EmersonBJ/nasa-acme-burner-cad-cfd/assets/comp_clean_front.png

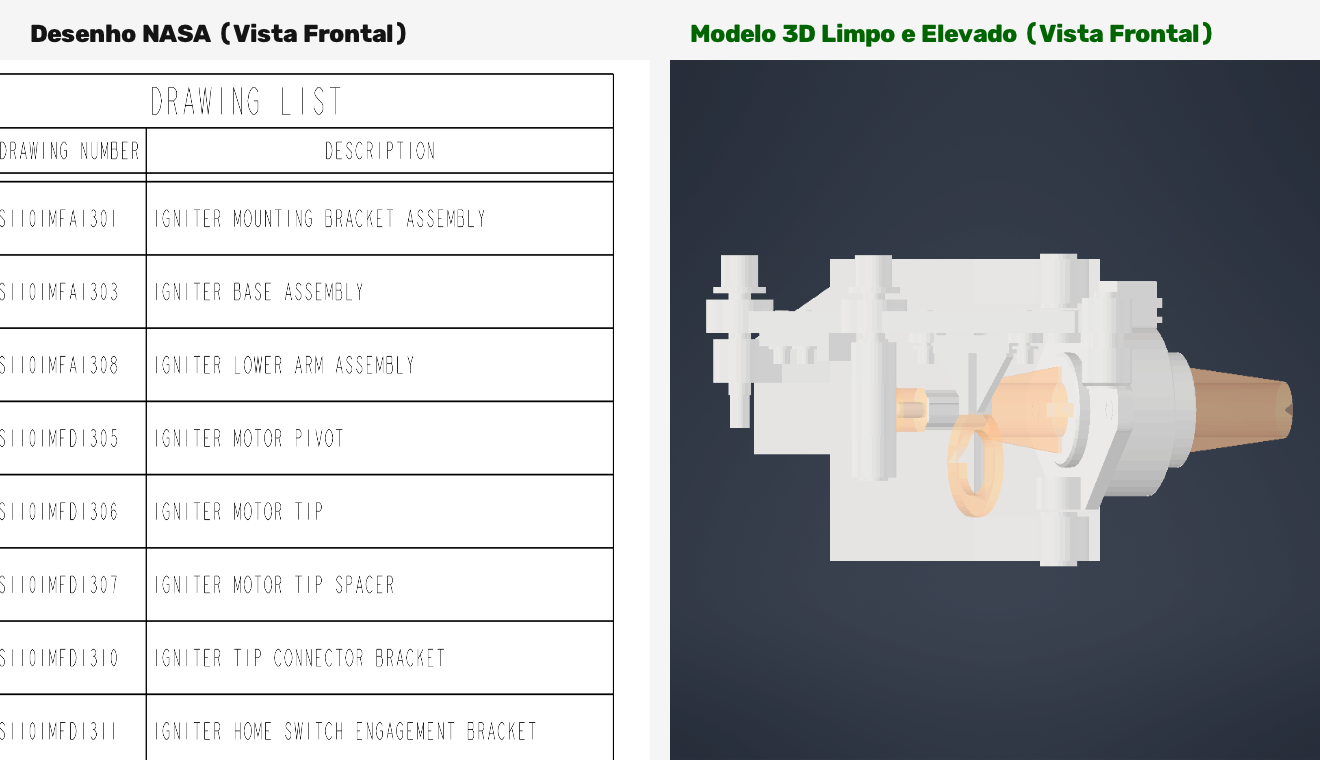
assets/comp_clean_front.png
