EmersonBJ/nasa-acme-burner-cad-cfd/assets/comp_clean_side.png

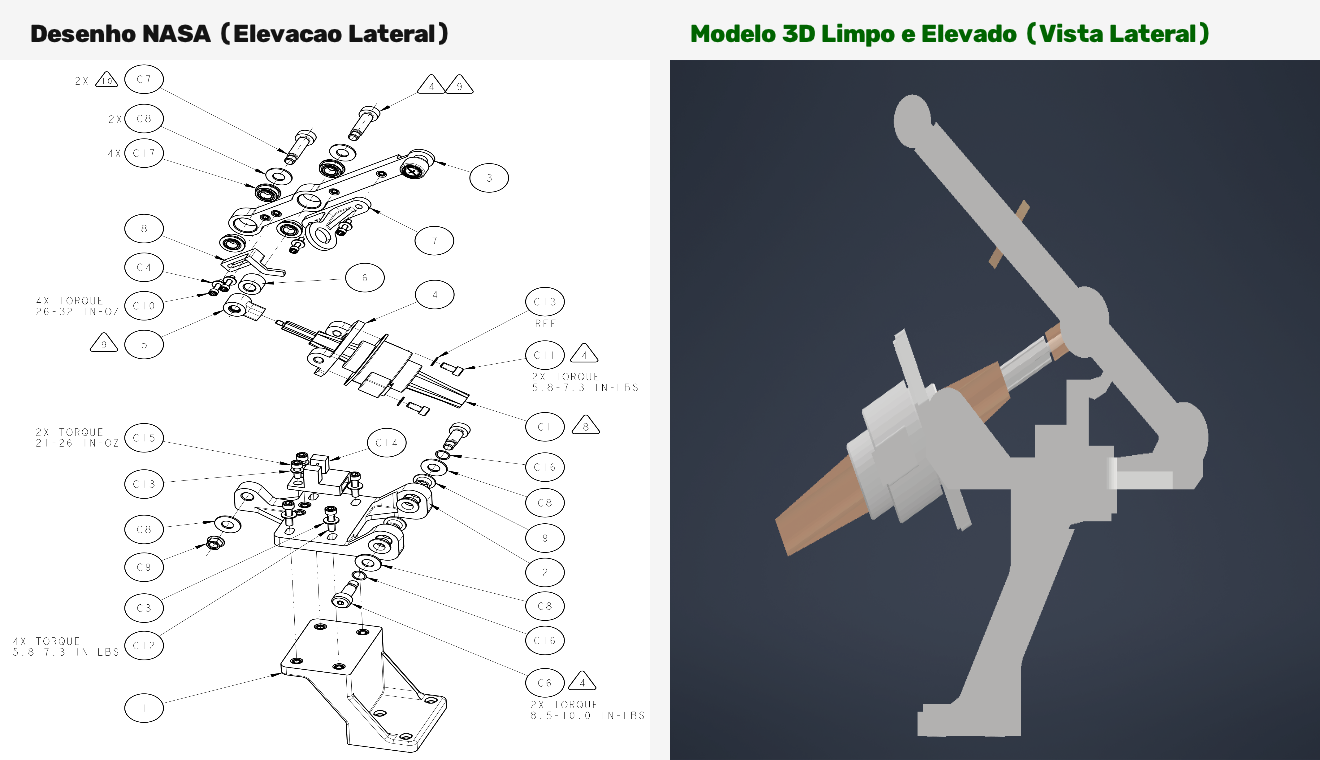
assets/comp_clean_side.png
