EmersonBJ/nasa-acme-burner-cad-cfd/assets/comp_clean_top.png

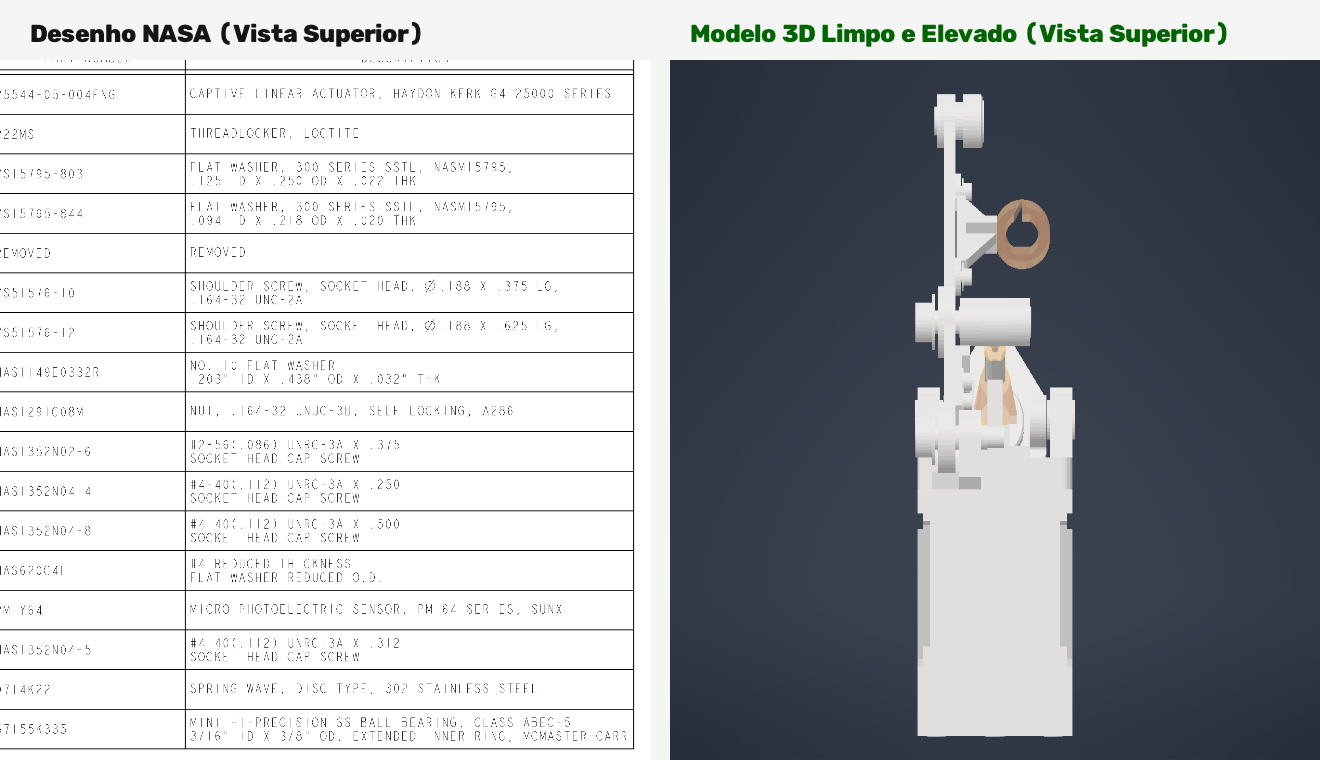
assets/comp_clean_top.png
