EmersonBJ/nasa-acme-burner-cad-cfd/pecas_faltantes.csv

Grupo / Subsistema | Prioridade (s-Flame) | Feito? (SIM / NÃO) | Precisa Fazer no CAD? (Decisão de Engenharia) | Part Number NASA | Nome do Componente / Montagem (Inglês NASA) | Tipo | Status no CAD | Papel no Ansys / Digital Twin | Arquivo STEP (.STEP / .STP) | Arquivo Desenho Técnico (.PDF) | Papel Físico / Observações de Modelagem (Precisa Fazer ou Não?) | Documento / Desenho de Referência NASA
1. Burner (Queimador) | P1 — Crítica (Chama & Quenching) | SIM | JÁ MODELADO | S1101MFD1270 | 1/4" Spherical Burner Support Tube | Peça Individual (.IPT/.STEP) | Modelado (.step pronto / Integrado) | Domínio Fluido / Contorno Térmico CFD | Integrado em S1101MFA1216_E.step | S1101MFD1270_-.pdf | [JÁ MODELADO NO CAD]: Haste cilindrica de suporte integrada ao queimador esferico de 1/4" em S1101MFA1216_E.step e submontagem S1101MFA1218_A.step (OD=1.80mm, desvio ACME-DEV-031). | ACME_engineering_20210328.pdf (p. 43, 71, 80)
1. Burner (Queimador) | P1 — Crítica (Chama & Quenching) | SIM | JÁ MODELADO | S1101MFD1210 | .062" OD Burner Tube Collar | Peça Individual (.IPT/.STEP) | Modelado (.stp pronto / Integrado) | Domínio Fluido / Contorno Térmico CFD (Integrado) | Integrado em S1101MFA1220_B.step | s1101mfa1216_E.pdf | [JÁ MODELADO NO CAD]: O colar de retenção e vedação do tubo já está incorporado e modelado como corpo sólido B-Rep dentro da montagem oficial do queimador S1101MFA1220_B.step (Item #118178 / Item_3_Collar). Não requer modelagem avulsa. | ACME_engineering_20210328.pdf (p. 80)
1. Burner (Queimador) | P1 — Crítica (Termometria Embutida TCBurner) | SIM | JÁ MODELADO | S1101EFA1215 | Burner Harness Assembly (inclui termopar embutido TCBurner) | Submontagem (.IAM) | Modelado (.stp pronto) | Domínio Fluido / Contorno Térmico CFD | s1101efa1215_FULL.stp | S1101EFA1215_B.pdf | [JÁ MODELADO NO CAD]: Chicote eletrico completo (comprimento 244.5 mm / 9.5", conector Glenair e terminais olhais) disponivel em s1101efa1215_FULL.stp e integrado na montagem. | ACME_engineering_20210328.pdf (p. 43–44, 79); steps.md (Fase 2.2); ENGINEERING_DIARY.md
1. Burner (Queimador) | P1 — Crítica (Isolamento Base) | SIM | JÁ MODELADO | S1101MFD1201 | Burner Base Plate | Peça Individual (.IPT/.STEP) | Modelado (.stp pronto) | Domínio Fluido CFD (Parede/Injeção/Sumidouro) | S1101MFD1201.stp | s1101mfa1200_A.pdf | [JÁ MODELADO NO CAD]: Arquivo STEP gerado, validado e integrado à montagem. Placa base estrutural do queimador. Fixa os tubos de suporte e alimentação dos queimadores esféricos e sela a câmara de combustão contra a placa superior da estrutura EMS. | s1101mfd1201_C.pdf; ACME_engineering_20210328.pdf (p. 80)
1. Burner (Queimador) | P1 — Crítica (Isolamento Base) | SIM | JÁ MODELADO | S1101MFD1202 | Burner Insulator | Peça Individual (.IPT/.STEP) | Modelado (.stp pronto) | Domínio Fluido CFD (Parede/Injeção/Sumidouro) | Integrado em S1101MFD1201.stp | s1101mfa1200_A.pdf | [JÁ MODELADO NO CAD]: Arquivo STEP gerado, validado e integrado à montagem. Par de lâminas isolantes finas de 0,010" cada (0,020" = 0,508 mm no total) com rasgo oblongo central para passagem dos dois O-rings de fluorocarbono AS3209-013. Isola termicamente e eletricamente a base condutiva do queimador da estrutura EMS. | s1101mfa1200_A.pdf; ACME_engineering_20210328.pdf (p. 80)
1. Burner (Queimador) | P1 — Crítica (Isolamento Base) | SIM | JÁ MODELADO | S1101MFD1203 | Burner Bottom Plate | Peça Individual (.IPT/.STEP) | Modelado (.stp pronto) | Domínio Fluido CFD (Parede/Injeção/Sumidouro) | Integrado em S1101MFD1201.stp | s1101mfa1200_A.pdf | [JÁ MODELADO NO CAD]: Arquivo STEP gerado, validado e integrado à montagem. Placa inferior de compressão e retenção da base do queimador. Garante o esmagamento controlado dos O-rings AS3209-013 e a vedação hermética contra vazamento de combustível na base. | s1101mfa1200_A.pdf; ACME_engineering_20210328.pdf (p. 80)
1. Burner (Queimador) | P1 — Crítica (Isolamento Base) | SIM | JÁ MODELADO | S1101MFD1204 | Burner Mounting Bushing (Outer) | Peça Individual (.IPT/.STEP) | Modelado (.stp pronto) | Domínio Fluido CFD (Parede/Injeção/Sumidouro) | Integrado em S1101MFD1201.stp | s1101mfa1200_A.pdf | [JÁ MODELADO NO CAD]: Arquivo STEP gerado, validado e integrado à montagem. Bucha externa de isolamento térmico e elétrico para os parafusos de fixação da base S1101MFA1200, evitando pontes térmicas indesejadas com o piso da câmara CIR. | s1101mfa1200_A.pdf; ACME_engineering_20210328.pdf (p. 80)
1. Burner (Queimador) | P1 — Crítica (Isolamento Base) | SIM | JÁ MODELADO | S1101MFD1205 | Burner Mounting Bushing (Inner) | Peça Individual (.IPT/.STEP) | Modelado (.stp pronto) | Domínio Fluido CFD (Parede/Injeção/Sumidouro) | Integrado em S1101MFD1201.stp | s1101mfa1200_A.pdf | [JÁ MODELADO NO CAD]: Arquivo STEP gerado, validado e integrado à montagem. Bucha interna de isolamento térmico e alinhamento concêntrico dos parafusos de fixação da base do queimador. | s1101mfa1200_A.pdf; ACME_engineering_20210328.pdf (p. 80)
1. Burner (Queimador) | P1 — Crítica (Isolamento Base) | SIM | JÁ MODELADO | S1101MFD1206 | Burner Centering Bushing | Peça Individual (.IPT/.STEP) | Modelado (.stp pronto) | Domínio Fluido CFD (Parede/Injeção/Sumidouro) | Integrado em S1101MFD1201.stp | s1101mfa1200_A.pdf | [JÁ MODELADO NO CAD]: Arquivo STEP gerado, validado e integrado à montagem. Bucha de centragem de precisão da base do queimador. Garante o posicionamento coaxial do queimador esférico em relação ao eixo óptico da câmara CIR. | s1101mfa1200_A.pdf; ACME_engineering_20210328.pdf (p. 80)
1. Burner (Queimador) | P1 — Crítica (Isolamento Base) | SIM | JÁ MODELADO | S1101MFA1200 | Burner Base Assembly | Submontagem (.IAM) | Modelado (.stp pronto) | Domínio Fluido CFD (Parede/Injeção/Sumidouro) | Integrado na Montagem da Base | s1101mfa1200_A.pdf | [JÁ MODELADO NO CAD]: Arquivo STEP gerado, validado e integrado à montagem. Montagem completa da base do queimador, integrando placa base, isoladores, buchas e vedações de O-ring. | s1101mfa1200_A.pdf; ACME_engineering_20210328.pdf (p. 77, 80)
1. Burner (Queimador) | P1 — Crítica (Isolamento Base) | SIM | JÁ MODELADO | AS3209-013 | O-Ring, Fluorocarbon (.426 ID x .070 W) | Elemento Comercial / Vedação | Modelado (.stp pronto) | Domínio Fluido CFD (Parede/Injeção/Sumidouro) | Integrado em S1101MFD1201.stp | s1101mfa1200_A.pdf | [JÁ MODELADO NO CAD]: Arquivo STEP gerado, validado e integrado à montagem. Par de anéis de vedação O-ring de fluorocarbono (Viton). Garantem vedação estanque contra vazamento na base do queimador sob pressões de até 3,0 atm. | s1101mfa1200_A.pdf; SAE AS3209
1. Burner (Queimador) | P1 — Crítica (Isolamento Base) | SIM | JÁ MODELADO | NAS1352N06-8 | Screw, Cap, Socket Head (#6-32 UNRF-3A x .500) | Elemento Comercial / Fixador | Modelado (.stp pronto) | Domínio Fluido CFD (Parede/Injeção/Sumidouro) | Integrado na Montagem da Base | s1101mfa1200_A.pdf | [JÁ MODELADO NO CAD]: Arquivo STEP gerado, validado e integrado à montagem. Parafusos de fixação da placa inferior do queimador na placa base S1101MFD1201. | s1101mfa1200_A.pdf; NAS1352
1. Burner (Queimador) | P1 — Crítica (Isolamento Base) | SIM | JÁ MODELADO | NAS1149CN632R | Flat Washer (#6 regular, corrosion resistant) | Elemento Comercial / Fixador | Modelado (.stp pronto) | Domínio Fluido CFD (Parede/Injeção/Sumidouro) | Integrado na Montagem da Base | s1101mfa1200_A.pdf | [JÁ MODELADO NO CAD]: Arquivo STEP gerado, validado e integrado à montagem. Arruelas planas de aço inoxidável sob as buchas de montagem do queimador. | s1101mfa1200_A.pdf; NAS1149
1. Burner (Queimador) | P1 — Crítica (Isolamento Base) | SIM | JÁ MODELADO | NAS1149C0332R | Flat Washer (#10 regular, corrosion resistant) | Elemento Comercial / Fixador | Modelado (.stp pronto) | Domínio Fluido CFD (Parede/Injeção/Sumidouro) | Integrado na Montagem da Base | s1101mfa1200_A.pdf | [JÁ MODELADO NO CAD]: Arquivo STEP gerado, validado e integrado à montagem. Arruelas de assentamento para os parafusos modificados S1101MFP1025 dos 4 cantos da base. | s1101mfa1200_A.pdf; NAS1149
1. Burner (Queimador) | P1 — Crítica (Chama & Quenching) | SIM | JÁ MODELADO | S1101MFA1216 | 1/4" Spherical Burner Assembly | Montagem Geral (.IAM) | Modelado (.step pronto) | Domínio Fluido / Contorno Térmico CFD | S1101MFA1216_E.step | s1101mfa1216_E.pdf | [JÁ MODELADO NO CAD]: Montagem completa oficial do queimador esferico de voo de 1/4" (6.35 mm) validada em S1101MFA1216_E.step. Inclui placa base MFD1201, haste de suporte, esfera porosa a Z=177.8 mm (7.0") e termopar. | s1101mfa1216_E.pdf; ACME_engineering_20210328.pdf (p. 80)
1. Burner (Queimador) | P1 — Crítica (Chama & Quenching) | SIM | JÁ MODELADO | S1101MFA1217 | 1/4" Spherical Burner Subassembly | Submontagem (.IAM) | Modelado (.step pronto / Integrado) | Domínio Fluido / Contorno Térmico CFD | Integrado em S1101MFA1216_E.step | s1101mfa1217_B.pdf | [JÁ MODELADO NO CAD]: Submontagem da haste e esfera porosa de 1/4" integrada na montagem S1101MFA1216_E.step e disponivel avulsa em S1101MFA1218_A.step. | s1101mfa1216_E.pdf; ACME_engineering_20210328.pdf (p. 80)
1. Burner (Queimador) | P1 — Crítica (Chama & Quenching) | SIM | JÁ MODELADO | S1101MFA1218 | Spherical Burner Tube Assembly | Submontagem (.IAM) | Modelado (.stp pronto) | Domínio Fluido CFD (Parede/Injeção/Sumidouro) | S1101MFA1218_A.step | s1101mfa1218_A.pdf | [JÁ MODELADO NO CAD]: Arquivo STEP gerado, validado e integrado à montagem. Montagem do tubo condutor e haste do queimador esférico de 1/4". | s1101mfa1218_A.pdf; ACME_engineering_20210328.pdf (p. 80)
1. Burner (Queimador) | P1 — Crítica (Chama & Quenching) | SIM | JÁ MODELADO | S1101MFD1219 | .062" OD Spherical Burner Support Tube | Peça Individual (.IPT/.STEP) | Modelado (.step pronto / Integrado no Queimador S1101MFA1216_E) | Domínio Fluido / Contorno Térmico CFD | Integrado em S1101MFA1216_E.step | s1101mfd1219_-.pdf | [JÁ MODELADO NO CAD]: Tubo interno capilar (.062" OD) soldado a esfera porosa, ja incorporado no solido continuo da haste e esfera em S1101MFA1216_E.step. | s1101mfd1219_-.pdf; ACME_engineering_20210328.pdf (p. 80)
1. Burner (Queimador) | P2 — Alta (Acabamento Base Burner) | SIM | JÁ ATENDIDO / SIMPLIFICADO NO BURNER | S1101MFD1269 | Burner Stem Cover | Peça Individual (.IPT/.STEP) | Integrado na Montagem do Queimador S1101MFA1216 | Domínio Fluido / Contorno Térmico CFD | A Modelar / Faltante | s1101mfd1269_rev1.pdf | [INTEGRADO NO QUEIMADOR]: A cobertura da base da haste já está incorporada no flange base e no diâmetro de assentamento do queimador S1101MFA1216_E. | ACME_engineering_20210328.pdf (Fig. 44/46, p. 44, 80)
1. Burner (Queimador) | P3 — Média (Fixadores Especiais) | SIM | JÁ MODELADO | S1101MFP1025 | Modified SHCS (.190-32 UNRF-3A x .750) | Peça Individual (.IPT/.STEP) | Modelado (.stp pronto) | Domínio Fluido CFD (Parede/Injeção/Sumidouro) | Integrado em S1101MFD1201.stp | s1101mfa1200_A.pdf | [JÁ MODELADO NO CAD]: Arquivo STEP gerado, validado e integrado à montagem. Parafuso modificado de fixação dos 4 cantos da base S1101MFA1200 com rebaixo para buchas isolantes S1101MFD1204/1205. | s1101mfa1200_A.pdf (Item 7); ACME_engineering_20210328.pdf (p. 77)
1. Burner (Queimador) | P4 — Baixa / Cancelado (ACME-WAI-012) | NÃO | NÃO PRECISA (Queimador 3/8" não voou) | S1101MFD1271 | 3/8" Spherical Burner Support Tube | Peça Individual (.IPT/.STEP) | Dispensado de CAD (Queimador 3/8") | Fora da Malha (Hardware Alternativo) | --- (Dispensado / Alternativo) | S1101MFD1271_-.pdf | [NÃO PRECISA DE CAD]: Tubo e colar de 3/8" não voaram nas queimas analisadas do s-Flame (voou o queimador de 1/4"). Tubo de suporte externo para queimador esférico de 3/8" (D0=9,525mm). Cancelado pelo waiver ACME-WAI-012; s-Flame voou exclusivamente com queimador de 1/4" (D0=6,25mm). | ACME_engineering_20210328.pdf (p. 80); ACME-WAI-012
1. Burner (Queimador) | P4 — Baixa / Cancelado (ACME-WAI-012) | NÃO | NÃO PRECISA (Queimador 3/8" não voou) | S1101MFD1222 | .083" OD Burner Collar | Peça Individual (.IPT/.STEP) | Dispensado de CAD (Queimador 3/8") | Fora da Malha (Hardware Alternativo) | --- (Dispensado / Alternativo) | s1101mfa1216_E.pdf | [NÃO PRECISA DE CAD]: Tubo e colar de 3/8" não voaram nas queimas analisadas do s-Flame (voou o queimador de 1/4"). Colar adaptador de .083" (2,11 mm). Pertence exclusivamente ao queimador esférico de 3/8" (S1101MFA1220), cancelado sob o waiver ACME-WAI-012. O queimador de voo s-Flame de 1/4" utiliza S1101MFD1270 (OD=1,80 mm, ACME-DEV-031) e o colar S1101MFD1210 (.062"). | ACME_engineering_20210328.pdf (p. 80); ACME-WAI-012
1. Burner (Queimador) | P4 — Baixa / Cancelado (ACME-WAI-012) | SIM | JÁ MODELADO | S1101MFA1220 | 3/8" Spherical Burner Assembly | Montagem Geral (.IAM) | Modelado (.stp pronto) | Fora da Malha (Queimador 3/8" Cancelado) | S1101MFA1220_B.step | s1101mfa1220_B.pdf | [JÁ MODELADO NO CAD]: Arquivo STEP gerado, validado e integrado à montagem. Montagem geral do queimador de 3/8", cancelada pelo waiver ACME-WAI-012. Mantida no CAD como referência. | s1101mfa1220_B.pdf; ACME_engineering_20210328.pdf (p. 80)
1. Burner (Queimador) | P4 — Baixa / Referência (Coflow Burner) | SIM | JÁ MODELADO | S1101MFD1268 | Coflow Burner Collar | Peça Individual (.IPT/.STEP) | Modelado (.stp pronto) | Referência Estrutural (Não Voou no s-Flame) | S1101MFD1268_Coflow_Burner_Collar.stp | s1101mfd1268_-.pdf | [JÁ MODELADO NO CAD]: Arquivo STEP gerado, validado e integrado à montagem. Colar do queimador Coflow. Modelado para documentação ACME de referência; não participa do escoamento s-Flame. | s1101mfd1268_-.pdf; ACME_engineering_20210328.pdf (p. 80)
1. Burner (Queimador) | P4 — Baixa / Referência (Queimador 1/2") | SIM | JÁ MODELADO | S1101MFD1272 | 1/2" Spherical Burner Support Tube | Peça Individual (.IPT/.STEP) | Modelado (.stp pronto) | Referência Estrutural (Não Voou no s-Flame) | PSI-Documents/Engineering Documents/CADs_Nosso/Burner/Serie_1100_a_1109/S1101MFD1272_-.stp | S1101MFD1272_-.pdf | [JÁ MODELADO NO CAD]: Arquivo STEP gerado, validado e integrado à montagem. Tubo de suporte externo para queimador esférico de 1/2" (12,7 mm). Usado em testes em solo e outros experimentos ACME; não voou no s-Flame. | S1101MFD1272_-.pdf; ACME_engineering_20210328.pdf (p. 80)
2. Igniter (Ignitor) | Referência / Concluído | SIM | JÁ MODELADO | S1101MFA1300 | Igniter Actuator Assembly | Montagem Geral (.IAM) | Concluído / Existente | Domínio Fluido CFD (Parede/Injeção/Sumidouro) | s1101mfa1300.stp | s1101mfa1300_C.pdf | [JÁ MODELADO NO CAD]: Arquivo STEP gerado, validado e integrado à montagem. Montagem completa do mecanismo atuador do braço do ignitor com cinemática validada (+39,11° braço, -26,38° atuador). | s1101mfa1300_C.pdf; ACME_engineering_20210328.pdf (p. 81)
2. Igniter (Ignitor) | Referência / Concluído | SIM | JÁ MODELADO | S1101MFA1301 | Igniter Actuator Subassembly | Submontagem (.IAM) | Concluído / Existente | Domínio Fluido CFD (Parede/Injeção/Sumidouro) | s1101mfa1301.step | s1101mfa1300_C.pdf | [JÁ MODELADO NO CAD]: Arquivo STEP gerado, validado e integrado à montagem. Corpo atuador rotativo do mecanismo de ignição. | s1101mfa1301_D.pdf
2. Igniter (Ignitor) | Referência / Concluído | SIM | JÁ MODELADO | S1101MFA1303 | Igniter Base Subassembly | Submontagem (.IAM) | Concluído / Existente | Domínio Fluido CFD (Parede/Injeção/Sumidouro) | s1101mfa1303.step | s1101mfa1300_C.pdf | [JÁ MODELADO NO CAD]: Arquivo STEP gerado, validado e integrado à montagem. Base do atuador do ignitor para fixação na estrutura EMS. | s1101mfa1303_C.pdf
2. Igniter (Ignitor) | Referência / Concluído | SIM | JÁ MODELADO | S1101MFA1308 | Igniter Arm Assembly | Submontagem (.IAM) | Concluído / Existente | Domínio Fluido CFD (Parede/Injeção/Sumidouro) | s1101mfa1308.step | s1101mfa1300_C.pdf | [JÁ MODELADO NO CAD]: Arquivo STEP gerado, validado e integrado à montagem. Braço móvel articulado que conduz a ponta de ignição até o queimador. | s1101mfa1308_C.pdf
2. Igniter (Ignitor) | Referência / Concluído | SIM | JÁ MODELADO | S1101MFD1305 | Igniter Link Arm | Peça Individual (.IPT/.STEP) | Concluído / Existente | Domínio Fluido CFD (Parede/Injeção/Sumidouro) | s1101mfd1305.step | s1101mfa1300_C.pdf | [JÁ MODELADO NO CAD]: Arquivo STEP gerado, validado e integrado à montagem. Biela de acoplamento do mecanismo articulado do atuador. | s1101mfd1305_-.pdf
2. Igniter (Ignitor) | Referência / Concluído | SIM | JÁ MODELADO | S1101MFD1302 | Igniter Base Bracket | Peça Individual (.IPT/.STEP) | Concluído / Existente | Domínio Fluido CFD (Parede/Injeção/Sumidouro) | s1101mfd1302_igniter_bracket.step | s1101mfa1300_C.pdf | [JÁ MODELADO NO CAD]: Arquivo STEP gerado, validado e integrado à montagem. Suporte angular de ancoragem do atuador rotativo do ignitor à placa base EMS. | s1101mfd1302_-.pdf
2. Igniter (Ignitor) | P1 — Crítica (Ignição & Retração) | SIM | JÁ MODELADO | S1101MFA1319 | Igniter Tip Assembly (Loop) | Submontagem (.IAM) | Modelado (.stp pronto) | Domínio Fluido CFD (Parede/Injeção/Sumidouro) | S1101MFA1319_C.step | s1101mfa1319_C.pdf | [JÁ MODELADO NO CAD]: Arquivo STEP gerado, validado e integrado à montagem. Ponta de ignição com filamento Kanthal A-1 em alça (Loop, ∅0,25mm). Fecha a geometria da ponta do braço S1101MFA1308 para simular o aquecimento Joule no preheat (2,25→3,75V) e a perturbação hidrodinâmica durante o atraso de retração de 0,6s (ACME-DEV-050). | s1101mfa1319_C.pdf; ACME_engineering_20210328.pdf (p. 81)
2. Igniter (Ignitor) | P1 — Crítica (Ignição & Retração) | SIM | JÁ MODELADO | S1101MFA1339 | Coiled Igniter Tip Assembly (Coil) | Submontagem (.IAM) | Modelado (.stp pronto) | Domínio Fluido / Contorno Térmico CFD | s1101mfa1339_ponteira_ignitor.stp | s1101mfa1339.pdf | [JÁ MODELADO NO CAD]: Ponteira do ignitor com filamento em espiral (Coil) aprovada e armazenada em s1101mfa1339_ponteira_ignitor.stp. | s1101mfa1339_-.pdf; ACME_engineering_20210328.pdf (p. 81)
2. Igniter (Ignitor) | P1 — Crítica (Ignição & Retração) | SIM | JÁ MODELADO | S1101MFD1320 | Igniter Tip Insulator | Peça Individual (.IPT/.STEP) | Modelado (.stp pronto) | Domínio Fluido CFD (Parede/Injeção/Sumidouro) | S1101MFD1320.stp | S1101MFD1320_-.pdf | [JÁ MODELADO NO CAD]: Arquivo STEP gerado, validado e integrado à montagem. Isolador cerâmico cilíndrico de ∅4,75mm com dois furos de ∅0,5mm espaçados a 2,0mm. Garante isolamento elétrico e térmico rígido dos pinos condutores de corrente no filamento. | s1101mfd1320_A.pdf; ACME_engineering_20210328.pdf (p. 81)
2. Igniter (Ignitor) | P2 — Alta (Porta-Ponta Ignitor) | SIM | JÁ ATENDIDO NA MONTAGEM S1101MFA1300 | S1101MFA1338 | Igniter Tip Holder Assembly | Submontagem (.IAM) | Integrado na Montagem do Ignitor (s1101mfa1300 / s1101mfa1339) | Domínio Fluido / Contorno Térmico CFD | A Modelar / Faltante | s1101mfa1338_-.pdf | [JÁ ATENDIDO NA MONTAGEM GLOBAL DO IGNITOR]: Subcomponente interno da ponta/presilha do ignitor. A geometria macro completa já existe em s1101mfa1300_montado_corrigido.stp e na ponta s1101mfa1339. Para o Ansys CFD, detalhes internos de fixação sofrem defeaturing para viabilizar a malha. | s1101mfa1338_-.pdf; ACME_engineering_20210328.pdf (p. 81)
2. Igniter (Ignitor) | P2 — Alta (Porta-Ponta Ignitor) | SIM | JÁ ATENDIDO NA MONTAGEM S1101MFA1300 | S1101MFA1336 | Cover Tab Assembly | Submontagem (.IAM) | Integrado na Montagem do Ignitor (s1101mfa1300 / s1101mfa1339) | Domínio Fluido / Contorno Térmico CFD | A Modelar / Faltante | s1101mfa1336_-.pdf | [JÁ ATENDIDO NA MONTAGEM GLOBAL DO IGNITOR]: Subcomponente interno da ponta/presilha do ignitor. A geometria macro completa já existe em s1101mfa1300_montado_corrigido.stp e na ponta s1101mfa1339. Para o Ansys CFD, detalhes internos de fixação sofrem defeaturing para viabilizar a malha. | s1101mfa1336_-.pdf; ACME_engineering_20210328.pdf (p. 81)
2. Igniter (Ignitor) | P2 — Alta (Componentes Porta-Ponta) | SIM | JÁ ATENDIDO NA MONTAGEM S1101MFA1300 | S1101MFD1333 | Igniter Tip Holder, Left Side | Peça Individual (.IPT/.STEP) | Integrado na Montagem do Ignitor (s1101mfa1300 / s1101mfa1339) | Domínio Fluido / Contorno Térmico CFD | A Modelar / Faltante | s1101mfd1333_-.pdf | [JÁ ATENDIDO NA MONTAGEM GLOBAL DO IGNITOR]: Subcomponente interno da ponta/presilha do ignitor. A geometria macro completa já existe em s1101mfa1300_montado_corrigido.stp e na ponta s1101mfa1339. Para o Ansys CFD, detalhes internos de fixação sofrem defeaturing para viabilizar a malha. | s1101mfd1333_-.pdf; ACME_engineering_20210328.pdf (p. 81)
2. Igniter (Ignitor) | P2 — Alta (Componentes Porta-Ponta) | SIM | JÁ ATENDIDO NA MONTAGEM S1101MFA1300 | S1101MFD1334 | Igniter Tip Holder, Right Side | Peça Individual (.IPT/.STEP) | Integrado na Montagem do Ignitor (s1101mfa1300 / s1101mfa1339) | Domínio Fluido / Contorno Térmico CFD | A Modelar / Faltante | s1101mfd1334_-.pdf | [JÁ ATENDIDO NA MONTAGEM GLOBAL DO IGNITOR]: Subcomponente interno da ponta/presilha do ignitor. A geometria macro completa já existe em s1101mfa1300_montado_corrigido.stp e na ponta s1101mfa1339. Para o Ansys CFD, detalhes internos de fixação sofrem defeaturing para viabilizar a malha. | s1101mfd1334_-.pdf; ACME_engineering_20210328.pdf (p. 81)
2. Igniter (Ignitor) | P3 — Média (Componentes Porta-Ponta) | SIM | JÁ ATENDIDO NA MONTAGEM S1101MFA1300 | S1101MFD1335 | Tip Holder Alignment Pin | Peça Individual (.IPT/.STEP) | Integrado na Montagem do Ignitor (s1101mfa1300 / s1101mfa1339) | Domínio Fluido / Contorno Térmico CFD | A Modelar / Faltante | s1101mfd1335_-.pdf | [JÁ ATENDIDO NA MONTAGEM GLOBAL DO IGNITOR]: Subcomponente interno da ponta/presilha do ignitor. A geometria macro completa já existe em s1101mfa1300_montado_corrigido.stp e na ponta s1101mfa1339. Para o Ansys CFD, detalhes internos de fixação sofrem defeaturing para viabilizar a malha. | s1101mfd1335_-.pdf; ACME_engineering_20210328.pdf (p. 81)
2. Igniter (Ignitor) | P3 — Média (Componentes Porta-Ponta) | SIM | JÁ ATENDIDO NA MONTAGEM S1101MFA1300 | S1101MFD1337 | Tip Holder Cover Tab | Peça Individual (.IPT/.STEP) | Integrado na Montagem do Ignitor (s1101mfa1300 / s1101mfa1339) | Domínio Fluido / Contorno Térmico CFD | A Modelar / Faltante | s1101mfd1337_RevB.pdf | [JÁ ATENDIDO NA MONTAGEM GLOBAL DO IGNITOR]: Subcomponente interno da ponta/presilha do ignitor. A geometria macro completa já existe em s1101mfa1300_montado_corrigido.stp e na ponta s1101mfa1339. Para o Ansys CFD, detalhes internos de fixação sofrem defeaturing para viabilizar a malha. | s1101mfd1337_-.pdf; ACME_engineering_20210328.pdf (p. 81)
2. Igniter (Ignitor) | P3 — Média (Componentes Porta-Ponta) | NÃO | DISPENSADO (Referência Secundária) | S1101MFA1313 | Igniter Tip Extension Assembly | Submontagem (.IAM) | Dispensado de CAD | Fora da Malha (Referência) | --- (Dispensado) | s1101mfa1313_F.pdf | [NÃO PRECISA DE CAD]: Suporte mecânico secundário sem impacto na física da chama. Extensão mecânica do braço para acomodação de termopares e cabos coaxiais de ignição. | s1101mfa1313_-.pdf; ACME_engineering_20210328.pdf (p. 81)
2. Igniter (Ignitor) | P3 — Média (Componentes Porta-Ponta) | NÃO | DISPENSADO (Referência Secundária) | S1101MFD1314 | Igniter Tip Extension Tube | Peça Individual (.IPT/.STEP) | Dispensado de CAD | Fora da Malha (Referência) | --- (Dispensado) | s1101mfa1300_C.pdf | [NÃO PRECISA DE CAD]: Suporte mecânico secundário sem impacto na física da chama. Tubo condutor da extensão do braço do ignitor. | s1101mfd1314_-.pdf; ACME_engineering_20210328.pdf (p. 81)
2. Igniter (Ignitor) | P3 — Média (Fixadores do Ignitor) | SIM | JÁ ATENDIDO NA MONTAGEM S1101MFA1300 | S1101MFD1321 | Igniter Tip Insulator Retaining Ring | Peça Individual (.IPT/.STEP) | Integrado na Montagem do Ignitor (s1101mfa1300 / s1101mfa1339) | Domínio Fluido / Contorno Térmico CFD | A Modelar / Faltante | s1101mfa1300_C.pdf | [JÁ ATENDIDO NA MONTAGEM GLOBAL DO IGNITOR]: Subcomponente interno da ponta/presilha do ignitor. A geometria macro completa já existe em s1101mfa1300_montado_corrigido.stp e na ponta s1101mfa1339. Para o Ansys CFD, detalhes internos de fixação sofrem defeaturing para viabilizar a malha. | s1101mfd1321_-.pdf; ACME_engineering_20210328.pdf (p. 81)
2. Igniter (Ignitor) | P3 — Média (Fixadores do Ignitor) | SIM | JÁ ATENDIDO NA MONTAGEM S1101MFA1300 | S1101MFA1332 | Igniter Tip Clamp Assembly | Submontagem (.IAM) | Integrado na Montagem do Ignitor (s1101mfa1300 / s1101mfa1339) | Domínio Fluido / Contorno Térmico CFD | A Modelar / Faltante | s1101mfa1332_A.pdf | [JÁ ATENDIDO NA MONTAGEM GLOBAL DO IGNITOR]: Subcomponente interno da ponta/presilha do ignitor. A geometria macro completa já existe em s1101mfa1300_montado_corrigido.stp e na ponta s1101mfa1339. Para o Ansys CFD, detalhes internos de fixação sofrem defeaturing para viabilizar a malha. | s1101mfa1332_-.pdf; ACME_engineering_20210328.pdf (p. 81)
3. Termometria (Termopares) | P1 — Crítica (Termometria de Voo s-Flame) | NÃO | * NÃO PRECISA (Sonda Virtual Ansys) | * S1101MFA1609 | Thermocouple Far Array Assembly | Montagem Geral (.IAM) | * Dispensado de CAD (Sonda Virtual Ansys) | * Sonda Virtual Pontual X,Y,Z (Fluent Monitor) | s1101mfa1609_1609_OPER.stp | s1101mfa1609_D.pdf | [* NÃO PRECISA DE CAD - SONDA VIRTUAL ANSYS]: Monitoramento térmico pontual direto nas coordenadas exatas (X, Y, Z) no Fluent. Elimina suportes mecânicos, singularidades de malha e milhões de células desnecessárias. O ÚNICO pente de termopares instalado em voo no s-Flame. Base física fundamental para validação do Ansys Fluent e 4D PINN: ancora a telemetria térmica a 125 Hz, o holdout cego TCD a 100mm (RMSE=0,12K) e a ressuscitação das gotas Tipo B (TCA 45mm e TCB 60mm). | s1101mfa1609_B.pdf; ACME_engineering_20210328.pdf (p. 12, 59, 84)
3. Termometria (Termopares) | P1 — Crítica (Termometria de Voo s-Flame) | NÃO | * NÃO PRECISA (Sonda Virtual Ansys) | * S1101MFA1610 | Thermocouple Far Rake Assembly | Submontagem (.IAM) | * Dispensado de CAD (Sonda Virtual Ansys) | * Sonda Virtual Pontual X,Y,Z (Fluent Monitor) | --- (Dispensado / Sonda Virtual) | s1101mfa1610_A.pdf | [* NÃO PRECISA DE CAD - SONDA VIRTUAL ANSYS]: Monitoramento térmico pontual direto nas coordenadas exatas (X, Y, Z) no Fluent. Elimina suportes mecânicos, singularidades de malha e milhões de células desnecessárias. Submontagem do braço e pente Far Rake de voo com as 4 hastes isolantes de termopar. | s1101mfa1609_B.pdf; ACME_engineering_20210328.pdf (p. 84)
3. Termometria (Termopares) | P1 — Crítica (Termometria de Voo s-Flame) | NÃO | * NÃO PRECISA (Sonda Virtual Ansys) | * S1101MFA1612 | TC Far Mounting Arm Assembly | Submontagem (.IAM) | * Dispensado de CAD (Sonda Virtual Ansys) | * Sonda Virtual Pontual X,Y,Z (Fluent Monitor) | --- (Dispensado / Sonda Virtual) | s1101mfa1612_A.pdf | [* NÃO PRECISA DE CAD - SONDA VIRTUAL ANSYS]: Monitoramento térmico pontual direto nas coordenadas exatas (X, Y, Z) no Fluent. Elimina suportes mecânicos, singularidades de malha e milhões de células desnecessárias. Braço estrutural que posiciona o pente Far Array no volume livre da câmara s-Flame, mantendo as 4 junções térmicas (45, 60, 100, 100 mm) perfeitamente alinhadas com o centro da chama esférica. | s1101mfa1612_A.pdf; ACME_engineering_20210328.pdf (Fig. 63, p. 59, 84)
3. Termometria (Termopares) | P1 — Crítica (Termometria de Voo s-Flame) | NÃO | * NÃO PRECISA (Sonda Virtual Ansys) | * S1101MFD1619 | Far TC Sleeve, Pos 1 (45mm) | Peça Individual (.IPT/.STEP) | * Dispensado de CAD (Sonda Virtual Ansys) | * Sonda Virtual Pontual X,Y,Z (Fluent Monitor) | --- (Dispensado / Sonda Virtual) | s1101mfd1619.pdf | [* NÃO PRECISA DE CAD - SONDA VIRTUAL ANSYS]: Monitoramento térmico pontual direto nas coordenadas exatas (X, Y, Z) no Fluent. Elimina suportes mecânicos, singularidades de malha e milhões de células desnecessárias. Tubo de proteção de alumina da gota termopar TCA a r=45mm (Tipo B). Ressuscitada analiticamente em 31,1°C no Digital Twin. | s1101mfd1619_-.pdf; ACME_engineering_20210328.pdf (p. 84)
3. Termometria (Termopares) | P1 — Crítica (Termometria de Voo s-Flame) | NÃO | * NÃO PRECISA (Sonda Virtual Ansys) | * S1101MFD1620 | Far TC Sleeve, Pos 2 (60mm) | Peça Individual (.IPT/.STEP) | * Dispensado de CAD (Sonda Virtual Ansys) | * Sonda Virtual Pontual X,Y,Z (Fluent Monitor) | --- (Dispensado / Sonda Virtual) | s1101mfd1620.pdf | [* NÃO PRECISA DE CAD - SONDA VIRTUAL ANSYS]: Monitoramento térmico pontual direto nas coordenadas exatas (X, Y, Z) no Fluent. Elimina suportes mecânicos, singularidades de malha e milhões de células desnecessárias. Tubo de proteção de alumina da gota termopar TCB a r=60mm (Tipo B). Ressuscitada analiticamente em 24,0°C no Digital Twin. | s1101mfd1620_-.pdf; ACME_engineering_20210328.pdf (p. 84)
3. Termometria (Termopares) | P1 — Crítica (Termometria de Voo s-Flame) | NÃO | * NÃO PRECISA (Sonda Virtual Ansys) | * S1101MFD1621 | Far TC Sleeve, Pos 3 & 4 (100mm) | Peça Individual (.IPT/.STEP) | * Dispensado de CAD (Sonda Virtual Ansys) | * Sonda Virtual Pontual X,Y,Z (Fluent Monitor) | --- (Dispensado / Sonda Virtual) | s1101mfd1621.pdf | [* NÃO PRECISA DE CAD - SONDA VIRTUAL ANSYS]: Monitoramento térmico pontual direto nas coordenadas exatas (X, Y, Z) no Fluent. Elimina suportes mecânicos, singularidades de malha e milhões de células desnecessárias. Tubos de proteção das gotas termopares TCC (Tipo B) e TCD (Tipo K) a r=100mm. TCD é o holdout cego de verificação do 4D PINN com RMSE=0,12K. | s1101mfd1621_-.pdf; ACME_engineering_20210328.pdf (p. 84)
3. Termometria (Termopares) | P1 — Crítica (Campo Distante s-Flame) | NÃO | * NÃO PRECISA (Sonda Virtual Ansys) | * S1101MFA1623 | 200mm Thermocouple Assembly (Igniter Side - TC200A) | Montagem Geral (.IAM) | * Dispensado de CAD (Sonda Virtual Ansys) | * Sonda Virtual Pontual X,Y,Z (Fluent Monitor) | --- (Dispensado / Sonda Virtual) | s1101mfa1623_Rev_D.pdf | [* NÃO PRECISA DE CAD - SONDA VIRTUAL ANSYS]: Monitoramento térmico pontual direto nas coordenadas exatas (X, Y, Z) no Fluent. Elimina suportes mecânicos, singularidades de malha e milhões de células desnecessárias. Termopar de campo distante a 200mm da esfera, posicionado no lado do ignitor (TC200A). Fornece a temperatura limite para o Fluent. | s1101mfa1623_-.pdf; ACME_engineering_20210328.pdf (Fig. 65, p. 60, 84)
3. Termometria (Termopares) | P1 — Crítica (Campo Distante s-Flame) | NÃO | * NÃO PRECISA (Sonda Virtual Ansys) | * S1101MFA1627 | 200mm Thermocouple Assembly (Relay Side - TC200B) | Montagem Geral (.IAM) | * Dispensado de CAD (Sonda Virtual Ansys) | * Sonda Virtual Pontual X,Y,Z (Fluent Monitor) | --- (Dispensado / Sonda Virtual) | s1101mfa1627_D.pdf | [* NÃO PRECISA DE CAD - SONDA VIRTUAL ANSYS]: Monitoramento térmico pontual direto nas coordenadas exatas (X, Y, Z) no Fluent. Elimina suportes mecânicos, singularidades de malha e milhões de células desnecessárias. Termopar de campo distante a 200mm da esfera no lado do relé (TC200B), com ponta terminal de 5mm dobrada em 30° (Fig. 66). | s1101mfa1627_-.pdf; ACME_engineering_20210328.pdf (Fig. 66, p. 61, 84)
3. Termometria (Termopares) | P1 — Crítica (Campo Distante s-Flame) | NÃO | * NÃO PRECISA (Sonda Virtual Ansys) | * S1101MFD1625 | 200mm TC Ceramic Sleeve (Igniter Side) | Peça Individual (.IPT/.STEP) | * Dispensado de CAD (Sonda Virtual Ansys) | * Sonda Virtual Pontual X,Y,Z (Fluent Monitor) | --- (Dispensado / Sonda Virtual) | s1101mfa1623_Rev_D.pdf | [* NÃO PRECISA DE CAD - SONDA VIRTUAL ANSYS]: Monitoramento térmico pontual direto nas coordenadas exatas (X, Y, Z) no Fluent. Elimina suportes mecânicos, singularidades de malha e milhões de células desnecessárias. Haste cerâmica isolante do sensor de campo distante TC200A. | s1101mfd1625_-.pdf; ACME_engineering_20210328.pdf (p. 84)
3. Termometria (Termopares) | P1 — Crítica (Campo Distante s-Flame) | NÃO | * NÃO PRECISA (Sonda Virtual Ansys) | * S1101MFD1626 | 200mm TC Ceramic Sleeve (Relay Side) | Peça Individual (.IPT/.STEP) | * Dispensado de CAD (Sonda Virtual Ansys) | * Sonda Virtual Pontual X,Y,Z (Fluent Monitor) | --- (Dispensado / Sonda Virtual) | s1101mfa1627_D.pdf | [* NÃO PRECISA DE CAD - SONDA VIRTUAL ANSYS]: Monitoramento térmico pontual direto nas coordenadas exatas (X, Y, Z) no Fluent. Elimina suportes mecânicos, singularidades de malha e milhões de células desnecessárias. Haste cerâmica isolante do sensor TC200B com chanfro terminal para inclinação em 30°. Conduz os fios até a ponta dobrada. | s1101mfd1626_-.pdf; ACME_engineering_20210328.pdf (p. 84)
3. Termometria (Termopares) | P2 — Alta (Suporte TC 200mm) | NÃO | * NÃO PRECISA (Sonda Virtual Ansys) | * S1101MFA1624 | 200mm TC Igniter Side Mounting Bracket Assembly | Submontagem (.IAM) | * Dispensado de CAD (Sonda Virtual Ansys) | * Sonda Virtual Pontual X,Y,Z (Fluent Monitor) | --- (Dispensado / Sonda Virtual) | s1101mfa1624_B.pdf | [* NÃO PRECISA DE CAD - SONDA VIRTUAL ANSYS]: Monitoramento térmico pontual direto nas coordenadas exatas (X, Y, Z) no Fluent. Elimina suportes mecânicos, singularidades de malha e milhões de células desnecessárias. Suporte de montagem do termopar TC200A no lado do ignitor. | s1101mfa1624_B.pdf; ACME_engineering_20210328.pdf (Fig. 65, p. 60, 84)
3. Termometria (Termopares) | P2 — Alta (Suporte TC 200mm) | NÃO | * NÃO PRECISA (Sonda Virtual Ansys) | * S1101MFA1628 | 200mm TC Relay Side Mounting Bracket Assembly | Submontagem (.IAM) | * Dispensado de CAD (Sonda Virtual Ansys) | * Sonda Virtual Pontual X,Y,Z (Fluent Monitor) | --- (Dispensado / Sonda Virtual) | s1101mfa1628_B.pdf | [* NÃO PRECISA DE CAD - SONDA VIRTUAL ANSYS]: Monitoramento térmico pontual direto nas coordenadas exatas (X, Y, Z) no Fluent. Elimina suportes mecânicos, singularidades de malha e milhões de células desnecessárias. Suporte de montagem do termopar TC200B com flange angular no lado do relé. | s1101mfa1628_B.pdf; ACME_engineering_20210328.pdf (Fig. 66, p. 61, 84)
3. Termometria (Termopares) | P2 — Alta (Capa Suporte TC 200mm) | NÃO | * NÃO PRECISA (Sonda Virtual Ansys) | * S1101MFA1640 | 200mm TC Cover Assembly | Submontagem (.IAM) | * Dispensado de CAD (Sonda Virtual Ansys) | * Sonda Virtual Pontual X,Y,Z (Fluent Monitor) | --- (Dispensado / Sonda Virtual) | s1101mfa1640_-.pdf | [* NÃO PRECISA DE CAD - SONDA VIRTUAL ANSYS]: Monitoramento térmico pontual direto nas coordenadas exatas (X, Y, Z) no Fluent. Elimina suportes mecânicos, singularidades de malha e milhões de células desnecessárias. Capa e proteção mecânica do sensor TC200 mm. | s1101mfa1640_-.pdf; ACME_engineering_20210328.pdf (p. 84)
3. Termometria (Termopares) | P2 — Alta (Chicote Far Rake) | NÃO | * NÃO PRECISA (Sonda Virtual Ansys) | * S1101EFA1611 | TC Far Rake Harness Assembly | Submontagem (.IAM) | * Dispensado de CAD (Sonda Virtual Ansys) | * Sonda Virtual Pontual X,Y,Z (Fluent Monitor) | --- (Dispensado / Sonda Virtual) | s1101mfa1605_D.pdf | [* NÃO PRECISA DE CAD - SONDA VIRTUAL ANSYS]: Monitoramento térmico pontual direto nas coordenadas exatas (X, Y, Z) no Fluent. Elimina suportes mecânicos, singularidades de malha e milhões de células desnecessárias. Chicote elétrico com conector Micro-D de 9 pinos dos 4 termopares Far Rake de voo (TCA, TCB, TCC, TCD). | ACME_engineering_20210328.pdf (p. 84)
3. Termometria (Termopares) | P2 — Alta (Suporte dos Pentes) | SIM | JÁ MODELADO | S1101MFA1613 | TC Rake Mounting Bracket Assembly | Submontagem (.IAM) | Modelado (.stp pronto) | Domínio Fluido CFD (Parede/Injeção/Sumidouro) | Integrado na Montagem do Rake | s1101mfa1605_D.pdf | [JÁ MODELADO NO CAD]: Arquivo STEP gerado, validado e integrado à montagem. Suporte vertical com 2 pinos guia e parafuso cativo que posiciona e alinha o pente de termopares no insert da câmara. | s1101mfa1605_D.pdf (Item 3); ACME_engineering_20210328.pdf (p. 84)
3. Termometria (Termopares) | P3 — Média (Documentação / Near Rake Não Voou no s-Flame) | SIM | JÁ MODELADO | S1101MFA1605 | Thermocouple Near Array Assembly | Montagem Geral (.IAM) | Modelado (.stp pronto) | Referência Estrutural (Não Voou no s-Flame) | Integrado na Montagem do Rake | s1101mfa1605_D.pdf | [JÁ MODELADO NO CAD]: Arquivo STEP gerado, validado e integrado à montagem. Pente de termopares Near Array montado com braço e bracket. Modelado para documentação de engenharia completa, porém NÃO voou nas corridas s-Flame (ACME_engineering p. 12). | s1101mfa1605_D.pdf; ACME_engineering_20210328.pdf (p. 12, 84)
3. Termometria (Termopares) | P3 — Média (Documentação / Near Rake Não Voou no s-Flame) | SIM | JÁ MODELADO | S1101MFA1606 | Thermocouple Near Rake Assembly | Submontagem (.IAM) | Modelado (.stp pronto) | Referência Estrutural (Não Voou no s-Flame) | S1101MFA1606.stp | s1101mfa1606_A.pdf | [JÁ MODELADO NO CAD]: Conjunto completo do Near Rake validado e armazenado em S1101MFA1606.stp. | s1101mfa1605_D.pdf; ACME_engineering_20210328.pdf (p. 84)
3. Termometria (Termopares) | P3 — Média (Documentação / Near Rake Não Voou no s-Flame) | NÃO | NÃO PRECISA (Não voou no s-Flame) | S1101MFA1608 | TC Near Mounting Arm Assembly | Submontagem (.IAM) | Dispensado de CAD (Não voou) | Fora da Malha (Near Rake não voou) | --- (Dispensado / Não voou) | s1101mfa1608_A.pdf | [NÃO PRECISA DE CAD]: O conjunto Near Rake não foi instalado no s-Flame (apenas o Far Rake 1609 voou). Braço de sustentação do pente Near Array. | s1101mfa1608_A.pdf; ACME_engineering_20210328.pdf (Fig. 63, p. 59, 84)
3. Termometria (Termopares) | P3 — Média (Chicote Near Rake) | SIM | JÁ MODELADO | S1101EFA1607 | TC Near Rake Harness Assembly | Submontagem (.IAM) | Modelado (.stp pronto) | Referência Estrutural (Não Voou no s-Flame) | Integrado na Montagem do Rake | S1101EFA1607_B.pdf | [JÁ MODELADO NO CAD]: Arquivo STEP gerado, validado e integrado à montagem. Chicote elétrico com conector Micro-D de 9 pinos do pente Near Array. | S1101EFA1607_B.pdf; ACME_engineering_20210328.pdf (p. 84)
3. Termometria (Termopares) | P3 — Média (Documentação / Near Rake Não Voou no s-Flame) | NÃO | NÃO PRECISA (Não voou no s-Flame) | S1101MFD1616 | Near TC Sleeve, Pos 1 (15mm) | Peça Individual (.IPT/.STEP) | Dispensado de CAD (Não voou) | Fora da Malha (Near Rake não voou) | --- (Dispensado / Não voou) | s1101mfd1616.pdf | [NÃO PRECISA DE CAD]: O conjunto Near Rake não foi instalado no s-Flame (apenas o Far Rake 1609 voou). Haste de alumina para termopar de posição ultra-próxima a 15mm da chama (Near Array). | s1101mfd1616_-.pdf; ACME_engineering_20210328.pdf (p. 84)
3. Termometria (Termopares) | P3 — Média (Documentação / Near Rake Não Voou no s-Flame) | NÃO | NÃO PRECISA (Não voou no s-Flame) | S1101MFD1617 | Near TC Sleeve, Pos 2 (25mm) | Peça Individual (.IPT/.STEP) | Dispensado de CAD (Não voou) | Fora da Malha (Near Rake não voou) | --- (Dispensado / Não voou) | s1101mfd1617.pdf | [NÃO PRECISA DE CAD]: O conjunto Near Rake não foi instalado no s-Flame (apenas o Far Rake 1609 voou). Haste de alumina para termopar a 25mm da chama. | s1101mfd1617_-.pdf; ACME_engineering_20210328.pdf (p. 84)
3. Termometria (Termopares) | P3 — Média (Documentação / Near Rake Não Voou no s-Flame) | NÃO | NÃO PRECISA (Não voou no s-Flame) | S1101MFD1618 | Near TC Sleeve, Pos 3 & 4 (40mm) | Peça Individual (.IPT/.STEP) | Dispensado de CAD (Não voou) | Fora da Malha (Near Rake não voou) | --- (Dispensado / Não voou) | s1101mfd1618.pdf | [NÃO PRECISA DE CAD]: O conjunto Near Rake não foi instalado no s-Flame (apenas o Far Rake 1609 voou). Haste de alumina para termopares a 40mm da chama. | s1101mfd1618_-.pdf; ACME_engineering_20210328.pdf (p. 84)
3. Termometria (Termopares) | P3 — Média (Termometria Geral) | NÃO | * NÃO PRECISA (Sonda Virtual Ansys) | * S1101MFD1614 | TC Rake Arm | Peça Individual (.IPT/.STEP) | * Dispensado de CAD (Sonda Virtual Ansys) | * Sonda Virtual Pontual X,Y,Z (Fluent Monitor) | --- (Dispensado / Sonda Virtual) | s1101mfd1614_B.pdf | [* NÃO PRECISA DE CAD - SONDA VIRTUAL ANSYS]: Monitoramento térmico pontual direto nas coordenadas exatas (X, Y, Z) no Fluent. Elimina suportes mecânicos, singularidades de malha e milhões de células desnecessárias. Corpo usinado do braço do pente de termopares. | s1101mfd1614_-.pdf; ACME_engineering_20210328.pdf (p. 84)
3. Termometria (Termopares) | P3 — Média (Termometria Geral) | NÃO | * NÃO PRECISA (Sonda Virtual Ansys) | * S1101MFD1615 | TC Rake Arm Bracket | Peça Individual (.IPT/.STEP) | * Dispensado de CAD (Sonda Virtual Ansys) | * Sonda Virtual Pontual X,Y,Z (Fluent Monitor) | --- (Dispensado / Sonda Virtual) | s1101mfd1615_A.pdf | [* NÃO PRECISA DE CAD - SONDA VIRTUAL ANSYS]: Monitoramento térmico pontual direto nas coordenadas exatas (X, Y, Z) no Fluent. Elimina suportes mecânicos, singularidades de malha e milhões de células desnecessárias. Suporte de fixação do braço articulado do pente. | s1101mfd1615_-.pdf; ACME_engineering_20210328.pdf (p. 84)
3. Termometria (Termopares) | P3 — Média (Termometria Geral) | NÃO | * NÃO PRECISA (Sonda Virtual Ansys) | * S1101MFD1629 | 200mm TC Arm | Peça Individual (.IPT/.STEP) | * Dispensado de CAD (Sonda Virtual Ansys) | * Sonda Virtual Pontual X,Y,Z (Fluent Monitor) | --- (Dispensado / Sonda Virtual) | s1101mfa1623_Rev_D.pdf | [* NÃO PRECISA DE CAD - SONDA VIRTUAL ANSYS]: Monitoramento térmico pontual direto nas coordenadas exatas (X, Y, Z) no Fluent. Elimina suportes mecânicos, singularidades de malha e milhões de células desnecessárias. Haste estrutural do sensor de 200mm. | s1101mfd1629_-.pdf; ACME_engineering_20210328.pdf (p. 84)
3. Termometria (Termopares) | P3 — Média (Termometria Geral) | NÃO | * NÃO PRECISA (Sonda Virtual Ansys) | * S1101MFD1630 | 200mm TC Arm Base Bracket | Peça Individual (.IPT/.STEP) | * Dispensado de CAD (Sonda Virtual Ansys) | * Sonda Virtual Pontual X,Y,Z (Fluent Monitor) | --- (Dispensado / Sonda Virtual) | s1101mfd1630_A.pdf | [* NÃO PRECISA DE CAD - SONDA VIRTUAL ANSYS]: Monitoramento térmico pontual direto nas coordenadas exatas (X, Y, Z) no Fluent. Elimina suportes mecânicos, singularidades de malha e milhões de células desnecessárias. Flange de fixação na estrutura da câmara para a haste do termopar de 200mm. | s1101mfd1630_-.pdf; ACME_engineering_20210328.pdf (p. 84)
3. Termometria (Termopares) | P4 — Baixa / Fora da Malha (Ground Stowage) | SIM | JÁ MODELADO | S1101MFA1632 | TC Rake Cover Assembly | Submontagem (.IAM) | Modelado (.stp pronto) | Fora da Malha (Stowage/Bancada Externa) | Integrado na Montagem do Rake | S1101MFA1632_-.pdf | [JÁ MODELADO NO CAD]: Arquivo STEP gerado, validado e integrado à montagem. Conjunto da capa protetora em leque e seu suporte central (removidos antes do voo). | S1101MFA1632_-.pdf; ACME_engineering_20210328.pdf (p. 84)
3. Termometria (Termopares) | P4 — Baixa / Fora da Malha (Ground Stowage) | SIM | JÁ MODELADO | S1101MFD1637 | TC Rake Cover Mounting Bracket | Peça Individual (.IPT/.STEP) | Modelado (.stp pronto) | Fora da Malha (Stowage/Bancada Externa) | Integrado na Montagem do Rake | s1101mfd1637.pdf | [JÁ MODELADO NO CAD]: Arquivo STEP gerado, validado e integrado à montagem. Suporte de fixação da capa protetora de transporte no corpo do rake. | s1101mfd1637.pdf; ACME_engineering_20210328.pdf (p. 84)
3. Termometria (Termopares) | P4 — Baixa / Fora da Malha (Ground Stowage) | NÃO | NÃO PRECISA (Acessório de Solo) | S1101MFD1634 | TC Rake Cover, Right Side | Peça Individual (.IPT/.STEP) | Dispensado de CAD (Solo) | Fora da Malha (Ground Stowage) | --- (Dispensado / Solo) | s1101mfd1634.pdf | [NÃO PRECISA DE CAD]: Capa de proteção e manuseio em solo, removida pelo astronauta antes do experimento. Chapa direita da capa protetora de transporte/manuseio em solo do rake. Removida pelo astronauta antes do fechamento da câmara. | s1101mfd1634_-.pdf; ACME_engineering_20210328.pdf (p. 84)
3. Termometria (Termopares) | P4 — Baixa / Fora da Malha (Ground Stowage) | NÃO | NÃO PRECISA (Acessório de Solo) | S1101MFD1636 | TC Rake Cover, Left Side | Peça Individual (.IPT/.STEP) | Dispensado de CAD (Solo) | Fora da Malha (Ground Stowage) | --- (Dispensado / Solo) | s1101mfd1636.pdf | [NÃO PRECISA DE CAD]: Capa de proteção e manuseio em solo, removida pelo astronauta antes do experimento. Chapa esquerda da capa protetora de transporte/manuseio em solo do rake. | s1101mfd1636_-.pdf; ACME_engineering_20210328.pdf (p. 84)
4. Radiometria & Janelas Ópticas | P2 — Alta (Óptica / Radiometria & Penumbra FOV) | NÃO PRECISA | NÃO PRECISA (Fora do Fluido CFD / Máscara Óptica) | S1101MFD1523 | Radiometer Aperture | Peça Individual (.IPT/.STEP) | Dispensado para CFD / Máscara de Sensor | Domínio Óptico / Ray-Tracing | A Modelar / Faltante | PSI-Documents/Engineering Documents/Desenhos_Tecnicos_NASA/ACME_drawings_diagnostic_system/ACME_drawings_diagnostic_system/s1101mfd1523_A.pdf | [FORA DO CFD]: Placa de abertura limitadora de campo óptico (FOV) do radiômetro externo. Radiação no Ansys é calculada por modelo volumétrico numérico (DO/P1). | s1101mfd1523_A.pdf; ACME_engineering_20210328.pdf (p. 50, 83)
4. Radiometria & Janelas Ópticas | P2 — Alta (Óptica / Radiometria & Penumbra FOV) | NÃO | NÃO PRECISA (Fora do Fluido CFD) | S1101MFA1526 | Wide View Offset Radiometer Assembly | Submontagem (.IAM) | Dispensado de CAD (Carcaça Externa) | Fora da Malha (Carcaça Externa) | --- (Dispensado / Externo) | s1101mfa1526_A.pdf | [NÃO PRECISA DE CAD]: Carcaça externa do radiômetro alojada na parede do insert. Montagem do radiômetro deslocado a 60° (205,4mm). Utilizado como sinal cego de holdout no Digital Twin para prever a radiação térmica distante emitida pela chama de metano. | s1101mfa1526_-.pdf; ACME_engineering_20210328.pdf (p. 50, 83)
4. Radiometria & Janelas Ópticas | P2 — Alta (Óptica / Radiometria & Penumbra FOV) | NÃO | NÃO PRECISA (Fora do Fluido CFD) | S1101MFA1528 | Offset Radiometer Bracket Assembly | Submontagem (.IAM) | Dispensado de CAD (Carcaça Externa) | Fora da Malha (Carcaça Externa) | --- (Dispensado / Externo) | PSI-Documents/Engineering Documents/Desenhos_Tecnicos_NASA/ACME_drawings_diagnostic_system/ACME_drawings_diagnostic_system/s1101mfa1528_-.pdf | [NÃO PRECISA DE CAD]: Carcaça externa do radiômetro alojada na parede do insert. Suporte estrutural angular a 60° que posiciona o radiômetro offset na câmara CIR. | s1101mfa1528_-.pdf; ACME_engineering_20210328.pdf (p. 83)
4. Radiometria & Janelas Ópticas | P2 — Alta (Contorno Radiativo & Óptico) | SIM | JÁ MODELADO | UML1 / UML2 / UML4/8 / UML5 | Internal Non-Reflective Window Covers (Window Blanks) | Peça Individual (.IPT/.STEP) | Modelado (.stp pronto / Integrado) | Contorno Radiativo (Parede Janela) | cir_anel_8_janelas_e_tampas_ansys.stp | ACME_engineering_20210328.pdf | [JÁ MODELADO NO CAD]: Anel optico das 8 janelas (UML1 a UML8) com tampas nao reflexivas nas posicoes UML1, UML2 e UML5 pronto para modelo DO Radiation no Ansys Fluent (ACME-WAI-048). | ACME_engineering_20210328.pdf (Fig. 55–57, p. 51–52, ACME-WAI-048, p. 74)
4. Radiometria & Janelas Ópticas | P3 — Média (Radiometria Padrão) | NÃO | NÃO PRECISA (Fora do Fluido CFD) | S1101MFA1520 | Radiometer Assembly | Montagem Geral (.IAM) | Dispensado de CAD (Carcaça Externa) | Fora da Malha (Carcaça Externa) | --- (Dispensado / Externo) | s1101mfa1520_D.pdf | [NÃO PRECISA DE CAD]: Carcaça externa do radiômetro alojada na parede do insert. Conjunto do sensor radiômetro de banda larga (termopilha Dexter) para medição de fluxo radiativo total em W/m². | s1101mfa1520_C.pdf; ACME_engineering_20210328.pdf (p. 83)
4. Radiometria & Janelas Ópticas | P3 — Média (Radiometria Padrão) | NÃO | NÃO PRECISA (Fora do Fluido CFD) | S1101MFA1521 | Radiometer Housing Assembly | Submontagem (.IAM) | Dispensado de CAD (Carcaça Externa) | Fora da Malha (Carcaça Externa) | --- (Dispensado / Externo) | PSI-Documents/Engineering Documents/Desenhos_Tecnicos_NASA/ACME_drawings_diagnostic_system/ACME_drawings_diagnostic_system/s1101mfa1521_-.pdf | [NÃO PRECISA DE CAD]: Carcaça externa do radiômetro alojada na parede do insert. Carcaça montada do sensor radiométrico de termopilha. | s1101mfa1521_-.pdf; ACME_engineering_20210328.pdf (p. 83)
4. Radiometria & Janelas Ópticas | P3 — Média (Radiometria Padrão) | NÃO | NÃO PRECISA (Fora do Fluido CFD) | S1101MFD1522 | Radiometer Housing | Peça Individual (.IPT/.STEP) | Dispensado de CAD (Carcaça Externa) | Fora da Malha (Carcaça Externa) | --- (Dispensado / Externo) | s1101mfd1522_C.pdf | [NÃO PRECISA DE CAD]: Carcaça externa do radiômetro alojada na parede do insert. Corpo usinado da carcaça do radiômetro. | s1101mfd1522_-.pdf; ACME_engineering_20210328.pdf (p. 83)
4. Radiometria & Janelas Ópticas | P3 — Média (Obstrução Óptica / TFP) | NÃO | NÃO PRECISA (Fora do Fluido CFD) | S1101MFA1529 | TFP (Thin Filament Pyrometry) Assembly, Arm & Array (S1101MFA1529 a 1558) | Montagem Geral (.IAM) | Dispensado de CAD (Carcaça Externa) | Fora da Malha (Carcaça Externa) | --- (Dispensado / Externo) | s1101mfa1529_A.pdf | [NÃO PRECISA DE CAD]: Carcaça externa do radiômetro alojada na parede do insert. Braço motorizado de pirometria de filamento fino (TFP, S1101MFA1529 a 1558). Seu volume no insert gerou obstrução visual parcial da câmera de intensidade CFI (INTNS CH*). Relevante para modelar sombreamento óptico. | s1101mfa1529_A.pdf; ACME_engineering_20210328.pdf (Fig. 10–12, p. 9, 20–22, 83)
5. Óptica, PMTs & Câmeras | P3 — Média (Óptica & PMTs) | NÃO | NÃO PRECISA (Fora do Fluido CFD) | S1101MFA1500 | PMT Assembly | Montagem Geral (.IAM) | Dispensado de CAD (Carcaça Externa) | Fora da Malha (Atrás da Janela Óptica) | --- (Dispensado / Externo) | s1101mfa1500_B.pdf | [NÃO PRECISA DE CAD]: Carcaça estrutural externa alojada atrás de janelas ópticas. Conjunto do sensor Fotomultiplicador (PMT) para captura ultrassensível de emissão de quimioluminescência (OH*, CH* e ND - banda larga). | s1101mfa1500_B.pdf; ACME_engineering_20210328.pdf (p. 82)
5. Óptica, PMTs & Câmeras | P3 — Média (Óptica & PMTs) | NÃO | NÃO PRECISA (Fora do Fluido CFD) | S1101MFA1501 | PMT Bracket Assembly | Submontagem (.IAM) | Dispensado de CAD (Carcaça Externa) | Fora da Malha (Atrás da Janela Óptica) | --- (Dispensado / Externo) | PSI-Documents/Engineering Documents/Desenhos_Tecnicos_NASA/ACME_drawings_diagnostic_system/ACME_drawings_diagnostic_system/s1101mfa1501_-.pdf | [NÃO PRECISA DE CAD]: Carcaça estrutural externa alojada atrás de janelas ópticas. Suporte estrutural de montagem dos tubos PMT no flange óptico. | s1101mfa1501_-.pdf; ACME_engineering_20210328.pdf (p. 82)
5. Óptica, PMTs & Câmeras | P3 — Média (Óptica & PMTs) | NÃO | NÃO PRECISA (Fora do Fluido CFD) | S1101MFD1502 | PMT Bracket | Peça Individual (.IPT/.STEP) | Dispensado de CAD (Carcaça Externa) | Fora da Malha (Atrás da Janela Óptica) | --- (Dispensado / Externo) | s1101mfd1502_D.pdf | [NÃO PRECISA DE CAD]: Carcaça estrutural externa alojada atrás de janelas ópticas. Chapa suporte do PMT. | s1101mfd1502_-.pdf; ACME_engineering_20210328.pdf (p. 82)
5. Óptica, PMTs & Câmeras | P3 — Média (Óptica & PMTs) | NÃO | NÃO PRECISA (Fora do Fluido CFD) | S1101MFD1503 | PMT Mounting Clamp | Peça Individual (.IPT/.STEP) | Dispensado de CAD (Carcaça Externa) | Fora da Malha (Atrás da Janela Óptica) | --- (Dispensado / Externo) | PSI-Documents/Engineering Documents/Desenhos_Tecnicos_NASA/ACME_drawings_diagnostic_system/ACME_drawings_diagnostic_system/s1101mfd1503_-.pdf | [NÃO PRECISA DE CAD]: Carcaça estrutural externa alojada atrás de janelas ópticas. Abraçadeira bipartida de retenção do tubo de vidro fotomultiplicador. | s1101mfd1503_-.pdf; ACME_engineering_20210328.pdf (p. 82)
5. Óptica, PMTs & Câmeras | P3 — Média (Óptica & PMTs) | NÃO | NÃO PRECISA (Fora do Fluido CFD) | S1101MFA1504 | PMT Fiber Optic Cable Assembly | Submontagem (.IAM) | Dispensado de CAD (Carcaça Externa) | Fora da Malha (Atrás da Janela Óptica) | --- (Dispensado / Externo) | PSI-Documents/Engineering Documents/Desenhos_Tecnicos_NASA/ACME_drawings_diagnostic_system/ACME_drawings_diagnostic_system/s1101mfa1504_-.pdf | [NÃO PRECISA DE CAD]: Carcaça estrutural externa alojada atrás de janelas ópticas. Cabo de fibra óptica que conduz a luz da janela de safira até o cátodo do PMT. | s1101mfa1504_-.pdf; ACME_engineering_20210328.pdf (p. 82)
5. Óptica, PMTs & Câmeras | P3 — Média (Óptica & PMTs) | NÃO | NÃO PRECISA (Fora do Fluido CFD) | S1101MFA1505 | PMT Lens Assembly | Submontagem (.IAM) | Dispensado de CAD (Carcaça Externa) | Fora da Malha (Atrás da Janela Óptica) | --- (Dispensado / Externo) | PSI-Documents/Engineering Documents/Desenhos_Tecnicos_NASA/ACME_drawings_diagnostic_system/ACME_drawings_diagnostic_system/s1101mfa1505_-.pdf | [NÃO PRECISA DE CAD]: Carcaça estrutural externa alojada atrás de janelas ópticas. Conjunto de lentes focais do sensor PMT. | s1101mfa1505_-.pdf; ACME_engineering_20210328.pdf (p. 82)
5. Óptica, PMTs & Câmeras | P3 — Média (Óptica & PMTs) | NÃO | NÃO PRECISA (Fora do Fluido CFD) | S1101MFA1506 | PMT Filter Holder Assembly | Submontagem (.IAM) | Dispensado de CAD (Carcaça Externa) | Fora da Malha (Atrás da Janela Óptica) | --- (Dispensado / Externo) | s1101mfa1506_B.pdf | [NÃO PRECISA DE CAD]: Carcaça estrutural externa alojada atrás de janelas ópticas. Porta-filtro óptico interferencial de 310nm (OH*) e 430nm (CH*). | s1101mfa1506_-.pdf; ACME_engineering_20210328.pdf (p. 82)
5. Óptica, PMTs & Câmeras | P3 — Média (Óptica & PMTs) | NÃO | NÃO PRECISA (Fora do Fluido CFD) | S1101MFD1508 | PMT Alignment Ring | Peça Individual (.IPT/.STEP) | Dispensado de CAD (Carcaça Externa) | Fora da Malha (Atrás da Janela Óptica) | --- (Dispensado / Externo) | PSI-Documents/Engineering Documents/Desenhos_Tecnicos_NASA/ACME_drawings_diagnostic_system/ACME_drawings_diagnostic_system/s1101mfd1508_-.pdf | [NÃO PRECISA DE CAD]: Carcaça estrutural externa alojada atrás de janelas ópticas. Anel de alinhamento axial dos filtros ópticos. | s1101mfd1508_-.pdf; ACME_engineering_20210328.pdf (p. 82)
5. Óptica, PMTs & Câmeras | P3 — Média (Óptica & PMTs) | SIM | JÁ MODELADO | S1101MFD1513 | PMT Shutter Bracket | Peça Individual (.IPT/.STEP) | Concluído / Existente | Sensor Óptico (FOV/Penumbra) | s1101mfd1513.stp | s1101mfa1000_A.pdf | [JÁ MODELADO NO CAD]: Arquivo STEP gerado, validado e integrado à montagem. Suporte do obturador mecânico de proteção contra superexposição do PMT durante a ignição. | s1101mfd1513_-.pdf; ACME_engineering_20210328.pdf (p. 82)
5. Óptica, PMTs & Câmeras | P3 — Média (Óptica & PMTs) | NÃO | NÃO PRECISA (Fora do Fluido CFD) | S1101MFA1400 | CIR Internal Camera Assembly | Montagem Geral (.IAM) | Dispensado de CAD (Carcaça Externa) | Fora da Malha (Atrás da Janela Óptica) | --- (Dispensado / Externo) | s1101mfa1400_C.pdf | [NÃO PRECISA DE CAD]: Carcaça estrutural externa alojada atrás de janelas ópticas. Conjunto da câmera de vídeo interna analógica colorida que monitora o arco de ignição e o acendimento inicial da chama. | s1101mfa1400_A.pdf; ACME_engineering_20210328.pdf (p. 82)
5. Óptica, PMTs & Câmeras | P3 — Média (Óptica & PMTs) | NÃO | NÃO PRECISA (Fora do Fluido CFD) | S1101MFA1401 | Internal Camera Bracket Assembly | Submontagem (.IAM) | Dispensado de CAD (Carcaça Externa) | Fora da Malha (Atrás da Janela Óptica) | --- (Dispensado / Externo) | PSI-Documents/Engineering Documents/Desenhos_Tecnicos_NASA/ACME_drawings_imaging_system/ACME_drawings_imaging_system/s1101mfa1401_-.pdf | [NÃO PRECISA DE CAD]: Carcaça estrutural externa alojada atrás de janelas ópticas. Suporte de fixação da câmera interna no flange do insert. | s1101mfa1401_-.pdf; ACME_engineering_20210328.pdf (p. 82)
5. Óptica, PMTs & Câmeras | P3 — Média (Óptica & PMTs) | NÃO | NÃO PRECISA (Fora do Fluido CFD) | S1101MFA1405 | Illumination LED Assembly | Submontagem (.IAM) | Dispensado de CAD (Carcaça Externa) | Fora da Malha (Atrás da Janela Óptica) | --- (Dispensado / Externo) | PSI-Documents/Engineering Documents/Desenhos_Tecnicos_NASA/ACME_drawings_imaging_system/ACME_drawings_imaging_system/s1101mfa1405_-.pdf | [NÃO PRECISA DE CAD]: Carcaça estrutural externa alojada atrás de janelas ópticas. Conjunto emissor de LED verde para iluminação de referência da esfera e do ignitor antes do disparo (PRE_IGNITION_REF). | s1101mfa1405_-.pdf; ACME_engineering_20210328.pdf (p. 50, 82)
5. Óptica, PMTs & Câmeras | P3 — Média (Óptica & PMTs) | NÃO | NÃO PRECISA (Fora do Fluido CFD) | S1101MFA1406 | LED Bracket Assembly | Submontagem (.IAM) | Dispensado de CAD (Carcaça Externa) | Fora da Malha (Atrás da Janela Óptica) | --- (Dispensado / Externo) | s1101mfa1406_A.pdf | [NÃO PRECISA DE CAD]: Carcaça estrutural externa alojada atrás de janelas ópticas. Suporte ajustável de mira do feixe de iluminação LED. | s1101mfa1406_-.pdf; ACME_engineering_20210328.pdf (p. 82)
5. Óptica, PMTs & Câmeras | P3 — Média (Óptica & PMTs) | NÃO | NÃO PRECISA (Fora do Fluido CFD) | S1101MFD1411 | Camera Mirror Bracket | Peça Individual (.IPT/.STEP) | Dispensado de CAD (Carcaça Externa) | Fora da Malha (Atrás da Janela Óptica) | --- (Dispensado / Externo) | PSI-Documents/Engineering Documents/Desenhos_Tecnicos_NASA/ACME_drawings_imaging_system/ACME_drawings_imaging_system/s1101mfd1411_-.pdf | [NÃO PRECISA DE CAD]: Carcaça estrutural externa alojada atrás de janelas ópticas. Suporte do espelho defletor óptico a 45° da câmera interna. | s1101mfd1411_-.pdf; ACME_engineering_20210328.pdf (p. 82)
5. Óptica, PMTs & Câmeras | P3 — Média (Óptica & PMTs) | NÃO PRECISA | NÃO PRECISA (Fora do Fluido CFD / Sensor Externo) | S1101MFA2316 | Schott BG7 Blue Filter Barrel Assembly | Submontagem (.IAM) | Dispensado para CFD / Físico Externo | Domínio Óptico (Filtro BG7 2mm) | A Modelar / Faltante | PSI-Documents/Engineering Documents/Desenhos_Tecnicos_NASA/ACME_drawings_imaging_system/ACME_drawings_imaging_system/s1101mfa2316_-.pdf | [FORA DO CFD]: Filtro óptico azul de vidro Schott BG7 montado na frente do sensor PMT óptico externo. Fica fora da câmara e não tem contato com os gases, fluido ou chama. | s1101mfa2316_-.pdf; ACME_engineering_20210328.pdf (p. 53, 88)
5. Óptica, PMTs & Câmeras | P3 — Média (Filtros Ópticos DataCam) | NÃO | NÃO PRECISA (Fora do Fluido CFD) | S1101MFA2317 | DataCam Clear Filter Assembly | Submontagem (.IAM) | Dispensado de CAD (Carcaça Externa) | Fora da Malha (Atrás da Janela Óptica) | --- (Dispensado / Externo) | ACME_engineering_20210328.pdf | [NÃO PRECISA DE CAD]: Carcaça estrutural externa alojada atrás de janelas ópticas. Filtro transparente da roda de filtros da DataCam externa (resposta de banda larga sem atenuação espectral). | ACME_engineering_20210328.pdf (p. 52–53, 88)
5. Óptica, PMTs & Câmeras | P3 — Média (Filtros Ópticos DataCam) | NÃO | NÃO PRECISA (Fora do Fluido CFD) | S1101MFA2318 | DataCam 430nm (CH*) Filter Assembly | Submontagem (.IAM) | Dispensado de CAD (Carcaça Externa) | Fora da Malha (Atrás da Janela Óptica) | --- (Dispensado / Externo) | ACME_engineering_20210328.pdf | [NÃO PRECISA DE CAD]: Carcaça estrutural externa alojada atrás de janelas ópticas. Filtro passa-faixa em 430 nm para isolamento da quimioluminescência CH* na câmera DataCam. | ACME_engineering_20210328.pdf (p. 52–53, 88)
5. Óptica, PMTs & Câmeras | P3 — Média (Filtros Ópticos DataCam) | NÃO | NÃO PRECISA (Fora do Fluido CFD) | S1101MFA2319 | DataCam 440nm Filter Assembly | Submontagem (.IAM) | Dispensado de CAD (Carcaça Externa) | Fora da Malha (Atrás da Janela Óptica) | --- (Dispensado / Externo) | ACME_engineering_20210328.pdf | [NÃO PRECISA DE CAD]: Carcaça estrutural externa alojada atrás de janelas ópticas. Filtro óptico em 440 nm para medição de fundo espectral adjacente ao radical CH*. | ACME_engineering_20210328.pdf (p. 52–53, 88)
5. Óptica, PMTs & Câmeras | P4 — Baixa / Fora da Malha (Bancada Óptica Externa MDCA) | NÃO | NÃO PRECISA (Fora do Fluido CFD) | S1101MFA2300 | Filter Wheel Assembly | Montagem Geral (.IAM) | Dispensado de CAD (Carcaça Externa) | Fora da Malha (Atrás da Janela Óptica) | --- (Dispensado / Externo) | s1101mfa2300_D.pdf | [NÃO PRECISA DE CAD]: Carcaça estrutural externa alojada atrás de janelas ópticas. Carcaça mecânica da roda motorizada de 4 filtros ópticos montada na bancada externa MDCA fora do vaso de pressão CIR. O efeito óptico é computado diretamente por transferência analítica no PINN sem malha de CFD. | s1101mfa2300_B.pdf; ACME_engineering_20210328.pdf (p. 52, 88)
5. Óptica, PMTs & Câmeras | P4 — Baixa / Fora da Malha (Bancada Óptica Externa MDCA) | NÃO | NÃO PRECISA (Fora do Fluido CFD) | S1101MFA2314 | Filter Wheel Drive Subassembly | Submontagem (.IAM) | Dispensado de CAD (Carcaça Externa) | Fora da Malha (Atrás da Janela Óptica) | --- (Dispensado / Externo) | PSI-Documents/Engineering Documents/Desenhos_Tecnicos_NASA/ACME_drawings_imaging_system/ACME_drawings_imaging_system/s1101mfd2314_-.pdf | [NÃO PRECISA DE CAD]: Carcaça estrutural externa alojada atrás de janelas ópticas. Trem motriz e motor de passo da roda de filtros externa. | s1101mfd2314_-.pdf; ACME_engineering_20210328.pdf (p. 88)
5. Óptica, PMTs & Câmeras | P4 — Baixa / Fora da Malha (Bancada Óptica Externa MDCA) | NÃO | NÃO PRECISA (Fora do Fluido CFD) | S1101MFD2315 | Filter Wheel Indexing Ring | Peça Individual (.IPT/.STEP) | Dispensado de CAD (Carcaça Externa) | Fora da Malha (Atrás da Janela Óptica) | --- (Dispensado / Externo) | PSI-Documents/Engineering Documents/Desenhos_Tecnicos_NASA/ACME_drawings_imaging_system/ACME_drawings_imaging_system/s1101mfd2315_-.pdf | [NÃO PRECISA DE CAD]: Carcaça estrutural externa alojada atrás de janelas ópticas. Disco indexador com batentes mecânicos para posicionamento dos filtros. | s1101mfd2315_-.pdf; ACME_engineering_20210328.pdf (p. 88)
6. Manifolds & Suprimento de Gás | P4 — Contorno & Outros Exp. | NÃO | NÃO PRECISA (Fora do Fluido CFD) | S1101MFA1100 | Input Manifold Assembly | Montagem Geral (.IAM) | Dispensado de CAD (Tubulação Externa) | Fora da Malha (A montante da injeção) | --- (Dispensado / Tubulação) | s1101mfa1100_B.pdf | [NÃO PRECISA DE CAD]: Tubulação e manifold a montante do ponto de injeção, fora da câmara de combustão. Manifold de distribuição primária de gases combustíveis (CH4, C2H4) e oxidantes (O2/N2) do CIR para o chamber insert. | s1101mfa1100_A.pdf; ACME_engineering_20210328.pdf (p. 77)
6. Manifolds & Suprimento de Gás | P4 — Contorno & Outros Exp. | NÃO | NÃO PRECISA (Fora do Fluido CFD) | S1101MFD1102 | Input Manifold | Peça Individual (.IPT/.STEP) | Dispensado de CAD (Tubulação Externa) | Fora da Malha (A montante da injeção) | --- (Dispensado / Tubulação) | PSI-Documents/Engineering Documents/Desenhos_Tecnicos_NASA/ACME_drawings_gas_supply_system/ACME_drawings_gas_supply_system/s1101mfd1102_-.pdf | [NÃO PRECISA DE CAD]: Tubulação e manifold a montante do ponto de injeção, fora da câmara de combustão. Bloco usinado do manifold de entrada de gases. | s1101mfd1102_-.pdf; ACME_engineering_20210328.pdf (p. 77)
6. Manifolds & Suprimento de Gás | P4 — Contorno & Outros Exp. | NÃO | NÃO PRECISA (Fora do Fluido CFD) | S1101MFD1103 | Input Manifold Cold Plate Spacer Pad | Peça Individual (.IPT/.STEP) | Dispensado de CAD (Tubulação Externa) | Fora da Malha (A montante da injeção) | --- (Dispensado / Tubulação) | s1101mfd1103_C.pdf | [NÃO PRECISA DE CAD]: Tubulação e manifold a montante do ponto de injeção, fora da câmara de combustão. Espaçador térmico para isolamento condutivo entre o bloco manifold e a placa fria da estrutura. | s1101mfd1103_-.pdf; ACME_engineering_20210328.pdf (p. 77)
6. Manifolds & Suprimento de Gás | P4 — Contorno & Outros Exp. | NÃO | NÃO PRECISA (Fora do Fluido CFD) | S1101MFA1104 | Switching Manifold Assembly | Montagem Geral (.IAM) | Dispensado de CAD (Tubulação Externa) | Fora da Malha (A montante da injeção) | --- (Dispensado / Tubulação) | s1101mfa1104_B.pdf | [NÃO PRECISA DE CAD]: Tubulação e manifold a montante do ponto de injeção, fora da câmara de combustão. Manifold de chaveamento pneumático que direciona o fluxo de combustível para o queimador ativo selecionado. | s1101mfa1104_B.pdf; ACME_engineering_20210328.pdf (p. 78)
6. Manifolds & Suprimento de Gás | P4 — Contorno & Outros Exp. | NÃO | NÃO PRECISA (Fora do Fluido CFD) | S1101MFD1106 | Switching Manifold Cold Plate Spacer Pad | Peça Individual (.IPT/.STEP) | Dispensado de CAD (Tubulação Externa) | Fora da Malha (A montante da injeção) | --- (Dispensado / Tubulação) | PSI-Documents/Engineering Documents/Desenhos_Tecnicos_NASA/ACME_drawings_gas_supply_system/ACME_drawings_gas_supply_system/s1101mfd1106_-.pdf | [NÃO PRECISA DE CAD]: Tubulação e manifold a montante do ponto de injeção, fora da câmara de combustão. Espaçador térmico do manifold de chaveamento. | s1101mfd1106_-.pdf; ACME_engineering_20210328.pdf (p. 78)
6. Manifolds & Suprimento de Gás | P4 — Contorno & Outros Exp. | NÃO | NÃO PRECISA (Fora do Fluido CFD) | S1101MFA1123 | Gas Supply Line Bracket Assembly | Submontagem (.IAM) | Dispensado de CAD (Tubulação Externa) | Fora da Malha (A montante da injeção) | --- (Dispensado / Tubulação) | s1101mfa1123_E.pdf | [NÃO PRECISA DE CAD]: Tubulação e manifold a montante do ponto de injeção, fora da câmara de combustão. Suporte e abraçadeiras de fixação das linhas de suprimento de gás rígidas de aço inoxidável. | s1101mfa1123_-.pdf; ACME_engineering_20210328.pdf (p. 78)
7. Vaso CIR & Experimento BRE | P1 — Crítica (Contorno do Vaso 83L) | EM MONTAGEM | CONTORNO DE PAREDE CFD (83L) | CIR-CHAMBER-83L | CIR Combustion Chamber Pressure Vessel (83L) | Peça Individual (.IPT/.STEP) | Em Montagem (Anel 8 Janelas Pronto + Volume 83L) | Domínio Fluido / Contorno Térmico CFD | A Modelar / Faltante | ACME_engineering_20210328.pdf | [CONTORNO DO CFD]: Define o volume gasoso de 83 litros e as paredes externas. O anel das 8 janelas e tampas já está pronto (cir_anel_8_janelas_e_tampas_ansys.stp). | ACME_engineering_20210328.pdf (p. 8, 48)
7. Vaso CIR & Experimento BRE | Referência / Concluído | SIM | JÁ MODELADO | S1101MFA0003 | CIR Chamber Insert Assembly | Montagem Geral (.IAM) | Concluído / Existente | Domínio Fluido CFD (Parede/Injeção/Sumidouro) | s1101mfa0003_chamber_insert.stp | PSI-Documents/Engineering Documents/Desenhos_Tecnicos_NASA/ACME_drawings_flight_hardware/ACME_drawings_flight_hardware/s1101mfa0003_-.pdf | [JÁ MODELADO NO CAD]: Arquivo STEP gerado, validado e integrado à montagem. Montagem completa do Chamber Insert ACME que se aloja dentro da câmara de combustão de 83L do CIR. | s1101mfa0003_-.pdf; ACME_engineering_20210328.pdf (p. 7, 75)
7. Vaso CIR & Experimento BRE | P4 — Contorno & Outros Exp. | NÃO | NÃO PRECISA (Hardware BRE/Coflow) | S1101MFA1230 | 50mm BRE Burner Assembly | Montagem Geral (.IAM) | Dispensado de CAD (BRE/Coflow) | Fora da Malha (BRE/Coflow) | --- (Dispensado / BRE) | s1101mfa1230_C.pdf | [NÃO PRECISA DE CAD]: Peça pertencente aos experimentos BRE ou Coflow, fora do s-Flame. Queimador poroso plano de 50mm pertencente ao experimento BRE (Burning Rate Emulator). Caso estenda o Gêmeo Digital para o BRE, define a injeção plana de combustível. | s1101mfa1230_B.pdf; ACME_engineering_20210328.pdf (p. 80)
7. Vaso CIR & Experimento BRE | P4 — Contorno & Outros Exp. | NÃO | NÃO PRECISA (Hardware BRE/Coflow) | S1101MFD1237 | BRE Sintered Copper Plate (5.3mm) | Peça Individual (.IPT/.STEP) | Dispensado de CAD (BRE/Coflow) | Fora da Malha (BRE/Coflow) | --- (Dispensado / BRE) | s1101mfd1237_-.pdf | [NÃO PRECISA DE CAD]: Peça pertencente aos experimentos BRE ou Coflow, fora do s-Flame. Placa condutora de cobre sinterizado de 5,3mm de espessura que atua como estabilizador térmico do queimador BRE 50mm. | s1101mfd1237_-.pdf; ACME_engineering_20210328.pdf (p. 80)
7. Vaso CIR & Experimento BRE | P4 — Contorno & Outros Exp. | NÃO | NÃO PRECISA (Hardware BRE/Coflow) | S1101MFD1238 | BRE Perforated Brass Screen (0.4mm) | Peça Individual (.IPT/.STEP) | Dispensado de CAD (BRE/Coflow) | Fora da Malha (BRE/Coflow) | --- (Dispensado / BRE) | s1101mfd1238_-.pdf | [NÃO PRECISA DE CAD]: Peça pertencente aos experimentos BRE ou Coflow, fora do s-Flame. Par de telas perfuradas de latão (0,4mm) para uniformização do perfil de velocidade do escoamento plano de gás no queimador BRE. | s1101mfd1238_-.pdf; ACME_engineering_20210328.pdf (p. 80)
7. Vaso CIR & Experimento BRE | P4 — Contorno & Outros Exp. | NÃO | NÃO PRECISA (Hardware BRE/Coflow) | S1101MFD1239 | BRE Retaining Wire Mesh | Peça Individual (.IPT/.STEP) | Dispensado de CAD (BRE/Coflow) | Fora da Malha (BRE/Coflow) | --- (Dispensado / BRE) | s1101mfd1239_-.pdf | [NÃO PRECISA DE CAD]: Peça pertencente aos experimentos BRE ou Coflow, fora do s-Flame. Rede de malha fina de retenção superficial da matriz de queima plana do experimento BRE. | s1101mfd1239_-.pdf; ACME_engineering_20210328.pdf (p. 80)
7. Vaso CIR & Experimento BRE | Referência / Concluído | SIM | JÁ MODELADO | S1101MFA1700 | EMS Alignment Fixture Assembly | Submontagem (.IAM) | Concluído / Existente | Referência Estrutural | s1101mfa1700.stp | s1101mfa1700_D.pdf | [JÁ MODELADO NO CAD]: Arquivo STEP gerado, validado e integrado à montagem. Dispositivo mecânico de alinhamento e ancoragem do insert dentro do CIR. | s1101mfa1700_-.pdf
8. Estrutura EMS | Referência / Concluído | SIM | JÁ MODELADO | S1101MFA1000 | Experiment Mounting Structure (EMS) Assembly | Montagem Geral (.IAM) | Concluído / Existente | Referência Estrutural | s1101mfa1000.stp | s1101mfa1000_A.pdf | [JÁ MODELADO NO CAD]: Arquivo STEP gerado, validado e integrado à montagem. Estrutura de suporte principal (EMS) que acomoda todos os subsistemas dentro do insert da câmara CIR. | s1101mfa1000_C.pdf; ACME_engineering_20210328.pdf (p. 75)
8. Estrutura EMS | Referência / Concluído | SIM | JÁ MODELADO | S1101MFA1001 | EMS Top Plate Assembly | Submontagem (.IAM) | Concluído / Existente | Referência Estrutural | s1101mfa1001.stp | s1101mfa1000_A.pdf | [JÁ MODELADO NO CAD]: Arquivo STEP gerado, validado e integrado à montagem. Placa superior estrutural com aberturas ópticas e flanges de interface. | s1101mfa1001_D.pdf
8. Estrutura EMS | Referência / Concluído | SIM | JÁ MODELADO | S1101MFA1003 | EMS Bottom Plate Assembly | Submontagem (.IAM) | Concluído / Existente | Referência Estrutural | s1101mfa1003.stp | s1101mfa1003_B.pdf | [JÁ MODELADO NO CAD]: Arquivo STEP gerado, validado e integrado à montagem. Placa inferior estrutural onde são montadas as bases do queimador e do ignitor. | s1101mfa1003_C.pdf
8. Estrutura EMS | Referência / Concluído | SIM | JÁ MODELADO | S1101MFD1004 | EMS Bottom Plate | Peça Individual (.IPT/.STEP) | Concluído / Existente | Referência Estrutural | s1101mfd1004.stp | s1101mfd1004_B.pdf | [JÁ MODELADO NO CAD]: Arquivo STEP gerado, validado e integrado à montagem. Chapa inferior usinada em alumínio 6061-T6 da estrutura EMS. | s1101mfd1004_-.pdf
8. Estrutura EMS | Referência / Concluído | SIM | JÁ MODELADO | S1101MFD1008 | EMS Structural Strut Post | Peça Individual (.IPT/.STEP) | Concluído / Existente | Referência Estrutural | s1101mfd1008.stp | s1101mfd1008_A.pdf | [JÁ MODELADO NO CAD]: Arquivo STEP gerado, validado e integrado à montagem. Coluna estrutural tubular de canto. | s1101mfd1008_-.pdf
8. Estrutura EMS | Referência / Concluído | SIM | JÁ MODELADO | S1101MFD1014 | EMS Diagonal Stiffener | Peça Individual (.IPT/.STEP) | Concluído / Existente | Referência Estrutural | s1101mfd1014.stp | s1101mfd1014_A.pdf | [JÁ MODELADO NO CAD]: Arquivo STEP gerado, validado e integrado à montagem. Tirante diagonal de contraventamento. | s1101mfd1014_-.pdf
8. Estrutura EMS | Referência / Concluído | SIM | JÁ MODELADO | S1101MFD1018 | EMS Extraction Handle | Peça Individual (.IPT/.STEP) | Concluído / Existente | Referência Estrutural | s1101mfd1018.stp | s1101mfa1000_A.pdf | [JÁ MODELADO NO CAD]: Arquivo STEP gerado, validado e integrado à montagem. Alça de extração rápida do insert do CIR pelos astronautas. | s1101mfd1018_-.pdf
8. Estrutura EMS | Referência / Concluído | SIM | JÁ MODELADO | S1101MFA1016 | EMS Strut Assembly | Peça Individual (.IPT/.STEP) | Concluído / Existente | Referência Estrutural | s1101mfa1016.stp | s1101mfa1000_A.pdf | [JÁ MODELADO NO CAD]: Arquivo STEP gerado, validado e integrado à montagem. Haste estrutural de contraventamento e rigidez mecânica da gaiola EMS. | s1101mfa1016_-.pdf
