EmersonBJ/nasa-acme-burner-cad-cfd/CAD/01_Chamber_Insert/s1101mfa0003_chamber_insert.step

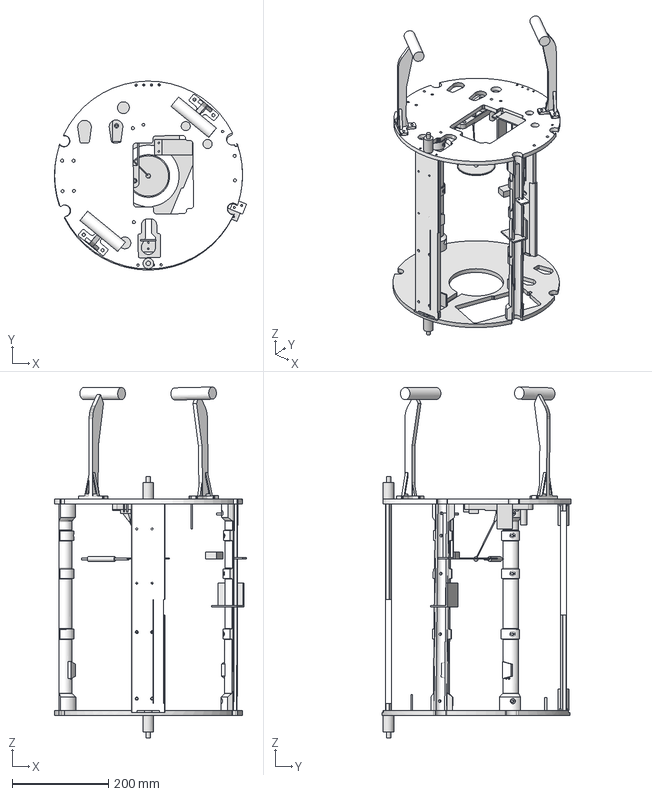
[picture p178: CAD file, 2026-11-09]
CAD/01_Chamber_Insert/s1101mfa0003_chamber_insert.step
399.9 x 393.0 x 730.5 mm
macro_mfd1004
s1101mfd1014 x 2
s1101mfd1008 x 2
macro_mfd1004_1
clean_handle_test x 2
s1101mfd1722
s1101mfa1700
s1101mfa1016
s1101mfd1513
s1101mfa1805
s1101mfa1026
s1101mfa1028 x 2
s1101mfa1028_1
s1101mfa1028_2
s1101mfa1220_v2026
