EmersonBJ/nasa-acme-burner-cad-cfd/CAD/02_Experiment_Mounting_Structure_EMS/s1101mfa1001.stp

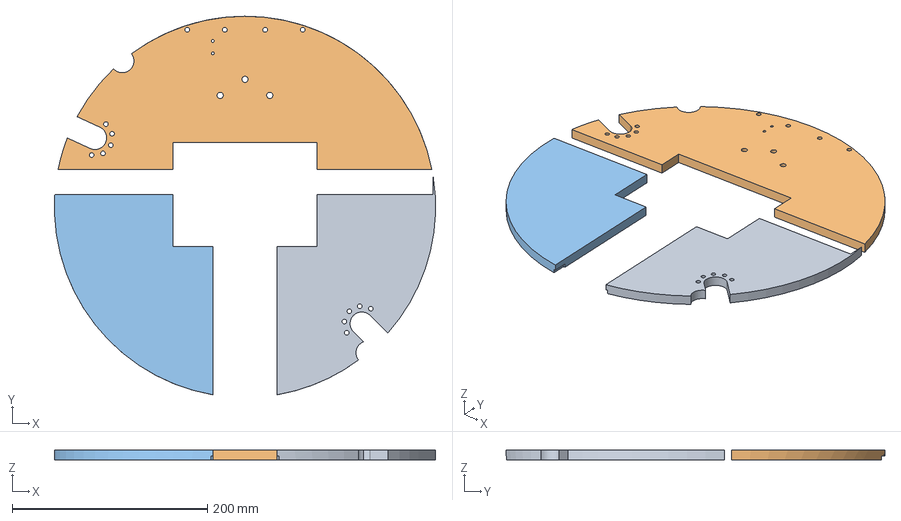
[picture p179: CAD file, 2026-11-09]
CAD/02_Experiment_Mounting_Structure_EMS/s1101mfa1001.stp
390.7 x 388.2 x 10.0 mm
