EmersonBJ/nasa-acme-burner-cad-cfd/CAD/04_Igniter_Assembly/s1101mfa1303.step

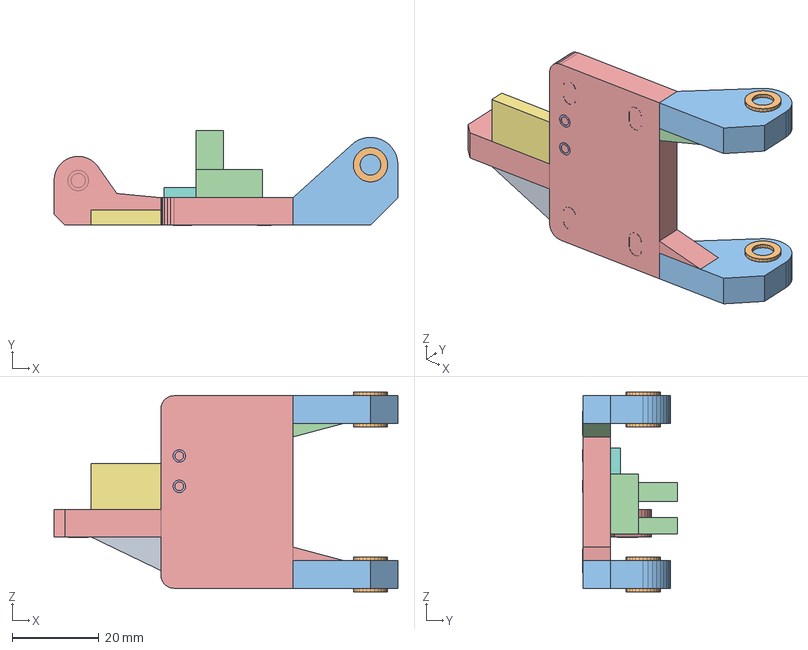
[picture p180: CAD file, 2026-11-09]
CAD/04_Igniter_Assembly/s1101mfa1303.step
79.3 x 21.9 x 46.0 mm
