EmersonBJ/nasa-acme-burner-cad-cfd/PSI-Documents/Engineering Documents/CADs_Nosso/Burner/Serie_1100_a_1109/S1101MFD1268_Coflow_Burner_Collar.stp

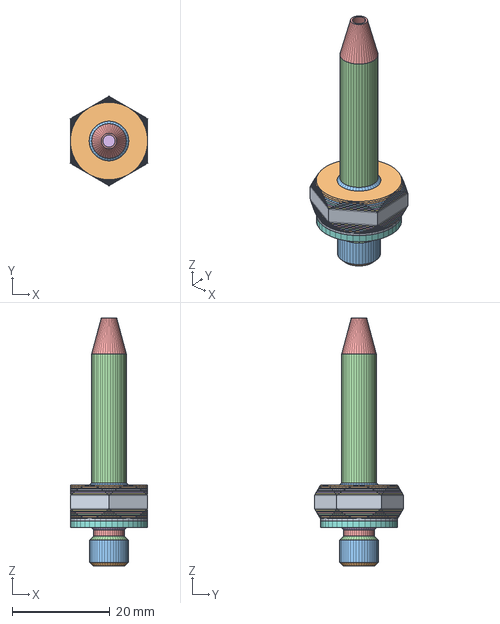
[picture p181: CAD file, 2026-11-09]
PSI-Documents/Engineering Documents/CADs_Nosso/Burner/Serie_1100_a_1109/S1101MFD1268_Coflow_Burner_Collar.stp
15.9 x 18.3 x 50.9 mm
