EmersonBJ/nasa-acme-burner-cad-cfd/PSI-Documents/Engineering Documents/CADs_Nosso/Expt_Mounting_Structure/Montagens/s1101mfa1000.step

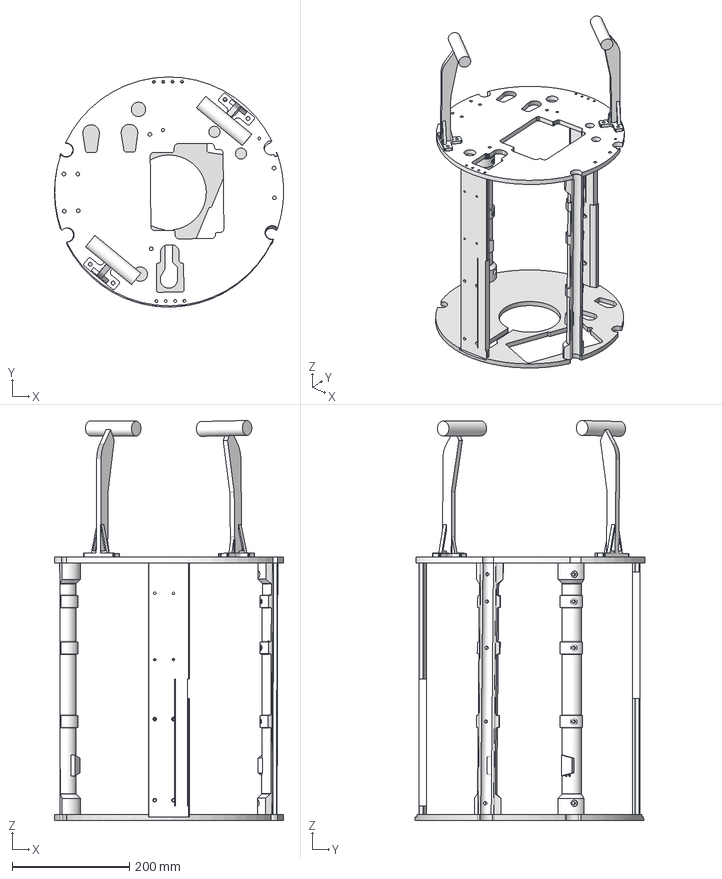
[picture p182: CAD file, 2026-11-09]
PSI-Documents/Engineering Documents/CADs_Nosso/Expt_Mounting_Structure/Montagens/s1101mfa1000.step
391.5 x 393.0 x 683.4 mm
macro_mfd1004
s1101mfd1014 x 2
s1101mfd1008 x 2
macro_mfd1004_1
clean_handle_test x 2
