EmersonBJ/nasa-acme-burner-cad-cfd/PSI-Documents/Engineering Documents/CADs_Nosso/Expt_Mounting_Structure/Montagens/s1101mfa1000/s1101mfa1700.stp

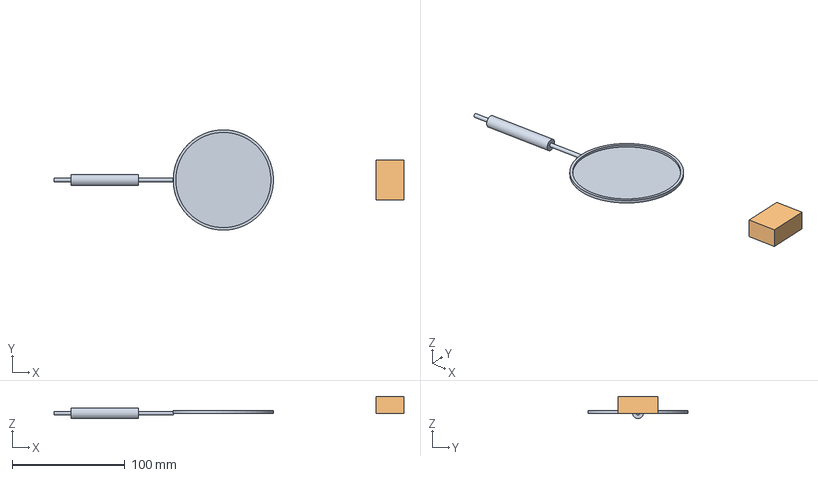
[picture p183: CAD file, 2026-11-09]
PSI-Documents/Engineering Documents/CADs_Nosso/Expt_Mounting_Structure/Montagens/s1101mfa1000/s1101mfa1700.stp
310.0 x 88.9 x 19.8 mm
