EmersonBJ/nasa-acme-burner-cad-cfd/PSI-Documents/Engineering Documents/CADs_Nosso/Expt_Mounting_Structure/Pecas/s1101mfd1021.stp

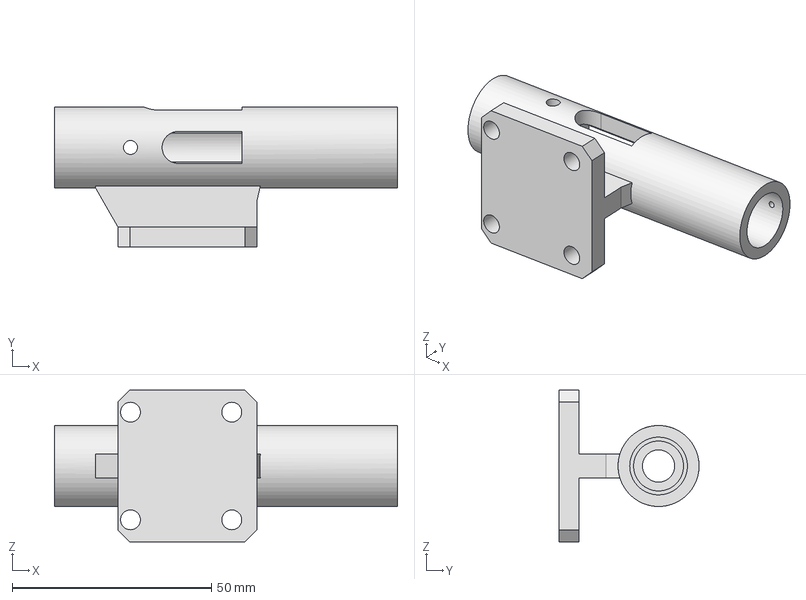
[picture p184: CAD file, 2026-11-09]
PSI-Documents/Engineering Documents/CADs_Nosso/Expt_Mounting_Structure/Pecas/s1101mfd1021.stp
86.0 x 35.2 x 38.1 mm
