EmersonBJ/nasa-acme-burner-cad-cfd/PSI-Documents/Engineering Documents/CADs_Nosso/Igniter/ref,/montagem/s1101mfa1300_montado_corrigido.stp

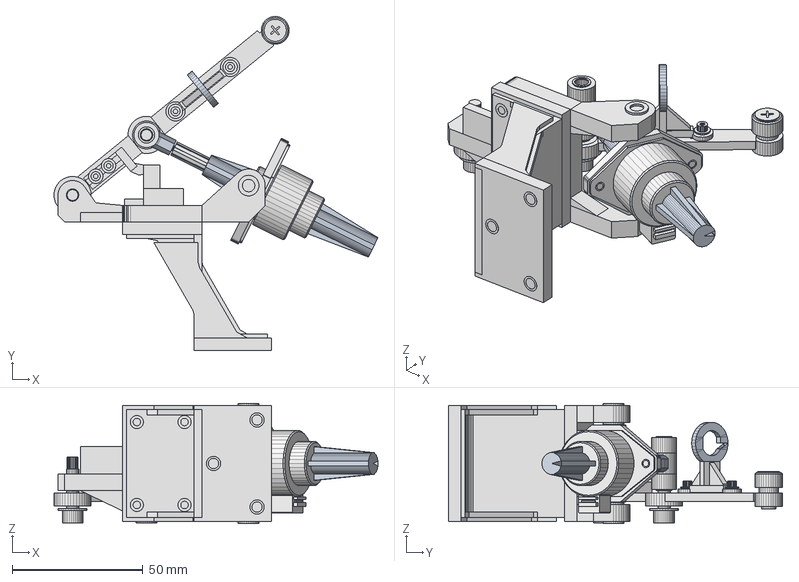
[picture p185: CAD file, 2026-11-09]
PSI-Documents/Engineering Documents/CADs_Nosso/Igniter/ref,/montagem/s1101mfa1300_montado_corrigido.stp
124.1 x 128.0 x 46.0 mm
S1101MFA1303
S1101MFD1302
IGNITER_ATUADOR_ALL
IGNITER_BRACO_ALL
