EmersonBJ/nasa-acme-burner-cad-cfd/PSI-Documents/Engineering Documents/CADs_Nosso/Igniter/ref,/peca/igniter_atuador_all.step

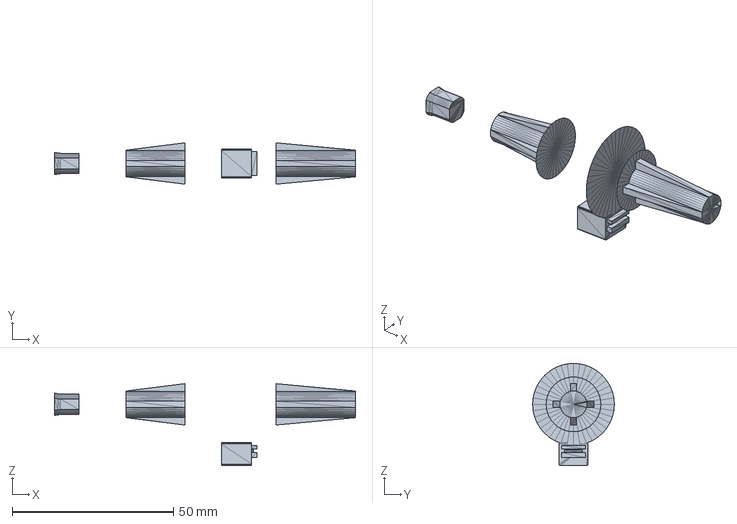
[picture p186: CAD file, 2026-11-09]
PSI-Documents/Engineering Documents/CADs_Nosso/Igniter/ref,/peca/igniter_atuador_all.step
93.4 x 25.4 x 31.7 mm
