EmersonBJ/nasa-acme-burner-cad-cfd/PSI-Documents/Engineering Documents/CADs_Nosso/Serie_1100_a_1109/S1101MFD1201.stp

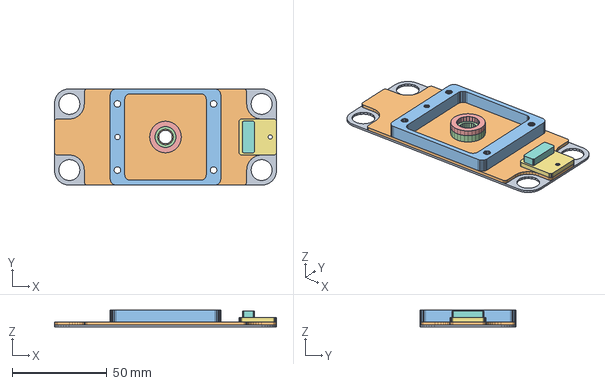
[picture p187: CAD file, 2026-11-09]
PSI-Documents/Engineering Documents/CADs_Nosso/Serie_1100_a_1109/S1101MFD1201.stp
117.3 x 50.8 x 8.74 mm
