EmersonBJ/nasa-acme-burner-cad-cfd/CAD/02_Experiment_Mounting_Structure_EMS/s1101mfd1002.stp

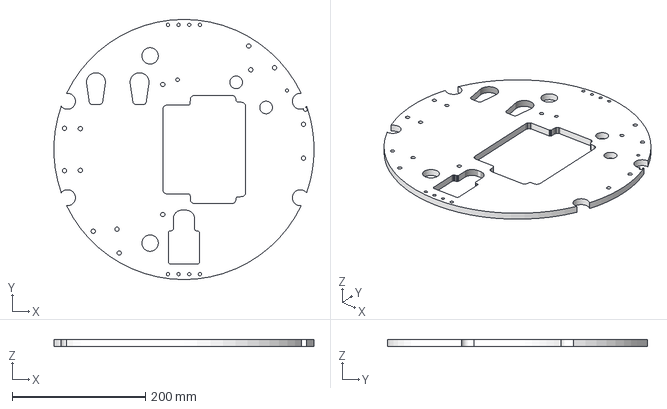
[picture p188: CAD file, 2026-11-09]
CAD/02_Experiment_Mounting_Structure_EMS/s1101mfd1002.stp
390.8 x 391.0 x 10.0 mm
