EmersonBJ/nasa-acme-burner-cad-cfd/CAD/05_Thermal_Rake_Array/S1101MFA1606.stp

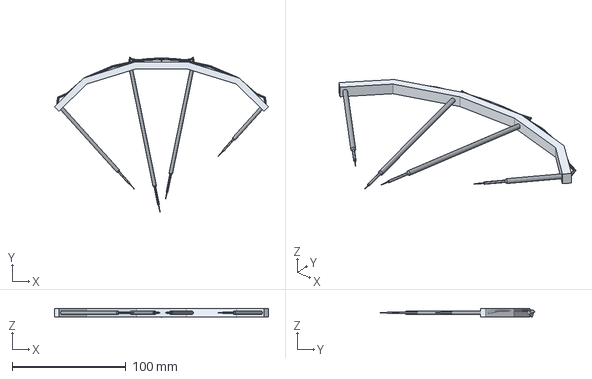
[picture p189: CAD file, 2026-11-09]
CAD/05_Thermal_Rake_Array/S1101MFA1606.stp
188.1 x 136.1 x 7.53 mm
