EmersonBJ/nasa-acme-burner-cad-cfd/PSI-Documents/Engineering Documents/CADs_Nosso/Expt_Mounting_Structure/Montagens/s1101mfa1003.stp

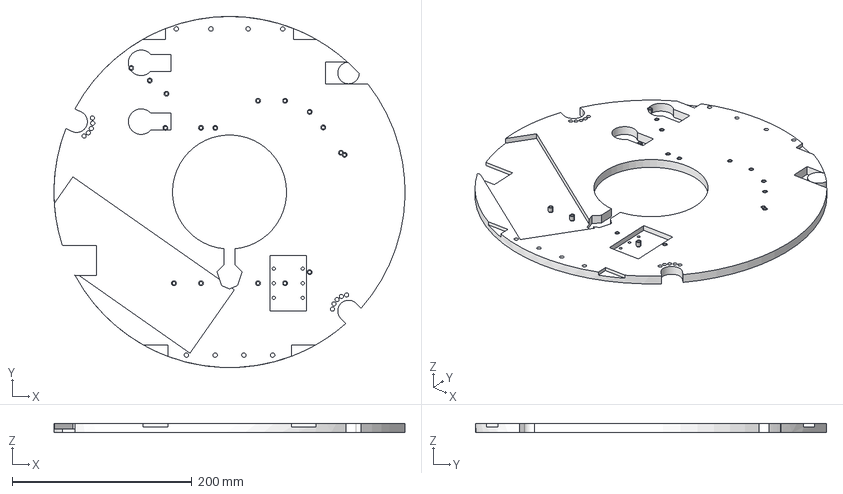
[picture p190: CAD file, 2026-11-09]
PSI-Documents/Engineering Documents/CADs_Nosso/Expt_Mounting_Structure/Montagens/s1101mfa1003.stp
390.9 x 391.0 x 10.0 mm
s1101mfd1004
ms51830ca103l x 17
