EmersonBJ/nasa-acme-burner-cad-cfd/PSI-Documents/Engineering Documents/CADs_Nosso/Expt_Mounting_Structure/Pecas/nas1102e08_12.stp

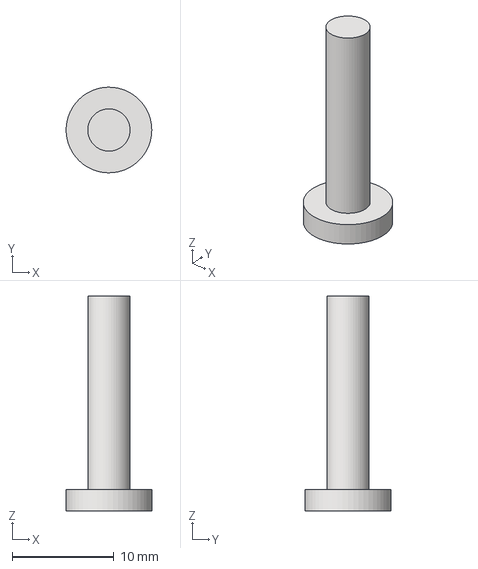
[picture p191: CAD file, 2026-11-09]
PSI-Documents/Engineering Documents/CADs_Nosso/Expt_Mounting_Structure/Pecas/nas1102e08_12.stp
8.42 x 8.43 x 21.2 mm
