EmersonBJ/nasa-acme-burner-cad-cfd/PSI-Documents/Engineering Documents/CADs_Nosso/Igniter/Pecas/S1101MFD1320.stp

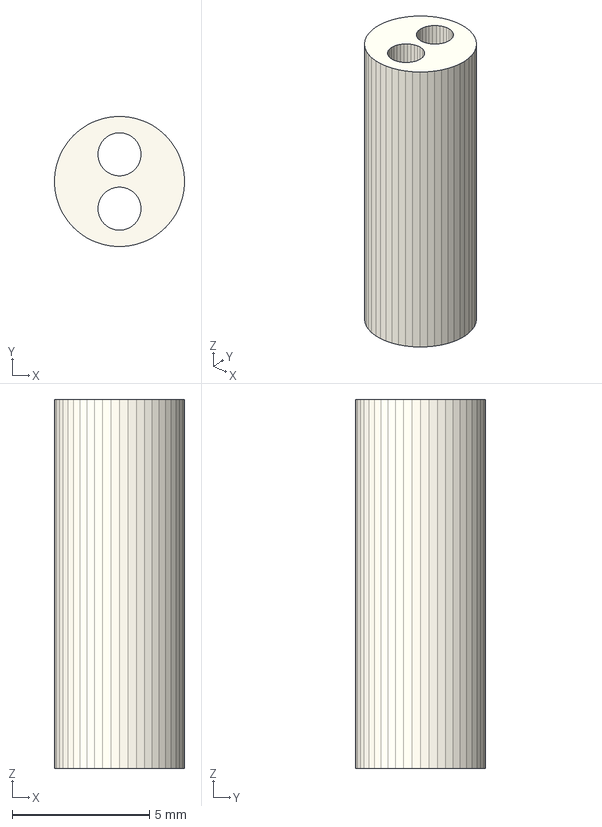
[picture p192: CAD file, 2026-11-09]
PSI-Documents/Engineering Documents/CADs_Nosso/Igniter/Pecas/S1101MFD1320.stp
4.75 x 4.75 x 13.5 mm
