EmersonBJ/nasa-acme-burner-cad-cfd/CAD/02_Experiment_Mounting_Structure_EMS/s1101mfa1026.stp

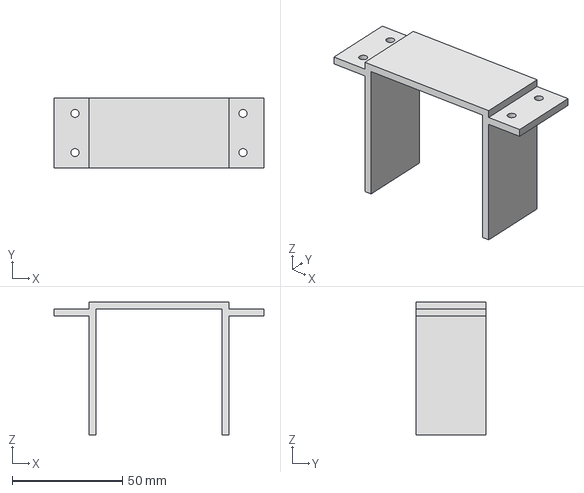
[picture p193: CAD file, 2026-11-09]
CAD/02_Experiment_Mounting_Structure_EMS/s1101mfa1026.stp
95.2 x 31.8 x 60.3 mm
