EmersonBJ/nasa-acme-burner-cad-cfd/CAD/03_Burner_Assembly/S1101MFA1218_A.step

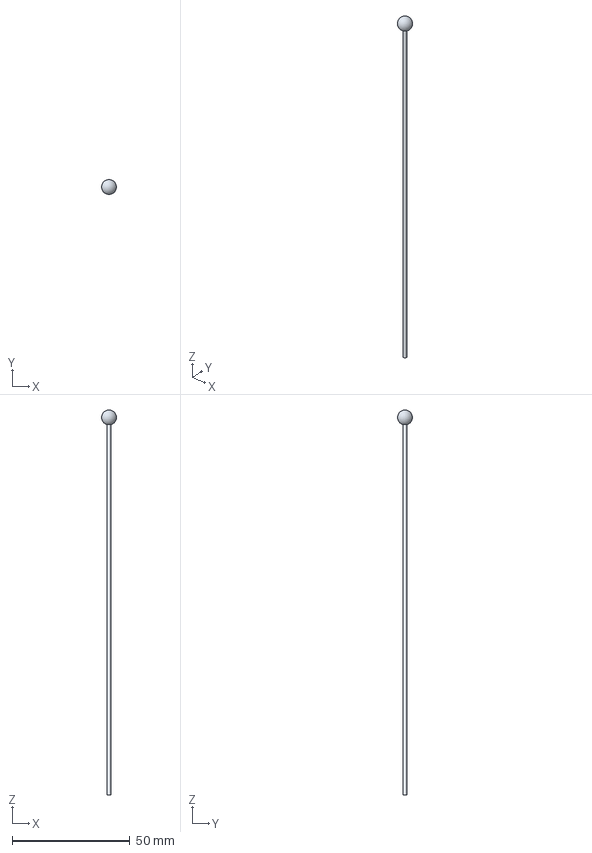
[picture p194: CAD file, 2026-11-09]
CAD/03_Burner_Assembly/S1101MFA1218_A.step
6.35 x 6.35 x 163.4 mm
