EmersonBJ/nasa-acme-burner-cad-cfd/CAD/04_Igniter_Assembly/igniter_braco_all.step

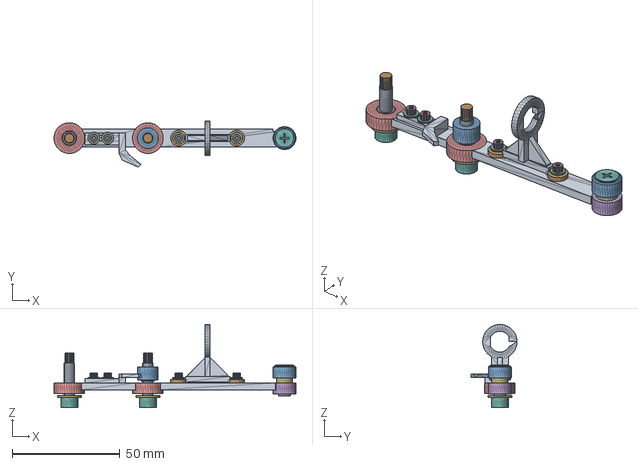
[picture p195: CAD file, 2026-11-09]
CAD/04_Igniter_Assembly/igniter_braco_all.step
112.5 x 21.5 x 38.6 mm
