EmersonBJ/nasa-acme-burner-cad-cfd/CAD/06_Standard_Hardware_Fasteners/nas1352n04_6.stp

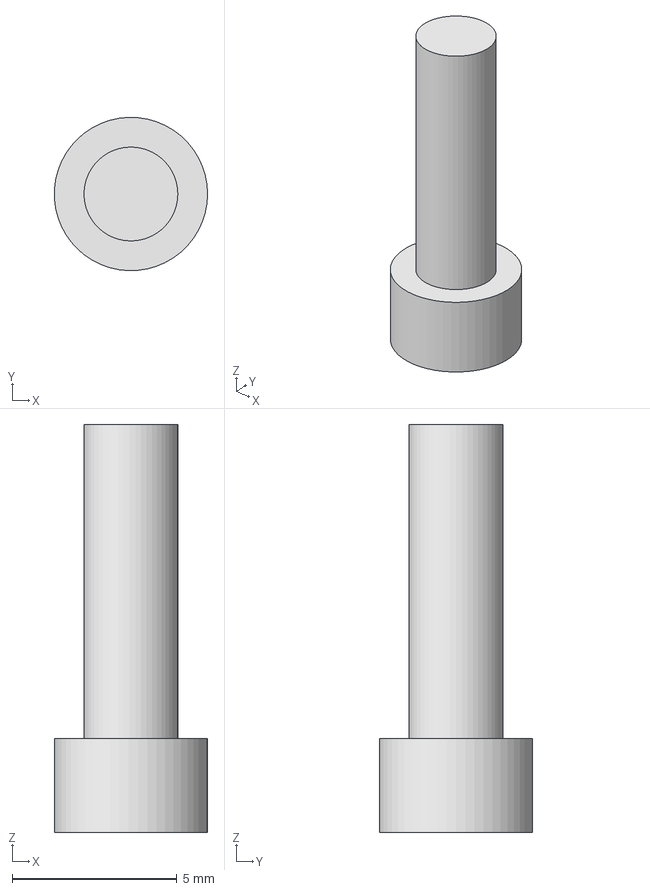
[picture p196: CAD file, 2026-11-09]
CAD/06_Standard_Hardware_Fasteners/nas1352n04_6.stp
4.64 x 4.65 x 12.4 mm
