EmersonBJ/nasa-acme-burner-cad-cfd/PSI-Documents/Engineering Documents/CADs_Nosso/Expt_Mounting_Structure/Pecas/nas1352n08_8.stp

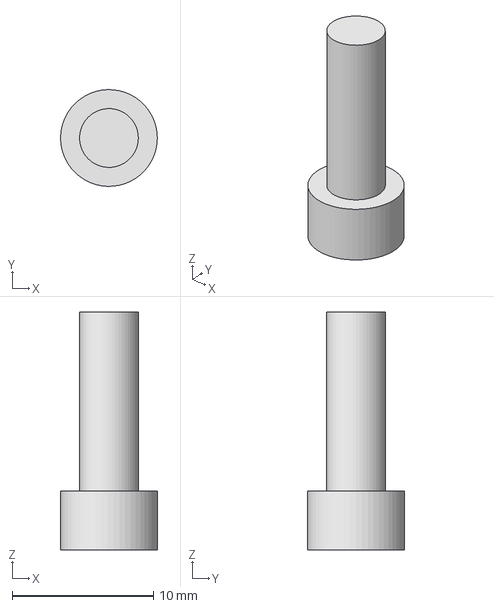
[picture p197: CAD file, 2026-11-09]
PSI-Documents/Engineering Documents/CADs_Nosso/Expt_Mounting_Structure/Pecas/nas1352n08_8.stp
6.85 x 6.85 x 16.9 mm
