EmersonBJ/nasa-acme-burner-cad-cfd/PSI-Documents/Engineering Documents/CADs_Nosso/Igniter/Pecas/s1101mfa1301.step

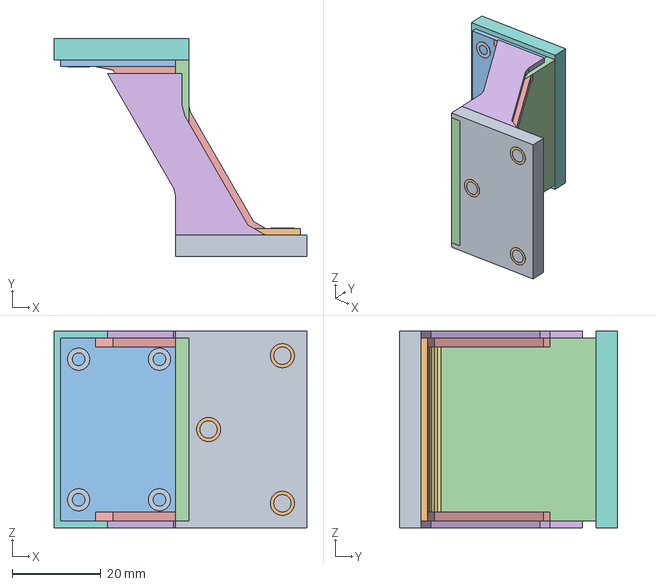
[picture p198: CAD file, 2026-11-09]
PSI-Documents/Engineering Documents/CADs_Nosso/Igniter/Pecas/s1101mfa1301.step
57.1 x 49.3 x 44.5 mm
