EmersonBJ/nasa-acme-burner-cad-cfd/CAD/02_Experiment_Mounting_Structure_EMS/s1101mfa1805.stp

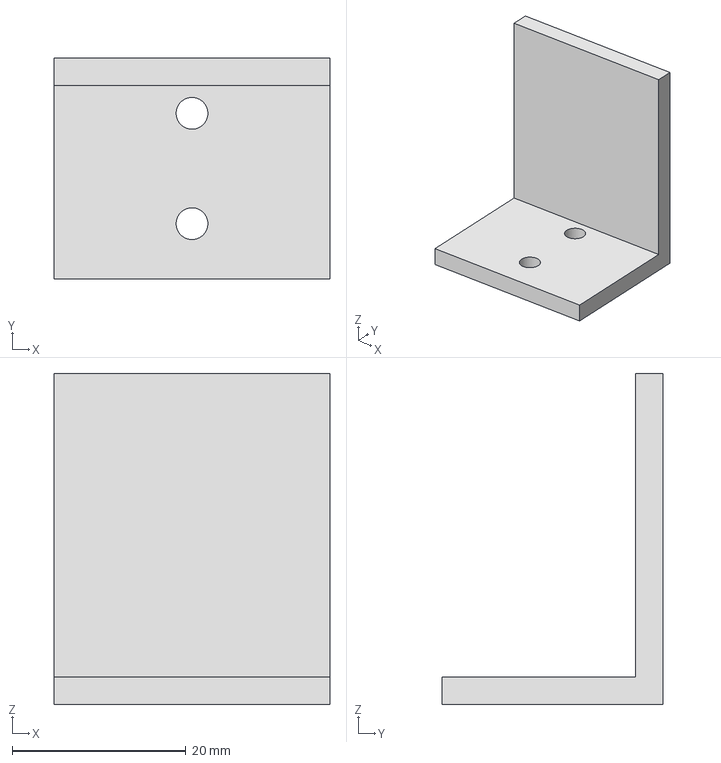
[picture p199: CAD file, 2026-11-09]
CAD/02_Experiment_Mounting_Structure_EMS/s1101mfa1805.stp
31.8 x 25.4 x 38.1 mm
