EmersonBJ/nasa-acme-burner-cad-cfd/CAD/06_Standard_Hardware_Fasteners/nas620c4l.stp

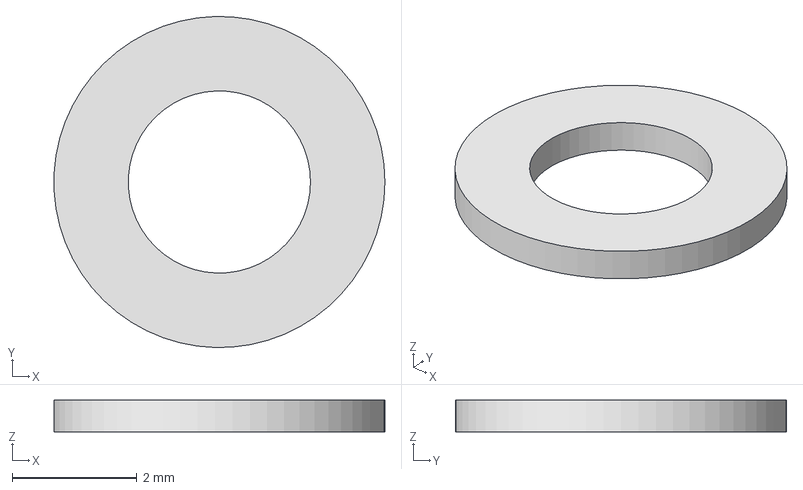
[picture p200: CAD file, 2026-11-09]
CAD/06_Standard_Hardware_Fasteners/nas620c4l.stp
5.30 x 5.31 x 0.508 mm
