EmersonBJ/nasa-acme-burner-cad-cfd/PSI-Documents/Engineering Documents/CADs_Nosso/Expt_Mounting_Structure/Pecas/s1101mfd1513.stp

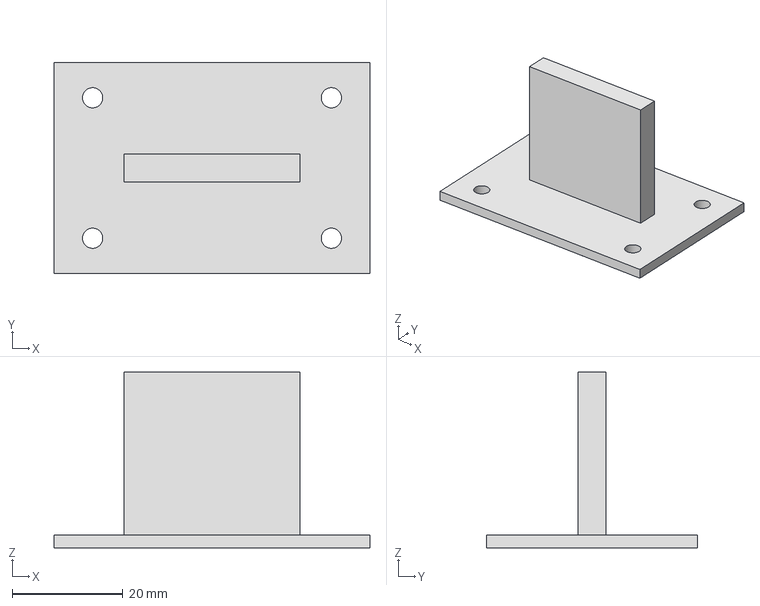
[picture p201: CAD file, 2026-11-09]
PSI-Documents/Engineering Documents/CADs_Nosso/Expt_Mounting_Structure/Pecas/s1101mfd1513.stp
57.1 x 38.1 x 31.8 mm
