EmersonBJ/nasa-acme-burner-cad-cfd/PSI-Documents/Engineering Documents/CADs_Nosso/Igniter/Pecas/s1101mfd1305.step

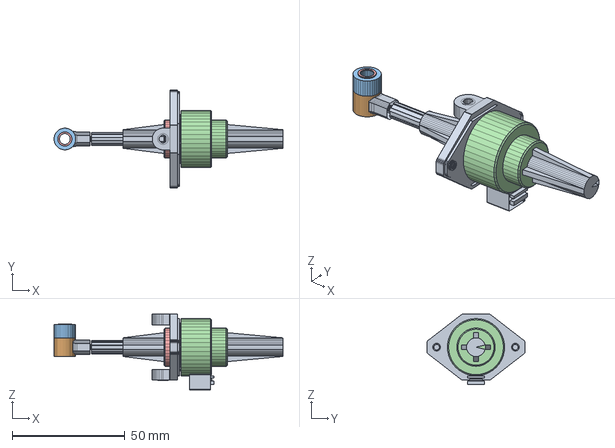
[picture p202: CAD file, 2026-11-09]
PSI-Documents/Engineering Documents/CADs_Nosso/Igniter/Pecas/s1101mfd1305.step
101.7 x 43.6 x 33.7 mm
