EmersonBJ/nasa-acme-burner-cad-cfd/CAD/02_Experiment_Mounting_Structure_EMS/s1101mfd1008.step

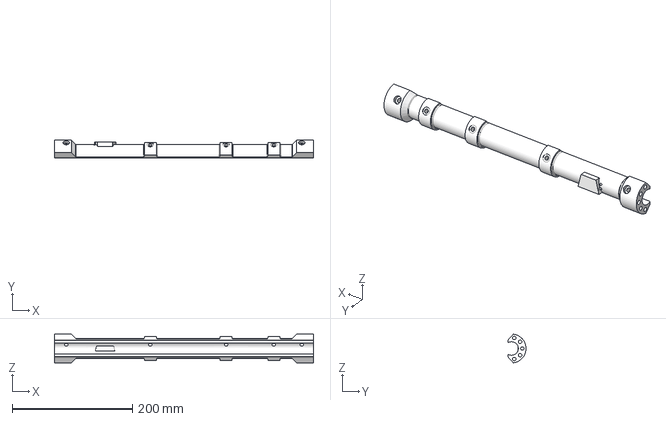
[picture p203: CAD file, 2026-11-09]
CAD/02_Experiment_Mounting_Structure_EMS/s1101mfd1008.step
430.0 x 30.0 x 47.7 mm
