EmersonBJ/nasa-acme-burner-cad-cfd/CAD/04_Igniter_Assembly/s1101mfd1302_igniter_bracket.step

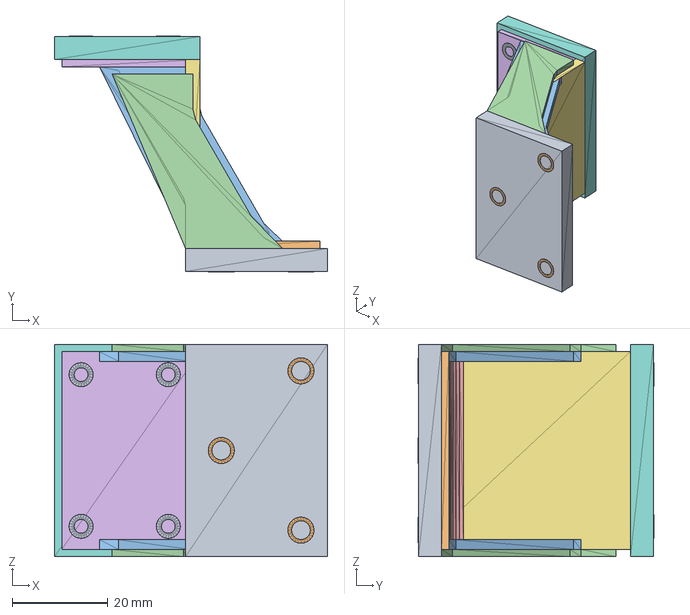
[picture p204: CAD file, 2026-11-09]
CAD/04_Igniter_Assembly/s1101mfd1302_igniter_bracket.step
57.1 x 49.3 x 44.5 mm
