EmersonBJ/nasa-acme-burner-cad-cfd/CAD/06_Standard_Hardware_Fasteners/nas620c8.stp

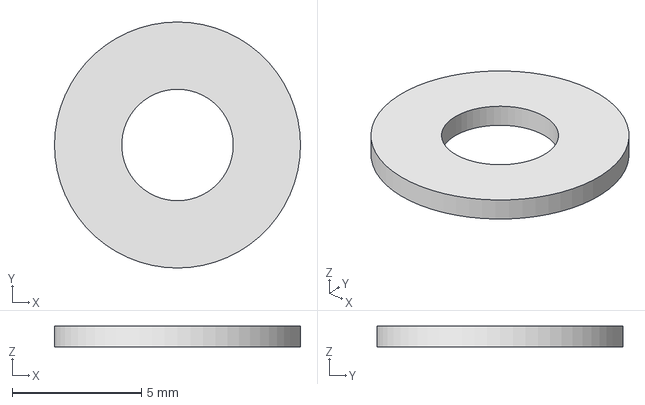
[picture p205: CAD file, 2026-11-09]
CAD/06_Standard_Hardware_Fasteners/nas620c8.stp
9.53 x 9.53 x 0.813 mm
