EmersonBJ/nasa-acme-burner-cad-cfd/CAD/02_Experiment_Mounting_Structure_EMS/s1101mfd1018.stp

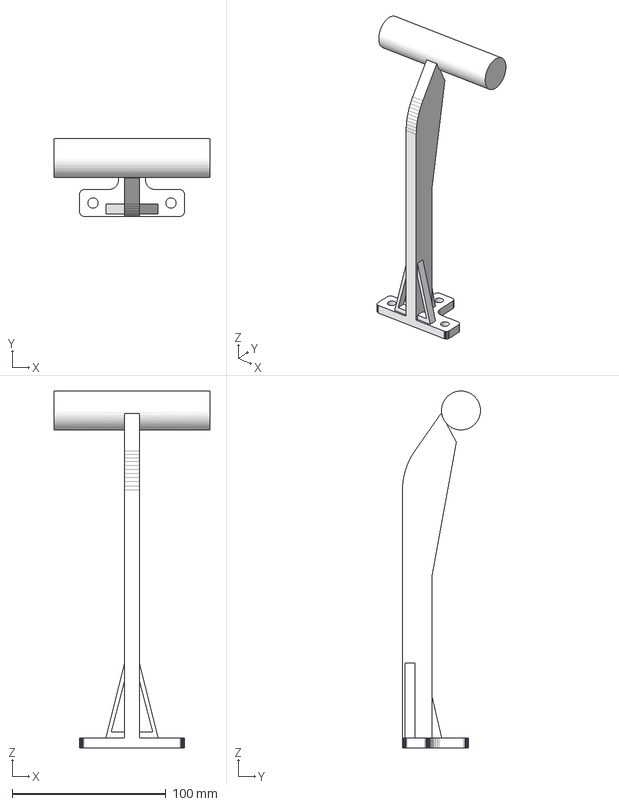
[picture p206: CAD file, 2026-11-09]
CAD/02_Experiment_Mounting_Structure_EMS/s1101mfd1018.stp
101.6 x 50.8 x 232.6 mm
