EmersonBJ/nasa-acme-burner-cad-cfd/CAD/06_Standard_Hardware_Fasteners/nas620c8l.stp

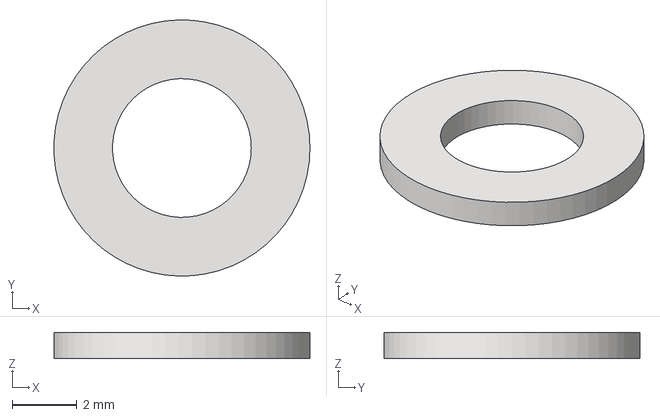
[picture p207: CAD file, 2026-11-09]
CAD/06_Standard_Hardware_Fasteners/nas620c8l.stp
7.92 x 7.92 x 0.813 mm
