EmersonBJ/nasa-acme-burner-cad-cfd/CAD/02_Experiment_Mounting_Structure_EMS/s1101mfa1016.stp

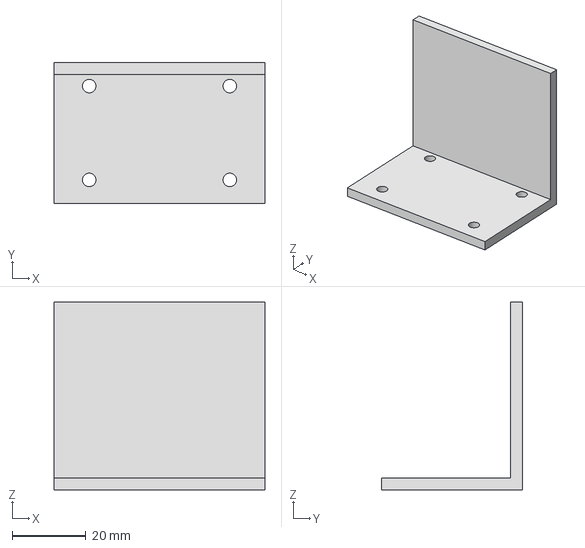
[picture p208: CAD file, 2026-11-09]
CAD/02_Experiment_Mounting_Structure_EMS/s1101mfa1016.stp
57.1 x 38.1 x 50.8 mm
