EmersonBJ/nasa-acme-burner-cad-cfd/PSI-Documents/Engineering Documents/CADs_Nosso/Expt_Mounting_Structure/Pecas/nas1352n06_10.stp

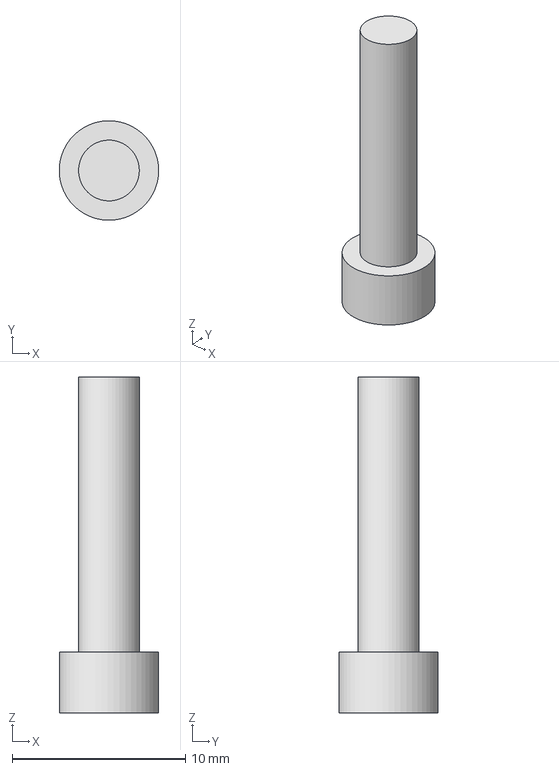
[picture p209: CAD file, 2026-11-09]
PSI-Documents/Engineering Documents/CADs_Nosso/Expt_Mounting_Structure/Pecas/nas1352n06_10.stp
5.73 x 5.74 x 19.4 mm
