EmersonBJ/nasa-acme-burner-cad-cfd/CAD/02_Experiment_Mounting_Structure_EMS/s1101mfd1015.stp

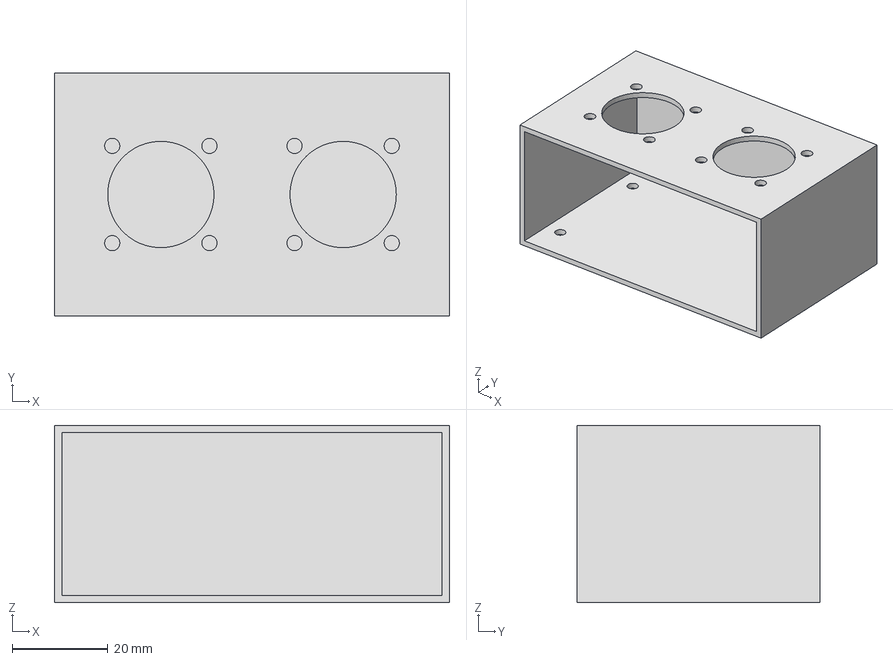
[picture p210: CAD file, 2026-11-09]
CAD/02_Experiment_Mounting_Structure_EMS/s1101mfd1015.stp
82.6 x 50.8 x 37.1 mm
