EmersonBJ/nasa-acme-burner-cad-cfd/CAD/06_Standard_Hardware_Fasteners/nas1351n4_14.stp

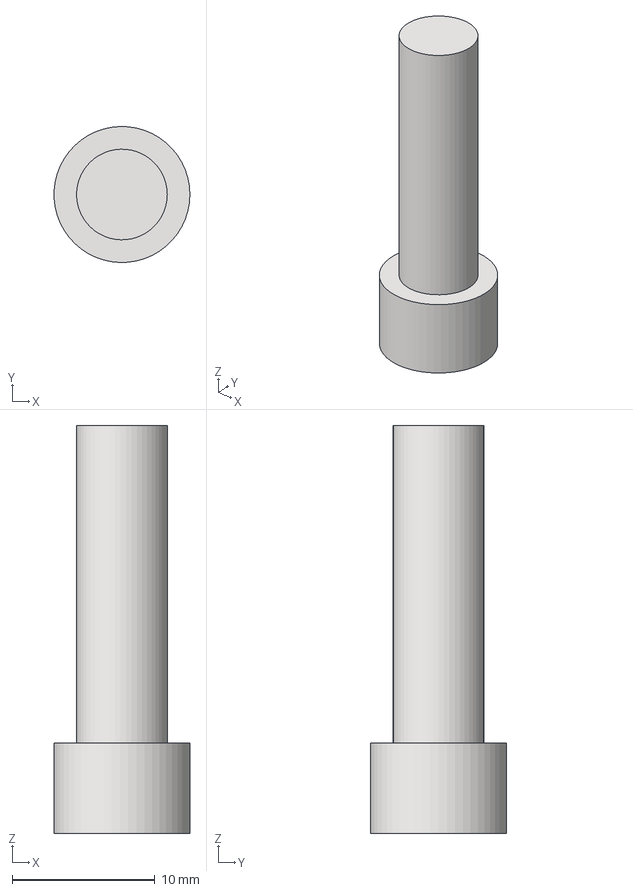
[picture p211: CAD file, 2026-11-09]
CAD/06_Standard_Hardware_Fasteners/nas1351n4_14.stp
9.52 x 9.52 x 28.6 mm
