EmersonBJ/nasa-acme-burner-cad-cfd/(list of files, cad)

Other CAD files:
CAD/03_Burner_Assembly/s1101efa1215_FULL.stp
CAD/05_Thermal_Rake_Array/s1101mfa1609_1609_OPER.stp
PSI-Documents/Engineering Documents/CADs_Nosso/Burner/Montagens/S1101MFA1220_B.step
PSI-Documents/Engineering Documents/CADs_Nosso/CIR_Chamber/cir_window_cover_FIG56.stp
PSI-Documents/Engineering Documents/CADs_Nosso/Igniter/Montagens/S1101MFA1319_C.step
PSI-Documents/Engineering Documents/CADs_Nosso/Igniter/Pecas/s1101mfa1339_ponteira_ignitor.stp
CAD/03_Burner_Assembly/S1101MFA1216_E.step
CAD/04_Igniter_Assembly/s1101mfa1300.stp
PSI-Documents/Engineering Documents/CADs_Nosso/CIR_Chamber/uml_window_cover_individual.stp
PSI-Documents/Engineering Documents/CADs_Nosso/Igniter/Montagens/s1101mfa1300_montado_corrigido.stp
PSI-Documents/Engineering Documents/CADs_Nosso/CIR_Chamber/cir_window_cover_FIG57.stp
CAD/04_Igniter_Assembly/s1101mfa1303_base_unificada.step
PSI-Documents/Engineering Documents/CADs_Nosso/CIR_Chamber/cir_window_cover_SINGLE.stp
PSI-Documents/Engineering Documents/CADs_Nosso/CIR_Chamber/cir_anel_8_janelas_e_tampas_ansys.stp
PSI-Documents/Engineering Documents/CADs_Nosso/Expt_Mounting_Structure/Pecas/nas1149en832r.stp
CAD/04_Igniter_Assembly/s1101mfa1308.step
PSI-Documents/Engineering Documents/CADs_Nosso/CIR_Chamber/cir_window_cover_SFLAME.stp
PSI-Documents/Engineering Documents/CADs_Nosso/Expt_Mounting_Structure/Pecas/s1101mfd1018_extraction_handle.step
CAD/06_Standard_Hardware_Fasteners/nas1149en632r.stp
CAD/02_Experiment_Mounting_Structure_EMS/S1101MFD1002_CAD_in.step
CAD/01_Chamber_Insert/s1101mfa0003_chamber_insert.iam
CAD/01_Chamber_Insert/s1101mfa0003_chamber_insert.stp
CAD/02_Experiment_Mounting_Structure_EMS/s1101mfa1000.iam
CAD/02_Experiment_Mounting_Structure_EMS/s1101mfa1001.iam
CAD/02_Experiment_Mounting_Structure_EMS/s1101mfa1003.iam
CAD/02_Experiment_Mounting_Structure_EMS/s1101mfa1011.iam
CAD/02_Experiment_Mounting_Structure_EMS/s1101mfa1013.iam
CAD/02_Experiment_Mounting_Structure_EMS/s1101mfa1016.ipt
CAD/02_Experiment_Mounting_Structure_EMS/s1101mfd1004.ipt
CAD/02_Experiment_Mounting_Structure_EMS/s1101mfd1008.stp
CAD/02_Experiment_Mounting_Structure_EMS/s1101mfd1009.ipt
CAD/02_Experiment_Mounting_Structure_EMS/s1101mfd1014_original_backup.ipt
CAD/02_Experiment_Mounting_Structure_EMS/s1101mfd1015.ipt
CAD/02_Experiment_Mounting_Structure_EMS/s1101mfd1722.ipt
CAD/02_Experiment_Mounting_Structure_EMS/s1101mfp1022.ipt
CAD/04_Igniter_Assembly/s1101mfa1301.ipt
CAD/04_Igniter_Assembly/s1101mfa1308.ipt
CAD/06_Standard_Hardware_Fasteners/ms51830ca103l.stp
CAD/06_Standard_Hardware_Fasteners/nas1102e08_12.ipt
CAD/06_Standard_Hardware_Fasteners/nas1149en632r.ipt
CAD/06_Standard_Hardware_Fasteners/nas1352n06_10.ipt
CAD/06_Standard_Hardware_Fasteners/nas1352n06_6.ipt
CAD/06_Standard_Hardware_Fasteners/nas620c4l.ipt
CAD/06_Standard_Hardware_Fasteners/washer_no6_ss.stp
PSI-Documents/Engineering Documents/CADs_Nosso/Expt_Mounting_Structure/Montagens/s1101mfa1000.stp
PSI-Documents/Engineering Documents/CADs_Nosso/Expt_Mounting_Structure/Montagens/s1101mfa1000/nas1149e0432r.ipt
PSI-Documents/Engineering Documents/CADs_Nosso/Expt_Mounting_Structure/Montagens/s1101mfa1000/nas1351n4_14.ipt
PSI-Documents/Engineering Documents/CADs_Nosso/Expt_Mounting_Structure/Montagens/s1101mfa1000/s1101mfa1016.ipt
PSI-Documents/Engineering Documents/CADs_Nosso/Expt_Mounting_Structure/Montagens/s1101mfa1000/s1101mfa1026.ipt
PSI-Documents/Engineering Documents/CADs_Nosso/Expt_Mounting_Structure/Montagens/s1101mfa1000/s1101mfa1028.ipt
PSI-Documents/Engineering Documents/CADs_Nosso/Expt_Mounting_Structure/Montagens/s1101mfa1000/s1101mfa1700.ipt
PSI-Documents/Engineering Documents/CADs_Nosso/Expt_Mounting_Structure/Montagens/s1101mfa1000/s1101mfa1805.ipt
PSI-Documents/Engineering Documents/CADs_Nosso/Expt_Mounting_Structure/Montagens/s1101mfa1000/s1101mfd1002.ipt
PSI-Documents/Engineering Documents/CADs_Nosso/Expt_Mounting_Structure/Montagens/s1101mfa1000/s1101mfd1008.ipt
PSI-Documents/Engineering Documents/CADs_Nosso/Expt_Mounting_Structure/Montagens/s1101mfa1000/s1101mfd1014.ipt
PSI-Documents/Engineering Documents/CADs_Nosso/Expt_Mounting_Structure/Montagens/s1101mfa1000/s1101mfd1018.ipt
PSI-Documents/Engineering Documents/CADs_Nosso/Expt_Mounting_Structure/Montagens/s1101mfa1000/s1101mfd1021.ipt
PSI-Documents/Engineering Documents/CADs_Nosso/Expt_Mounting_Structure/Montagens/s1101mfa1000/s1101mfd1513.ipt
PSI-Documents/Engineering Documents/CADs_Nosso/Expt_Mounting_Structure/Montagens/s1101mfa1000/s1101mfd1722.ipt
PSI-Documents/Engineering Documents/CADs_Nosso/Expt_Mounting_Structure/Montagens/s1101mfa1000/s1101mfp1010.ipt
PSI-Documents/Engineering Documents/CADs_Nosso/Expt_Mounting_Structure/Montagens/s1101mfa1001.iam
PSI-Documents/Engineering Documents/CADs_Nosso/Expt_Mounting_Structure/Montagens/s1101mfa1003.iam
PSI-Documents/Engineering Documents/CADs_Nosso/Expt_Mounting_Structure/Montagens/s1101mfa1005.iam
PSI-Documents/Engineering Documents/CADs_Nosso/Expt_Mounting_Structure/Montagens/s1101mfa1007.iam
PSI-Documents/Engineering Documents/CADs_Nosso/Expt_Mounting_Structure/Montagens/s1101mfa1018.iam
PSI-Documents/Engineering Documents/CADs_Nosso/Expt_Mounting_Structure/Montagens/s1101mfa1020.iam
PSI-Documents/Engineering Documents/CADs_Nosso/Expt_Mounting_Structure/Pecas/ms51830ca103l.ipt
PSI-Documents/Engineering Documents/CADs_Nosso/Expt_Mounting_Structure/Pecas/nas1149en832r.ipt
PSI-Documents/Engineering Documents/CADs_Nosso/Expt_Mounting_Structure/Pecas/nas1352n04_6.ipt
PSI-Documents/Engineering Documents/CADs_Nosso/Expt_Mounting_Structure/Pecas/nas1352n08_10.ipt
PSI-Documents/Engineering Documents/CADs_Nosso/Expt_Mounting_Structure/Pecas/nas1352n08_8.ipt
PSI-Documents/Engineering Documents/CADs_Nosso/Expt_Mounting_Structure/Pecas/nas620c6.ipt
PSI-Documents/Engineering Documents/CADs_Nosso/Expt_Mounting_Structure/Pecas/nas620c8.ipt
PSI-Documents/Engineering Documents/CADs_Nosso/Expt_Mounting_Structure/Pecas/nas620c8l.ipt
PSI-Documents/Engineering Documents/CADs_Nosso/Expt_Mounting_Structure/Pecas/s1101mfa1026.ipt
PSI-Documents/Engineering Documents/CADs_Nosso/Expt_Mounting_Structure/Pecas/s1101mfa1028.ipt
PSI-Documents/Engineering Documents/CADs_Nosso/Expt_Mounting_Structure/Pecas/s1101mfa1805.ipt
PSI-Documents/Engineering Documents/CADs_Nosso/Expt_Mounting_Structure/Pecas/s1101mfd1006.ipt
PSI-Documents/Engineering Documents/CADs_Nosso/Expt_Mounting_Structure/Pecas/s1101mfd1008_original_backup.ipt
PSI-Documents/Engineering Documents/CADs_Nosso/Expt_Mounting_Structure/Pecas/s1101mfd1012.ipt
PSI-Documents/Engineering Documents/CADs_Nosso/Expt_Mounting_Structure/Pecas/s1101mfd1513.ipt
PSI-Documents/Engineering Documents/CADs_Nosso/Expt_Mounting_Structure/Pecas/washer_no6_ss.ipt
PSI-Documents/Engineering Documents/CADs_Nosso/Expt_Mounting_Structure/_Backup_Antigo/s1101mfd1018_old.ipt
PSI-Documents/Engineering Documents/CADs_Nosso/Expt_Mounting_Structure/_Backup_Com_Fixadores/s1101mfa1000_com_fixadores.iam
PSI-Documents/Engineering Documents/CADs_Nosso/Expt_Mounting_Structure/_Backup_Com_Fixadores/s1101mfa1003_com_fixadores.iam
PSI-Documents/Engineering Documents/CADs_Nosso/Igniter/Montagens/s1101mfa1300.iam
PSI-Documents/Engineering Documents/CADs_Nosso/Igniter/Pecas/s1101mfa1303.ipt
PSI-Documents/Engineering Documents/CADs_Nosso/Igniter/Pecas/s1101mfd1305.ipt
