EmersonBJ/nasa-acme-burner-cad-cfd/PSI-Documents/Engineering Documents/Desenhos_Tecnicos_NASA/ACME_drawings_burners/MFA_Montagens/s1101mfa1207_-.pdf

D | D
8 | 7 | 6 | 5 | 4 | 3 | 1

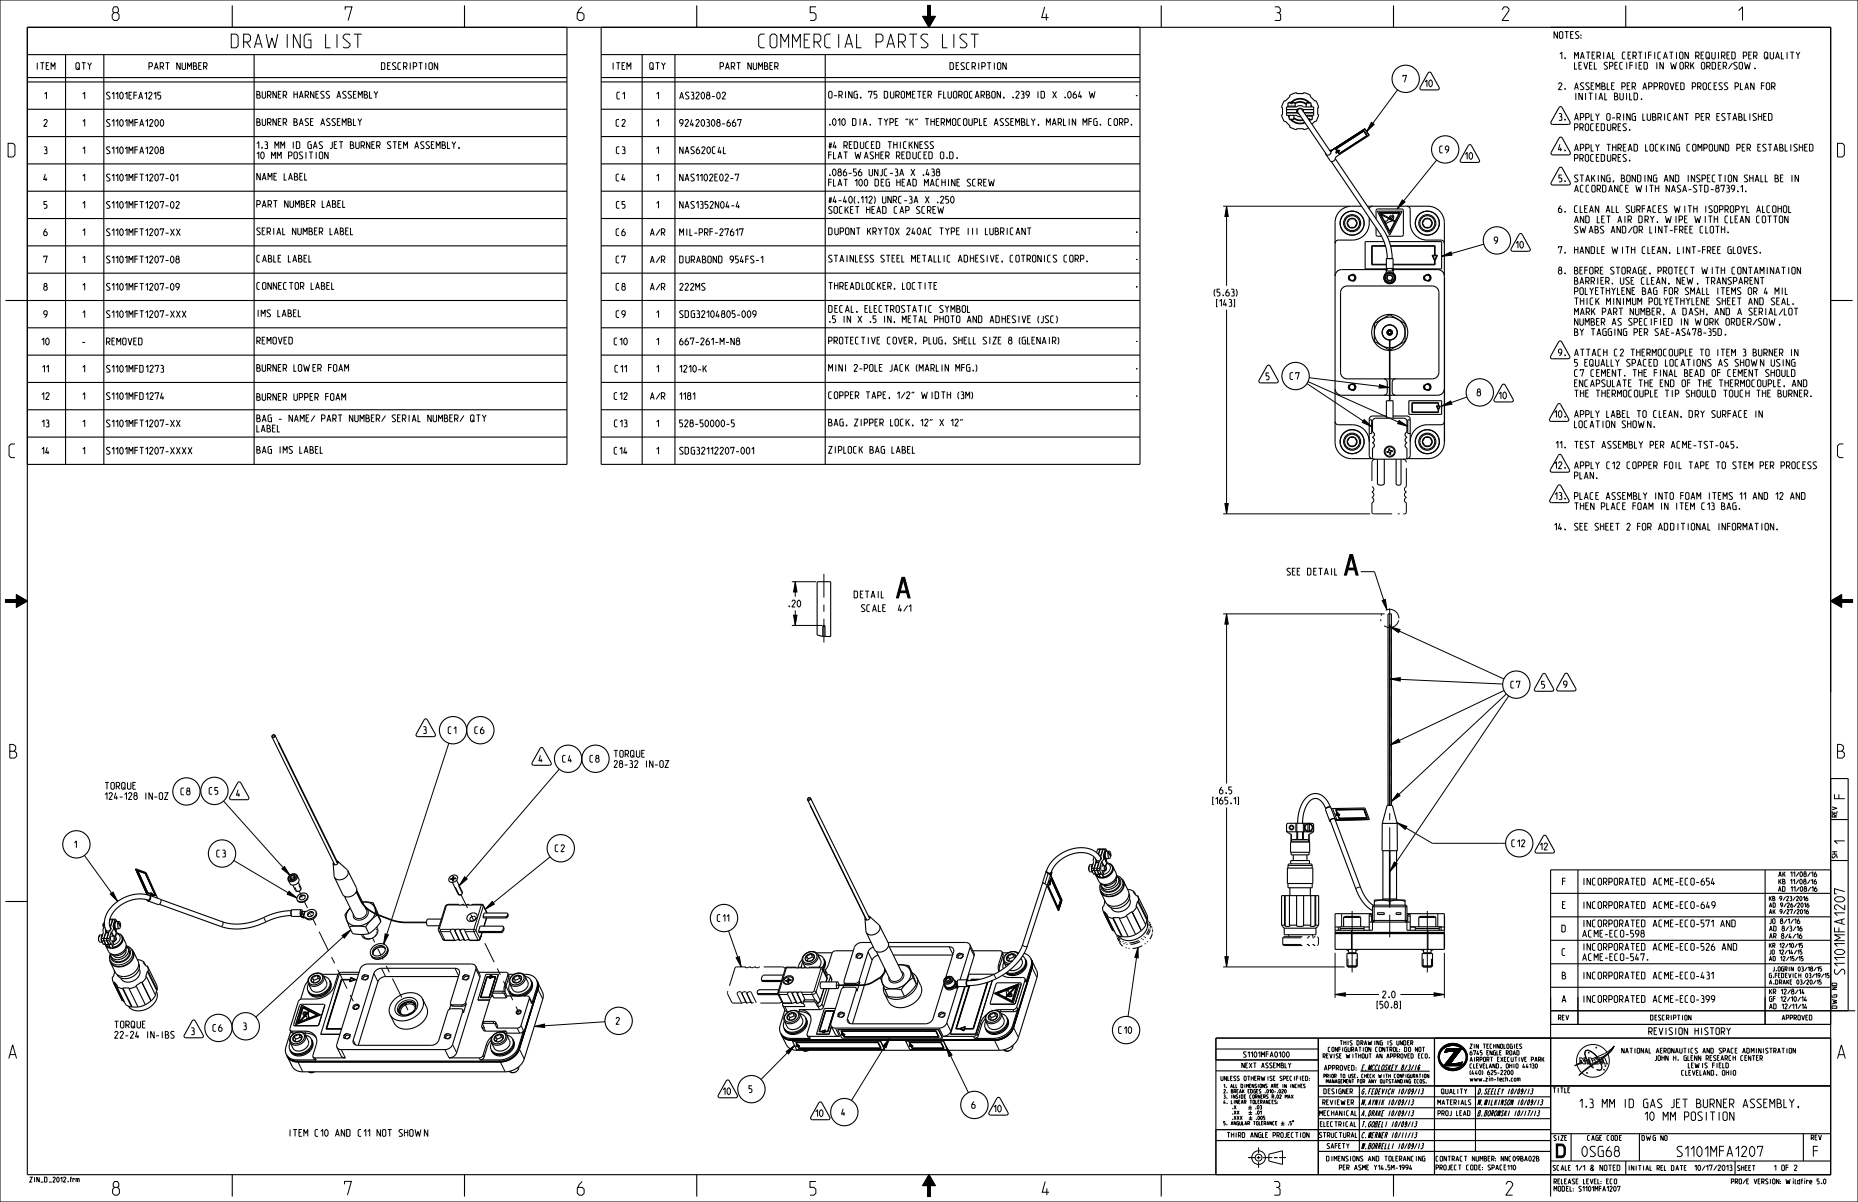
[picture p228: page 1]

NOTES:
MATERIAL CERTIFICATION REQUIRED PER QUALITY
ASSEMBLE PER APPROVED PROCESS PLAN FOR
INITIAL BUILD.
APPLY O-RING LUBRICANT PER ESTABLISHED
PROCEDURES.
APPLY THREAD LOCKING COMPOUND PER ESTABLISHED
SWABS AND/OR LINT-FREE CLOTH.
THICK MINIMUM POLYETHYLENE SHEET AND SEAL.
MARK PART NUMBER, A DASH, AND A SERIAL/LOT
BY TAGGING PER SAE-AS478-35D.
5 EQUALLY SPACED LOCATIONS AS SHOWN USING
C7 CEMENT. THE FINAL BEAD OF CEMENT SHOULD
ENCAPSULATE THE END OF THE THERMOCOUPLE, AND
THE THERMOCOUPLE TIP SHOULD TOUCH THE BURNER.
LOCATION SHOWN.
TEST ASSEMBLY PER ACME-TST-045.
PLAN.
PLACE ASSEMBLY INTO FOAM ITEMS 11 AND 12 AND

C3 | 1 | NAS620C4L | | #4 REDUCED THICKNESS FLAT WASHER REDUCED O.D.
C4 | | 1 | NAS1102E02-7 | .086-56 UNJC-3A X .438
C5 | 1 | NAS1352N04-4 | | | #4-40(.112) UNRC-3A X .250 SOCKET HEAD CAP SCREW

C6 | A/R | MIL-PRF-27617 | | DUPONT KRYTOX 240AC TYPE III LUBRICANT
C7 | A/R | DURABOND 954FS-1 | | STAINLESS STEEL METALLIC ADHESIVE, COTRONICS CORP.
C8 | A/R | 222MS | THREADLOCKER, LOCTITE
C9 | 1 | SDG32104805-009 | | DECAL, ELECTROSTATIC SYMBOL

C10 | 1 | 667-261-M-N8 | PROTECTIVE COVER, PLUG, SHELL SIZE 8 (GLENAIR)
C11 | 1 | 1210-K | | MINI 2-POLE JACK (MARLIN MFG.)
C12 | A/R | 1181 | COPPER TAPE, 1/2" WIDTH (3M)
C13 | 1 | 528-50000-5 | BAG, ZIPPER LOCK, 12" X 12"
C14 | | 1 | SDG32112207-001 | ZIPLOCK BAG LABEL

THEN PLACE FOAM IN ITEM C13 BAG.

1 DWG NO REV SH

E | INCORPORATED ACME-ECO-649 | AD 9/26/2016 AK 9/27/2016
INCORPORATED ACME-ECO-571 AND ACME-ECO-598 D | JO 8/1/16 AD 8/3/16 AR 8/4/16

INCORPORATED ACME-ECO-526 AND ACME-ECO-547. C | JO 12/14/15 AD 12/15/15

B | INCORPORATED ACME-ECO-431 | J.OGRIN 03/18/15

A | INCORPORATED ACME-ECO-399 | GF 12/10/14 AD 12/11/14
REV | DESCRIPTION | | APPROVED

THIS DRAWING IS UNDER

CONFIGURATION CONTROL: DO NOT REVISE WITHOUT AN APPROVED ECO. APPROVED: E.MCCLOSKEY 8/3/16 | ZIN TECHNOLOGIES CLEVELAND, OHIO 44130 (440) 625-2200 www.zin-tech.com | | | NATIONAL AERONAUTICS AND SPACE ADMINISTRATION CLEVELAND, OHIO

PRIOR TO USE, CHECK WITH CONFIGURATION
MANAGEMENT FOR ANY OUTSTANDING ECOS.

DESIGNER | | G.FEDEVICH 10/09/13 | QUALITY | | D.SEELEY 10/09/13 | | | | 1.3 MM ID GAS JET BURNER ASSEMBLY, 10 MM POSITION
REVIEWER | | M.AYNIK 10/09/13 | | | | | M.WILKINSON 10/09/13
A.DRAKE 10/09/13 | | | B.BOROWSKI 10/17/13
T.GOBELI 10/09/13
W.BORRELLI 10/09/13

ITEM C10 AND C11 NOT SHOWN

THIRD ANGLE PROJECTION | | | | | | | | C.WERNER 10/11/13

D | D
8 | 7 | 6 | 5 | 4 | 3 | 1

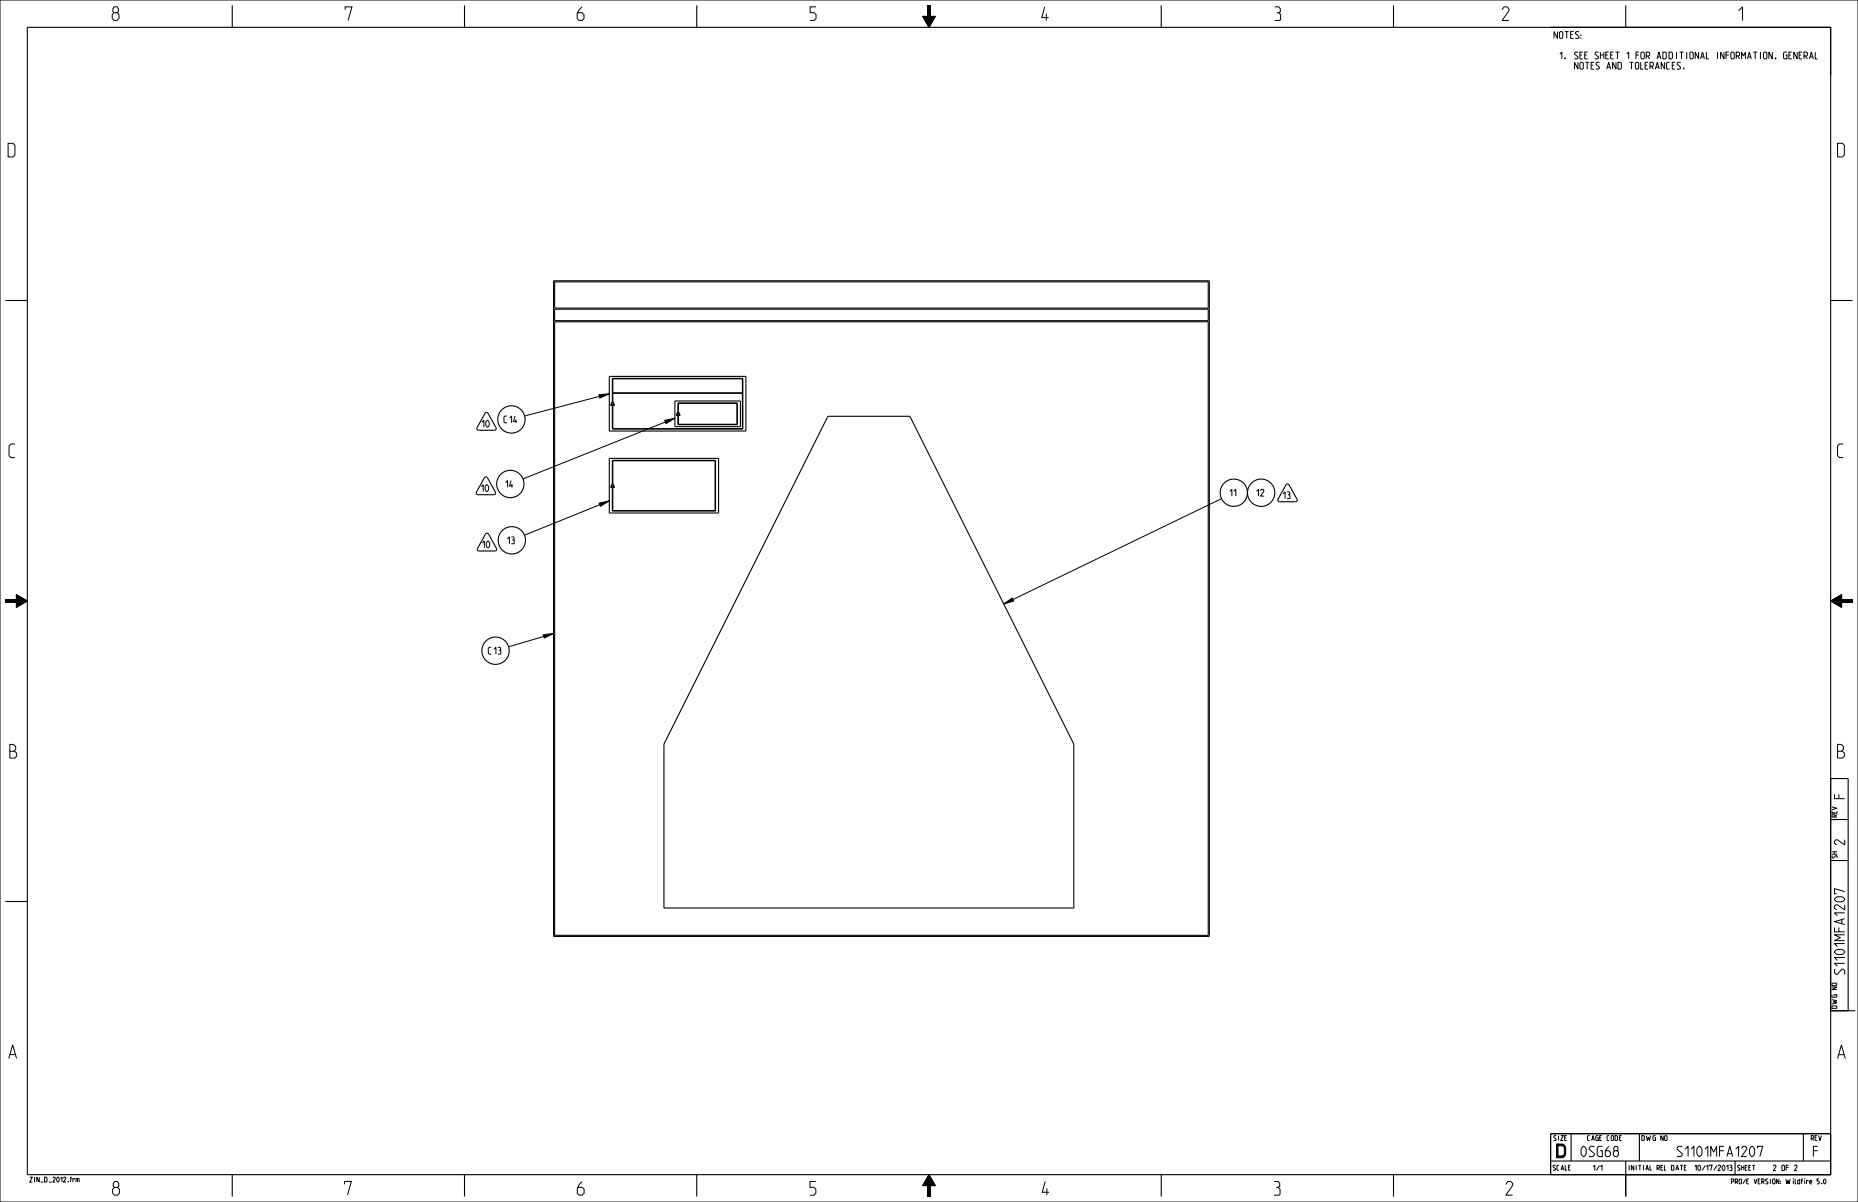
[picture p229: page 2]
SIZE; CAGE CODE; DWG NO; REV; SCALE; INITIAL REL DATE; SHEET; ZIN_D_2012.frm; SEE SHEET 1 FOR ADDITIONAL; INFORMATION, GENERAL; S1101MFA1207

NOTES:
NOTES AND TOLERANCES.

2 DWG NO REV SH

PRO/E VERSION: Wildfire 5.0
