EmersonBJ/nasa-acme-burner-cad-cfd/PSI-Documents/Engineering Documents/Desenhos_Tecnicos_NASA/ACME_drawings_gas_supply/MFA_Montagens/S1101MFA1122_E.pdf

D | D
8 | 7 | 6 | 5 | 4 | 3 | 2 | 1

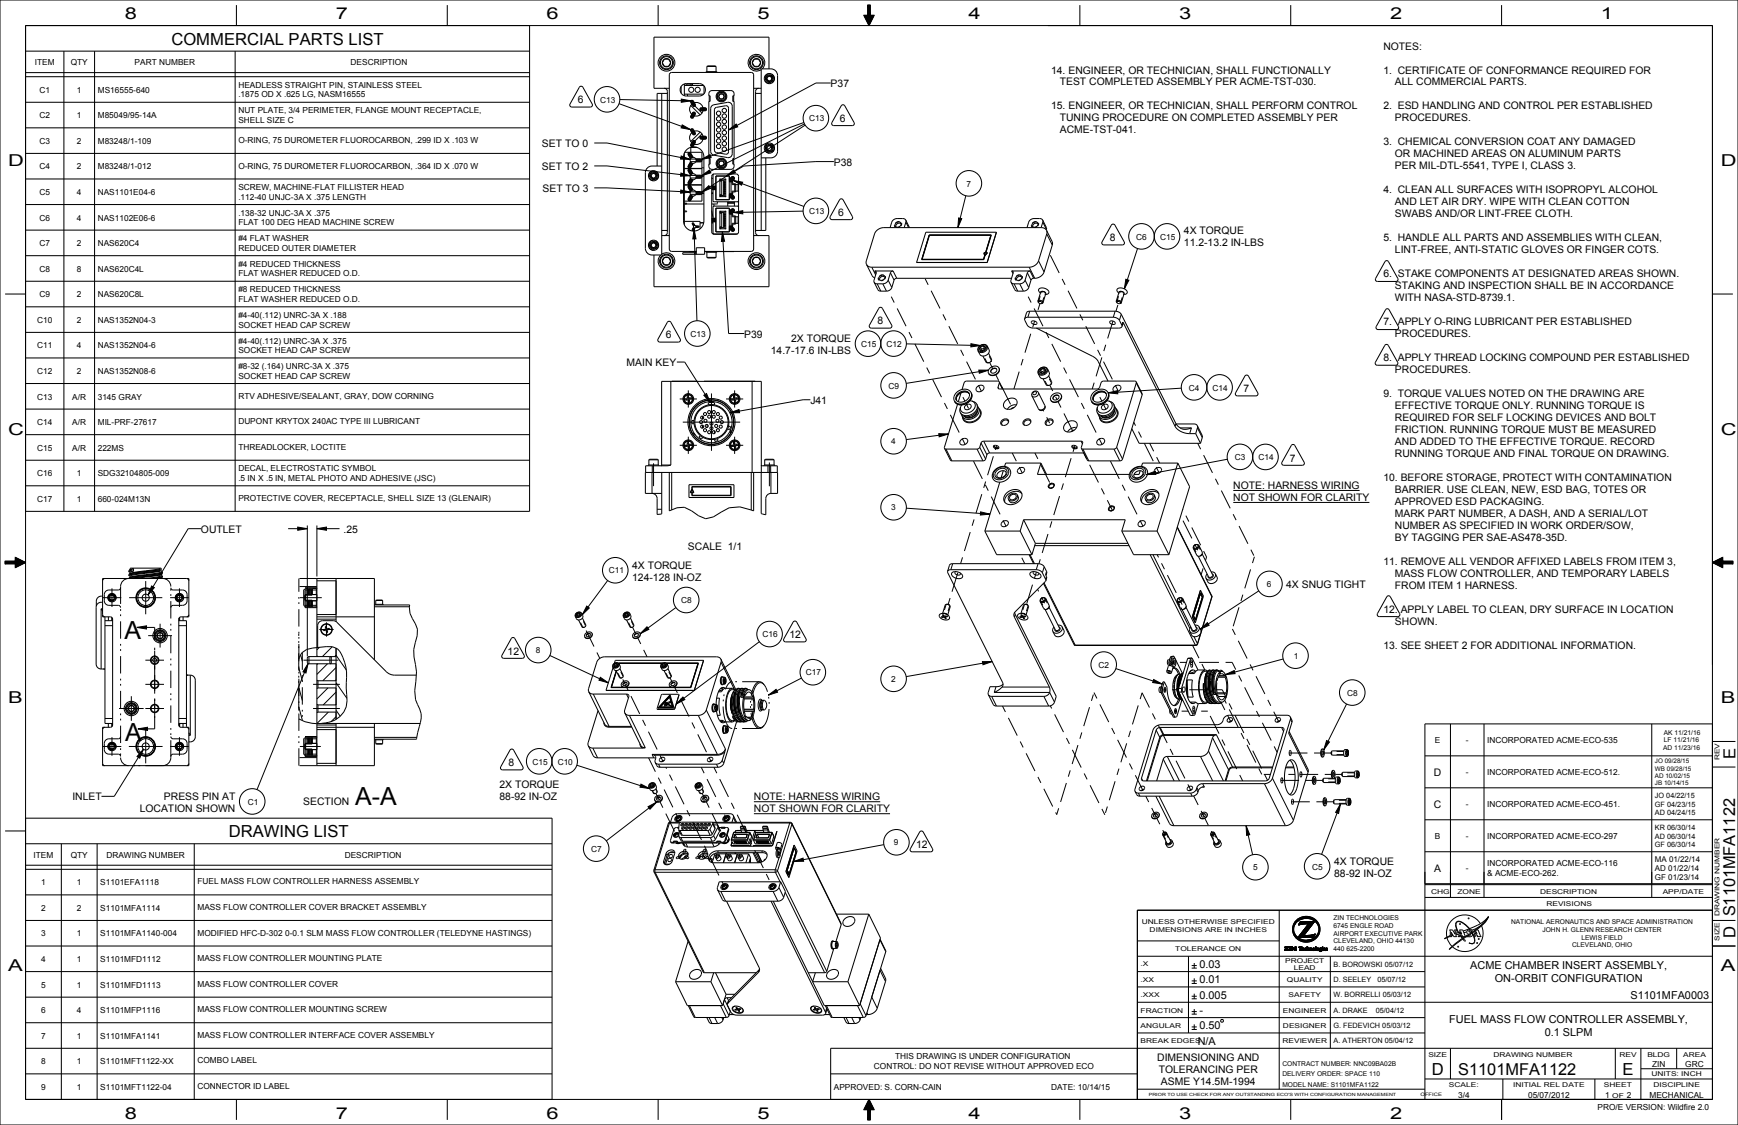
[picture p230: page 1]

NOTES:
1. CERTIFICATE OF CONFORMANCE REQUIRED FOR
ALL COMMERCIAL PARTS.
2. ESD HANDLING AND CONTROL PER ESTABLISHED
PROCEDURES.
3. CHEMICAL CONVERSION COAT ANY DAMAGED
OR MACHINED AREAS ON ALUMINUM PARTS
PER MIL-DTL-5541, TYPE I, CLASS 3.
4. CLEAN ALL SURFACES WITH ISOPROPYL ALCOHOL
AND LET AIR DRY. WIPE WITH CLEAN COTTON
SWABS AND/OR LINT-FREE CLOTH.
5. HANDLE ALL PARTS AND ASSEMBLIES WITH CLEAN,
LINT-FREE, ANTI-STATIC GLOVES OR FINGER COTS.
6. STAKE COMPONENTS AT DESIGNATED AREAS SHOWN.
STAKING AND INSPECTION SHALL BE IN ACCORDANCE
WITH NASA-STD-8739.1.
7. APPLY O-RING LUBRICANT PER ESTABLISHED

14. ENGINEER, OR TECHNICIAN, SHALL FUNCTIONALLY
TEST COMPLETED ASSEMBLY PER ACME-TST-030.
15. ENGINEER, OR TECHNICIAN, SHALL PERFORM CONTROL
TUNING PROCEDURE ON COMPLETED ASSEMBLY PER
ACME-TST-041.

FLAT 100 DEG HEAD MACHINE SCREW

SOCKET HEAD CAP SCREW

8. APPLY THREAD LOCKING COMPOUND PER ESTABLISHED
9. TORQUE VALUES NOTED ON THE DRAWING ARE
EFFECTIVE TORQUE ONLY. RUNNING TORQUE IS
REQUIRED FOR SELF LOCKING DEVICES AND BOLT
FRICTION. RUNNING TORQUE MUST BE MEASURED
AND ADDED TO THE EFFECTIVE TORQUE. RECORD
RUNNING TORQUE AND FINAL TORQUE ON DRAWING.
10. BEFORE STORAGE, PROTECT WITH CONTAMINATION
BARRIER. USE CLEAN, NEW, ESD BAG, TOTES OR
APPROVED ESD PACKAGING.
MARK PART NUMBER, A DASH, AND A SERIAL/LOT
NUMBER AS SPECIFIED IN WORK ORDER/SOW,
BY TAGGING PER SAE-AS478-35D.
11. REMOVE ALL VENDOR AFFIXED LABELS FROM ITEM 3,
MASS FLOW CONTROLLER, AND TEMPORARY LABELS

.5 IN X .5 IN, METAL PHOTO AND ADHESIVE (JSC)

NOTE: HARNESS WIRING
NOT SHOWN FOR CLARITY

FROM ITEM 1 HARNESS.
12. APPLY LABEL TO CLEAN, DRY SURFACE IN LOCATION
SHOWN.
13. SEE SHEET 2 FOR ADDITIONAL INFORMATION.

E | - | INCORPORATED ACME-ECO-535 | AK 11/21/16 LF 11/21/16 AD 11/23/16

D | - | INCORPORATED ACME-ECO-512. | JO 09/28/15 WB 09/28/15 AD 10/02/15 JB 10/14/15

C | - | INCORPORATED ACME-ECO-451. | JO 04/22/15 GF 04/23/15 AD 04/24/15

B | - | INCORPORATED ACME-ECO-297 | KR 06/30/14 AD 06/30/14 GF 06/30/14

A | - | INCORPORATED ACME-ECO-116 | MA 01/22/14 AD 01/22/14 GF 01/23/14

CHG | ZONE | DESCRIPTION | APP/DATE

UNLESS OTHERWISE SPECIFIED
DIMENSIONS ARE IN INCHES

NATIONAL AERONAUTICS AND SPACE ADMINISTRATION

JOHN H. GLENN RESEARCH CENTER

LEAD .X | B. BOROWSKI 05/07/12 PROJECT 0.03 | ACME CHAMBER INSERT ASSEMBLY, ON-ORBIT CONFIGURATION S1101MFA0003
.XX | 0.01 | QUALITY | D. SEELEY 05/07/12
.XXX | 0.005 | SAFETY | W. BORRELLI 05/03/12
FRACTION | - | ENGINEER | A. DRAKE 05/04/12 | FUEL MASS FLOW CONTROLLER ASSEMBLY, 0.1 SLPM
ANGULAR | 0.50 | DESIGNER | G. FEDEVICH 05/03/12
BREAK EDGES N/A | | REVIEWER | A. ATHERTON 05/04/12

THIS DRAWING IS UNDER CONFIGURATION
CONTROL: DO NOT REVISE WITHOUT APPROVED ECO

# ACD

# CDA

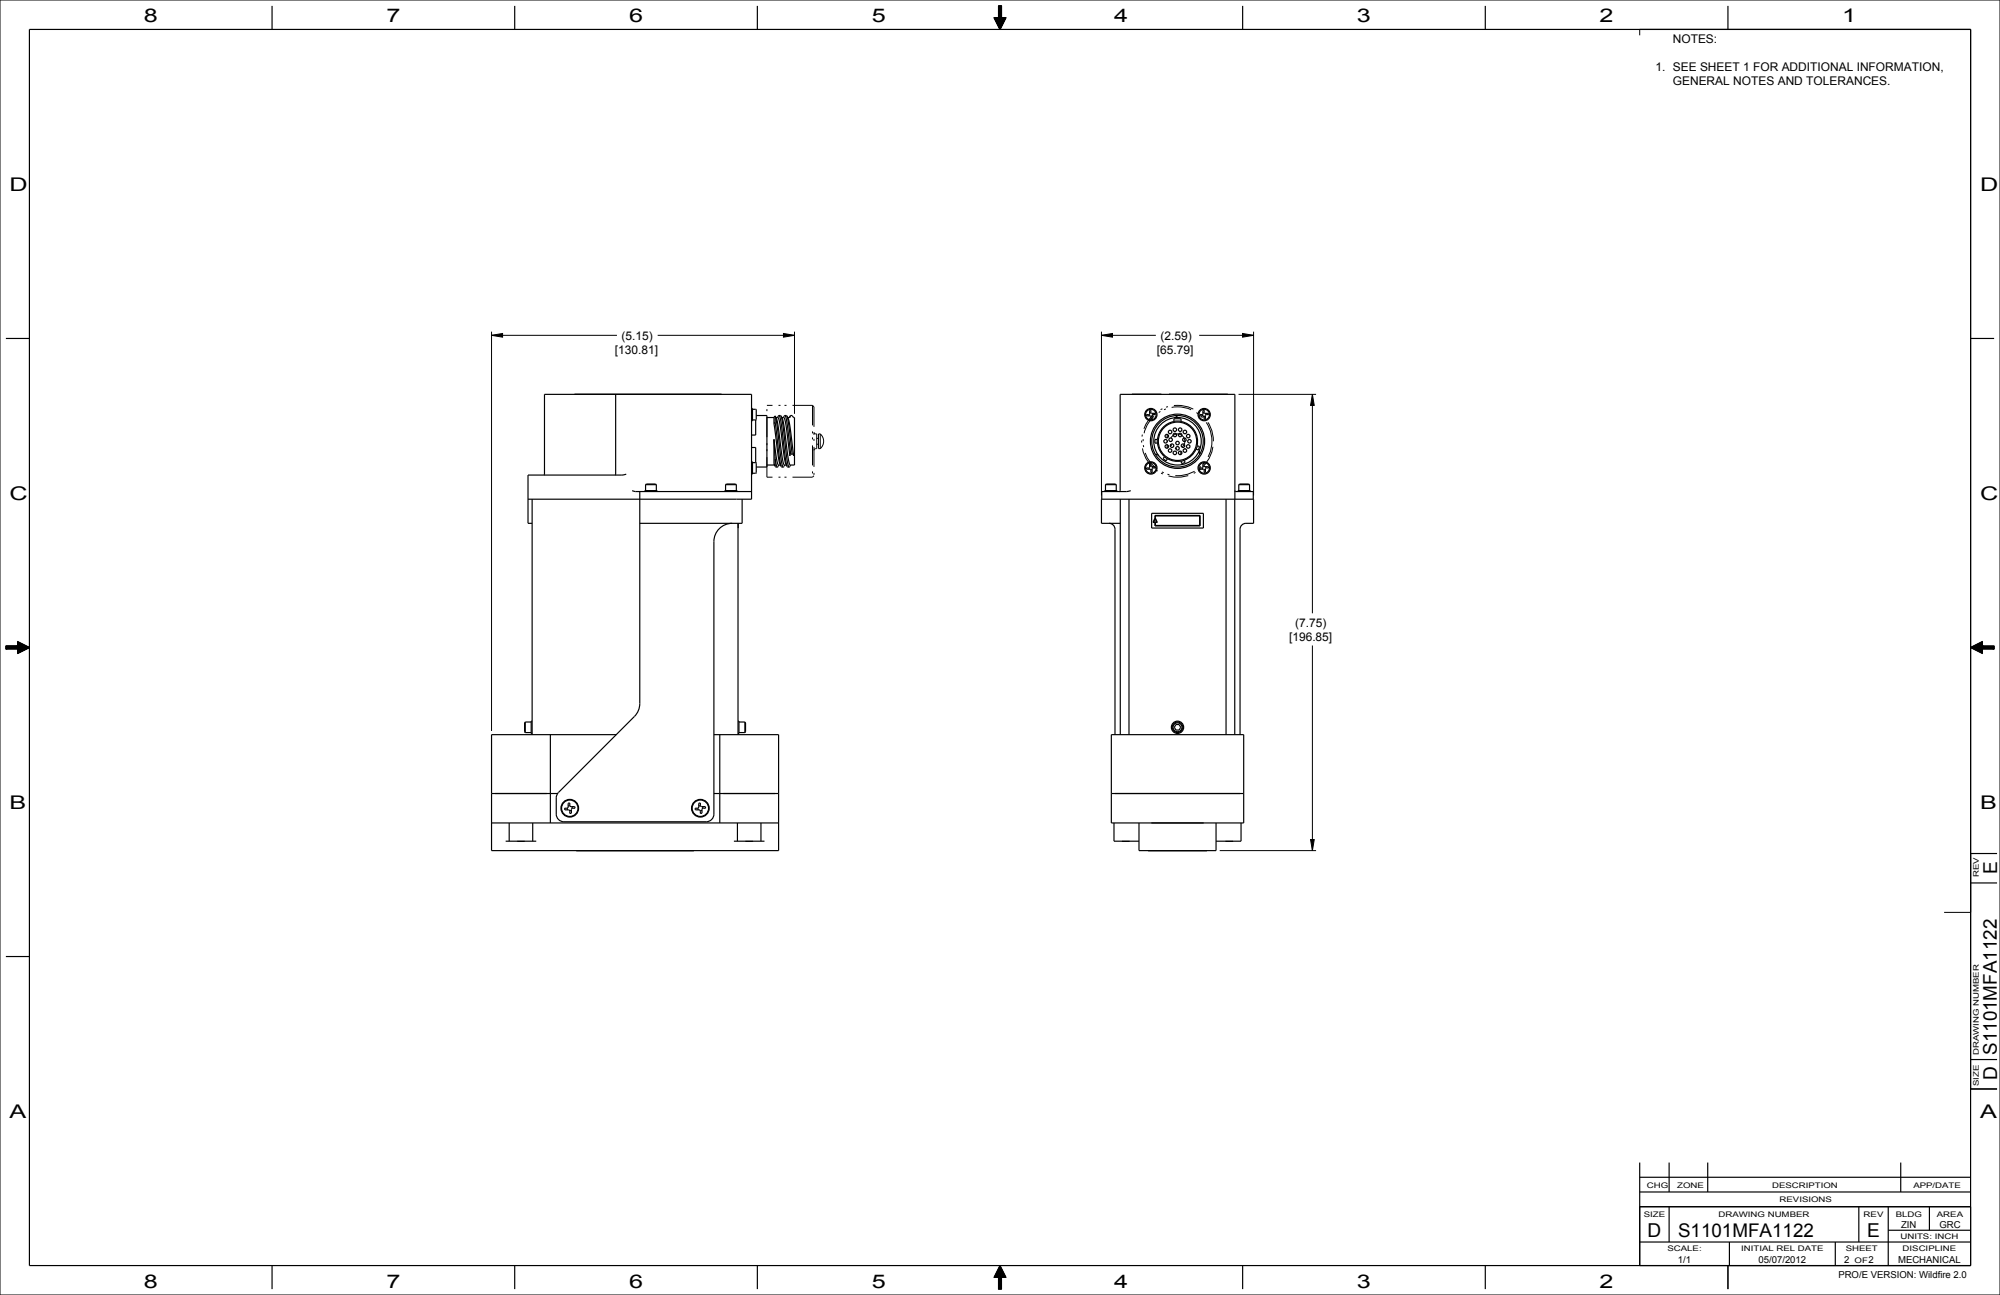
[picture p231: page 2]
CHG; ZONE; DESCRIPTION; APP/DATE; REVISIONS; SIZE D; DRAWING NUMBER; S1101MFA1122; REV E; MECHANICAL; SCALE:; INITIAL REL DATE; SHEET; DISCIPLINE; UNITS: INCH; ZIN; GRC; SIZE; REV; BLDG; AREA

NOTES:
SEE SHEET 1 FOR ADDITIONAL INFORMATION,
GENERAL NOTES AND TOLERANCES.

PRO/E VERSION: Wildfire 2.0
