EmersonBJ/nasa-acme-burner-cad-cfd/PSI-Documents/Engineering Documents/Desenhos_Tecnicos_NASA/ACME_drawings_gas_supply/MFA_Montagens/s1101mfa1138_D.pdf

D | D
8 | 7 | 6 | 5 | 4 | 3 | 1

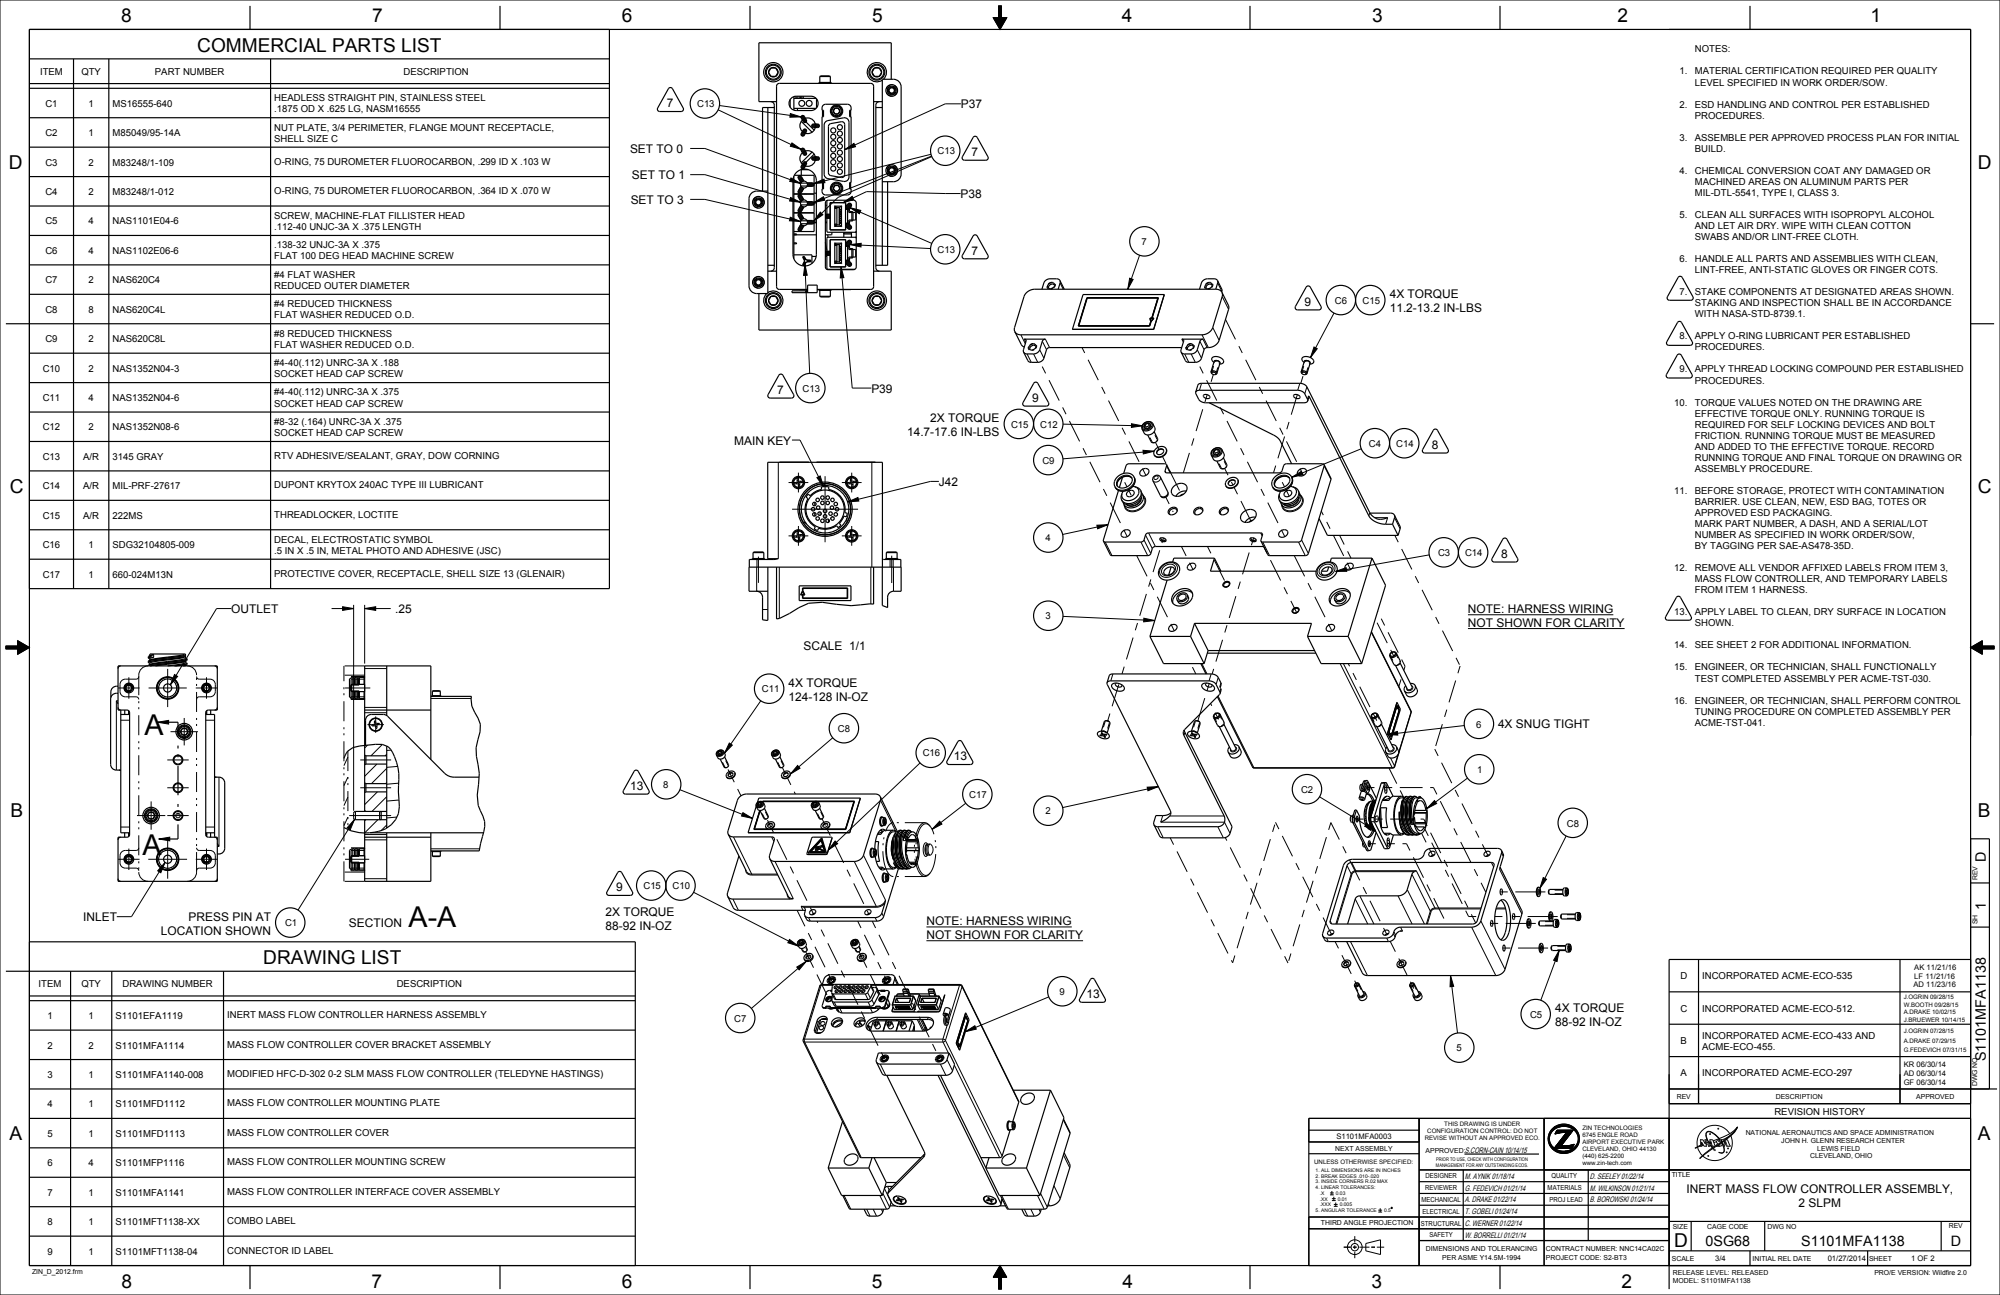
[picture p232: page 1]

COMMERCIAL PARTS LIST

NOTES:
MATERIAL CERTIFICATION REQUIRED PER QUALITY
LEVEL SPECIFIED IN WORK ORDER/SOW.
ESD HANDLING AND CONTROL PER ESTABLISHED
PROCEDURES.
ASSEMBLE PER APPROVED PROCESS PLAN FOR INITIAL
BUILD.
CHEMICAL CONVERSION COAT ANY DAMAGED OR
MACHINED AREAS ON ALUMINUM PARTS PER
MIL-DTL-5541, TYPE I, CLASS 3.
CLEAN ALL SURFACES WITH ISOPROPYL ALCOHOL
AND LET AIR DRY. WIPE WITH CLEAN COTTON
SWABS AND/OR LINT-FREE CLOTH.
HANDLE ALL PARTS AND ASSEMBLIES WITH CLEAN,
LINT-FREE, ANTI-STATIC GLOVES OR FINGER COTS.
STAKE COMPONENTS AT DESIGNATED AREAS SHOWN.
STAKING AND INSPECTION SHALL BE IN ACCORDANCE
WITH NASA-STD-8739.1.
APPLY O-RING LUBRICANT PER ESTABLISHED
APPLY THREAD LOCKING COMPOUND PER ESTABLISHED

ITEM | QTY | PART NUMBER | DESCRIPTION

C1 | 1 | MS16555-640 | HEADLESS STRAIGHT PIN, STAINLESS STEEL .1875 OD X .625 LG, NASM16555

C2 | 1 | M85049/95-14A | NUT PLATE, 3/4 PERIMETER, FLANGE MOUNT RECEPTACLE, SHELL SIZE C

C3 | 2 | M83248/1-109 | O-RING, 75 DUROMETER FLUOROCARBON, .299 ID X .103 W

C4 | 2 | M83248/1-012 | O-RING, 75 DUROMETER FLUOROCARBON, .364 ID X .070 W

C5 | 4 | NAS1101E04-6 | SCREW, MACHINE-FLAT FILLISTER HEAD .112-40 UNJC-3A X .375 LENGTH

C6 | 4 | NAS1102E06-6 | .138-32 UNJC-3A X .375 FLAT 100 DEG HEAD MACHINE SCREW

C7 | 2 | NAS620C4 | #4 FLAT WASHER REDUCED OUTER DIAMETER

C8 C9 | 8 2 | NAS620C4L NAS620C8L | #4 REDUCED THICKNESS FLAT WASHER REDUCED O.D. #8 REDUCED THICKNESS FLAT WASHER REDUCED O.D.

C10 | 2 | NAS1352N04-3 | #4-40(.112) UNRC-3A X .188 SOCKET HEAD CAP SCREW

C11 | 4 | NAS1352N04-6 | #4-40(.112) UNRC-3A X .375 SOCKET HEAD CAP SCREW

TORQUE VALUES NOTED ON THE DRAWING ARE
EFFECTIVE TORQUE ONLY. RUNNING TORQUE IS
REQUIRED FOR SELF LOCKING DEVICES AND BOLT
FRICTION. RUNNING TORQUE MUST BE MEASURED
AND ADDED TO THE EFFECTIVE TORQUE. RECORD
RUNNING TORQUE AND FINAL TORQUE ON DRAWING OR
ASSEMBLY PROCEDURE.
BEFORE STORAGE, PROTECT WITH CONTAMINATION
BARRIER. USE CLEAN, NEW, ESD BAG, TOTES OR
APPROVED ESD PACKAGING.
MARK PART NUMBER, A DASH, AND A SERIAL/LOT
NUMBER AS SPECIFIED IN WORK ORDER/SOW,
BY TAGGING PER SAE-AS478-35D.
REMOVE ALL VENDOR AFFIXED LABELS FROM ITEM 3,
MASS FLOW CONTROLLER, AND TEMPORARY LABELS
FROM ITEM 1 HARNESS.
APPLY LABEL TO CLEAN, DRY SURFACE IN LOCATION
SHOWN.
SEE SHEET 2 FOR ADDITIONAL INFORMATION.
ENGINEER, OR TECHNICIAN, SHALL FUNCTIONALLY
TEST COMPLETED ASSEMBLY PER ACME-TST-030.
ENGINEER, OR TECHNICIAN, SHALL PERFORM CONTROL

C12 | 2 | NAS1352N08-6 | #8-32 (.164) UNRC-3A X .375 SOCKET HEAD CAP SCREW

C13 | A/R | 3145 GRAY | RTV ADHESIVE/SEALANT, GRAY, DOW CORNING

C14 | A/R | MIL-PRF-27617 | DUPONT KRYTOX 240AC TYPE III LUBRICANT

C15 | A/R | 222MS | THREADLOCKER, LOCTITE

C16 | 1 | SDG32104805-009 | DECAL, ELECTROSTATIC SYMBOL .5 IN X .5 IN, METAL PHOTO AND ADHESIVE (JSC)

C17 | 1 | 660-024M13N | PROTECTIVE COVER, RECEPTACLE, SHELL SIZE 13 (GLENAIR)

NOTE: HARNESS WIRING
NOT SHOWN FOR CLARITY

TUNING PROCEDURE ON COMPLETED ASSEMBLY PER
ACME-TST-041.

1 DWG NO REV SH

D | INCORPORATED ACME-ECO-535 | AK 11/21/16 LF 11/21/16 AD 11/23/16

C | INCORPORATED ACME-ECO-512. | J.OGRIN 09/28/15 W.BOOTH 09/28/15 A.DRAKE 10/02/15 J.BRUEWER 10/14/15

1 | 1 | S1101EFA1119 | INERT MASS FLOW CONTROLLER HARNESS ASSEMBLY

INCORPORATED ACME-ECO-433 AND ACME-ECO-455. B | J.OGRIN 07/28/15 A.DRAKE 07/29/15 G.FEDEVICH 07/31/15

2 | 2 | S1101MFA1114 | MASS FLOW CONTROLLER COVER BRACKET ASSEMBLY

A REV | INCORPORATED ACME-ECO-297 DESCRIPTION | KR 06/30/14 AD 06/30/14 GF 06/30/14 APPROVED

3 | 1 | S1101MFA1140-008 | MODIFIED HFC-D-302 0-2 SLM MASS FLOW CONTROLLER (TELEDYNE HASTINGS)

4 | 1 | S1101MFD1112 | MASS FLOW CONTROLLER MOUNTING PLATE

THIS DRAWING IS UNDER
CONFIGURATION CONTROL: DO NOT
REVISE WITHOUT AN APPROVED ECO.
APPROVED:
PRIOR TO USE, CHECK WITH CONFIGURATION
MANAGEMENT FOR ANY OUTSTANDING ECOS.

ZIN TECHNOLOGIES
6745 ENGLE ROAD
AIRPORT EXECUTIVE PARK
CLEVELAND, OHIO 44130
www.zin-tech.com

NATIONAL AERONAUTICS AND SPACE ADMINISTRATION

S1101MFA0003
NEXT ASSEMBLY
UNLESS OTHERWISE SPECIFIED:
1. ALL DIMENSIONS ARE IN INCHES
2. BREAK EDGES .010-.020
3. INSIDE CORNERS R.02 MAX
4. LINEAR TOLERANCES:

JOHN H. GLENN RESEARCH CENTER

6 | 4 | S1101MFP1116 | MASS FLOW CONTROLLER MOUNTING SCREW

DESIGNER | M. AYNIK 01/18/14 | QUALITY | D. SEELEY 01/22/14 | TITLE INERT MASS FLOW CONTROLLER ASSEMBLY, 2 SLPM
REVIEWER | G. FEDEVICH 01/21/14 | MATERIALS | M. WILKINSON 01/21/14
MECHANICAL | A. DRAKE 01/22/14 | PROJ LEAD | B. BOROWSKI 01/24/14

7 | 1 | S1101MFA1141 | MASS FLOW CONTROLLER INTERFACE COVER ASSEMBLY

THIRD ANGLE PROJECTION | STRUCTURAL | C. WERNER 01/22/14

SIZE | CAGE CODE 0SG68 | DWG NO S1101MFA1138 | REV D

W. BORRELLI 01/21/14

9 | 1 | S1101MFT1138-04 | CONNECTOR ID LABEL

DIMENSIONS AND TOLERANCING PER ASME Y14.5M-1994 | | CONTRACT NUMBER: NNC14CA02C PROJECT CODE: S2-BT3

SCALE 3/4 | INITIAL REL DATE 01/27/2014 | SHEET

D | D
8 | 7 | 6 | 5 | 4 | 3 | 1

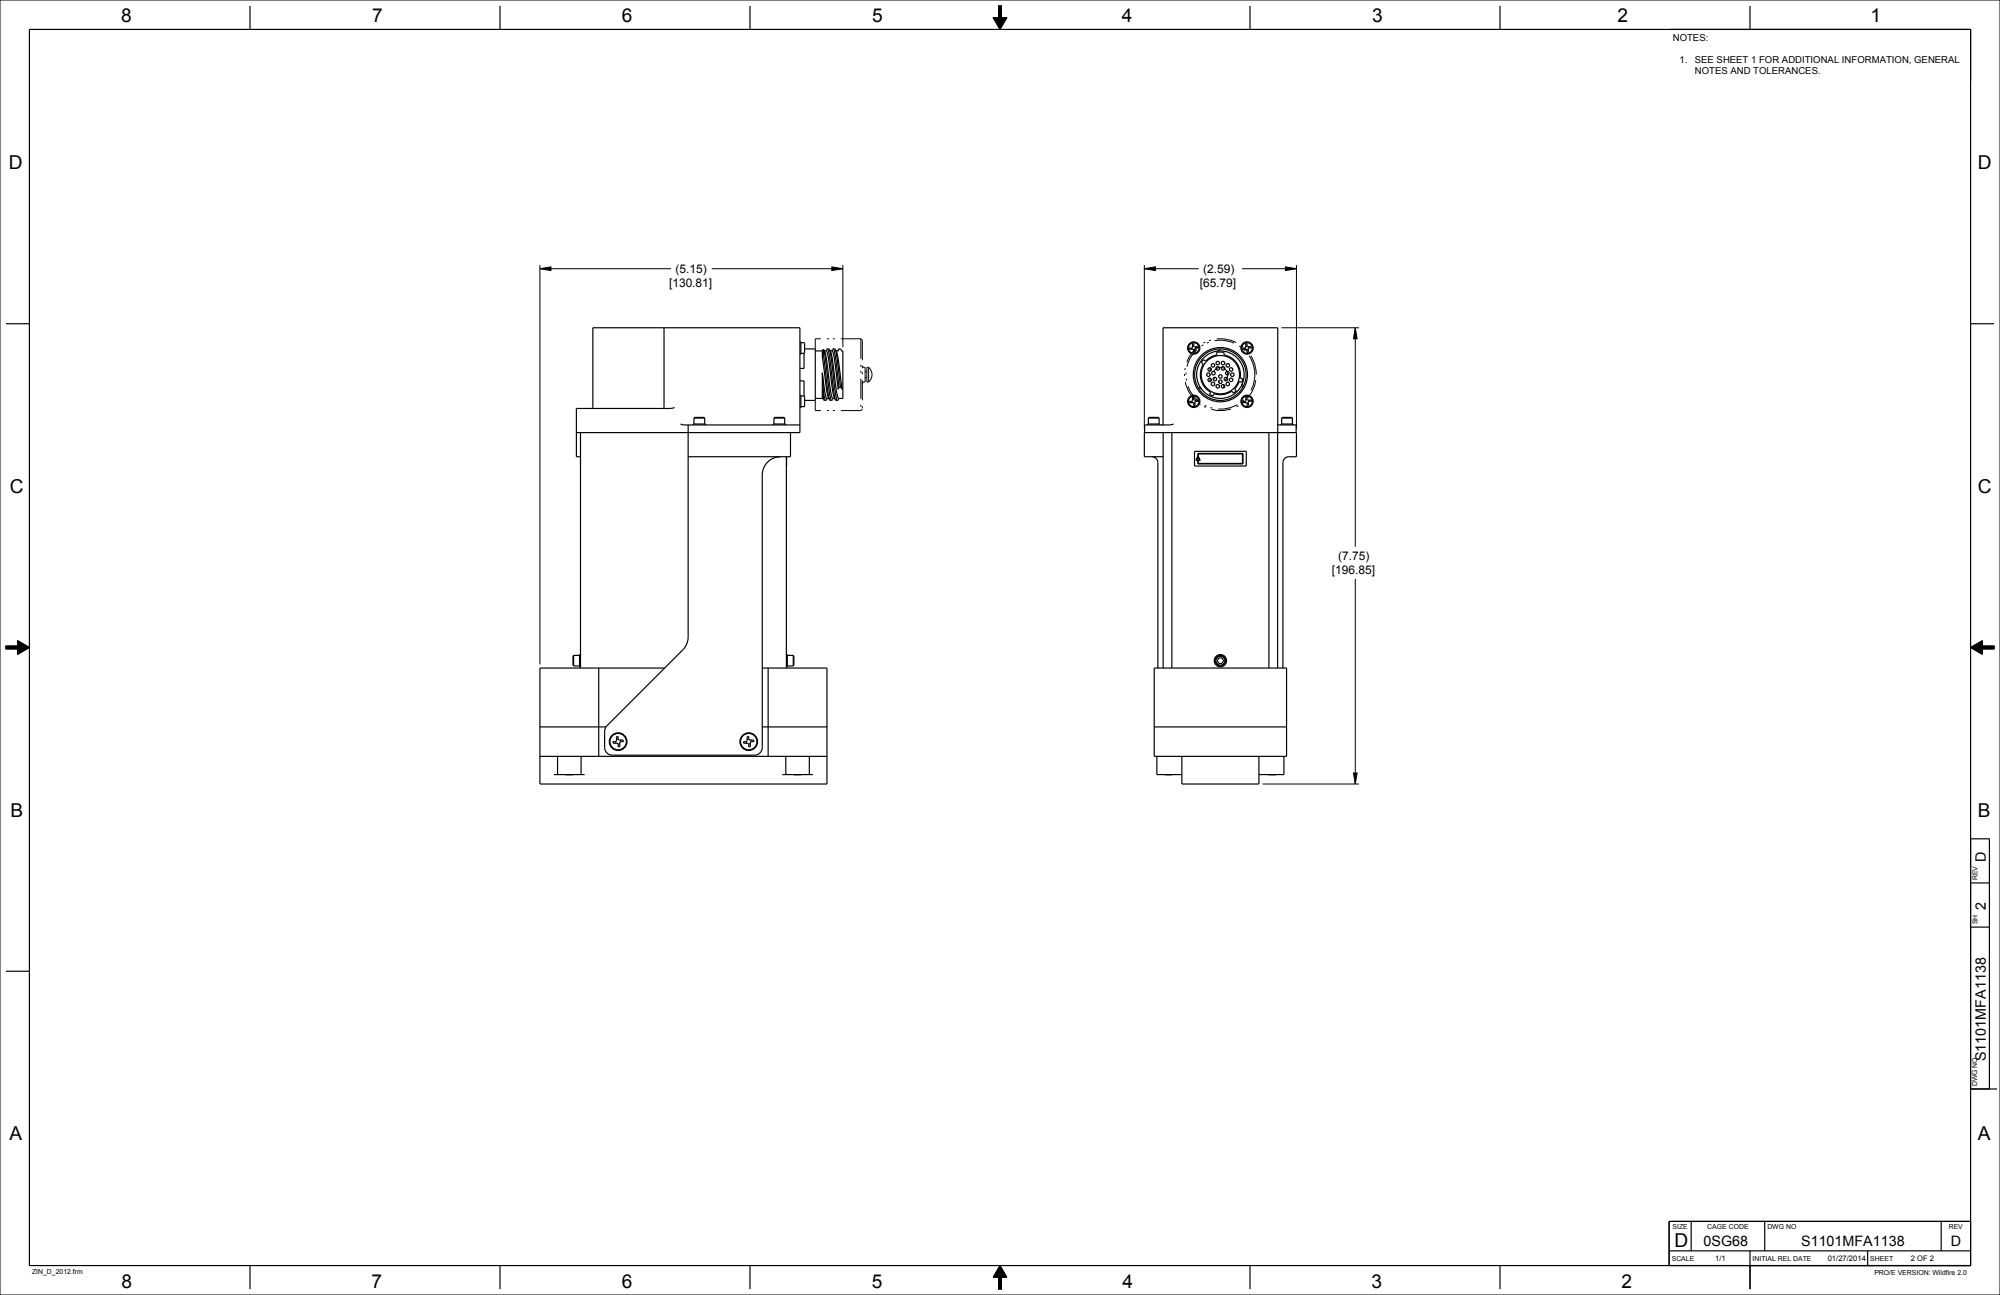
[picture p233: page 2]
ZIN_D_2012.frm; S1101MFA1138 D

NOTES:
SEE SHEET 1 FOR ADDITIONAL INFORMATION, GENERAL
NOTES AND TOLERANCES.

2 DWG NO REV SH

SIZE D | CAGE CODE 0SG68 | DWG NO S1101MFA1138 | REV D

SCALE 1/1 | INITIAL REL DATE 01/27/2014 | SHEET

PRO/E VERSION: Wildfire 2.0
