EmersonBJ/nasa-acme-burner-cad-cfd/PSI-Documents/Engineering Documents/Desenhos_Tecnicos_NASA/ACME_drawings_igniter/MFA_Montagens/s1101mfa1313_F.pdf

D | D
8 | 7 | 6 | 5 | 4 | 3 | 2 | 1

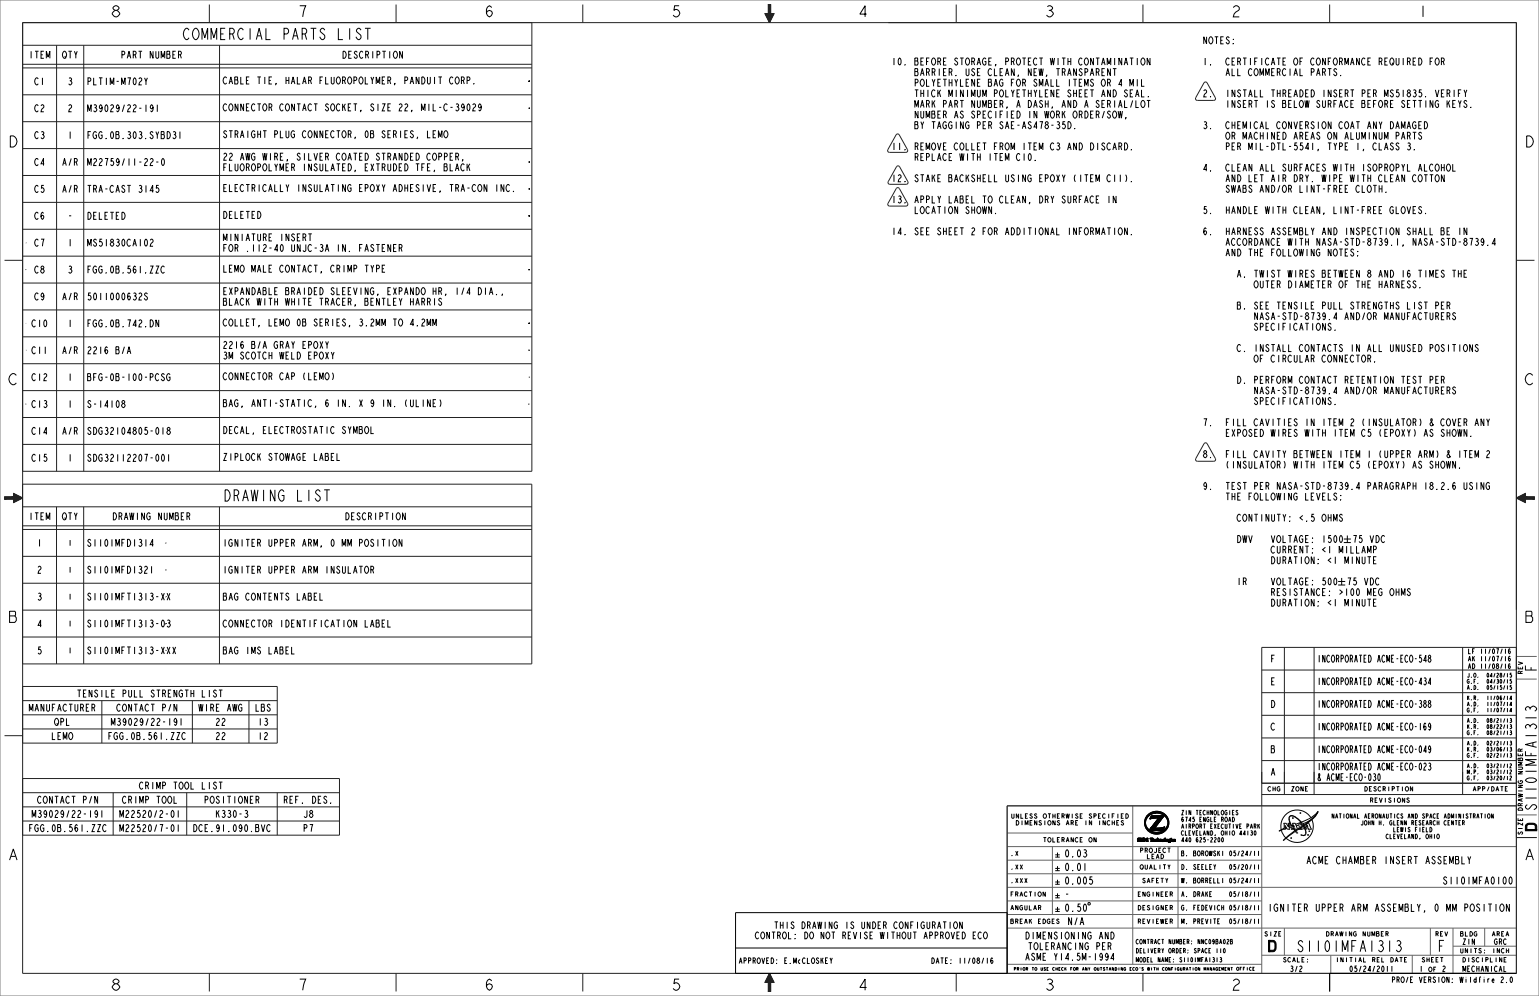
[picture p236: page 1]

NOTES:
1. CERTIFICATE OF CONFORMANCE REQUIRED FOR
ALL COMMERCIAL PARTS.
2. INSTALL THREADED INSERT PER MS51835. VERIFY
INSERT IS BELOW SURFACE BEFORE SETTING KEYS.
3. CHEMICAL CONVERSION COAT ANY DAMAGED
OR MACHINED AREAS ON ALUMINUM PARTS
PER MIL-DTL-5541, TYPE I, CLASS 3.
4. CLEAN ALL SURFACES WITH ISOPROPYL ALCOHOL
AND LET AIR DRY. WIPE WITH CLEAN COTTON
SWABS AND/OR LINT-FREE CLOTH.
5. HANDLE WITH CLEAN, LINT-FREE GLOVES.
6. HARNESS ASSEMBLY AND INSPECTION SHALL BE IN
ACCORDANCE WITH NASA-STD-8739.1, NASA-STD-8739.4
AND THE FOLLOWING NOTES:
A. TWIST WIRES BETWEEN 8 AND 16 TIMES THE
OUTER DIAMETER OF THE HARNESS.
B. SEE TENSILE PULL STRENGTHS LIST PER
NASA-STD-8739.4 AND/OR MANUFACTURERS
SPECIFICATIONS.
C. INSTALL CONTACTS IN ALL UNUSED POSITIONS
OF CIRCULAR CONNECTOR.
D. PERFORM CONTACT RETENTION TEST PER

10. BEFORE STORAGE, PROTECT WITH CONTAMINATION
BARRIER. USE CLEAN, NEW, TRANSPARENT
POLYETHYLENE BAG FOR SMALL ITEMS OR 4 MIL
THICK MINIMUM POLYETHYLENE SHEET AND SEAL.
MARK PART NUMBER, A DASH, AND A SERIAL/LOT
NUMBER AS SPECIFIED IN WORK ORDER/SOW,
BY TAGGING PER SAE-AS478-35D.
11. REMOVE COLLET FROM ITEM C3 AND DISCARD.
REPLACE WITH ITEM C10.
12. STAKE BACKSHELL USING EPOXY (ITEM C11).
13. APPLY LABEL TO CLEAN, DRY SURFACE IN
LOCATION SHOWN.
14. SEE SHEET 2 FOR ADDITIONAL INFORMATION.

C4 | A/R | M22759/11-22-0 | | | 22 AWG WIRE, SILVER COATED STRANDED COPPER,

FLUOROPOLYMER INSULATED, EXTRUDED TFE, BLACK

C5 | A/R | TRA-CAST 3145 | | | | ELECTRICALLY INSULATING EPOXY ADHESIVE, TRA-CON INC.
C6 | - | DELETED | | DELETED
C7 | 1 | | MS51830CA102 | | | MINIATURE INSERT

FOR .112-40 UNJC-3A IN. FASTENER

C8 | 3 | FGG.0B.561.ZZC | | LEMO MALE CONTACT, CRIMP TYPE
C9 | A/R | 5011000632S | | | EXPANDABLE BRAIDED SLEEVING, EXPANDO HR, 1/4 DIA.,

C10 | | 1 | | FGG.0B.742.DN | COLLET, LEMO 0B SERIES, 3.2MM TO 4.2MM
C11 | | | A/R | 2216 B/A | | 2216 B/A GRAY EPOXY

C12 | | 1 | | BFG-0B-100-PCSG | | CONNECTOR CAP (LEMO)
C13 | | 1 | | S-14108 | | | BAG, ANTI-STATIC, 6 IN. X 9 IN. (ULINE)
C14 | | A/R | SDG32104805-018 | | | DECAL, ELECTROSTATIC SYMBOL

7. FILL CAVITIES IN ITEM 2 (INSULATOR) & COVER ANY
EXPOSED WIRES WITH ITEM C5 (EPOXY) AS SHOWN.
8. FILL CAVITY BETWEEN ITEM 1 (UPPER ARM) & ITEM 2
(INSULATOR) WITH ITEM C5 (EPOXY) AS SHOWN.
9. TEST PER NASA-STD-8739.4 PARAGRAPH 18.2.6 USING
THE FOLLOWING LEVELS:
CONTINUTY: <.5 OHMS
DWV VOLTAGE: 1500#-
CURRENT: <1 MILLAMP
DURATION: <1 MINUTE
RESISTANCE: >100 MEG OHMS

1 | | 1 | | S1101MFD1314 | | IGNITER UPPER ARM, 0 MM POSITION
2 | 1 | | S1101MFD1321 | | IGNITER UPPER ARM INSULATOR

TENSILE PULL STRENGTH LIST

CRIMP TOOL LIST

CHG | | ZONE | DESCRIPTION | APP/DATE

CONTACT P/N | CRIMP TOOL | POSITIONER | REF. DES.
FGG.0B.561.ZZC | M22520/7-01 | DCE.91.090.BVC | P7

REVISIONS

UNLESS OTHERWISE SPECIFIED DIMENSIONS ARE IN INCHES | ZIN TECHNOLOGIES 6745 ENGLE ROAD AIRPORT EXECUTIVE PARK CLEVELAND, OHIO 44130 | NATIONAL AERONAUTICS AND SPACE ADMINISTRATION LEWIS FIELD CLEVELAND, OHIO

JOHN H. GLENN RESEARCH CENTER

LEAD .X | B. BOROWSKI 05/24/11 PROJECT 0.03 | ACME CHAMBER INSERT ASSEMBLY S1101MFA0100
.XX | 0.01 | QUALITY | D. SEELEY 05/20/11
.XXX | 0.005 | SAFETY | W. BORRELLI 05/24/11
FRACTION | - | ENGINEER | A. DRAKE 05/18/11 | IGNITER UPPER ARM ASSEMBLY, 0 MM POSITION
ANGULAR | 0.50 | DESIGNER | G. FEDEVICH 05/18/11
BREAK EDGES N/A | | REVIEWER | M. PREVITE 05/18/11

THIS DRAWING IS UNDER CONFIGURATION
CONTROL: DO NOT REVISE WITHOUT APPROVED ECO

D

D

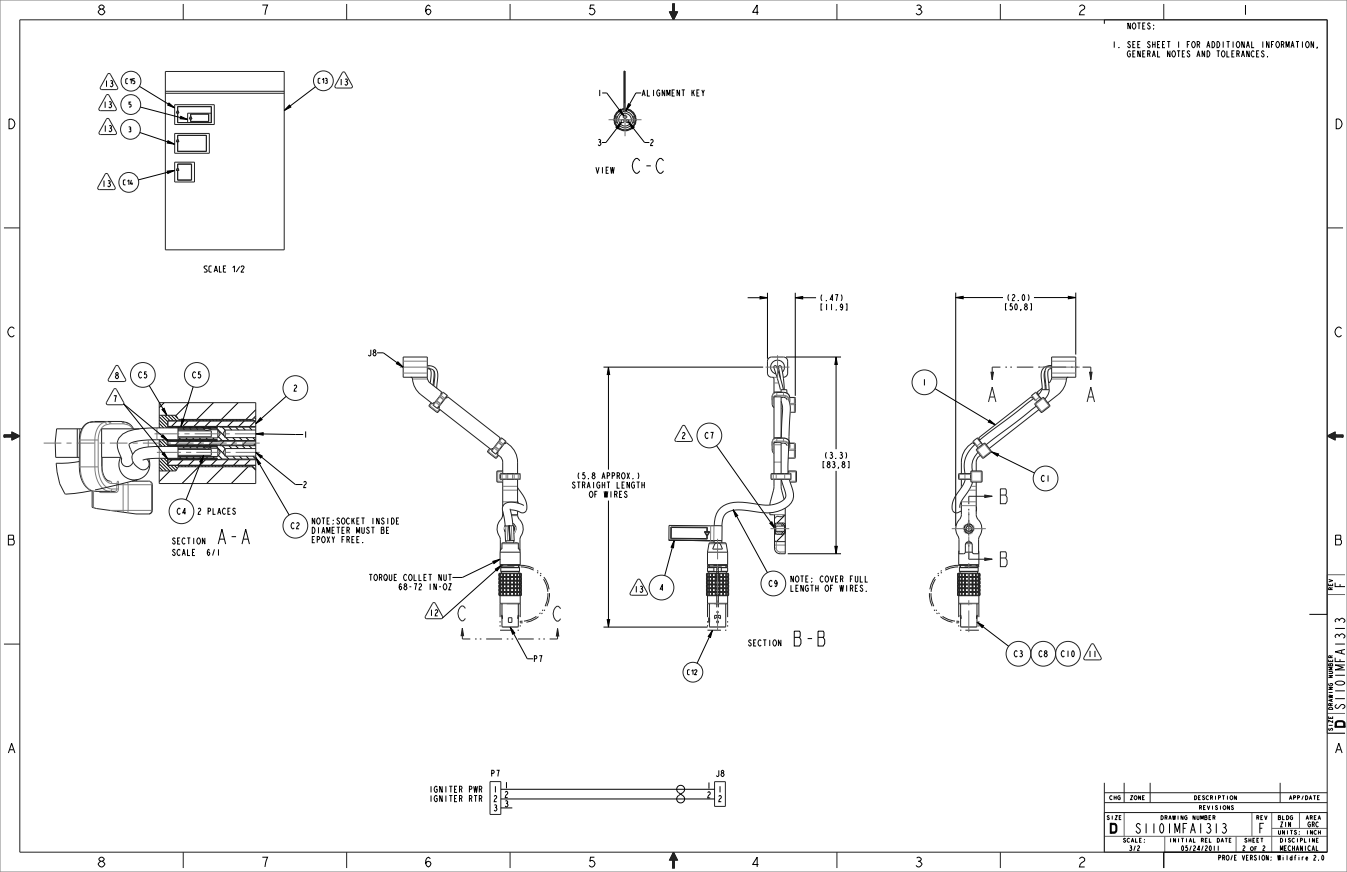
[picture p237: page 2]

NOTES:
SEE SHEET 1 FOR ADDITIONAL INFORMATION,
GENERAL NOTES AND TOLERANCES.

CHG | | ZONE | DESCRIPTION | | APP/DATE
SIZE | DRAWING NUMBER | REV | BLDG ZIN | AREA GRC

REVISIONS
