EmersonBJ/nasa-acme-burner-cad-cfd/assets/clean_assembly_view.png

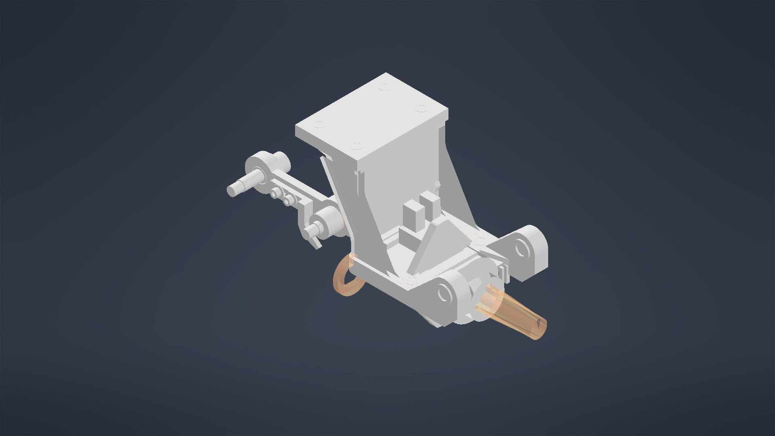
assets/clean_assembly_view.png
