EmersonBJ/nasa-acme-burner-cad-cfd/PSI-Documents/Engineering Documents/Desenhos_Tecnicos_NASA/ACME_drawings_gas_supply/MFA_Montagens/s1101mfa1137_D.pdf

D | D
8 | 7 | 6 | 5 | 4 | 3 | 1

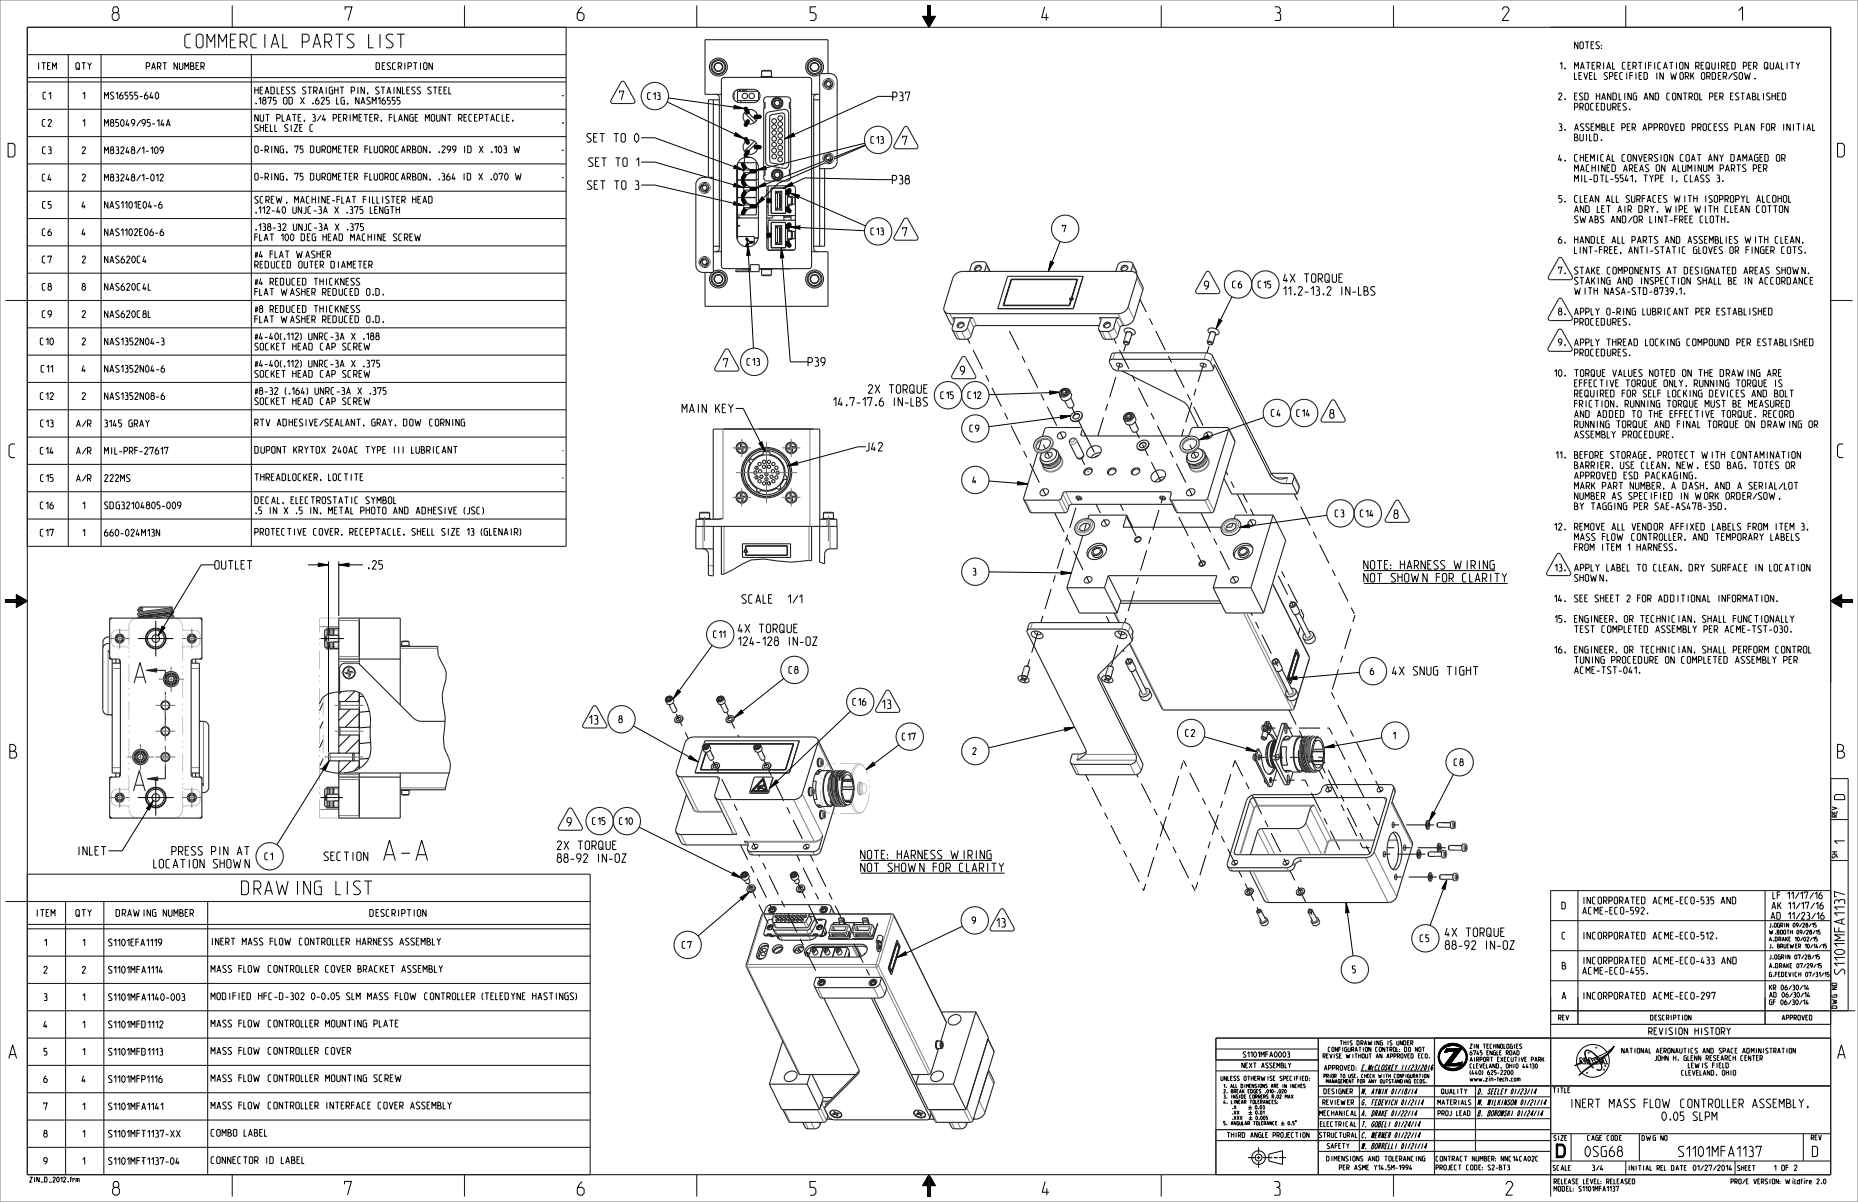
[picture p240: page 1]

NOTES:
MATERIAL CERTIFICATION REQUIRED PER QUALITY
PROCEDURES.
ASSEMBLE PER APPROVED PROCESS PLAN FOR INITIAL
BUILD.
CHEMICAL CONVERSION COAT ANY DAMAGED OR
MACHINED AREAS ON ALUMINUM PARTS PER
SWABS AND/OR LINT-FREE CLOTH.
LINT-FREE, ANTI-STATIC GLOVES OR FINGER COTS.
APPLY O-RING LUBRICANT PER ESTABLISHED
APPLY THREAD LOCKING COMPOUND PER ESTABLISHED
TORQUE VALUES NOTED ON THE DRAWING ARE
REQUIRED FOR SELF LOCKING DEVICES AND BOLT

.112-40 UNJC-3A X .375 LENGTH
FLAT 100 DEG HEAD MACHINE SCREW
REDUCED OUTER DIAMETER
FLAT WASHER REDUCED O.D.
SOCKET HEAD CAP SCREW

AND ADDED TO THE EFFECTIVE TORQUE. RECORD
RUNNING TORQUE AND FINAL TORQUE ON DRAWING OR
ASSEMBLY PROCEDURE.
APPROVED ESD PACKAGING.
MARK PART NUMBER, A DASH, AND A SERIAL/LOT
BY TAGGING PER SAE-AS478-35D.
MASS FLOW CONTROLLER, AND TEMPORARY LABELS
SHOWN.
TEST COMPLETED ASSEMBLY PER ACME-TST-030.
TUNING PROCEDURE ON COMPLETED ASSEMBLY PER
ACME-TST-041.

.5 IN X .5 IN, METAL PHOTO AND ADHESIVE (JSC)

NOTE: HARNESS WIRING
NOT SHOWN FOR CLARITY

1 DWG NO REV SH

INCORPORATED ACME-ECO-535 AND ACME-ECO-592. D | LF 11/17/16 AK 11/17/16 AD 11/23/16

C | INCORPORATED ACME-ECO-512. | | J.OGRIN 09/28/15 J. BRUEWER 10/14/15

INCORPORATED ACME-ECO-433 AND ACME-ECO-455. B | J.OGRIN 07/28/15 G.FEDEVICH 07/31/15

A REV | INCORPORATED ACME-ECO-297 DESCRIPTION | AD 06/30/14 GF 06/30/14 APPROVED

THIS DRAWING IS UNDER

CONFIGURATION CONTROL: DO NOT REVISE WITHOUT AN APPROVED ECO. APPROVED: E.McCLOSKEY 11/23/2016 | ZIN TECHNOLOGIES CLEVELAND, OHIO 44130 (440) 625-2200 www.zin-tech.com | | | NATIONAL AERONAUTICS AND SPACE ADMINISTRATION CLEVELAND, OHIO

NEXT ASSEMBLY

PRIOR TO USE, CHECK WITH CONFIGURATION
MANAGEMENT FOR ANY OUTSTANDING ECOS.

DESIGNER | | M. AYNIK 01/18/14 | QUALITY | | D. SEELEY 01/23/14 | | | | 0.05 SLPM
REVIEWER | | G. FEDEVICH 01/2114 | | | | | M. WILKINSON 01/21/14
A. DRAKE 01/22/14 | | | B. BOROWSKI 01/24/14
T. GOBELI 01/24/14
W. BORRELLI 01/21/14

TITLE
INERT MASS FLOW CONTROLLER ASSEMBLY,

3. INSIDE CORNERS R.02 MAX | .XX #-.XXX #-

THIRD ANGLE PROJECTION | | | | | | | | C. WERNER 01/22/14

D | D
8 | 7 | 6 | 5 | 4 | 3 | 1

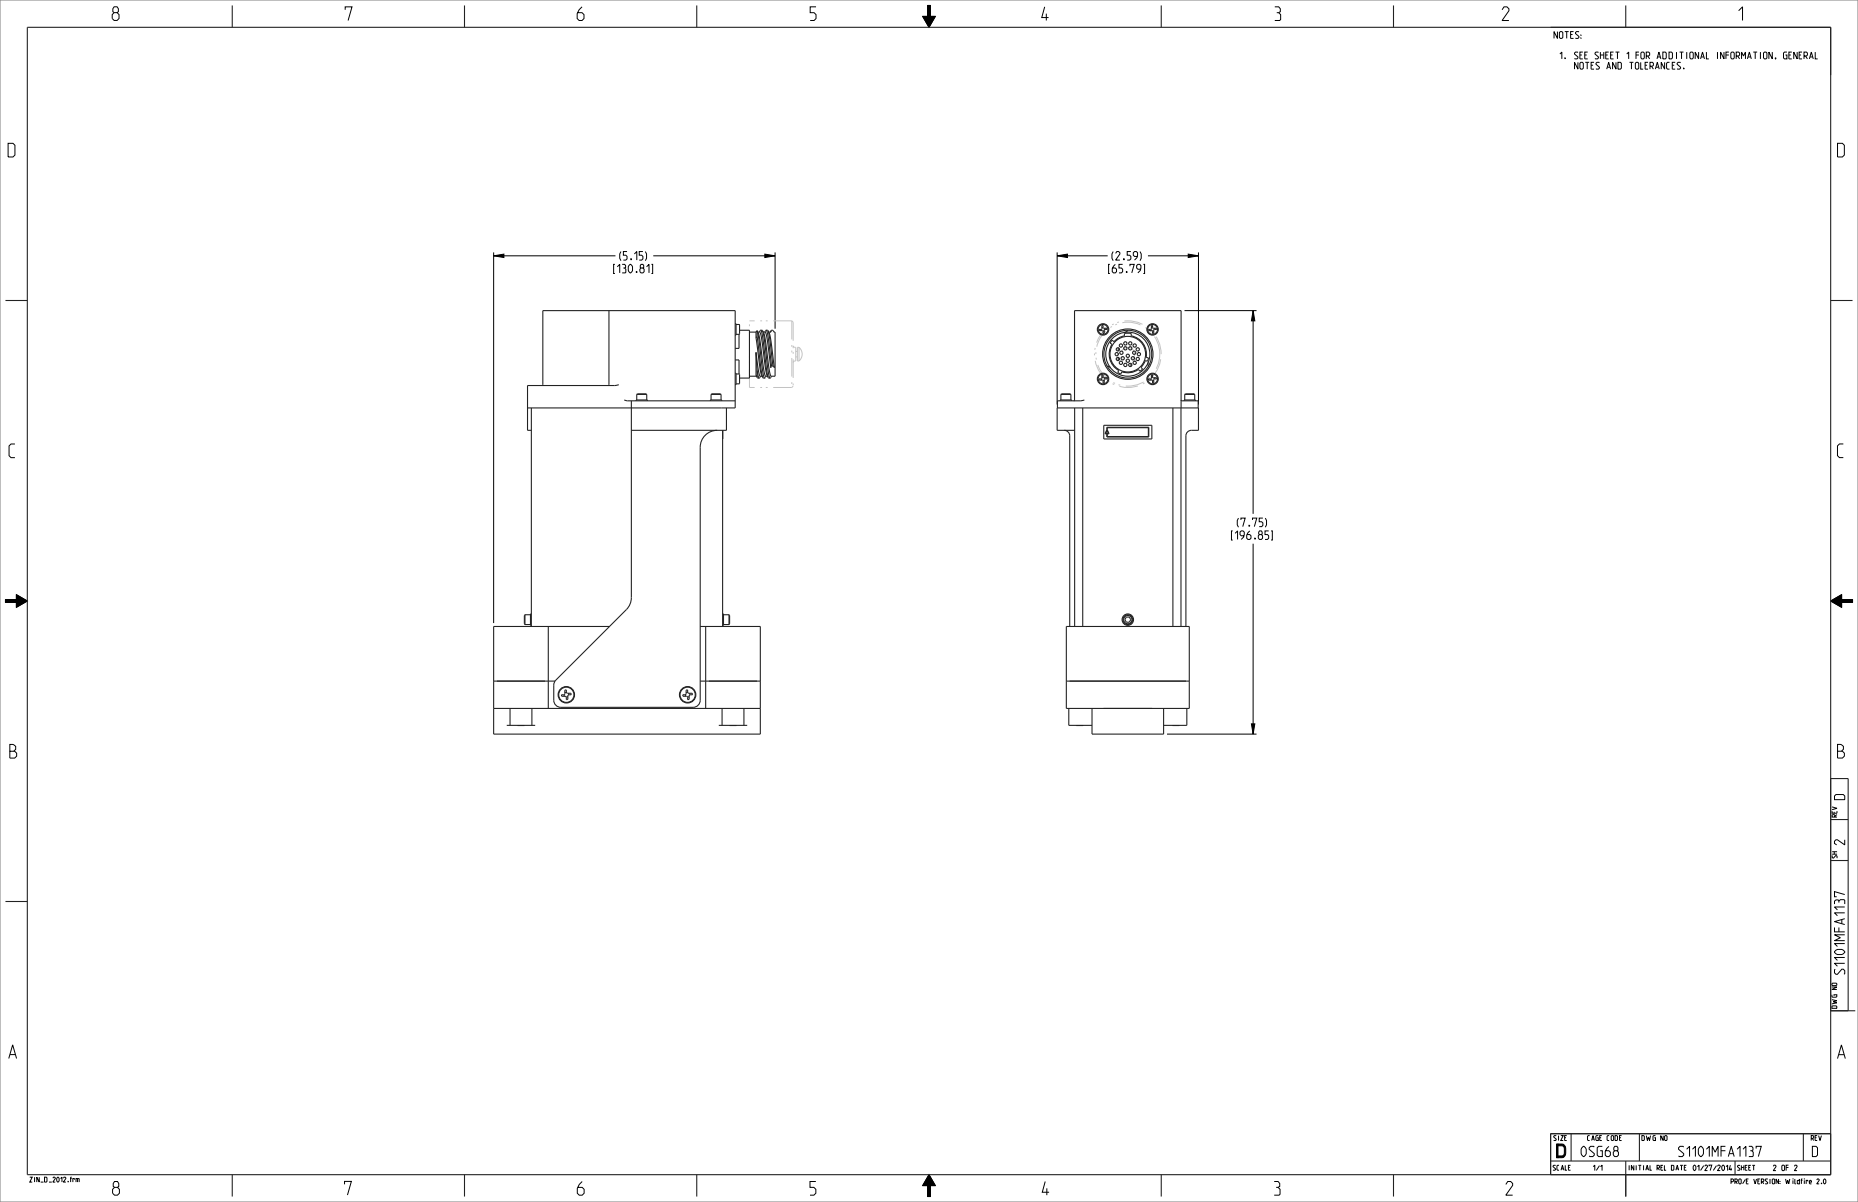
[picture p241: page 2]
SIZE; CAGE CODE; DWG NO; REV; SCALE; INITIAL REL DATE; SHEET; ZIN_D_2012.frm; SEE SHEET 1 FOR ADDITIONAL; INFORMATION, GENERAL; S1101MFA1137

NOTES:
NOTES AND TOLERANCES.

2 DWG NO REV SH

PRO/E VERSION: Wildfire 2.0
