EmersonBJ/nasa-acme-burner-cad-cfd/PSI-Documents/Engineering Documents/Desenhos_Tecnicos_NASA/ACME_drawings_measurement_system/ACME_drawings_measurement_system/s1101mfa1609_D.pdf

D | D
8 | 7 | 6 | 5 | 4 | 3 | 1

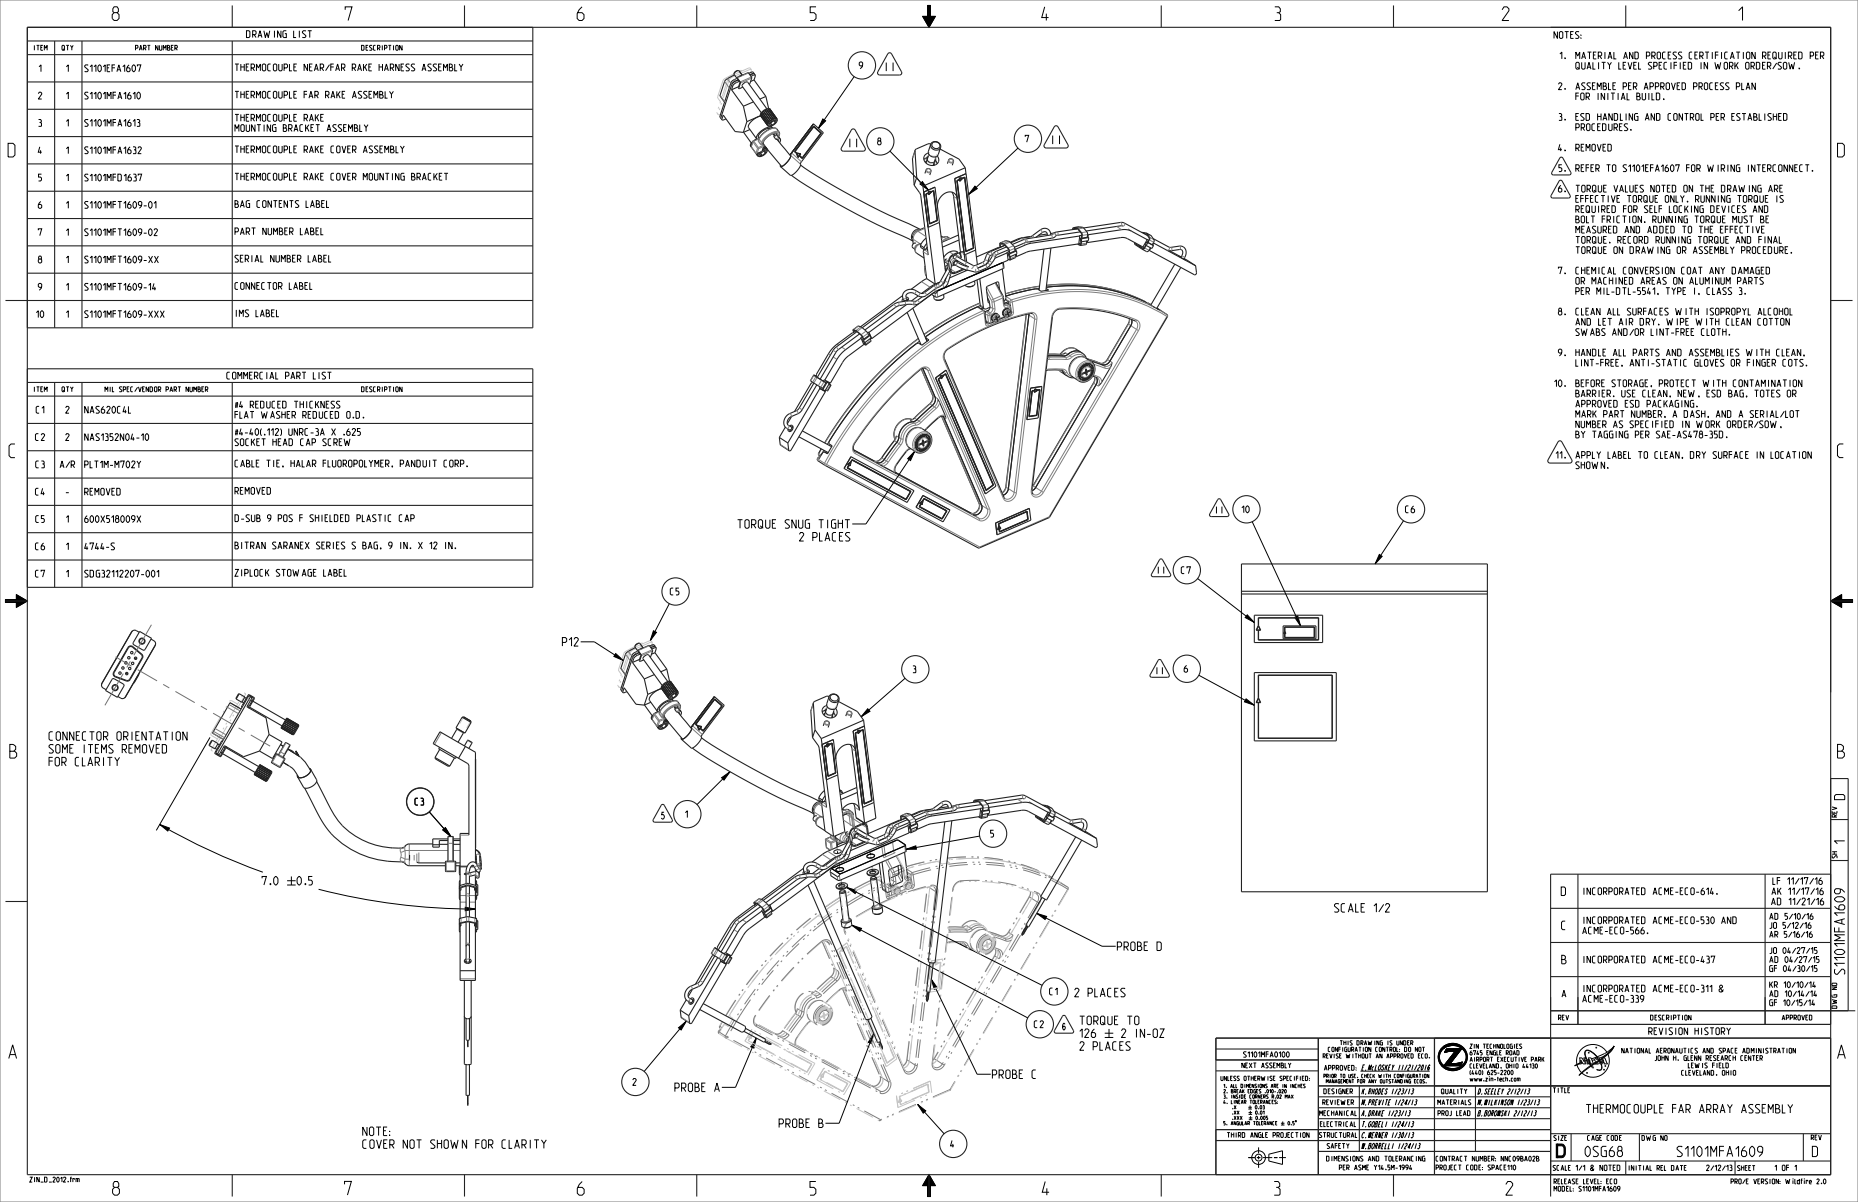
[picture p242: page 1]

NOTES:
MATERIAL AND PROCESS CERTIFICATION REQUIRED PER
ASSEMBLE PER APPROVED PROCESS PLAN
FOR INITIAL BUILD.
ESD HANDLING AND CONTROL PER ESTABLISHED
PROCEDURES.
REMOVED
TORQUE VALUES NOTED ON THE DRAWING ARE
REQUIRED FOR SELF LOCKING DEVICES AND
TORQUE. RECORD RUNNING TORQUE AND FINAL
TORQUE ON DRAWING OR ASSEMBLY PROCEDURE.
CHEMICAL CONVERSION COAT ANY DAMAGED
OR MACHINED AREAS ON ALUMINUM PARTS
SWABS AND/OR LINT-FREE CLOTH.
LINT-FREE, ANTI-STATIC GLOVES OR FINGER COTS.
APPROVED ESD PACKAGING.
NUMBER AS SPECIFIED IN WORK ORDER/SOW,
BY TAGGING PER SAE-AS478-35D.
APPLY LABEL TO CLEAN, DRY SURFACE IN LOCATION
SHOWN.

2 | 1 | S1101MFA1610 | THERMOCOUPLE FAR RAKE ASSEMBLY
3 | 1 | S1101MFA1613 | THERMOCOUPLE RAKE MOUNTING BRACKET ASSEMBLY

4 | | 1 | S1101MFA1632 | THERMOCOUPLE RAKE COVER ASSEMBLY
5 | 1 | S1101MFD1637 | THERMOCOUPLE RAKE COVER MOUNTING BRACKET
6 | 1 | S1101MFT1609-01 | | BAG CONTENTS LABEL
7 | 1 | S1101MFT1609-02 | | PART NUMBER LABEL
8 | 1 | S1101MFT1609-XX | | SERIAL NUMBER LABEL
9 | 1 | S1101MFT1609-14 | | CONNECTOR LABEL

C1 | 2 | NAS620C4L | #4 REDUCED THICKNESS FLAT WASHER REDUCED O.D.
C2 | 2 | NAS1352N04-10 | #4-40(.112) UNRC-3A X .625 SOCKET HEAD CAP SCREW

C4 | | - | REMOVED | REMOVED
C5 | 1 | 600X518009X | D-SUB 9 POS F SHIELDED PLASTIC CAP

1 DWG NO REV SH

D | INCORPORATED ACME-ECO-614. | LF 11/17/16 AK 11/17/16 AD 11/21/16

INCORPORATED ACME-ECO-530 AND ACME-ECO-566. C | AD 5/10/16 JO 5/12/16 AR 5/16/16

B | INCORPORATED ACME-ECO-437 | JO 04/27/15 AD 04/27/15 GF 04/30/15

REV | INCORPORATED ACME-ECO-311 & ACME-ECO-339 A DESCRIPTION | AD 10/14/14 GF 10/15/14 APPROVED

THIS DRAWING IS UNDER

CONFIGURATION CONTROL: DO NOT REVISE WITHOUT AN APPROVED ECO. APPROVED: E.McLOSKEY 11/21/2016 | ZIN TECHNOLOGIES CLEVELAND, OHIO 44130 (440) 625-2200 www.zin-tech.com | | | NATIONAL AERONAUTICS AND SPACE ADMINISTRATION CLEVELAND, OHIO

NEXT ASSEMBLY

PRIOR TO USE, CHECK WITH CONFIGURATION
MANAGEMENT FOR ANY OUTSTANDING ECOS.

DESIGNER | | K.RHODES 1/23/13 | QUALITY | | D.SEELEY 2/12/13
REVIEWER | | M.PREVITE 1/24/13 | | | | | M.WILKINSON 1/23/13
A.DRAKE 1/23/13 | | | B.BOROWSKI 2/12/13
T.GOBELI 1/24/13
W.BORRELLI 1/24/13

TITLE
THERMOCOUPLE FAR ARRAY ASSEMBLY
MODEL: S1101MFA1609

3. INSIDE CORNERS R.02 MAX | .XX #-.XXX #-

NOTE:
COVER NOT SHOWN FOR CLARITY

THIRD ANGLE PROJECTION | | | | | | | | C.WERNER 1/30/13
