EmersonBJ/nasa-acme-burner-cad-cfd/PSI-Documents/Engineering Documents/Desenhos_Tecnicos_NASA/ACME_drawings_analog_camera/ACME_drawings_analog_camera/S1101EFA1410_A.pdf

4

3

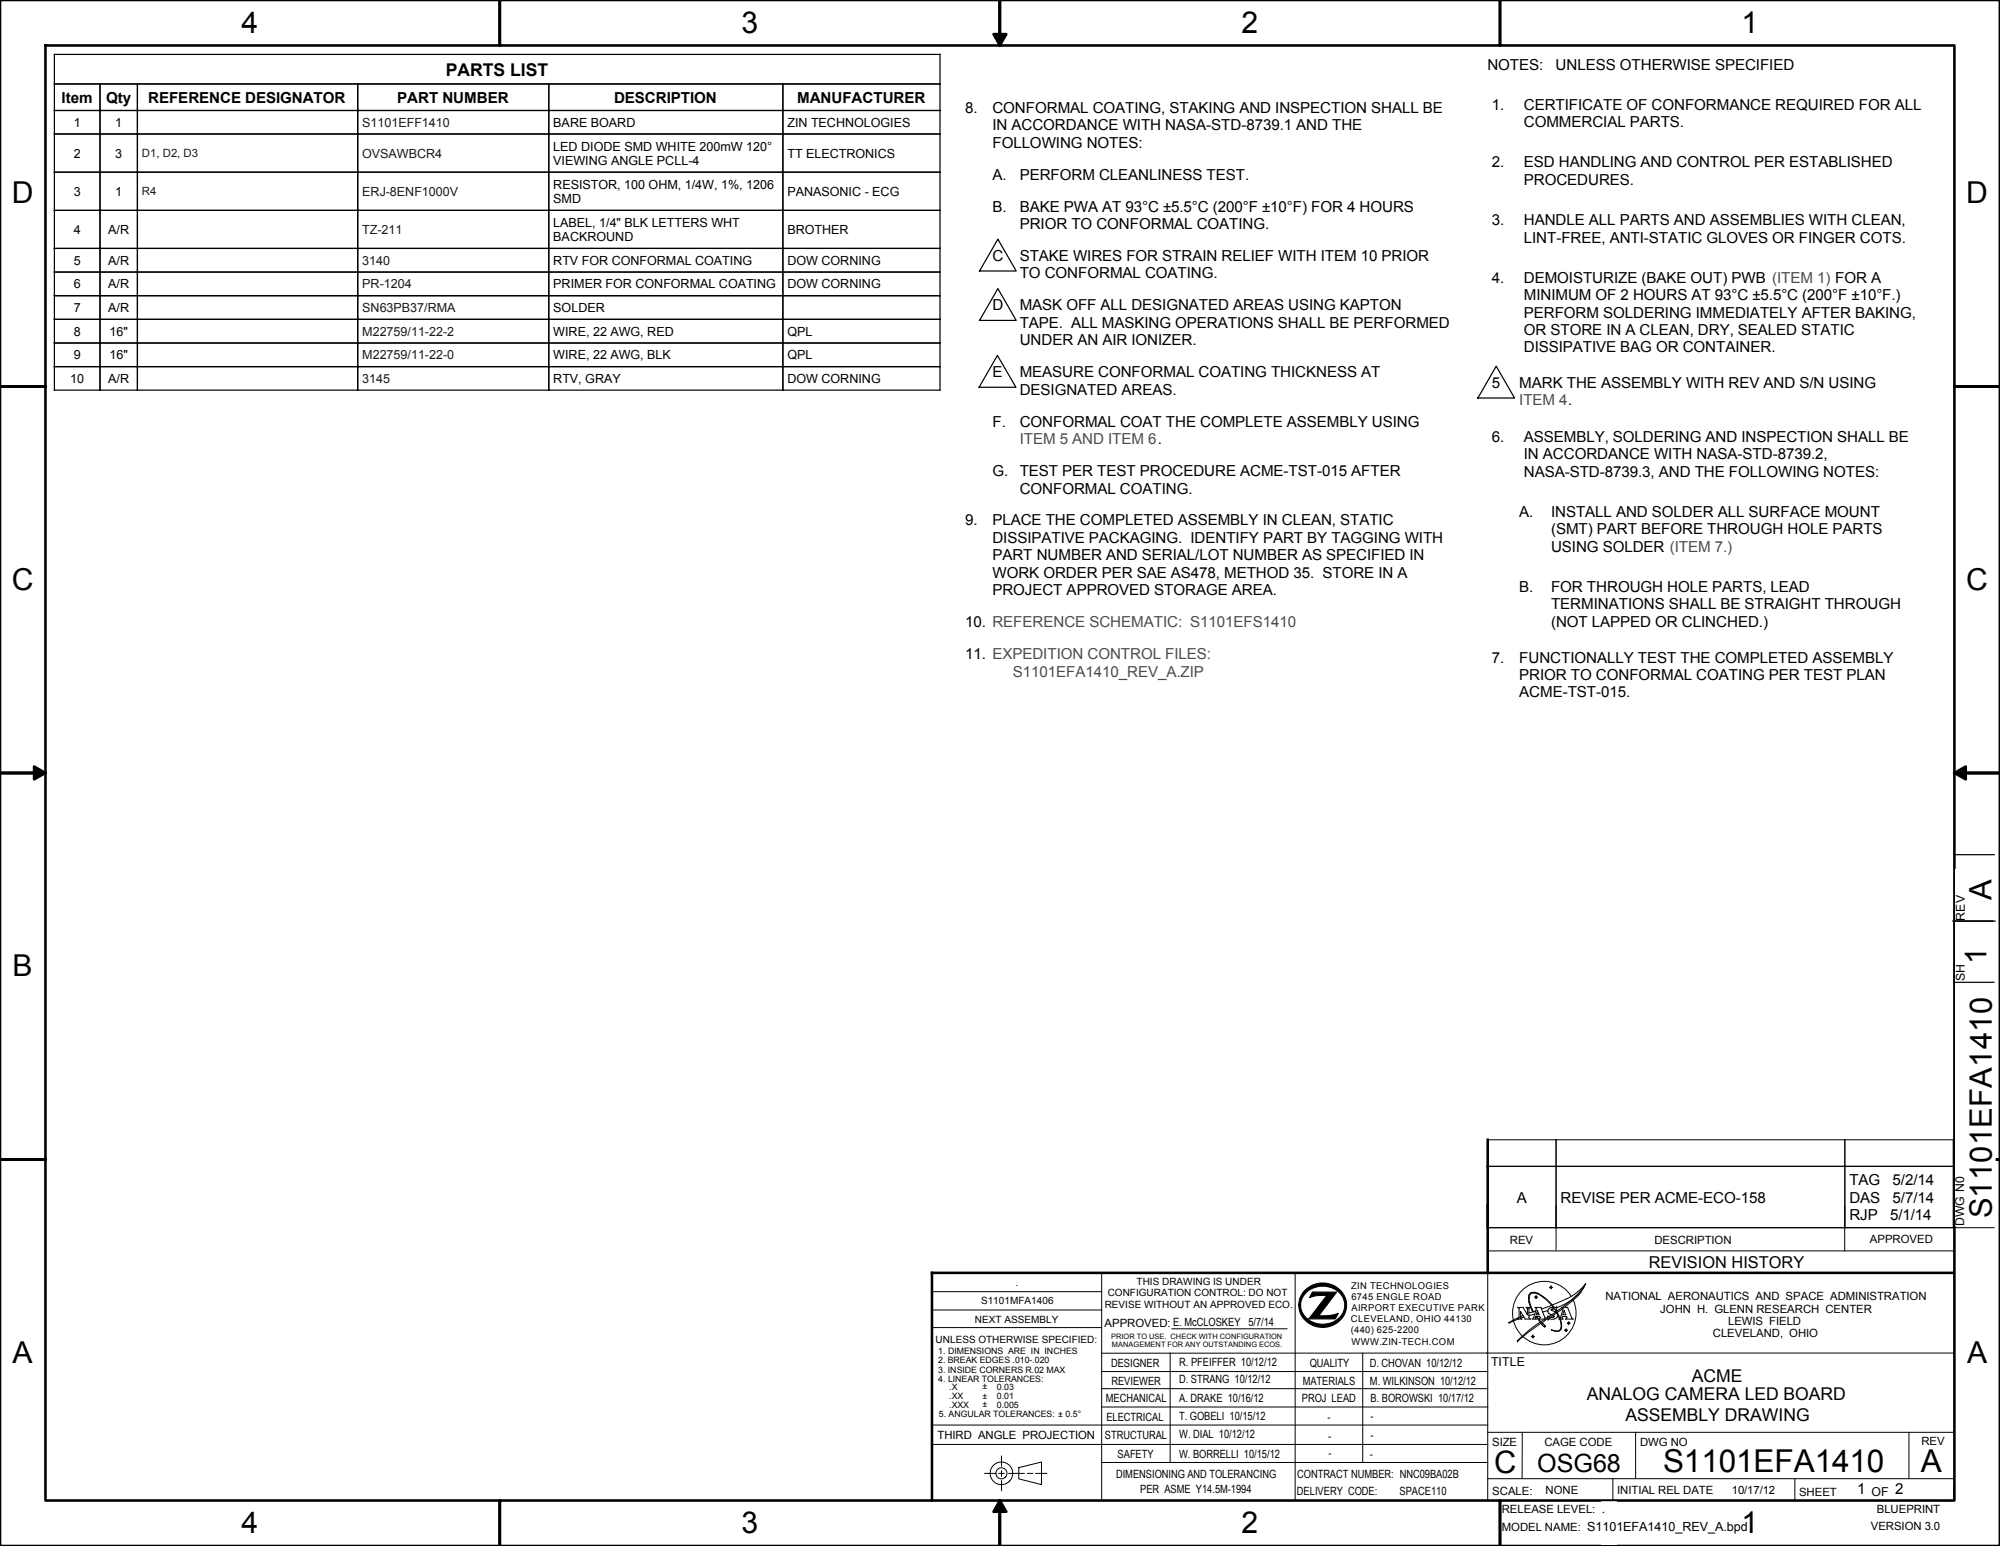
[picture p243: page 1]
10. REFERENCE SCHEMATIC: S1101EFS1410; S1101EFA1410_REV_A.ZIP; PARTS LIST; REV; DESCRIPTION REVISION HISTORY; APPROVED; BLUEPRINT; SH REV; S1101EFA1410; APPROVED: NEXT ASSEMBLY; --- W. DIAL 10/12/12 A. DRAKE 10/16/12; M. WILKINSON 10/12/12 ---; DWG N0; RELEASE LEVEL:; MODEL NAME:; VERSION 3.0 . S1101EFA1410_REV_A.bpd; TAG 5/2/14 DAS 5/7/14 RJP 5/1/14

NOTES: UNLESS OTHERWISE SPECIFIED

Item | Qty | REFERENCE DESIGNATOR | PART NUMBER | DESCRIPTION | MANUFACTURER

8. CONFORMAL COATING, STAKING AND INSPECTION SHALL BE
IN ACCORDANCE WITH NASA-STD-8739.1 AND THE
FOLLOWING NOTES:

1. CERTIFICATE OF CONFORMANCE REQUIRED FOR ALL
COMMERCIAL PARTS.

1 | 1 | | S1101EFF1410 | BARE BOARD | ZIN TECHNOLOGIES

2 | 3 | D1, D2, D3 | OVSAWBCR4 | LED DIODE SMD WHITE 200mW 120° VIEWING ANGLE PCLL-4 | TT ELECTRONICS

2. ESD HANDLING AND CONTROL PER ESTABLISHED
PROCEDURES.

A. PERFORM CLEANLINESS TEST.

3 | 1 | R4 | ERJ-8ENF1000V | RESISTOR, 100 OHM, 1/4W, 1%, 1206 SMD | PANASONIC - ECG

B. BAKE PWA AT 93°C ±5.5°C (200°F ±10°F) FOR 4 HOURS
PRIOR TO CONFORMAL COATING.

3. HANDLE ALL PARTS AND ASSEMBLIES WITH CLEAN,
LINT-FREE, ANTI-STATIC GLOVES OR FINGER COTS.

4 | A/R | | TZ-211 | LABEL, 1/4" BLK LETTERS WHT BACKROUND | BROTHER

5 | A/R | | 3140 | RTV FOR CONFORMAL COATING | DOW CORNING

C STAKE WIRES FOR STRAIN RELIEF WITH ITEM 10 PRIOR
TO CONFORMAL COATING.

4. DEMOISTURIZE (BAKE OUT) PWB (ITEM 1) FOR A
MINIMUM OF 2 HOURS AT 93°C ±5.5°C (200°F ±10°F.)
PERFORM SOLDERING IMMEDIATELY AFTER BAKING,
OR STORE IN A CLEAN, DRY, SEALED STATIC
DISSIPATIVE BAG OR CONTAINER.

6 | A/R | | PR-1204 | PRIMER FOR CONFORMAL COATING | DOW CORNING

7 | A/R | | SN63PB37/RMA | SOLDER

D MASK OFF ALL DESIGNATED AREAS USING KAPTON
TAPE. ALL MASKING OPERATIONS SHALL BE PERFORMED
UNDER AN AIR IONIZER.

8 | 16" | | M22759/11-22-2 | WIRE, 22 AWG, RED | QPL

9 | 16" | | M22759/11-22-0 | WIRE, 22 AWG, BLK | QPL

E MEASURE CONFORMAL COATING THICKNESS AT
DESIGNATED AREAS.

10 | A/R | | 3145 | RTV, GRAY | DOW CORNING

5 MARK THE ASSEMBLY WITH REV AND S/N USING
ITEM 4.

F. CONFORMAL COAT THE COMPLETE ASSEMBLY USING
ITEM 5 AND ITEM 6.

6. ASSEMBLY, SOLDERING AND INSPECTION SHALL BE
IN ACCORDANCE WITH NASA-STD-8739.2,
NASA-STD-8739.3, AND THE FOLLOWING NOTES:

G. TEST PER TEST PROCEDURE ACME-TST-015 AFTER
CONFORMAL COATING.

A. INSTALL AND SOLDER ALL SURFACE MOUNT
(SMT) PART BEFORE THROUGH HOLE PARTS
USING SOLDER (ITEM 7.)

9. PLACE THE COMPLETED ASSEMBLY IN CLEAN, STATIC
DISSIPATIVE PACKAGING. IDENTIFY PART BY TAGGING WITH
PART NUMBER AND SERIAL/LOT NUMBER AS SPECIFIED IN
WORK ORDER PER SAE AS478, METHOD 35. STORE IN A
PROJECT APPROVED STORAGE AREA.

B. FOR THROUGH HOLE PARTS, LEAD
TERMINATIONS SHALL BE STRAIGHT THROUGH
(NOT LAPPED OR CLINCHED.)

11. EXPEDITION CONTROL FILES:

7. FUNCTIONALLY TEST THE COMPLETED ASSEMBLY
PRIOR TO CONFORMAL COATING PER TEST PLAN
ACME-TST-015.

A REVISE PER ACME-ECO-158

THIS DRAWING IS UNDER CONFIGURATION CONTROL: DO NOT REVISE WITHOUT AN APPROVED ECO. E. McCLOSKEY 5/7/14 PRIOR TO USE. CHECK WITH CONFIGURATION MANAGEMENT FOR ANY OUTSTANDING ECOS. | B. BOROWSKI 10/17/12 . S1101MFA1406 ZIN TECHNOLOGIES 6745 ENGLE ROAD AIRPORT EXECUTIVE PARK CLEVELAND, OHIO 44130 (440) 625-2200 WWW.ZIN-TECH.COM | | | CLEVELAND, OHIO TITLE NATIONAL AERONAUTICS AND SPACE ADMINISTRATION LEWIS FIELD

JOHN H. GLENN RESEARCH CENTER

UNLESS OTHERWISE SPECIFIED:
1. DIMENSIONS ARE IN INCHES
2. BREAK EDGES .010-.020
3. INSIDE CORNERS R.02 MAX
4. LINEAR TOLERANCES:
.XXX
5. ANGULAR TOLERANCES: ± 0.5°

DESIGNER | R. PFEIFFER 10/12/12 | QUALITY | D. CHOVAN 10/12/12 | ACME ANALOG CAMERA LED BOARD ASSEMBLY DRAWING

REVIEWER | D. STRANG 10/12/12 | MATERIALS

MECHANICAL | | PROJ LEAD

ELECTRICAL | T. GOBELI 10/15/12

THIRD ANGLE PROJECTION | STRUCTURAL

SIZE | CAGE CODE OSG68 | DWG NO S1101EFA1410 | REV A

W. BORRELLI 10/15/12 | | | C SAFETY

DIMENSIONING AND TOLERANCING PER ASME Y14.5M-1994 | | CONTRACT NUMBER: NNC09BA02B DELIVERY CODE: SPACE110

SCALE: NONE | INITIAL REL DATE 10/17/12 | 1 2 OF SHEET

4

3

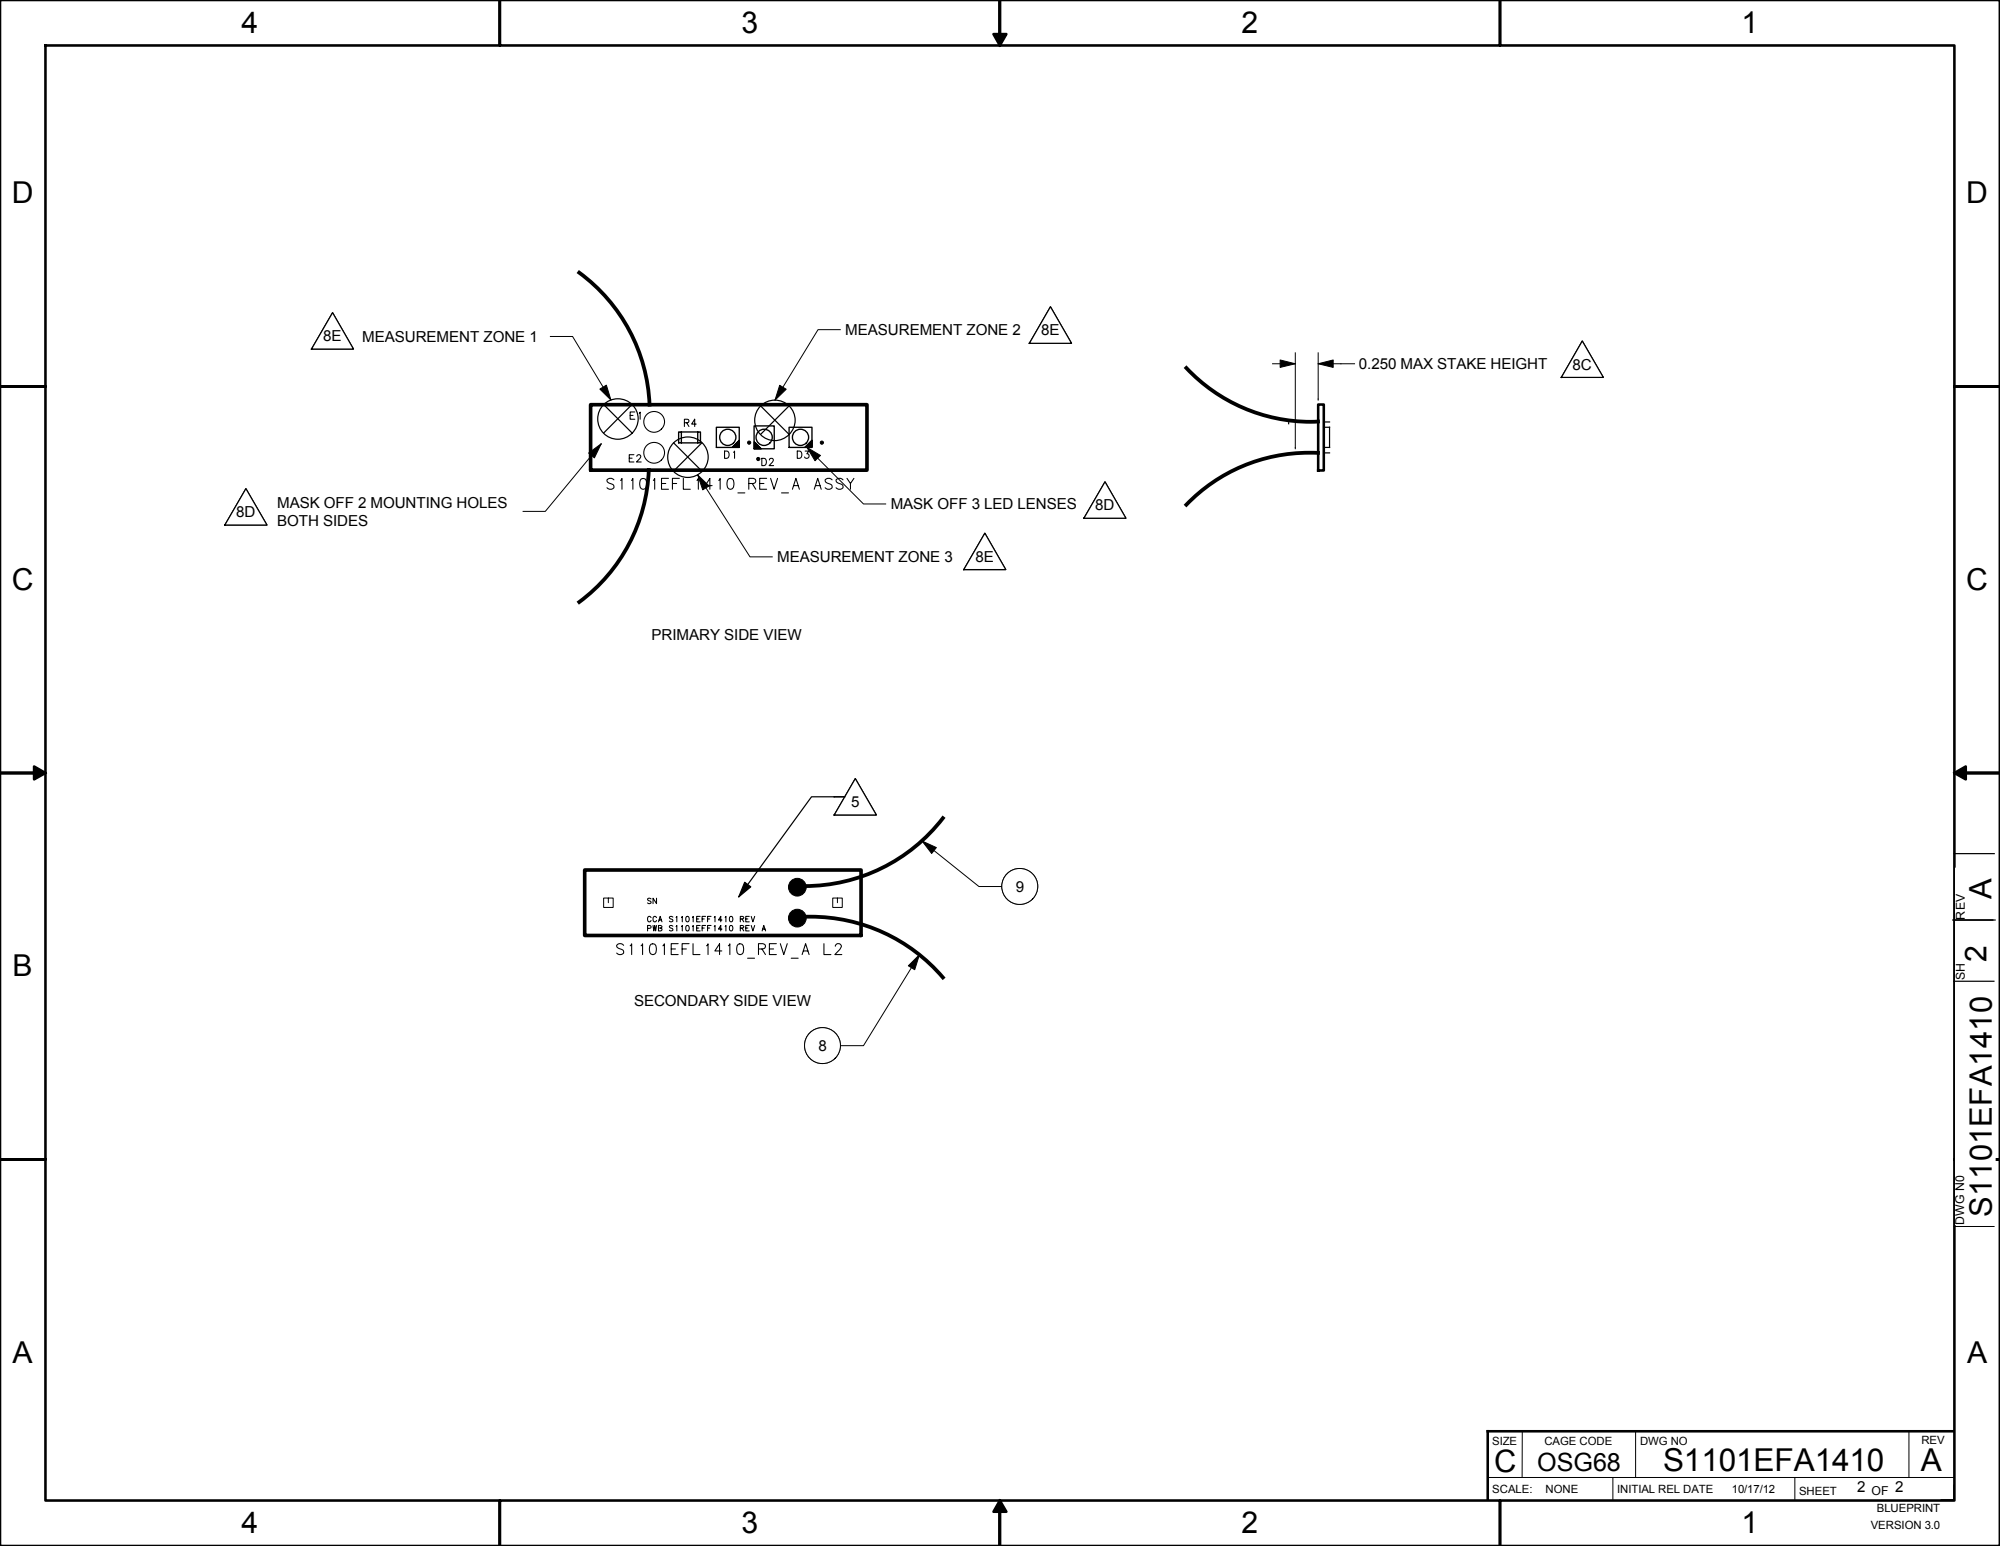
[picture p244: page 2]
MEASUREMENT ZONE 2; MEASUREMENT ZONE 1; MEASUREMENT ZONE 3; BLUEPRINT; SH REV; S1101EFA1410; DWG N0; VERSION 3.0; MASK OFF 3 LED LENSES; 0.250 MAX STAKE HEIGHT

MASK OFF 2 MOUNTING HOLES
BOTH SIDES

PRIMARY SIDE VIEW

SECONDARY SIDE VIEW

SIZE C | CAGE CODE OSG68 | DWG NO S1101EFA1410 | REV A

SCALE: NONE | INITIAL REL DATE 10/17/12 | 2 2 SHEET OF
