EmersonBJ/nasa-acme-burner-cad-cfd/PSI-Documents/Engineering Documents/Desenhos_Tecnicos_NASA/ACME_drawings_analog_camera/ACME_drawings_analog_camera/S1101EFL1410_REV_A.pdf

4

3

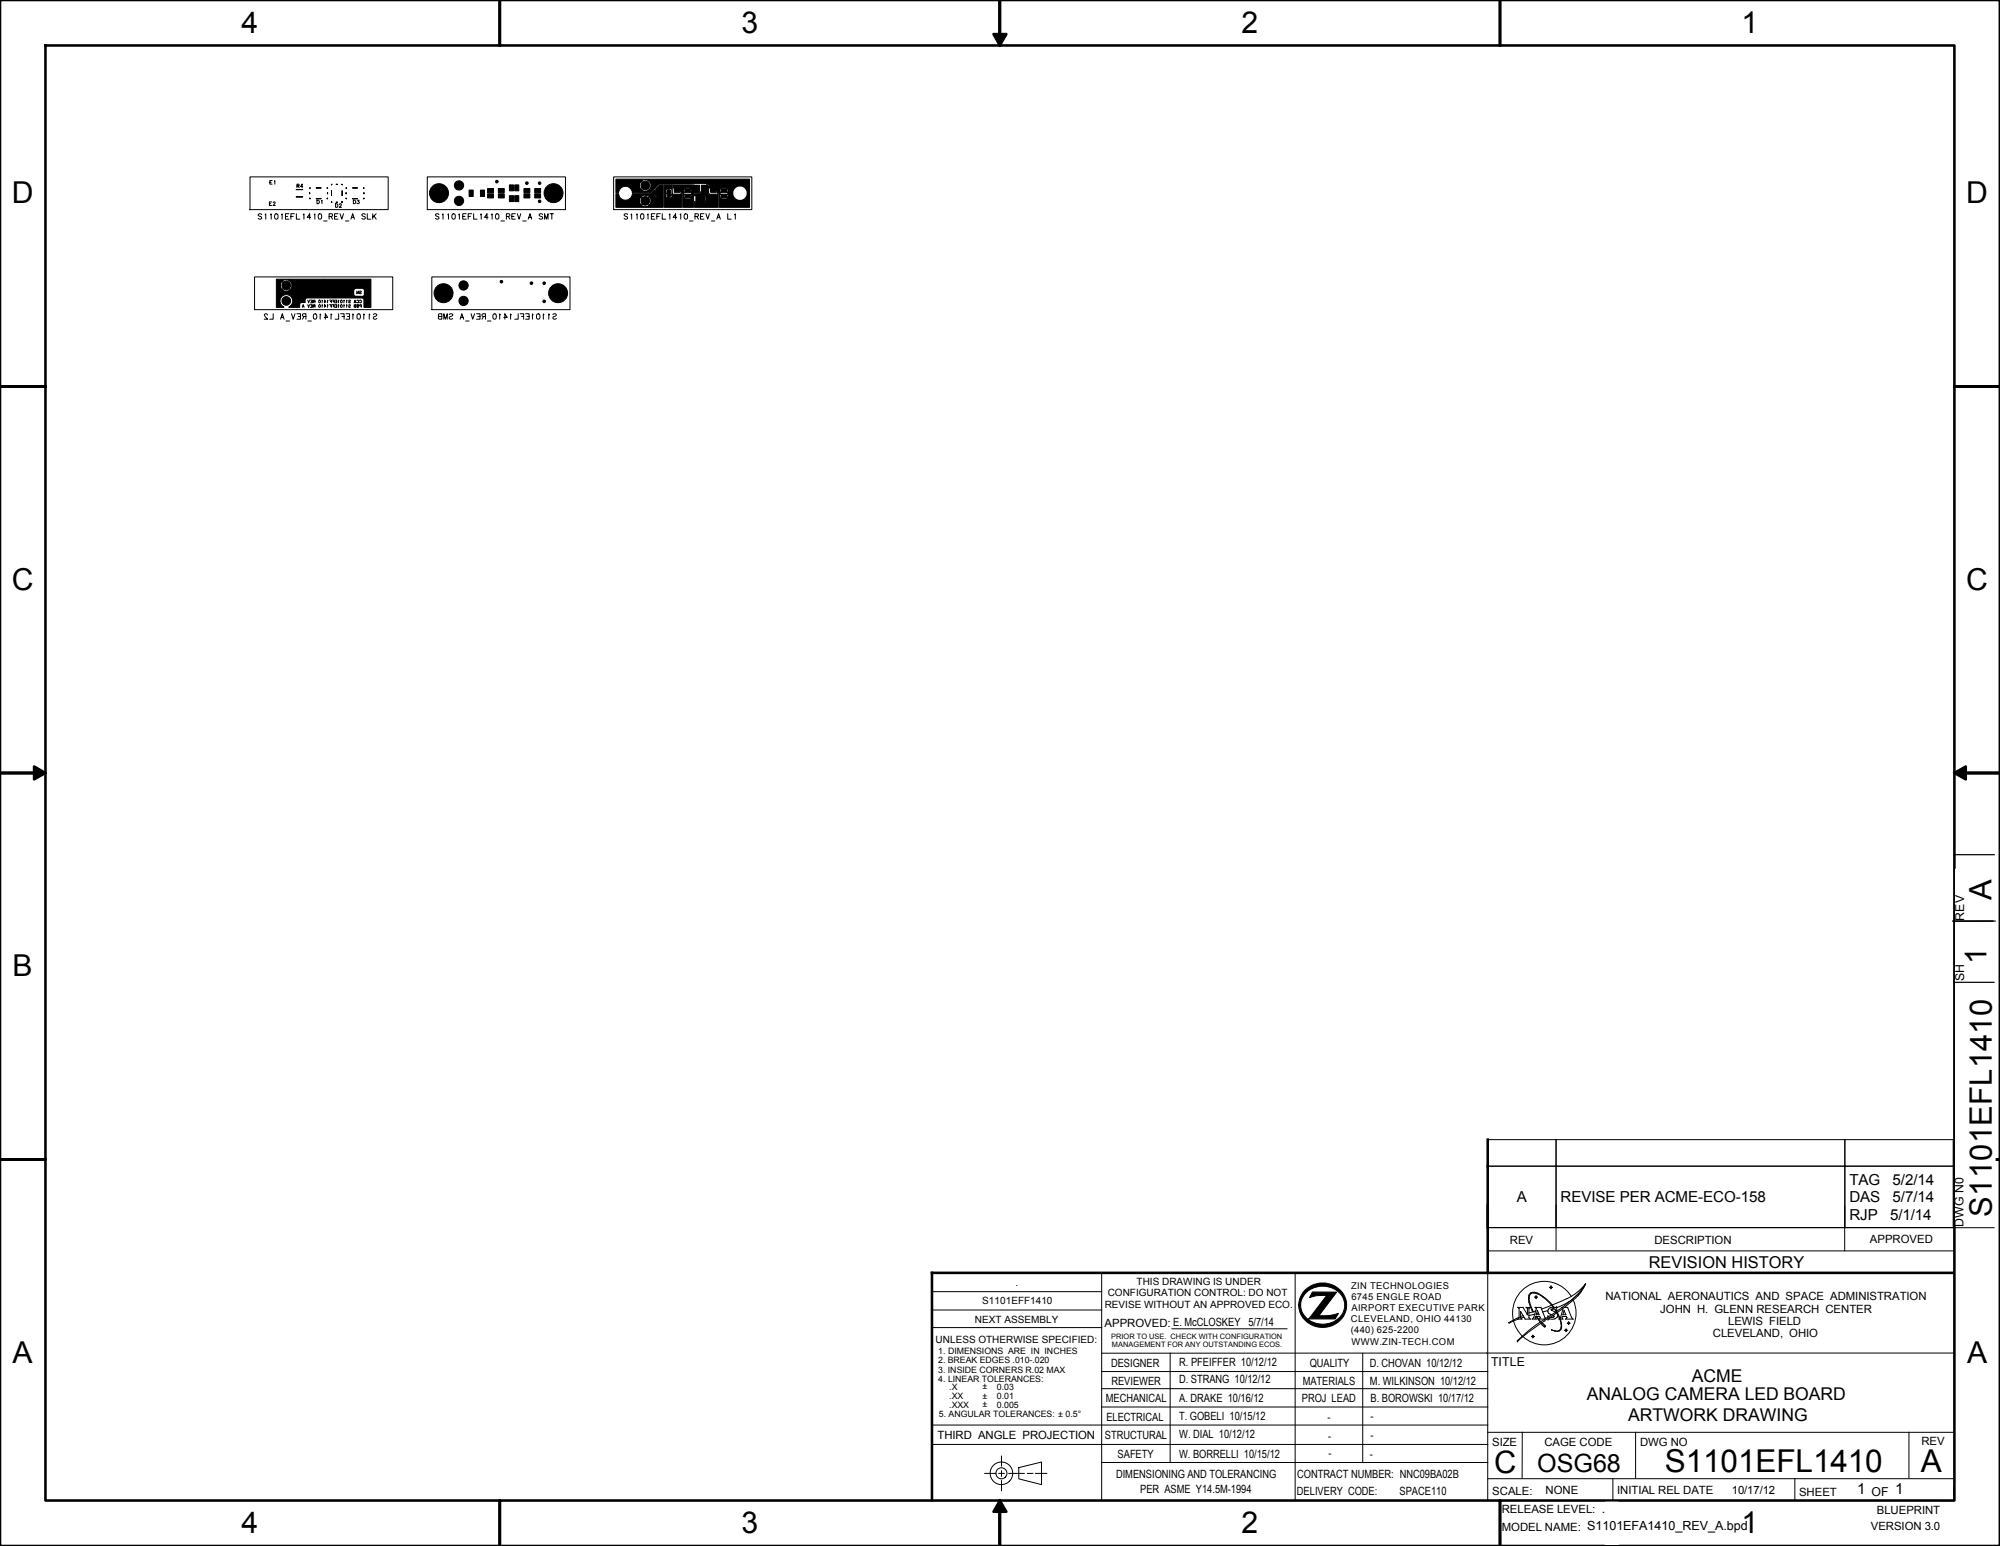
[picture p245: page 1]
REV; DESCRIPTION REVISION HISTORY; APPROVED; BLUEPRINT; SH REV; S1101EFL1410; APPROVED: NEXT ASSEMBLY; --- W. DIAL 10/12/12 A. DRAKE 10/16/12; M. WILKINSON 10/12/12 ---; DWG N0; RELEASE LEVEL:; TAG 5/2/14 DAS 5/7/14 RJP 5/1/14

THIS DRAWING IS UNDER CONFIGURATION CONTROL: DO NOT REVISE WITHOUT AN APPROVED ECO. E. McCLOSKEY 5/7/14 PRIOR TO USE. CHECK WITH CONFIGURATION MANAGEMENT FOR ANY OUTSTANDING ECOS. | B. BOROWSKI 10/17/12 . S1101EFF1410 ZIN TECHNOLOGIES 6745 ENGLE ROAD AIRPORT EXECUTIVE PARK CLEVELAND, OHIO 44130 (440) 625-2200 WWW.ZIN-TECH.COM | MODEL NAME: S1101EFA1410_REV_A.bpd | | REVISE PER ACME-ECO-158 VERSION 3.0 . A CLEVELAND, OHIO TITLE NATIONAL AERONAUTICS AND SPACE ADMINISTRATION LEWIS FIELD

JOHN H. GLENN RESEARCH CENTER

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

DESIGNER | R. PFEIFFER 10/12/12 | QUALITY | D. CHOVAN 10/12/12 | ACME ANALOG CAMERA LED BOARD ARTWORK DRAWING

REVIEWER | D. STRANG 10/12/12 | MATERIALS

MECHANICAL | | PROJ LEAD

ELECTRICAL | T. GOBELI 10/15/12

THIRD ANGLE PROJECTION | STRUCTURAL

SIZE | CAGE CODE OSG68 | DWG NO S1101EFL1410 | REV A

W. BORRELLI 10/15/12 | | | C SAFETY

DIMENSIONING AND TOLERANCING PER ASME Y14.5M-1994 | | CONTRACT NUMBER: NNC09BA02B DELIVERY CODE: SPACE110

SCALE: NONE | INITIAL REL DATE 10/17/12 | 1 1 OF SHEET
