EmersonBJ/nasa-acme-burner-cad-cfd/PSI-Documents/Engineering Documents/Desenhos_Tecnicos_NASA/ACME_drawings_avionics_package/ACME_drawings_avionics_package/S1101EFA3214_C.pdf

4

3

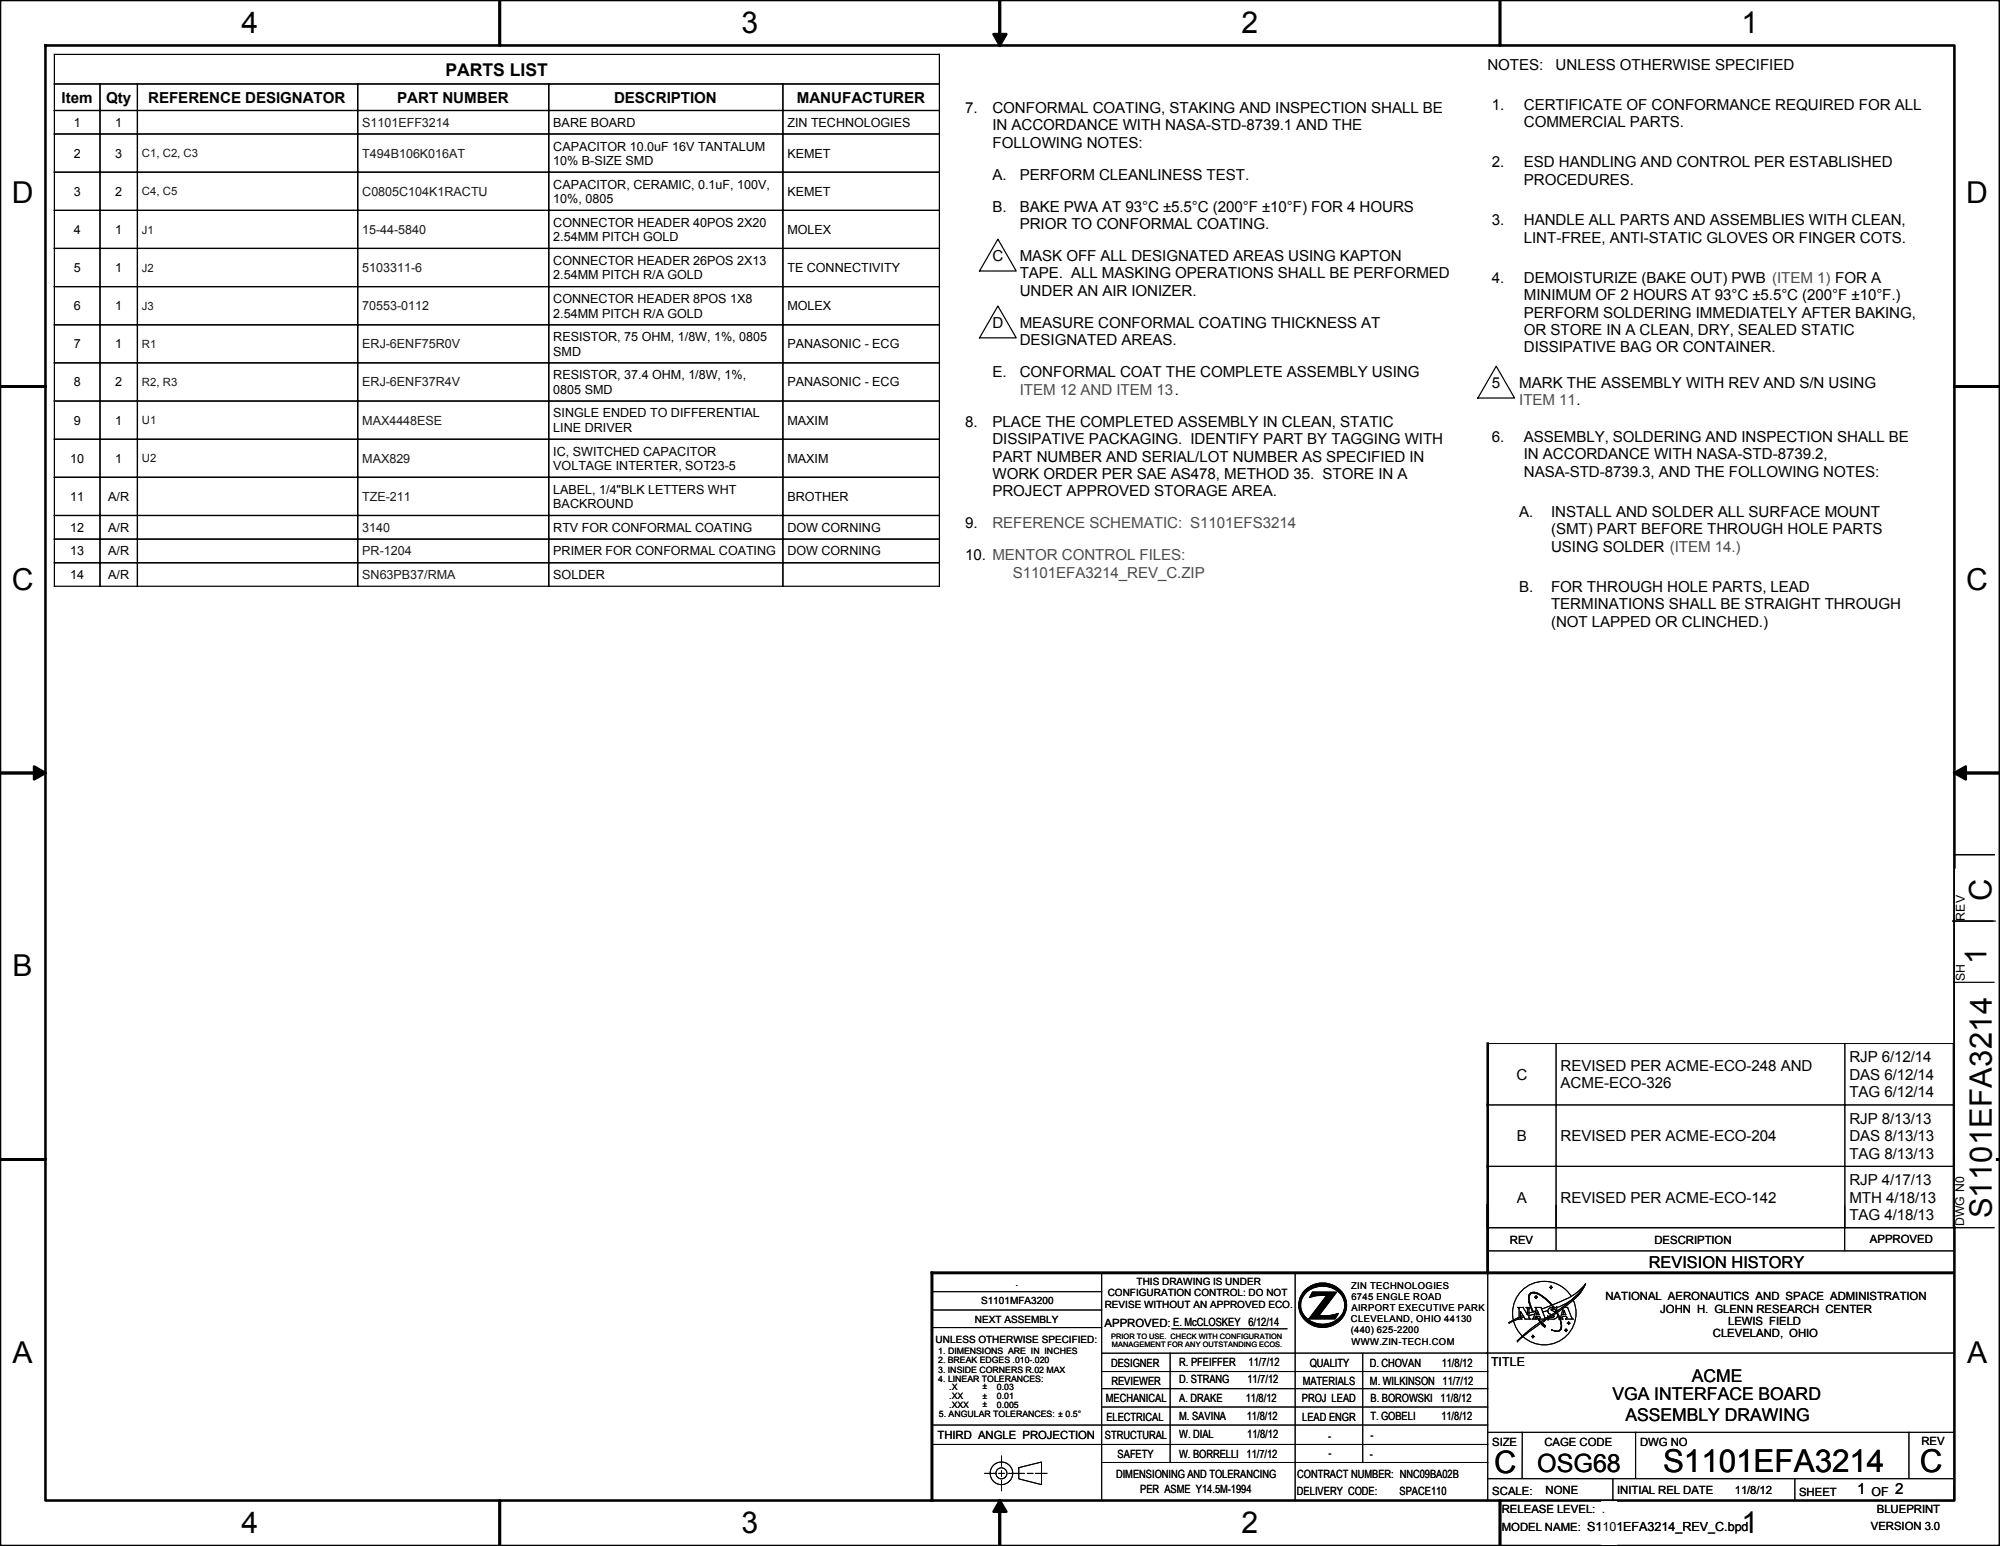
[picture p246: page 1]

NOTES: UNLESS OTHERWISE SPECIFIED

Item | Qty | REFERENCE DESIGNATOR | PART NUMBER | DESCRIPTION | MANUFACTURER

7. CONFORMAL COATING, STAKING AND INSPECTION SHALL BE
IN ACCORDANCE WITH NASA-STD-8739.1 AND THE
FOLLOWING NOTES:

1. CERTIFICATE OF CONFORMANCE REQUIRED FOR ALL
COMMERCIAL PARTS.

1 | 1 | | S1101EFF3214 | BARE BOARD | ZIN TECHNOLOGIES

2 | 3 | C1, C2, C3 | T494B106K016AT | CAPACITOR 10.0uF 16V TANTALUM 10% B-SIZE SMD | KEMET

2. ESD HANDLING AND CONTROL PER ESTABLISHED
PROCEDURES.

3 | 2 | C4, C5 | C0805C104K1RACTU | CAPACITOR, CERAMIC, 0.1uF, 100V, 10%, 0805 | KEMET

B. BAKE PWA AT 93°C ±5.5°C (200°F ±10°F) FOR 4 HOURS
PRIOR TO CONFORMAL COATING.

3. HANDLE ALL PARTS AND ASSEMBLIES WITH CLEAN,
LINT-FREE, ANTI-STATIC GLOVES OR FINGER COTS.

4 | 1 | J1 | 15-44-5840 | CONNECTOR HEADER 40POS 2X20 2.54MM PITCH GOLD | MOLEX

5 | 1 | J2 | 5103311-6 | CONNECTOR HEADER 26POS 2X13 2.54MM PITCH R/A GOLD | TE CONNECTIVITY

C MASK OFF ALL DESIGNATED AREAS USING KAPTON
TAPE. ALL MASKING OPERATIONS SHALL BE PERFORMED
UNDER AN AIR IONIZER.

4. DEMOISTURIZE (BAKE OUT) PWB (ITEM 1) FOR A
MINIMUM OF 2 HOURS AT 93°C ±5.5°C (200°F ±10°F.)
PERFORM SOLDERING IMMEDIATELY AFTER BAKING,
OR STORE IN A CLEAN, DRY, SEALED STATIC
DISSIPATIVE BAG OR CONTAINER.

6 | 1 | J3 | 70553-0112 | CONNECTOR HEADER 8POS 1X8 2.54MM PITCH R/A GOLD | MOLEX

D MEASURE CONFORMAL COATING THICKNESS AT
DESIGNATED AREAS.

7 | 1 | R1 | ERJ-6ENF75R0V | RESISTOR, 75 OHM, 1/8W, 1%, 0805 SMD | PANASONIC - ECG

E. CONFORMAL COAT THE COMPLETE ASSEMBLY USING
ITEM 12 AND ITEM 13.

8 | 2 | R2, R3 | ERJ-6ENF37R4V | RESISTOR, 37.4 OHM, 1/8W, 1%, 0805 SMD | PANASONIC - ECG

5 MARK THE ASSEMBLY WITH REV AND S/N USING
ITEM 11.

9 | 1 | U1 | MAX4448ESE | SINGLE ENDED TO DIFFERENTIAL LINE DRIVER | MAXIM

8. PLACE THE COMPLETED ASSEMBLY IN CLEAN, STATIC
DISSIPATIVE PACKAGING. IDENTIFY PART BY TAGGING WITH
PART NUMBER AND SERIAL/LOT NUMBER AS SPECIFIED IN
WORK ORDER PER SAE AS478, METHOD 35. STORE IN A
PROJECT APPROVED STORAGE AREA.

6. ASSEMBLY, SOLDERING AND INSPECTION SHALL BE
IN ACCORDANCE WITH NASA-STD-8739.2,
NASA-STD-8739.3, AND THE FOLLOWING NOTES:

10 | 1 | U2 | MAX829 | IC, SWITCHED CAPACITOR VOLTAGE INTERTER, SOT23-5 | MAXIM

11 | A/R | | TZE-211 | LABEL, 1/4"BLK LETTERS WHT BACKROUND | BROTHER

A. INSTALL AND SOLDER ALL SURFACE MOUNT
(SMT) PART BEFORE THROUGH HOLE PARTS
USING SOLDER (ITEM 14.)

12 | A/R | | 3140 | RTV FOR CONFORMAL COATING | DOW CORNING

13 | A/R | | PR-1204 | PRIMER FOR CONFORMAL COATING | DOW CORNING

14 | A/R | | SN63PB37/RMA | SOLDER

B. FOR THROUGH HOLE PARTS, LEAD
TERMINATIONS SHALL BE STRAIGHT THROUGH
(NOT LAPPED OR CLINCHED.)

C | REVISED PER ACME-ECO-248 AND ACME-ECO-326 | RJP 6/12/14 DAS 6/12/14 TAG 6/12/14

B REVISED PER ACME-ECO-204 | | RJP 8/13/13 DAS 8/13/13 TAG 8/13/13

A REVISED PER ACME-ECO-142 REV REV | DESCRIPTION | APPROVED

THIS DRAWING IS UNDER THIS DRAWING IS UNDER CONFIGURATION CONTROL: DO NOT CONFIGURATION CONTROL: DO NOT REVISE WITHOUT AN APPROVED ECO. REVISE WITHOUT AN APPROVED ECO. E. McCLOSKEY 6/12/14 E. McCLOSKEY 6/12/14 PRIOR TO USE. CHECK WITH CONFIGURATION PRIOR TO USE. CHECK WITH CONFIGURATION MANAGEMENT FOR ANY OUTSTANDING ECOS. MANAGEMENT FOR ANY OUTSTANDING ECOS. | B. BOROWSKI 11/8/12 . S1101MFA3200 B. BOROWSKI 11/8/12 . S1101MFA3200 ZIN TECHNOLOGIES ZIN TECHNOLOGIES 6745 ENGLE ROAD 6745 ENGLE ROAD AIRPORT EXECUTIVE PARK AIRPORT EXECUTIVE PARK CLEVELAND, OHIO 44130 CLEVELAND, OHIO 44130 (440) 625-2200 (440) 625-2200 WWW.ZIN-TECH.COM WWW.ZIN-TECH.COM | | | CLEVELAND, OHIO TITLE CLEVELAND, OHIO TITLE NATIONAL AERONAUTICS AND SPACE ADMINISTRATION NATIONAL AERONAUTICS AND SPACE ADMINISTRATION LEWIS FIELD LEWIS FIELD

JOHN H. GLENN RESEARCH CENTER

UNLESS OTHERWISE SPECIFIED:
1. DIMENSIONS ARE IN INCHES
2. BREAK EDGES .010-.020
3. INSIDE CORNERS R.02 MAX
4. LINEAR TOLERANCES:
.XXX
5. ANGULAR TOLERANCES: ± 0.5°

DESIGNER | R. PFEIFFER R. PFEIFFER 11/7/12 11/7/12 | QUALITY | D. CHOVAN D. CHOVAN 11/8/12 11/8/12 | ACME ACME VGA INTERFACE BOARD VGA INTERFACE BOARD ASSEMBLY DRAWING ASSEMBLY DRAWING

REVIEWER | D. STRANG D. STRANG 11/7/12 11/7/12 | MATERIALS | M. WILKINSON 11/7/12

MECHANICAL | A. DRAKE A. DRAKE 11/8/12 11/8/12 | PROJ LEAD

THIRD ANGLE PROJECTION | STRUCTURAL | 11/8/12 | | T. GOBELI T. GOBELI 11/8/12 -- W. DIAL 11/8/12 -- W. DIAL

ELECTRICAL | M. SAVINA M. SAVINA 11/8/12 11/8/12

SIZE | CAGE CODE CAGE CODE OSG68 OSG68 | DWG NO DWG NO S1101EFA3214 S1101EFA3214 | REV REV C C

W. BORRELLI 11/7/12 | | | C SAFETY

DIMENSIONING AND TOLERANCING DIMENSIONING AND TOLERANCING PER ASME Y14.5M-1994 PER ASME Y14.5M-1994 | | CONTRACT NUMBER: CONTRACT NUMBER: NNC09BA02B NNC09BA02B DELIVERY CODE: DELIVERY CODE: SPACE110 SPACE110

SCALE: SCALE: NONE NONE | INITIAL REL DATE INITIAL REL DATE 11/8/12 11/8/12 | 1 2 1 2 OF OF SHEET SHEET

4

3

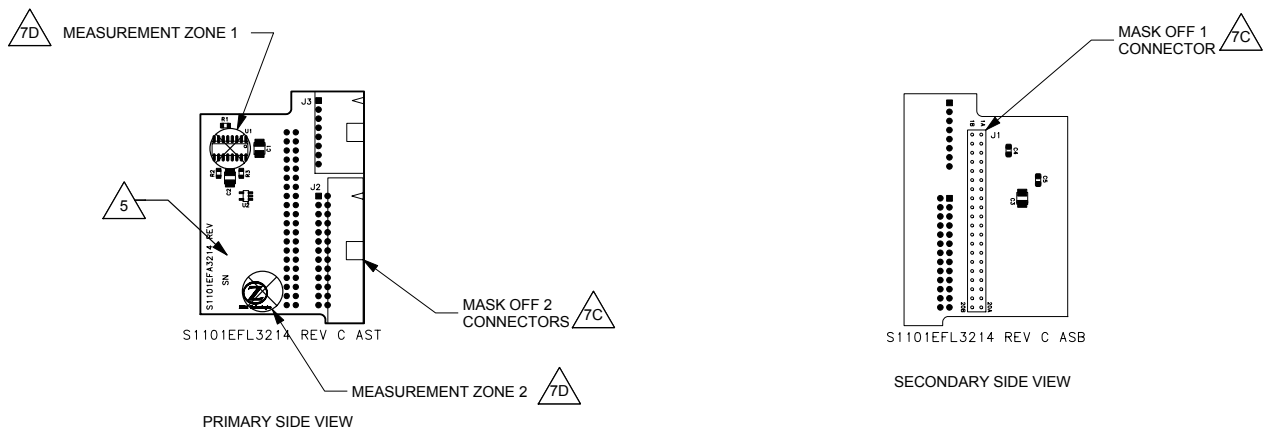
[picture p247: page 2]
MEASUREMENT ZONE 1; MEASUREMENT ZONE 2; BLUEPRINT; SH REV; S1101EFA3214; DWG N0; VERSION 3.0; MASK OFF 2 CONNECTORS 7C; MASK OFF 1; CONNECTOR

SECONDARY SIDE VIEW

PRIMARY SIDE VIEW

SIZE C | CAGE CODE OSG68 | DWG NO S1101EFA3214 | REV C

SCALE: NONE | INITIAL REL DATE 11/8/12 | 2 2 SHEET OF
