EmersonBJ/nasa-acme-burner-cad-cfd/PSI-Documents/Engineering Documents/Desenhos_Tecnicos_NASA/ACME_drawings_avionics_package/ACME_drawings_avionics_package/S1101EFA3216_A.pdf

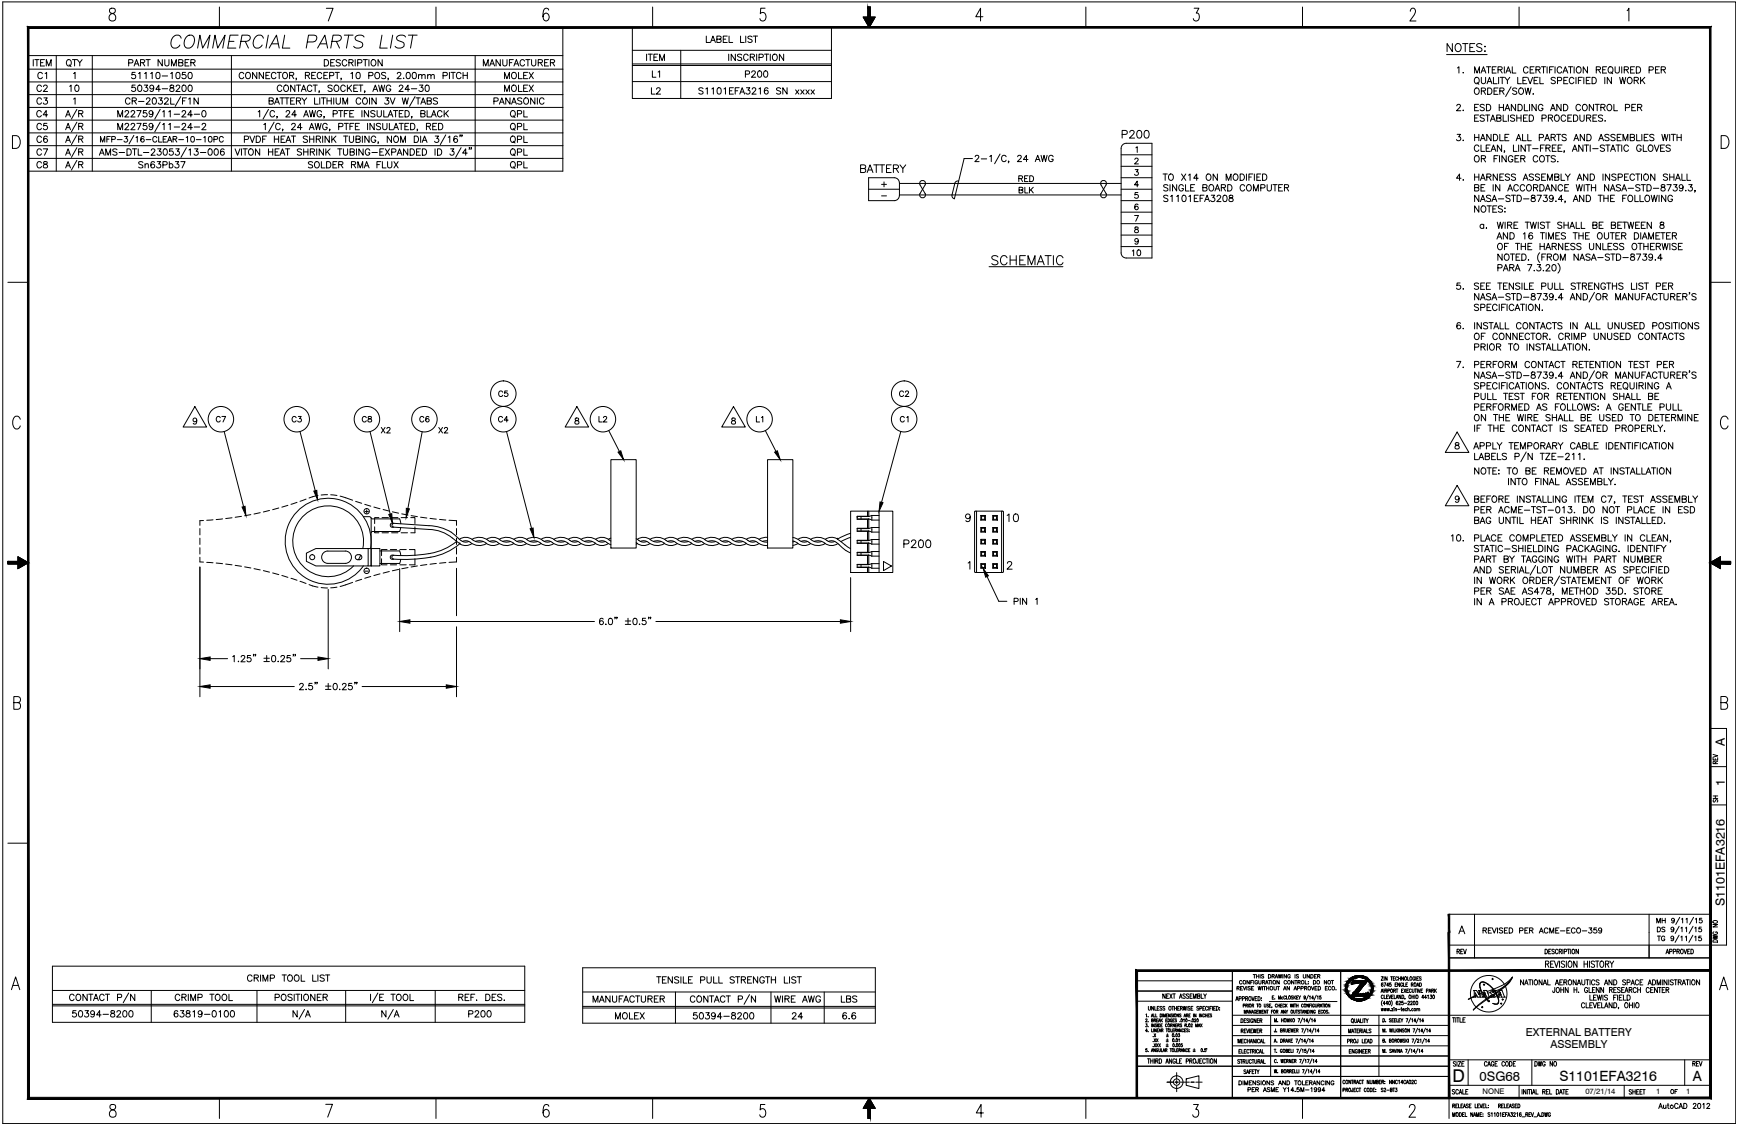
[picture p248: page 1]
0SG68 NONE; 1 S1101EFA3216; A ASSEMBLY EXTERNAL BATTERY; S1101EFA3216 A 1
