EmersonBJ/nasa-acme-burner-cad-cfd/PSI-Documents/Engineering Documents/Desenhos_Tecnicos_NASA/ACME_drawings_avionics_package/ACME_drawings_avionics_package/S1101EFF3215_B.pdf

4

3

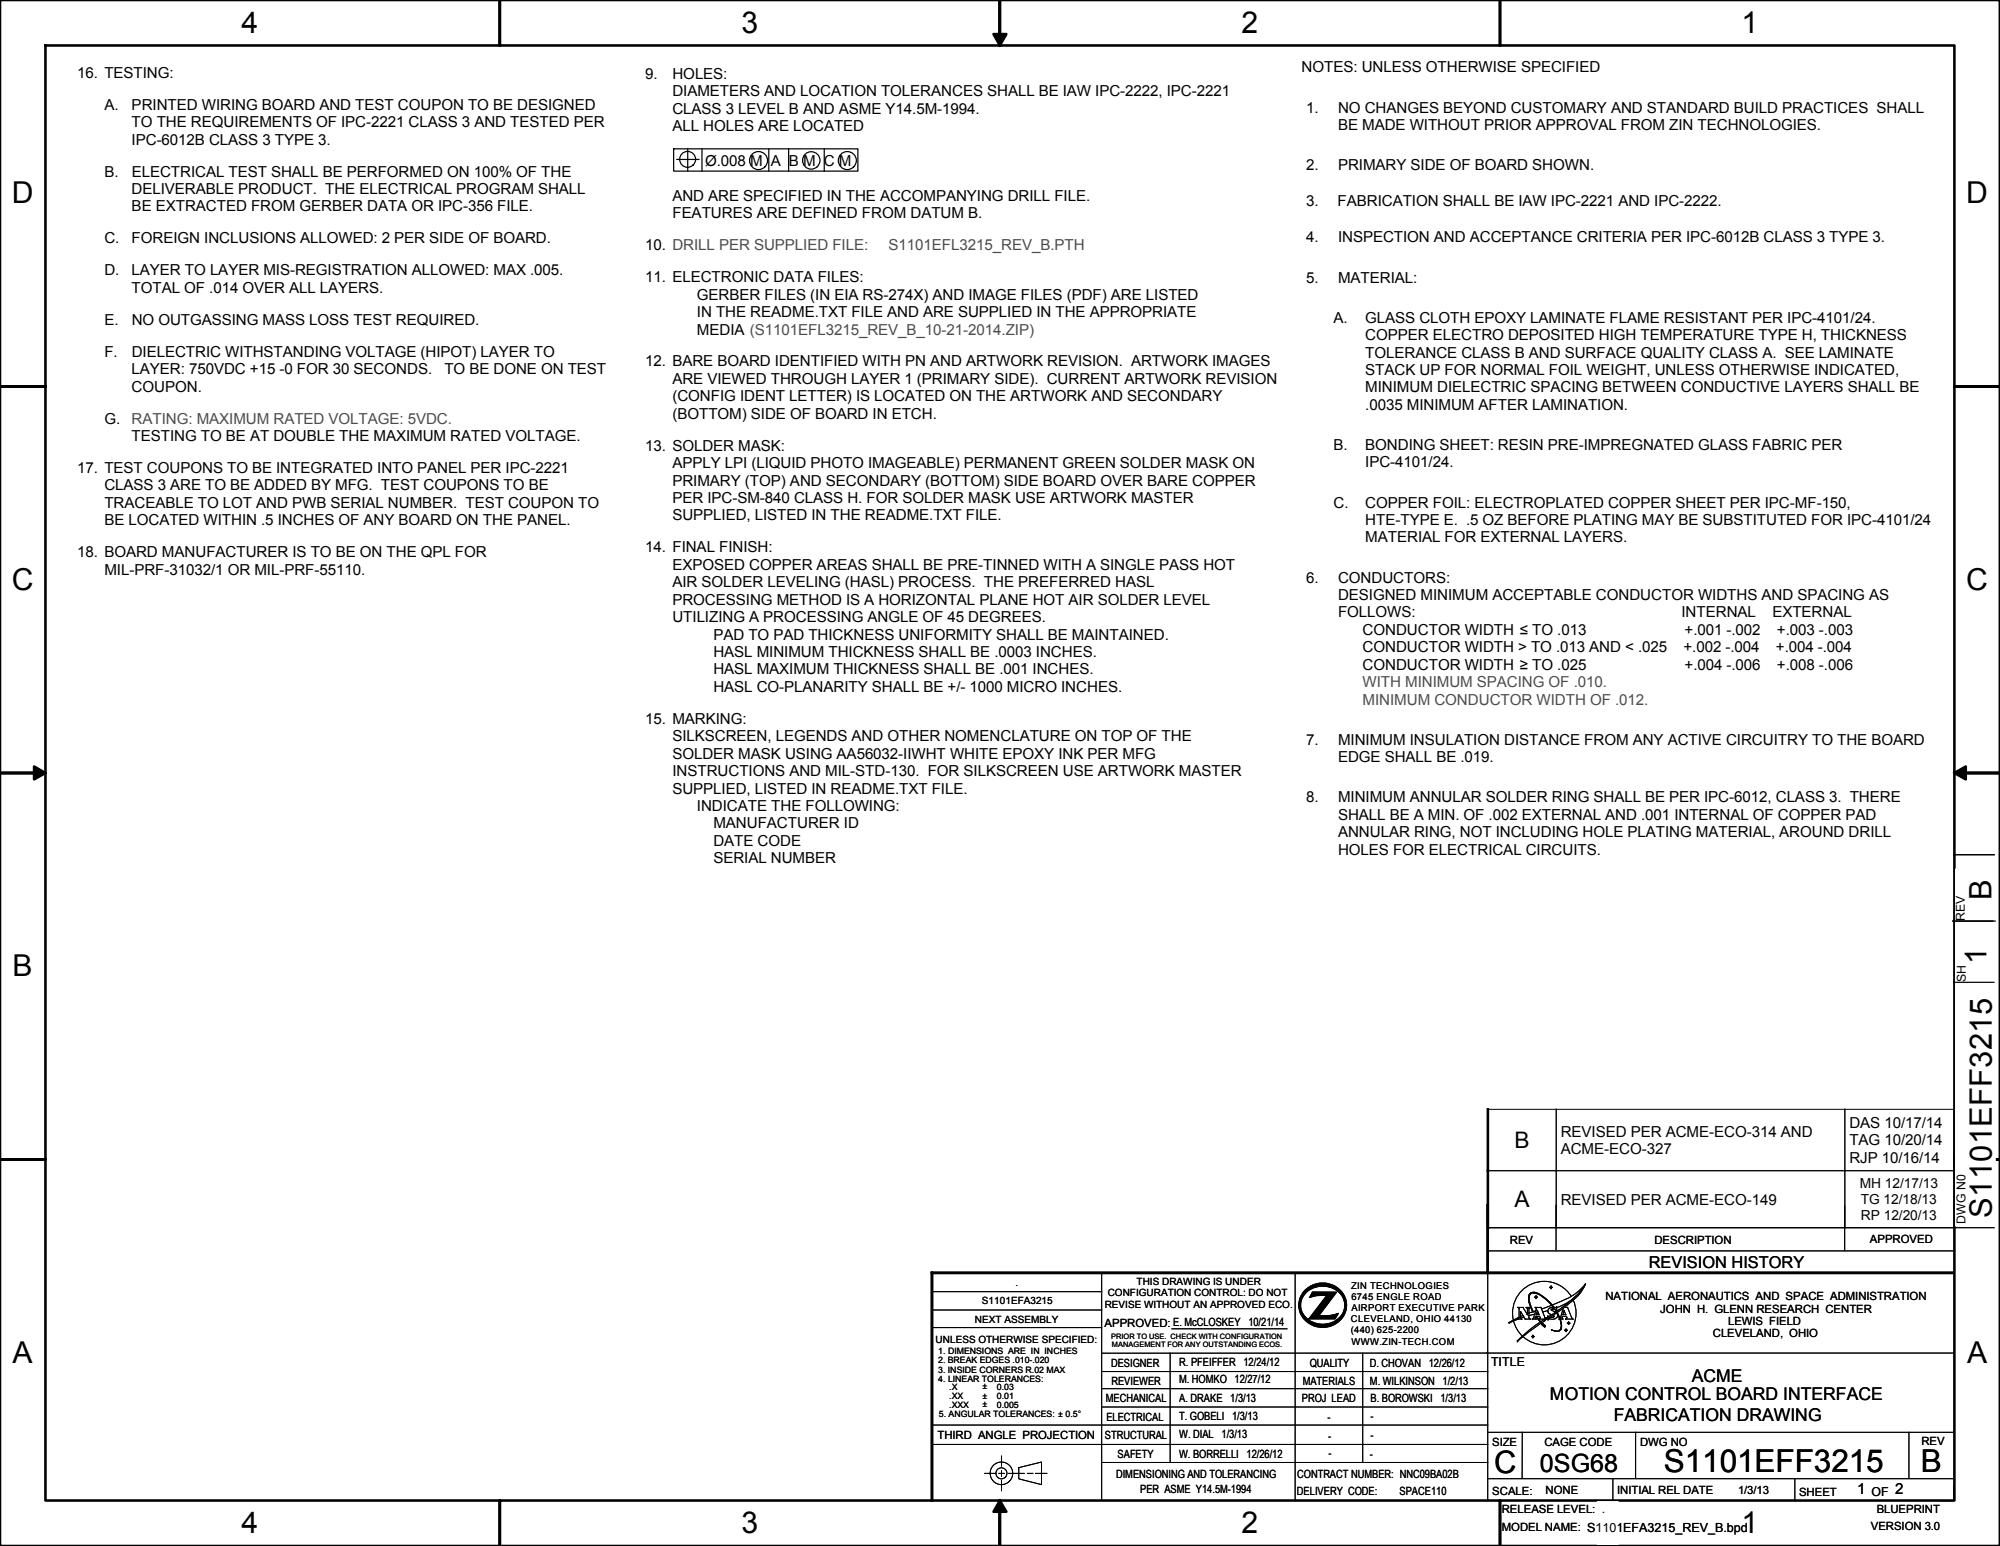
[picture p249: page 1]
5. MATERIAL:; FOLLOWS:; INTERNAL EXTERNAL; CONDUCTOR WIDTH ≤ TO .013; CONDUCTOR WIDTH ≥ TO .025; 10. DRILL PER SUPPLIED FILE:; S1101EFL3215_REV_B.PTH; 16. TESTING:; REV; DESCRIPTION REVISION HISTORY; APPROVED; BLUEPRINT; SH REV; S1101EFF3215; APPROVED: NEXT ASSEMBLY; --- W. DIAL 1/3/13 A. DRAKE 1/3/13; M. WILKINSON 1/2/13 ---; DWG N0; RELEASE LEVEL:; MODEL NAME: S1101EFA3215_REV_B.bpd; VERSION 3.0 . MOTION CONTROL BOARD INTERFACE; VERSION 3.0 . B; REVISED PER ACME-ECO-314 AND ACME-ECO-327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

NOTES: UNLESS OTHERWISE SPECIFIED

9. HOLES:
DIAMETERS AND LOCATION TOLERANCES SHALL BE IAW IPC-2222, IPC-2221
CLASS 3 LEVEL B AND ASME Y14.5M-1994.
ALL HOLES ARE LOCATED

A. PRINTED WIRING BOARD AND TEST COUPON TO BE DESIGNED
TO THE REQUIREMENTS OF IPC-2221 CLASS 3 AND TESTED PER
IPC-6012B CLASS 3 TYPE 3.

1. NO CHANGES BEYOND CUSTOMARY AND STANDARD BUILD PRACTICES SHALL
BE MADE WITHOUT PRIOR APPROVAL FROM ZIN TECHNOLOGIES.

B. ELECTRICAL TEST SHALL BE PERFORMED ON 100% OF THE
DELIVERABLE PRODUCT. THE ELECTRICAL PROGRAM SHALL
BE EXTRACTED FROM GERBER DATA OR IPC-356 FILE.

2. PRIMARY SIDE OF BOARD SHOWN.

AND ARE SPECIFIED IN THE ACCOMPANYING DRILL FILE.
FEATURES ARE DEFINED FROM DATUM B.

3. FABRICATION SHALL BE IAW IPC-2221 AND IPC-2222.

C. FOREIGN INCLUSIONS ALLOWED: 2 PER SIDE OF BOARD.

4. INSPECTION AND ACCEPTANCE CRITERIA PER IPC-6012B CLASS 3 TYPE 3.

D. LAYER TO LAYER MIS-REGISTRATION ALLOWED: MAX .005. TOTAL OF .014 OVER ALL LAYERS.

11. ELECTRONIC DATA FILES:

GERBER FILES (IN EIA RS-274X) AND IMAGE FILES (PDF) ARE LISTED
IN THE README.TXT FILE AND ARE SUPPLIED IN THE APPROPRIATE
MEDIA (S1101EFL3215_REV_B_10-21-2014.ZIP)

E. NO OUTGASSING MASS LOSS TEST REQUIRED.

A. GLASS CLOTH EPOXY LAMINATE FLAME RESISTANT PER IPC-4101/24.
COPPER ELECTRO DEPOSITED HIGH TEMPERATURE TYPE H, THICKNESS
TOLERANCE CLASS B AND SURFACE QUALITY CLASS A. SEE LAMINATE
STACK UP FOR NORMAL FOIL WEIGHT, UNLESS OTHERWISE INDICATED,
MINIMUM DIELECTRIC SPACING BETWEEN CONDUCTIVE LAYERS SHALL BE
.0035 MINIMUM AFTER LAMINATION.

F. DIELECTRIC WITHSTANDING VOLTAGE (HIPOT) LAYER TO
LAYER: 750VDC +15 -0 FOR 30 SECONDS. TO BE DONE ON TEST
COUPON.

12. BARE BOARD IDENTIFIED WITH PN AND ARTWORK REVISION. ARTWORK IMAGES
ARE VIEWED THROUGH LAYER 1 (PRIMARY SIDE). CURRENT ARTWORK REVISION
(CONFIG IDENT LETTER) IS LOCATED ON THE ARTWORK AND SECONDARY
(BOTTOM) SIDE OF BOARD IN ETCH.

G. RATING: MAXIMUM RATED VOLTAGE: 5VDC.
TESTING TO BE AT DOUBLE THE MAXIMUM RATED VOLTAGE.

13. SOLDER MASK:
APPLY LPI (LIQUID PHOTO IMAGEABLE) PERMANENT GREEN SOLDER MASK ON
PRIMARY (TOP) AND SECONDARY (BOTTOM) SIDE BOARD OVER BARE COPPER
PER IPC-SM-840 CLASS H. FOR SOLDER MASK USE ARTWORK MASTER
SUPPLIED, LISTED IN THE README.TXT FILE.

B. BONDING SHEET: RESIN PRE-IMPREGNATED GLASS FABRIC PER
IPC-4101/24.

17. TEST COUPONS TO BE INTEGRATED INTO PANEL PER IPC-2221
CLASS 3 ARE TO BE ADDED BY MFG. TEST COUPONS TO BE
TRACEABLE TO LOT AND PWB SERIAL NUMBER. TEST COUPON TO
BE LOCATED WITHIN .5 INCHES OF ANY BOARD ON THE PANEL.

C. COPPER FOIL: ELECTROPLATED COPPER SHEET PER IPC-MF-150,
HTE-TYPE E. .5 OZ BEFORE PLATING MAY BE SUBSTITUTED FOR IPC-4101/24
MATERIAL FOR EXTERNAL LAYERS.

18. BOARD MANUFACTURER IS TO BE ON THE QPL FOR
MIL-PRF-31032/1 OR MIL-PRF-55110.

14. FINAL FINISH:
EXPOSED COPPER AREAS SHALL BE PRE-TINNED WITH A SINGLE PASS HOT
AIR SOLDER LEVELING (HASL) PROCESS. THE PREFERRED HASL
PROCESSING METHOD IS A HORIZONTAL PLANE HOT AIR SOLDER LEVEL
UTILIZING A PROCESSING ANGLE OF 45 DEGREES.
PAD TO PAD THICKNESS UNIFORMITY SHALL BE MAINTAINED.
HASL MINIMUM THICKNESS SHALL BE .0003 INCHES.
HASL MAXIMUM THICKNESS SHALL BE .001 INCHES.
HASL CO-PLANARITY SHALL BE +/- 1000 MICRO INCHES.

6. CONDUCTORS:
DESIGNED MINIMUM ACCEPTABLE CONDUCTOR WIDTHS AND SPACING AS
CONDUCTOR WIDTH > TO .013 AND < .025 +.002 -.004 +.004 -.004
WITH MINIMUM SPACING OF .010.
MINIMUM CONDUCTOR WIDTH OF .012.

15. MARKING:
SILKSCREEN, LEGENDS AND OTHER NOMENCLATURE ON TOP OF THE
SOLDER MASK USING AA56032-IIWHT WHITE EPOXY INK PER MFG
INSTRUCTIONS AND MIL-STD-130. FOR SILKSCREEN USE ARTWORK MASTER
SUPPLIED, LISTED IN README.TXT FILE.
INDICATE THE FOLLOWING:
MANUFACTURER ID
DATE CODE
SERIAL NUMBER

7. MINIMUM INSULATION DISTANCE FROM ANY ACTIVE CIRCUITRY TO THE BOARD
EDGE SHALL BE .019.

8. MINIMUM ANNULAR SOLDER RING SHALL BE PER IPC-6012, CLASS 3. THERE
SHALL BE A MIN. OF .002 EXTERNAL AND .001 INTERNAL OF COPPER PAD
ANNULAR RING, NOT INCLUDING HOLE PLATING MATERIAL, AROUND DRILL
HOLES FOR ELECTRICAL CIRCUITS.

THIS DRAWING IS UNDER THIS DRAWING IS UNDER CONFIGURATION CONTROL: DO NOT CONFIGURATION CONTROL: DO NOT REVISE WITHOUT AN APPROVED ECO. REVISE WITHOUT AN APPROVED ECO. E. McCLOSKEY 10/21/14 E. McCLOSKEY 10/21/14 PRIOR TO USE. CHECK WITH CONFIGURATION PRIOR TO USE. CHECK WITH CONFIGURATION MANAGEMENT FOR ANY OUTSTANDING ECOS. MANAGEMENT FOR ANY OUTSTANDING ECOS. | B. BOROWSKI 1/3/13 . S1101EFA3215 B. BOROWSKI 1/3/13 . S1101EFA3215 ZIN TECHNOLOGIES ZIN TECHNOLOGIES 6745 ENGLE ROAD 6745 ENGLE ROAD AIRPORT EXECUTIVE PARK AIRPORT EXECUTIVE PARK CLEVELAND, OHIO 44130 CLEVELAND, OHIO 44130 (440) 625-2200 (440) 625-2200 WWW.ZIN-TECH.COM WWW.ZIN-TECH.COM | | | CLEVELAND, OHIO TITLE CLEVELAND, OHIO TITLE NATIONAL AERONAUTICS AND SPACE ADMINISTRATION NATIONAL AERONAUTICS AND SPACE ADMINISTRATION LEWIS FIELD LEWIS FIELD

JOHN H. GLENN RESEARCH CENTER

UNLESS OTHERWISE SPECIFIED:
1. DIMENSIONS ARE IN INCHES
2. BREAK EDGES .010-.020
3. INSIDE CORNERS R.02 MAX
4. LINEAR TOLERANCES:
.XXX
5. ANGULAR TOLERANCES: ± 0.5°

DESIGNER | R. PFEIFFER 12/24/12 | QUALITY | D. CHOVAN 12/26/12 | ACME ACME MOTION CONTROL BOARD INTERFACE FABRICATION DRAWING FABRICATION DRAWING

REVIEWER | M. HOMKO 12/27/12 | MATERIALS

MECHANICAL | | PROJ LEAD

ELECTRICAL | T. GOBELI 1/3/13

THIRD ANGLE PROJECTION | STRUCTURAL

SIZE | CAGE CODE CAGE CODE 0SG68 0SG68 | DWG NO DWG NO S1101EFF3215 S1101EFF3215 | REV REV B B

W. BORRELLI 12/26/12 | | | C SAFETY

DIMENSIONING AND TOLERANCING DIMENSIONING AND TOLERANCING PER ASME Y14.5M-1994 PER ASME Y14.5M-1994 | | CONTRACT NUMBER: CONTRACT NUMBER: NNC09BA02B NNC09BA02B DELIVERY CODE: DELIVERY CODE: SPACE110 SPACE110

SCALE: SCALE: NONE NONE | INITIAL REL DATE INITIAL REL DATE 1/3/13 1/3/13 | 1 2 1 2 OF OF SHEET SHEET

4

3

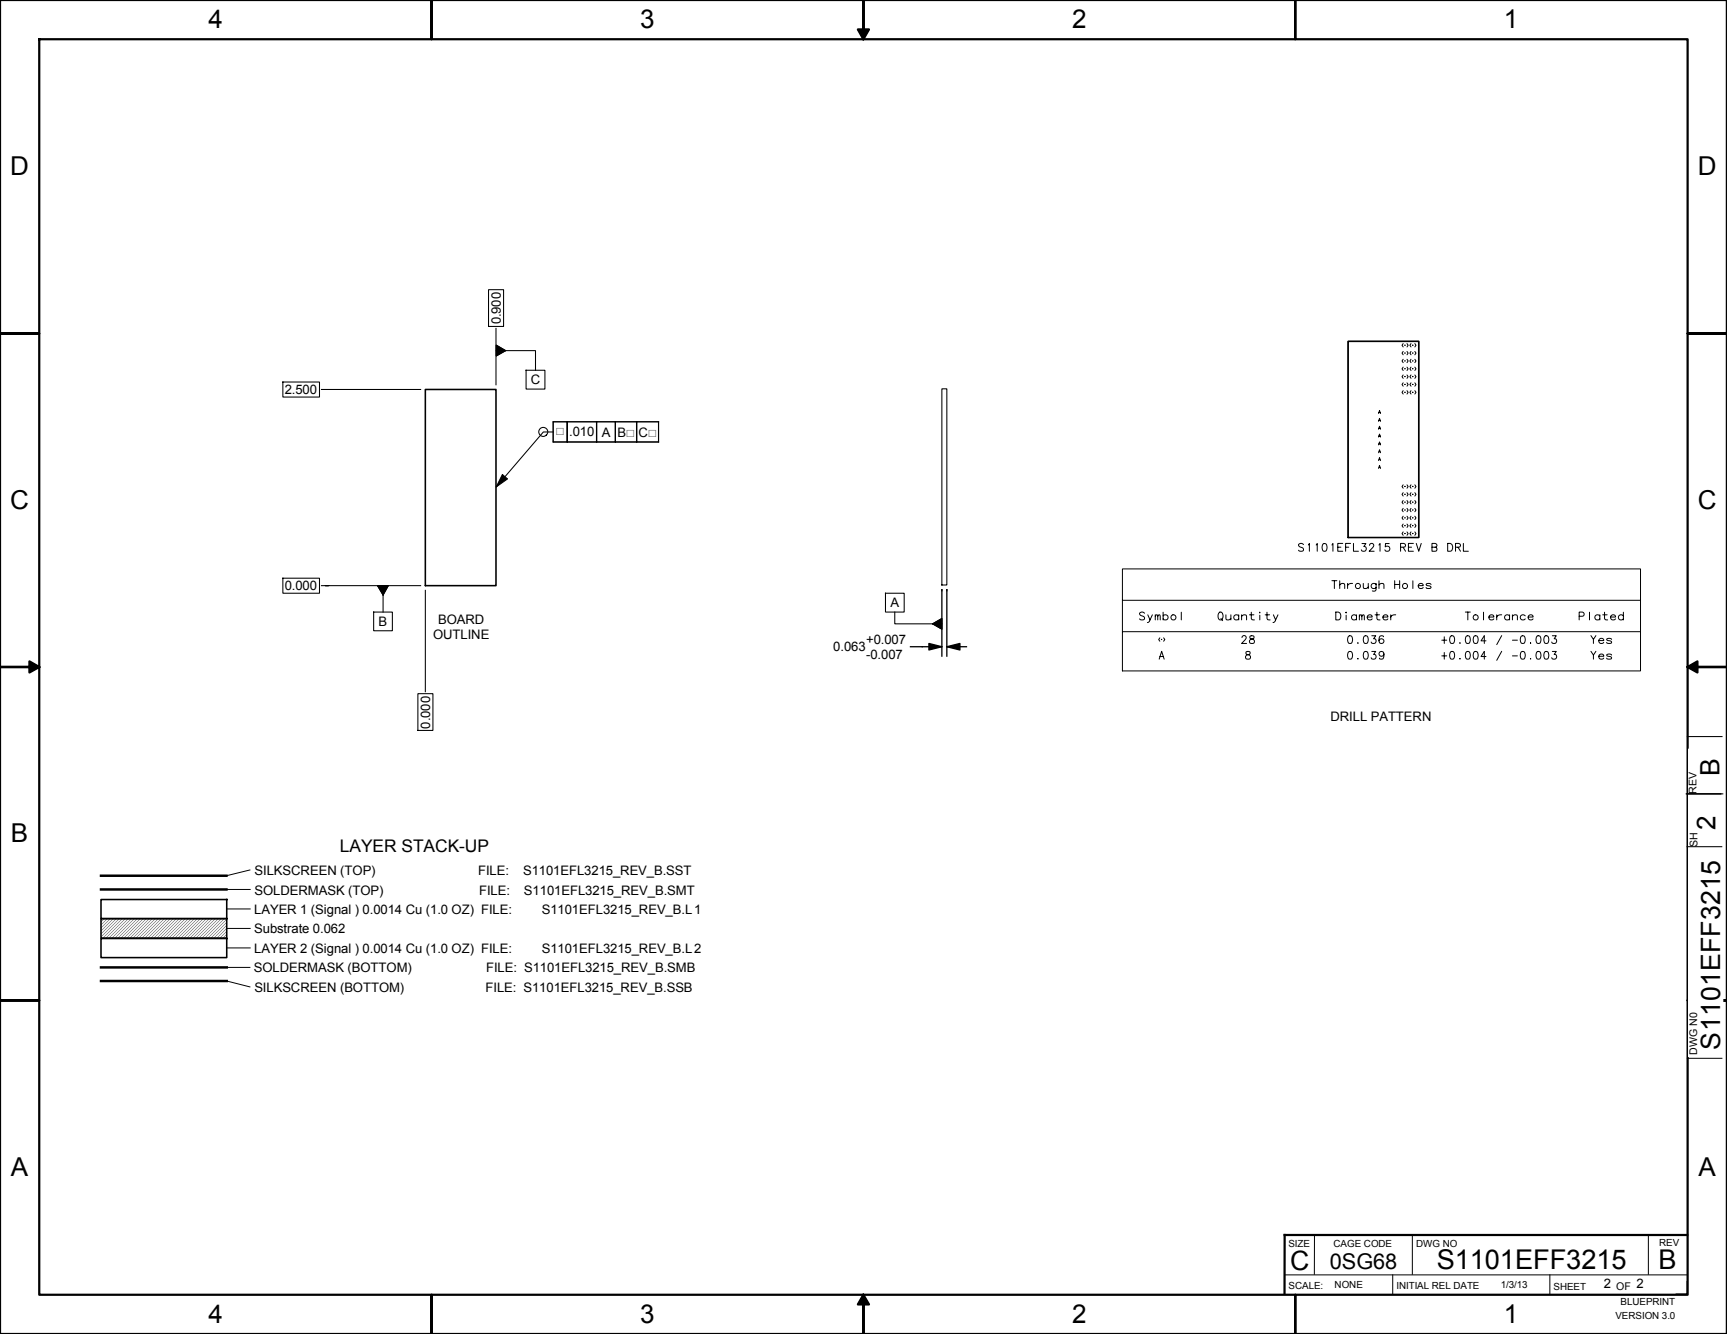
[picture p250: page 2]
BOARD OUTLINE; DRILL PATTERN; SILKSCREEN (TOP); FILE: S1101EFL3215_REV_B.SST; SOLDERMASK (TOP); FILE: S1101EFL3215_REV_B.SMT; LAYER 1 (Signal ) 0.0014 Cu (1.0 OZ) FILE:; S1101EFL3215_REV_B.L 1; Substrate 0.062; LAYER 2 (Signal ) 0.0014 Cu (1.0 OZ) FILE:; S1101EFL3215_REV_B.L 2; SOLDERMASK (BOTTOM); FILE: S1101EFL3215_REV_B.SMB; SILKSCREEN (BOTTOM); FILE: S1101EFL3215_REV_B.SSB; BLUEPRINT; SH REV; S1101EFF3215; DWG N0; VERSION 3.0

LAYER STACK-UP

SIZE C | CAGE CODE 0SG68 | DWG NO S1101EFF3215 | REV B

SCALE: NONE | INITIAL REL DATE 1/3/13 | 2 2 SHEET OF
