EmersonBJ/nasa-acme-burner-cad-cfd/PSI-Documents/Engineering Documents/Desenhos_Tecnicos_NASA/ACME_drawings_burners/EFA_Eletrica/S1101EFA1215_B.pdf

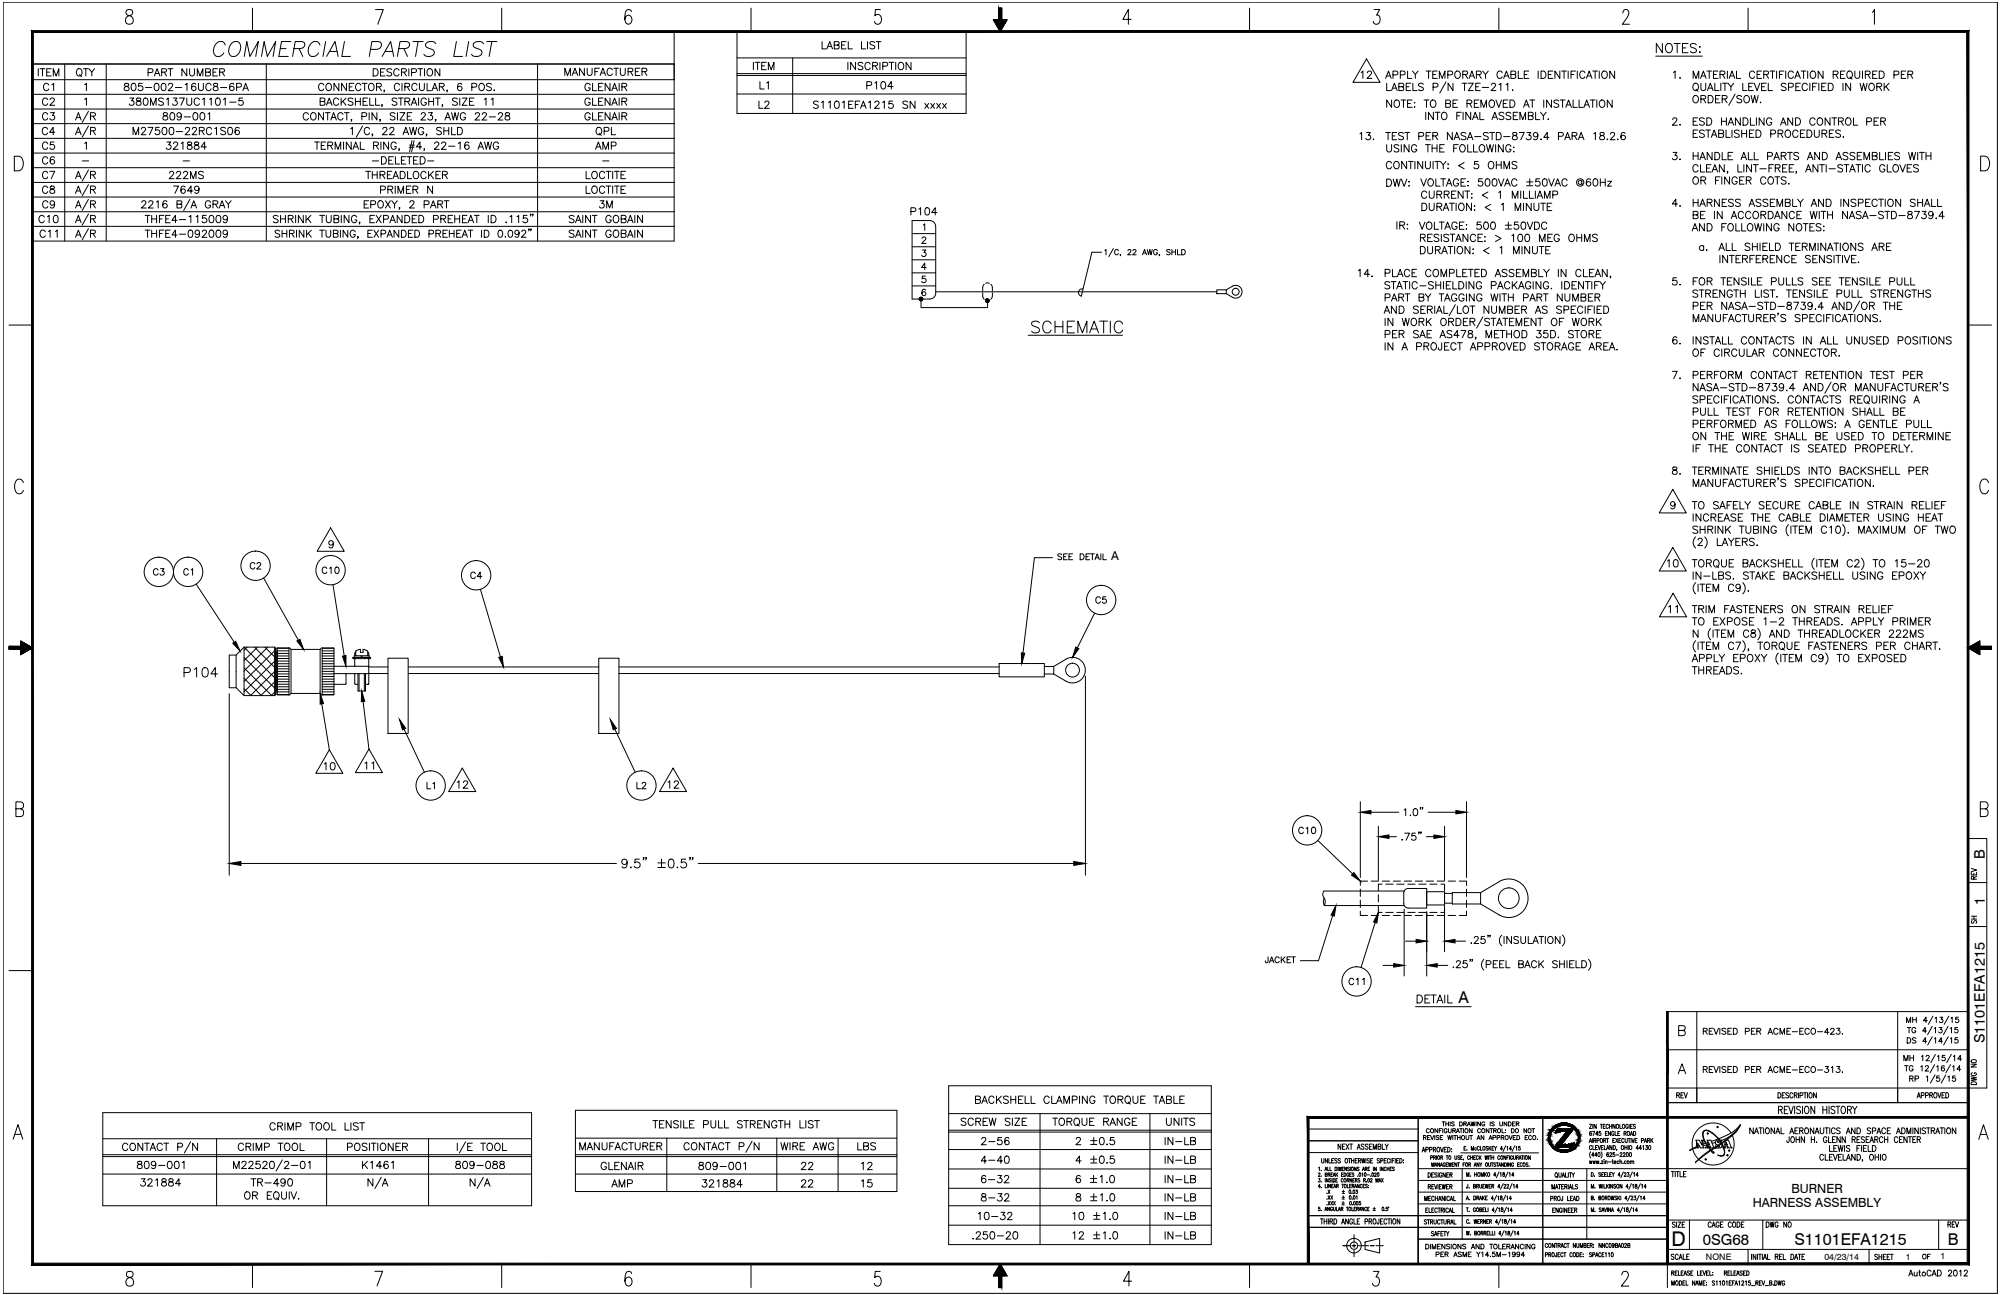
[picture p251: page 1]
0SG68 NONE; 1 S1101EFA1215; B HARNESS ASSEMBLY BURNER; S1101EFA1215 B 1 A A
