EmersonBJ/nasa-acme-burner-cad-cfd/PSI-Documents/Engineering Documents/Desenhos_Tecnicos_NASA/ACME_drawings_burners/EFA_Eletrica/S1101EFA1244_A.pdf

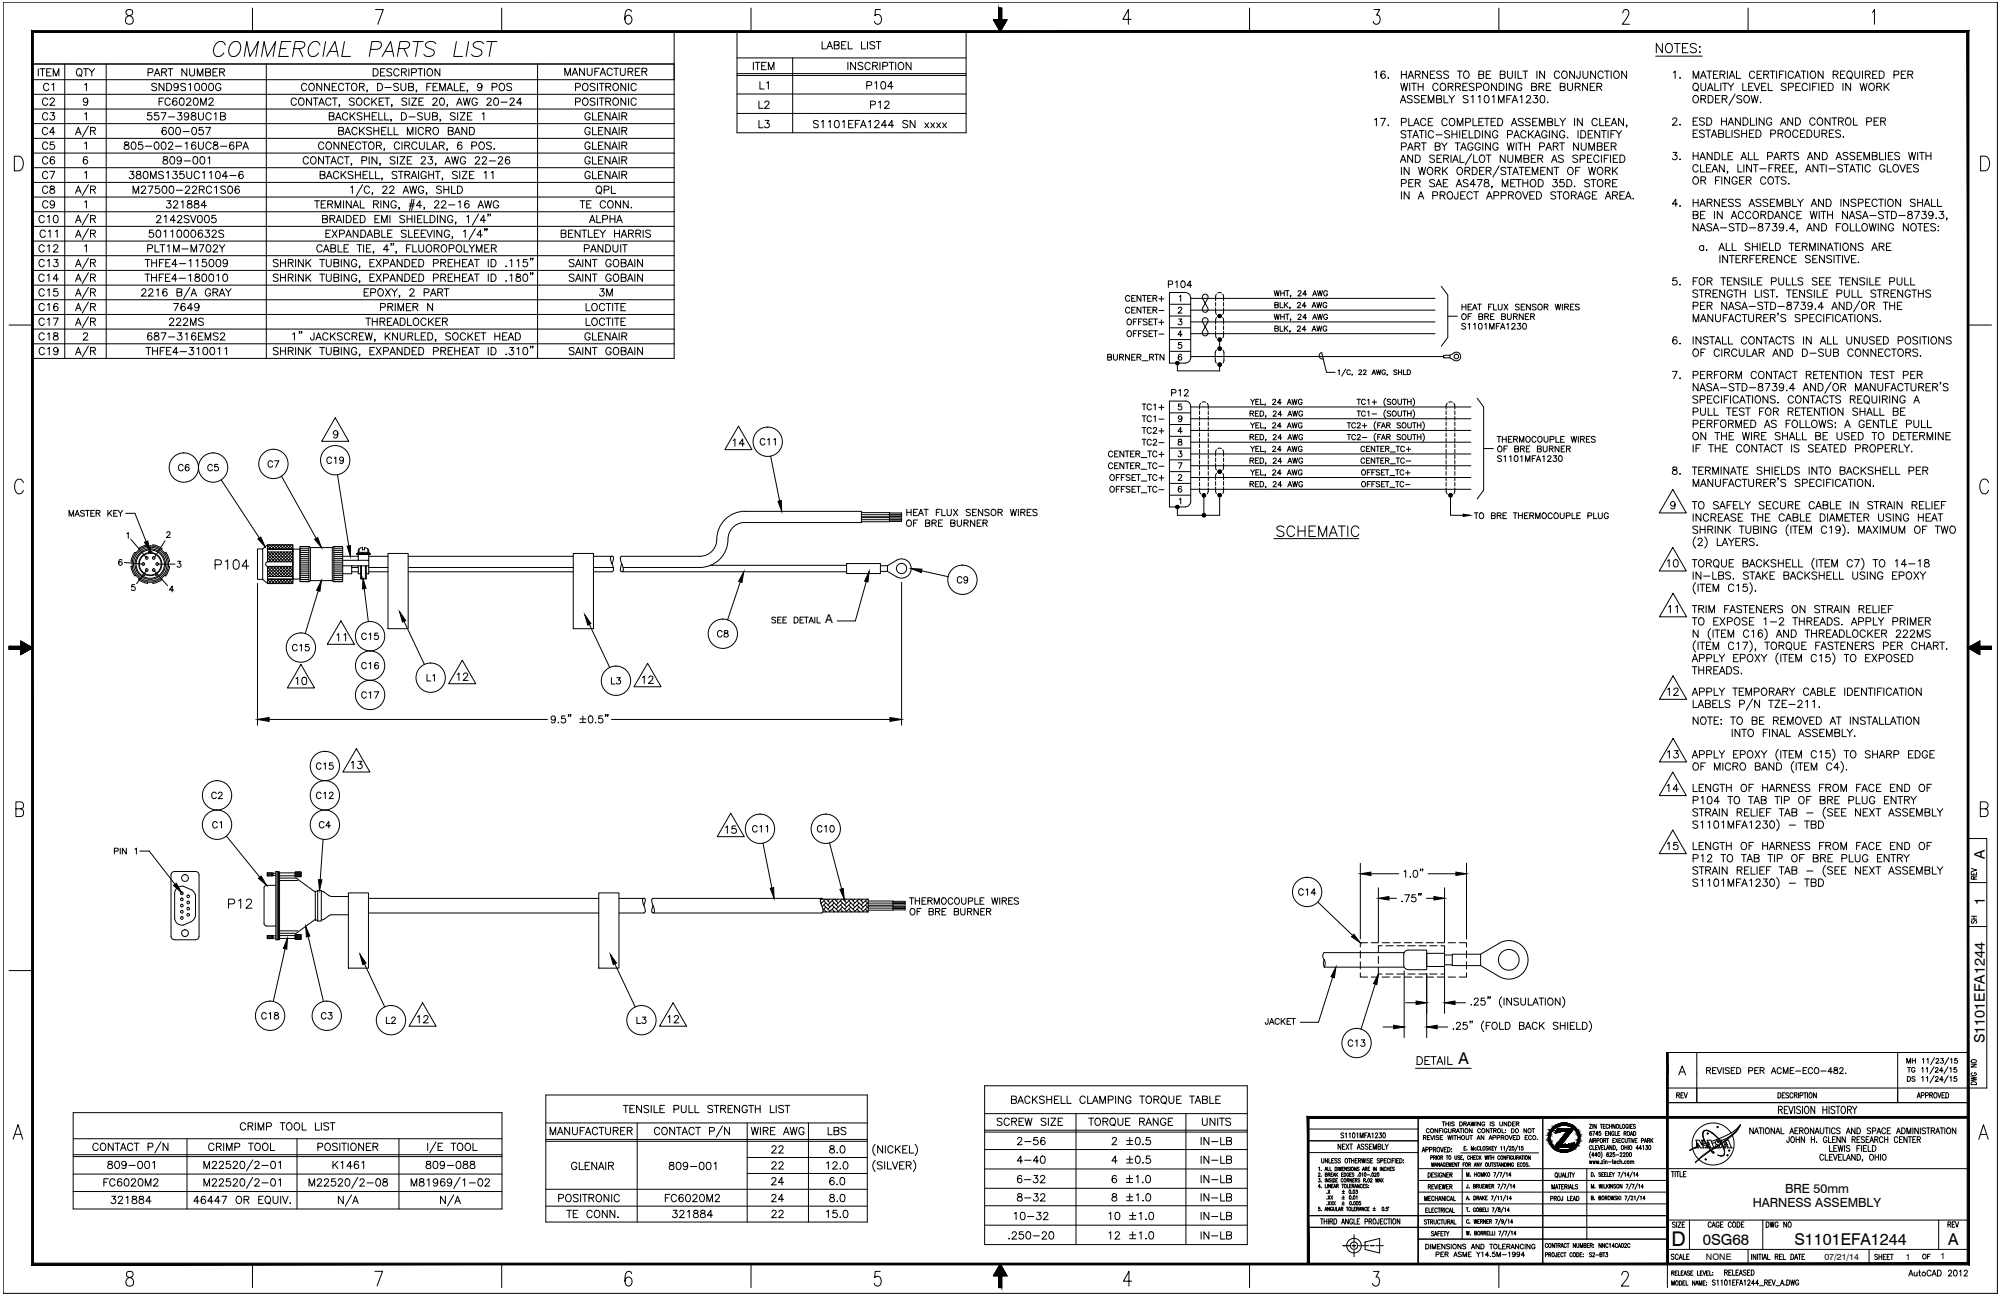
[picture p252: page 1]
0SG68 NONE; 1 S1101EFA1244; S1101EFA1244 A 1

A HARNESS ASSEMBLY BRE 50mm
