EmersonBJ/nasa-acme-burner-cad-cfd/PSI-Documents/Engineering Documents/Desenhos_Tecnicos_NASA/ACME_drawings_burners/EFA_Eletrica/S1101EFA1257_A.pdf

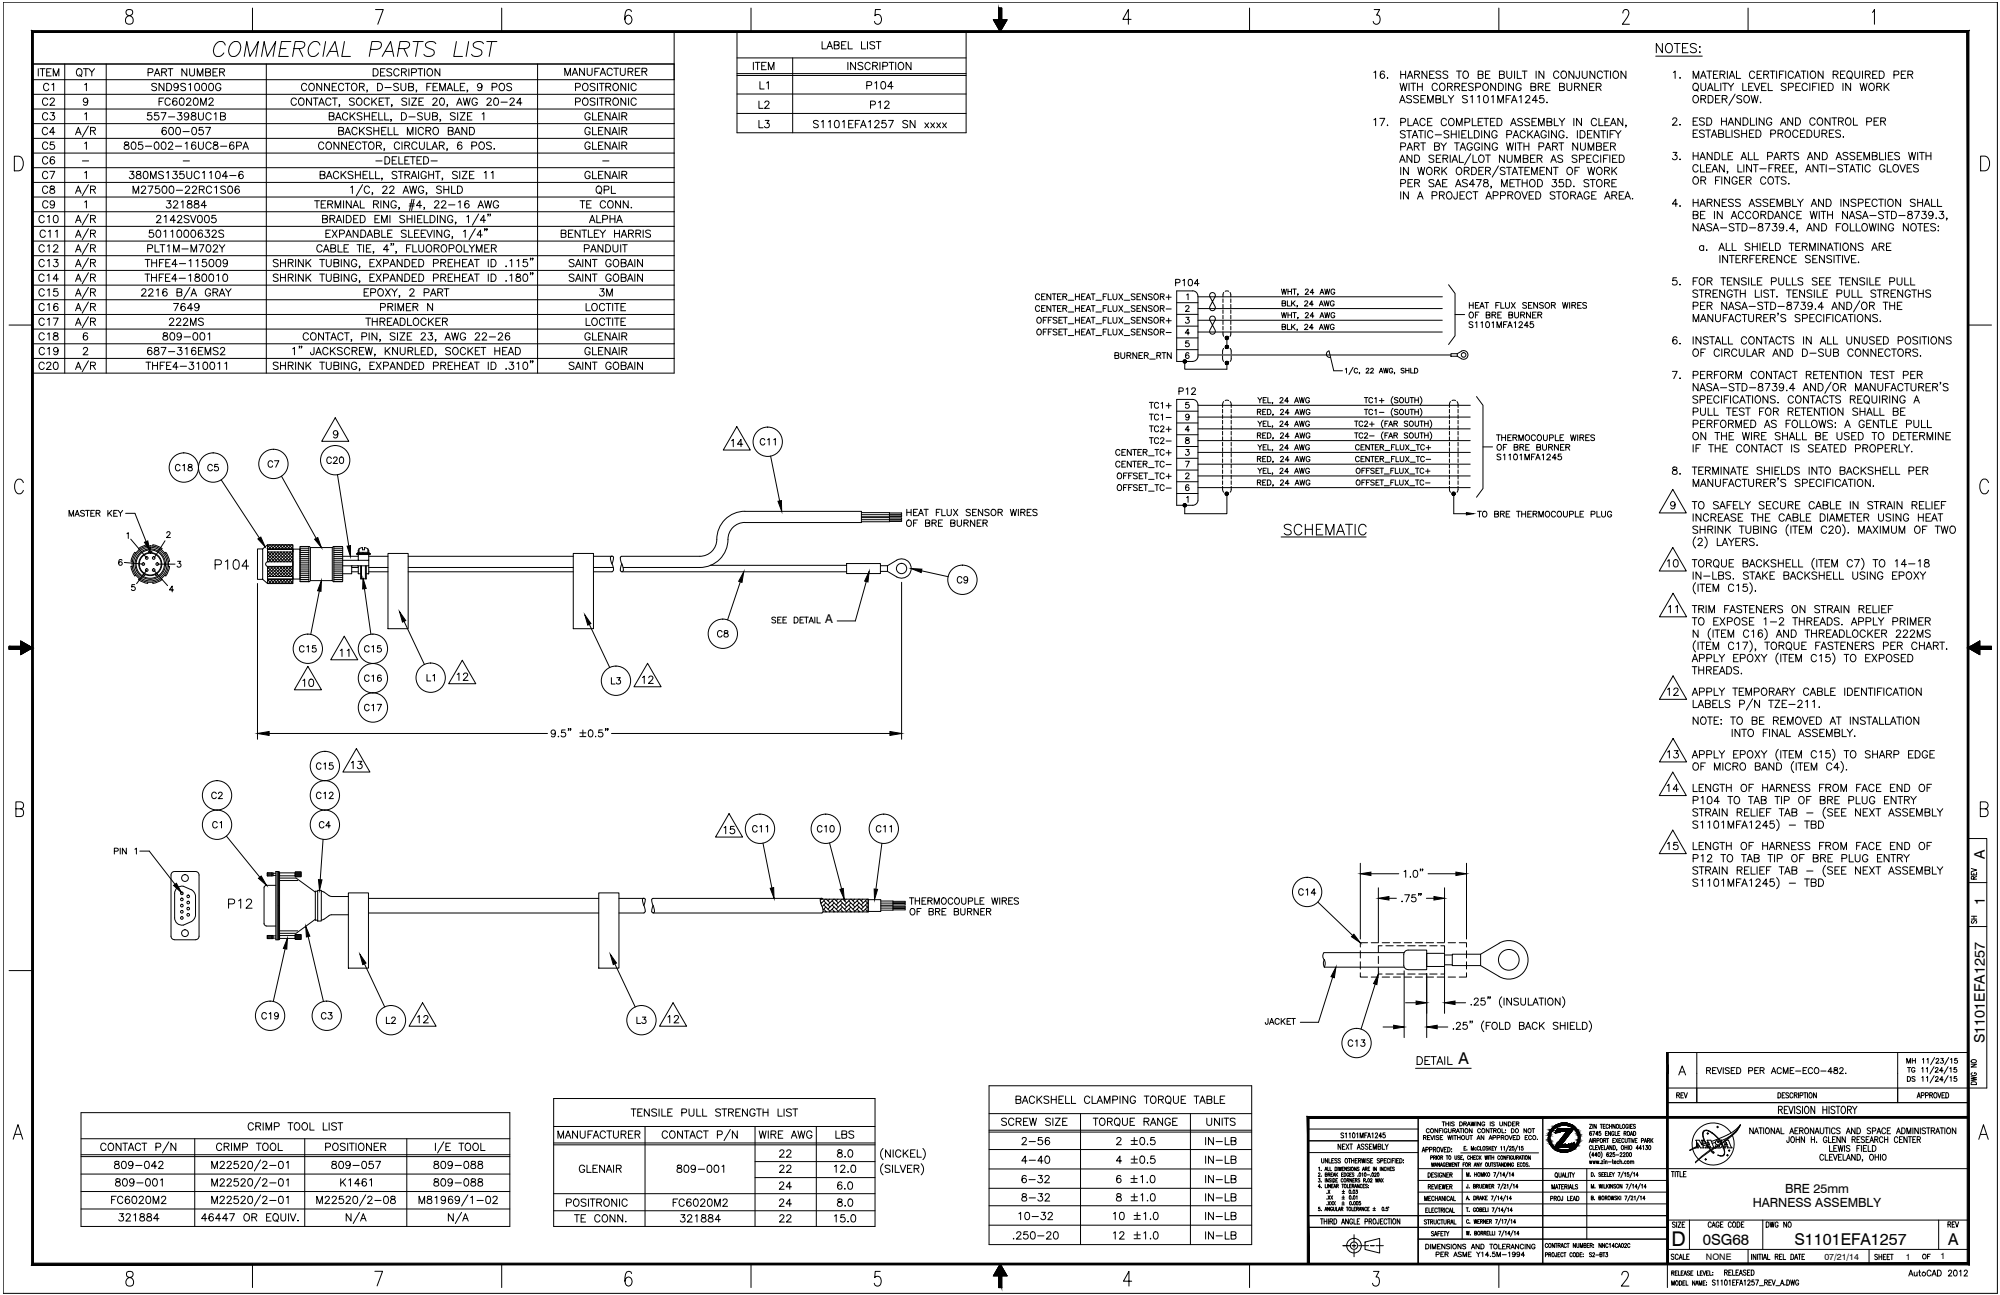
[picture p253: page 1]
0SG68 NONE; 1 S1101EFA1257; S1101EFA1257 A 1

A HARNESS ASSEMBLY BRE 25mm
