EmersonBJ/nasa-acme-burner-cad-cfd/PSI-Documents/Engineering Documents/Desenhos_Tecnicos_NASA/ACME_drawings_common_electrical/ACME_drawings_common_electrical/S1101EFS0313_C.pdf

8 | 7 | 6 | 5

D

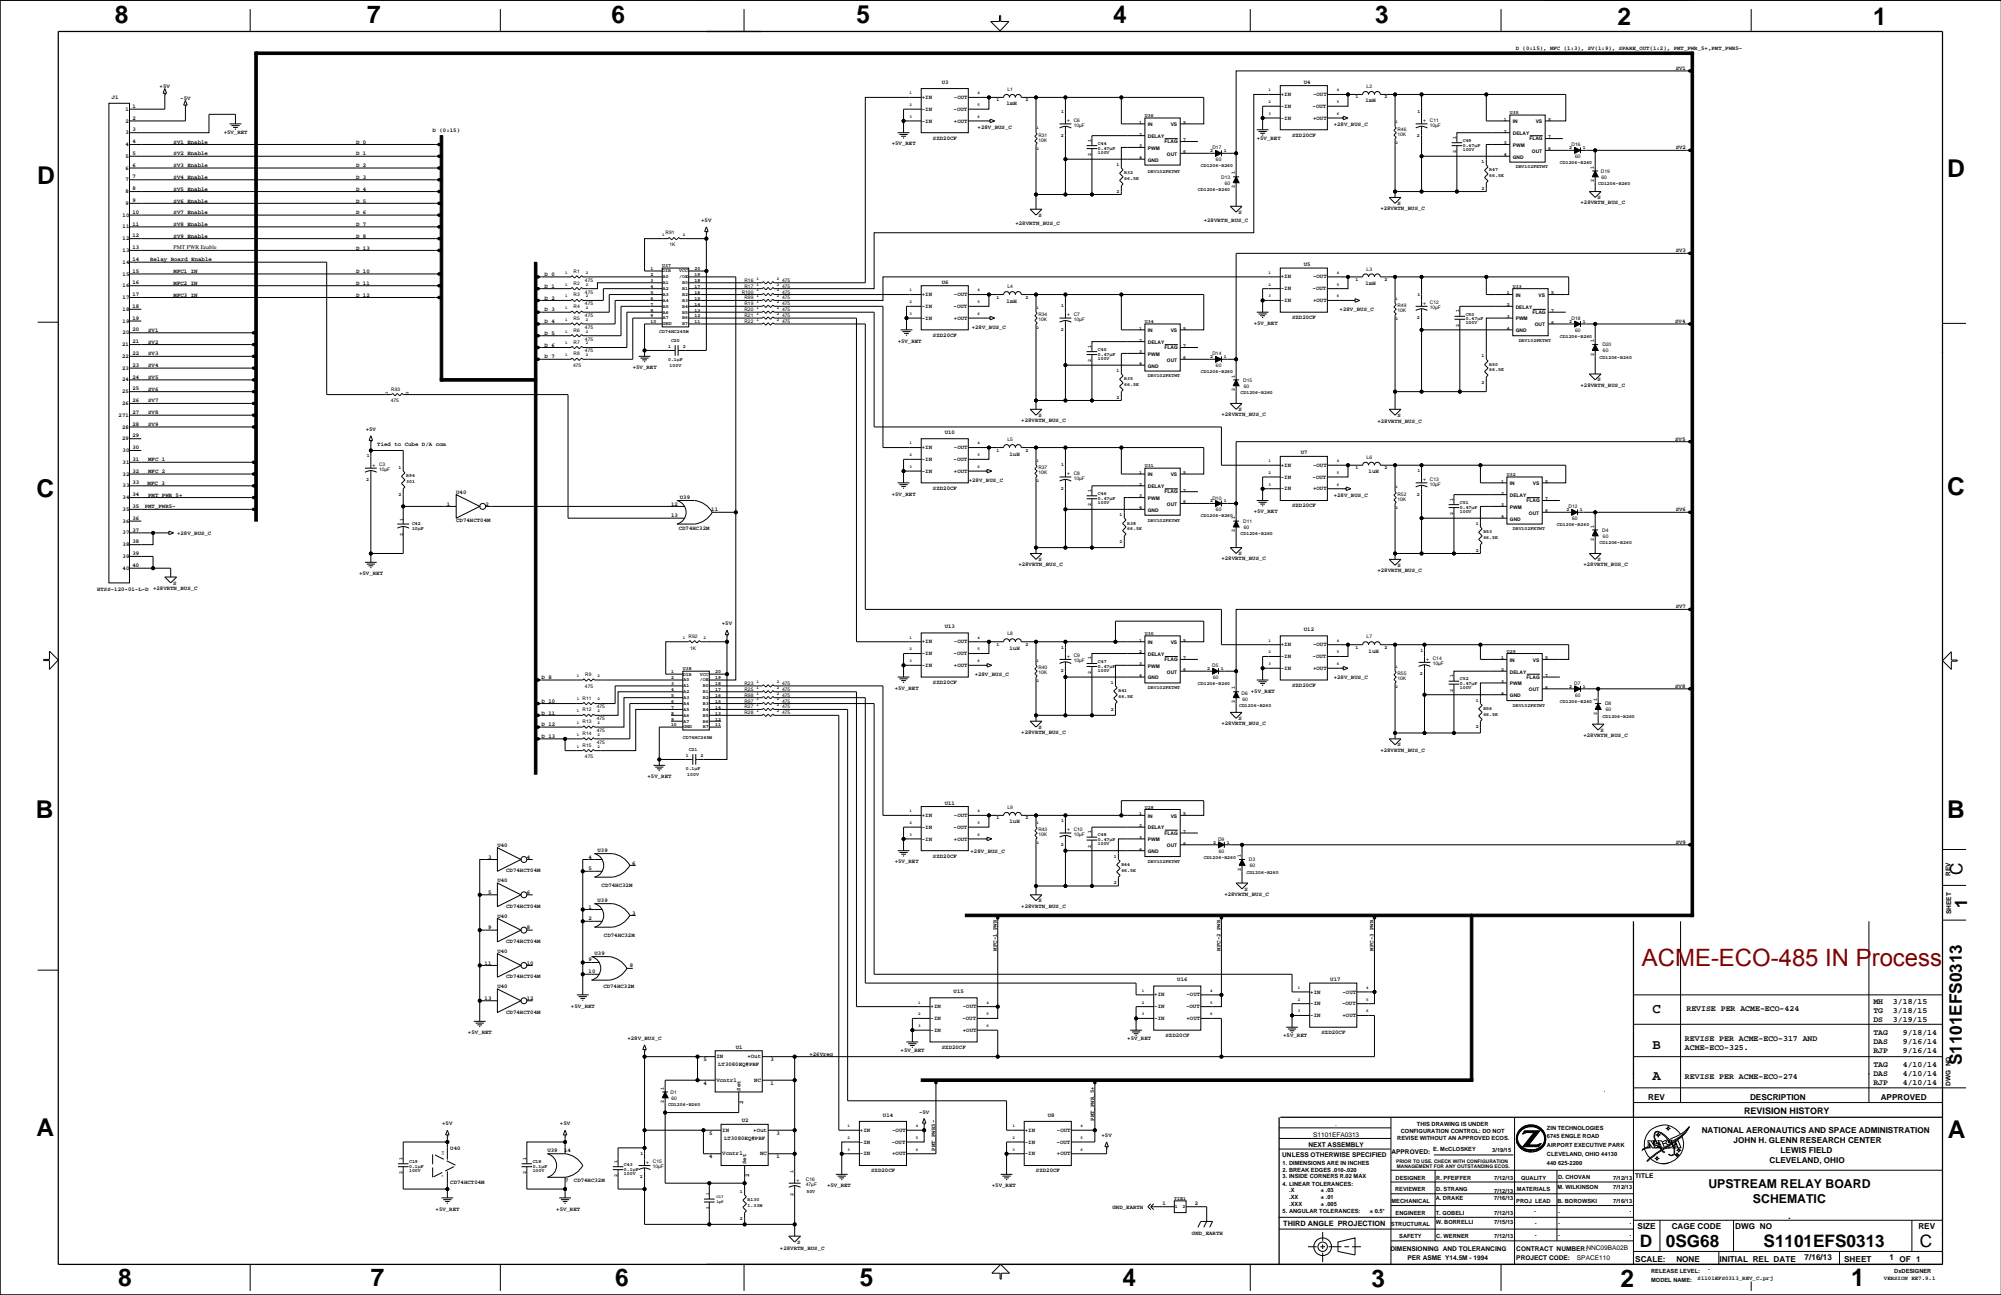
[picture p256: page 1]

Tied to Cube D/A com

DWG NO REV SHEET

ACME-ECO-485 IN Process

C | REVISE PER ACME-ECO-424 | MH 3/18/15 TG 3/18/15 DS 3/19/15

B ACME-ECO-325. | REVISE PER ACME-ECO-317 AND | TAG 9/18/14 DAS 9/16/14 RJP 9/16/14

A REVISE PER ACME-ECO-274 REV | DESCRIPTION | TAG 4/10/14 DAS 4/10/14 RJP 4/10/14 APPROVED

THIS DRAWING IS UNDER
CONFIGURATION CONTROL: DO NOT
REVISE WITHOUT AN APPROVED ECOS.
APPROVED:

NATIONAL AERONAUTICS AND SPACE ADMINISTRATION

JOHN H. GLENN RESEARCH CENTER

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

PRIOR TO USE. CHECK WITH CONFIGURATION
MANAGEMENT FOR ANY OUTSTANDING ECOS.

DESIGNER | R. PFEIFFER 7/12/13 D. STRANG | QUALITY | D. CHOVAN 7/12/13 | TITLE UPSTREAM RELAY BOARD SCHEMATIC .
REVIEWER | 7/12/13 | MATERIALS | M. WILKINSON 7/12/13
MECHANICAL | A. DRAKE 7/16/13 | PROJ LEAD | B. BOROWSKI 7/16/13
ENGINEER | T. GOBELI 7/12/13 | . | . .

THIRD ANGLE PROJECTION | STRUCTURAL | W. BORRELLI 7/15/13 | . | . .

SIZE D | CAGE CODE 0SG68 | DWG NO S1101EFS0313 | REV C

SAFETY | C. WERNER 7/12/13 | . | . .
DIMENSIONING AND TOLERANCING PER ASME Y14.5M - 1994 | | NNC09BA02B CONTRACT NUMBER: PROJECT CODE: SPACE110

SCALE: NONE | 7/16/13 INITIAL REL DATE | 1 1 SHEET OF
