EmersonBJ/nasa-acme-burner-cad-cfd/PSI-Documents/Engineering Documents/Desenhos_Tecnicos_NASA/ACME_drawings_common_electrical/ACME_drawings_common_electrical/s1101mfa0316_B.pdf

D

1

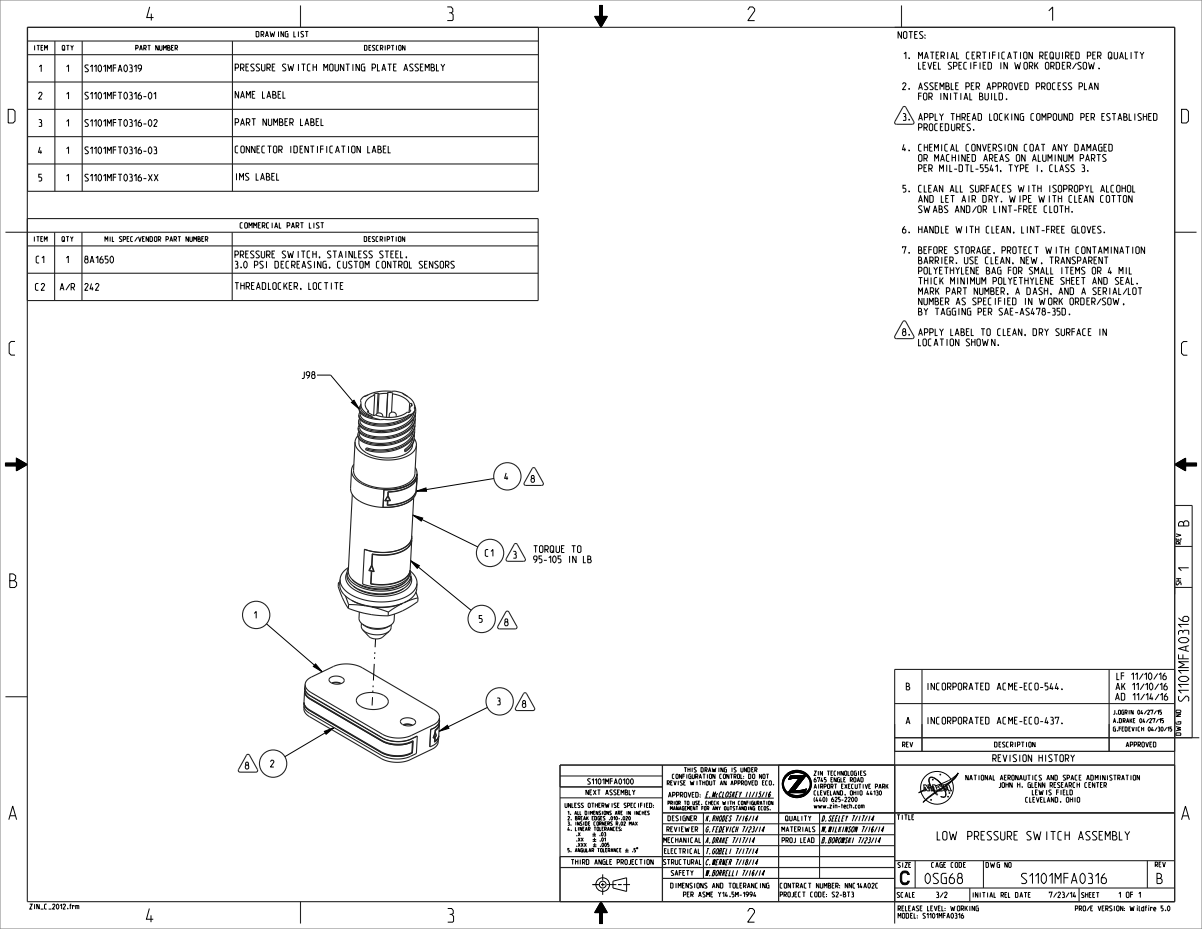
[picture p257: page 1]
SCALE; INITIAL REL DATE; SHEET; TITLE; UNLESS OTHERWISE; SPECIFIED:; 1. ALL DIMENSIONS ARE; INCHES; 2. BREAK; EDGES .010-.020; LINEAR; TOLERANCES:; 5. ANGULAR; TOLERANCE #-; REVISION; HISTORY; STRUCTURAL; ELECTRICAL; MECHANICAL; MATERIALS; PROJ; LEAD; MODEL: S1101MFA0316; ZIN_C_2012.frm; JOHN; H. GLENN RESEARCH CENTER; LEWIS FIELD; ENGLE ROAD; AIRPORT; EXECUTIVE PARK; RELEASE; LEVEL: WORKING; PRO/E VERSION: Wildfire 5.0; S1101MFA0316; S1101MFA0100; LEVEL SPECIFIED; IN WORK ORDER/SOW.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

NOTES:
MATERIAL CERTIFICATION REQUIRED PER QUALITY
ASSEMBLE PER APPROVED PROCESS PLAN
FOR INITIAL BUILD.
APPLY THREAD LOCKING COMPOUND PER ESTABLISHED
PROCEDURES.
CHEMICAL CONVERSION COAT ANY DAMAGED
OR MACHINED AREAS ON ALUMINUM PARTS
SWABS AND/OR LINT-FREE CLOTH.
THICK MINIMUM POLYETHYLENE SHEET AND SEAL.
MARK PART NUMBER, A DASH, AND A SERIAL/LOT
BY TAGGING PER SAE-AS478-35D.
LOCATION SHOWN.

2 | 1 | S1101MFT0316-01 | NAME LABEL
3 | 1 | S1101MFT0316-02 | PART NUMBER LABEL
4 | 1 | S1101MFT0316-03 | CONNECTOR IDENTIFICATION LABEL
5 | 1 | S1101MFT0316-XX | IMS LABEL

COMMERCIAL PART LIST

C1 | 1 | 8A1650 | PRESSURE SWITCH, STAINLESS STEEL, 3.0 PSI DECREASING, CUSTOM CONTROL SENSORS

C2 | A/R | 242 | | THREADLOCKER, LOCTITE

1 DWG NO REV

B | INCORPORATED ACME-ECO-544. | | | LF 11/10/16 AK 11/10/16 AD 11/14/16

A REV | INCORPORATED ACME-ECO-437. DESCRIPTION | J.OGRIN 04/27/15 G.FEDEVICH 04/30/15 | APPROVED

THIS DRAWING IS UNDER

CONFIGURATION CONTROL: DO NOT REVISE WITHOUT AN APPROVED ECO. APPROVED: E.McCLOSKEY 11/15/16 | ZIN TECHNOLOGIES CLEVELAND, OHIO 44130 (440) 625-2200 www.zin-tech.com | | | NATIONAL AERONAUTICS AND SPACE ADMINISTRATION CLEVELAND, OHIO

NEXT ASSEMBLY

PRIOR TO USE, CHECK WITH CONFIGURATION
MANAGEMENT FOR ANY OUTSTANDING ECOS.

DESIGNER | | K.RHODES 7/16/14 | QUALITY | | D.SEELEY 7/17/14
REVIEWER | | G.FEDEVICH 7/23/14 | | | | | M.WILKINSON 7/16/14
A.DRAKE 7/17/14 | | | B.BOROWSKI 7/23/14
T.GOBELI 7/17/14

3. INSIDE CORNERS R.02 MAX | .XX #-.XXX #-

THIRD ANGLE PROJECTION | | | | | | | | C.WERNER 7/18/14

SIZE C | CAGE CODE 0SG68 | DWG NO | REV B

SAFETY | | W.BORRELLI 7/16/14
DIMENSIONS AND TOLERANCING PER ASME Y14.5M-1994 | CONTRACT NUMBER: NNC14A02C PROJECT CODE: S2-BT3 | | | S1101MFA0316
