EmersonBJ/nasa-acme-burner-cad-cfd/PSI-Documents/Engineering Documents/Desenhos_Tecnicos_NASA/ACME_drawings_data_camera/ACME_drawings_data_camera/S1101EFA2129_A.pdf

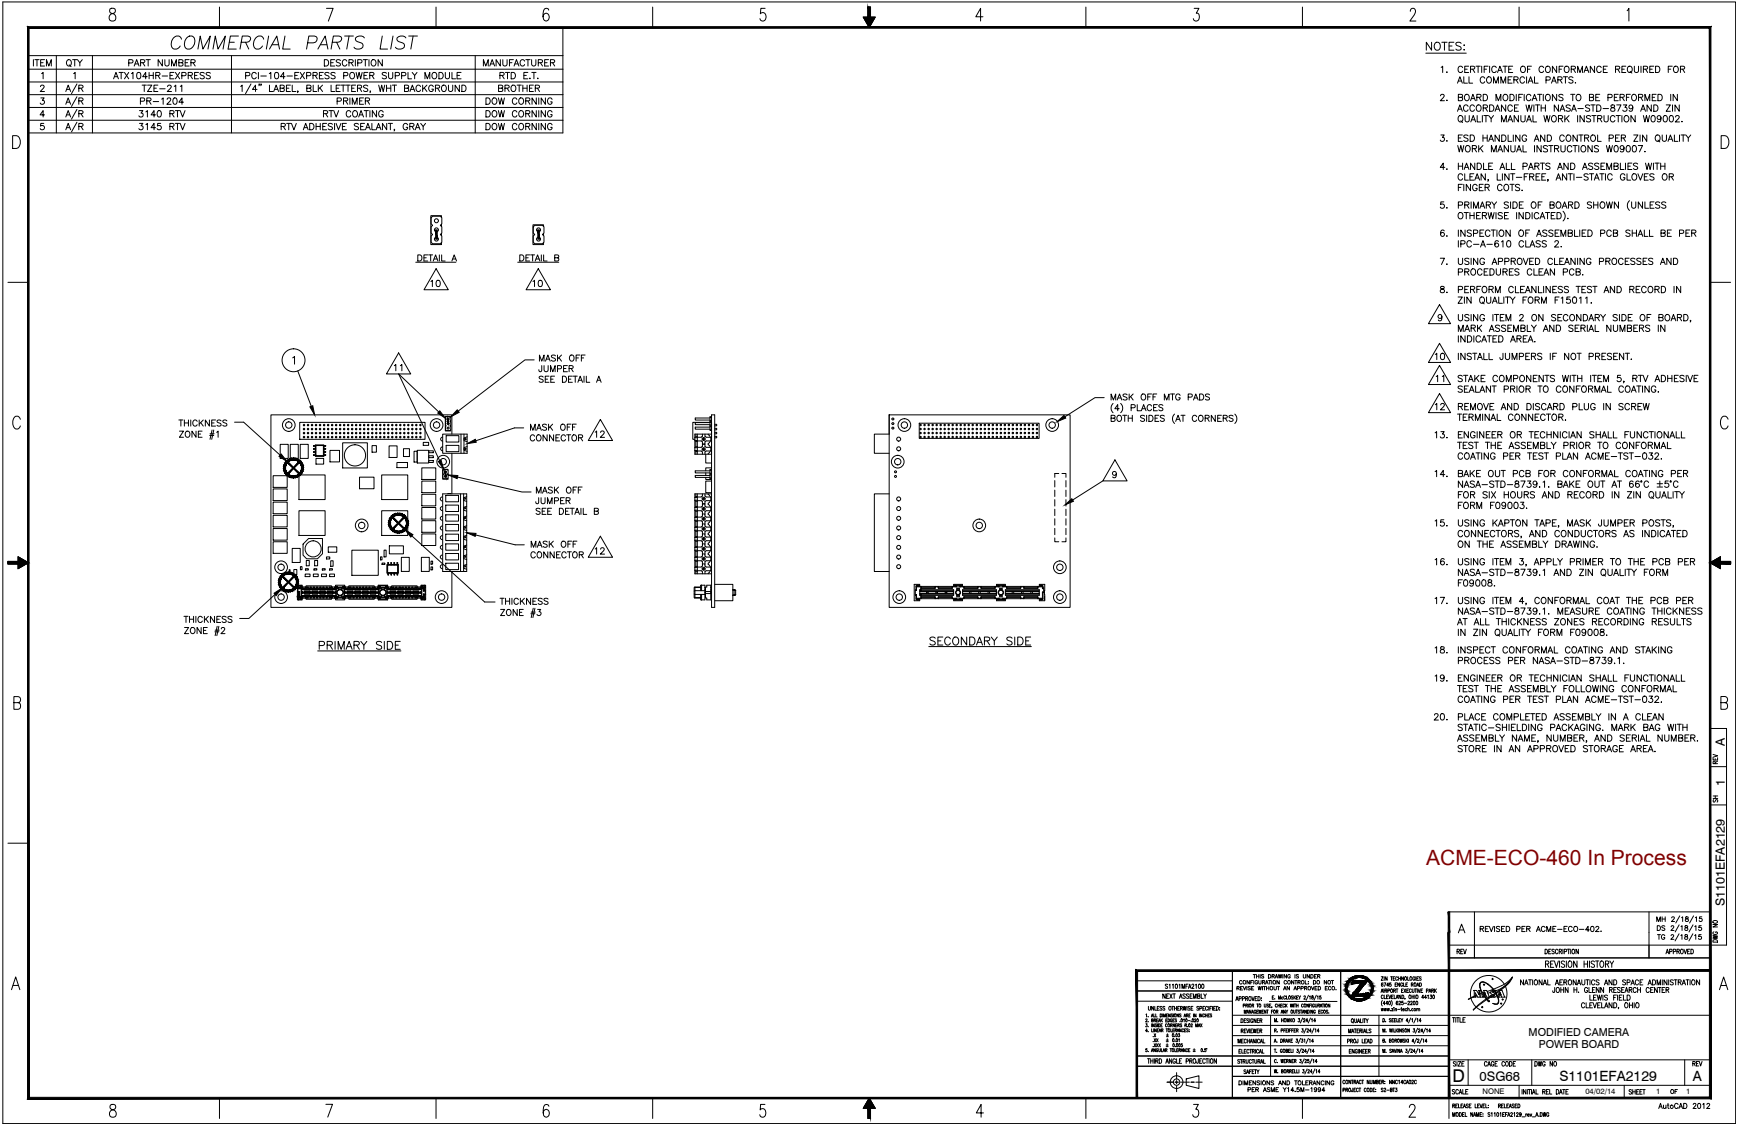
[picture p258: page 1]
0SG68 NONE; 1 S1101EFA2129; A POWER BOARD MODIFIED CAMERA; S1101EFA2129 A1

ACME-ECO-460 In Process
