EmersonBJ/nasa-acme-burner-cad-cfd/PSI-Documents/Engineering Documents/Desenhos_Tecnicos_NASA/ACME_drawings_data_camera/ACME_drawings_data_camera/S1101EFA2130_A.pdf

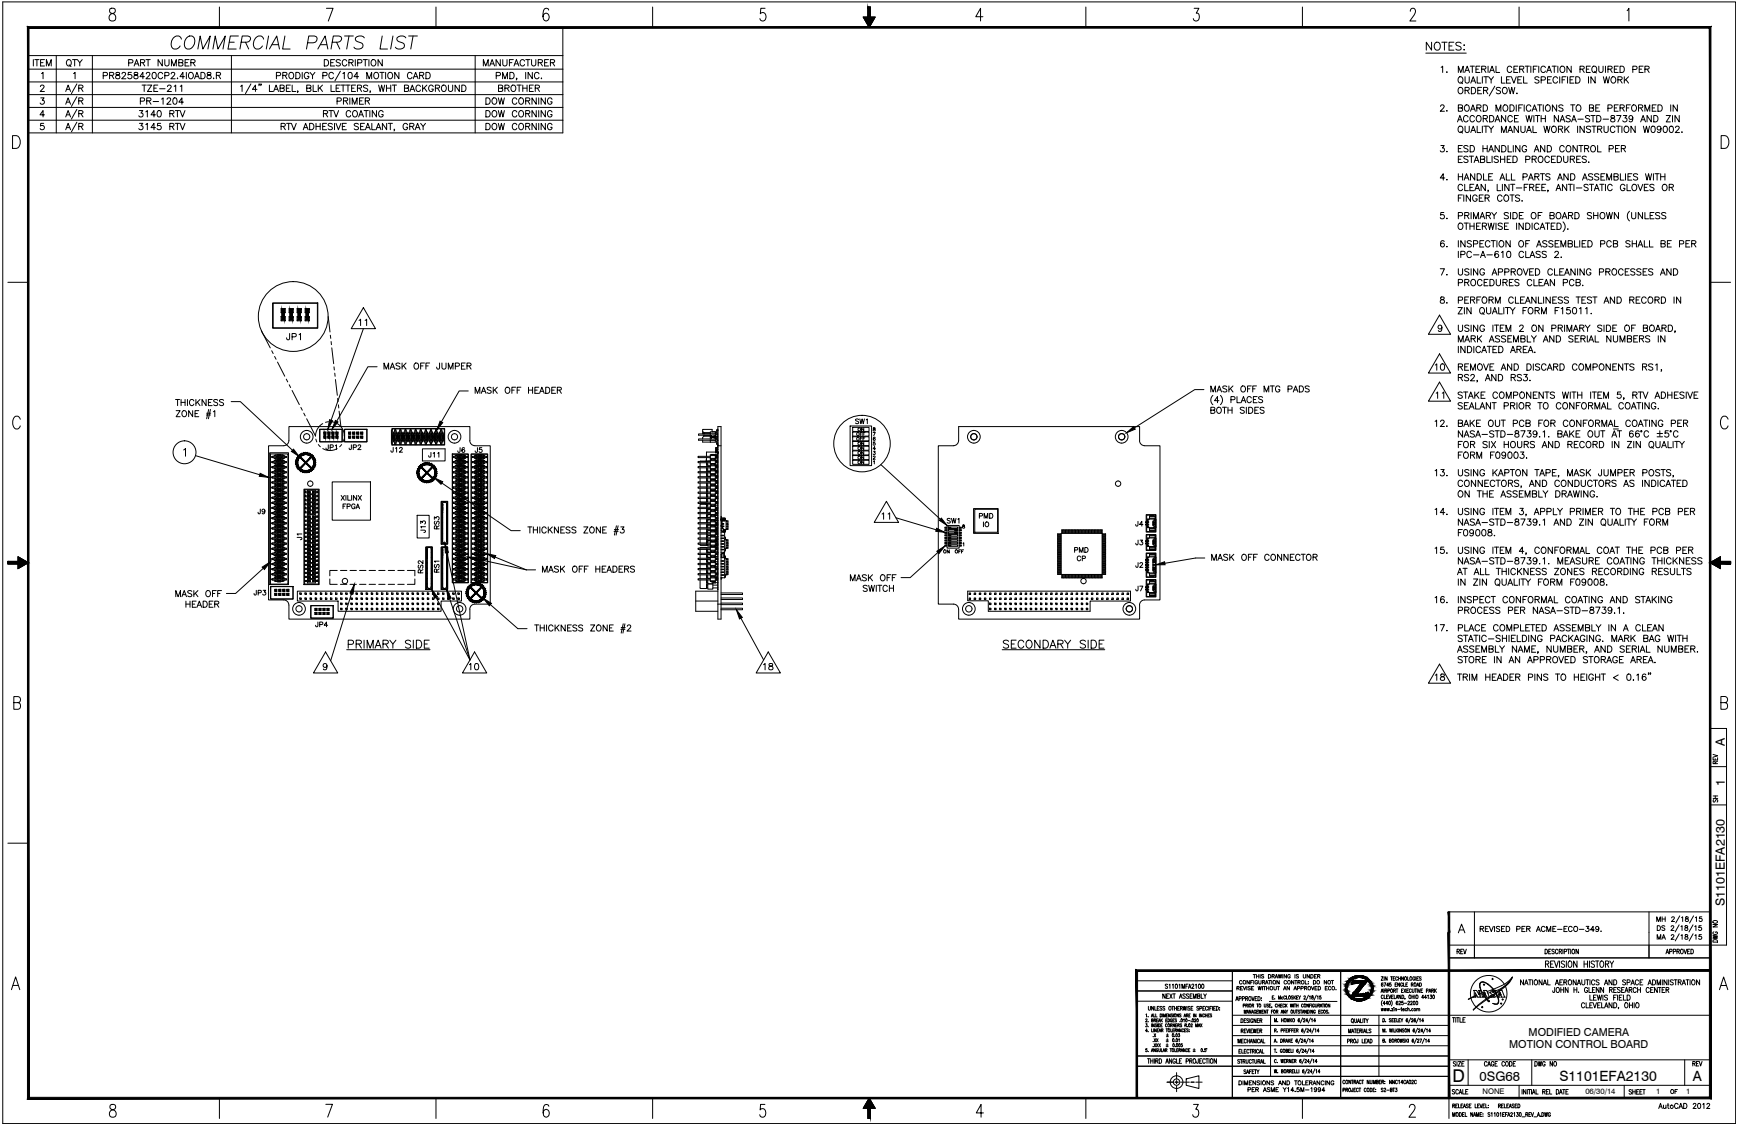
[picture p259: page 1]
D 0SG68 NONE; 1 S1101EFA2130; A MOTION CONTROL BOARD MODIFIED CAMERA; S1101EFA2130 A 1
