EmersonBJ/nasa-acme-burner-cad-cfd/PSI-Documents/Engineering Documents/Desenhos_Tecnicos_NASA/ACME_drawings_data_camera/ACME_drawings_data_camera/S1101EFC2006_-.pdf

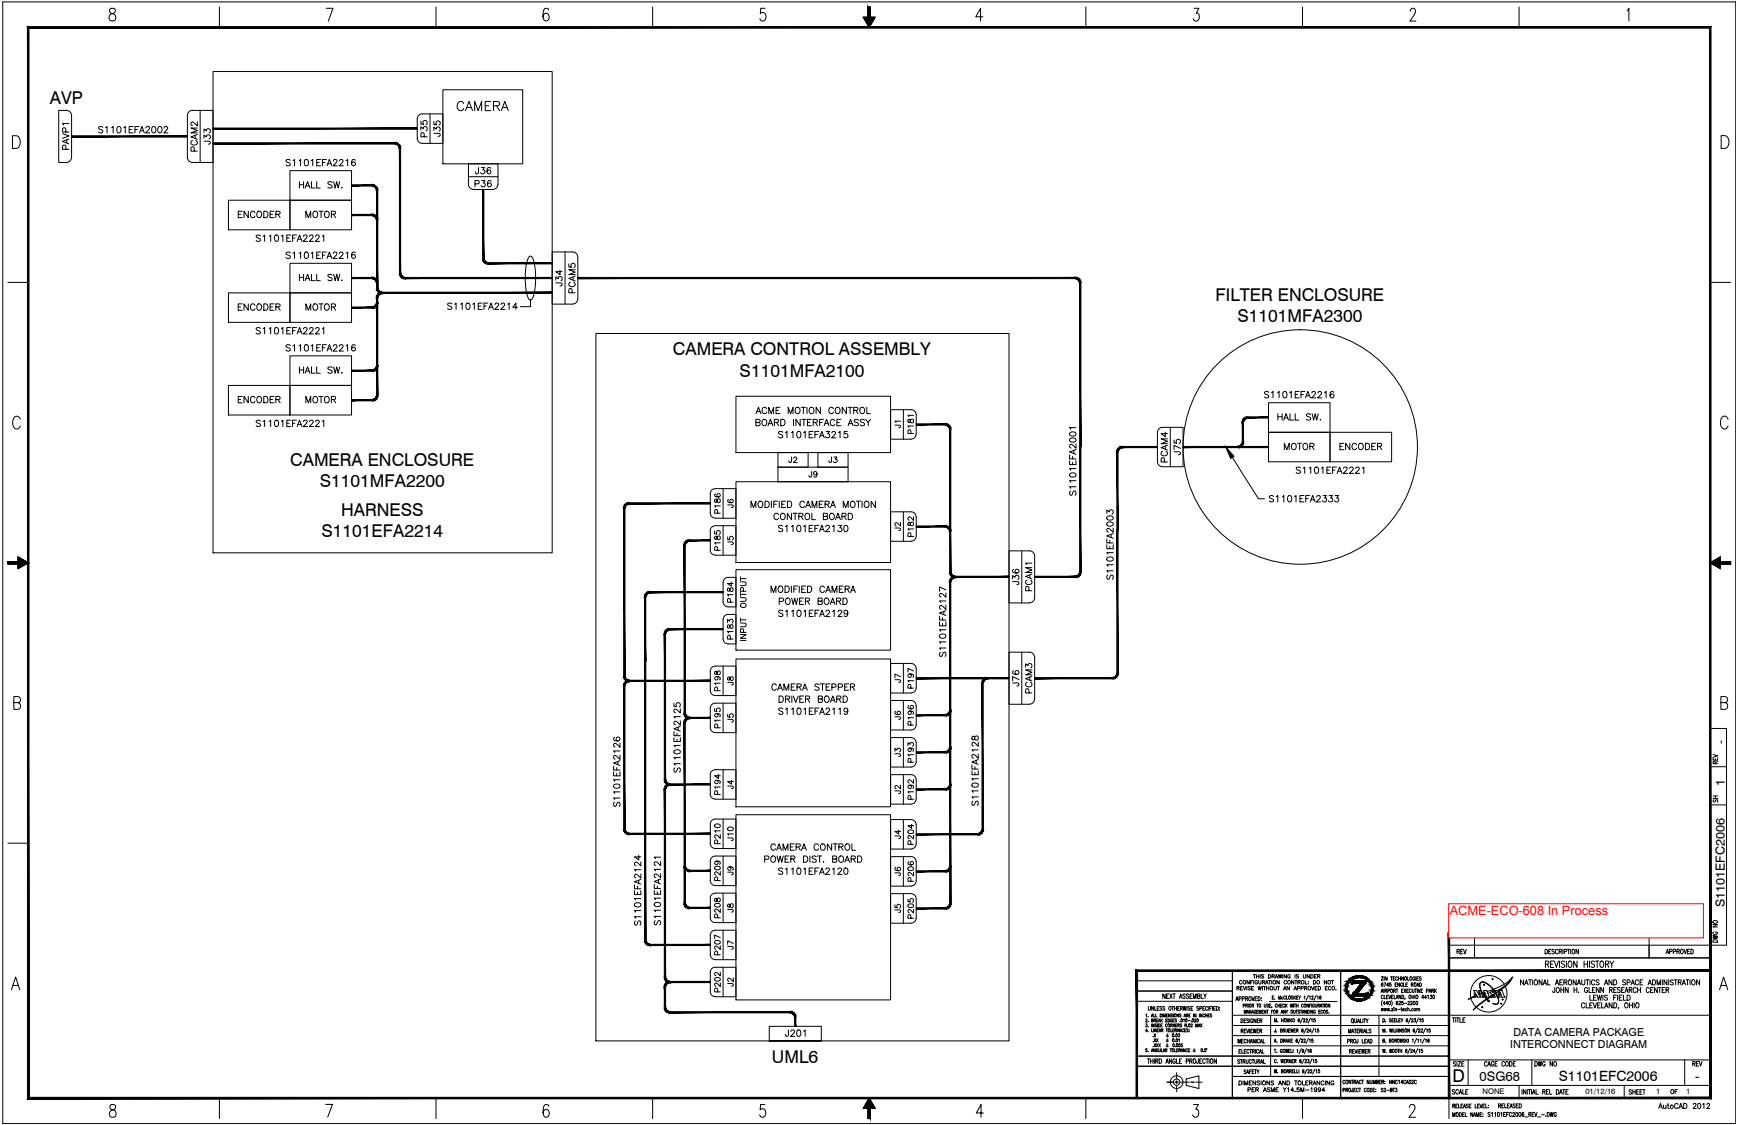
[picture p260: page 1]
0SG68 NONE; 1 S1101EFC2006; - INTERCONNECT DIAGRAM DATA CAMERA PACKAGE

S1101EFC2006 - 1 AVP CAMERA ENCLOSURE S1101MFA2200 FILTER ENCLOSURE S1101MFA2300 CAMERA CONTROL ASSEMBLY S1101MFA2100 UML6 HARNESS S1101EFA2214
