EmersonBJ/nasa-acme-burner-cad-cfd/PSI-Documents/Engineering Documents/Desenhos_Tecnicos_NASA/ACME_drawings_diagnostic_system/ACME_drawings_diagnostic_system/S1101EFA1527_D.pdf

4

3

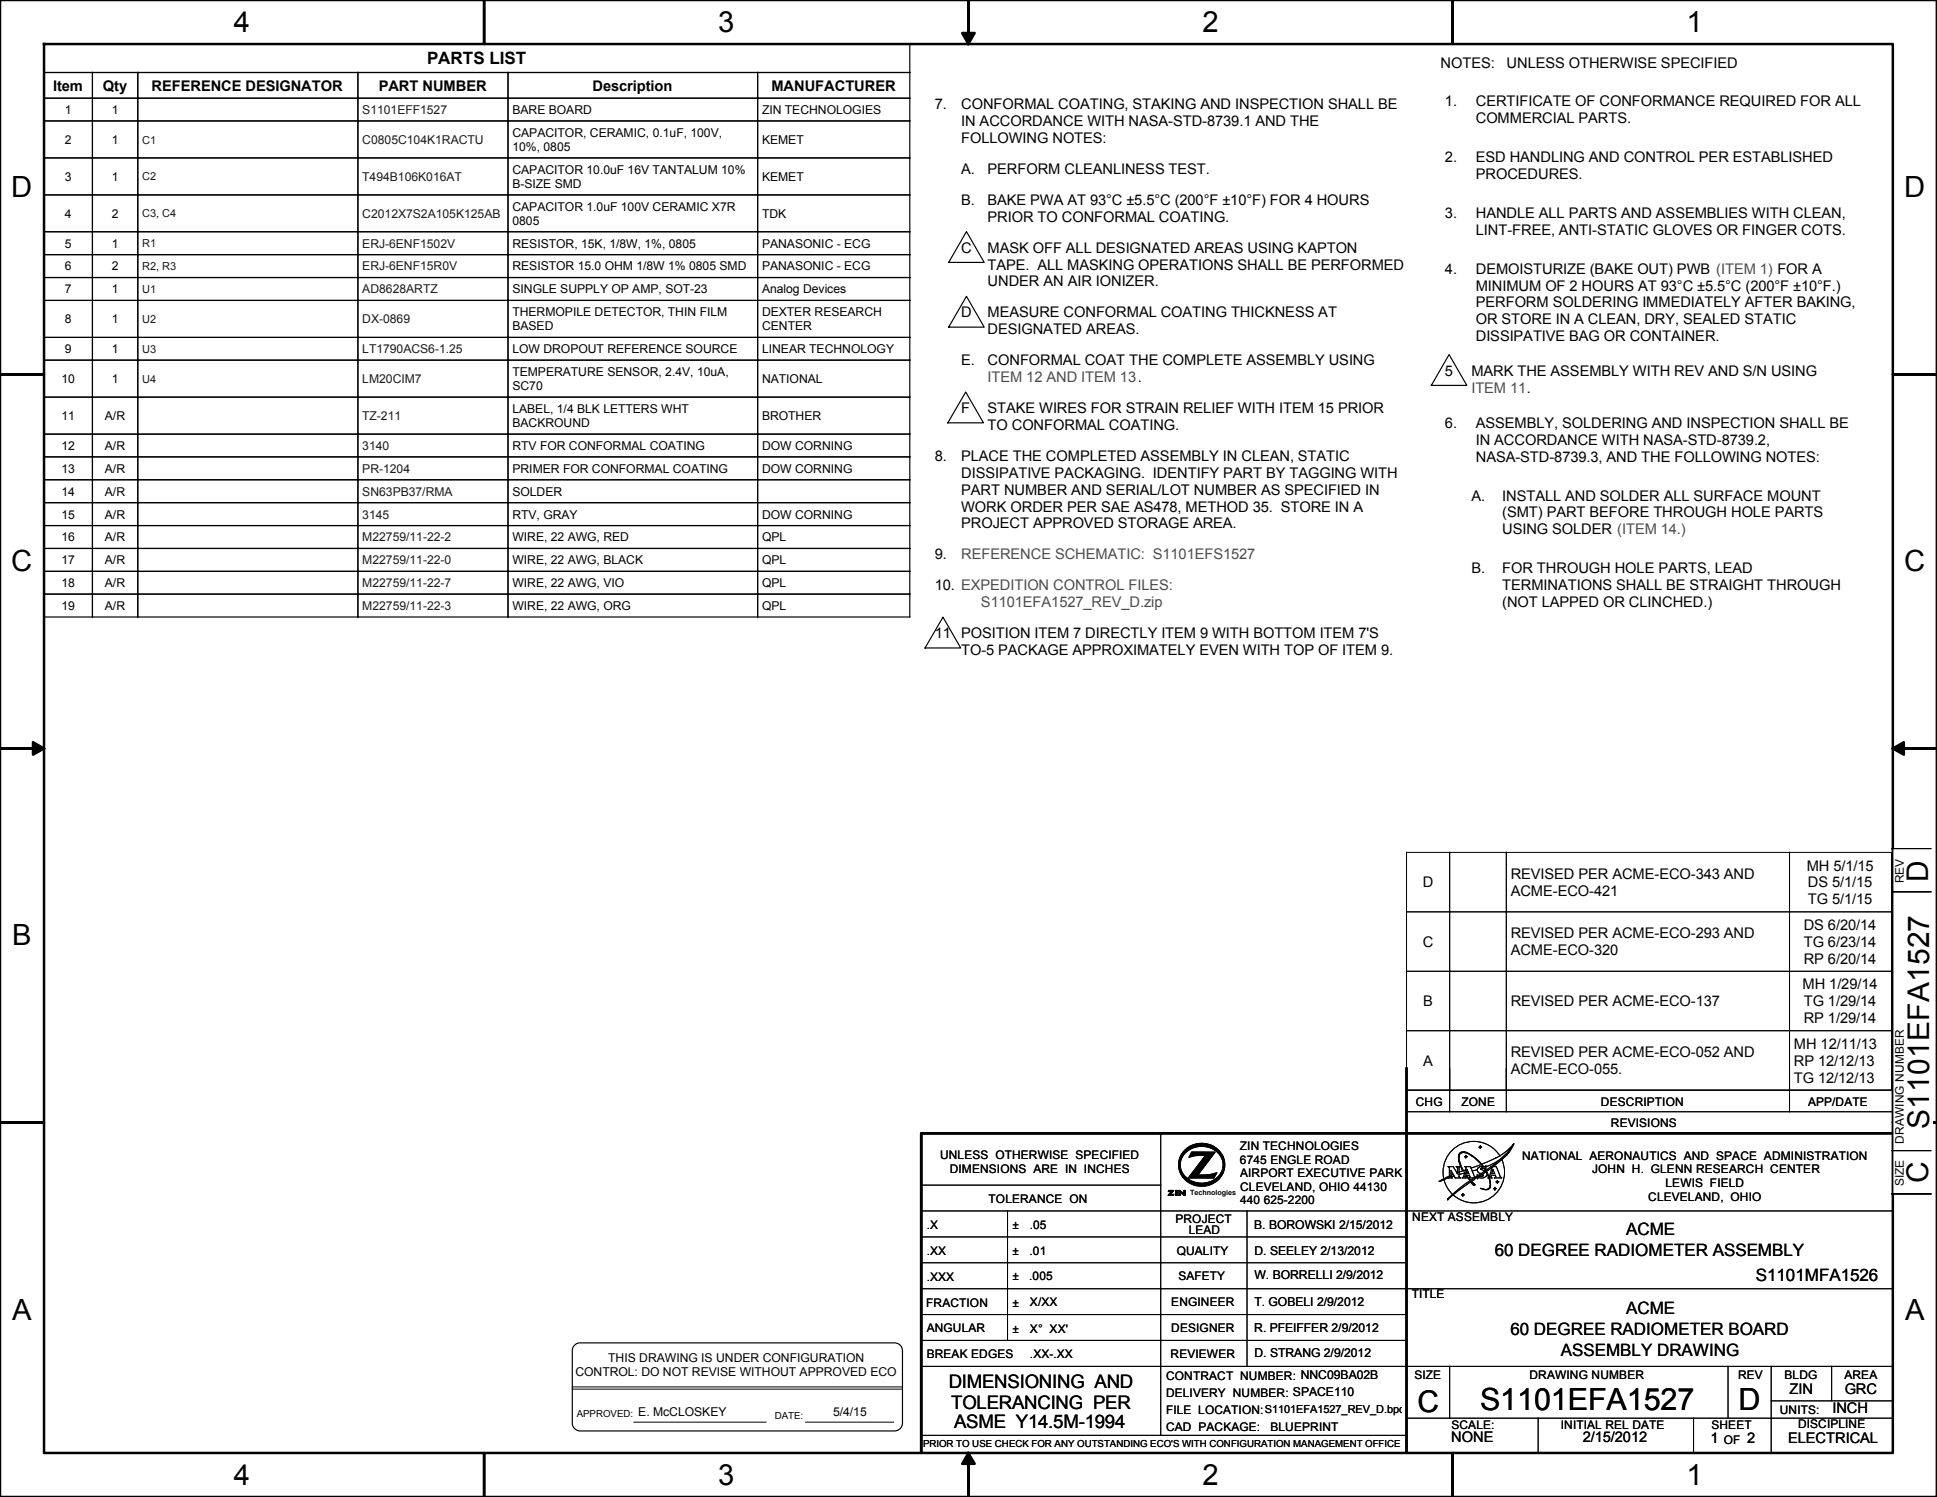
[picture p261: page 1]

PARTS LIST

NOTES: UNLESS OTHERWISE SPECIFIED

Item | Qty | REFERENCE DESIGNATOR | PART NUMBER | Description | MANUFACTURER

7. CONFORMAL COATING, STAKING AND INSPECTION SHALL BE
IN ACCORDANCE WITH NASA-STD-8739.1 AND THE
FOLLOWING NOTES:

1. CERTIFICATE OF CONFORMANCE REQUIRED FOR ALL
COMMERCIAL PARTS.

1 | 1 | | S1101EFF1527 | BARE BOARD | ZIN TECHNOLOGIES

2 | 1 | C1 | C0805C104K1RACTU | CAPACITOR, CERAMIC, 0.1uF, 100V, 10%, 0805 | KEMET

2. ESD HANDLING AND CONTROL PER ESTABLISHED
PROCEDURES.

3 | 1 | C2 | T494B106K016AT | CAPACITOR 10.0uF 16V TANTALUM 10% B-SIZE SMD | KEMET

B. BAKE PWA AT 93°C ±5.5°C (200°F ±10°F) FOR 4 HOURS
PRIOR TO CONFORMAL COATING.

4 | 2 | C3, C4 | C2012X7S2A105K125AB | CAPACITOR 1.0uF 100V CERAMIC X7R 0805 | TDK

3. HANDLE ALL PARTS AND ASSEMBLIES WITH CLEAN,
LINT-FREE, ANTI-STATIC GLOVES OR FINGER COTS.

5 | 1 | R1 | ERJ-6ENF1502V | RESISTOR, 15K, 1/8W, 1%, 0805 | PANASONIC - ECG

C MASK OFF ALL DESIGNATED AREAS USING KAPTON
TAPE. ALL MASKING OPERATIONS SHALL BE PERFORMED
UNDER AN AIR IONIZER.

6 | 2 | R2, R3 | ERJ-6ENF15R0V | RESISTOR 15.0 OHM 1/8W 1% 0805 SMD | PANASONIC - ECG

4. DEMOISTURIZE (BAKE OUT) PWB (ITEM 1) FOR A
MINIMUM OF 2 HOURS AT 93°C ±5.5°C (200°F ±10°F.)
PERFORM SOLDERING IMMEDIATELY AFTER BAKING,
OR STORE IN A CLEAN, DRY, SEALED STATIC
DISSIPATIVE BAG OR CONTAINER.

7 | 1 | U1 | AD8628ARTZ | SINGLE SUPPLY OP AMP, SOT-23 | Analog Devices

8 | 1 | U2 | DX-0869 | THERMOPILE DETECTOR, THIN FILM BASED | DEXTER RESEARCH CENTER

D MEASURE CONFORMAL COATING THICKNESS AT
DESIGNATED AREAS.

9 | 1 | U3 | LT1790ACS6-1.25 | LOW DROPOUT REFERENCE SOURCE | LINEAR TECHNOLOGY

E. CONFORMAL COAT THE COMPLETE ASSEMBLY USING
ITEM 12 AND ITEM 13.

5 MARK THE ASSEMBLY WITH REV AND S/N USING
ITEM 11.

10 | 1 | U4 | LM20CIM7 | TEMPERATURE SENSOR, 2.4V, 10uA, SC70 | NATIONAL

11 | A/R | | TZ-211 | LABEL, 1/4 BLK LETTERS WHT BACKROUND | BROTHER

F STAKE WIRES FOR STRAIN RELIEF WITH ITEM 15 PRIOR
TO CONFORMAL COATING.

6. ASSEMBLY, SOLDERING AND INSPECTION SHALL BE
IN ACCORDANCE WITH NASA-STD-8739.2,
NASA-STD-8739.3, AND THE FOLLOWING NOTES:

12 | A/R | | 3140 | RTV FOR CONFORMAL COATING | DOW CORNING

8. PLACE THE COMPLETED ASSEMBLY IN CLEAN, STATIC
DISSIPATIVE PACKAGING. IDENTIFY PART BY TAGGING WITH
PART NUMBER AND SERIAL/LOT NUMBER AS SPECIFIED IN
WORK ORDER PER SAE AS478, METHOD 35. STORE IN A
PROJECT APPROVED STORAGE AREA.

13 | A/R | | PR-1204 | PRIMER FOR CONFORMAL COATING | DOW CORNING

14 | A/R | | SN63PB37/RMA | SOLDER

A. INSTALL AND SOLDER ALL SURFACE MOUNT
(SMT) PART BEFORE THROUGH HOLE PARTS
USING SOLDER (ITEM 14.)

15 | A/R | | 3145 | RTV, GRAY | DOW CORNING

16 | A/R | | M22759/11-22-2 | WIRE, 22 AWG, RED | QPL

17 | A/R | | M22759/11-22-0 | WIRE, 22 AWG, BLACK | QPL

B. FOR THROUGH HOLE PARTS, LEAD
TERMINATIONS SHALL BE STRAIGHT THROUGH
(NOT LAPPED OR CLINCHED.)

18 | A/R | | M22759/11-22-7 | WIRE, 22 AWG, VIO | QPL

19 | A/R | | M22759/11-22-3 | WIRE, 22 AWG, ORG | QPL

11 POSITION ITEM 7 DIRECTLY ITEM 9 WITH BOTTOM ITEM 7'S
TO-5 PACKAGE APPROXIMATELY EVEN WITH TOP OF ITEM 9.

D | | REVISED PER ACME-ECO-343 AND ACME-ECO-421 | MH 5/1/15 DS 5/1/15 TG 5/1/15

DRAWING NUMBER SIZE REV

C | | REVISED PER ACME-ECO-293 AND ACME-ECO-320 | DS 6/20/14 TG 6/23/14 RP 6/20/14

B REVISED PER ACME-ECO-137 | | | MH 1/29/14 TG 1/29/14 RP 1/29/14

A | | REVISED PER ACME-ECO-052 AND ACME-ECO-055. | MH 12/11/13 RP 12/12/13 TG 12/12/13

CHG | ZONE | DESCRIPTION | APP/DATE

UNLESS OTHERWISE SPECIFIED
DIMENSIONS ARE IN INCHES

NATIONAL AERONAUTICS AND SPACE ADMINISTRATION

JOHN H. GLENN RESEARCH CENTER

THIS DRAWING IS UNDER CONFIGURATION
CONTROL: DO NOT REVISE WITHOUT APPROVED ECO

PRIOR TO USE CHECK FOR ANY OUTSTANDING ECO'S WITH CONFIGURATION MANAGEMENT OFFICE

4

3

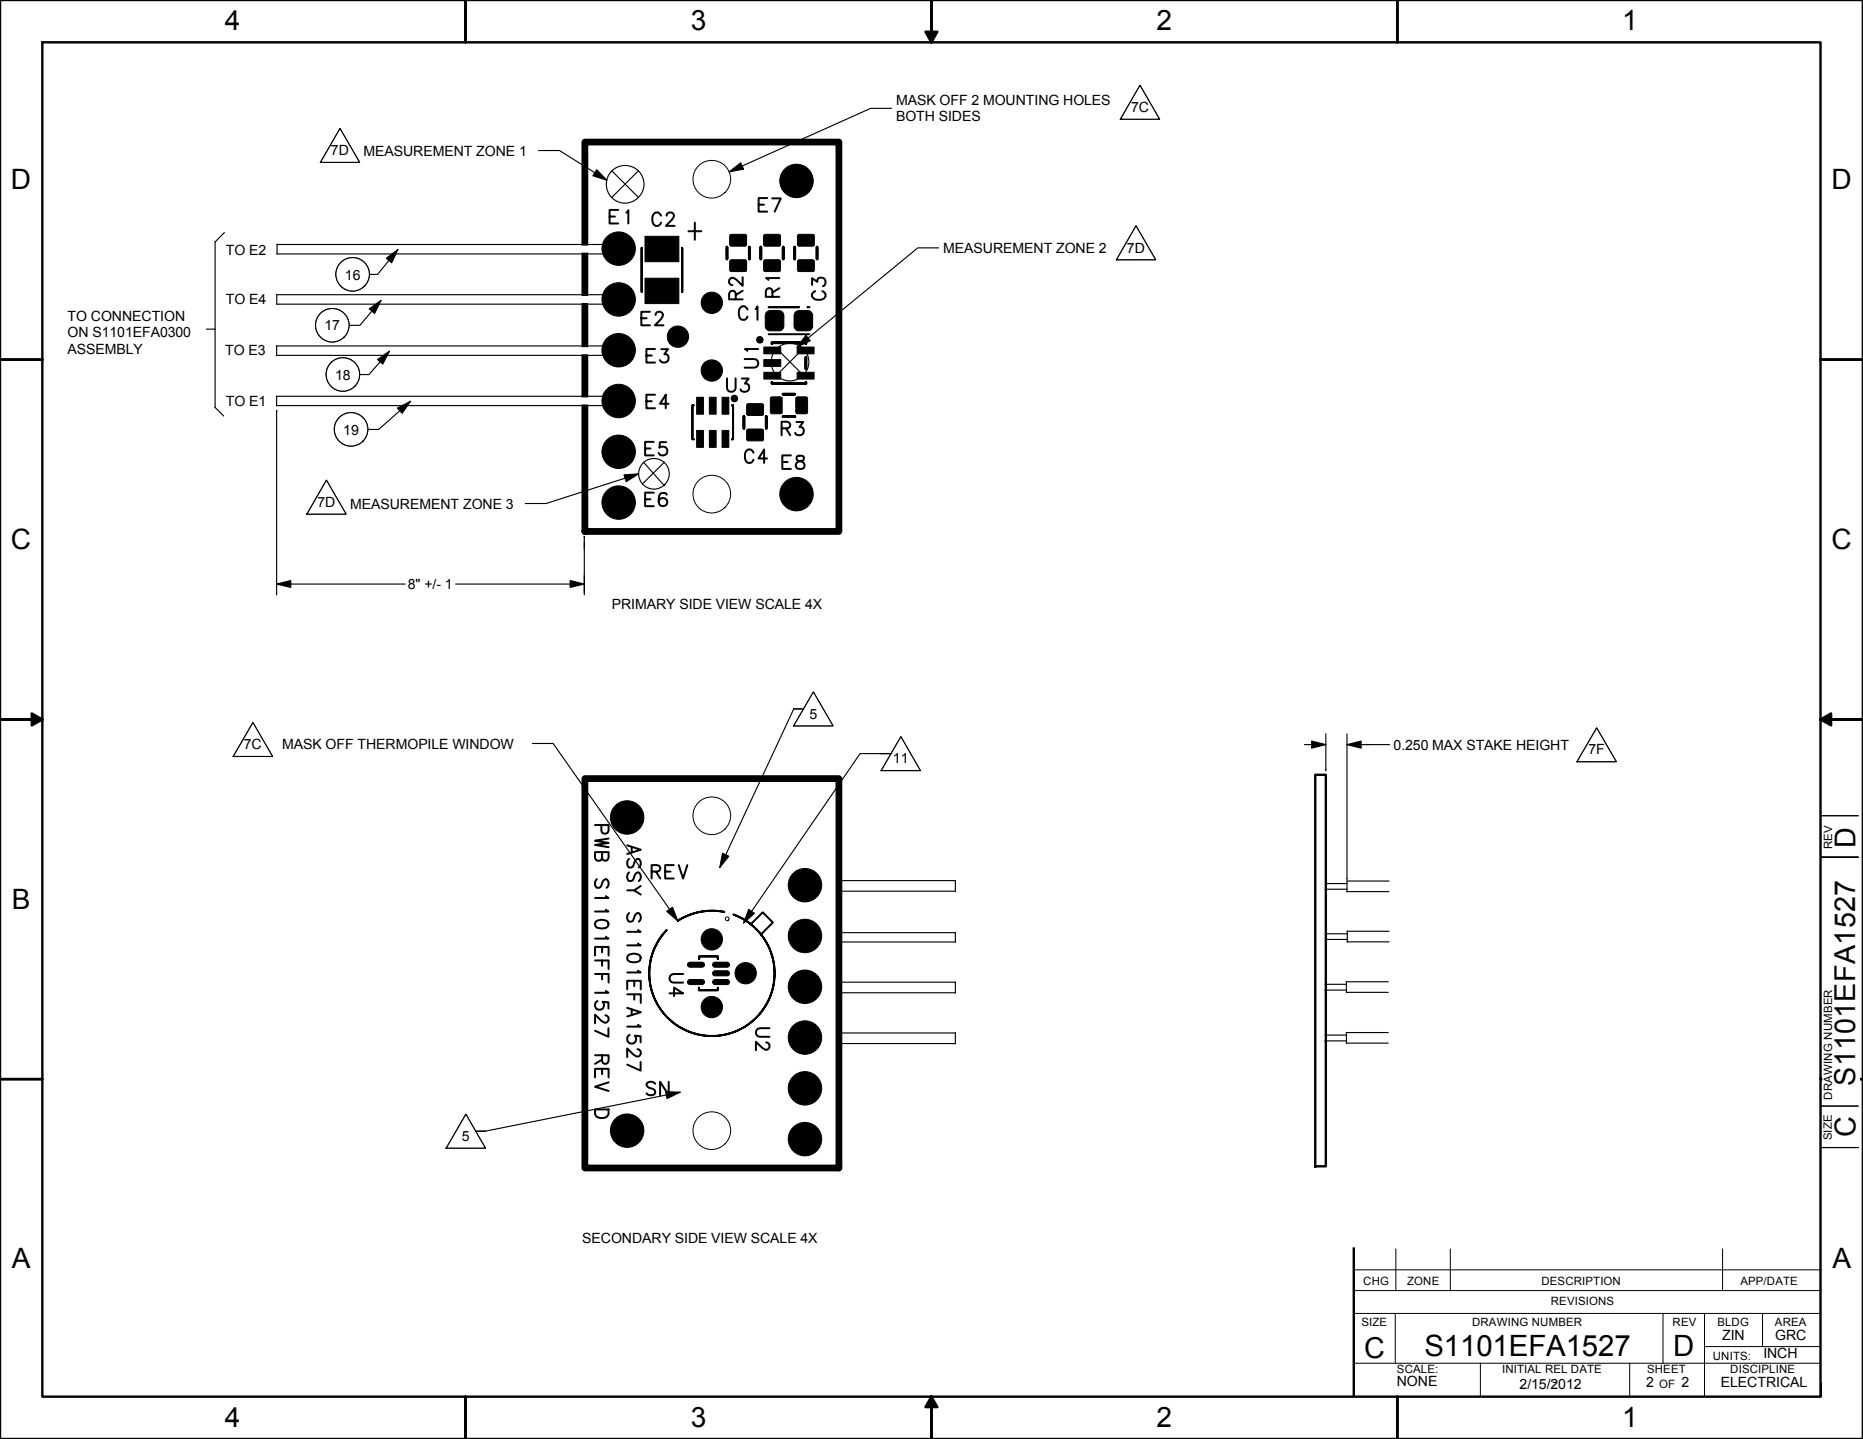
[picture p262: page 2]
MEASUREMENT ZONE 2; 7D MEASUREMENT ZONE 1; MEASUREMENT ZONE 3; SIZE; SCALE:; CHG; ZONE; SHEET; DRAWING NUMBER; INITIAL REL DATE; DISCIPLINE; AREA; UNITS:; REV; BLDG; DESCRIPTION; REVISIONS; APP/DATE; NONE; - S1101EFA1527; ZIN; GRC INCH 2; ELECTRICAL; S1101EFA1527; BOTH SIDES; MASK OFF THERMOPILE WINDOW; 0.250 MAX STAKE HEIGHT; TO CONNECTION ON S1101EFA0300 ASSEMBLY

MASK OFF 2 MOUNTING HOLES

PRIMARY SIDE VIEW SCALE 4X

DRAWING NUMBER SIZE REV

SECONDARY SIDE VIEW SCALE 4X
