EmersonBJ/nasa-acme-burner-cad-cfd/PSI-Documents/Engineering Documents/Desenhos_Tecnicos_NASA/ACME_drawings_diagnostic_system/ACME_drawings_diagnostic_system/S1101EFF1524_C.pdf

4

3

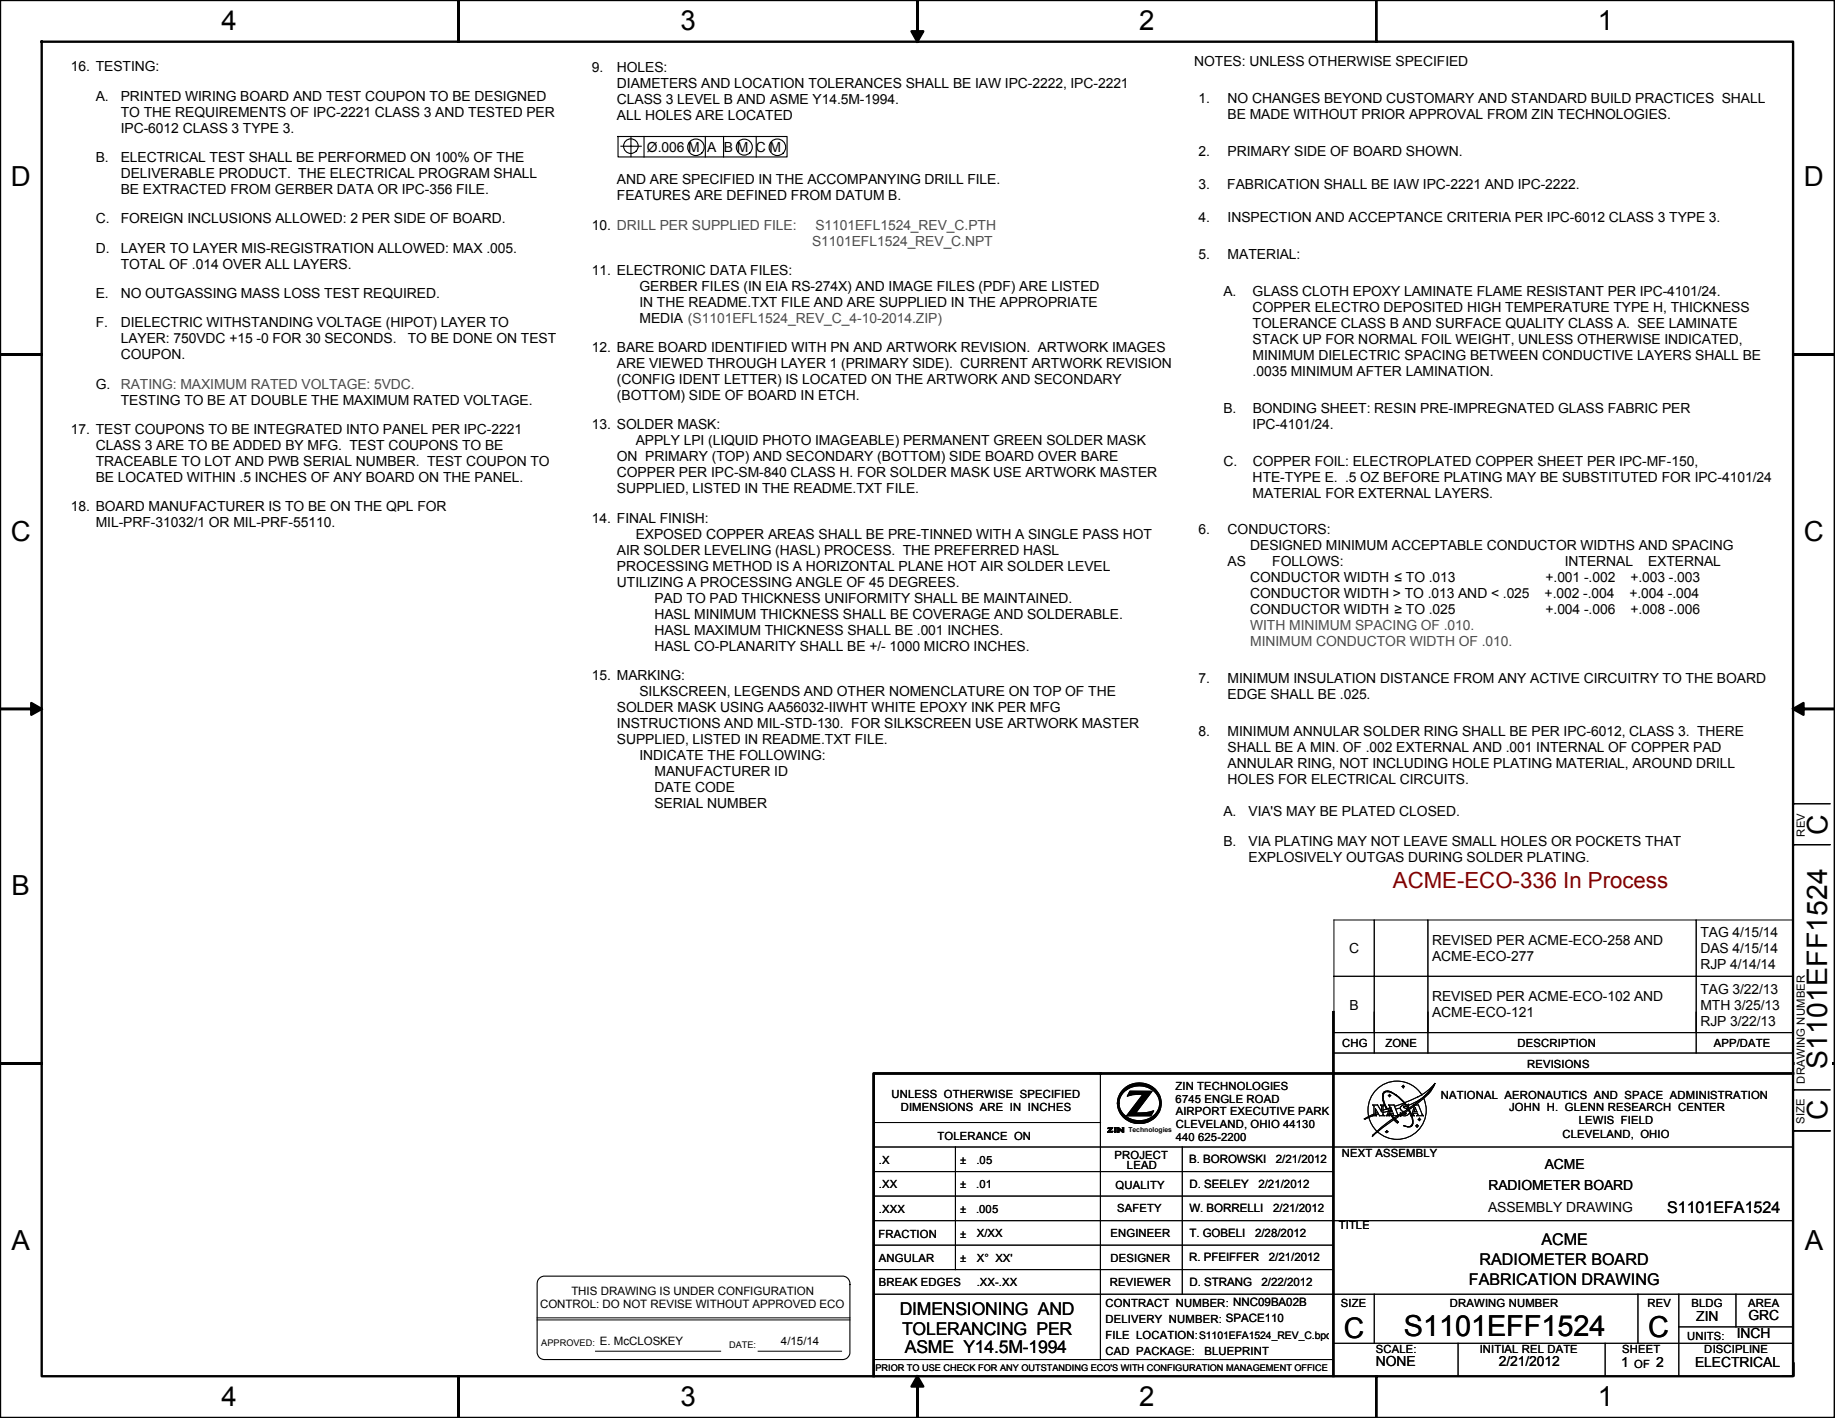
[picture p263: page 1]
ASME Y14.5M-1994; TOLERANCING PER; DIMENSIONING AND; TOLERANCE ON; FRACTION; ANGULAR; BREAK EDGES; .XXX; ENGINEER; REVIEWER; DESIGNER; LEAD; PROJECT; SIZE; SCALE:; CHG; ZONE; SHEET; DRAWING NUMBER; LEWIS FIELD; DISCIPLINE; AREA; UNITS:; REV; BLDG; DESCRIPTION; REVISIONS; APP/DATE; SAFETY; QUALITY; NONE; S1101EFF1524; ZIN; GRC INCH; ELECTRICAL; S1101EFA1524_REV_C.bpd; SPACE110; NNC09BA02B; D. STRANG 2/22/2012; R. PFEIFFER 2/21/2012; T. GOBELI 2/28/2012; W. BORRELLI 2/21/2012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

NOTES: UNLESS OTHERWISE SPECIFIED

9. HOLES:
DIAMETERS AND LOCATION TOLERANCES SHALL BE IAW IPC-2222, IPC-2221
CLASS 3 LEVEL B AND ASME Y14.5M-1994.
ALL HOLES ARE LOCATED

A. PRINTED WIRING BOARD AND TEST COUPON TO BE DESIGNED
TO THE REQUIREMENTS OF IPC-2221 CLASS 3 AND TESTED PER
IPC-6012 CLASS 3 TYPE 3.

1. NO CHANGES BEYOND CUSTOMARY AND STANDARD BUILD PRACTICES SHALL
BE MADE WITHOUT PRIOR APPROVAL FROM ZIN TECHNOLOGIES.

B. ELECTRICAL TEST SHALL BE PERFORMED ON 100% OF THE
DELIVERABLE PRODUCT. THE ELECTRICAL PROGRAM SHALL
BE EXTRACTED FROM GERBER DATA OR IPC-356 FILE.

2. PRIMARY SIDE OF BOARD SHOWN.

AND ARE SPECIFIED IN THE ACCOMPANYING DRILL FILE.
FEATURES ARE DEFINED FROM DATUM B.

3. FABRICATION SHALL BE IAW IPC-2221 AND IPC-2222.

C. FOREIGN INCLUSIONS ALLOWED: 2 PER SIDE OF BOARD.

4. INSPECTION AND ACCEPTANCE CRITERIA PER IPC-6012 CLASS 3 TYPE 3.

D. LAYER TO LAYER MIS-REGISTRATION ALLOWED: MAX .005.
TOTAL OF .014 OVER ALL LAYERS.

11. ELECTRONIC DATA FILES:

GERBER FILES (IN EIA RS-274X) AND IMAGE FILES (PDF) ARE LISTED
IN THE README.TXT FILE AND ARE SUPPLIED IN THE APPROPRIATE
MEDIA (S1101EFL1524_REV_C_4-10-2014.ZIP)

E. NO OUTGASSING MASS LOSS TEST REQUIRED.

A. GLASS CLOTH EPOXY LAMINATE FLAME RESISTANT PER IPC-4101/24.
COPPER ELECTRO DEPOSITED HIGH TEMPERATURE TYPE H, THICKNESS
TOLERANCE CLASS B AND SURFACE QUALITY CLASS A. SEE LAMINATE
STACK UP FOR NORMAL FOIL WEIGHT, UNLESS OTHERWISE INDICATED,
MINIMUM DIELECTRIC SPACING BETWEEN CONDUCTIVE LAYERS SHALL BE
.0035 MINIMUM AFTER LAMINATION.

F. DIELECTRIC WITHSTANDING VOLTAGE (HIPOT) LAYER TO
LAYER: 750VDC +15 -0 FOR 30 SECONDS. TO BE DONE ON TEST
COUPON.

12. BARE BOARD IDENTIFIED WITH PN AND ARTWORK REVISION. ARTWORK IMAGES
ARE VIEWED THROUGH LAYER 1 (PRIMARY SIDE). CURRENT ARTWORK REVISION
(CONFIG IDENT LETTER) IS LOCATED ON THE ARTWORK AND SECONDARY
(BOTTOM) SIDE OF BOARD IN ETCH.

G. RATING: MAXIMUM RATED VOLTAGE: 5VDC.
TESTING TO BE AT DOUBLE THE MAXIMUM RATED VOLTAGE.

B. BONDING SHEET: RESIN PRE-IMPREGNATED GLASS FABRIC PER
IPC-4101/24.

17. TEST COUPONS TO BE INTEGRATED INTO PANEL PER IPC-2221
CLASS 3 ARE TO BE ADDED BY MFG. TEST COUPONS TO BE
TRACEABLE TO LOT AND PWB SERIAL NUMBER. TEST COUPON TO
BE LOCATED WITHIN .5 INCHES OF ANY BOARD ON THE PANEL.

APPLY LPI (LIQUID PHOTO IMAGEABLE) PERMANENT GREEN SOLDER MASK
ON PRIMARY (TOP) AND SECONDARY (BOTTOM) SIDE BOARD OVER BARE
COPPER PER IPC-SM-840 CLASS H. FOR SOLDER MASK USE ARTWORK MASTER
SUPPLIED, LISTED IN THE README.TXT FILE.

C. COPPER FOIL: ELECTROPLATED COPPER SHEET PER IPC-MF-150,
HTE-TYPE E. .5 OZ BEFORE PLATING MAY BE SUBSTITUTED FOR IPC-4101/24
MATERIAL FOR EXTERNAL LAYERS.

18. BOARD MANUFACTURER IS TO BE ON THE QPL FOR
MIL-PRF-31032/1 OR MIL-PRF-55110.

EXPOSED COPPER AREAS SHALL BE PRE-TINNED WITH A SINGLE PASS HOT
AIR SOLDER LEVELING (HASL) PROCESS. THE PREFERRED HASL
PROCESSING METHOD IS A HORIZONTAL PLANE HOT AIR SOLDER LEVEL
UTILIZING A PROCESSING ANGLE OF 45 DEGREES.
PAD TO PAD THICKNESS UNIFORMITY SHALL BE MAINTAINED.
HASL MINIMUM THICKNESS SHALL BE COVERAGE AND SOLDERABLE.
HASL MAXIMUM THICKNESS SHALL BE .001 INCHES.
HASL CO-PLANARITY SHALL BE +/- 1000 MICRO INCHES.

DESIGNED MINIMUM ACCEPTABLE CONDUCTOR WIDTHS AND SPACING
CONDUCTOR WIDTH > TO .013 AND < .025 +.002 -.004 +.004 -.004
WITH MINIMUM SPACING OF .010.
MINIMUM CONDUCTOR WIDTH OF .010.

7. MINIMUM INSULATION DISTANCE FROM ANY ACTIVE CIRCUITRY TO THE BOARD
EDGE SHALL BE .025.

SILKSCREEN, LEGENDS AND OTHER NOMENCLATURE ON TOP OF THE
SOLDER MASK USING AA56032-IIWHT WHITE EPOXY INK PER MFG
INSTRUCTIONS AND MIL-STD-130. FOR SILKSCREEN USE ARTWORK MASTER
SUPPLIED, LISTED IN README.TXT FILE.
INDICATE THE FOLLOWING:
MANUFACTURER ID
DATE CODE
SERIAL NUMBER

8. MINIMUM ANNULAR SOLDER RING SHALL BE PER IPC-6012, CLASS 3. THERE
SHALL BE A MIN. OF .002 EXTERNAL AND .001 INTERNAL OF COPPER PAD
ANNULAR RING, NOT INCLUDING HOLE PLATING MATERIAL, AROUND DRILL
HOLES FOR ELECTRICAL CIRCUITS.

A. VIA'S MAY BE PLATED CLOSED.

DRAWING NUMBER SIZE REV

B. VIA PLATING MAY NOT LEAVE SMALL HOLES OR POCKETS THAT
EXPLOSIVELY OUTGAS DURING SOLDER PLATING.

ACME-ECO-336 In Process

ZIN TECHNOLOGIES
6745 ENGLE ROAD
AIRPORT EXECUTIVE PARK
CLEVELAND, OHIO 44130

UNLESS OTHERWISE SPECIFIED
DIMENSIONS ARE IN INCHES

NATIONAL AERONAUTICS AND SPACE ADMINISTRATION

JOHN H. GLENN RESEARCH CENTER

THIS DRAWING IS UNDER CONFIGURATION
CONTROL: DO NOT REVISE WITHOUT APPROVED ECO

CONTRACT NUMBER:
DELIVERY NUMBER:
FILE LOCATION:
CAD PACKAGE: BLUEPRINT

INITIAL REL DATE

PRIOR TO USE CHECK FOR ANY OUTSTANDING ECO'S WITH CONFIGURATION MANAGEMENT OFFICE

4

3

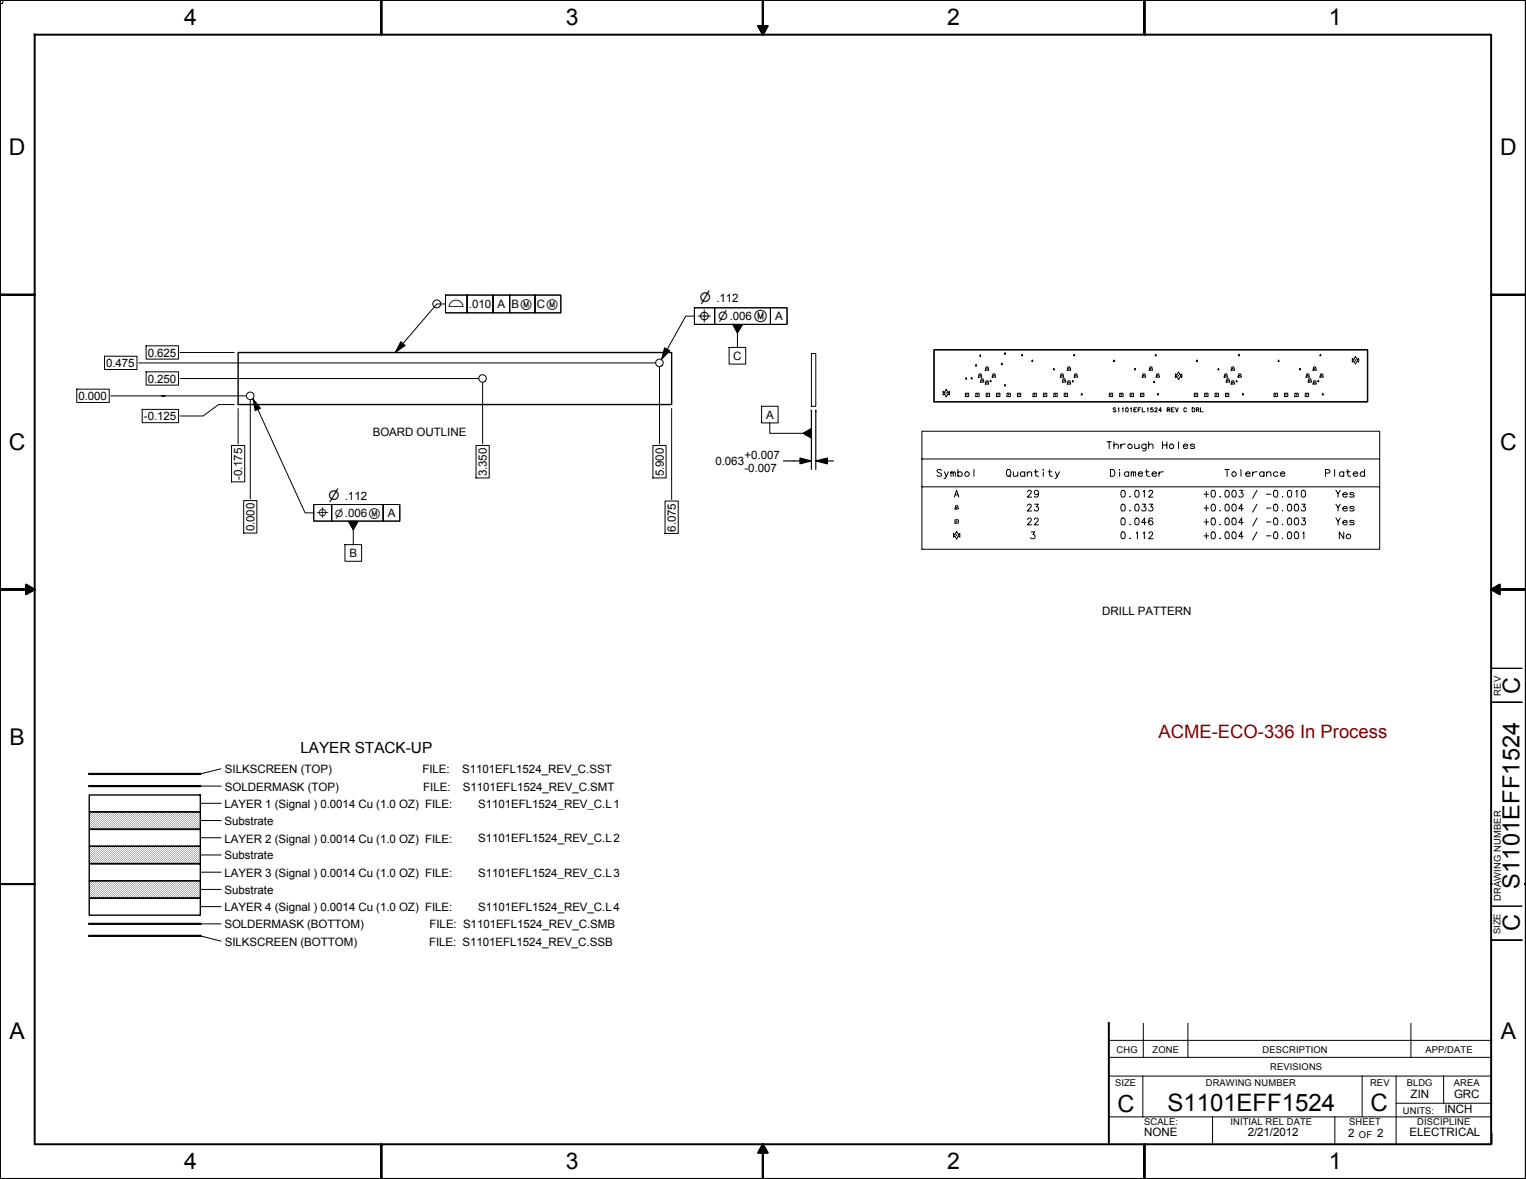
[picture p264: page 2]
SIZE; SCALE:; CHG; ZONE; SHEET; DRAWING NUMBER; INITIAL REL DATE; DISCIPLINE; AREA; UNITS:; REV; BLDG; DESCRIPTION; REVISIONS; APP/DATE; NONE; S1101EFF1524; ZIN; GRC INCH; ELECTRICAL; BOARD OUTLINE; DRILL PATTERN; SILKSCREEN (TOP); FILE: S1101EFL1524_REV_C.SST; SOLDERMASK (TOP); FILE: S1101EFL1524_REV_C.SMT; LAYER 1 (Signal ) 0.0014 Cu (1.0 OZ) FILE:; S1101EFL1524_REV_C.L 1; Substrate; LAYER 2 (Signal ) 0.0014 Cu (1.0 OZ) FILE:; S1101EFL1524_REV_C.L 2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

DRAWING NUMBER SIZE REV

ACME-ECO-336 In Process

LAYER STACK-UP
