EmersonBJ/nasa-acme-burner-cad-cfd/PSI-Documents/Engineering Documents/Desenhos_Tecnicos_NASA/ACME_drawings_diagnostic_system/ACME_drawings_diagnostic_system/s1101mfa1500_B.pdf

D | D
8 | 7 | 6 | 5 | 4 | 3 | 1

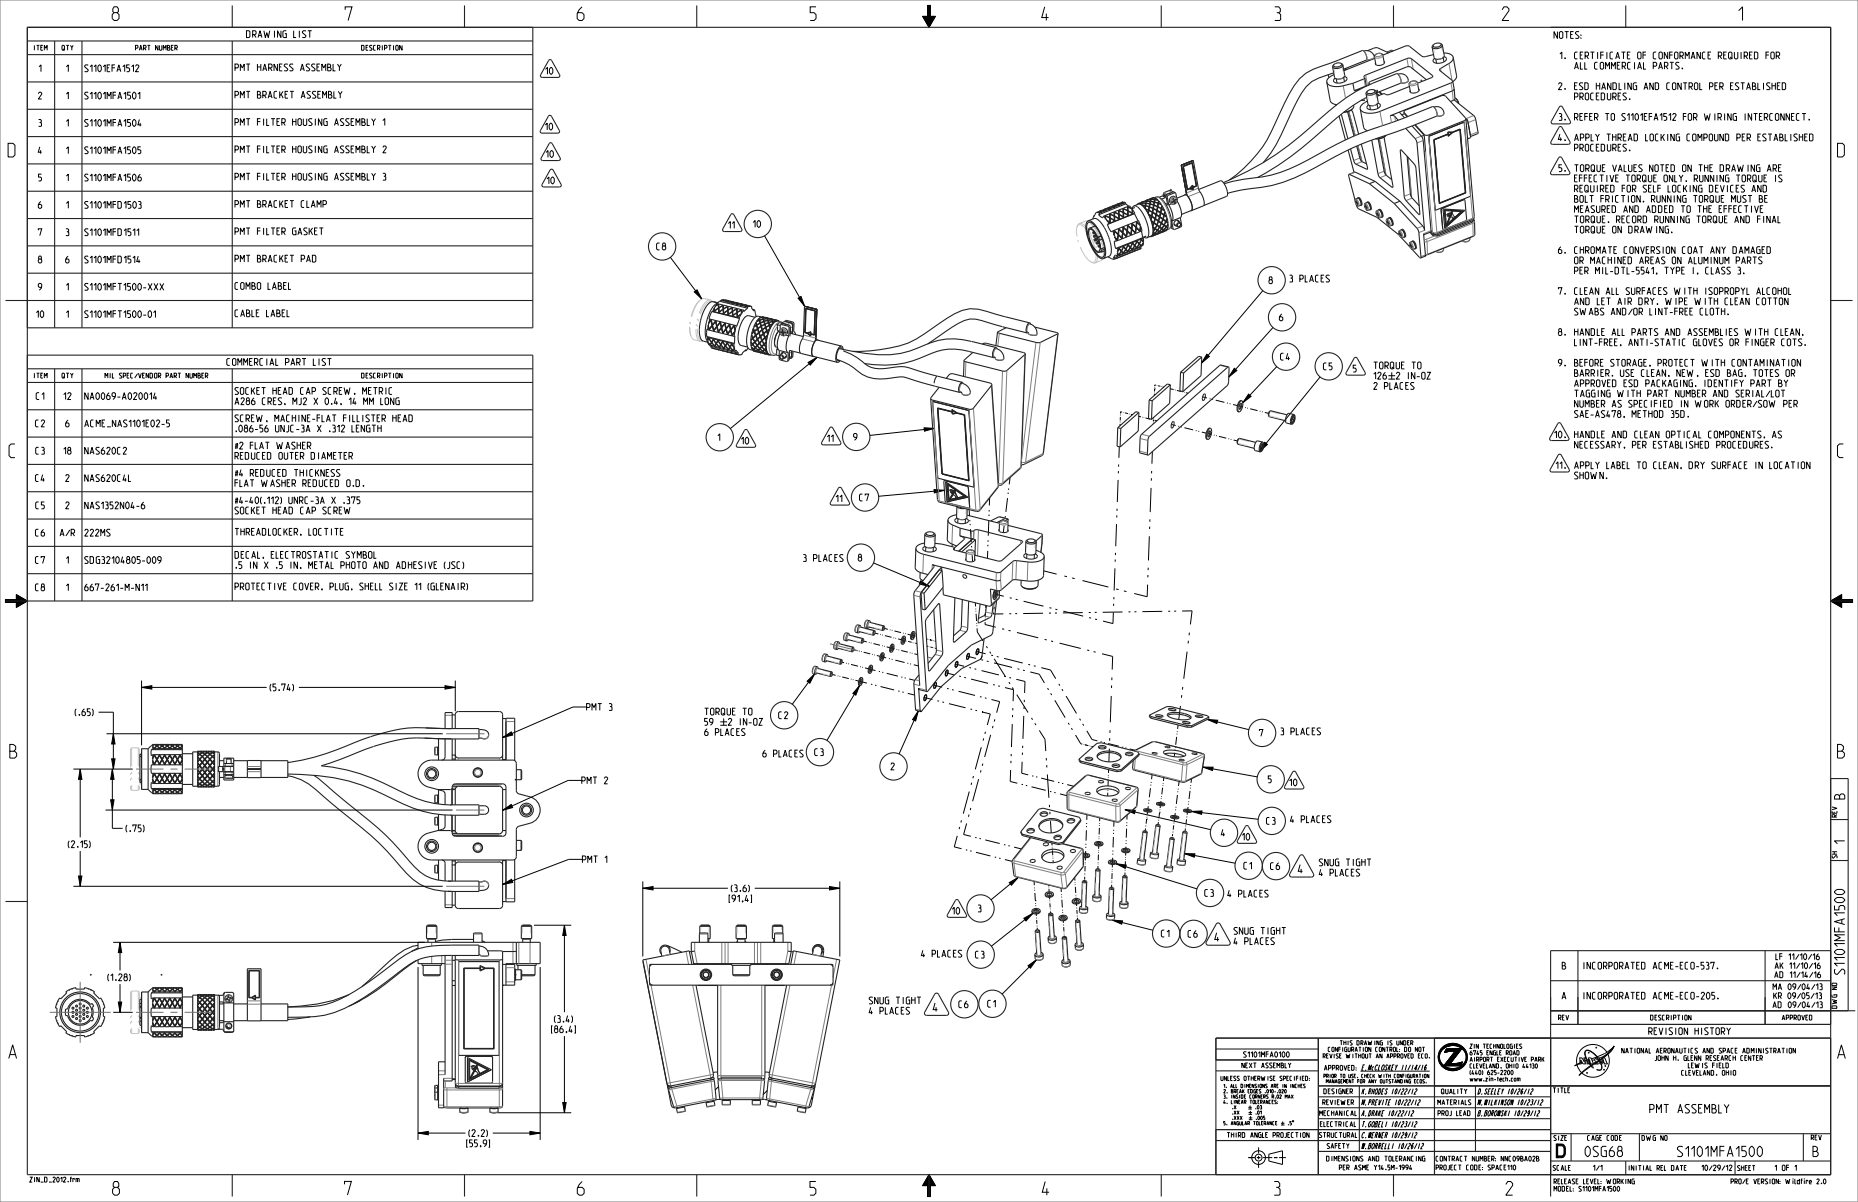
[picture p265: page 1]

NOTES:
CERTIFICATE OF CONFORMANCE REQUIRED FOR
ALL COMMERCIAL PARTS.
PROCEDURES.
APPLY THREAD LOCKING COMPOUND PER ESTABLISHED
TORQUE VALUES NOTED ON THE DRAWING ARE
REQUIRED FOR SELF LOCKING DEVICES AND
TORQUE. RECORD RUNNING TORQUE AND FINAL
TORQUE ON DRAWING.
CHROMATE CONVERSION COAT ANY DAMAGED
OR MACHINED AREAS ON ALUMINUM PARTS
SWABS AND/OR LINT-FREE CLOTH.
LINT-FREE, ANTI-STATIC GLOVES OR FINGER COTS.
APPROVED ESD PACKAGING. IDENTIFY PART BY
SAE-AS478, METHOD 35D.
HANDLE AND CLEAN OPTICAL COMPONENTS, AS
NECESSARY, PER ESTABLISHED PROCEDURES.

1 | 1 | S1101EFA1512 | PMT HARNESS ASSEMBLY
2 | 1 | S1101MFA1501 | PMT BRACKET ASSEMBLY

6 | 1 | S1101MFD1503 | PMT BRACKET CLAMP
7 | 3 | S1101MFD1511 | PMT FILTER GASKET
8 | 6 | S1101MFD1514 | | PMT BRACKET PAD
9 10 | 1 1 | S1101MFT1500-XXX S1101MFT1500-01 | | COMBO LABEL CABLE LABEL

C1 | 12 | NA0069-A020014 | | SOCKET HEAD CAP SCREW, METRIC A286 CRES, MJ2 X 0.4, 14 MM LONG
C2 | 6 | ACME_NAS1101E02-5 | | SCREW, MACHINE-FLAT FILLISTER HEAD .086-56 UNJC-3A X .312 LENGTH
C3 | 18 | NAS620C2 | | #2 FLAT WASHER
C4 | | 2 | NAS620C4L | | #4 REDUCED THICKNESS FLAT WASHER REDUCED O.D.
C5 | 2 | NAS1352N04-6 | | #4-40(.112) UNRC-3A X .375 SOCKET HEAD CAP SCREW

C6 | A/R | 222MS | THREADLOCKER, LOCTITE
C7 | 1 | SDG32104805-009 | | DECAL, ELECTROSTATIC SYMBOL

1 DWG NO REV SH

B | INCORPORATED ACME-ECO-537. | LF 11/10/16 AK 11/10/16 AD 11/14/16

A REV | INCORPORATED ACME-ECO-205. DESCRIPTION | MA 09/04/13 KR 09/05/13 AD 09/04/13 APPROVED

THIS DRAWING IS UNDER

CONFIGURATION CONTROL: DO NOT REVISE WITHOUT AN APPROVED ECO. APPROVED: E.McCLOSKEY 11/14/16 | ZIN TECHNOLOGIES CLEVELAND, OHIO 44130 (440) 625-2200 www.zin-tech.com | | | NATIONAL AERONAUTICS AND SPACE ADMINISTRATION CLEVELAND, OHIO

NEXT ASSEMBLY

PRIOR TO USE, CHECK WITH CONFIGURATION
MANAGEMENT FOR ANY OUTSTANDING ECOS.

DESIGNER | | K.RHODES 10/22/12 | QUALITY | | D.SEELEY 10/26/12 | | | | PMT ASSEMBLY
REVIEWER | | M.PREVITE 10/22/12 | | | | | M.WILKINSON 10/23/12
A.DRAKE 10/22/12 | | | B.BOROWSKI 10/29/12
T.GOBELI 10/23/12
W.BORRELLI 10/26/12

3. INSIDE CORNERS R.02 MAX | .XX #-.XXX #-

THIRD ANGLE PROJECTION | | | | | | | | C.WERNER 10/29/12
