EmersonBJ/nasa-acme-burner-cad-cfd/PSI-Documents/Engineering Documents/Desenhos_Tecnicos_NASA/ACME_drawings_diagnostic_system/ACME_drawings_diagnostic_system/s1101mfa1549_-.pdf

D | D
8 | 7 | 6 | 5 | 4 | 3 | 1

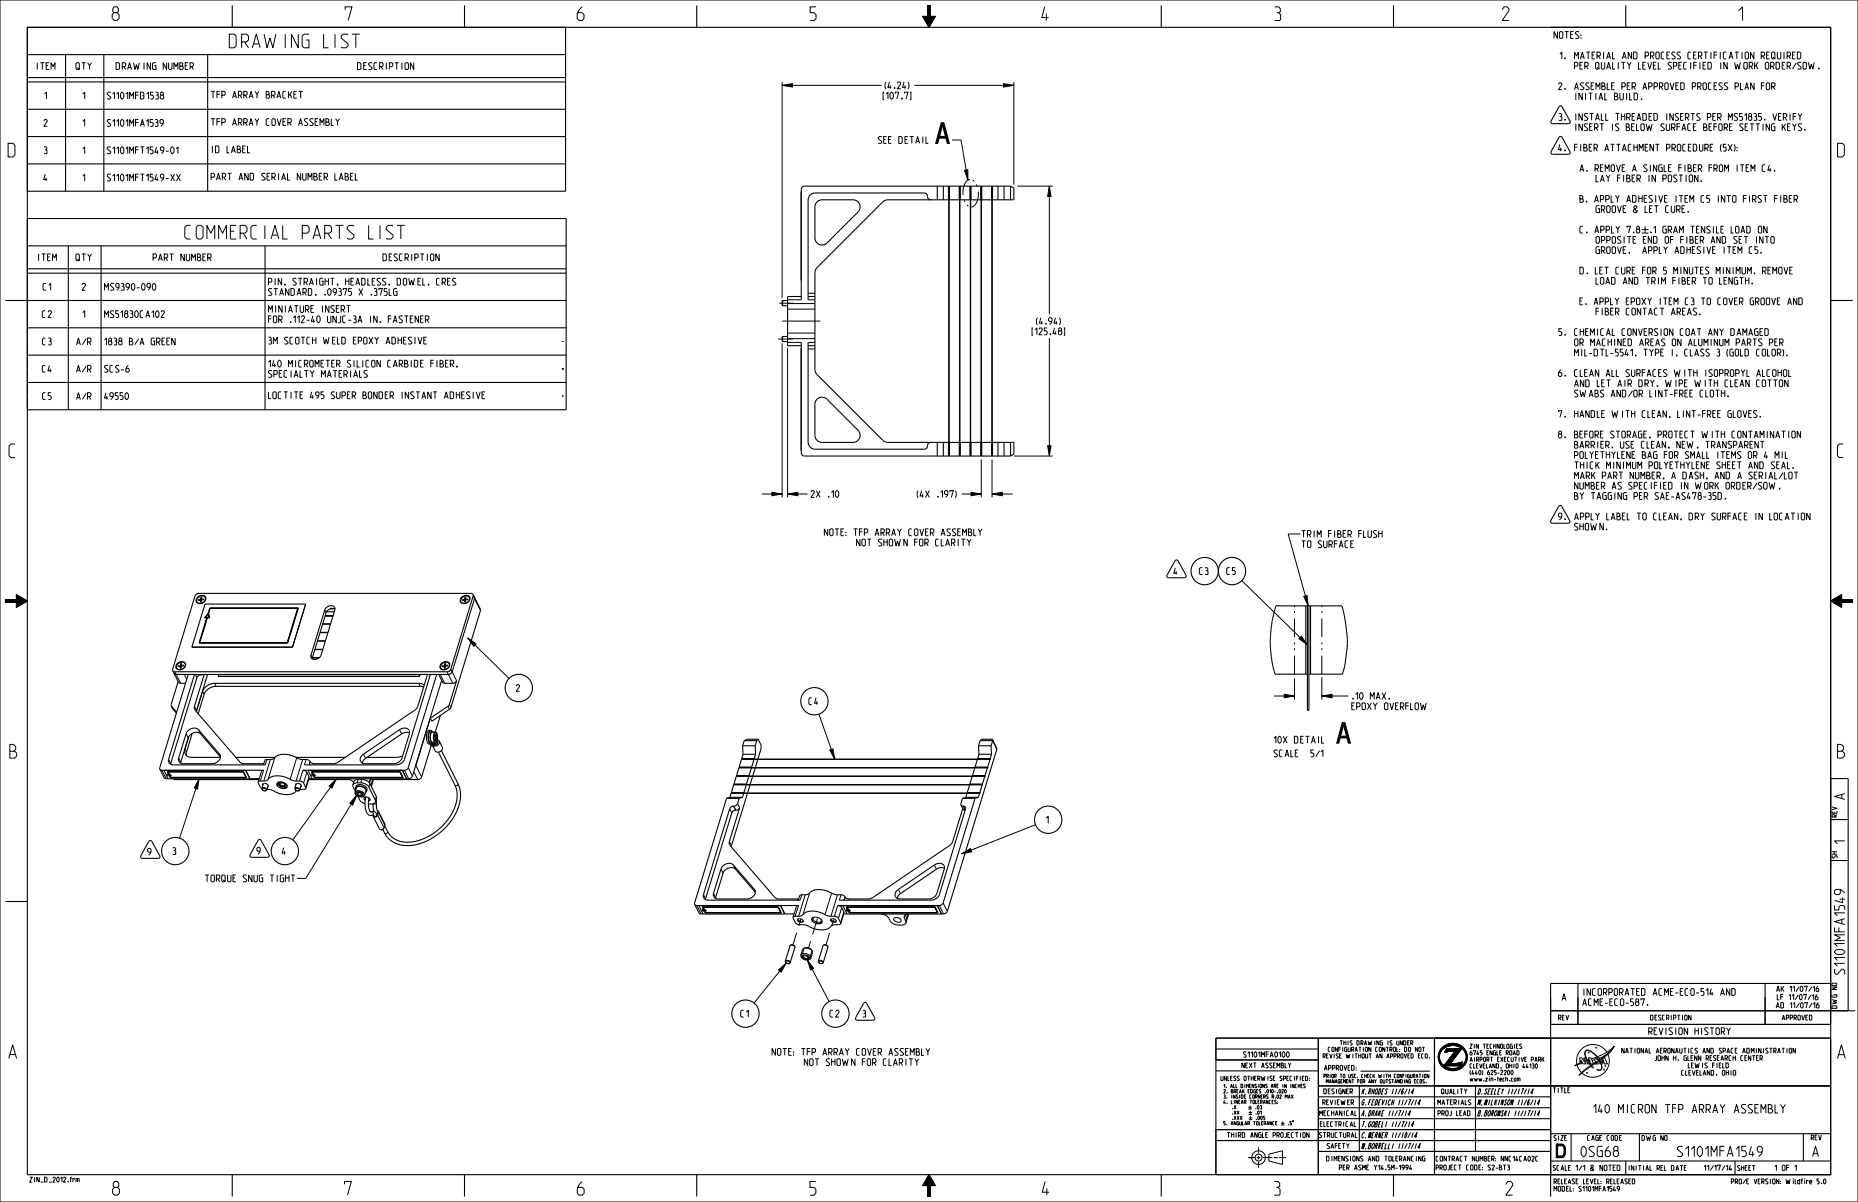
[picture p266: page 1]
SIZE; CAGE CODE; DWG NO; REV; SCALE; INITIAL REL DATE; SHEET; TITLE; UNLESS OTHERWISE; SPECIFIED:; 1. ALL DIMENSIONS ARE; INCHES; 2. BREAK; EDGES .010-.020; LINEAR; TOLERANCES:; 5. ANGULAR; TOLERANCE #-; DESCRIPTION; APPROVED; REVISION; HISTORY; MATERIALS; PROJ; LEAD; MODEL: S1101MFA1549; ZIN_D_2012.frm; JOHN; H. GLENN RESEARCH CENTER; LEWIS FIELD; ENGLE ROAD; AIRPORT; EXECUTIVE PARK; MAX. EPOXY OVERFLOW; DRAWING LIST; ITEM; QTY; DRAWING NUMBER; S1101MFD1538; TFP ARRAY BRACKET; S1101MFA1539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

NOTES:
MATERIAL AND PROCESS CERTIFICATION REQUIRED
ASSEMBLE PER APPROVED PROCESS PLAN FOR
INITIAL BUILD.
FIBER ATTACHMENT PROCEDURE (5X):
GROOVE & LET CURE.
C. APPLY 7.8#-
D. LET CURE FOR 5 MINUTES MINIMUM. REMOVE
LOAD AND TRIM FIBER TO LENGTH.
FIBER CONTACT AREAS.
CHEMICAL CONVERSION COAT ANY DAMAGED
OR MACHINED AREAS ON ALUMINUM PARTS PER
SWABS AND/OR LINT-FREE CLOTH.
THICK MINIMUM POLYETHYLENE SHEET AND SEAL.
MARK PART NUMBER, A DASH, AND A SERIAL/LOT
BY TAGGING PER SAE-AS478-35D.
SHOWN.

COMMERCIAL PARTS LIST

.1 GRAM TENSILE LOAD ON

NOT SHOWN FOR CLARITY

TRIM FIBER FLUSH
TO SURFACE

1 DWG NO REV SH

TORQUE SNUG TIGHT

INCORPORATED ACME-ECO-514 AND
ACME-ECO-587. A

THIS DRAWING IS UNDER

CONFIGURATION CONTROL: DO NOT REVISE WITHOUT AN APPROVED ECO. APPROVED: | ZIN TECHNOLOGIES CLEVELAND, OHIO 44130 (440) 625-2200 www.zin-tech.com | | | NATIONAL AERONAUTICS AND SPACE ADMINISTRATION CLEVELAND, OHIO

NEXT ASSEMBLY

PRIOR TO USE, CHECK WITH CONFIGURATION
MANAGEMENT FOR ANY OUTSTANDING ECOS.

DESIGNER | | K.RHODES 11/6/14 | QUALITY | | D.SEELEY 11/17/14
REVIEWER | | G.FEDEVICH 11/7/14 | | | | | M.WILKINSON 11/6/14
A.DRAKE 11/7/14 | | | B.BOROWSKI 11/17/14
T.GOBELI 11/7/14
W.BORRELLI 11/7/14

3. INSIDE CORNERS R.02 MAX | .XX #-.XXX #-

MECHANICAL
ELECTRICAL
STRUCTURAL
D SAFETY
DIMENSIONS AND TOLERANCING
PER ASME Y14.5M-1994

THIRD ANGLE PROJECTION | | | | | | | | C.WERNER 11/10/14
