EmersonBJ/nasa-acme-burner-cad-cfd/PSI-Documents/Engineering Documents/Desenhos_Tecnicos_NASA/ACME_drawings_diagnostic_system/ACME_drawings_diagnostic_system/s1101mfa1557_-.pdf

D | D
8 | 7 | 6 | 5 | 4 | 3 | 1

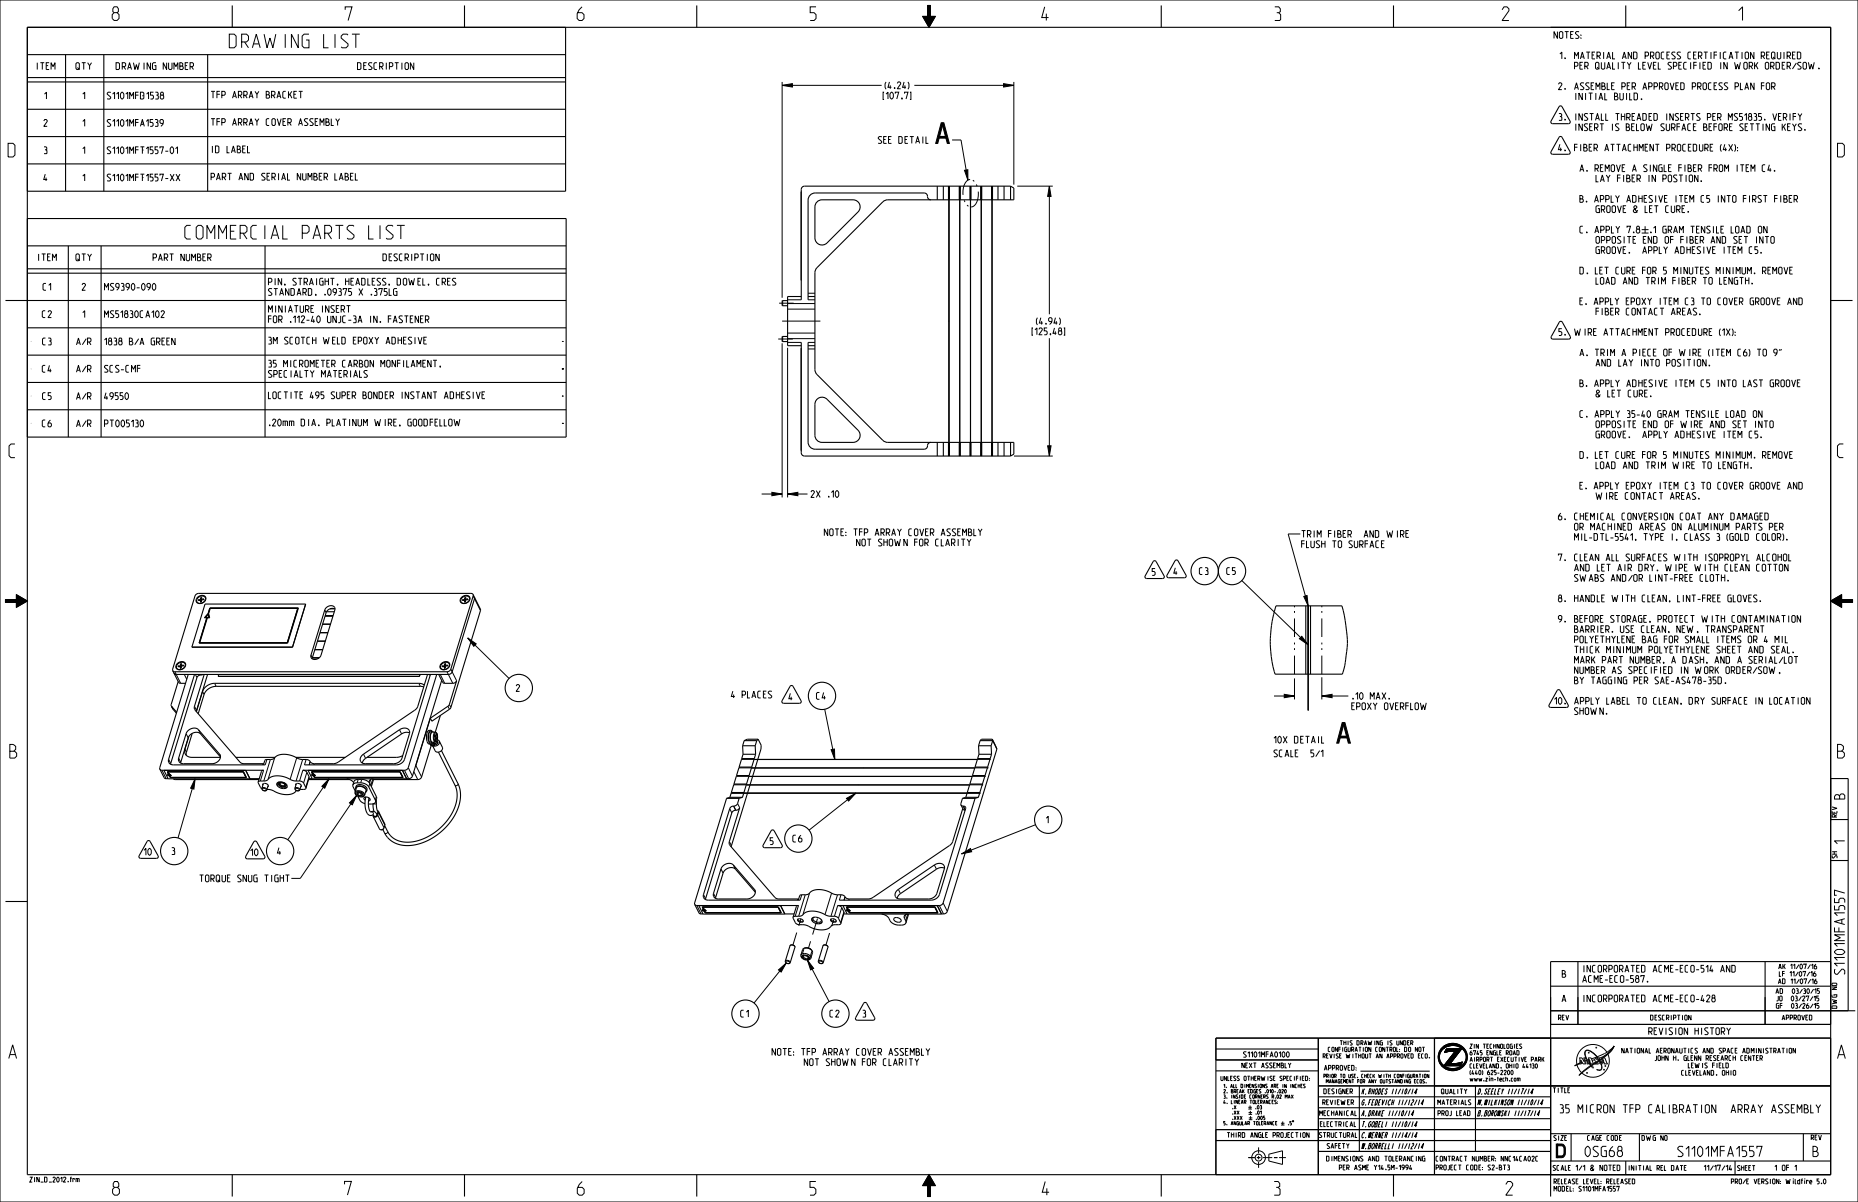
[picture p267: page 1]
SIZE; CAGE CODE; DWG NO; REV; SCALE; INITIAL REL DATE; SHEET; TITLE; UNLESS OTHERWISE; SPECIFIED:; 1. ALL DIMENSIONS ARE; INCHES; 2. BREAK; EDGES .010-.020; 3. INSIDE CORNERS R.02 MAX; LINEAR; TOLERANCES:; .01 .XXX #-; 5. ANGULAR; TOLERANCE #-; REVISION; HISTORY; MATERIALS; PROJ; LEAD; NEXT ASSEMBLY; MODEL: S1101MFA1557; ZIN_D_2012.frm; JOHN; H. GLENN RESEARCH CENTER; LEWIS FIELD; ENGLE ROAD; AIRPORT; EXECUTIVE PARK; MAX. EPOXY OVERFLOW; DRAWING LIST; ITEM; QTY; DRAWING NUMBER; DESCRIPTION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

NOTES:
MATERIAL AND PROCESS CERTIFICATION REQUIRED
ASSEMBLE PER APPROVED PROCESS PLAN FOR
INITIAL BUILD.
FIBER ATTACHMENT PROCEDURE (4X):
GROOVE & LET CURE.
C. APPLY 7.8#-
D. LET CURE FOR 5 MINUTES MINIMUM. REMOVE
LOAD AND TRIM FIBER TO LENGTH.
FIBER CONTACT AREAS.
AND LAY INTO POSITION.
& LET CURE.
C. APPLY 35-40 GRAM TENSILE LOAD ON
LOAD AND TRIM WIRE TO LENGTH.
CHEMICAL CONVERSION COAT ANY DAMAGED
OR MACHINED AREAS ON ALUMINUM PARTS PER
SWABS AND/OR LINT-FREE CLOTH.
THICK MINIMUM POLYETHYLENE SHEET AND SEAL.
MARK PART NUMBER, A DASH, AND A SERIAL/LOT
BY TAGGING PER SAE-AS478-35D.

COMMERCIAL PARTS LIST

.1 GRAM TENSILE LOAD ON

C1 | 2 | MS9390-090 | PIN, STRAIGHT, HEADLESS, DOWEL, CRES
C2 | 1 | MS51830CA102 | MINIATURE INSERT

NOTE: TFP ARRAY COVER ASSEMBLY
NOT SHOWN FOR CLARITY

TRIM FIBER AND WIRE
FLUSH TO SURFACE

1 DWG NO REV SH

TORQUE SNUG TIGHT

INCORPORATED ACME-ECO-514 AND ACME-ECO-587. B | AK 11/07/16 LF 11/07/16 AD 11/07/16

A | INCORPORATED ACME-ECO-428 | | AD 03/30/15 JO 03/27/15 GF 03/26/15

REV | DESCRIPTION | | APPROVED

THIS DRAWING IS UNDER

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

PRIOR TO USE, CHECK WITH CONFIGURATION
MANAGEMENT FOR ANY OUTSTANDING ECOS.

DESIGNER | | K.RHODES 11/10/14 | QUALITY | | D.SEELEY 11/17/14 | | | 35 MICRON TFP CALIBRATION ARRAY ASSEMBLY
REVIEWER | | G.FEDEVICH 11/12/14 | | | | | M.WILKINSON 11/10/14
A.DRAKE 11/10/14 | | | B.BOROWSKI 11/17/14
T.GOBELI 11/10/14
W.BORRELLI 11/12/14

MECHANICAL
ELECTRICAL
STRUCTURAL
D SAFETY
DIMENSIONS AND TOLERANCING
PER ASME Y14.5M-1994

THIRD ANGLE PROJECTION | | | | | | | | C.WERNER 11/14/14
