EmersonBJ/nasa-acme-burner-cad-cfd/PSI-Documents/Engineering Documents/Desenhos_Tecnicos_NASA/ACME_drawings_e-field_system/ACME_drawings_e-field_system/s1101mfp1735_A.pdf

D | D
8 | 7 | 6 | 5 | 4 | 3 | 1

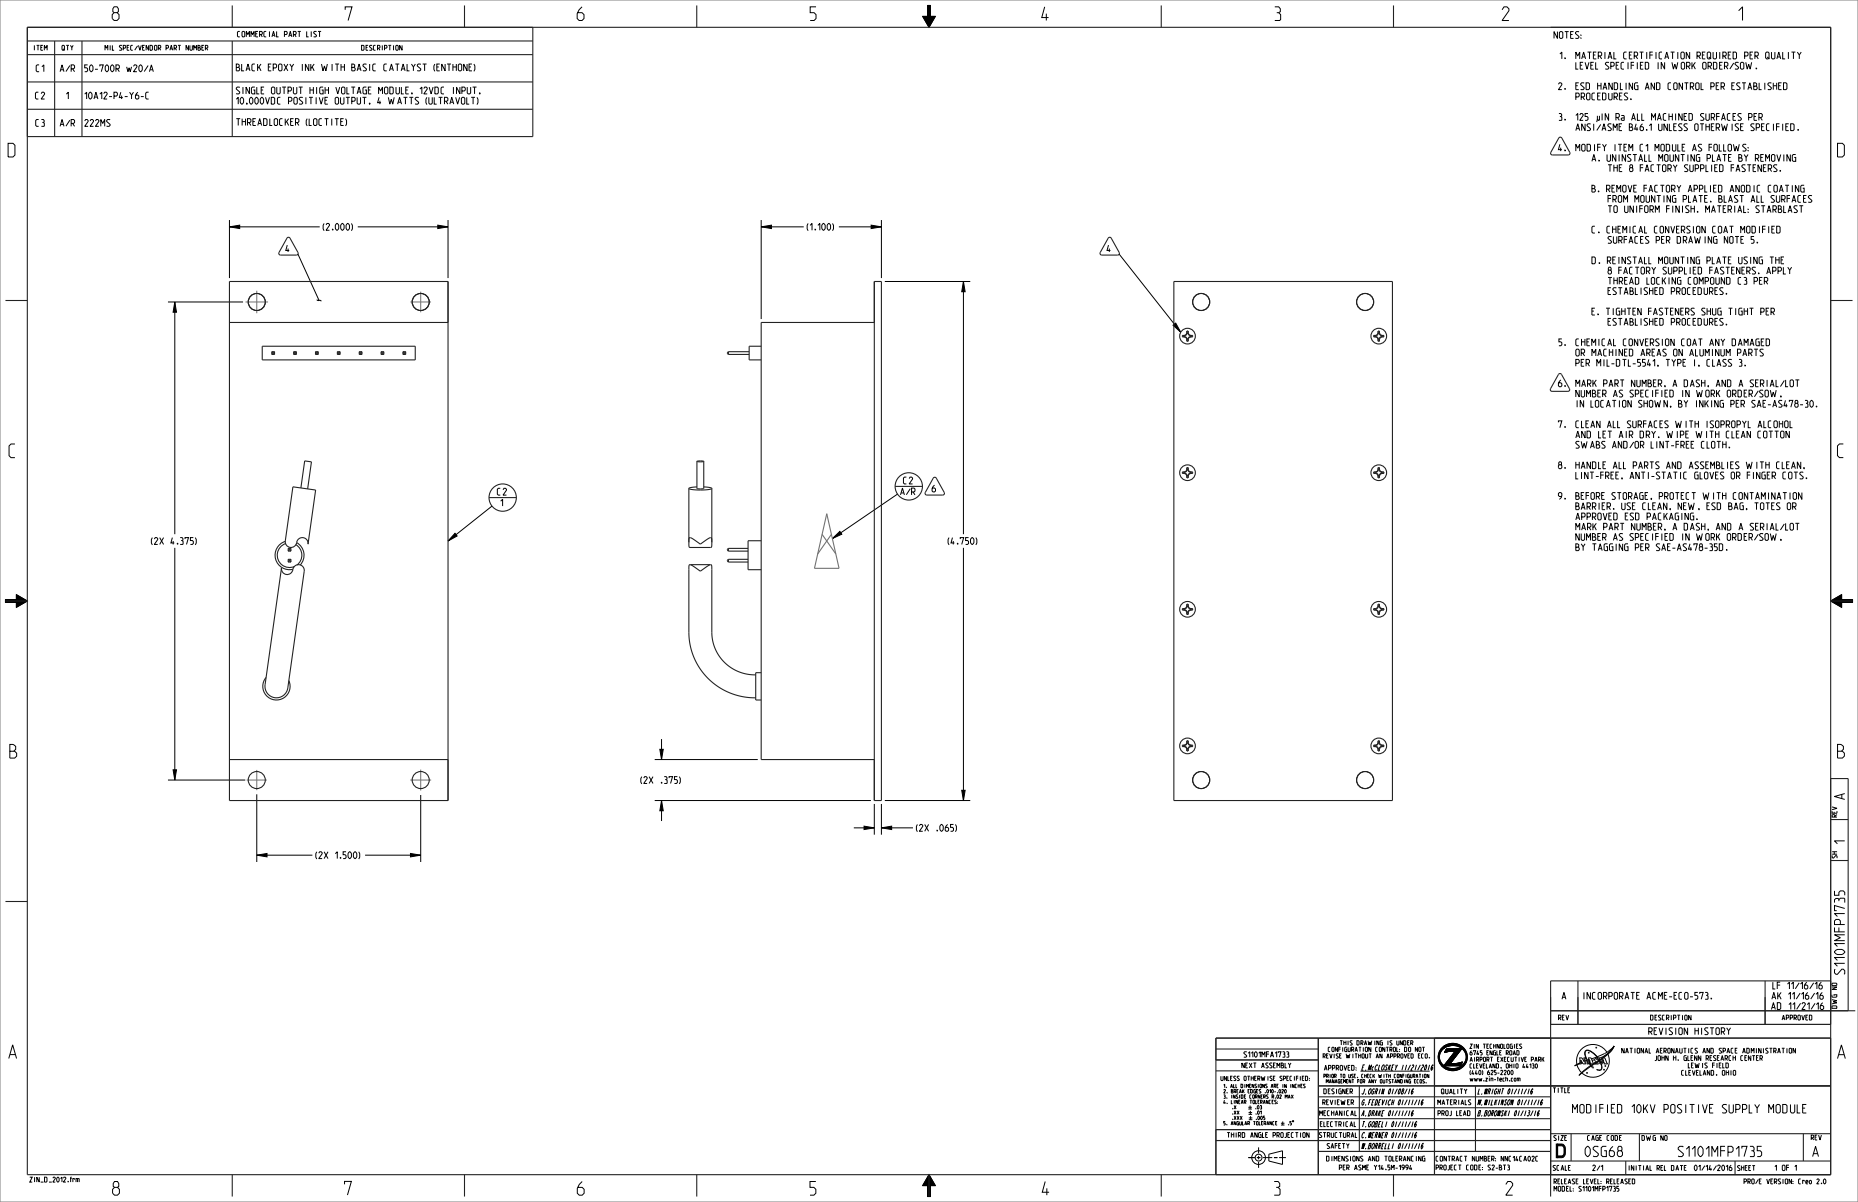
[picture p268: page 1]
SIZE; CAGE CODE; DWG NO; REV; SCALE; INITIAL REL DATE; SHEET; UNLESS OTHERWISE; SPECIFIED:; 1. ALL DIMENSIONS ARE; INCHES; 2. BREAK; EDGES .010-.020; LINEAR; TOLERANCES:; 5. ANGULAR; TOLERANCE #-; DESCRIPTION; APPROVED; REVISION; HISTORY; MATERIALS; PROJ; LEAD; MODEL: S1101MFP1735; ZIN_D_2012.frm; JOHN; H. GLENN RESEARCH CENTER; LEWIS FIELD; ENGLE ROAD; AIRPORT; EXECUTIVE PARK; LEVEL SPECIFIED; IN WORK ORDER/SOW.; D. REINSTALL MOUNTING PLATE USING; THE; PER MIL-DTL-5541,; TYPE; I, CLASS 3.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

COMMERCIAL PART LIST

NOTES:
MATERIAL CERTIFICATION REQUIRED PER QUALITY
ESD HANDLING AND CONTROL PER ESTABLISHED
PROCEDURES.
125 µIN Ra ALL MACHINED SURFACES PER
ANSI/ASME B46.1 UNLESS OTHERWISE SPECIFIED.
MODIFY ITEM C1 MODULE AS FOLLOWS:
A. UNINSTALL MOUNTING PLATE BY REMOVING
THE 8 FACTORY SUPPLIED FASTENERS.
B. REMOVE FACTORY APPLIED ANODIC COATING
FROM MOUNTING PLATE. BLAST ALL SURFACES
TO UNIFORM FINISH. MATERIAL: STARBLAST
C. CHEMICAL CONVERSION COAT MODIFIED
SURFACES PER DRAWING NOTE 5.
8 FACTORY SUPPLIED FASTENERS. APPLY
THREAD LOCKING COMPOUND C3 PER
ESTABLISHED PROCEDURES.
E. TIGHTEN FASTENERS SHUG TIGHT PER
CHEMICAL CONVERSION COAT ANY DAMAGED
OR MACHINED AREAS ON ALUMINUM PARTS
NUMBER AS SPECIFIED IN WORK ORDER/SOW,
IN LOCATION SHOWN, BY INKING PER SAE-AS478-30.
SWABS AND/OR LINT-FREE CLOTH.
LINT-FREE, ANTI-STATIC GLOVES OR FINGER COTS.
APPROVED ESD PACKAGING.
BY TAGGING PER SAE-AS478-35D.

C2 | 1 | 10A12-P4-Y6-C | | SINGLE OUTPUT HIGH VOLTAGE MODULE, 12VDC INPUT, 10,000VDC POSITIVE OUTPUT, 4 WATTS (ULTRAVOLT)

C3 | A/R | 222MS | THREADLOCKER (LOCTITE)

1 DWG NO REV SH

THIS DRAWING IS UNDER

CONFIGURATION CONTROL: DO NOT REVISE WITHOUT AN APPROVED ECO. APPROVED: E.McCLOSKEY 11/21/2016 | ZIN TECHNOLOGIES CLEVELAND, OHIO 44130 (440) 625-2200 www.zin-tech.com | | | NATIONAL AERONAUTICS AND SPACE ADMINISTRATION CLEVELAND, OHIO

NEXT ASSEMBLY

PRIOR TO USE, CHECK WITH CONFIGURATION
MANAGEMENT FOR ANY OUTSTANDING ECOS.

DESIGNER | | J.OGRIN 01/08/16 | QUALITY | | L.WRIGHT 01/11/16
REVIEWER | | G.FEDEVICH 01/11/16 | | | | | M.WILKINSON 01/11/16
A.DRAKE 01/11/16 | | | B.BOROWSKI 01/13/16
T.GOBELI 01/11/16
W.BORRELLI 01/11/16

TITLE
MODIFIED 10KV POSITIVE SUPPLY MODULE

3. INSIDE CORNERS R.02 MAX | .XX #-.XXX #-

MECHANICAL
ELECTRICAL
STRUCTURAL
D SAFETY
DIMENSIONS AND TOLERANCING
PER ASME Y14.5M-1994

THIRD ANGLE PROJECTION | | | | | | | | C.WERNER 01/11/16
