EmersonBJ/nasa-acme-burner-cad-cfd/PSI-Documents/Engineering Documents/Desenhos_Tecnicos_NASA/ACME_drawings_e-field_system/MFD_Pecas_Individuais/s1101mfd1715_A.pdf

D | D
8 | 7 | 6 | 5 | 4 | 3 | 2 | 1

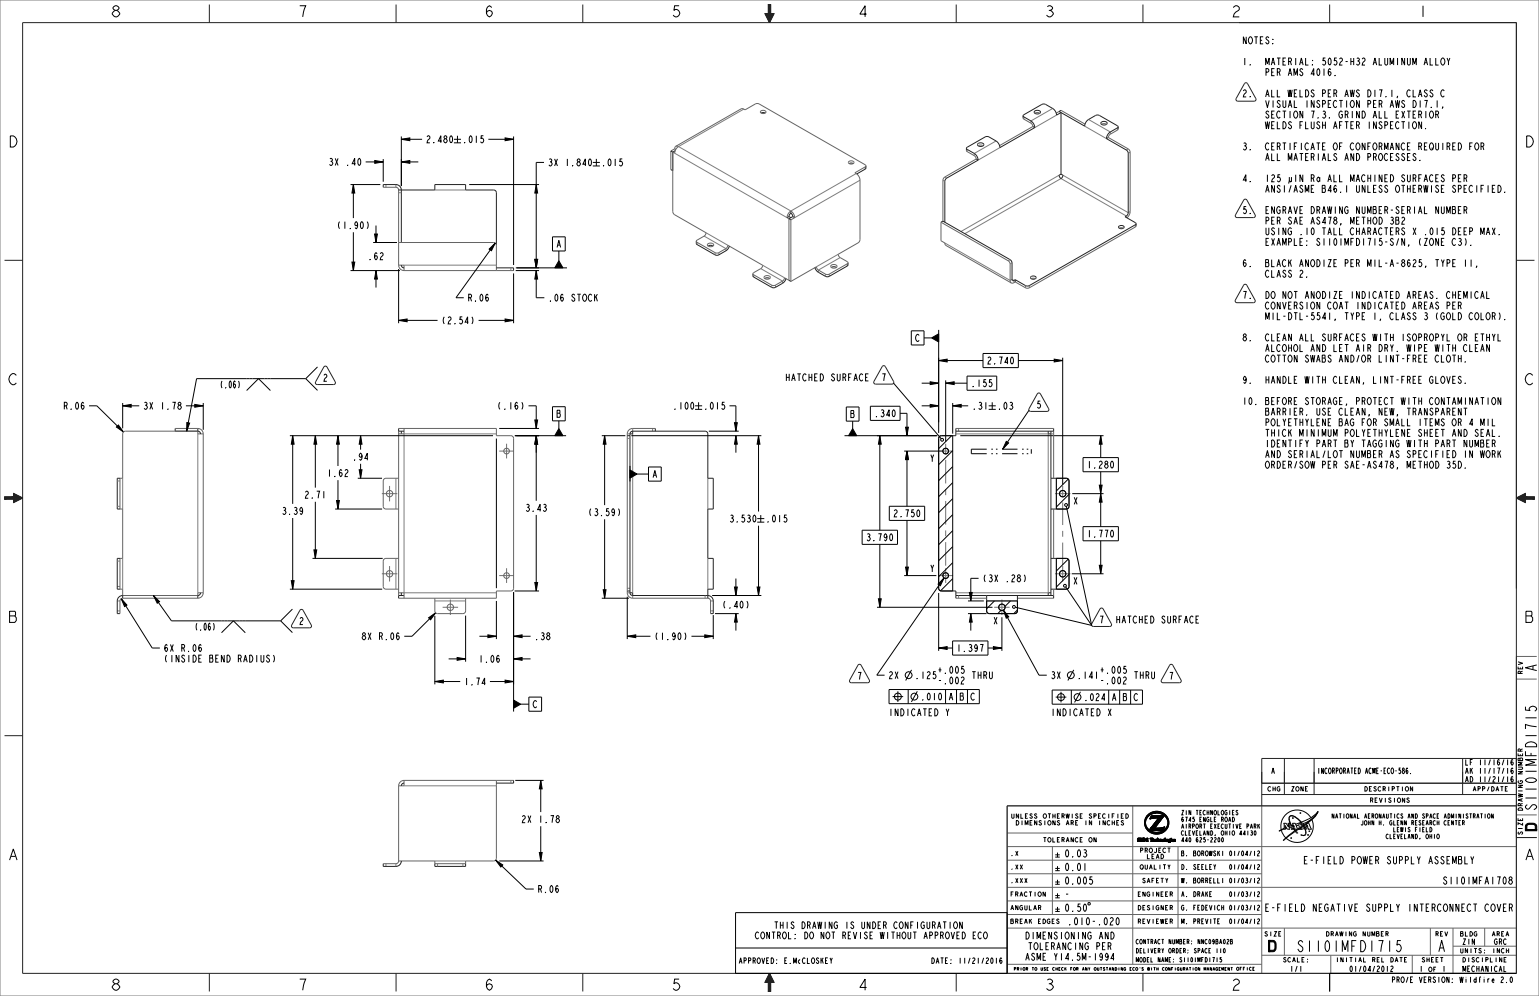
[picture p269: page 1]
6X R (INSIDE BEND RADIUS); THRU; INDICATED Y; INDICATED X; INCORPORATED ACME-ECO-586.; .06 STOCK; APPROVED: E.McCLOSKEY; DATE: 11/21/2016; WELDS FLUSH; AFTER INSPECTION.; 4. 125 µIN Ra; ALL MACHINED SURFACES PER; ANSI/ASME B46.1; UNLESS OTHERWISE SPECIFIED.; CONVERSION COAT; INDICATED AREAS PER; 8. CLEAN ALL SURFACES WITH; ISOPROPYL OR ETHYL; ALCOHOL AND LET; AIR DRY. WIPE WITH; CLEAN; 9. HANDLE WITH; CLEAN, LINT-FREE GLOVES.; 10. BEFORE STORAGE, PROTECT; WITH; CONTAMINATION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

NOTES:
1. MATERIAL: 5052-H32 ALUMINUM ALLOY
PER AMS 4016.
2. ALL WELDS PER AWS D17.1, CLASS C
VISUAL INSPECTION PER AWS D17.1,
SECTION 7.3. GRIND ALL EXTERIOR
3. CERTIFICATE OF CONFORMANCE REQUIRED FOR
ALL MATERIALS AND PROCESSES.
5. ENGRAVE DRAWING NUMBER-SERIAL NUMBER
PER SAE AS478, METHOD 3B2
USING .10 TALL CHARACTERS X .015 DEEP MAX.
EXAMPLE: S1101MFD1715-S/N, (ZONE C3).
6. BLACK ANODIZE PER MIL-A-8625, TYPE II,
CLASS 2.
7. DO NOT ANODIZE INDICATED AREAS. CHEMICAL
MIL-DTL-5541, TYPE I, CLASS 3 (GOLD COLOR).
COTTON SWABS AND/OR LINT-FREE CLOTH.
BARRIER. USE CLEAN, NEW, TRANSPARENT
POLYETHYLENE BAG FOR SMALL ITEMS OR 4 MIL
ORDER/SOW PER SAE-AS478, METHOD 35D.

CHG | | ZONE | DESCRIPTION | | APP/DATE

REVISIONS

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

JOHN H. GLENN RESEARCH CENTER

LEAD .X | B. BOROWSKI 01/04/12 PROJECT 0.03 | E-FIELD POWER SUPPLY ASSEMBLY S1101MFA1708
.XX | 0.01 | QUALITY | D. SEELEY 01/04/12
.XXX | 0.005 | SAFETY | W. BORRELLI 01/03/12
FRACTION | - | ENGINEER | A. DRAKE 01/03/12 | E-FIELD NEGATIVE SUPPLY INTERCONNECT COVER
ANGULAR | 0.50 | DESIGNER | G. FEDEVICH 01/03/12
BREAK EDGES .010-.020 | | REVIEWER | M. PREVITE 01/04/12

THIS DRAWING IS UNDER CONFIGURATION
CONTROL: DO NOT REVISE WITHOUT APPROVED ECO

PRO/E VERSION: Wildfire 2.0
