EmersonBJ/nasa-acme-burner-cad-cfd/PSI-Documents/Engineering Documents/Desenhos_Tecnicos_NASA/ACME_drawings_e-field_system/MFD_Pecas_Individuais/s1101mfd1718_A.pdf

D | D
8 | 7 | 6 | 5 | 4 | 3 | 2 | 1

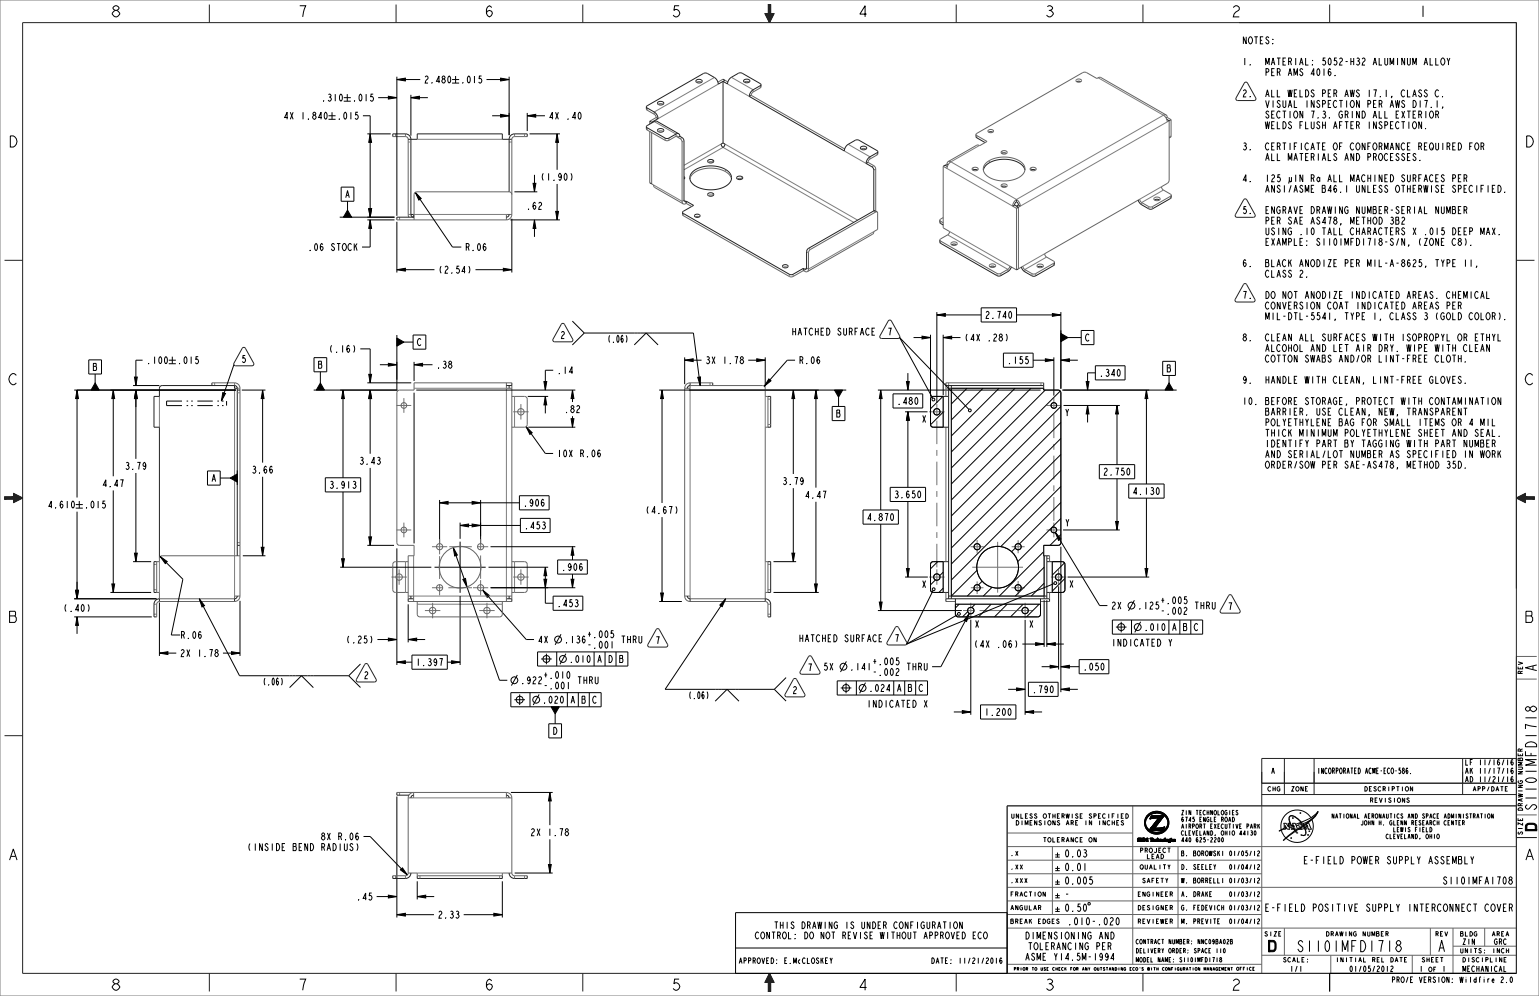
[picture p270: page 1]
THRU +.010; THRU; INDICATED Y; INDICATED X; THRU +.005; INCORPORATED ACME-ECO-586.; .06 STOCK; APPROVED: E.McCLOSKEY; DATE: 11/21/2016; WELDS FLUSH; AFTER INSPECTION.; 4. 125 µIN Ra; ALL MACHINED SURFACES PER; ANSI/ASME B46.1; UNLESS OTHERWISE SPECIFIED.; SIZE D; DRAWING NUMBER; S1101MFD1718; REV A; PRIOR TO USE CHECK FOR ANY OUTSTANDING ECO'S WITH CONFIGURATION MANAGEMENT OFFICE; MECHANICAL; MODEL NAME: S1101MFD1718; SCALE:; INITIAL REL DATE; SHEET; DISCIPLINE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

NOTES:
1. MATERIAL: 5052-H32 ALUMINUM ALLOY
PER AMS 4016.
2. ALL WELDS PER AWS 17.1, CLASS C.
VISUAL INSPECTION PER AWS D17.1,
SECTION 7.3. GRIND ALL EXTERIOR
3. CERTIFICATE OF CONFORMANCE REQUIRED FOR
ALL MATERIALS AND PROCESSES.
5. ENGRAVE DRAWING NUMBER-SERIAL NUMBER
PER SAE AS478, METHOD 3B2
USING .10 TALL CHARACTERS X .015 DEEP MAX.
EXAMPLE: S1101MFD1718-S/N, (ZONE C8).
6. BLACK ANODIZE PER MIL-A-8625, TYPE II,
CLASS 2.
7. DO NOT ANODIZE INDICATED AREAS. CHEMICAL
CONVERSION COAT INDICATED AREAS PER
MIL-DTL-5541, TYPE I, CLASS 3 (GOLD COLOR).
8. CLEAN ALL SURFACES WITH ISOPROPYL OR ETHYL
ALCOHOL AND LET AIR DRY. WIPE WITH CLEAN
COTTON SWABS AND/OR LINT-FREE CLOTH.
9. HANDLE WITH CLEAN, LINT-FREE GLOVES.
10. BEFORE STORAGE, PROTECT WITH CONTAMINATION
BARRIER. USE CLEAN, NEW, TRANSPARENT
POLYETHYLENE BAG FOR SMALL ITEMS OR 4 MIL
THICK MINIMUM POLYETHYLENE SHEET AND SEAL.
IDENTIFY PART BY TAGGING WITH PART NUMBER
AND SERIAL/LOT NUMBER AS SPECIFIED IN WORK
ORDER/SOW PER SAE-AS478, METHOD 35D.

CHG | | ZONE | DESCRIPTION | | APP/DATE

REVISIONS

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

JOHN H. GLENN RESEARCH CENTER

(INSIDE BEND RADIUS)

LEAD .X | B. BOROWSKI 01/05/12 PROJECT 0.03 | E-FIELD POWER SUPPLY ASSEMBLY S1101MFA1708
.XX | 0.01 | QUALITY | D. SEELEY 01/04/12
.XXX | 0.005 | SAFETY | W. BORRELLI 01/03/12
FRACTION | - | ENGINEER | A. DRAKE 01/03/12 | E-FIELD POSITIVE SUPPLY INTERCONNECT COVER
ANGULAR | 0.50 | DESIGNER | G. FEDEVICH 01/03/12
BREAK EDGES .010-.020 | | REVIEWER | M. PREVITE 01/04/12

THIS DRAWING IS UNDER CONFIGURATION
CONTROL: DO NOT REVISE WITHOUT APPROVED ECO

PRO/E VERSION: Wildfire 2.0
