EmersonBJ/nasa-acme-burner-cad-cfd/PSI-Documents/Engineering Documents/Desenhos_Tecnicos_NASA/ACME_drawings_burners/MFA_Montagens/s1101mfa1220_B.pdf

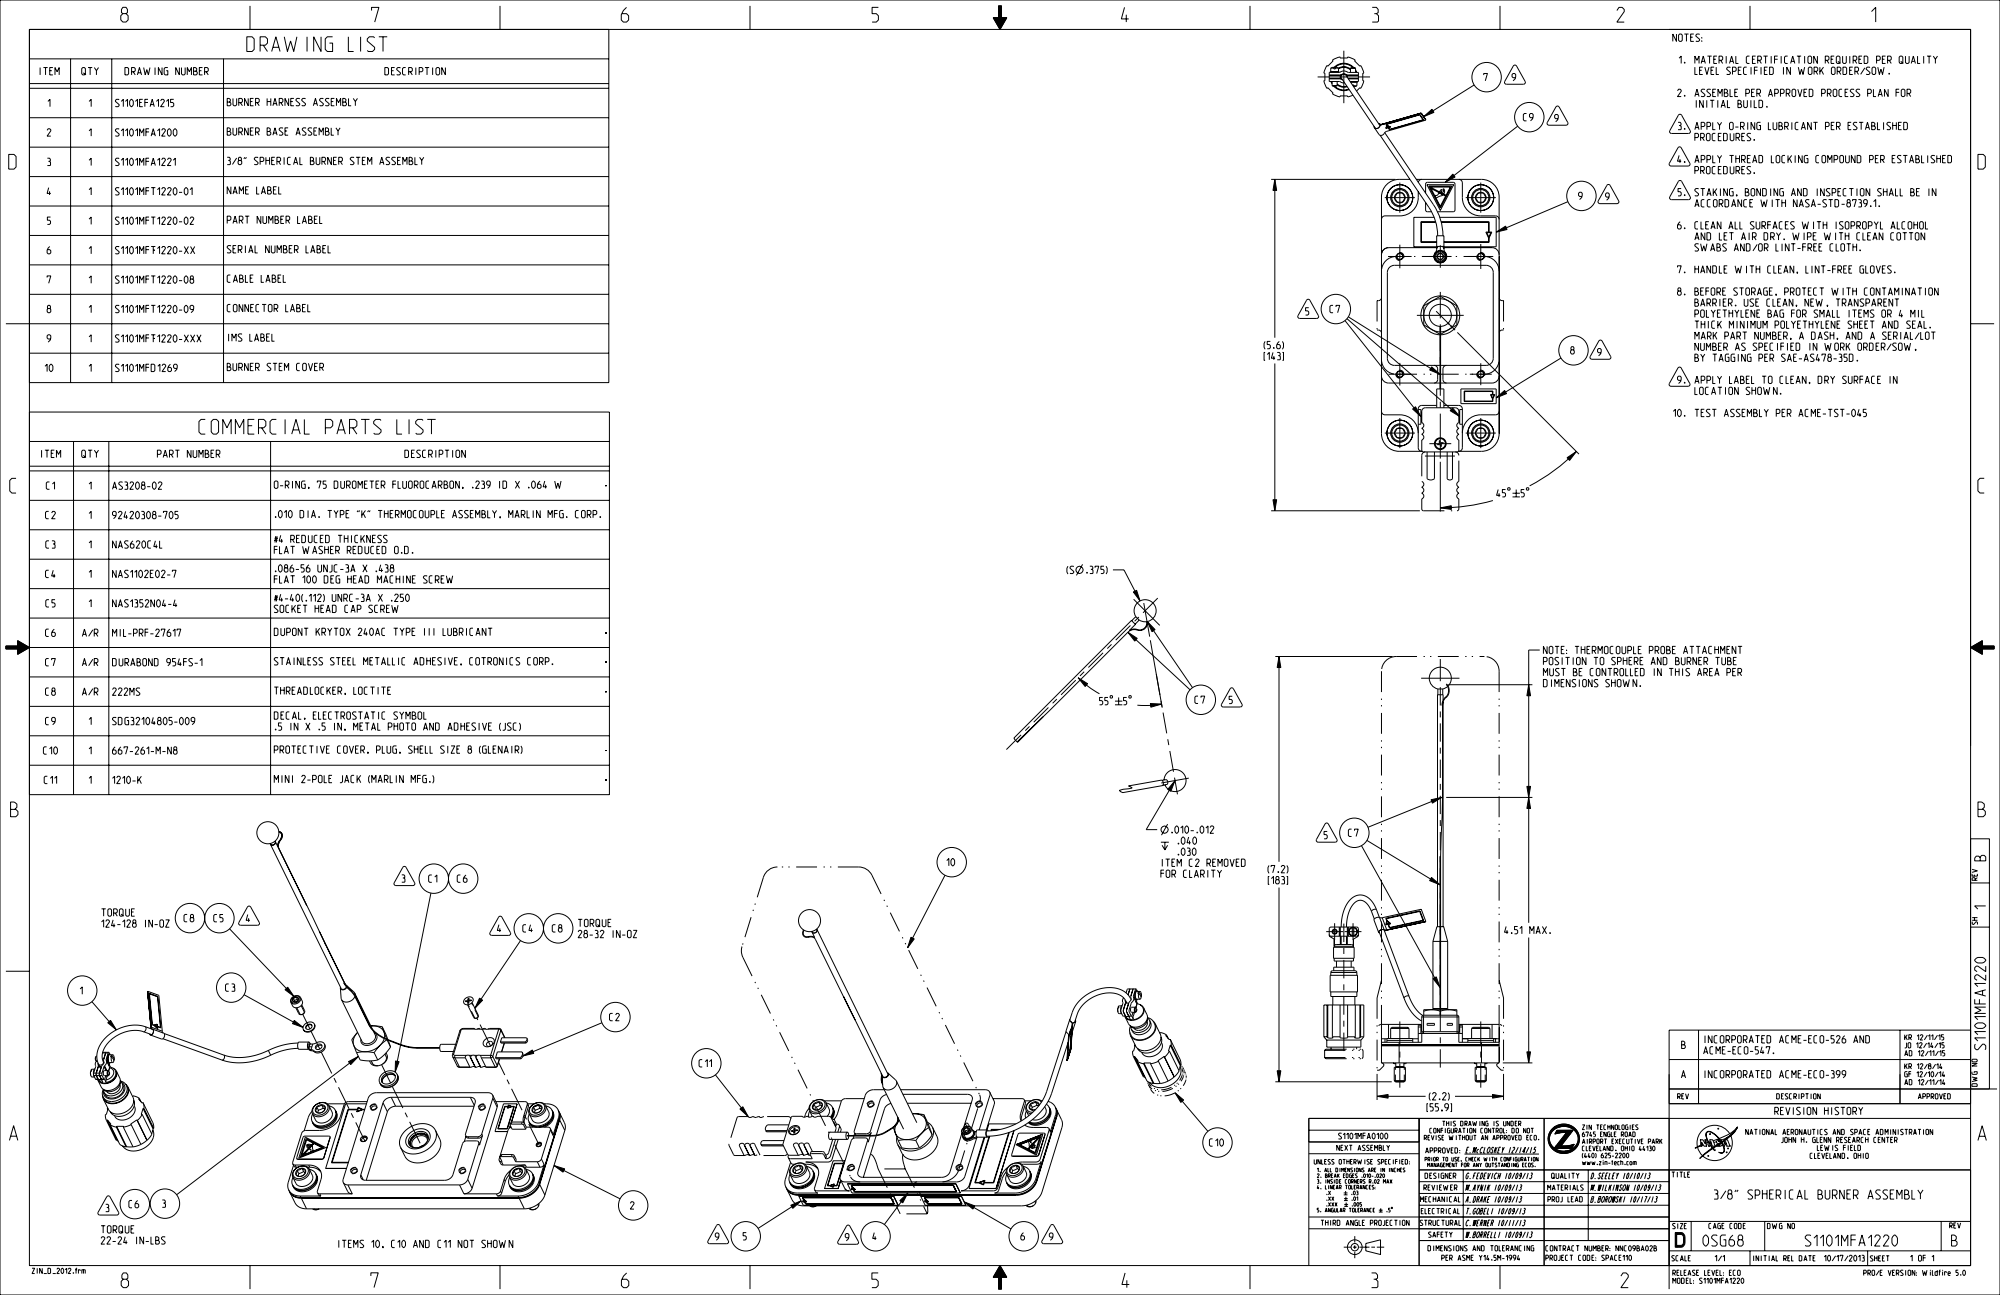
[picture p272: page 1]
