EmersonBJ/nasa-acme-burner-cad-cfd/PSI-Documents/Engineering Documents/Desenhos_Tecnicos_NASA/ACME_drawings_burners/MFA_Montagens/s1101mfa1223_A.pdf

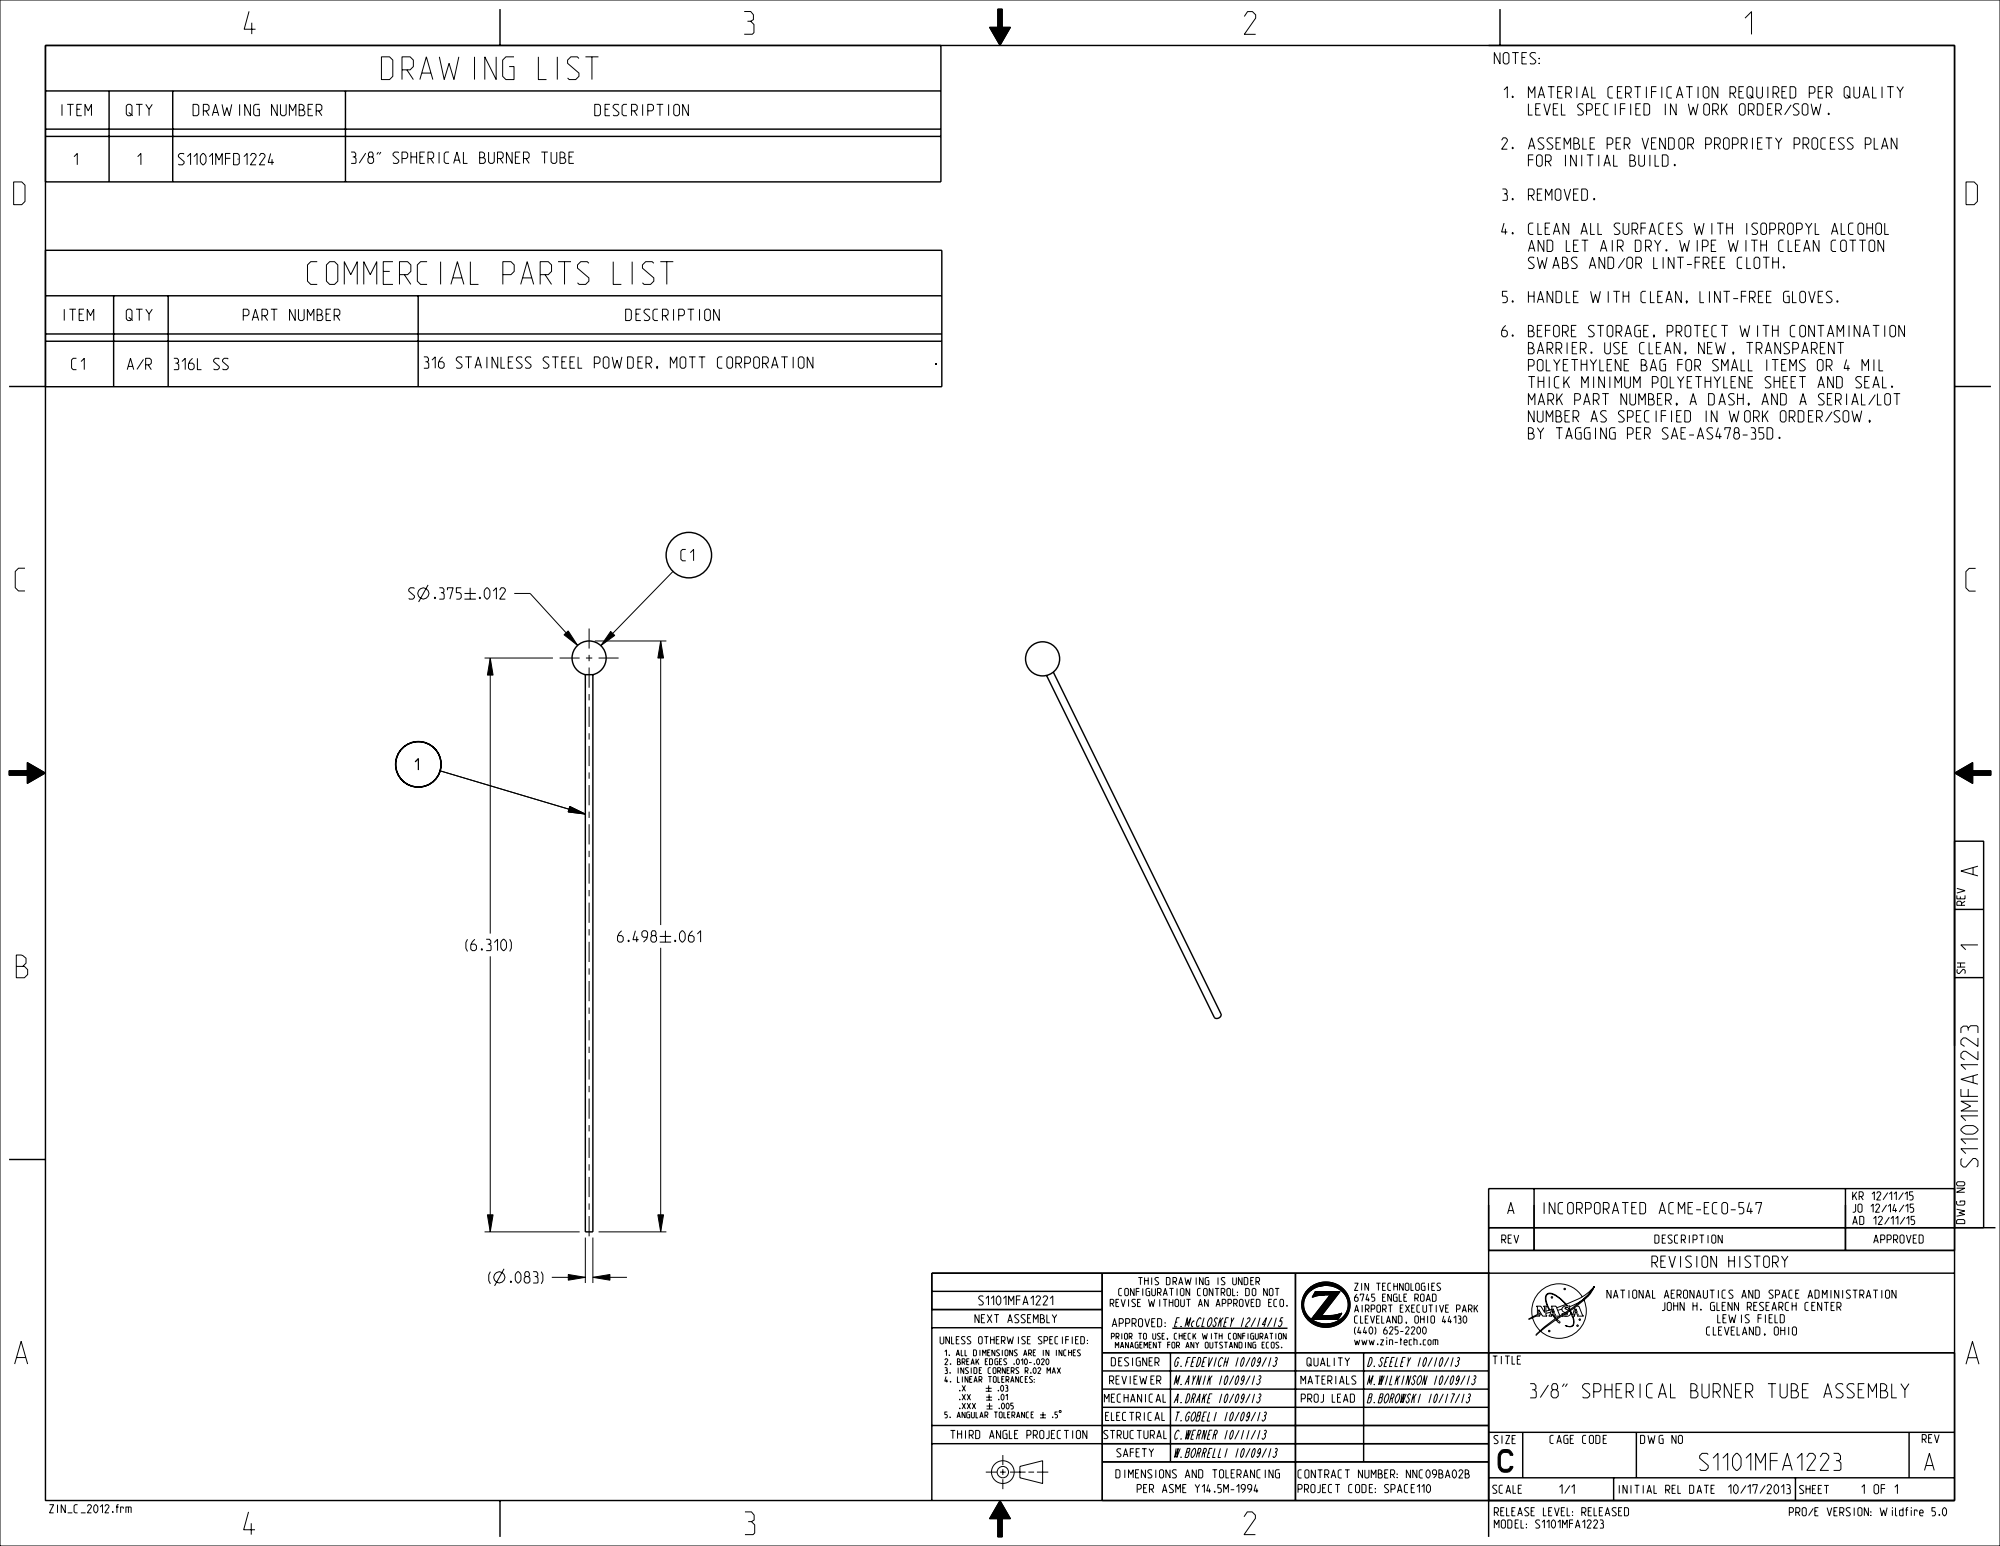
[picture p273: page 1]
