EmersonBJ/nasa-acme-burner-cad-cfd/PSI-Documents/Engineering Documents/Desenhos_Tecnicos_NASA/ACME_drawings_burners/MFA_Montagens/s1101mfa1230_C.pdf

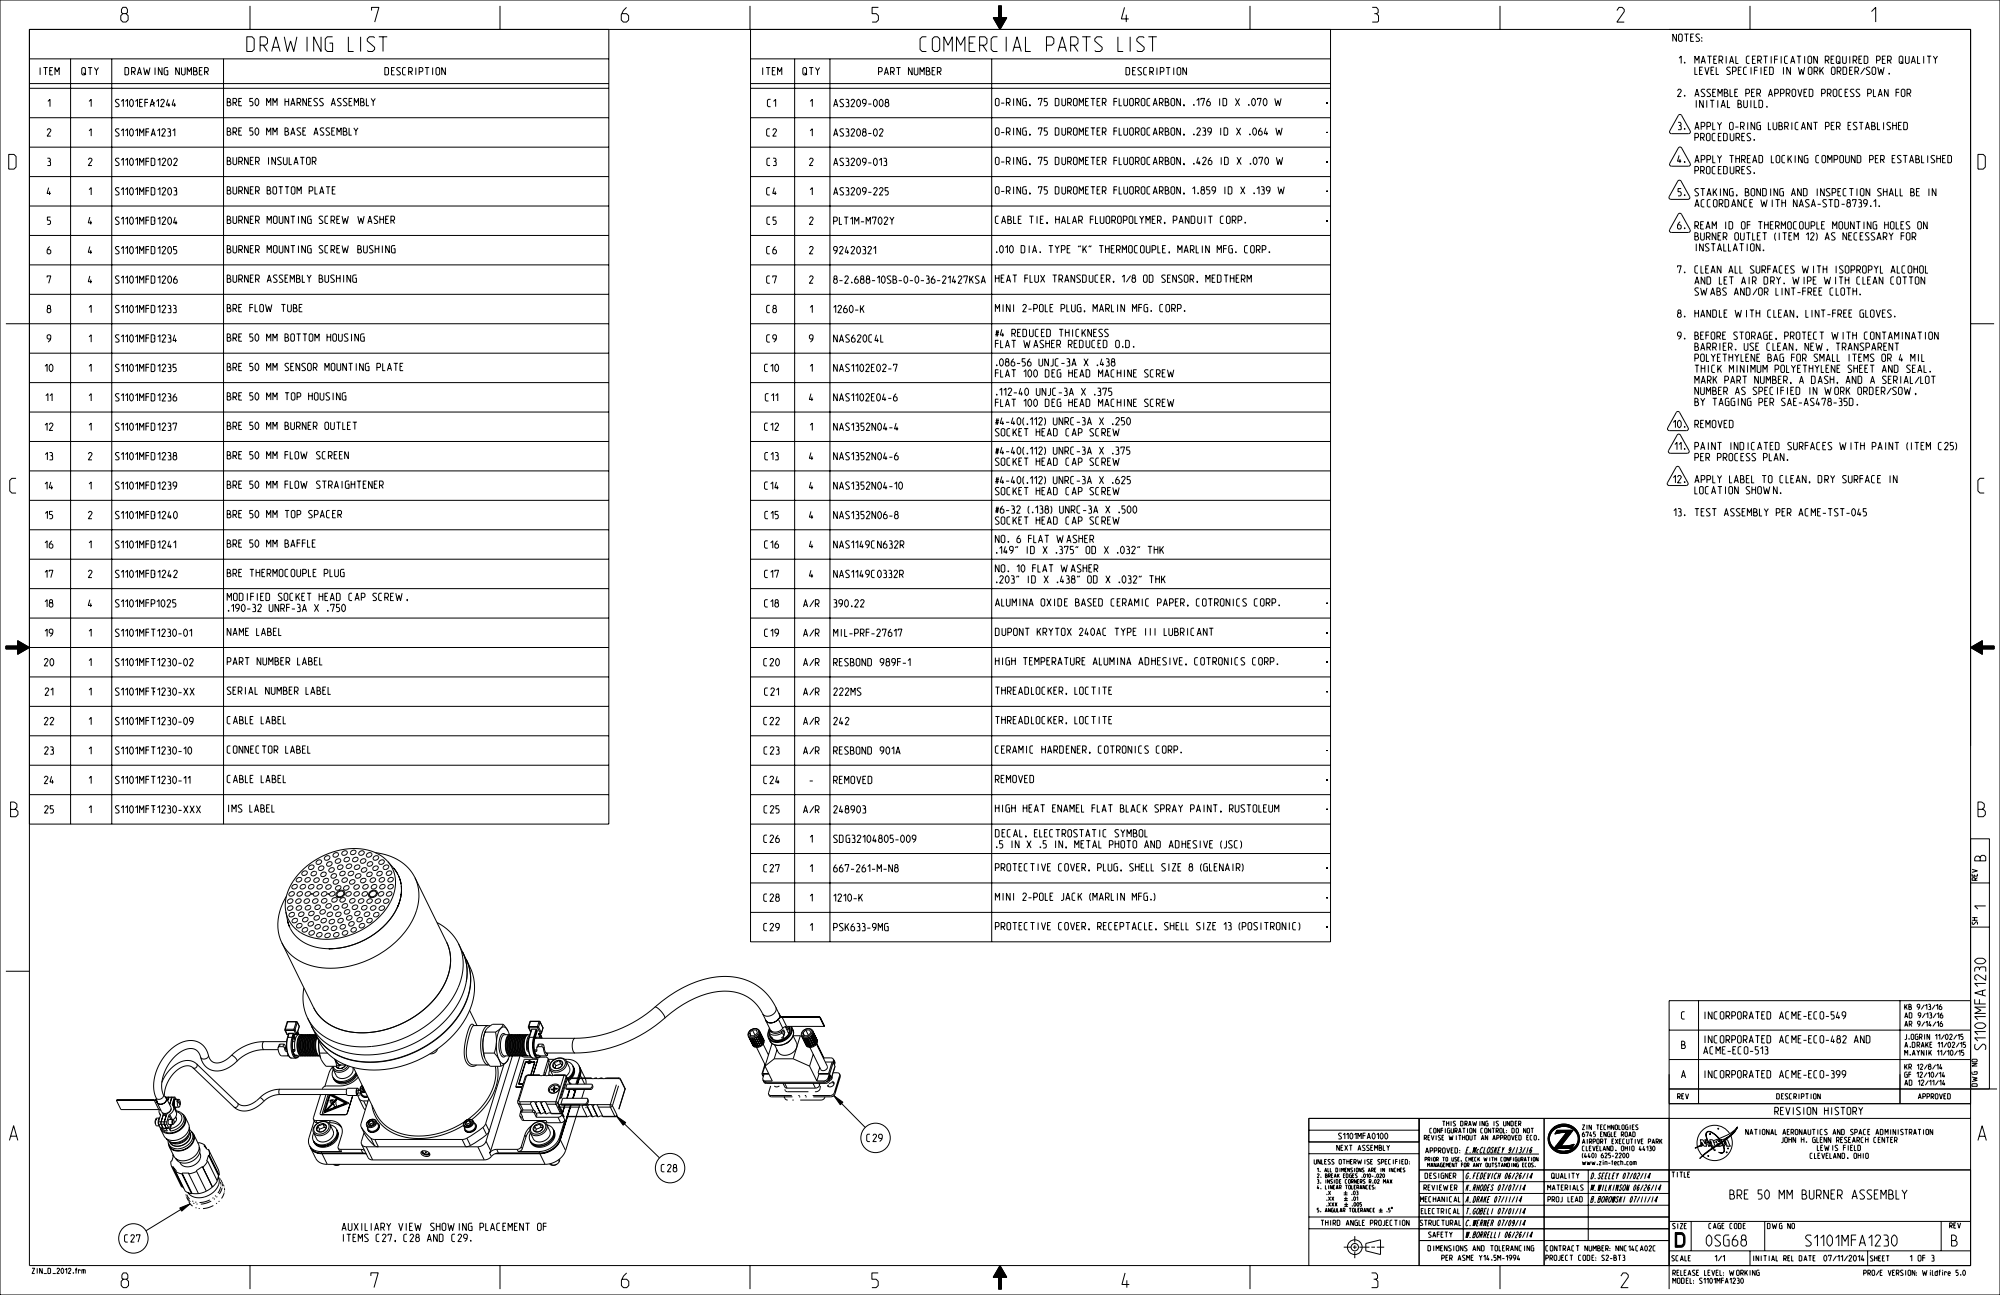
[picture p275: page 1]

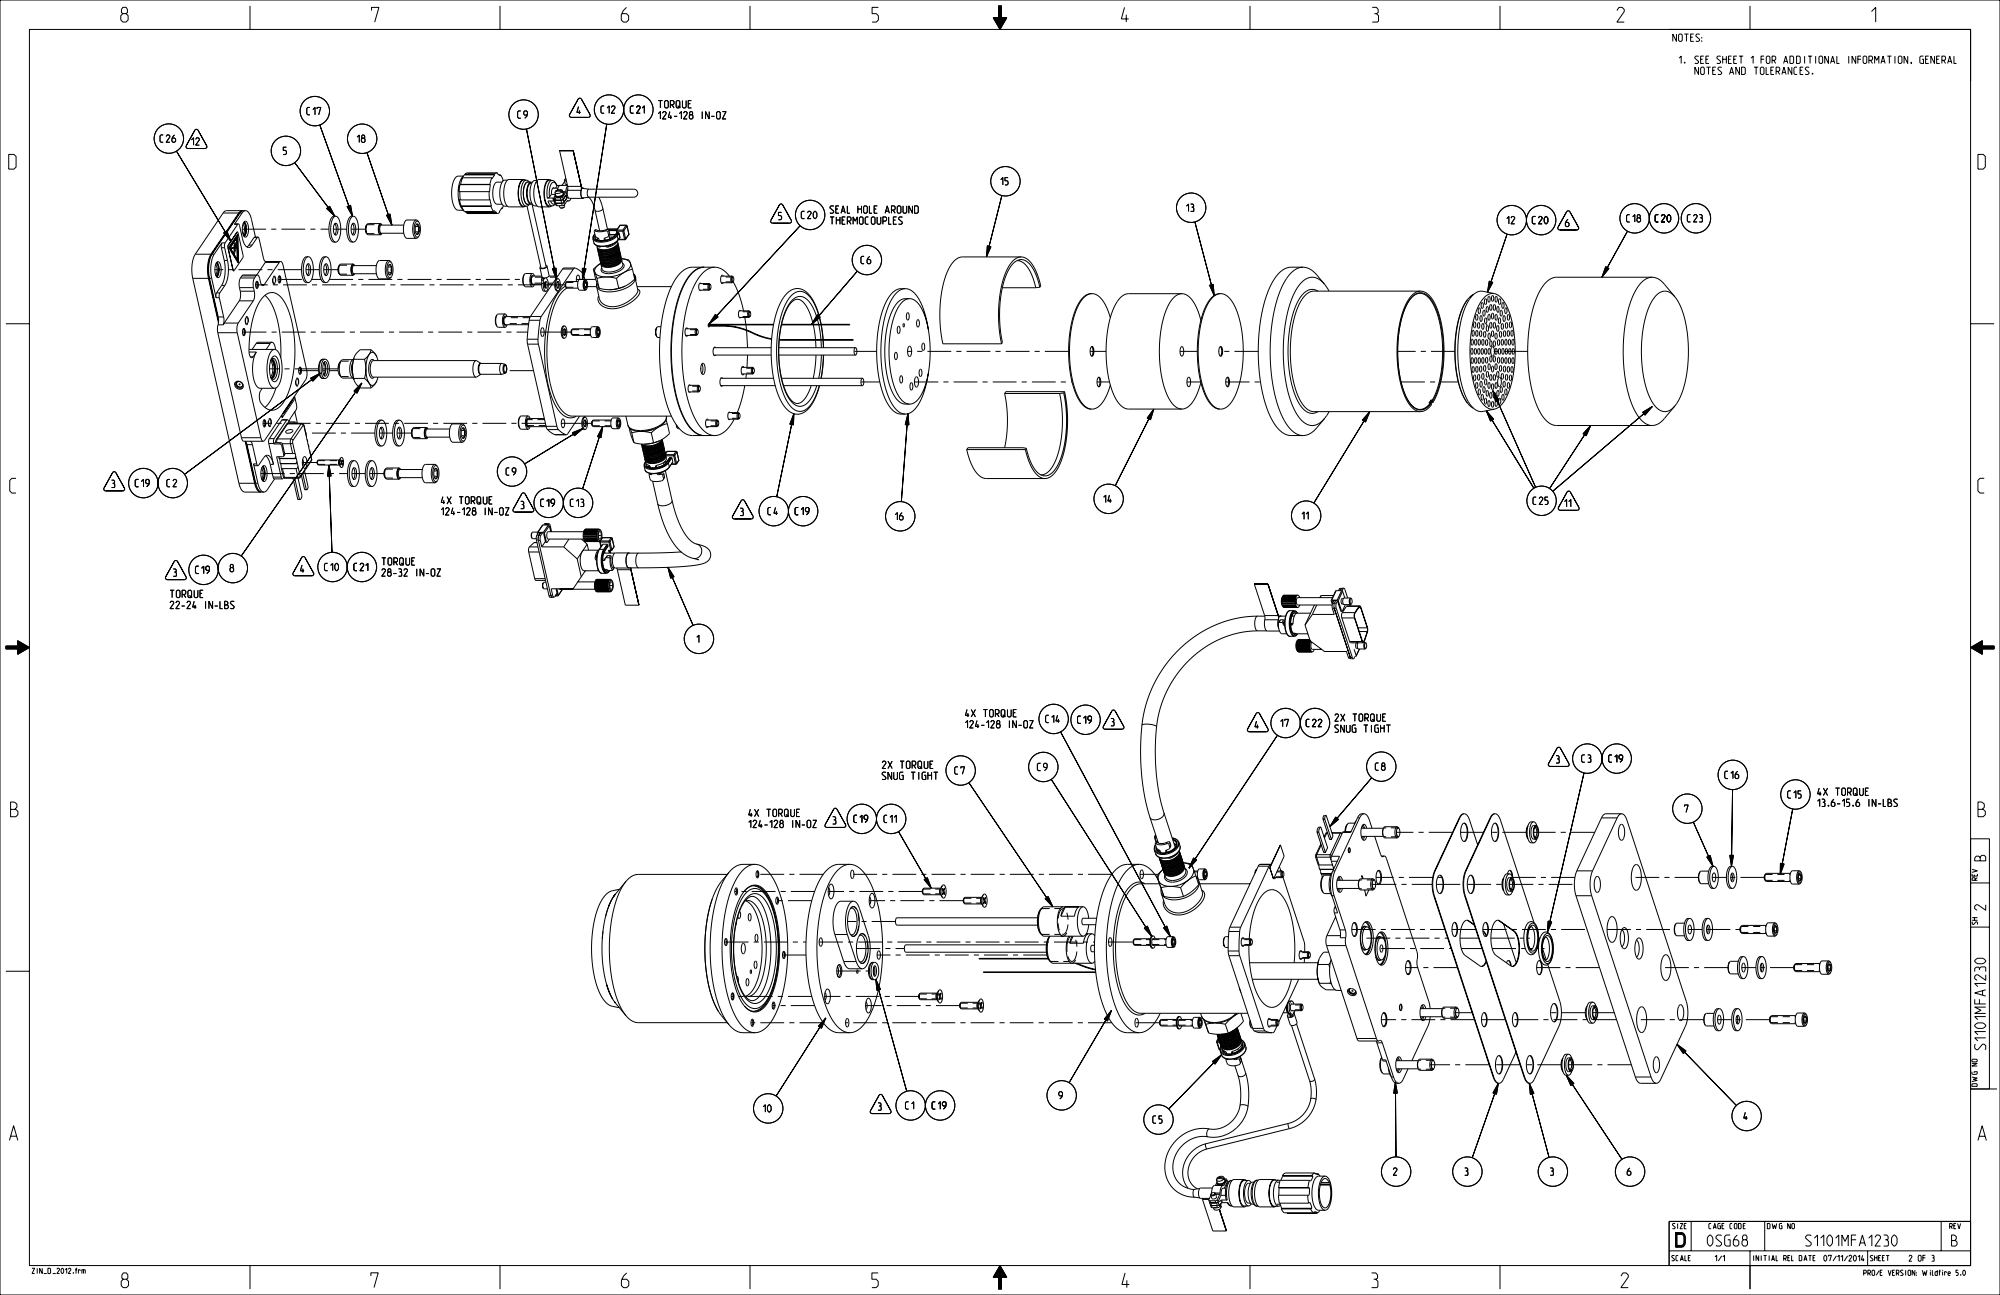
[picture p276: page 2]

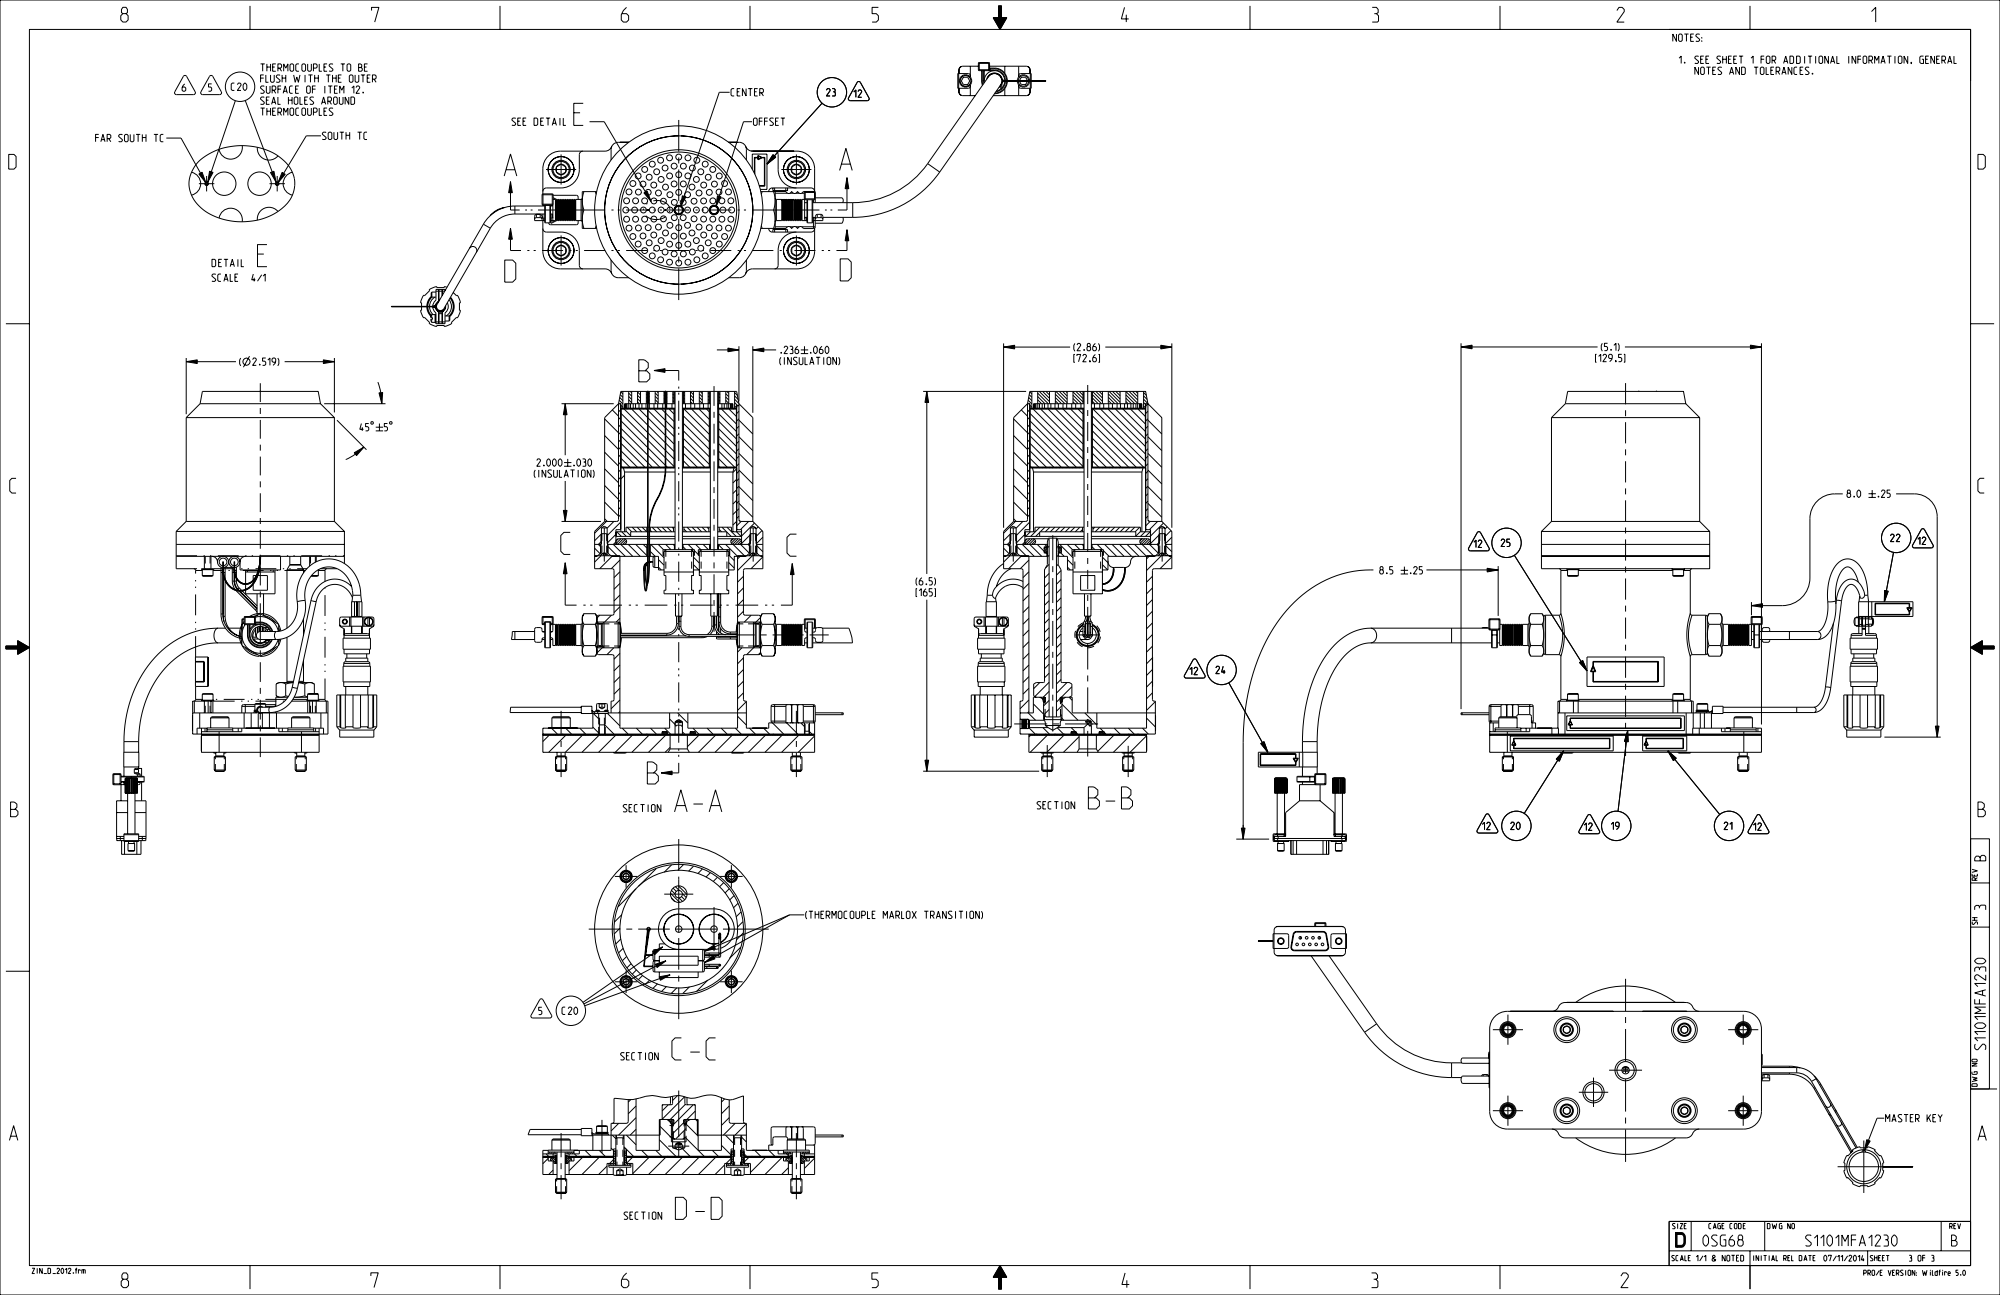
[picture p277: page 3]
