EmersonBJ/nasa-acme-burner-cad-cfd/PSI-Documents/Engineering Documents/Desenhos_Tecnicos_NASA/ACME_drawings_e-field_system/MFA_Montagens/s1101mfa1700_D.pdf

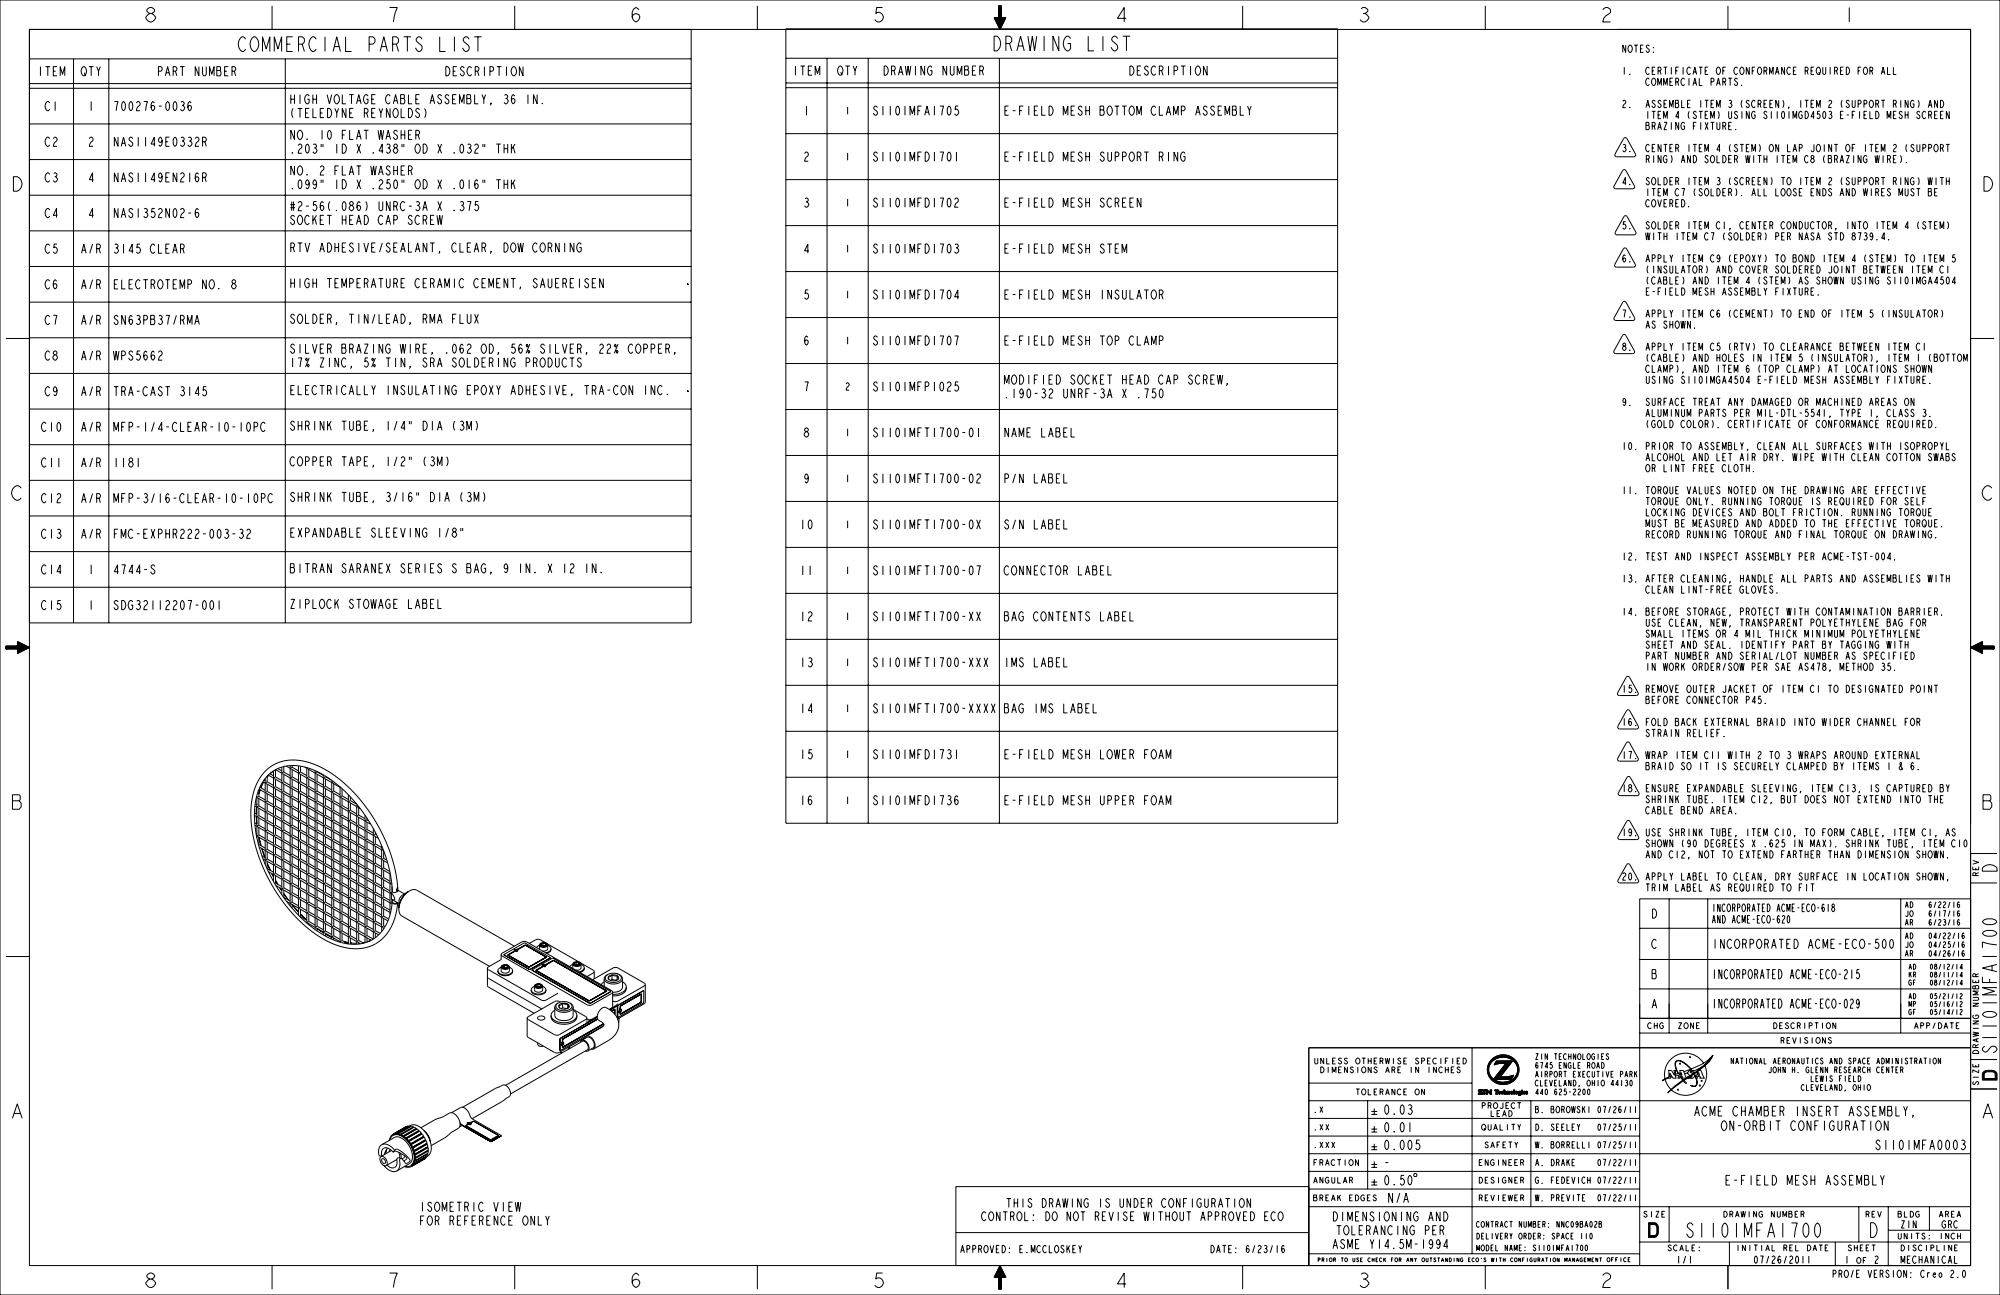
[picture p280: page 1]

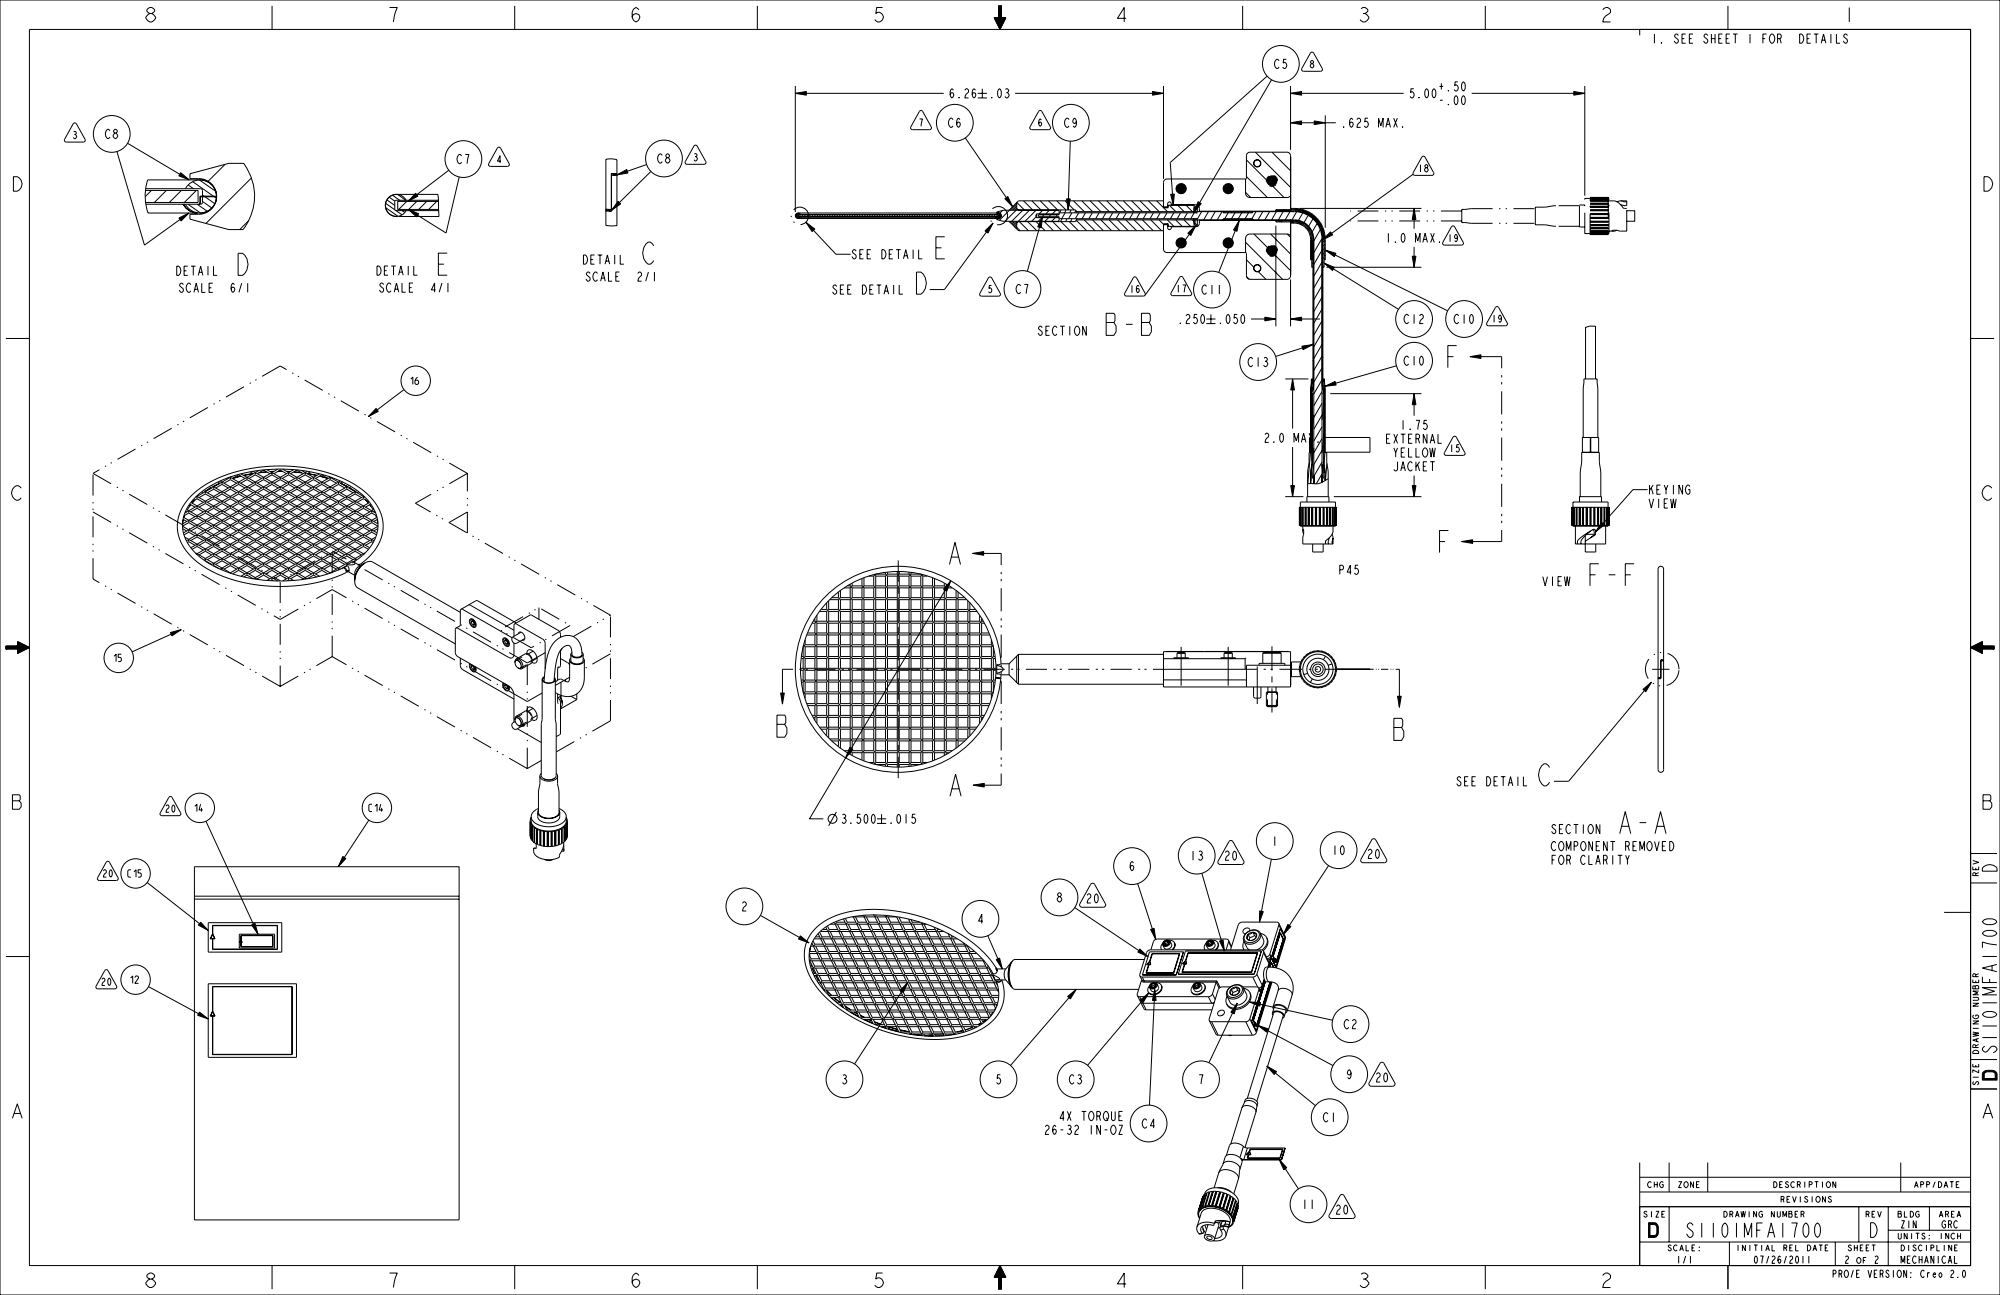
[picture p281: page 2]
