EmersonBJ/nasa-acme-burner-cad-cfd/PSI-Documents/Engineering Documents/Desenhos_Tecnicos_NASA/ACME_drawings_e-field_system/MFA_Montagens/s1101mfa1708_B.pdf

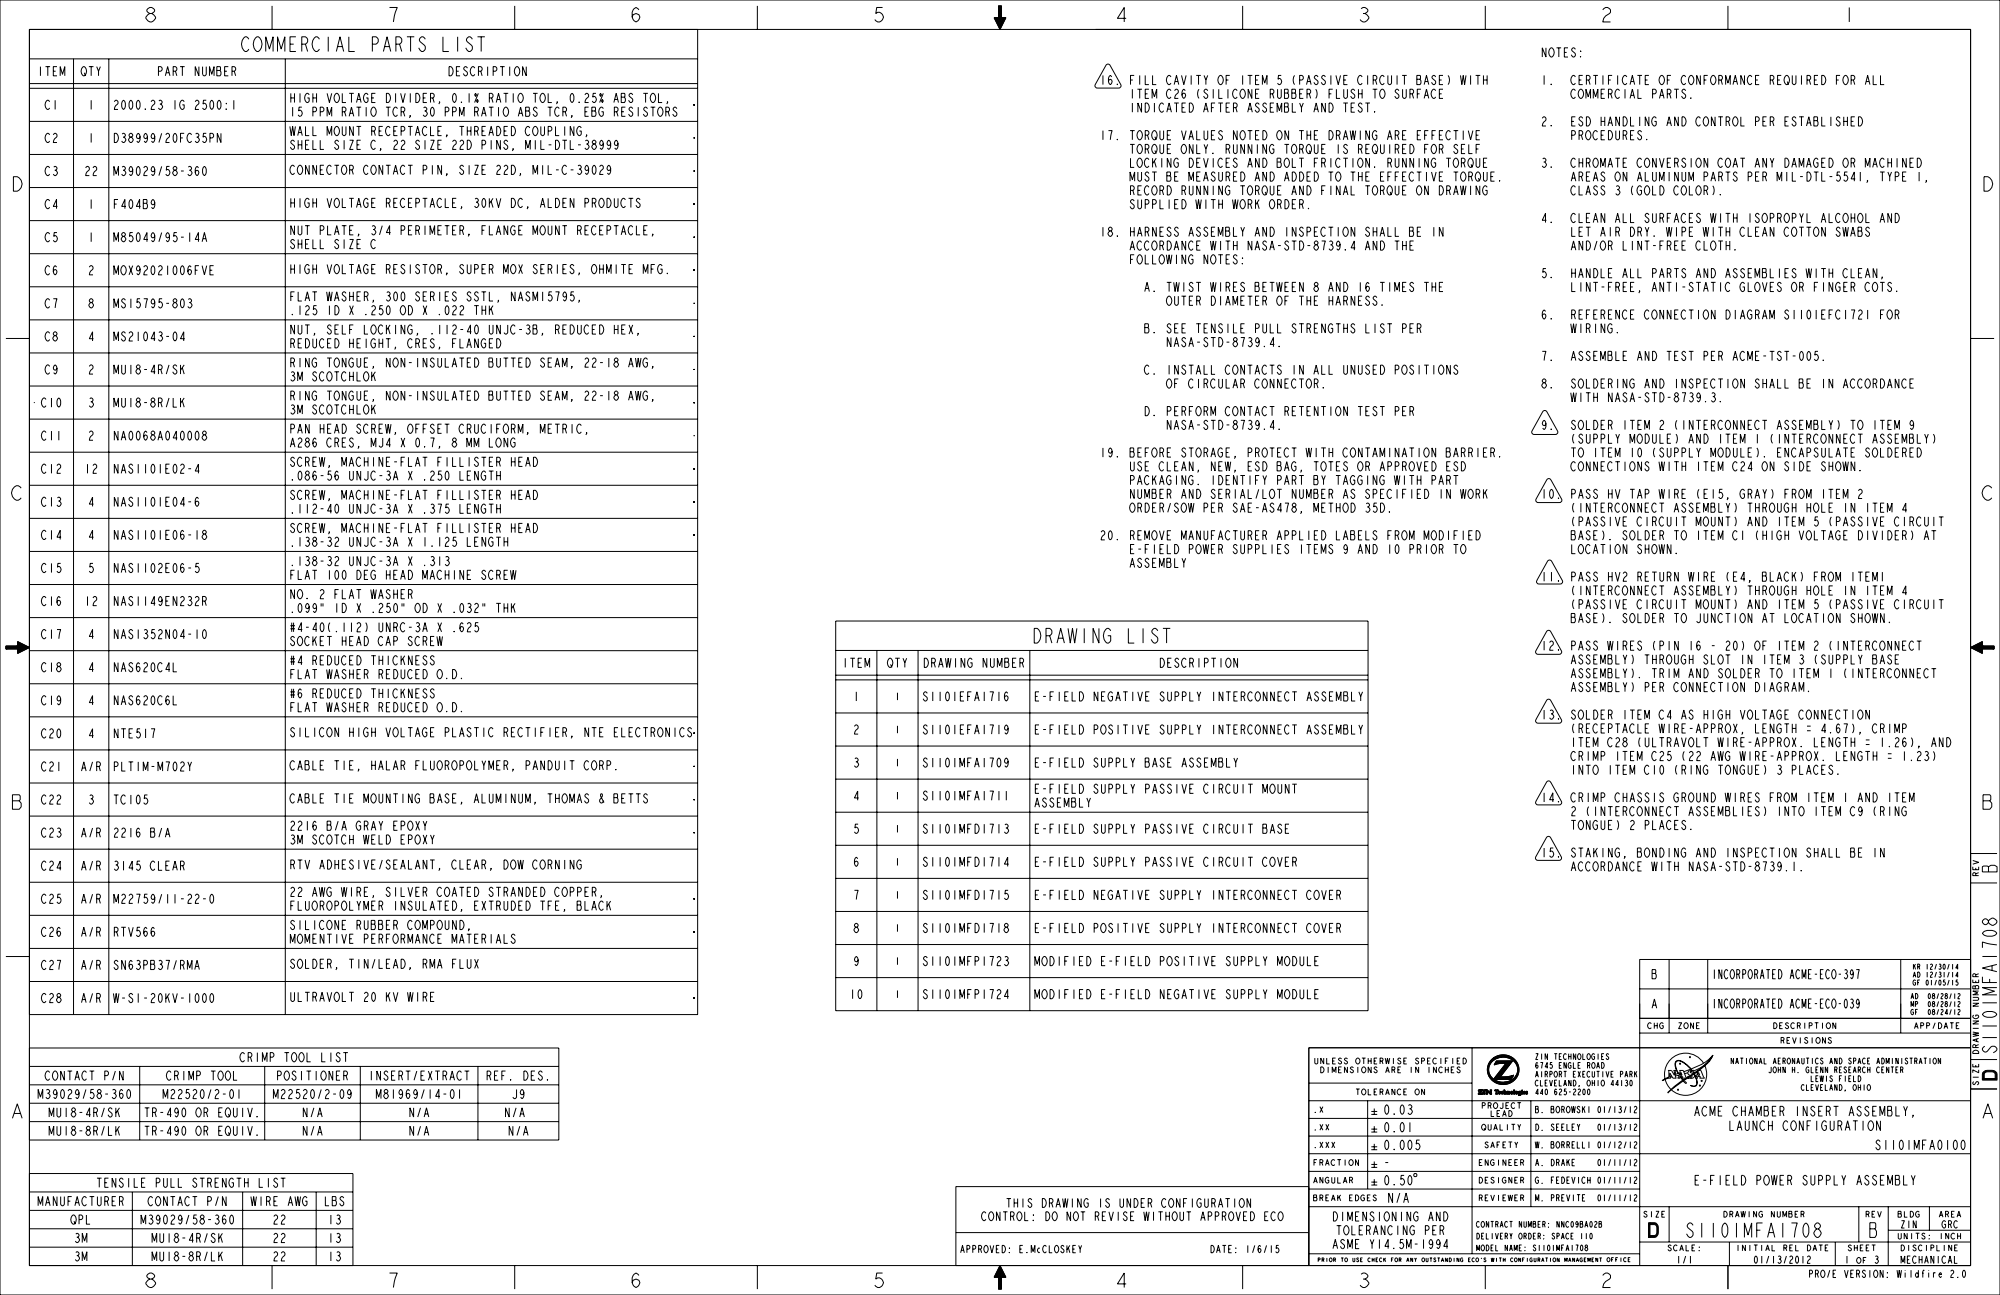
[picture p283: page 1]

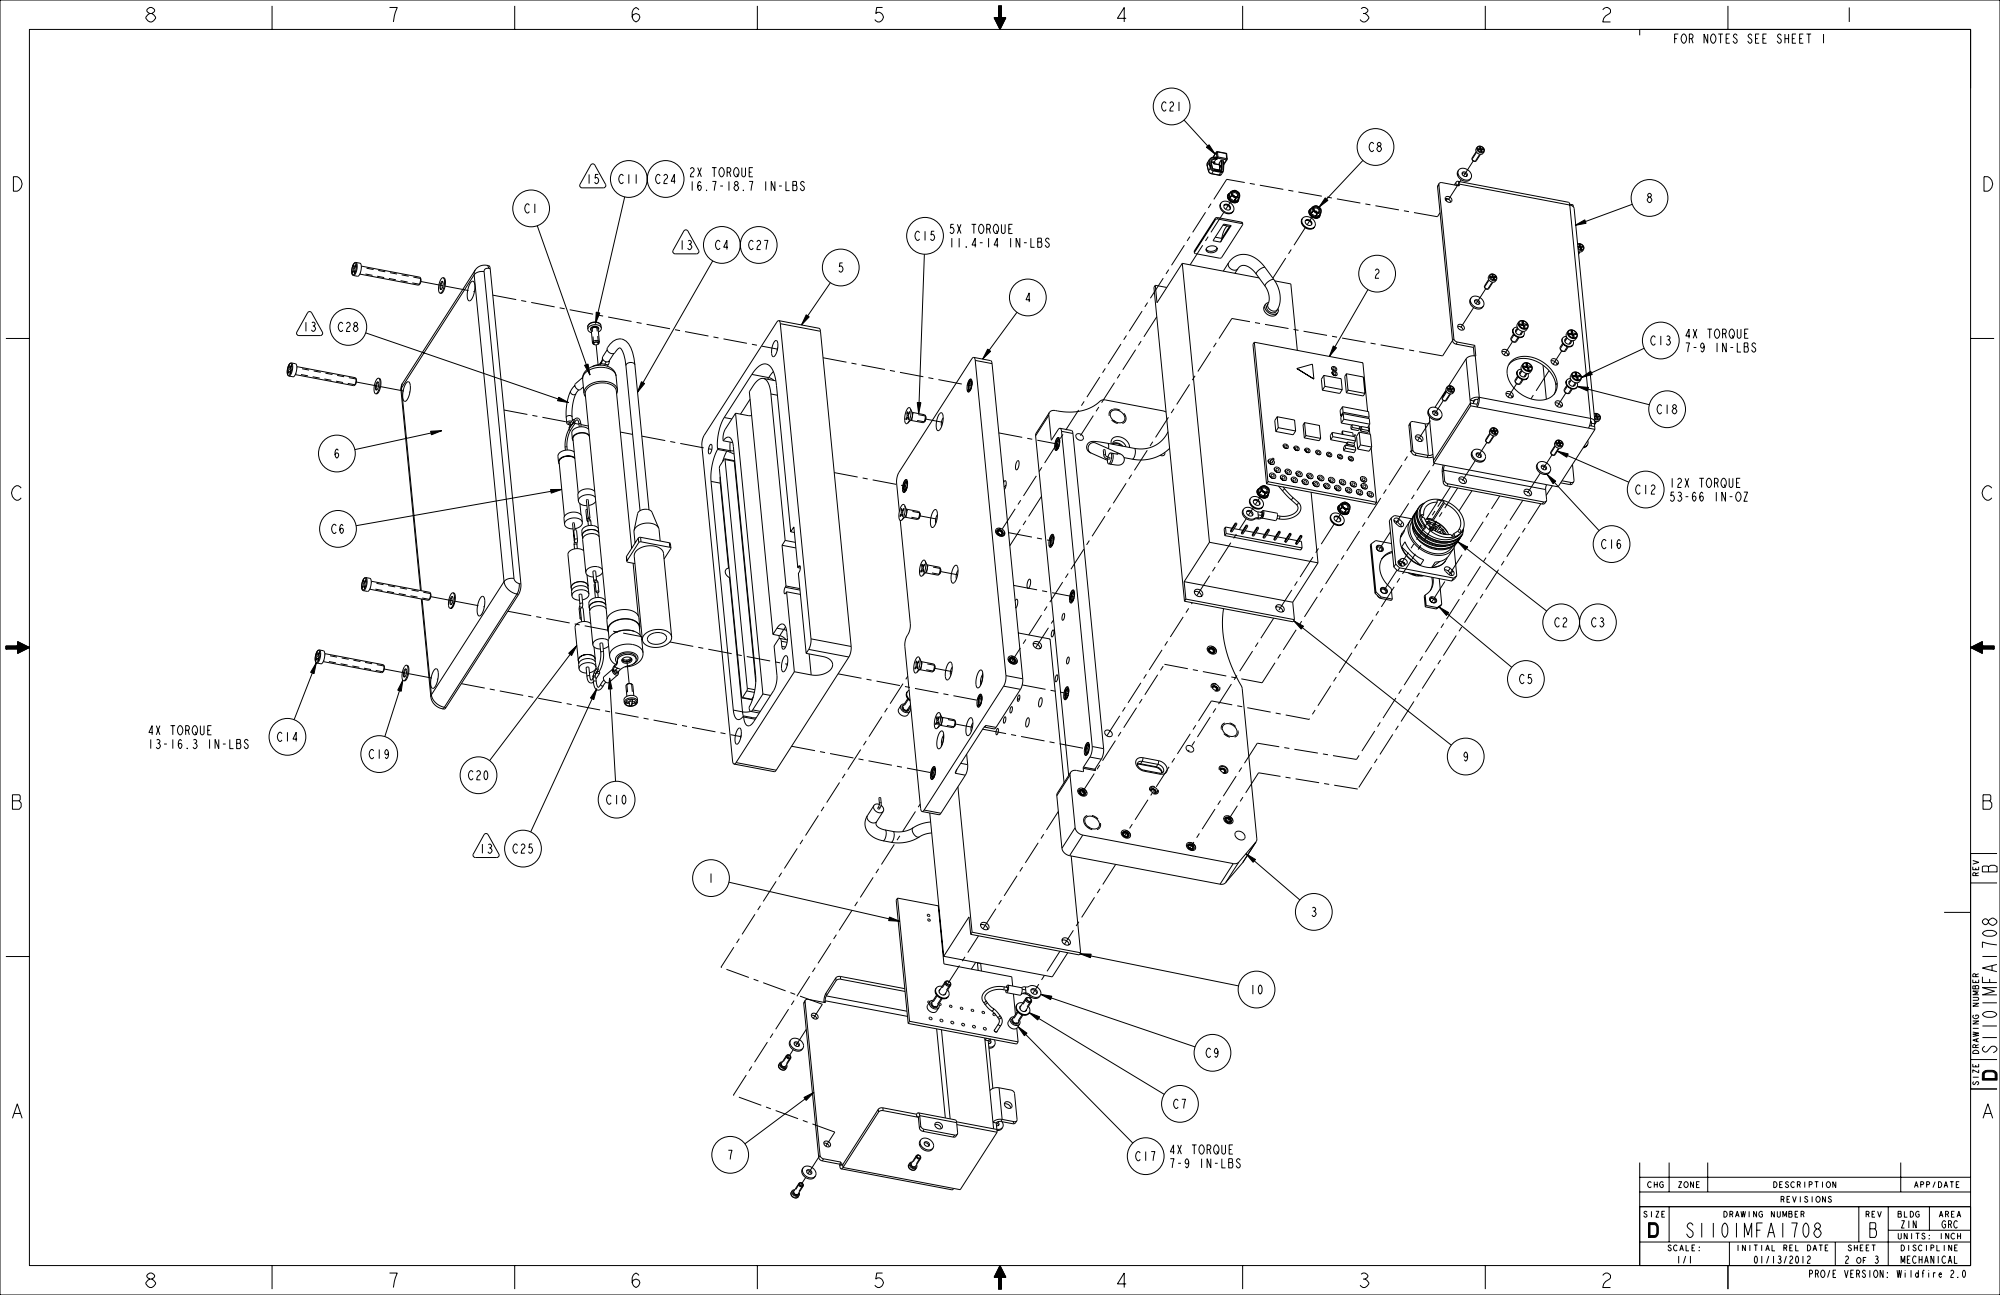
[picture p284: page 2]

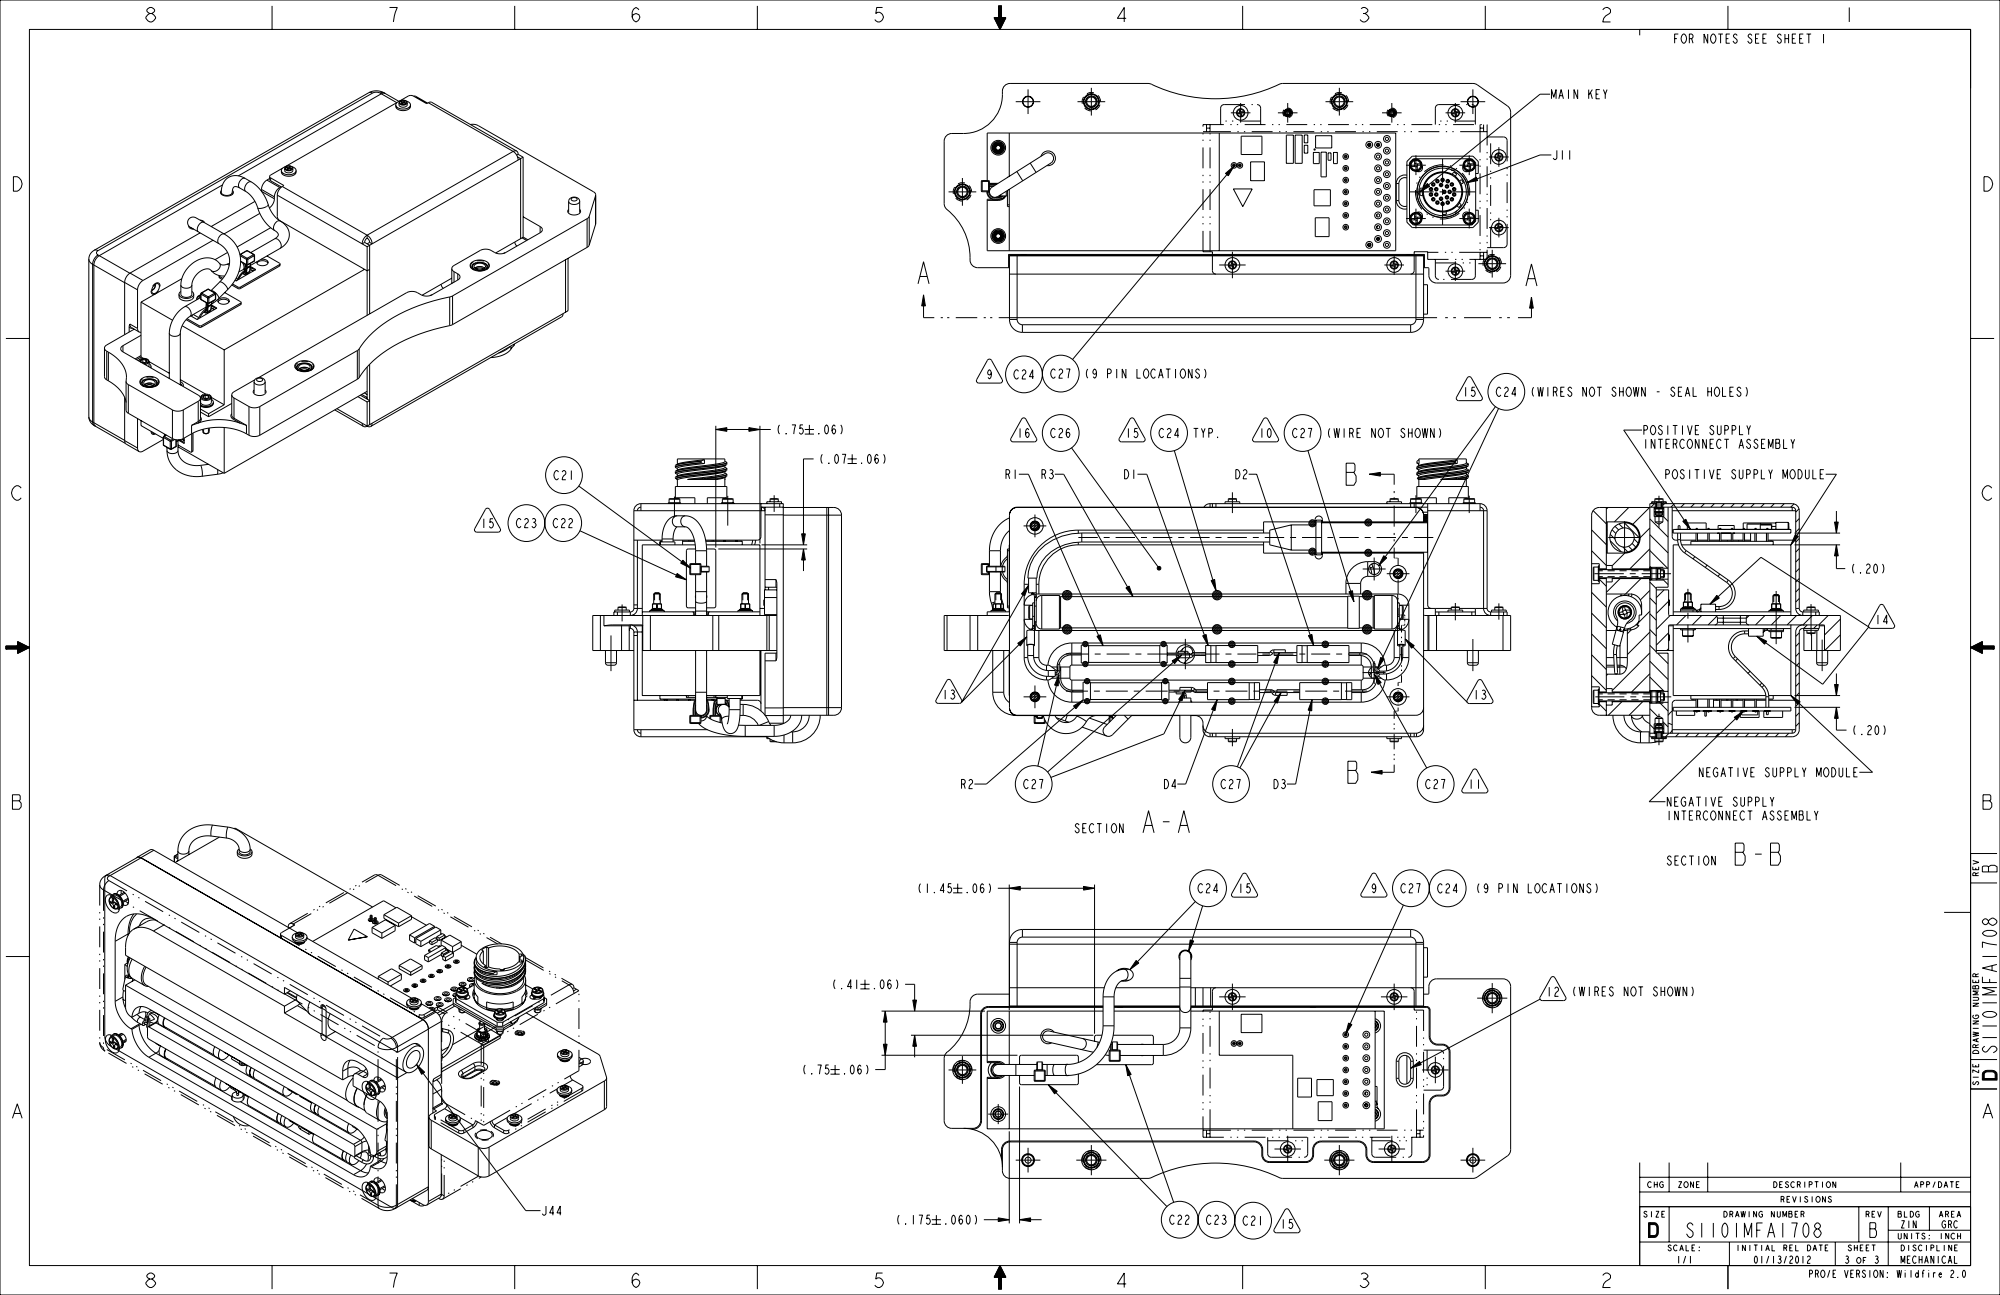
[picture p285: page 3]
