EmersonBJ/nasa-acme-burner-cad-cfd/PSI-Documents/Engineering Documents/Desenhos_Tecnicos_NASA/ACME_drawings_e-field_system/MFA_Montagens/s1101mfa1709_A.pdf

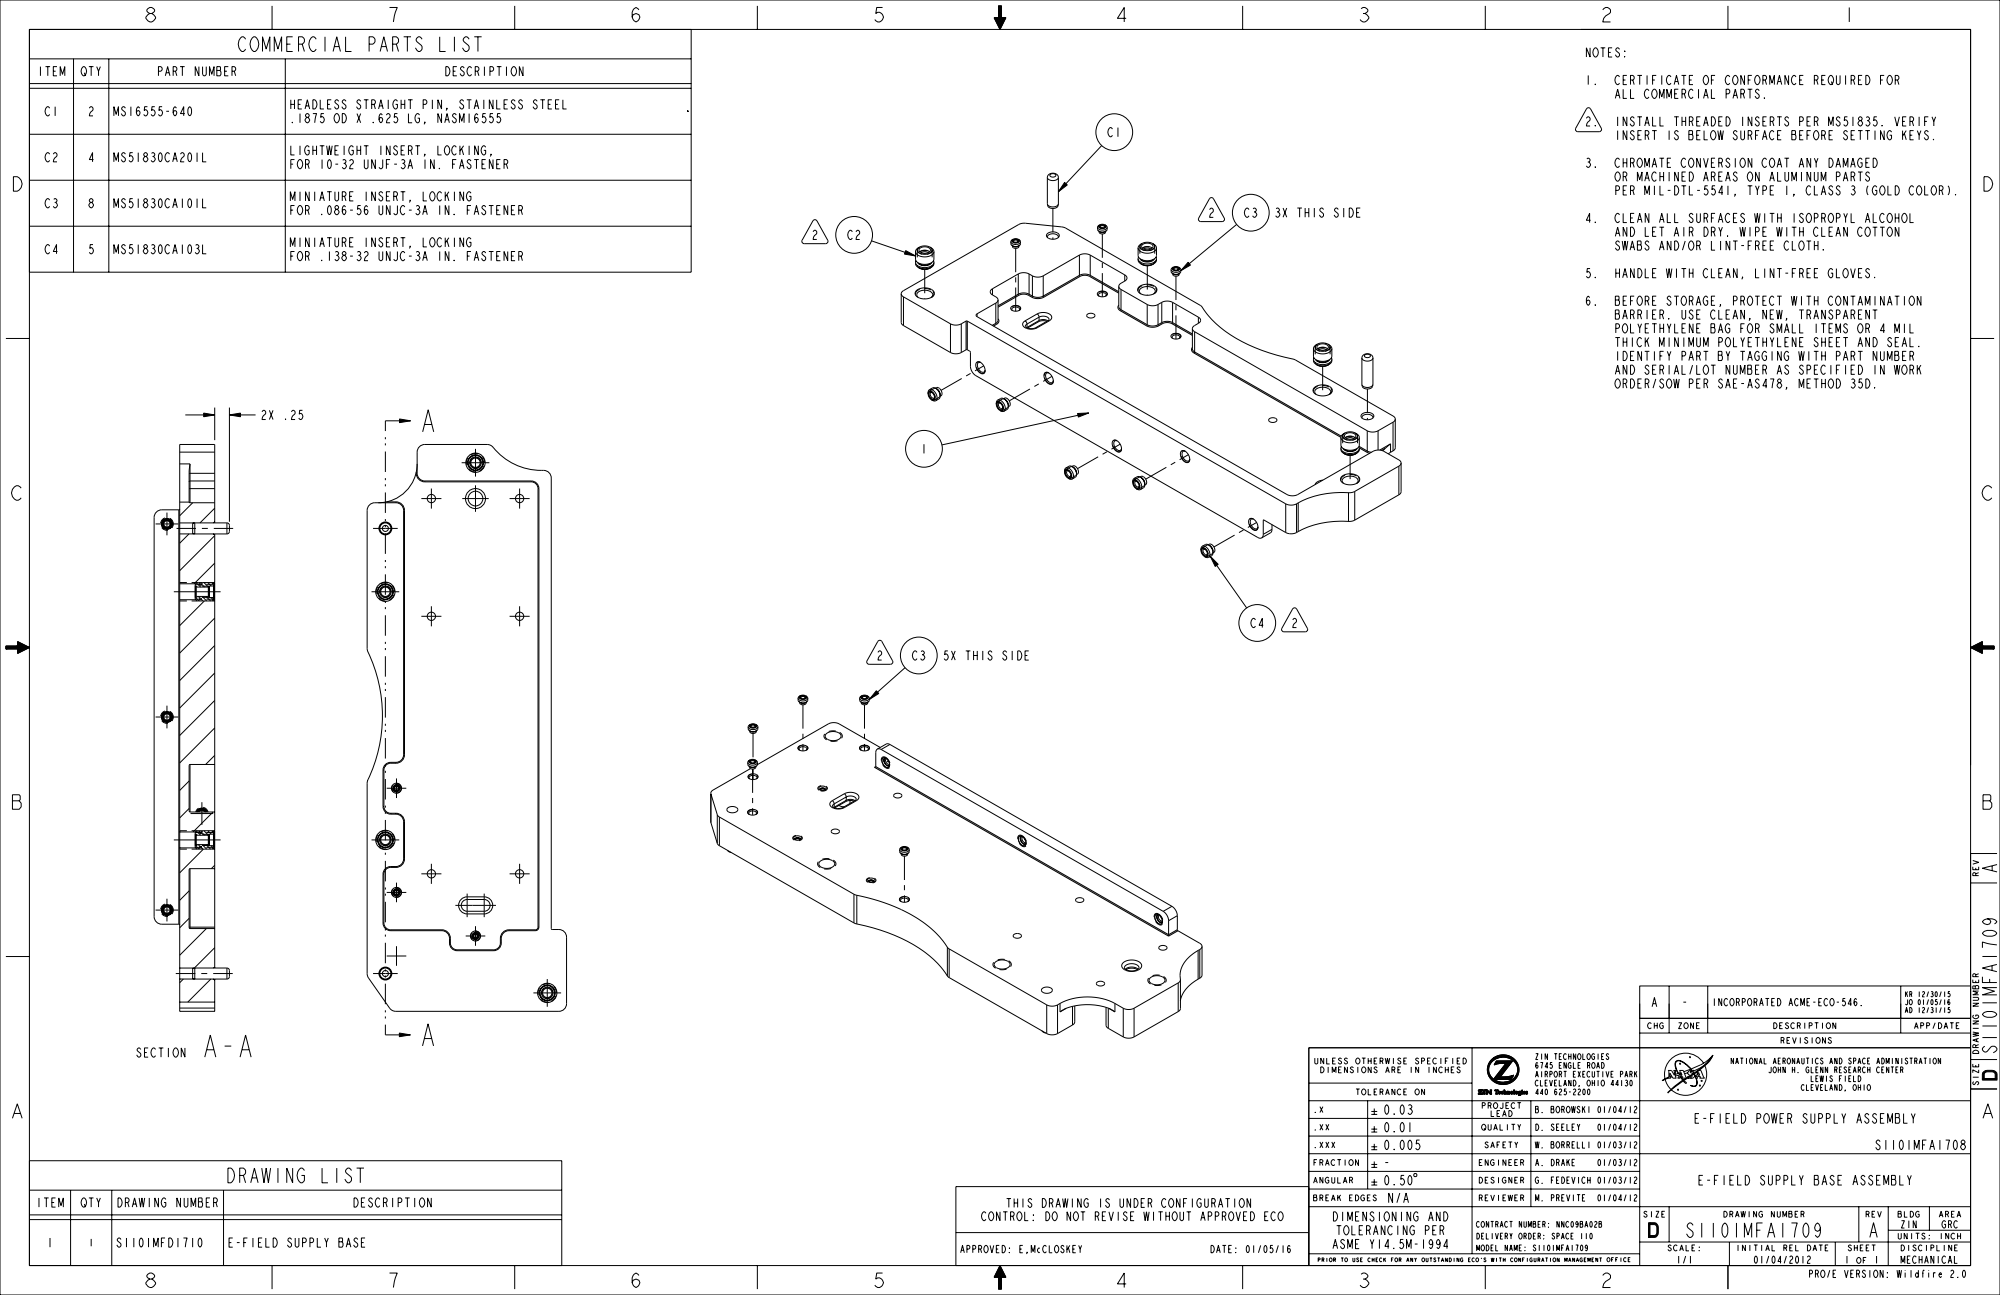
[picture p286: page 1]
