EmersonBJ/nasa-acme-burner-cad-cfd/PSI-Documents/Engineering Documents/Desenhos_Tecnicos_NASA/ACME_drawings_e-field_system/MFA_Montagens/s1101mfa1730_B.pdf

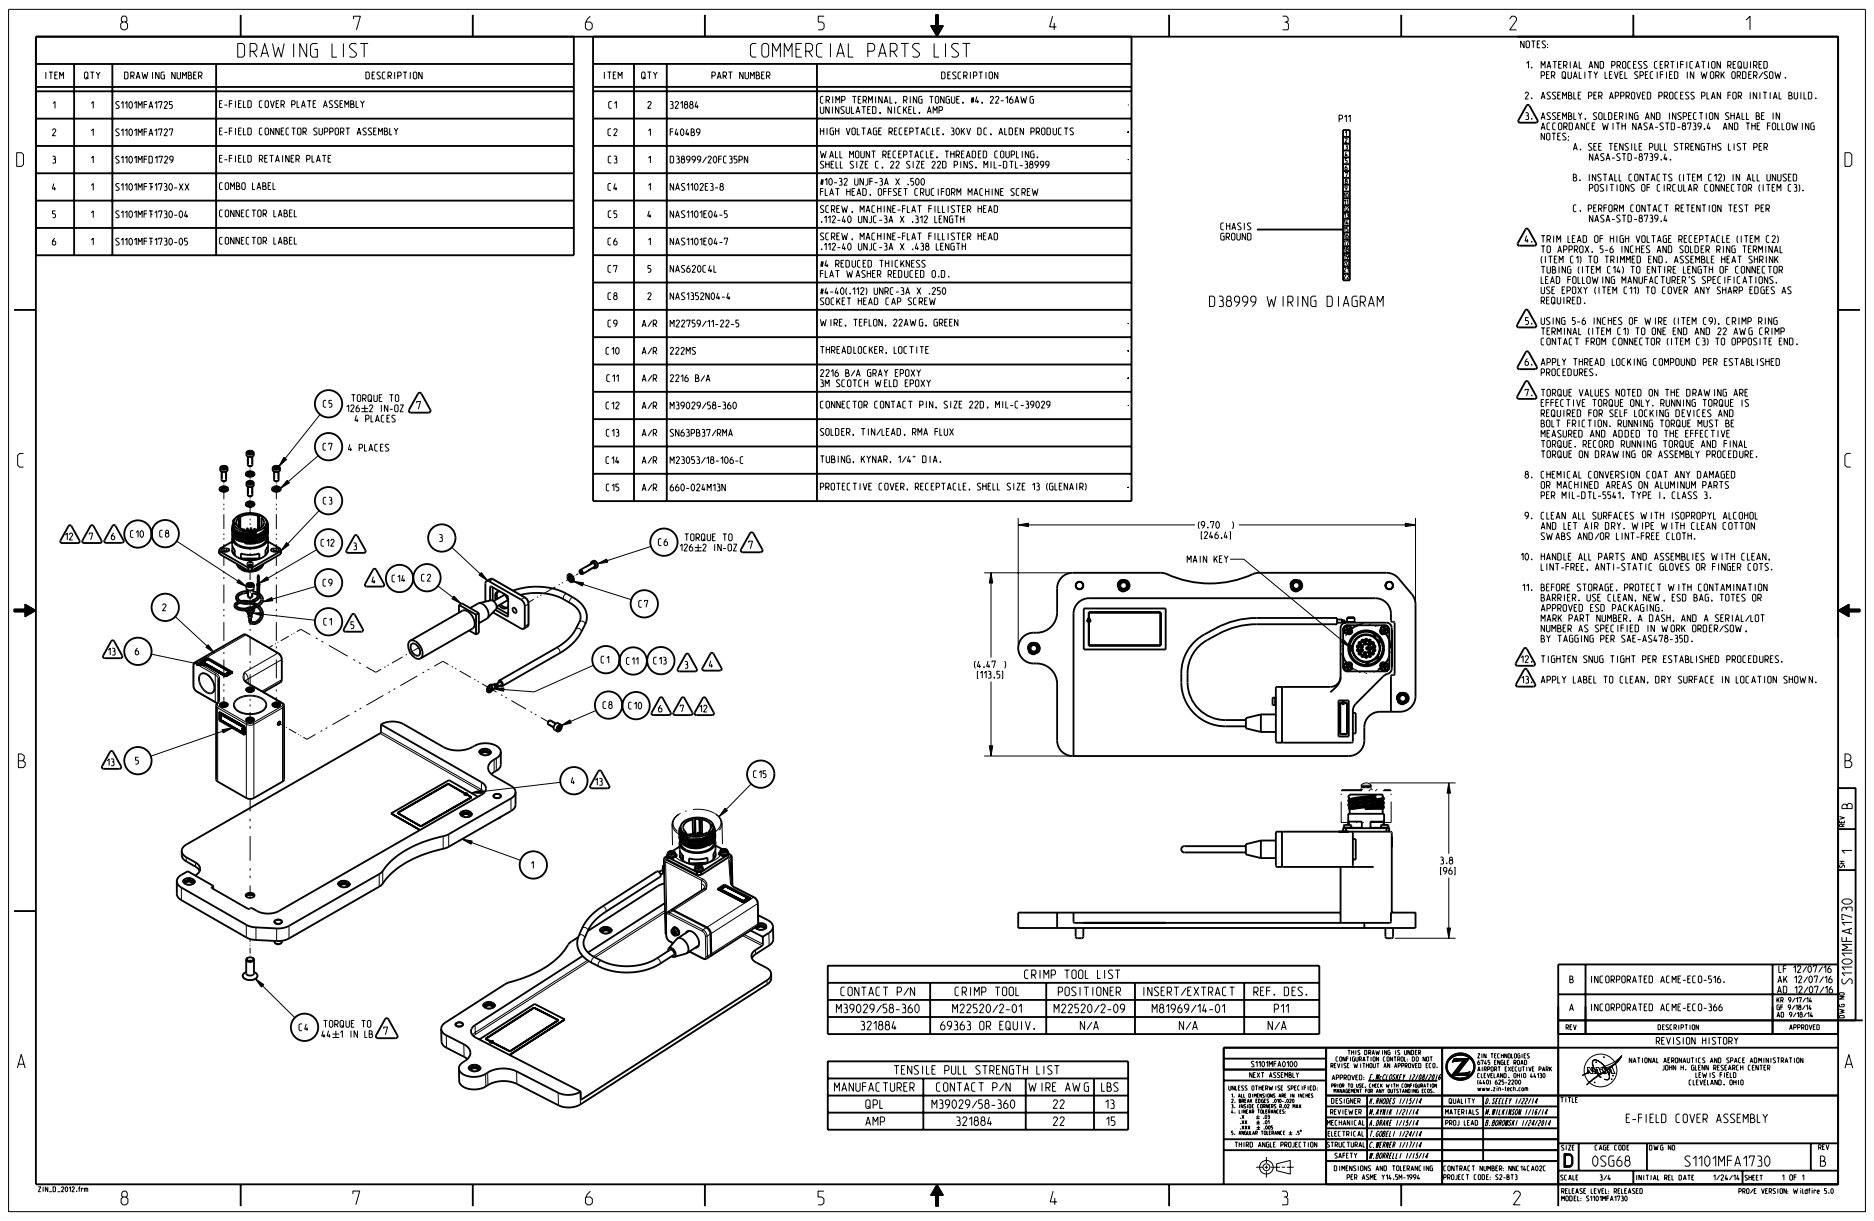
[picture p287: page 1]
