EmersonBJ/nasa-acme-burner-cad-cfd/PSI-Documents/Engineering Documents/Desenhos_Tecnicos_NASA/ACME_drawings_expt_mounting_structure/MFA_Montagens/s1101mfa1000_A.pdf

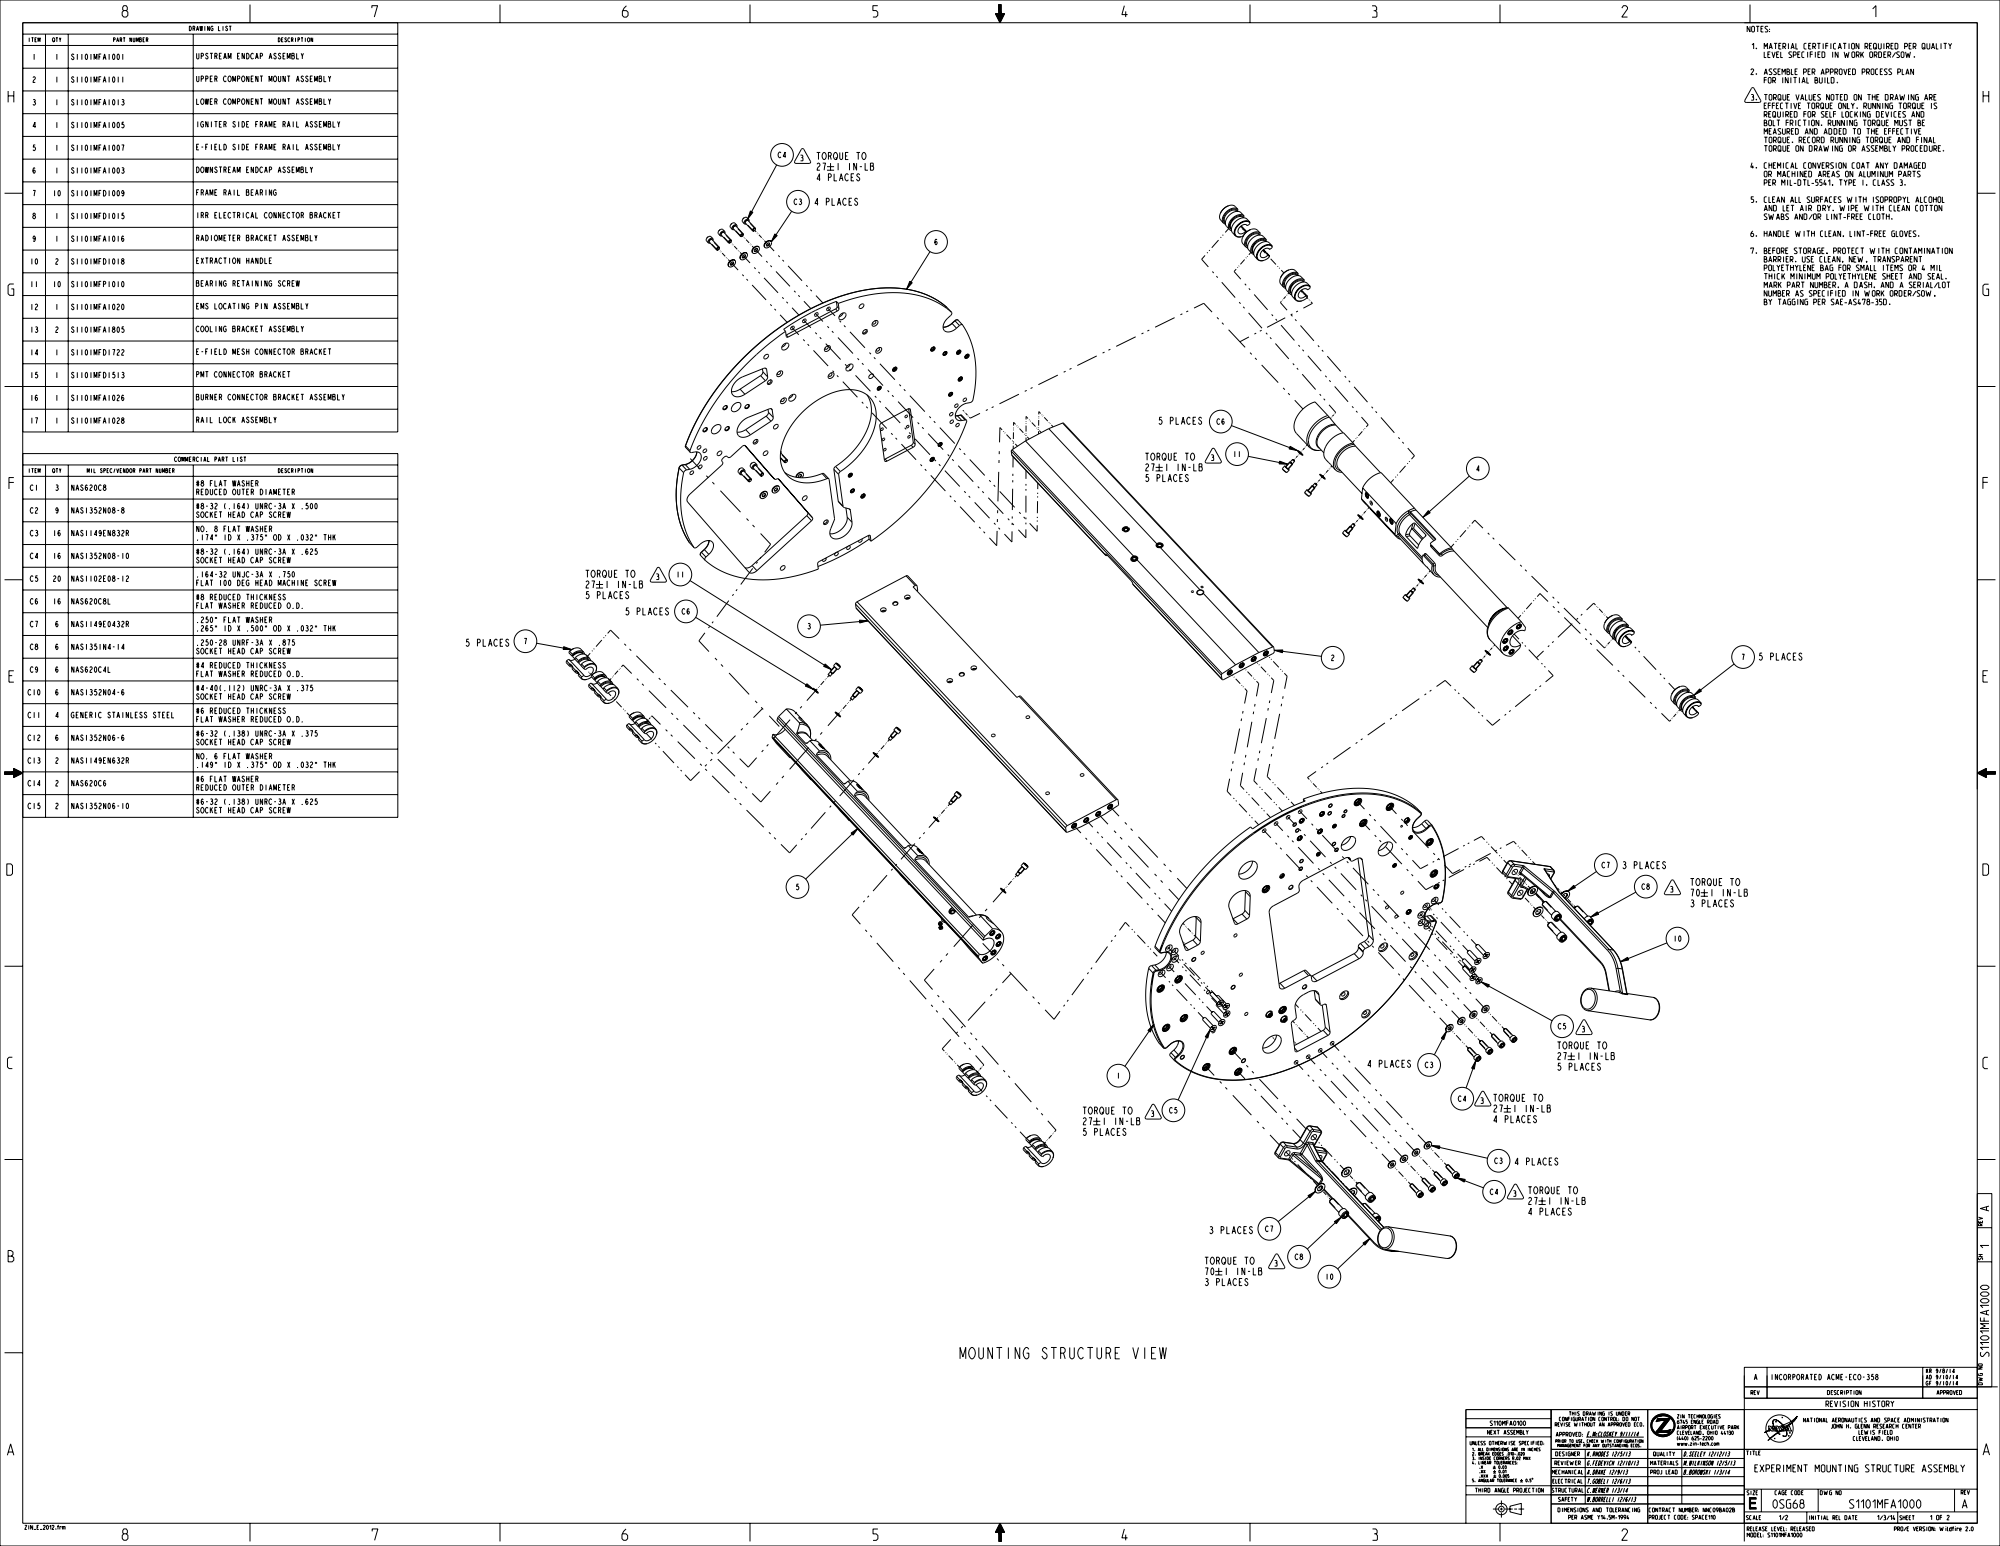
[picture p288: page 1]

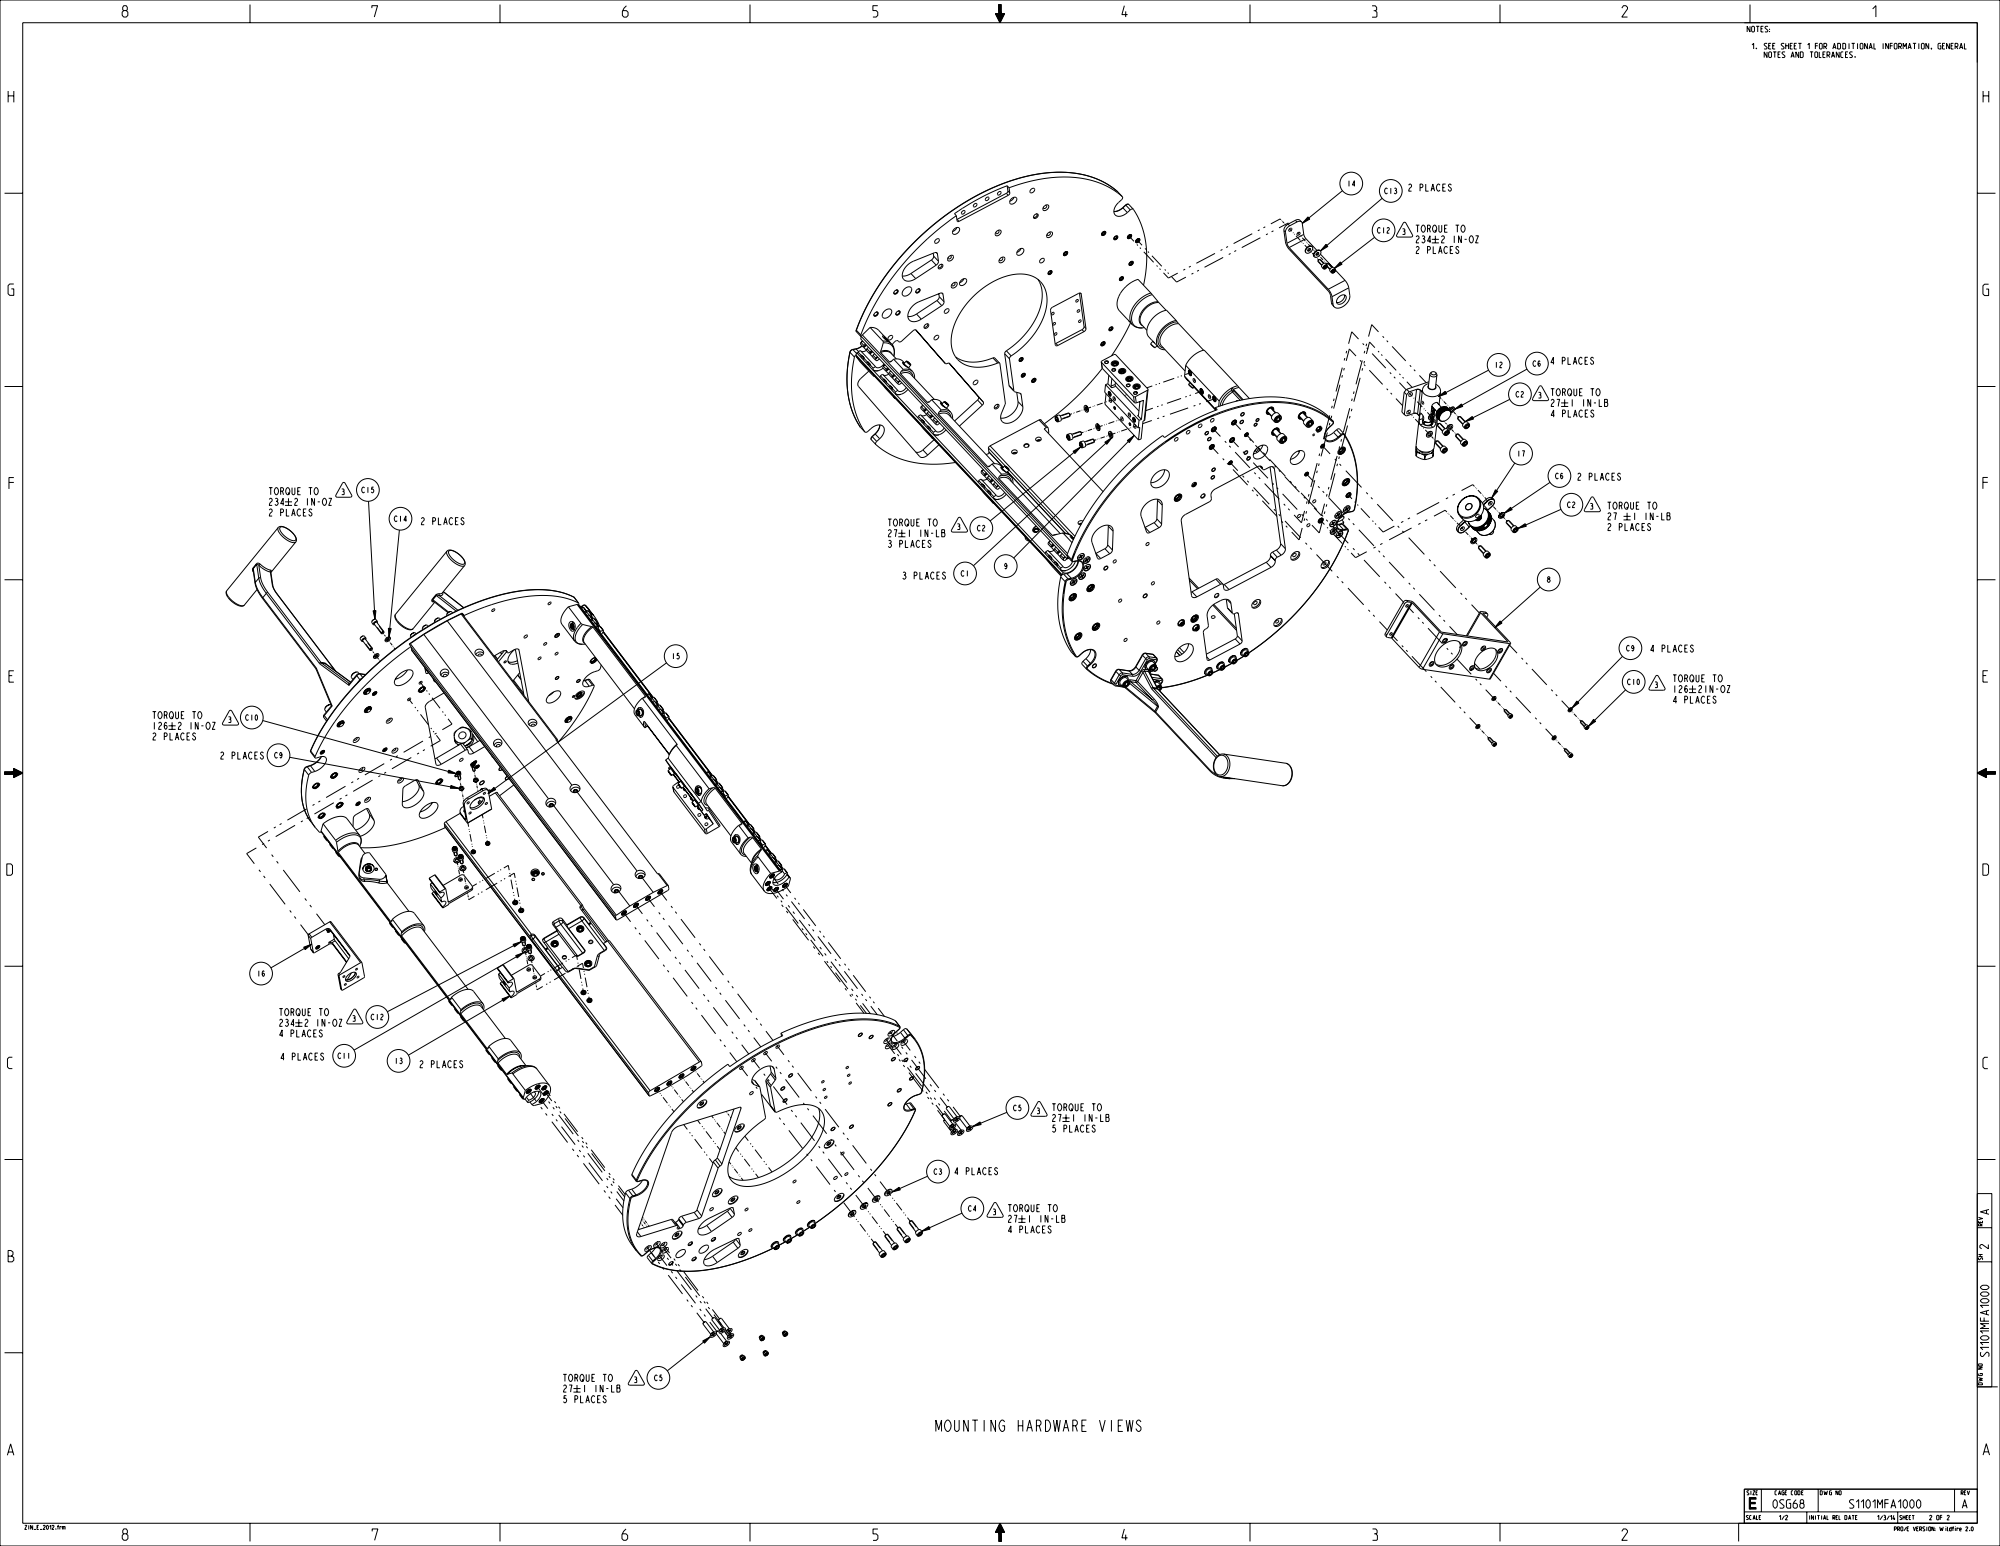
[picture p289: page 2]
