EmersonBJ/nasa-acme-burner-cad-cfd/PSI-Documents/Engineering Documents/Desenhos_Tecnicos_NASA/ACME_drawings_gas_supply/MFA_Montagens/s1101mfa1120_E.pdf

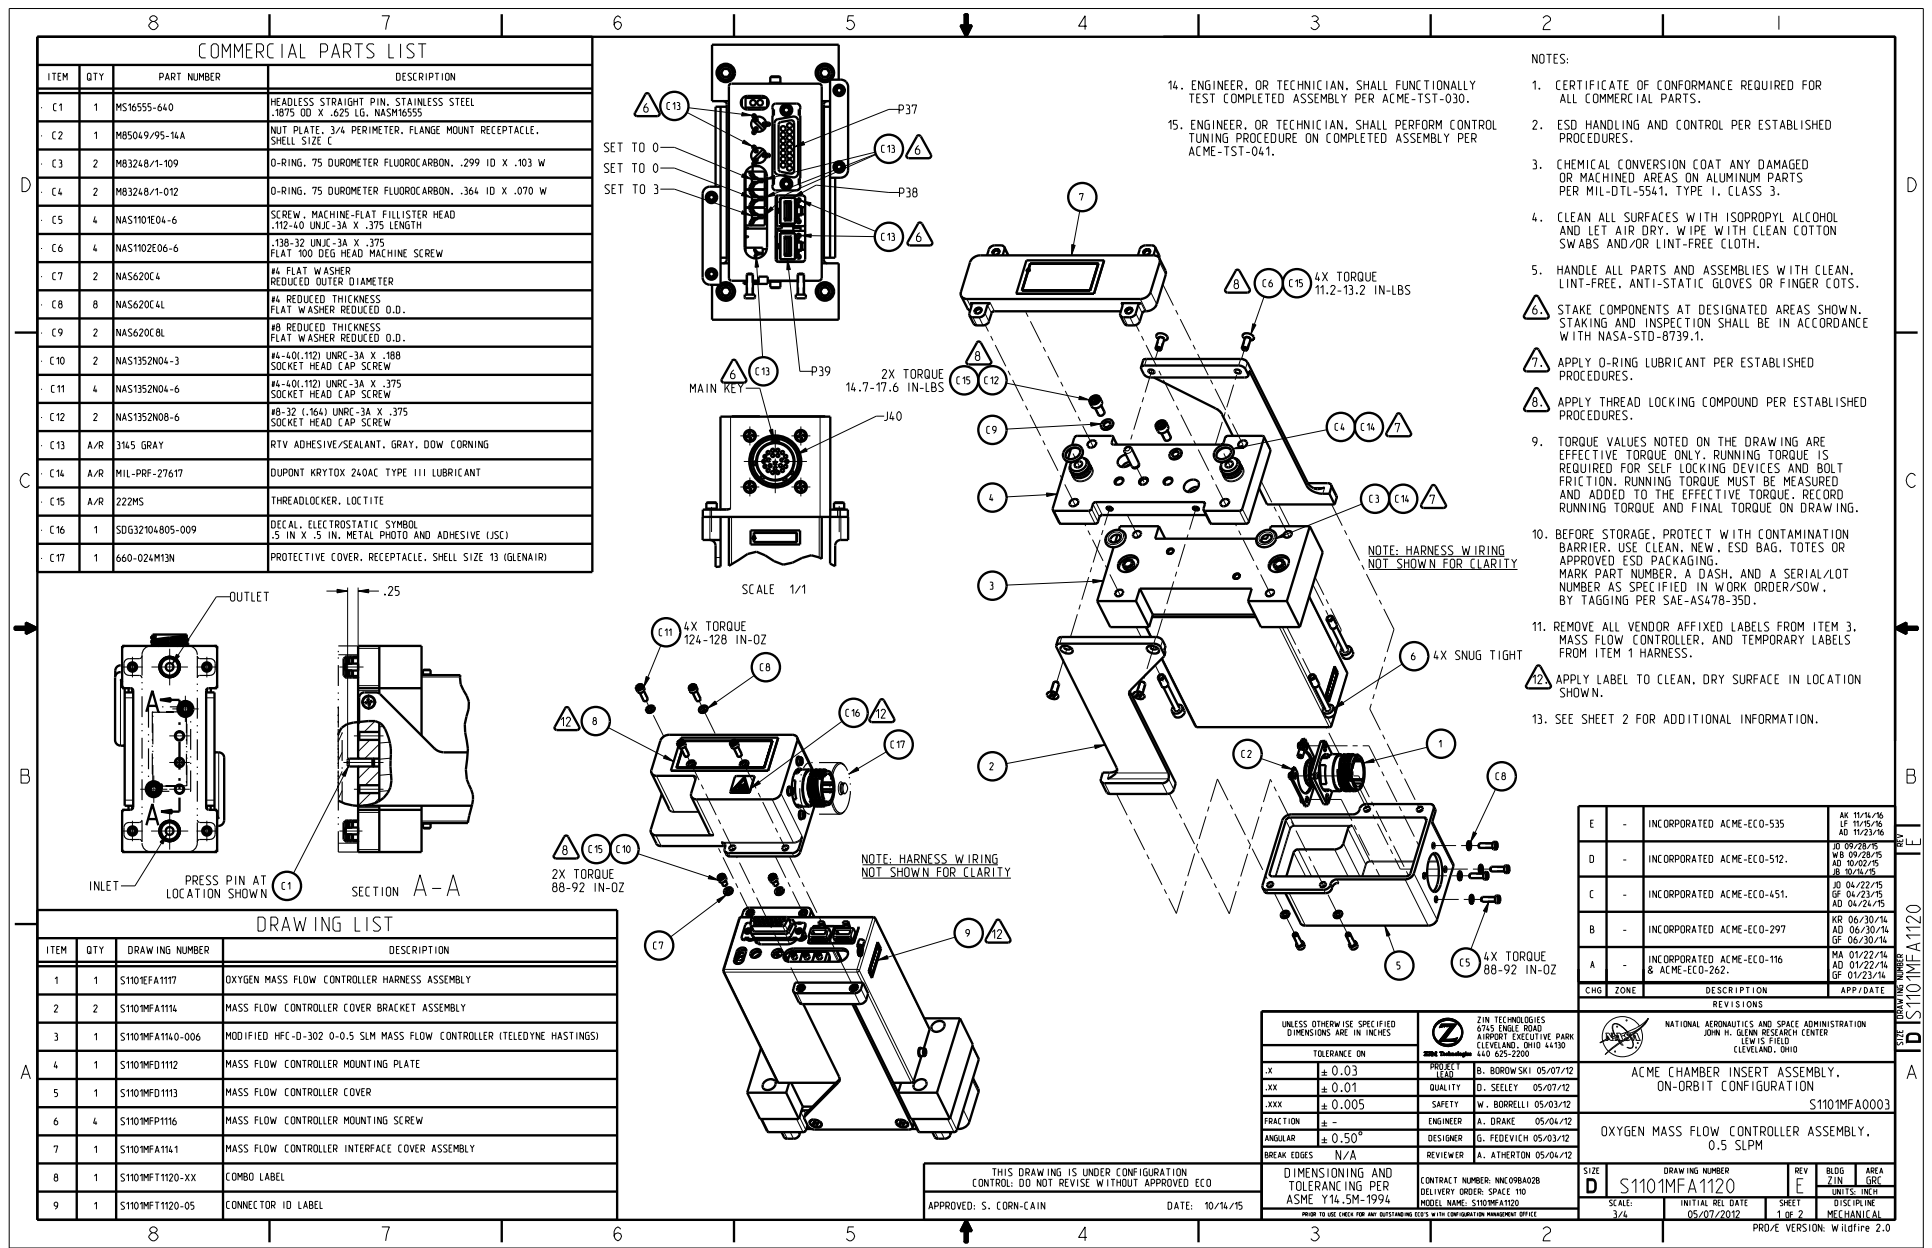
[picture p290: page 1]

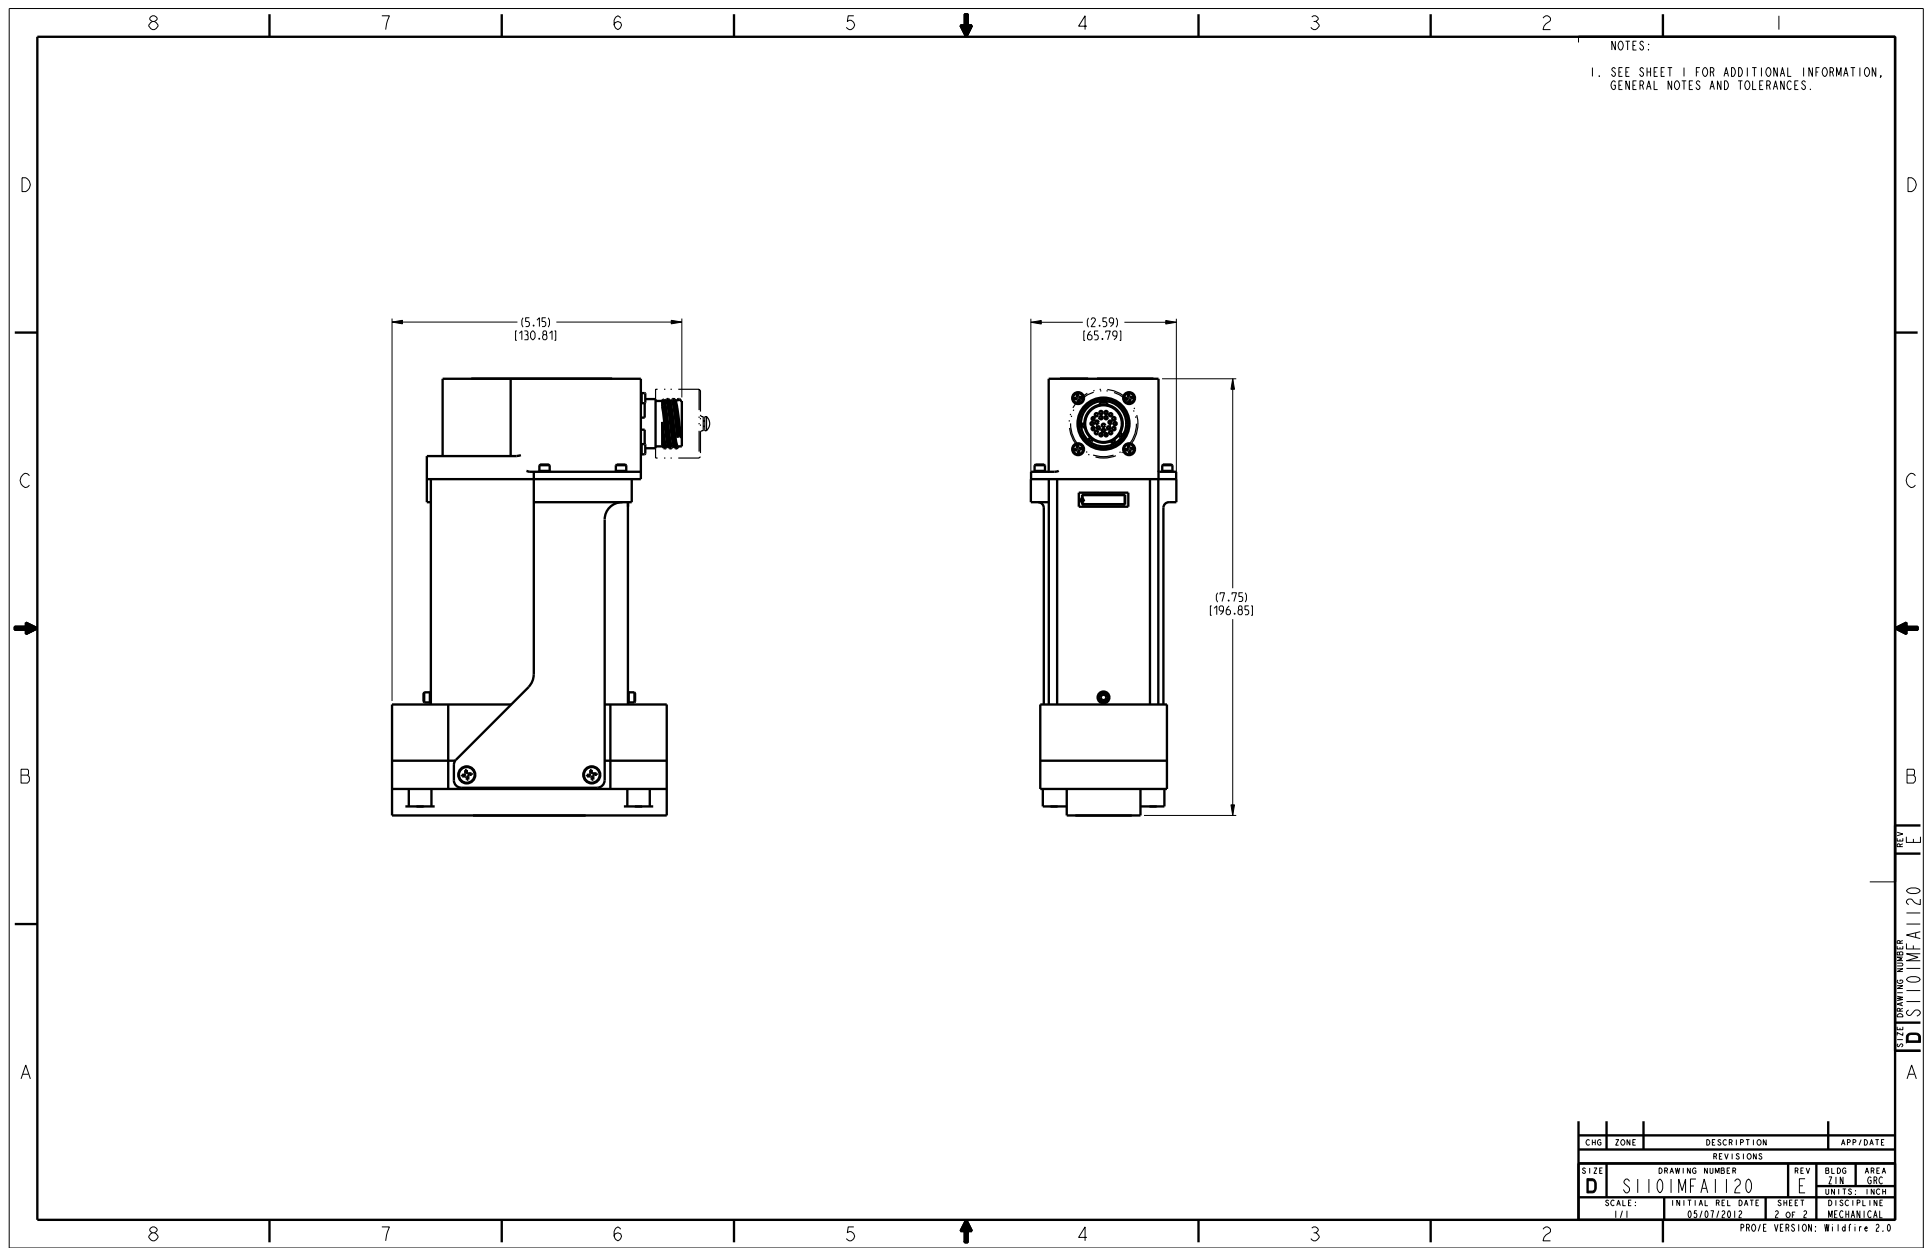
[picture p291: page 2]
