EmersonBJ/nasa-acme-burner-cad-cfd/PSI-Documents/Engineering Documents/Desenhos_Tecnicos_NASA/ACME_drawings_igniter/MFA_Montagens/s1101mfa1338_-.pdf

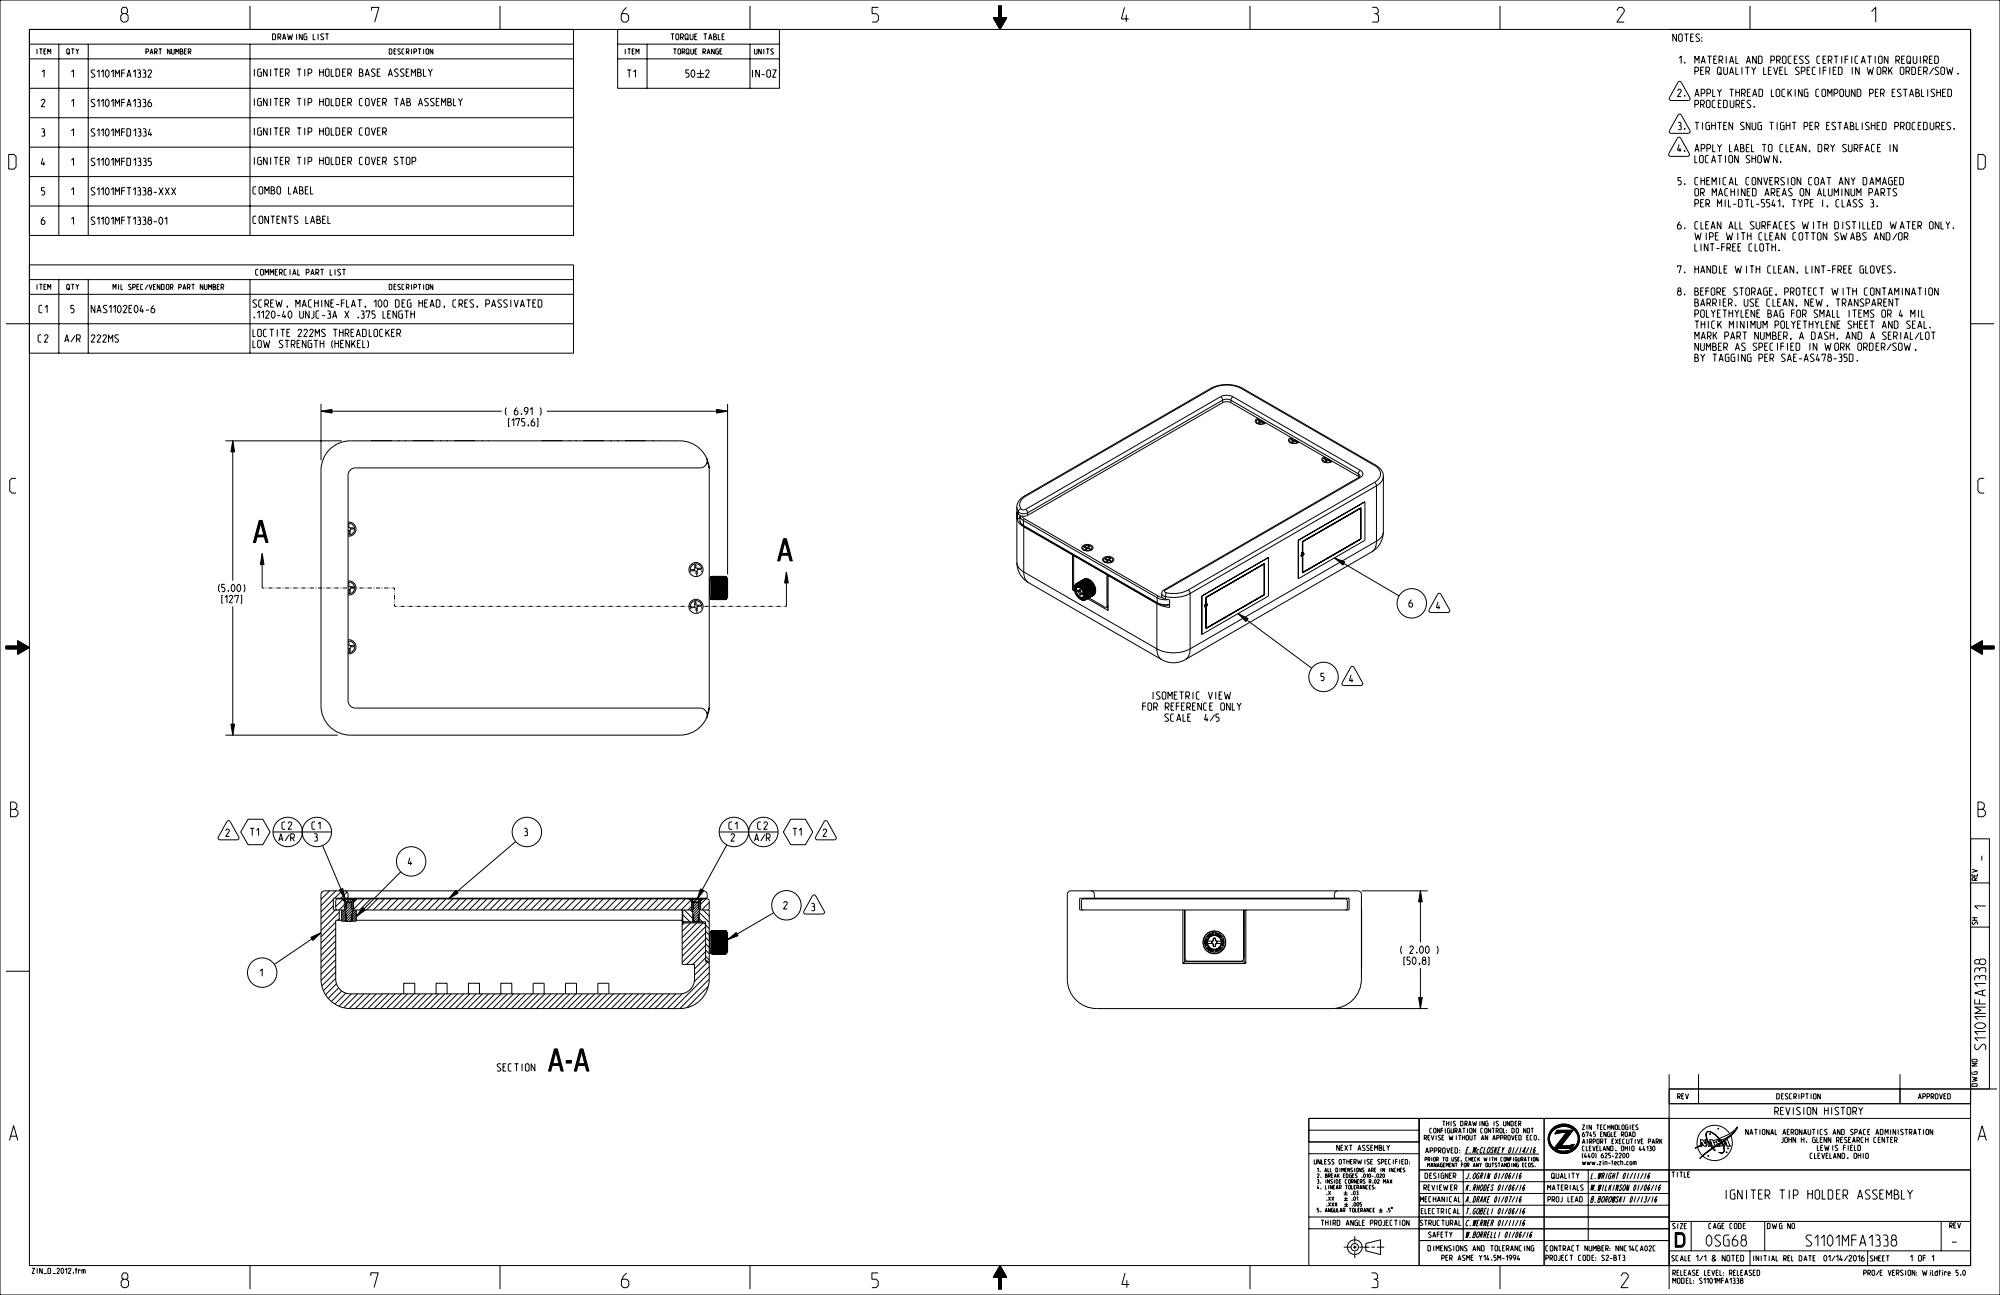
[picture p293: page 1]
