EmersonBJ/nasa-acme-burner-cad-cfd/PSI-Documents/Engineering Documents/Desenhos_Tecnicos_NASA/ACME_drawings_measurement_system/ACME_drawings_measurement_system/s1101mfa1610_A.pdf

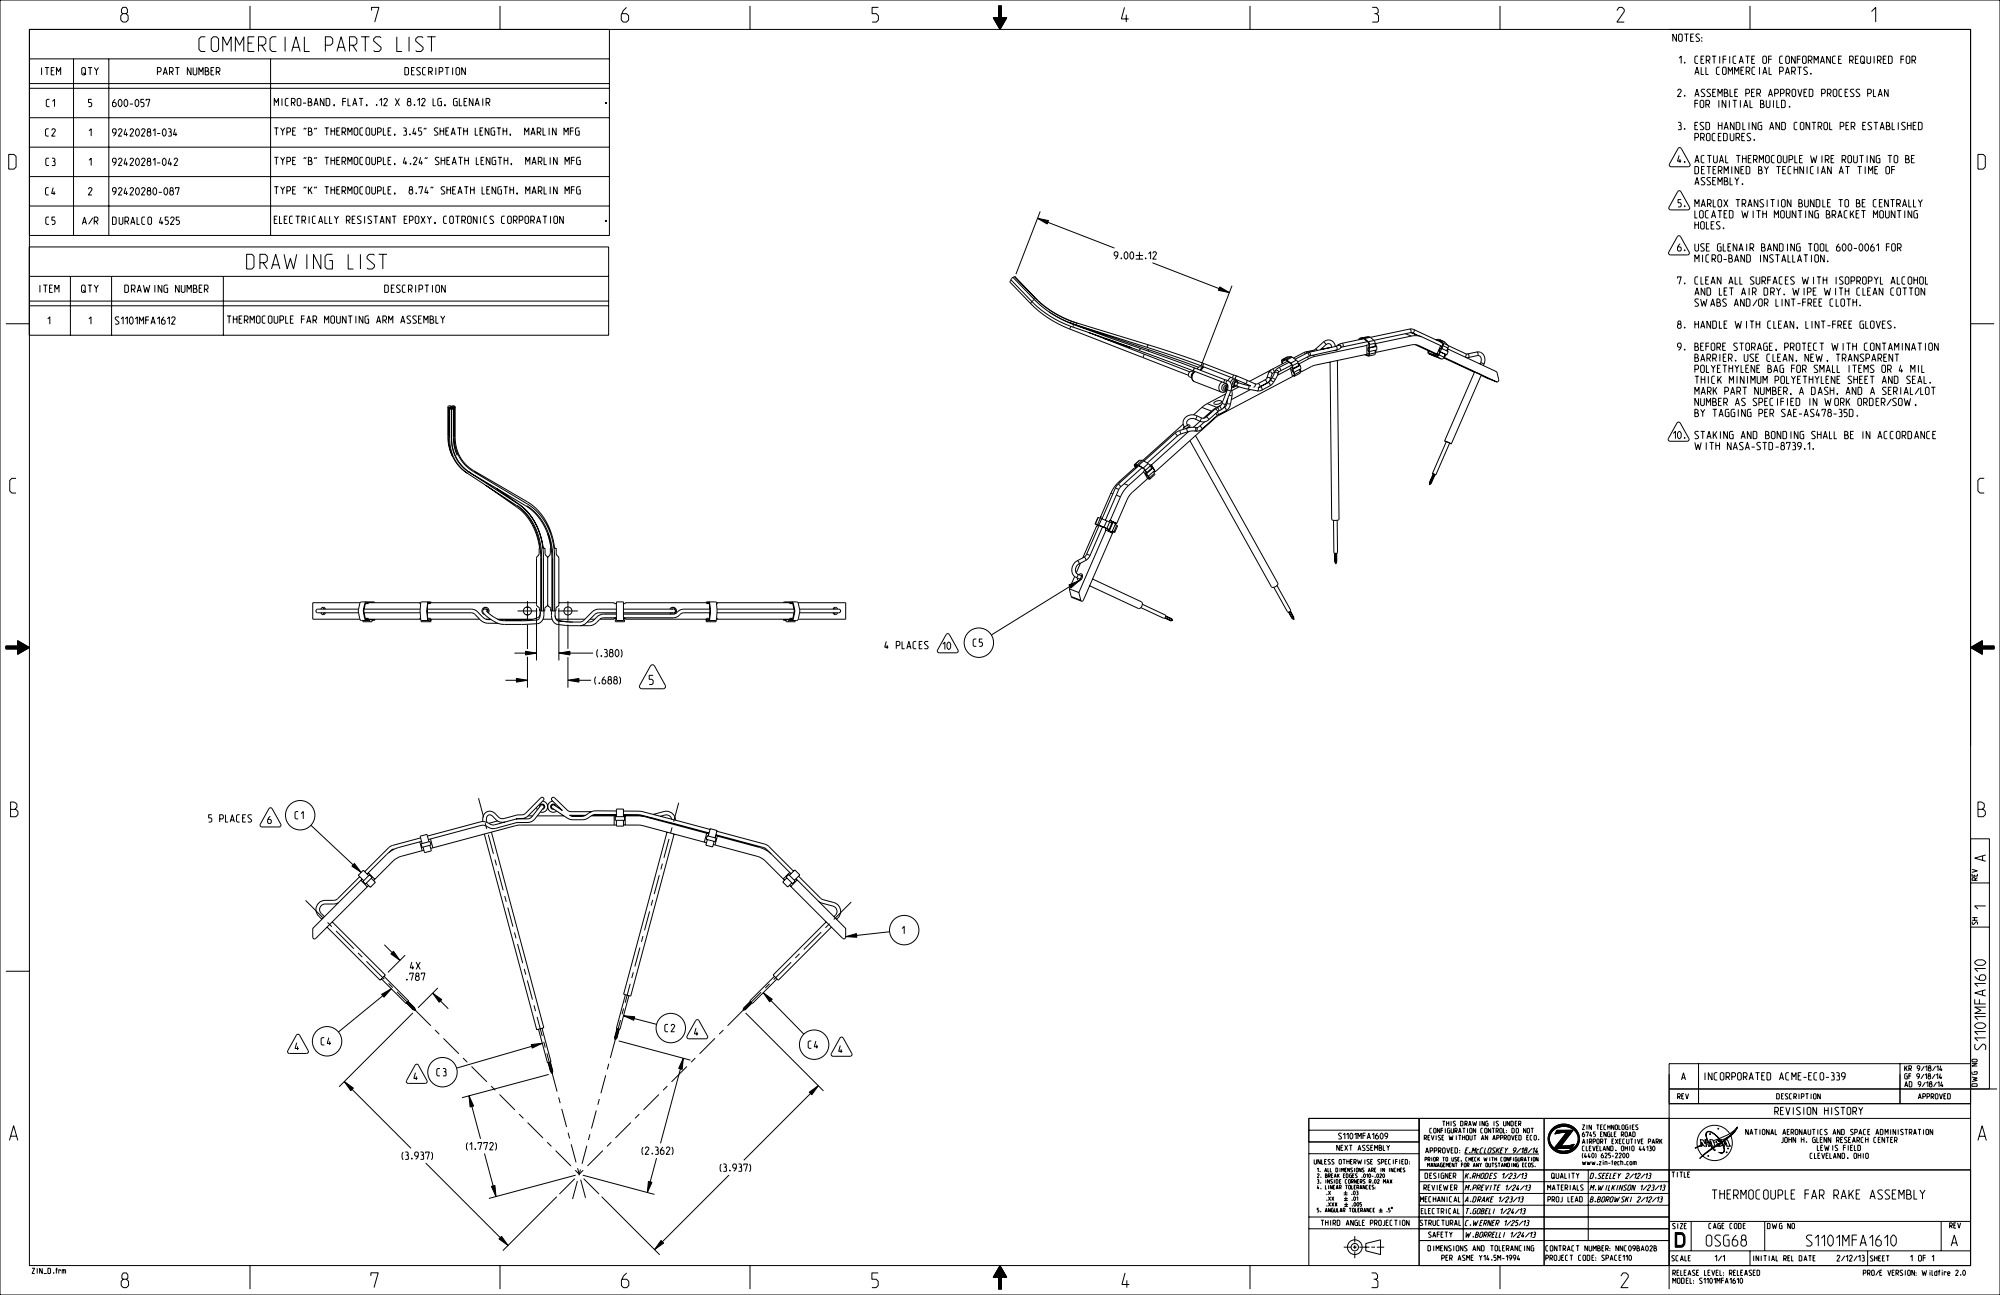
[picture p294: page 1]
