EmersonBJ/nasa-acme-burner-cad-cfd/PSI-Documents/Engineering Documents/Desenhos_Tecnicos_NASA/ACME_drawings_measurement_system/ACME_drawings_measurement_system/s1101mfa1627_D.pdf

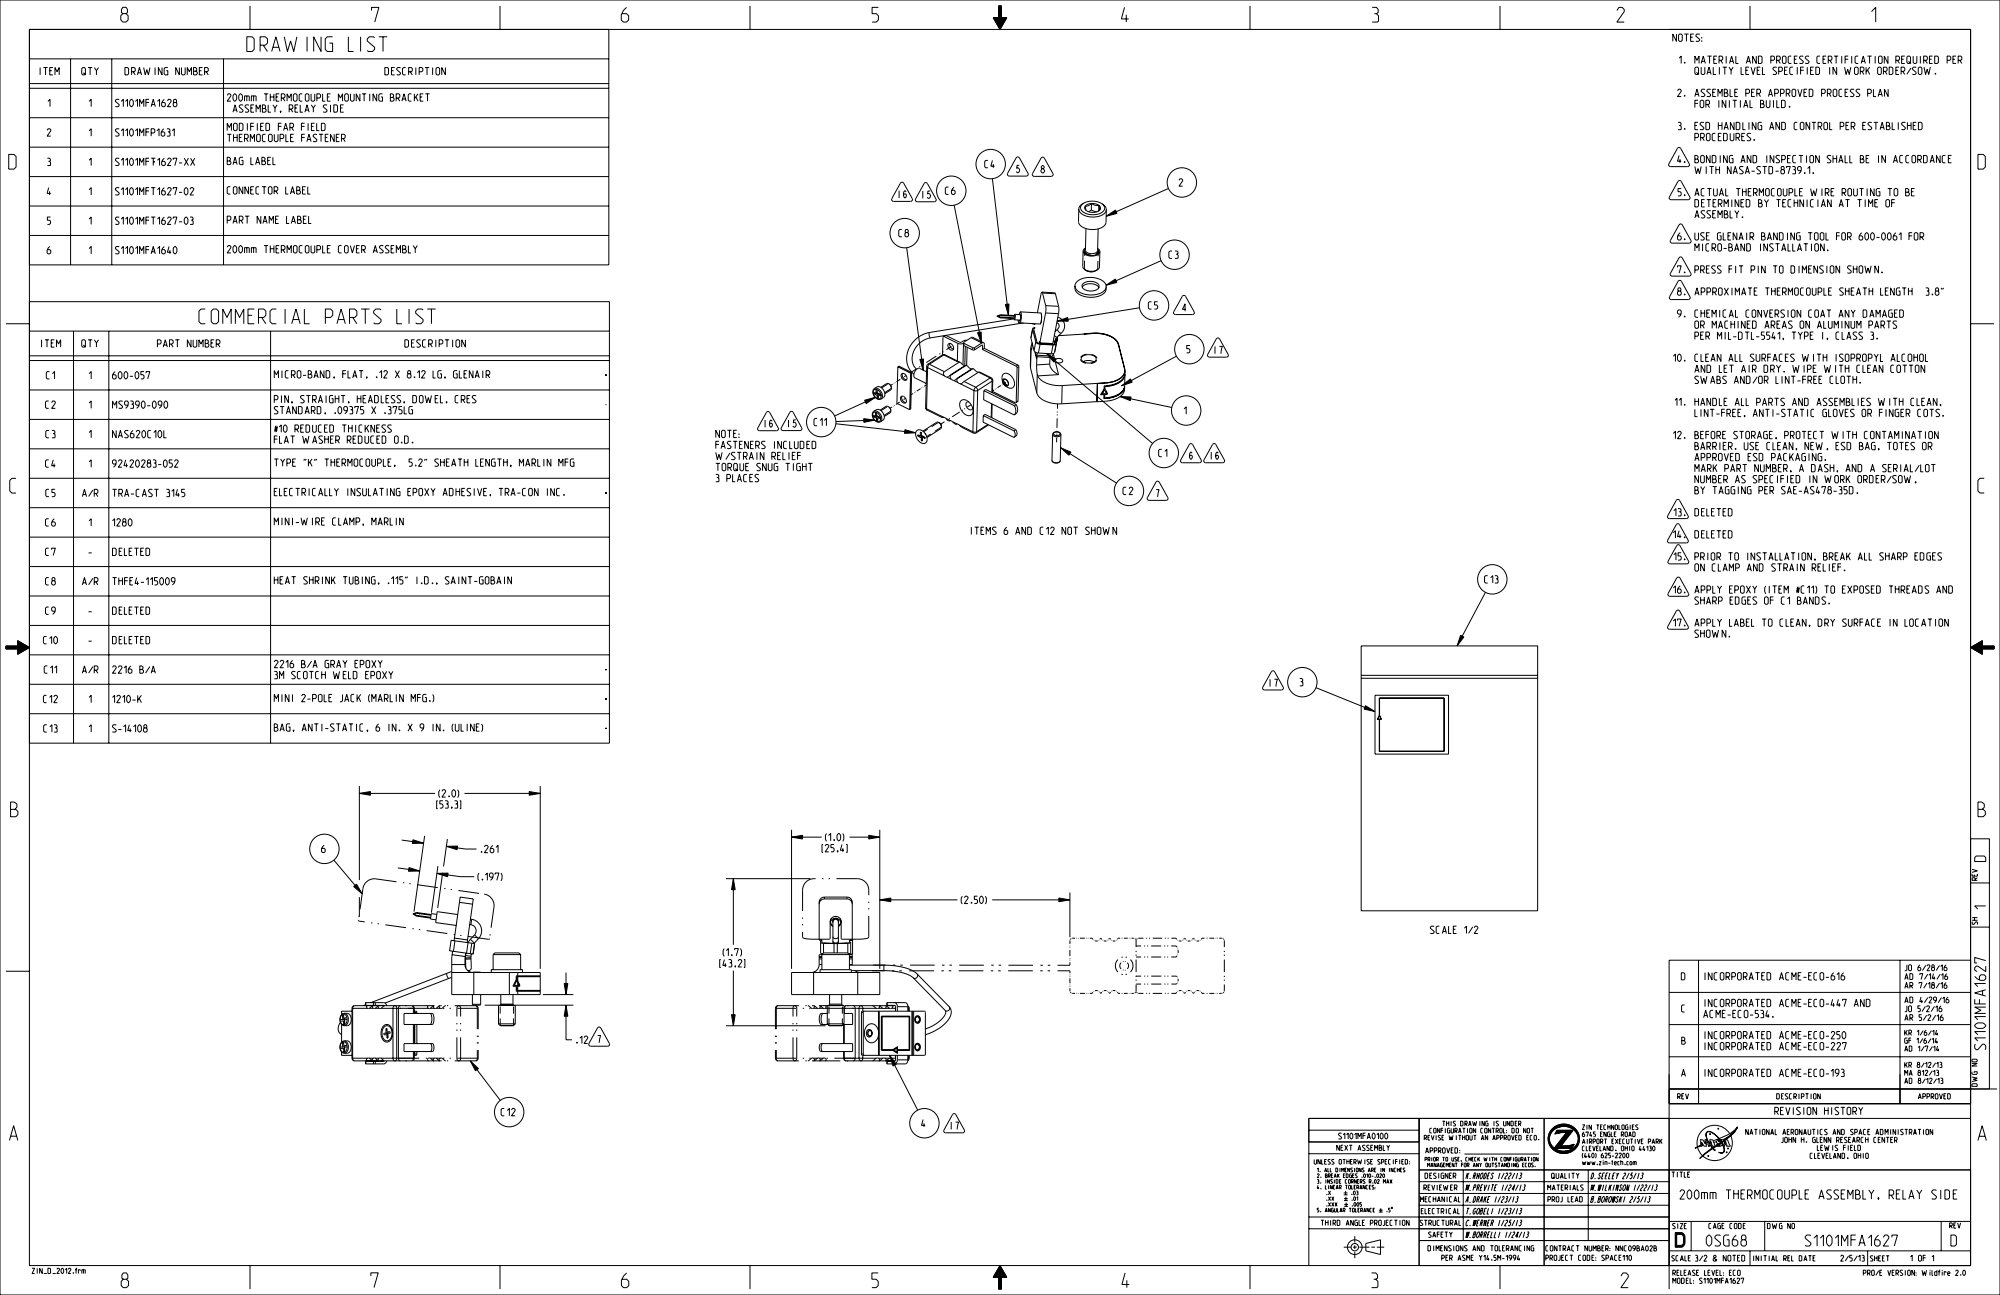
[picture p295: page 1]
