EmersonBJ/nasa-acme-burner-cad-cfd/PSI-Documents/Engineering Documents/Desenhos_Tecnicos_NASA/ACME_drawings_measurement_system/ACME_drawings_measurement_system/s1101mfd1619.pdf

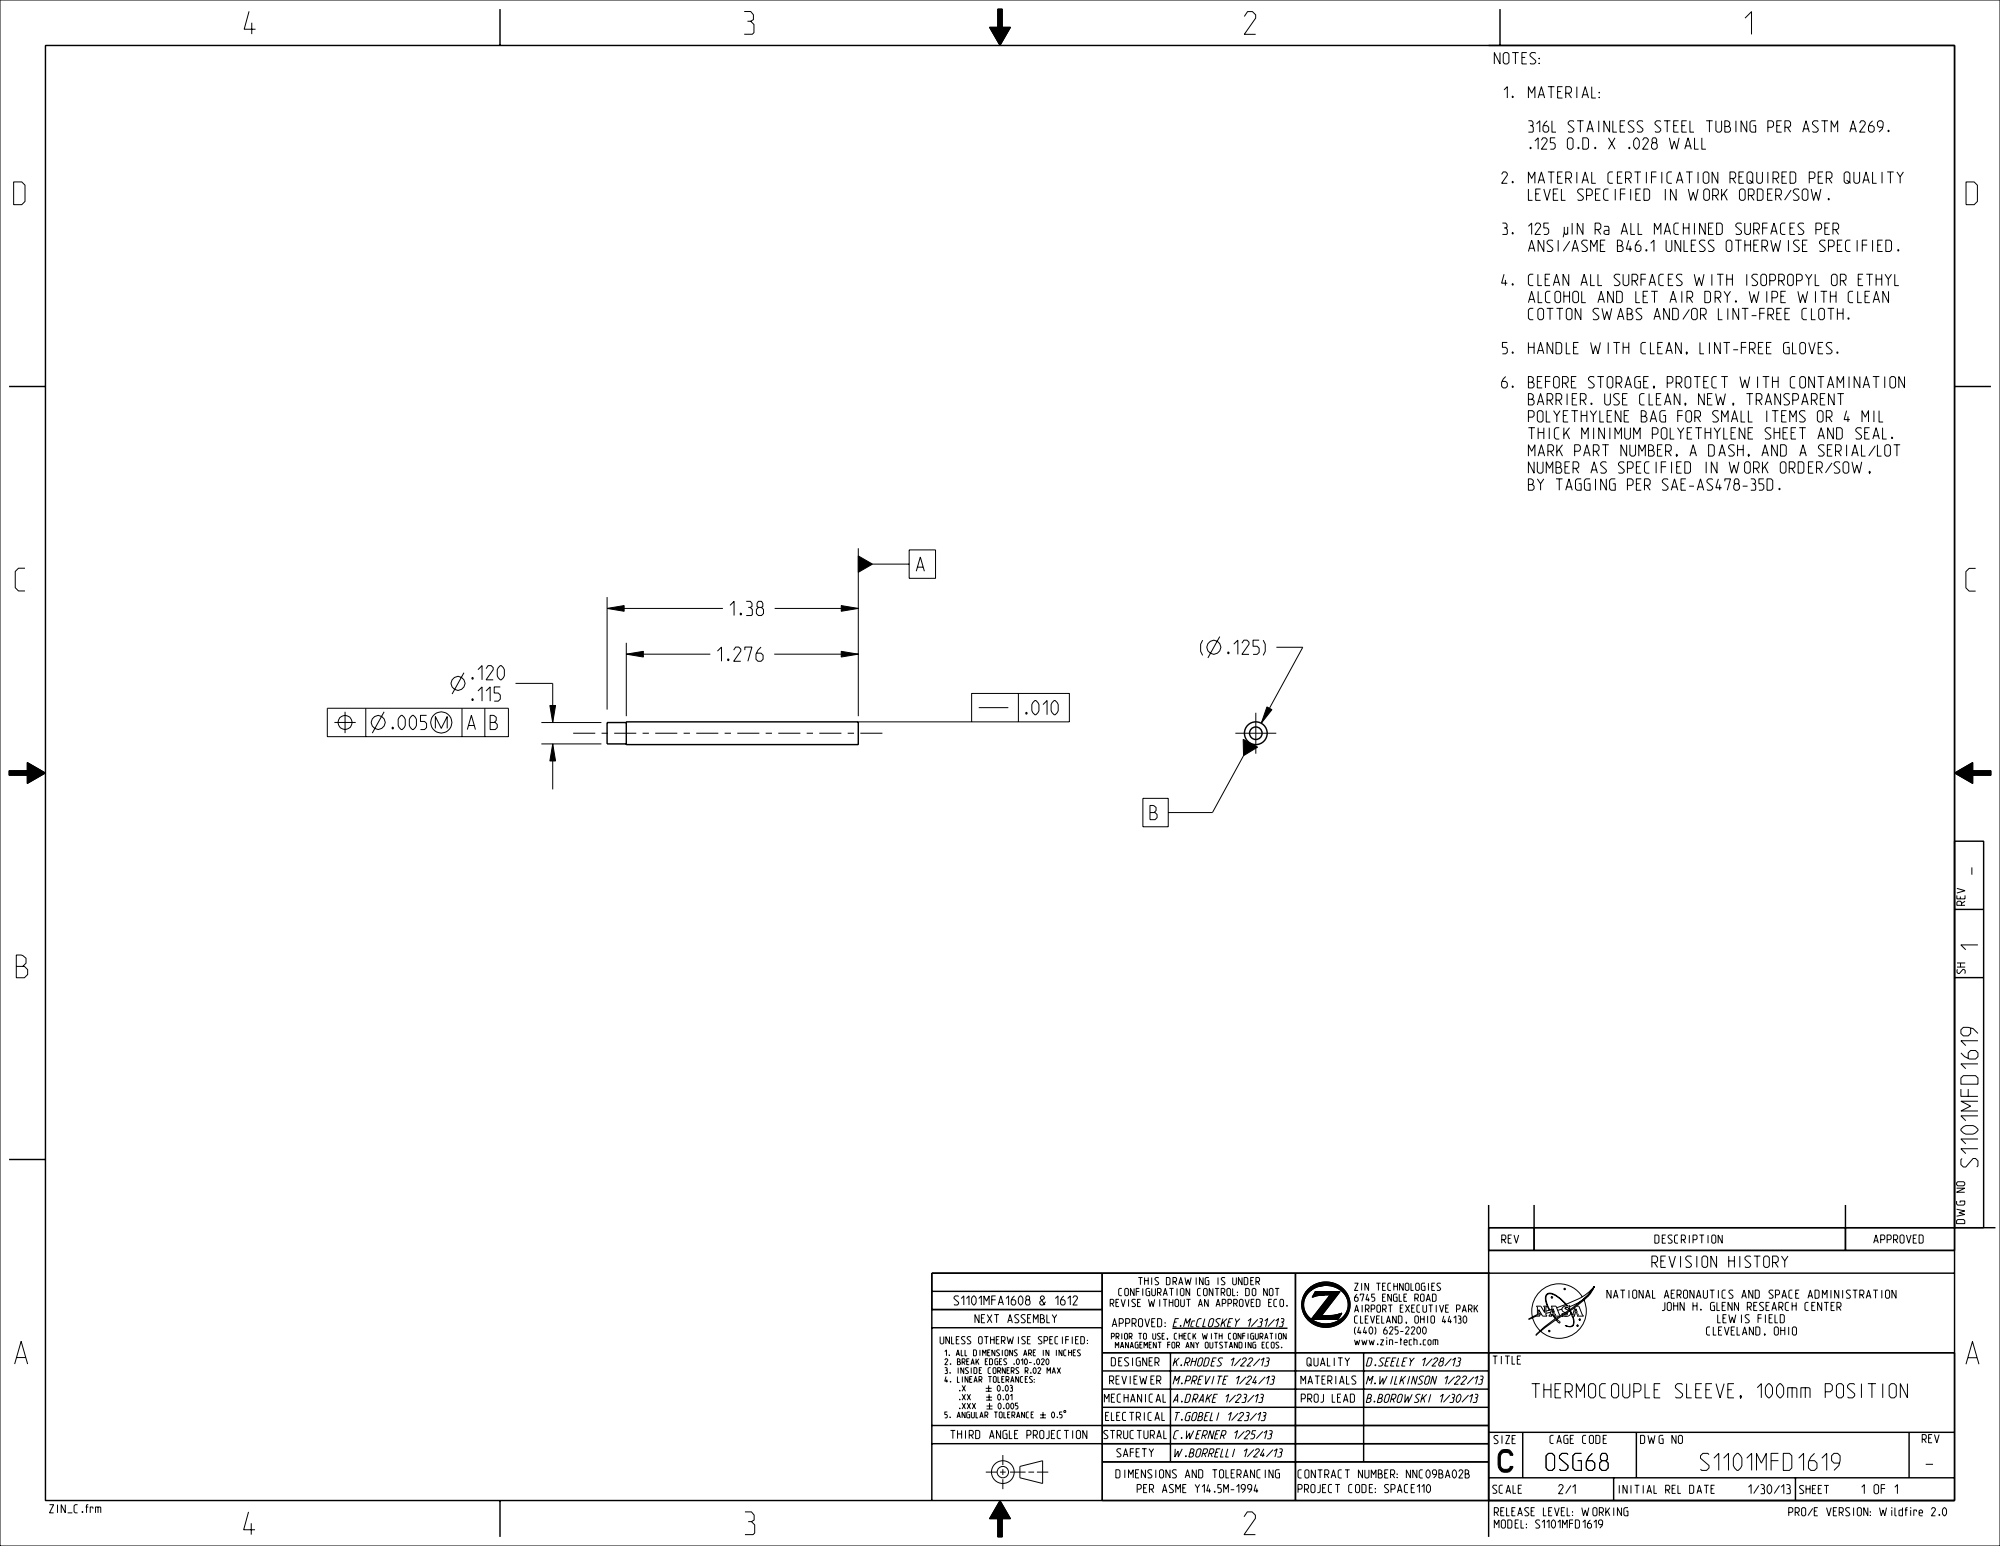
[picture p297: page 1]
