EmersonBJ/nasa-acme-burner-cad-cfd/PSI-Documents/Engineering Documents/Desenhos_Tecnicos_NASA/ACME Instruments/ACME Instruments/ACME Radiometer Layouts from ProE.pdf

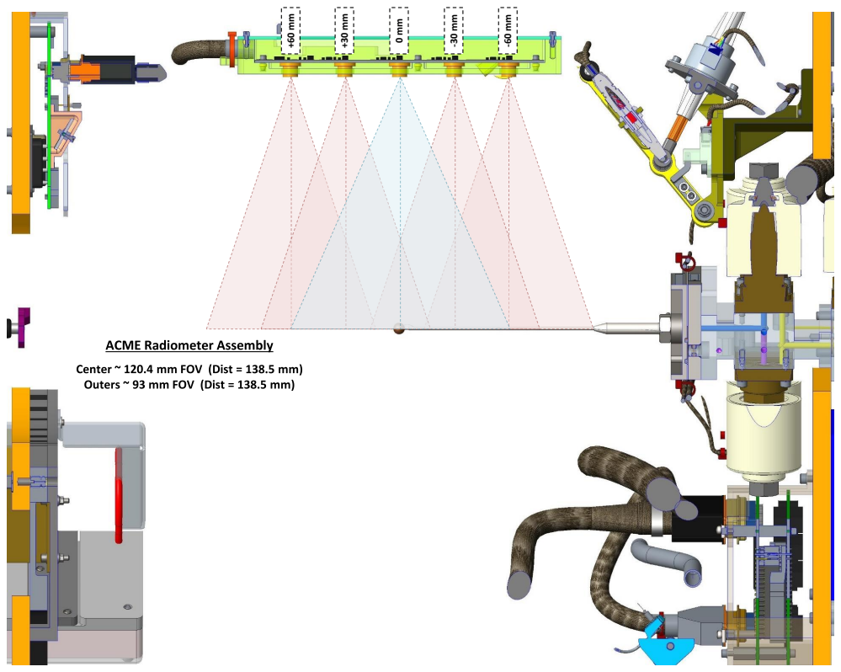
[picture p302: page 1]

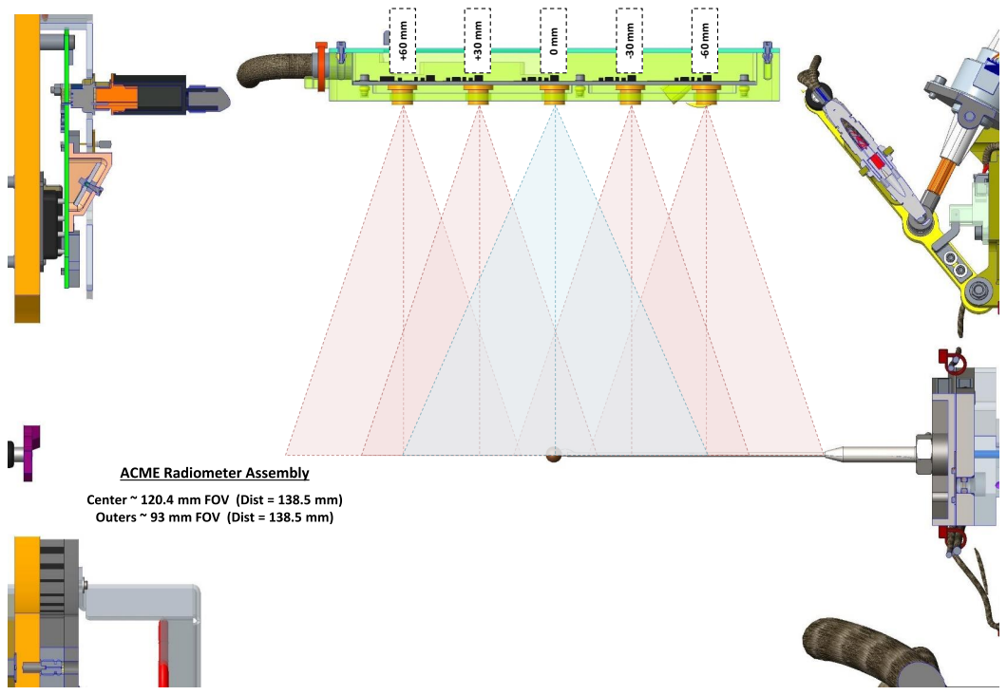
[picture p303: page 2]

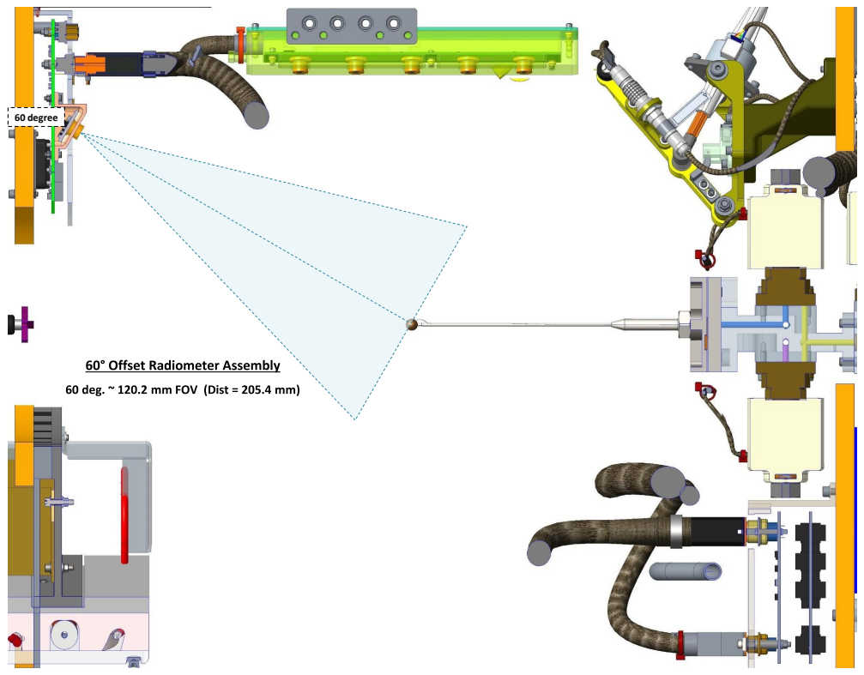
[picture p304: page 3]
60 degree

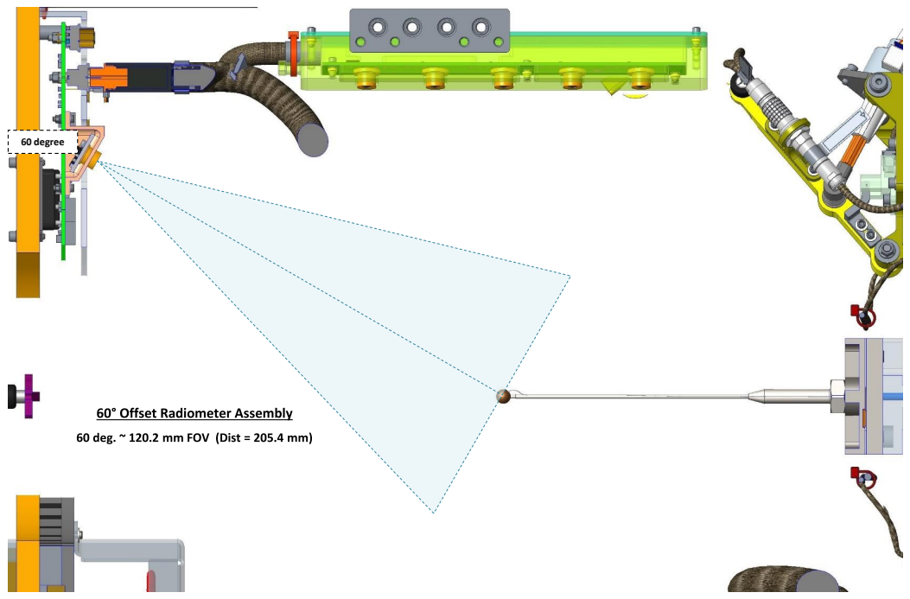
[picture p305: page 4]
60 degree

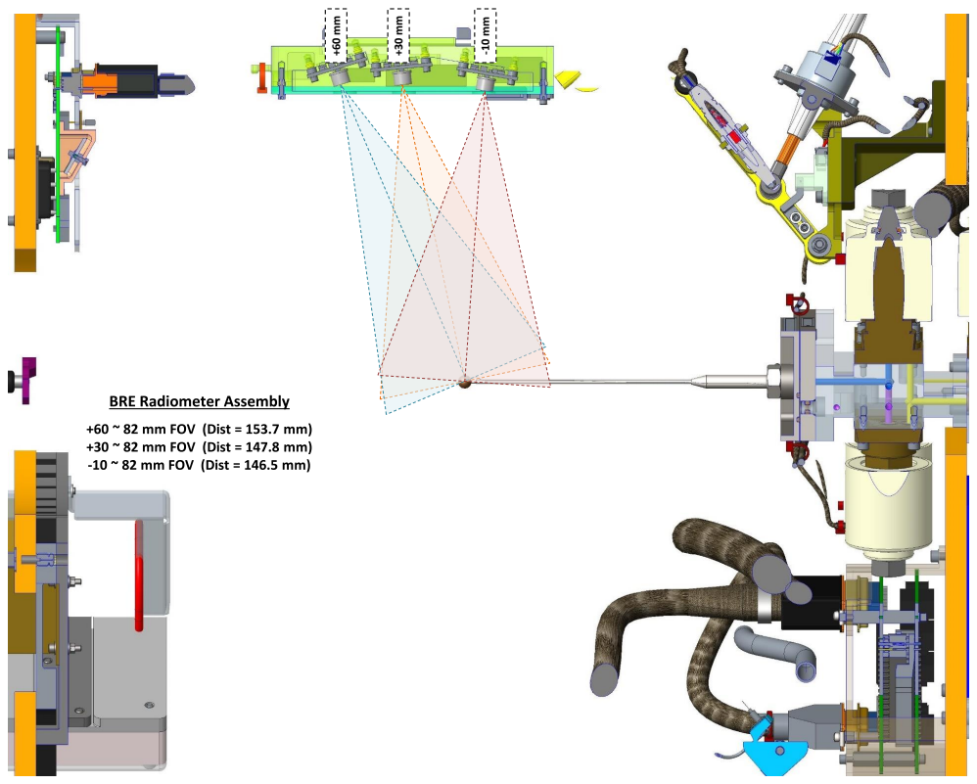
[picture p306: page 5]

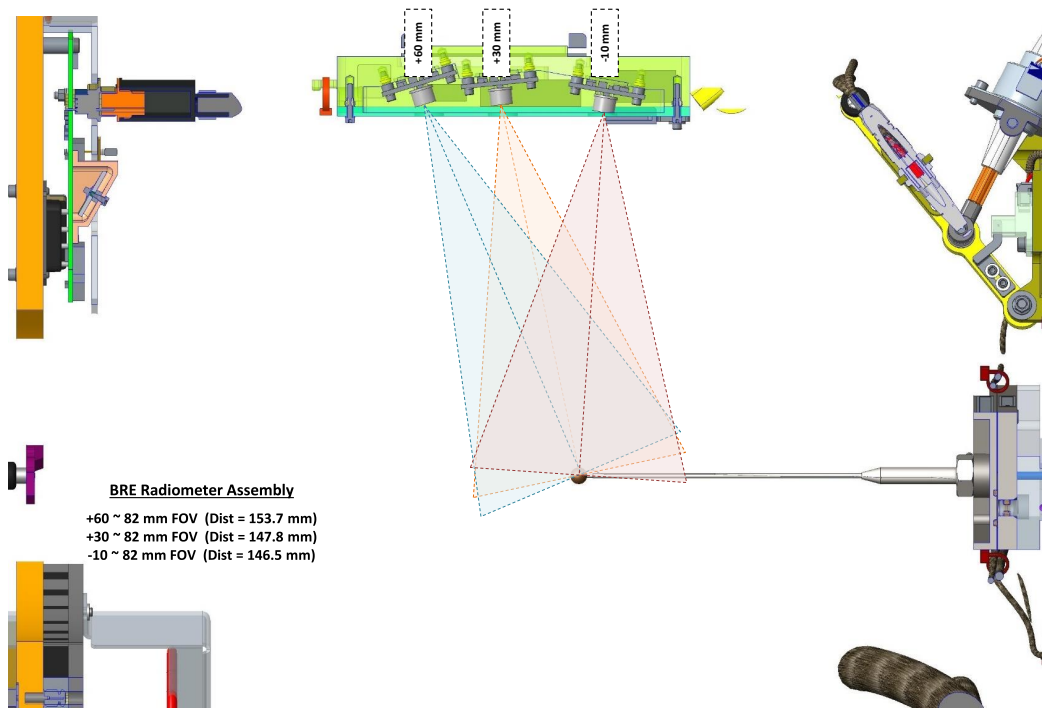
[picture p307: page 6]
