EmersonBJ/nasa-acme-burner-cad-cfd/PSI-Documents/Engineering Documents/Desenhos_Tecnicos_NASA/ACME_drawings_avionics_package/ACME_drawings_avionics_package/S1101EFC3509_A.pdf

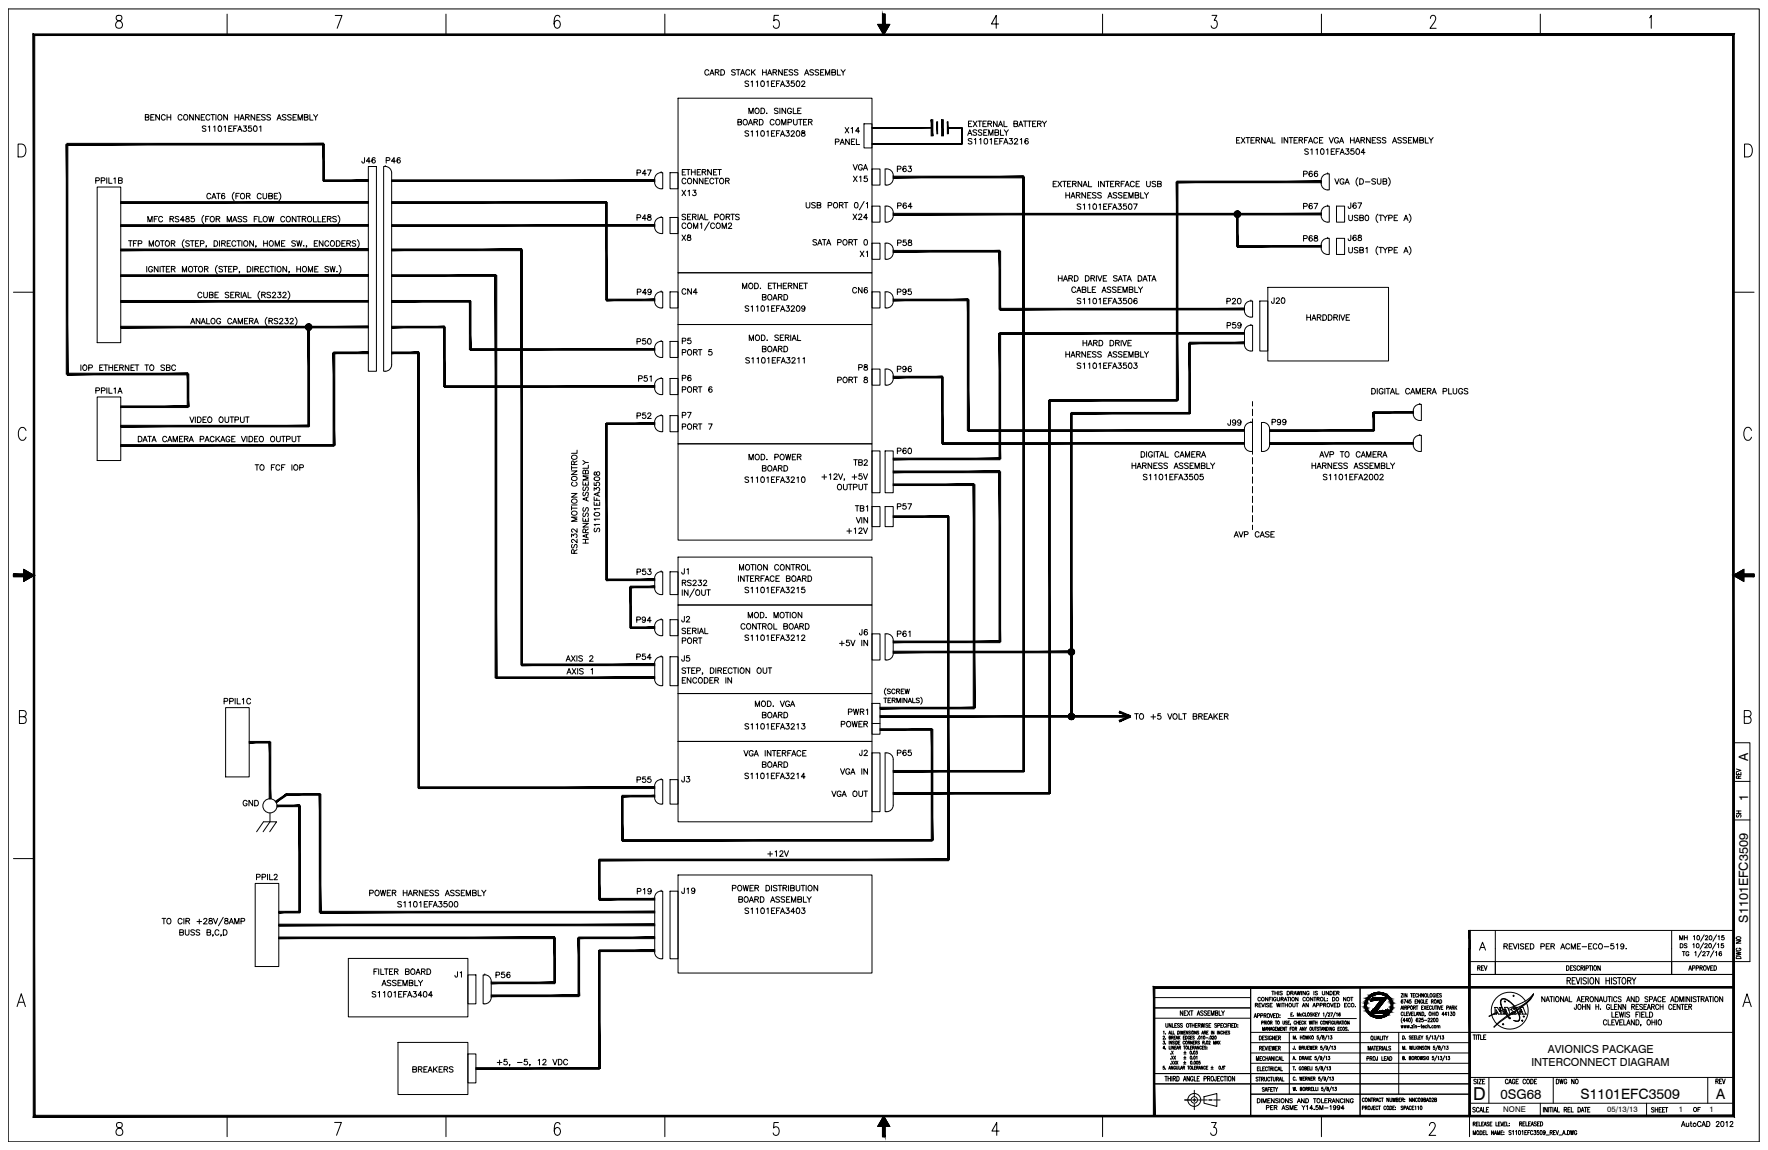
[picture p308: page 1]
0SG68 NONE; 1 S1101EFC3509; A INTERCONNECT DIAGRAM AVIONICS PACKAGE; S1101EFC3509 A 1
