EmersonBJ/nasa-acme-burner-cad-cfd/PSI-Documents/Engineering Documents/Desenhos_Tecnicos_NASA/ACME_drawings_avionics_package/ACME_drawings_avionics_package/S1101EFL3214_REV_C.pdf

4

3

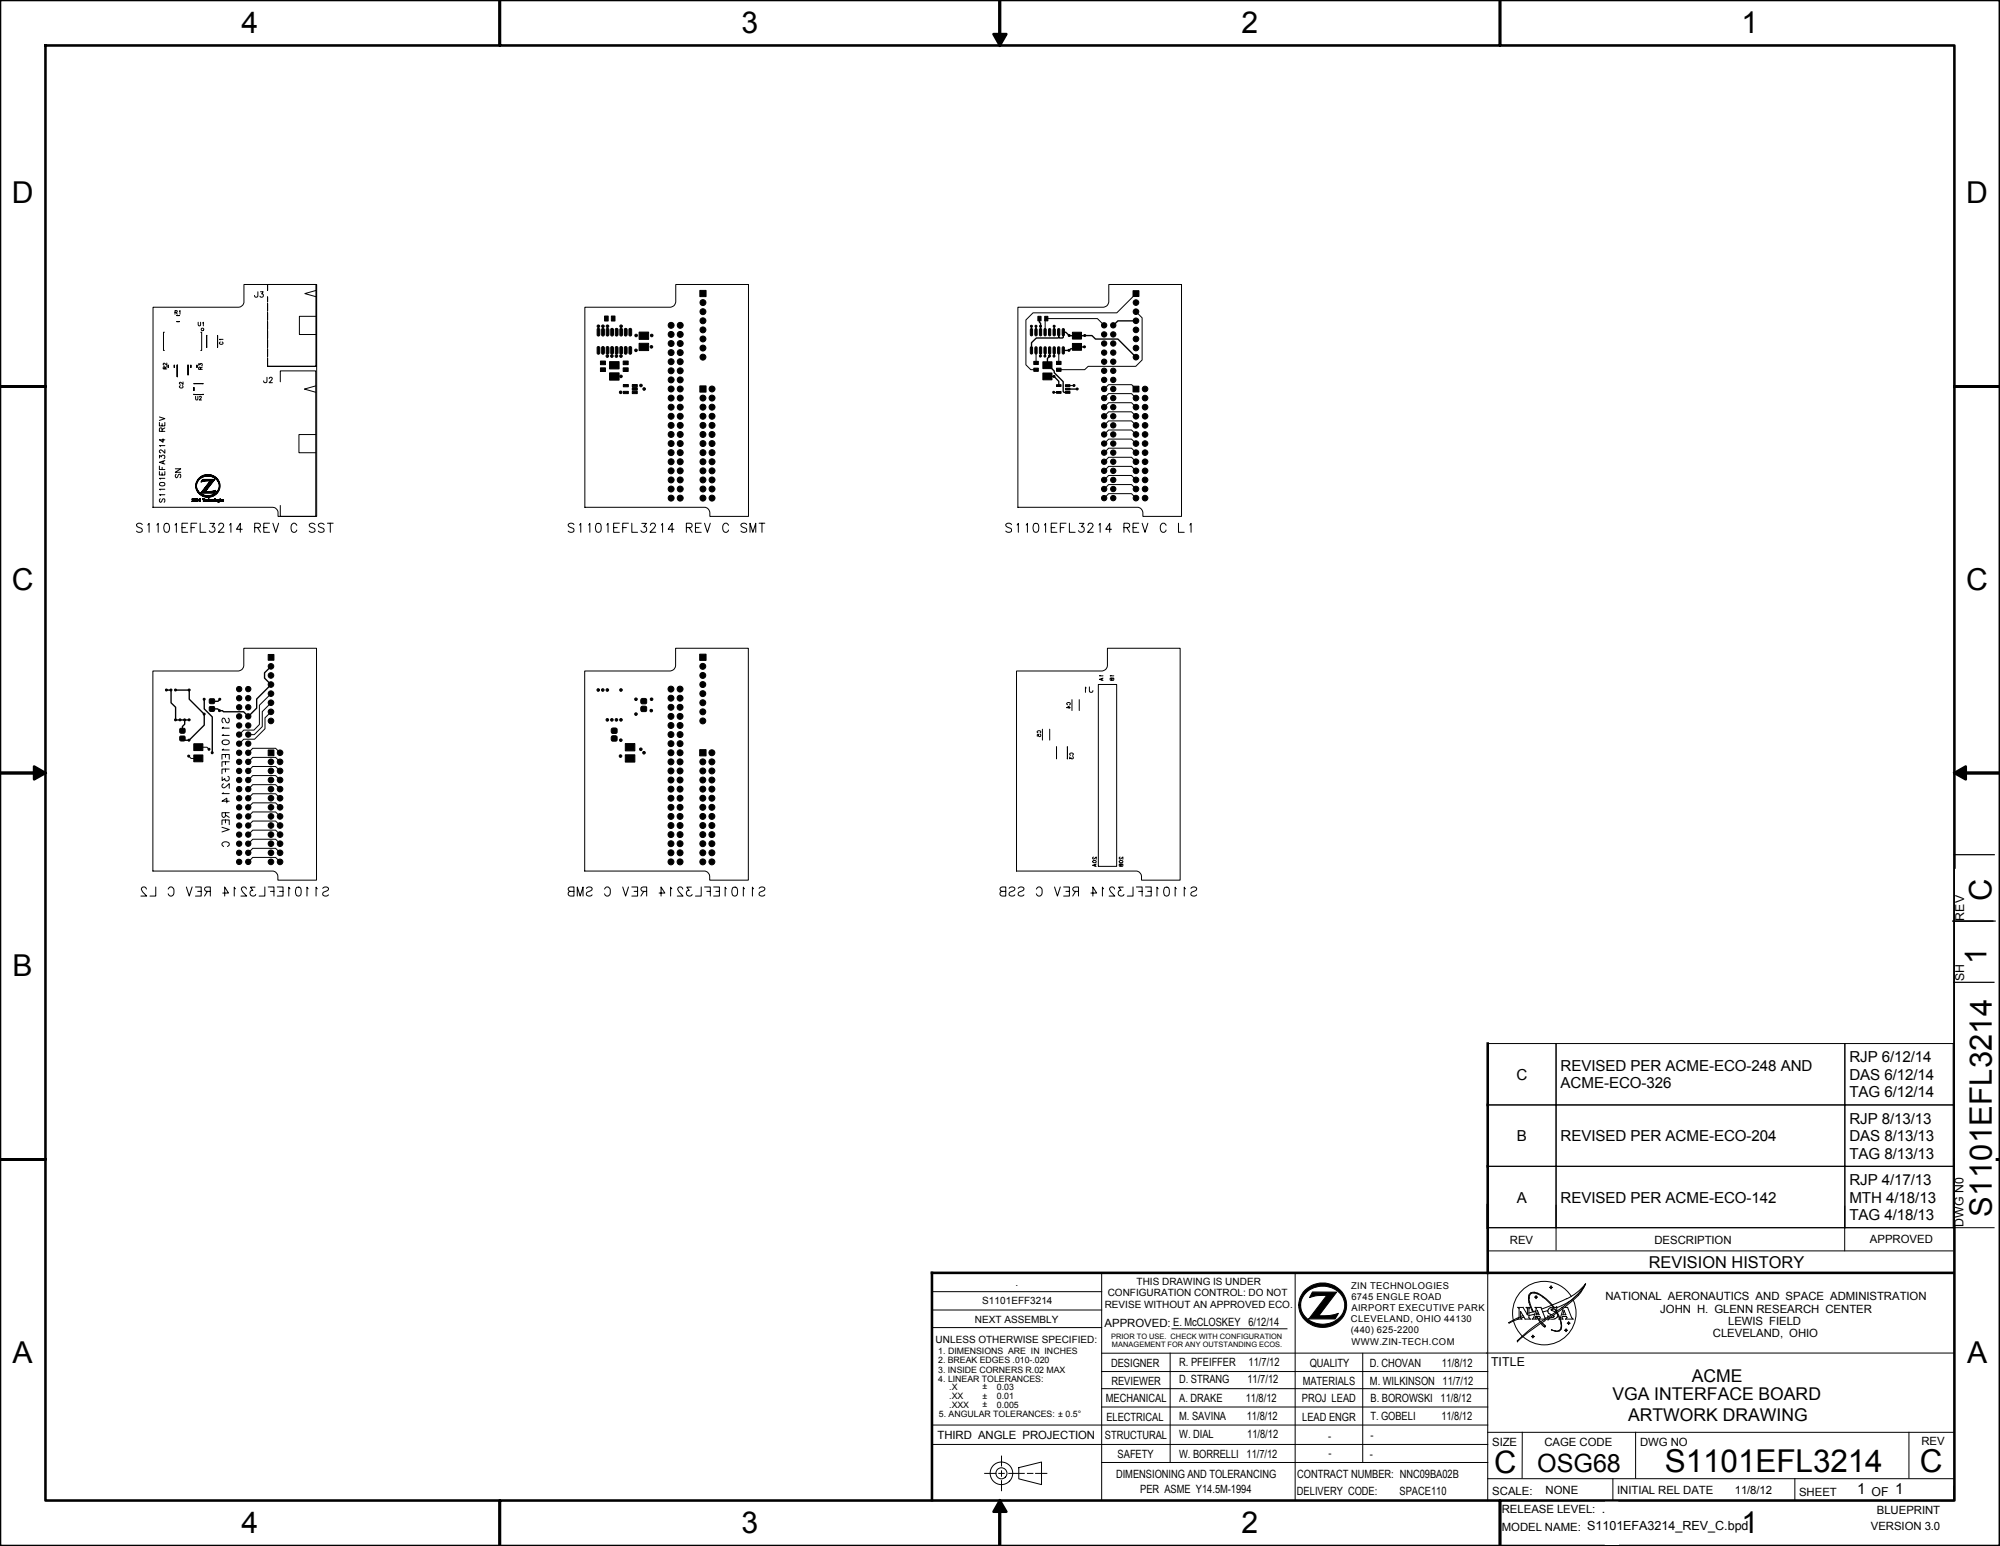
[picture p309: page 1]
REVISION HISTORY; BLUEPRINT; SH REV; S1101EFL3214; LEAD ENGR --; DWG N0; RELEASE LEVEL:; MODEL NAME: S1101EFA3214_REV_C.bpd; VERSION 3.0 . B; REVISED PER ACME-ECO-204; RJP 4/17/13 MTH 4/18/13 TAG 4/18/13

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

RJP 8/13/13 DAS 8/13/13 TAG 8/13/13

A REVISED PER ACME-ECO-142 REV | DESCRIPTION | APPROVED

THIS DRAWING IS UNDER CONFIGURATION CONTROL: DO NOT REVISE WITHOUT AN APPROVED ECO. E. McCLOSKEY 6/12/14 PRIOR TO USE. CHECK WITH CONFIGURATION MANAGEMENT FOR ANY OUTSTANDING ECOS. | B. BOROWSKI 11/8/12 . S1101EFF3214 ZIN TECHNOLOGIES 6745 ENGLE ROAD AIRPORT EXECUTIVE PARK CLEVELAND, OHIO 44130 (440) 625-2200 WWW.ZIN-TECH.COM | | | CLEVELAND, OHIO TITLE NATIONAL AERONAUTICS AND SPACE ADMINISTRATION LEWIS FIELD

JOHN H. GLENN RESEARCH CENTER

APPROVED: NEXT ASSEMBLY

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

DESIGNER | R. PFEIFFER 11/7/12 | QUALITY | D. CHOVAN 11/8/12 | ACME VGA INTERFACE BOARD ARTWORK DRAWING

REVIEWER | D. STRANG 11/7/12 | MATERIALS | M. WILKINSON 11/7/12

MECHANICAL | A. DRAKE 11/8/12 | PROJ LEAD

THIRD ANGLE PROJECTION | STRUCTURAL | 11/8/12 | | T. GOBELI 11/8/12 -- W. DIAL

ELECTRICAL | M. SAVINA 11/8/12

SIZE | CAGE CODE OSG68 | DWG NO S1101EFL3214 | REV C

W. BORRELLI 11/7/12 | | | C SAFETY

DIMENSIONING AND TOLERANCING PER ASME Y14.5M-1994 | | CONTRACT NUMBER: NNC09BA02B DELIVERY CODE: SPACE110

SCALE: NONE | INITIAL REL DATE 11/8/12 | 1 1 OF SHEET
