EmersonBJ/nasa-acme-burner-cad-cfd/PSI-Documents/Engineering Documents/Desenhos_Tecnicos_NASA/ACME_drawings_avionics_package/ACME_drawings_avionics_package/s1101mfa3300_E.pdf

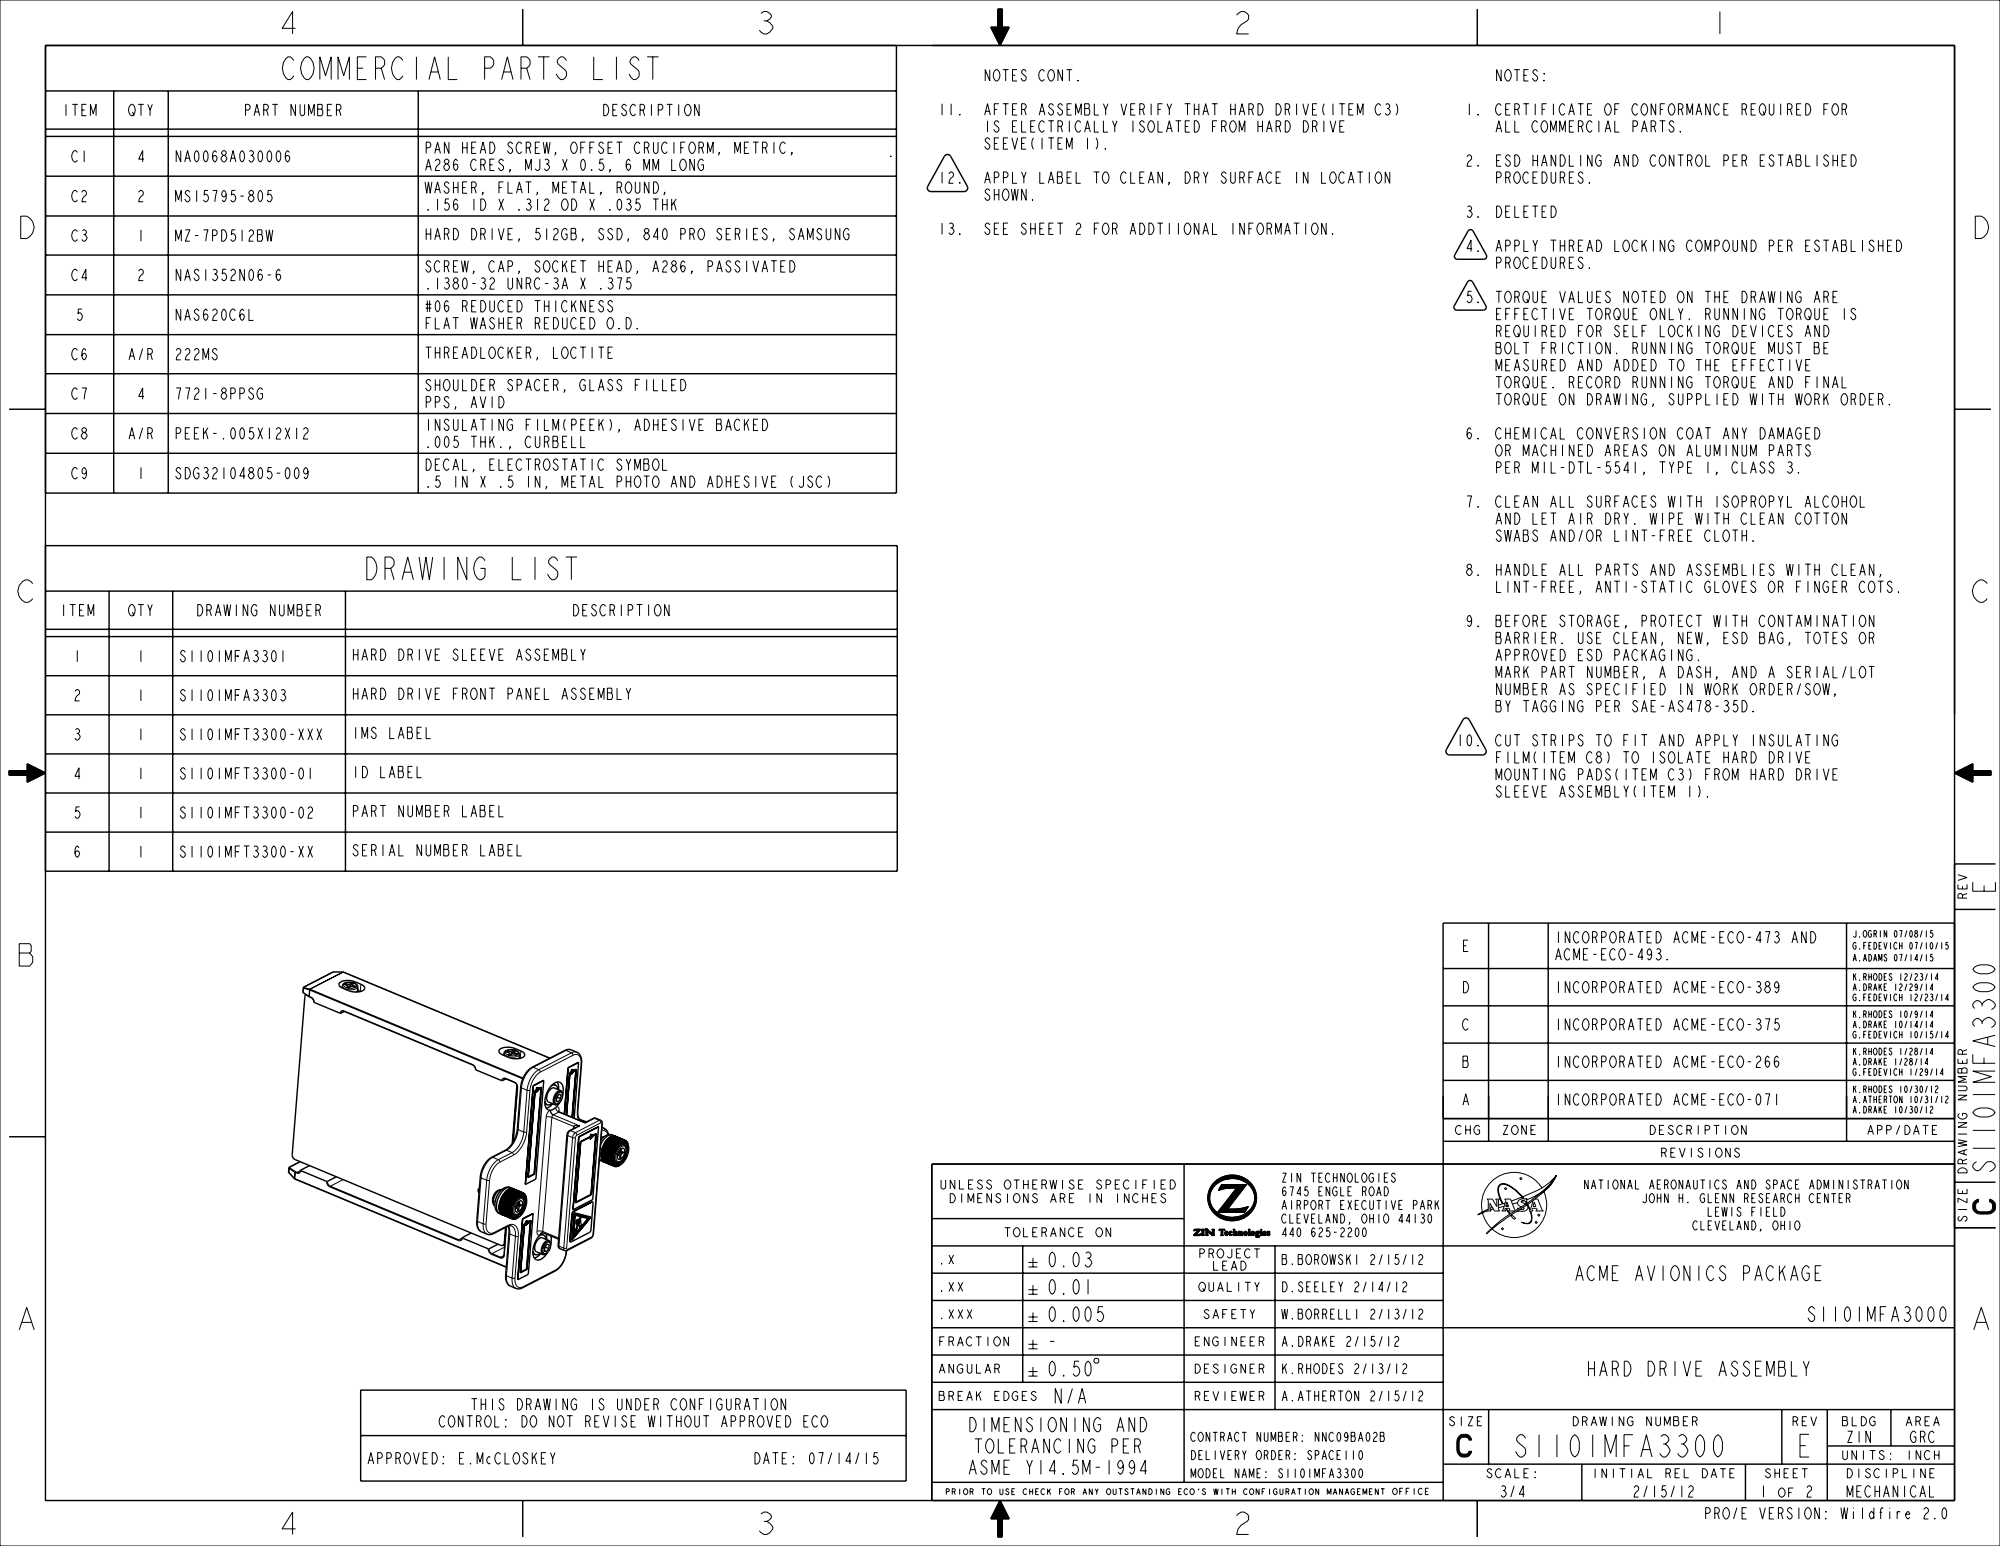
[picture p310: page 1]

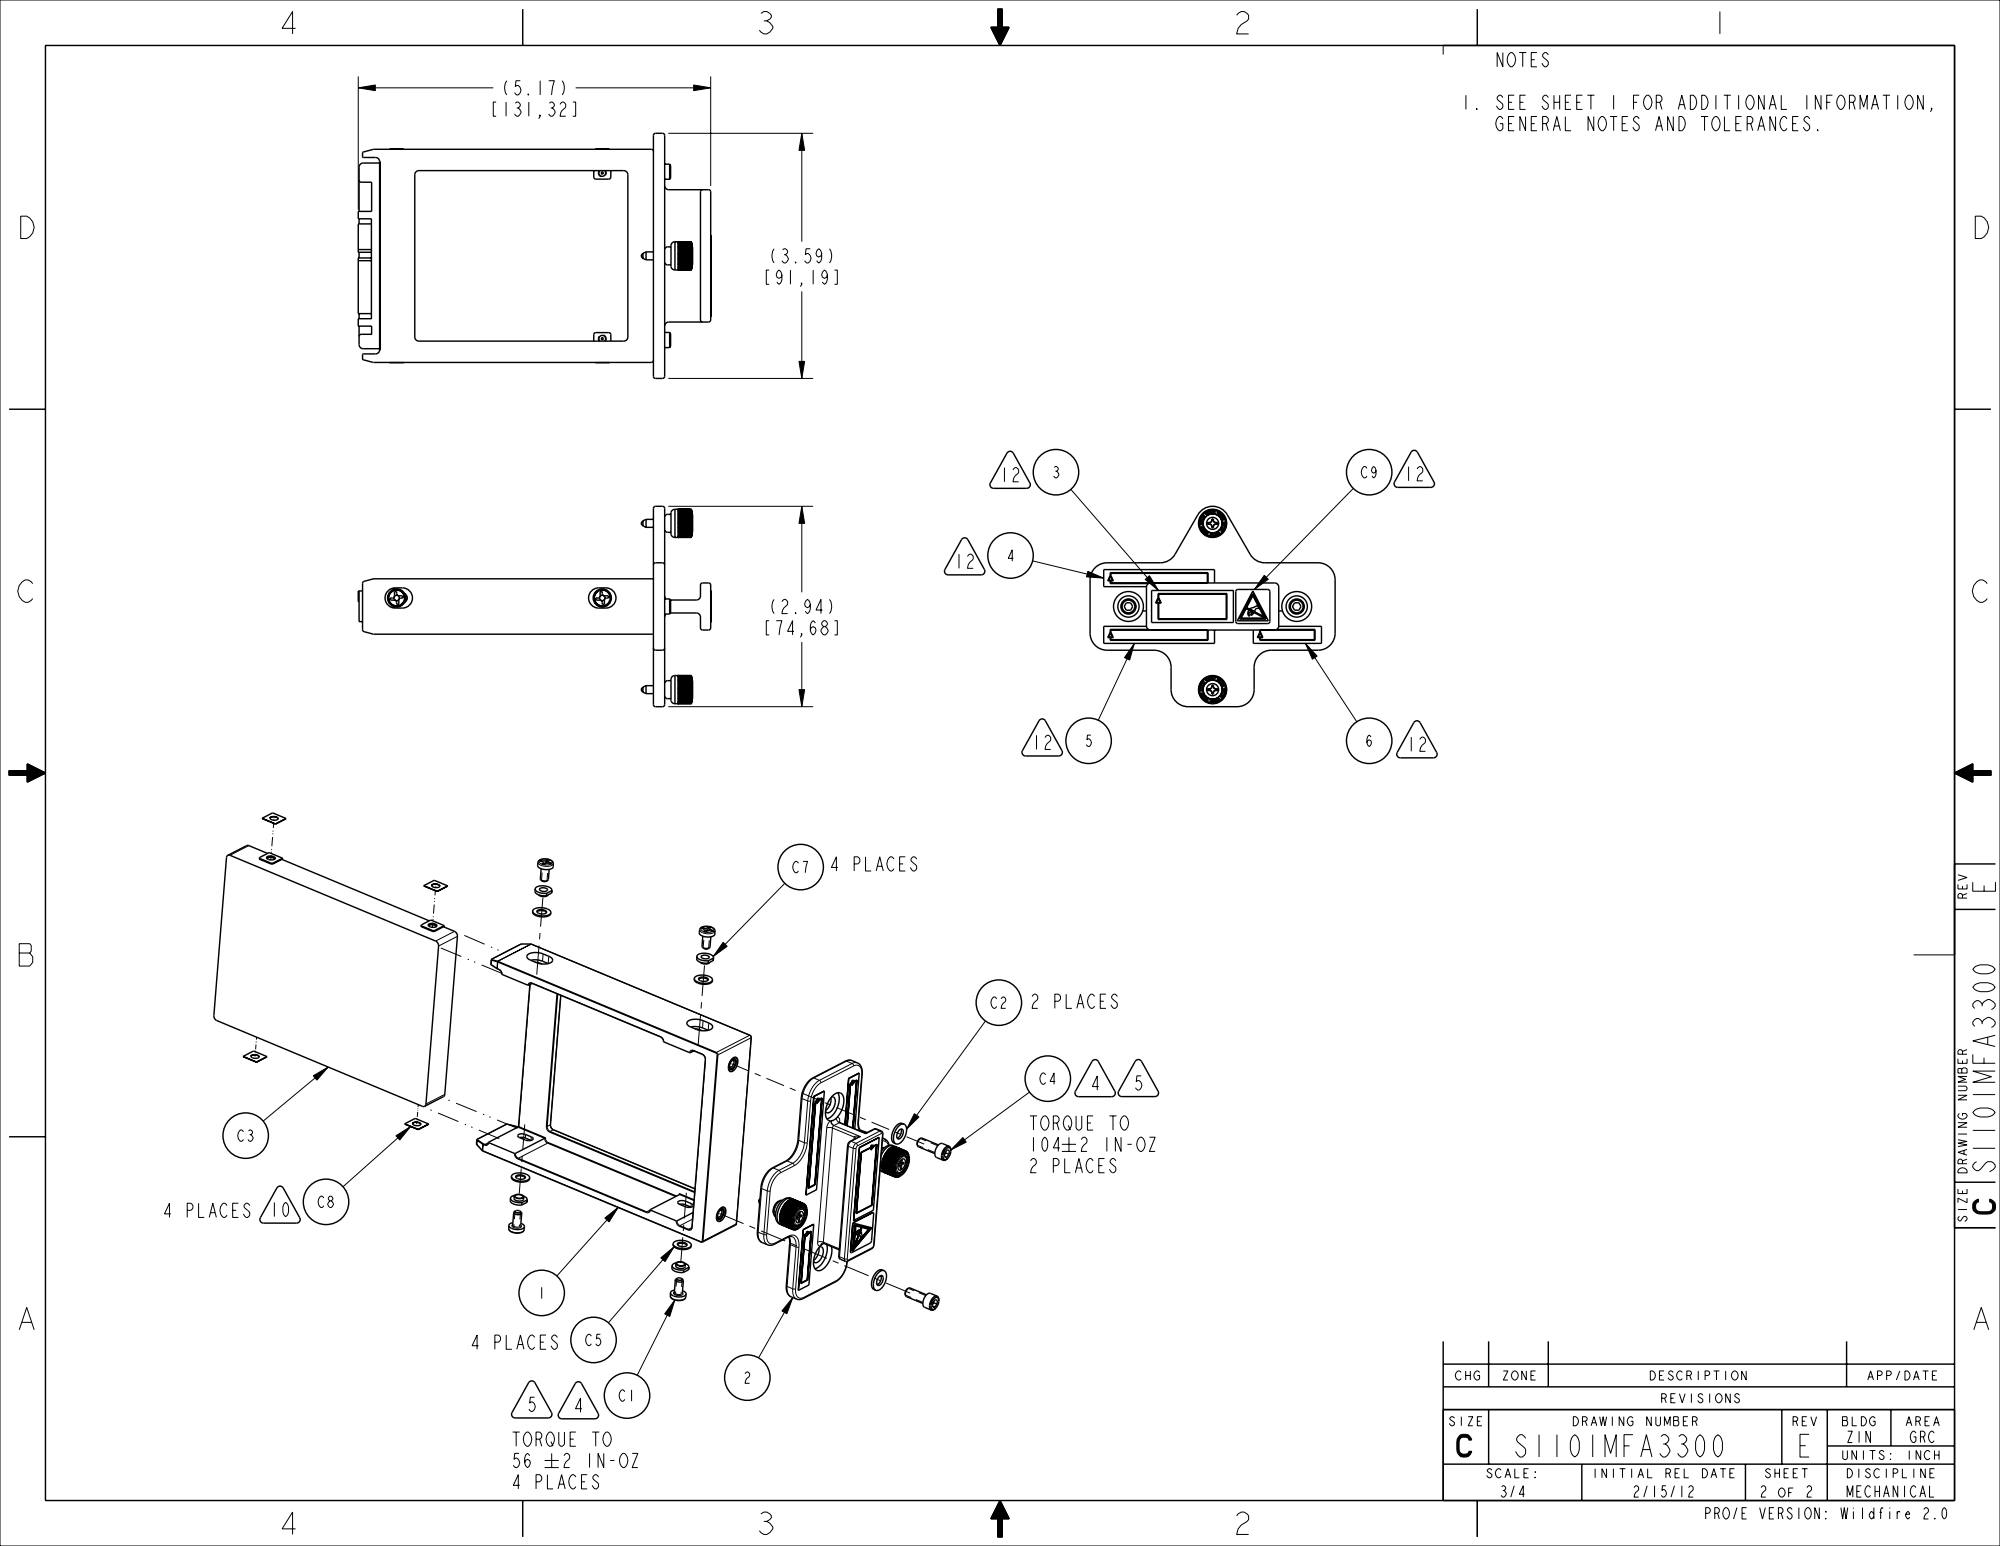
[picture p311: page 2]
