EmersonBJ/nasa-acme-burner-cad-cfd/PSI-Documents/Engineering Documents/Desenhos_Tecnicos_NASA/ACME_drawings_common_electrical/ACME_drawings_common_electrical/S1101EFL0313_C.pdf

4

3

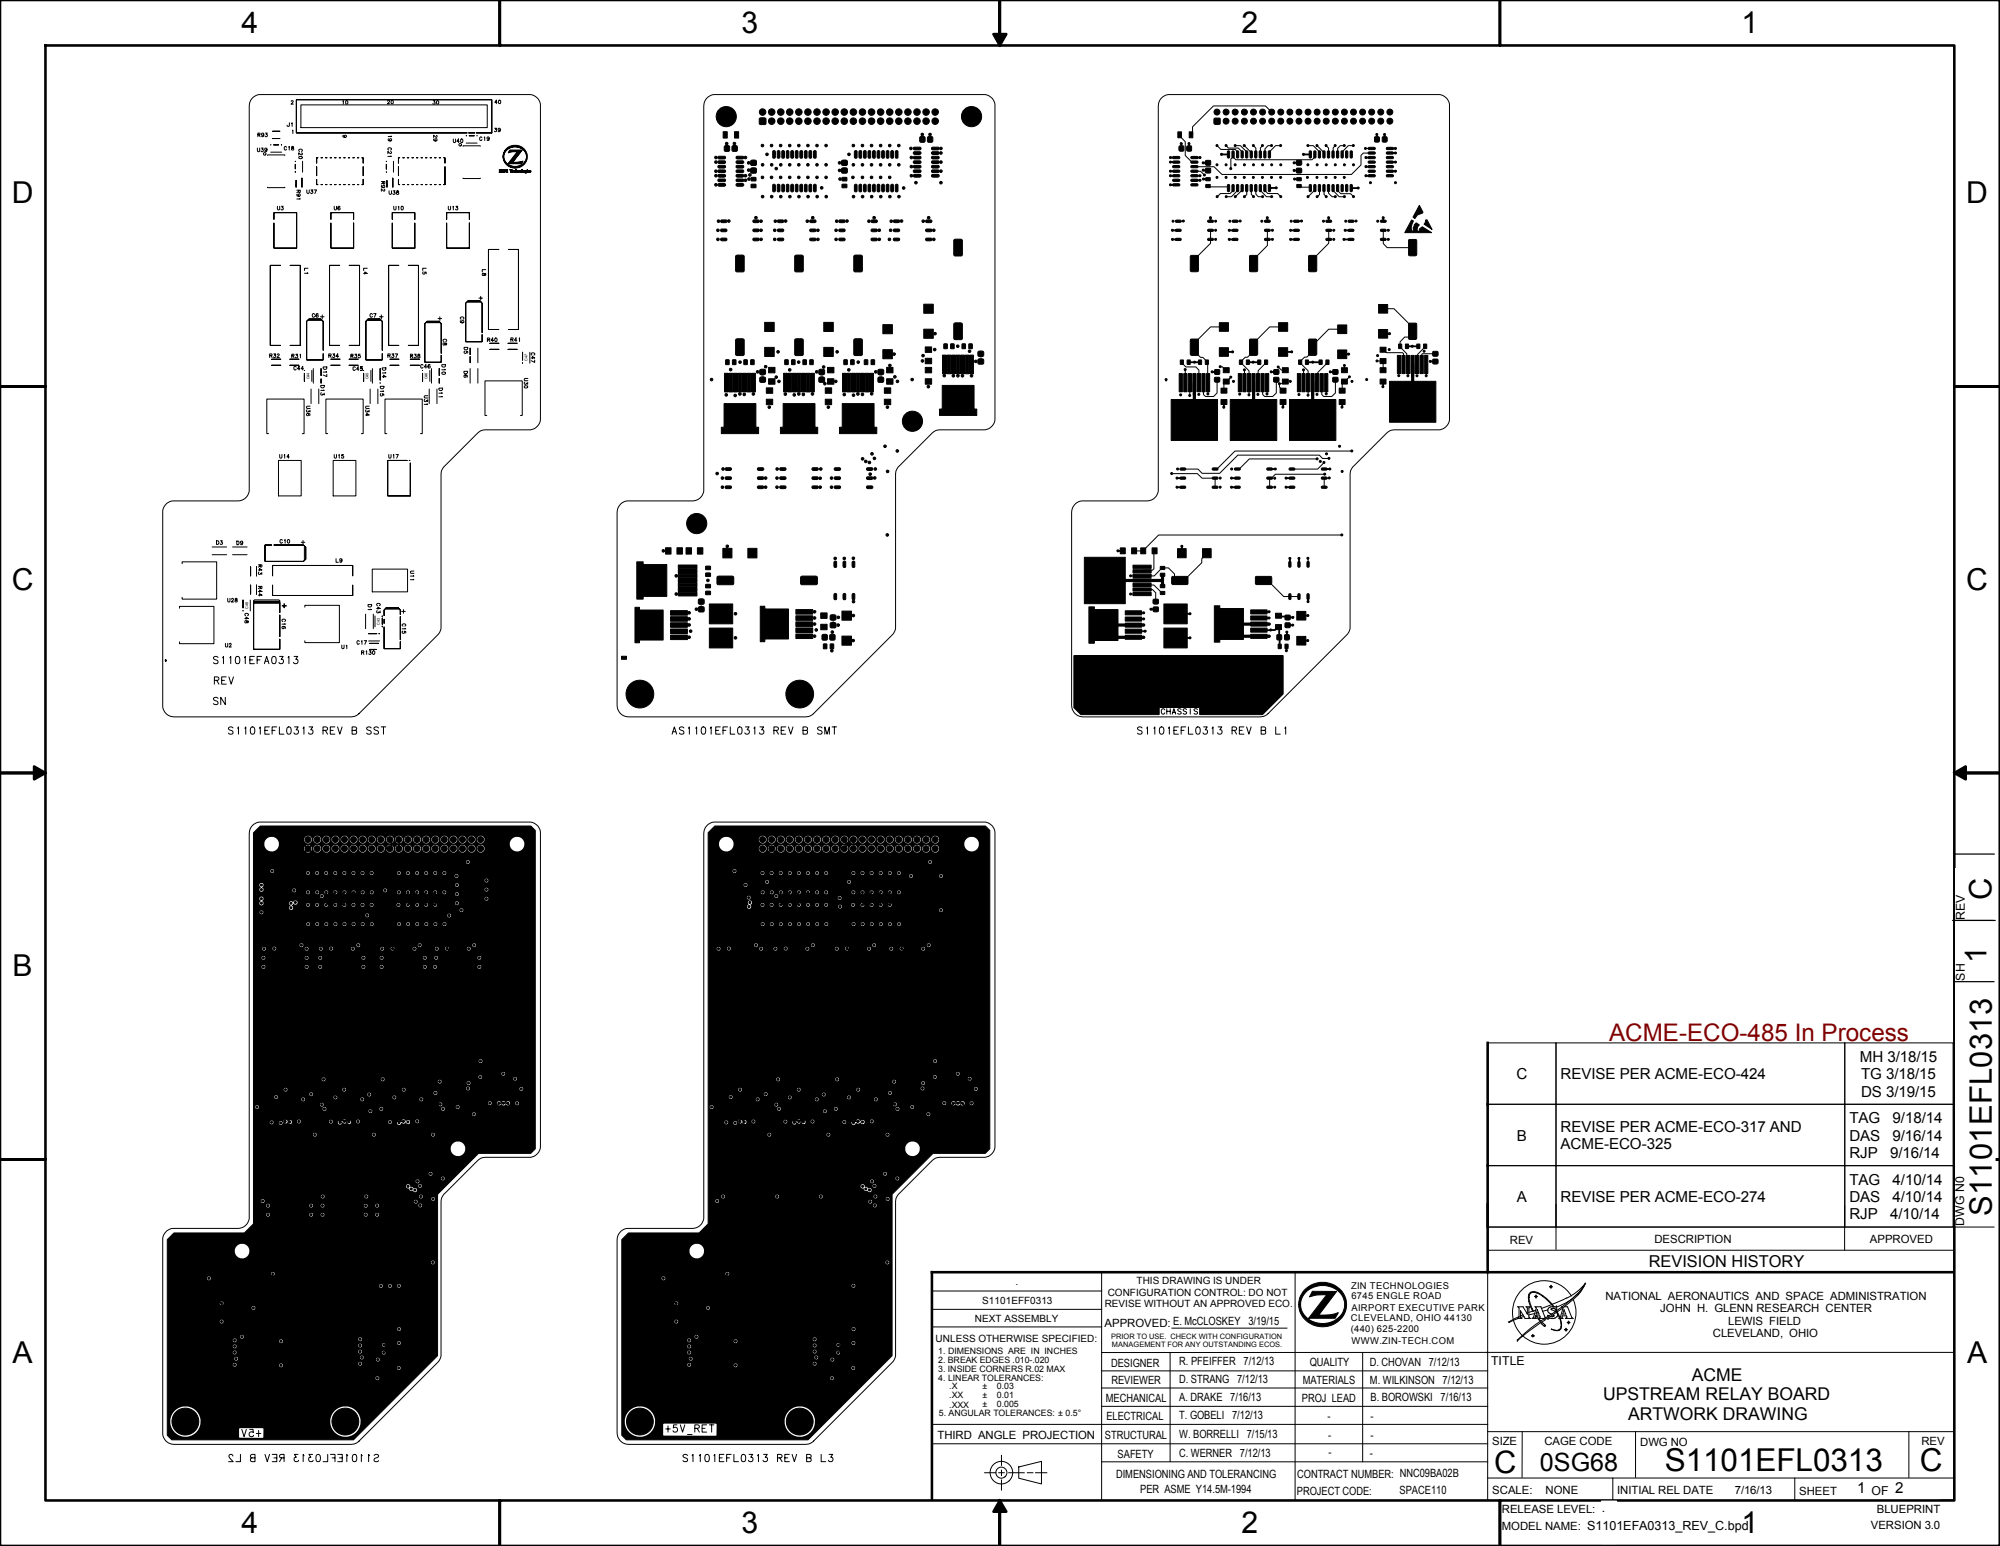
[picture p312: page 1]

ACME-ECO-485 In Process

C REVISE PER ACME-ECO-424

B | REVISE PER ACME-ECO-317 AND ACME-ECO-325 | TAG 9/18/14 DAS 9/16/14 RJP 9/16/14

A REVISE PER ACME-ECO-274 REV | DESCRIPTION | TAG 4/10/14 DAS 4/10/14 RJP 4/10/14 APPROVED

THIS DRAWING IS UNDER

ZIN TECHNOLOGIES
6745 ENGLE ROAD
AIRPORT EXECUTIVE PARK
CLEVELAND, OHIO 44130
WWW.ZIN-TECH.COM

CONFIGURATION CONTROL: DO NOT
REVISE WITHOUT AN APPROVED ECO.

NATIONAL AERONAUTICS AND SPACE ADMINISTRATION

JOHN H. GLENN RESEARCH CENTER

UNLESS OTHERWISE SPECIFIED:
1. DIMENSIONS ARE IN INCHES
2. BREAK EDGES .010-.020
3. INSIDE CORNERS R.02 MAX
4. LINEAR TOLERANCES:
.XXX
5. ANGULAR TOLERANCES: ± 0.5°

PRIOR TO USE. CHECK WITH CONFIGURATION
MANAGEMENT FOR ANY OUTSTANDING ECOS.

DESIGNER | R. PFEIFFER 7/12/13 | QUALITY | D. CHOVAN 7/12/13 | ACME UPSTREAM RELAY BOARD ARTWORK DRAWING

REVIEWER | D. STRANG 7/12/13 | MATERIALS

MECHANICAL | | PROJ LEAD

ELECTRICAL | T. GOBELI 7/12/13

THIRD ANGLE PROJECTION | STRUCTURAL

SIZE | CAGE CODE 0SG68 | DWG NO S1101EFL0313 | REV C

C. WERNER 7/12/13 | | | C SAFETY

DIMENSIONING AND TOLERANCING PER ASME Y14.5M-1994 | | CONTRACT NUMBER: NNC09BA02B PROJECT CODE: SPACE110

SCALE: NONE | INITIAL REL DATE 7/16/13 | 1 2 SHEET OF

4

3

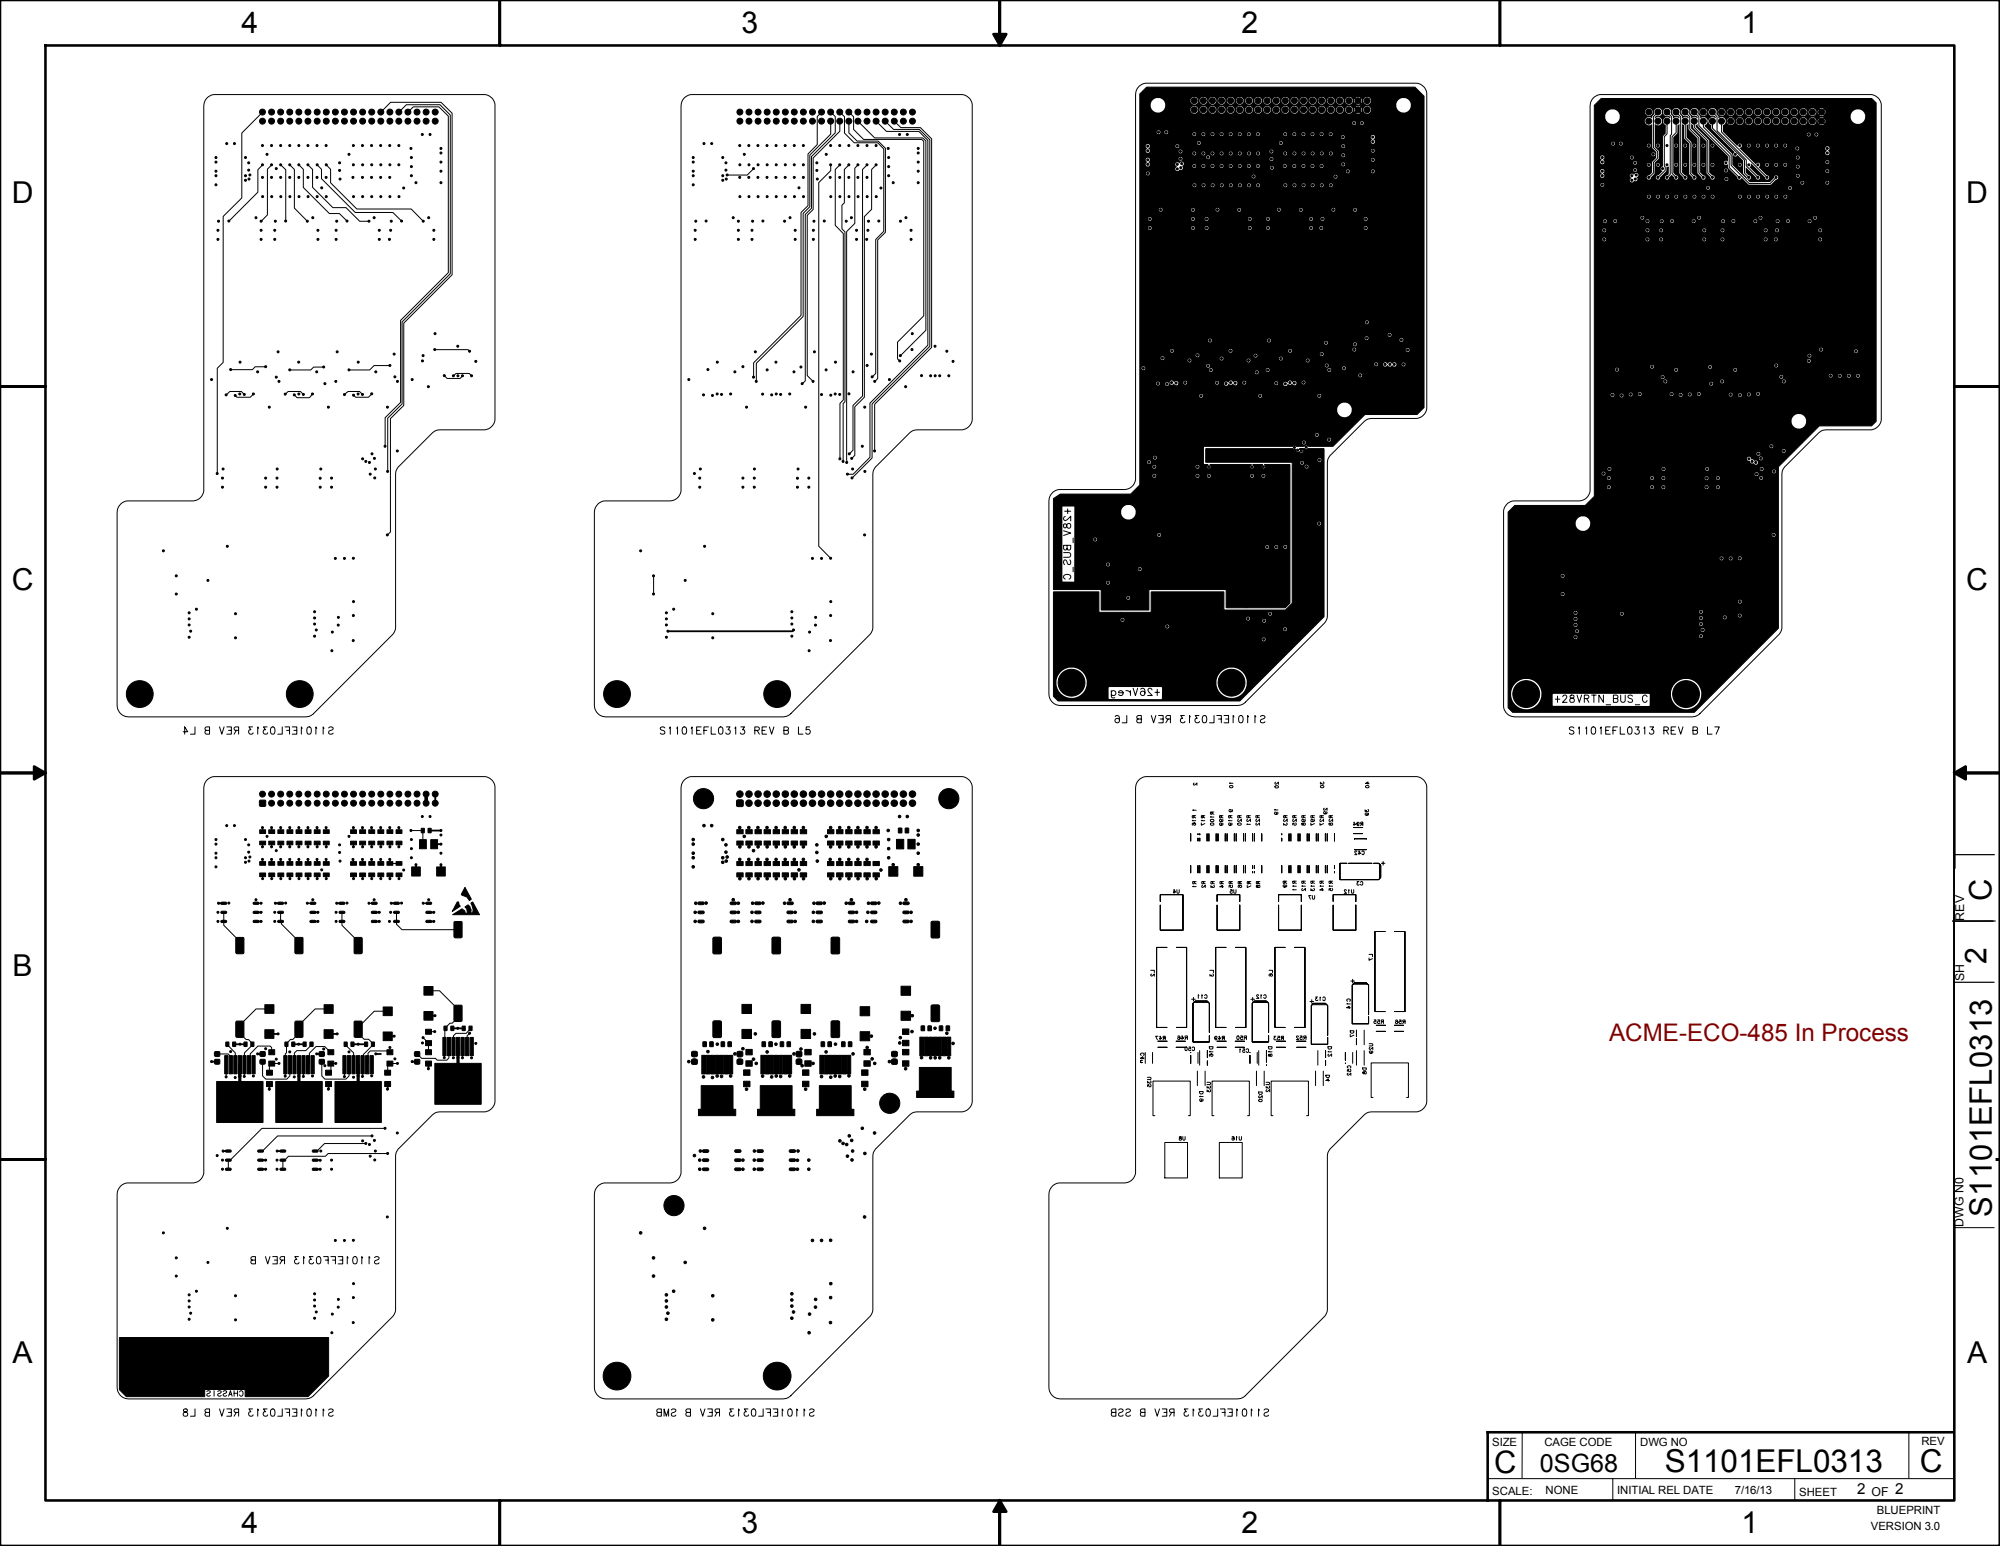
[picture p313: page 2]
BLUEPRINT; SH REV; S1101EFL0313; DWG N0; VERSION 3.0

ACME-ECO-485 In Process

SIZE C | CAGE CODE 0SG68 | DWG NO S1101EFL0313 | REV C

SCALE: NONE | INITIAL REL DATE 7/16/13 | 2 2 SHEET OF
