EmersonBJ/nasa-acme-burner-cad-cfd/PSI-Documents/Engineering Documents/Desenhos_Tecnicos_NASA/ACME_drawings_common_electrical/ACME_drawings_common_electrical/s1101mfa0200_D.pdf

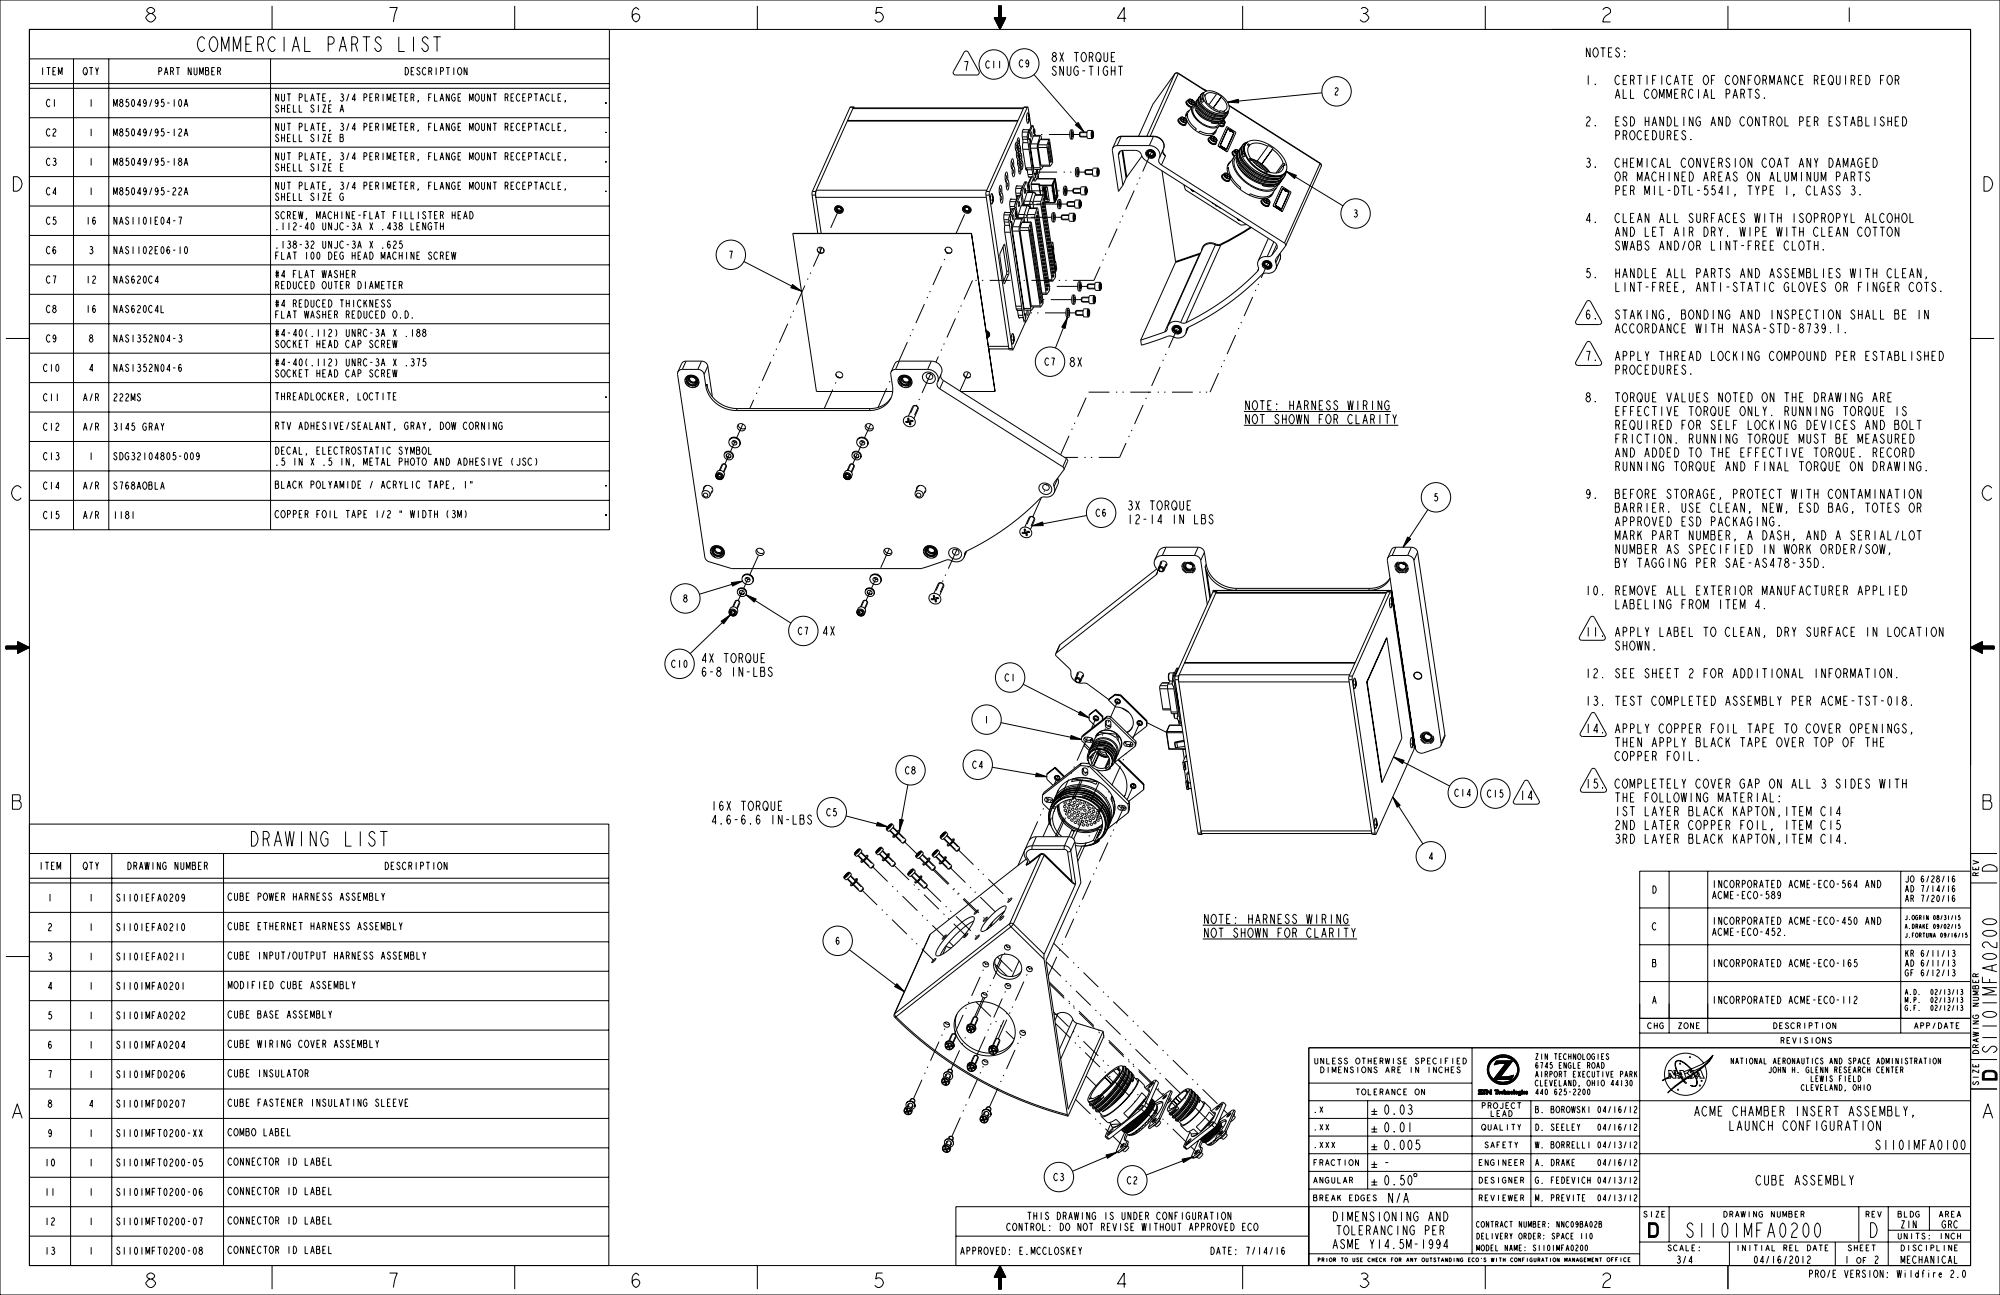
[picture p314: page 1]

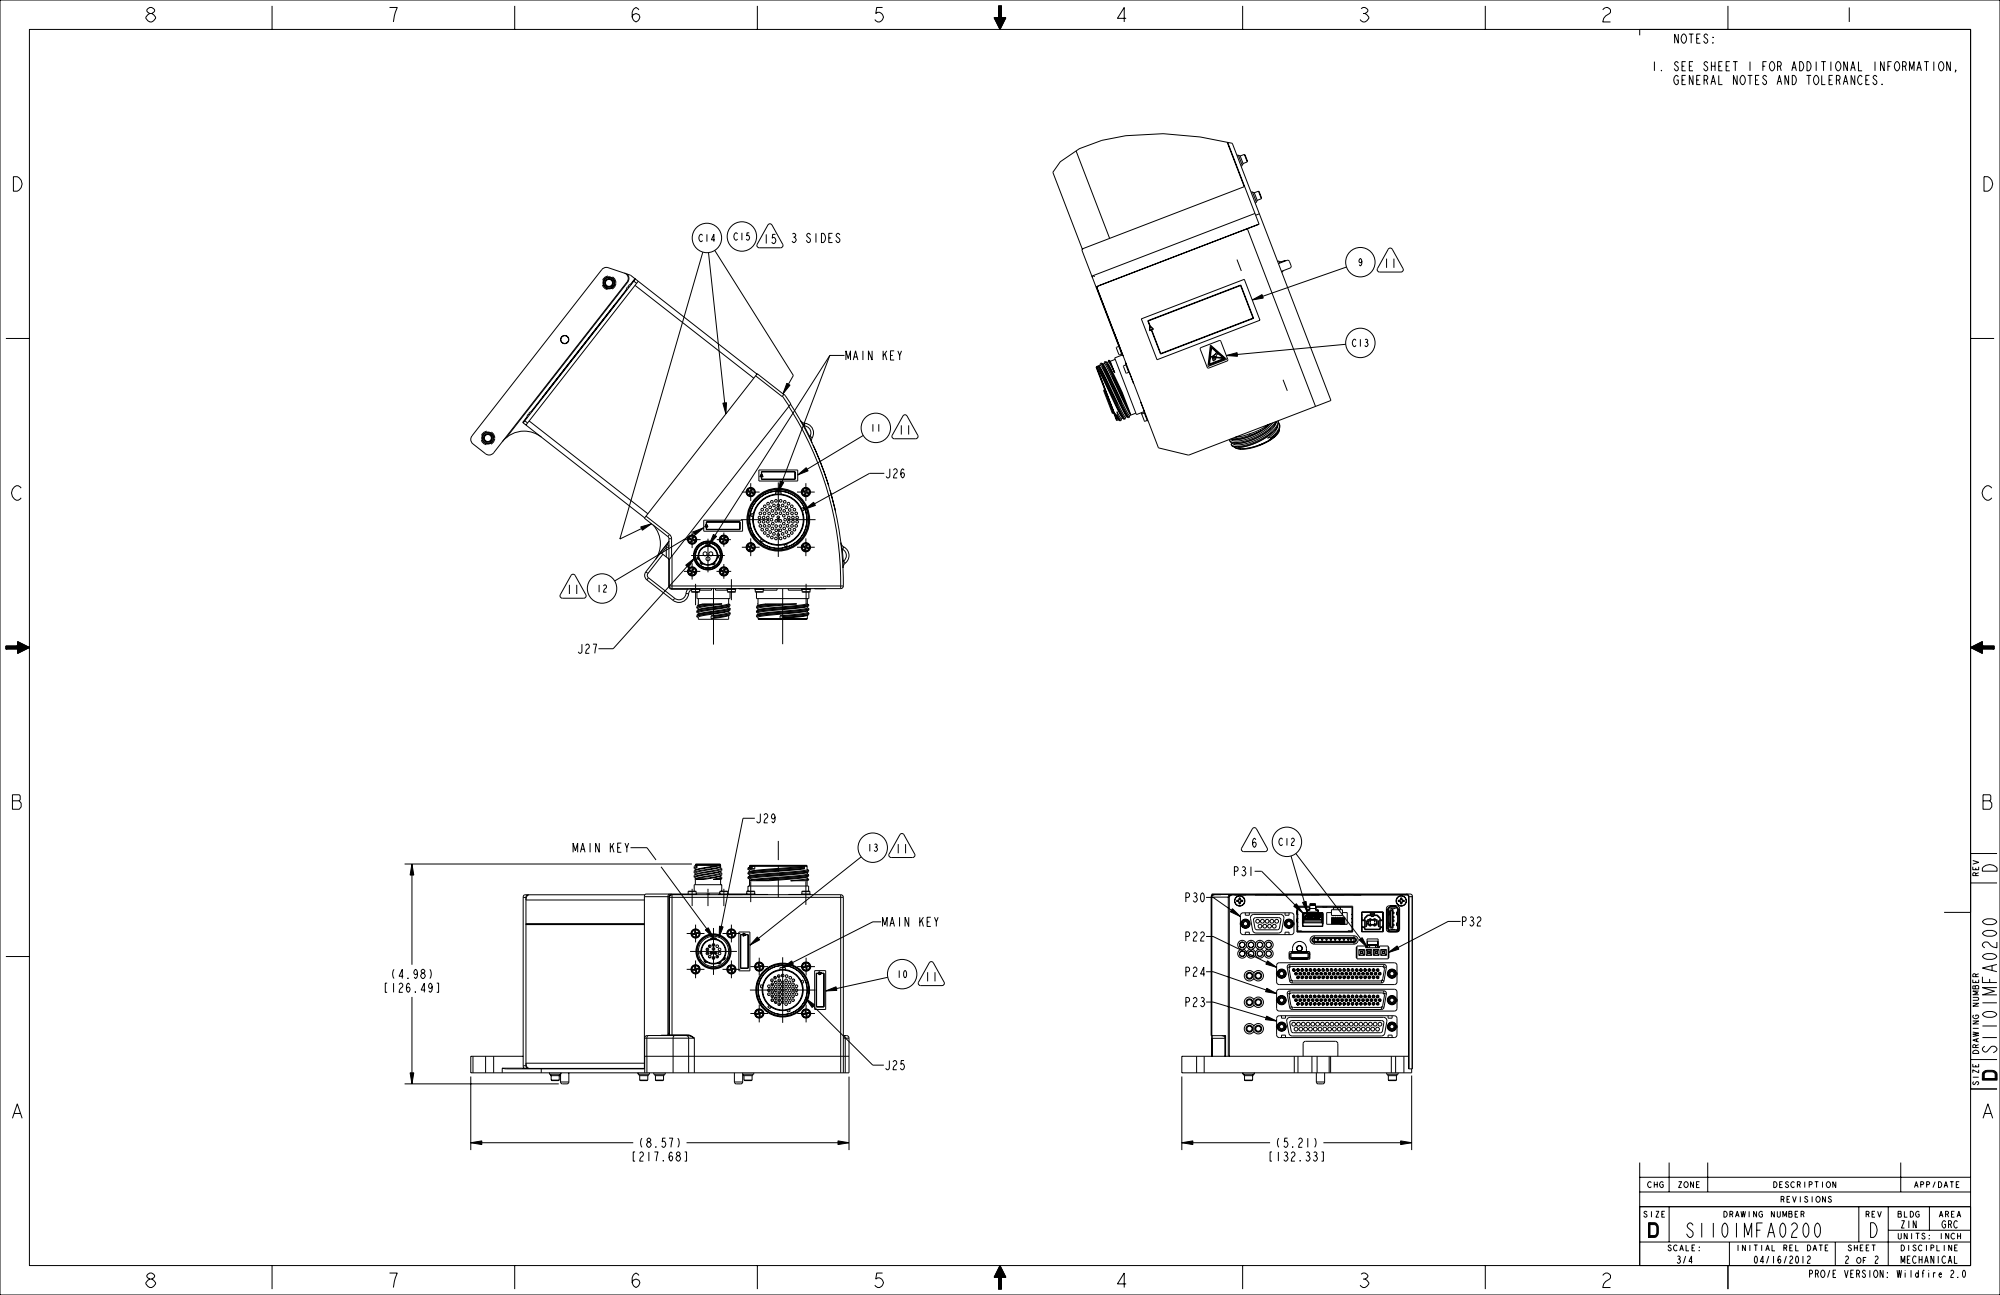
[picture p315: page 2]
