EmersonBJ/nasa-acme-burner-cad-cfd/PSI-Documents/Engineering Documents/Desenhos_Tecnicos_NASA/ACME_drawings_data_camera/ACME_drawings_data_camera/s1101mfa2200_G.pdf

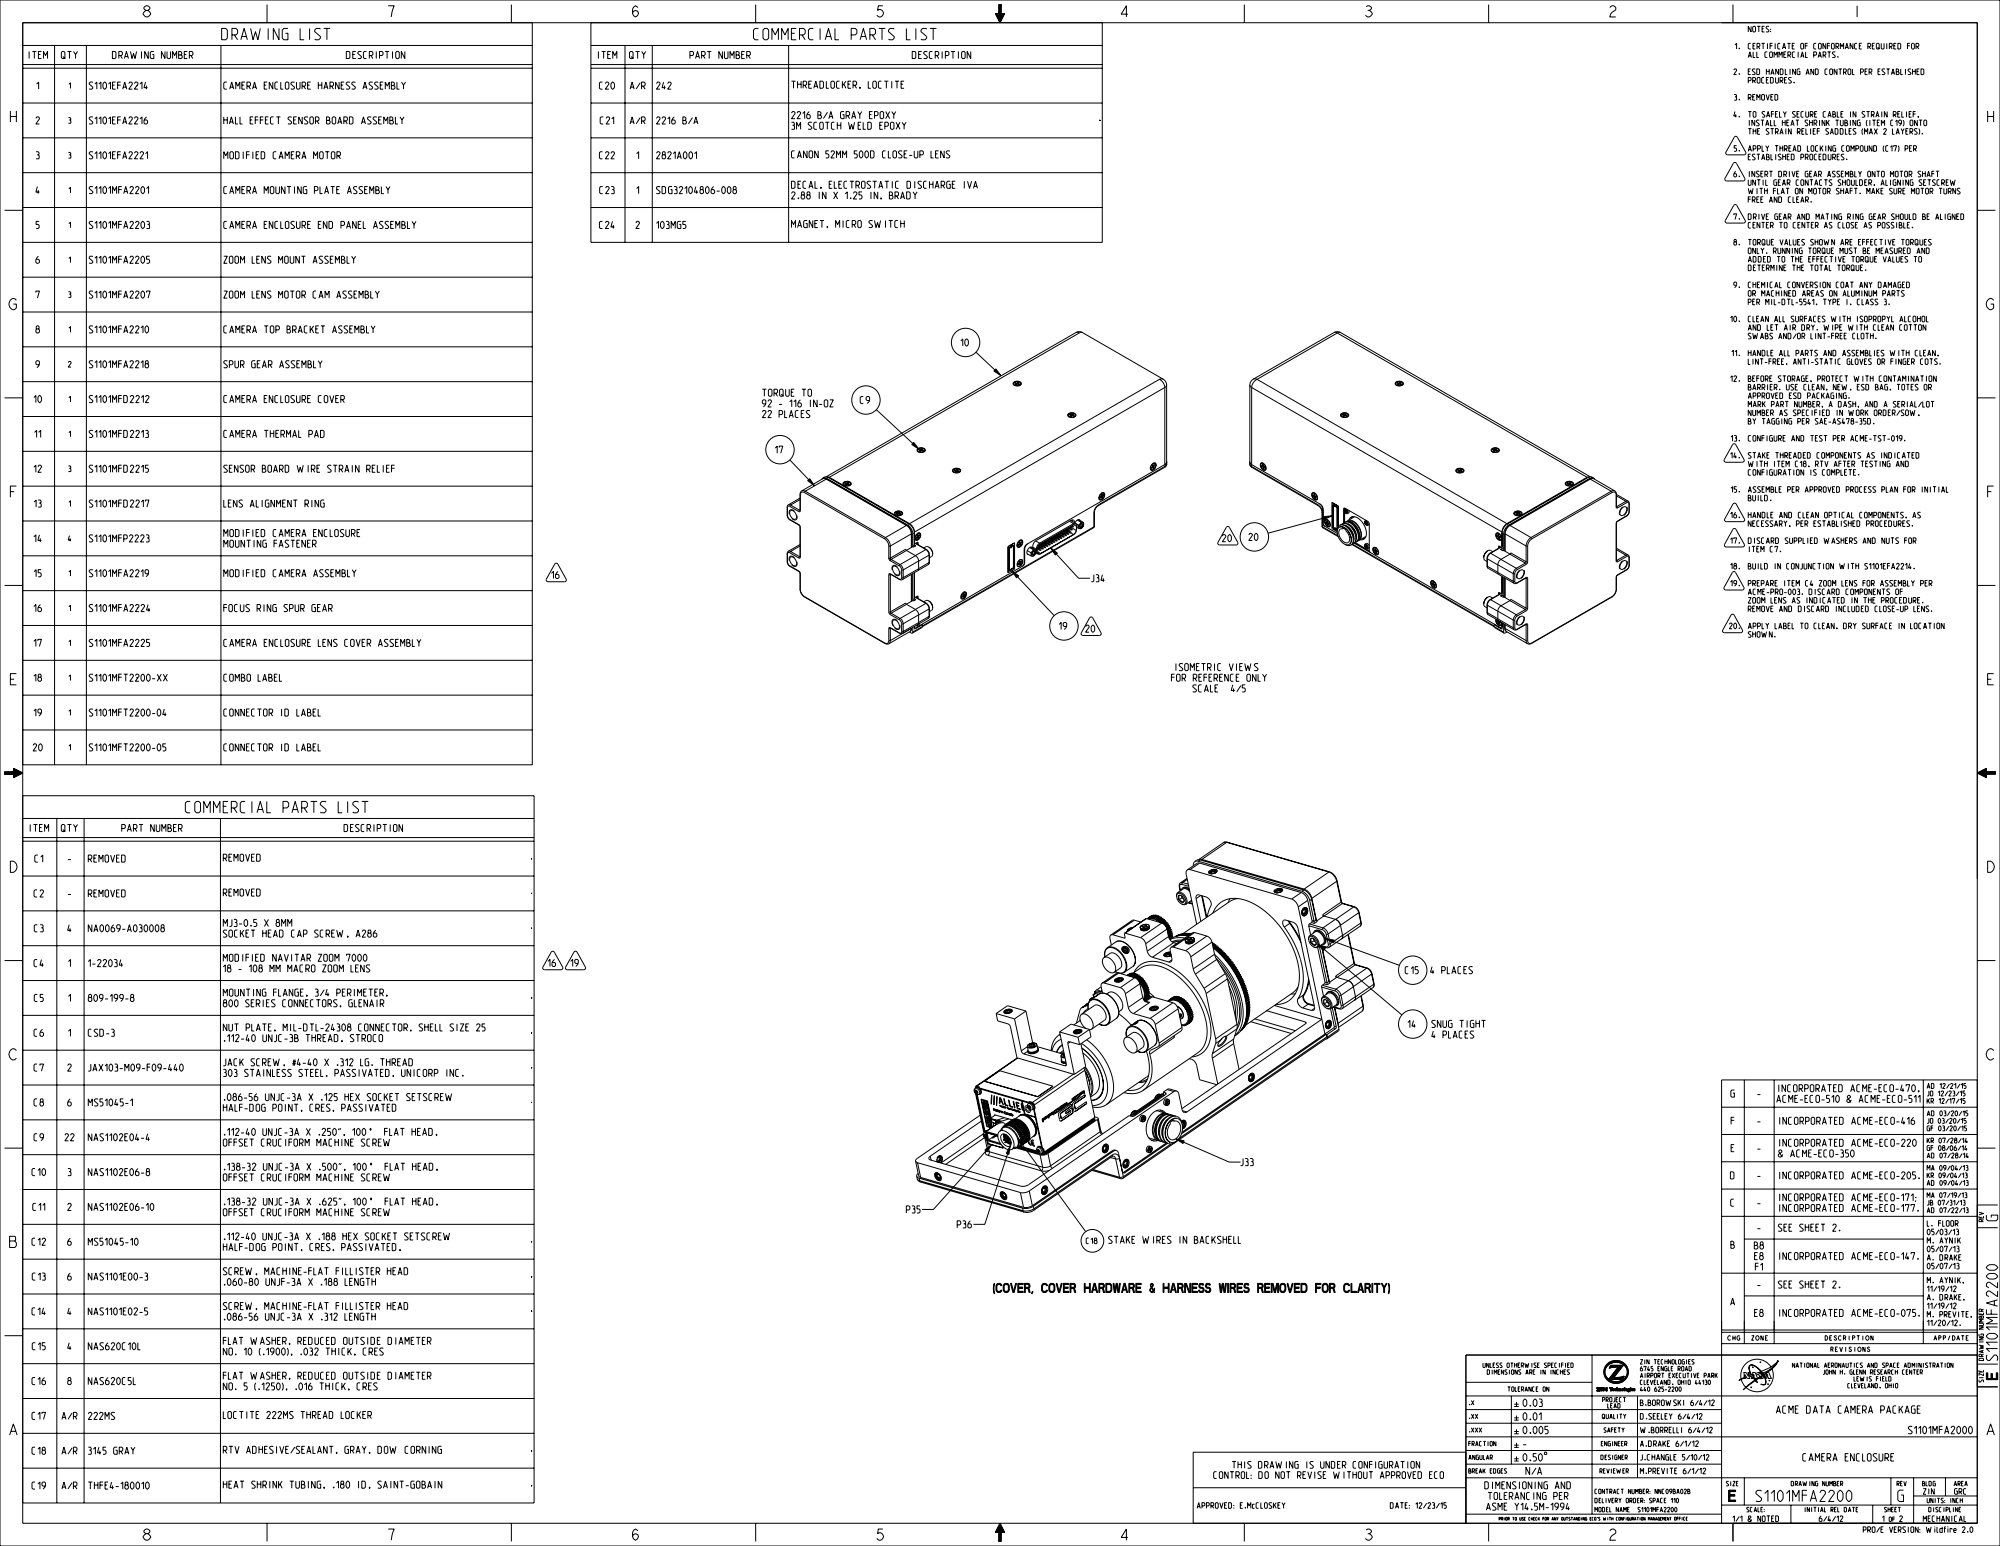
[picture p317: page 1]

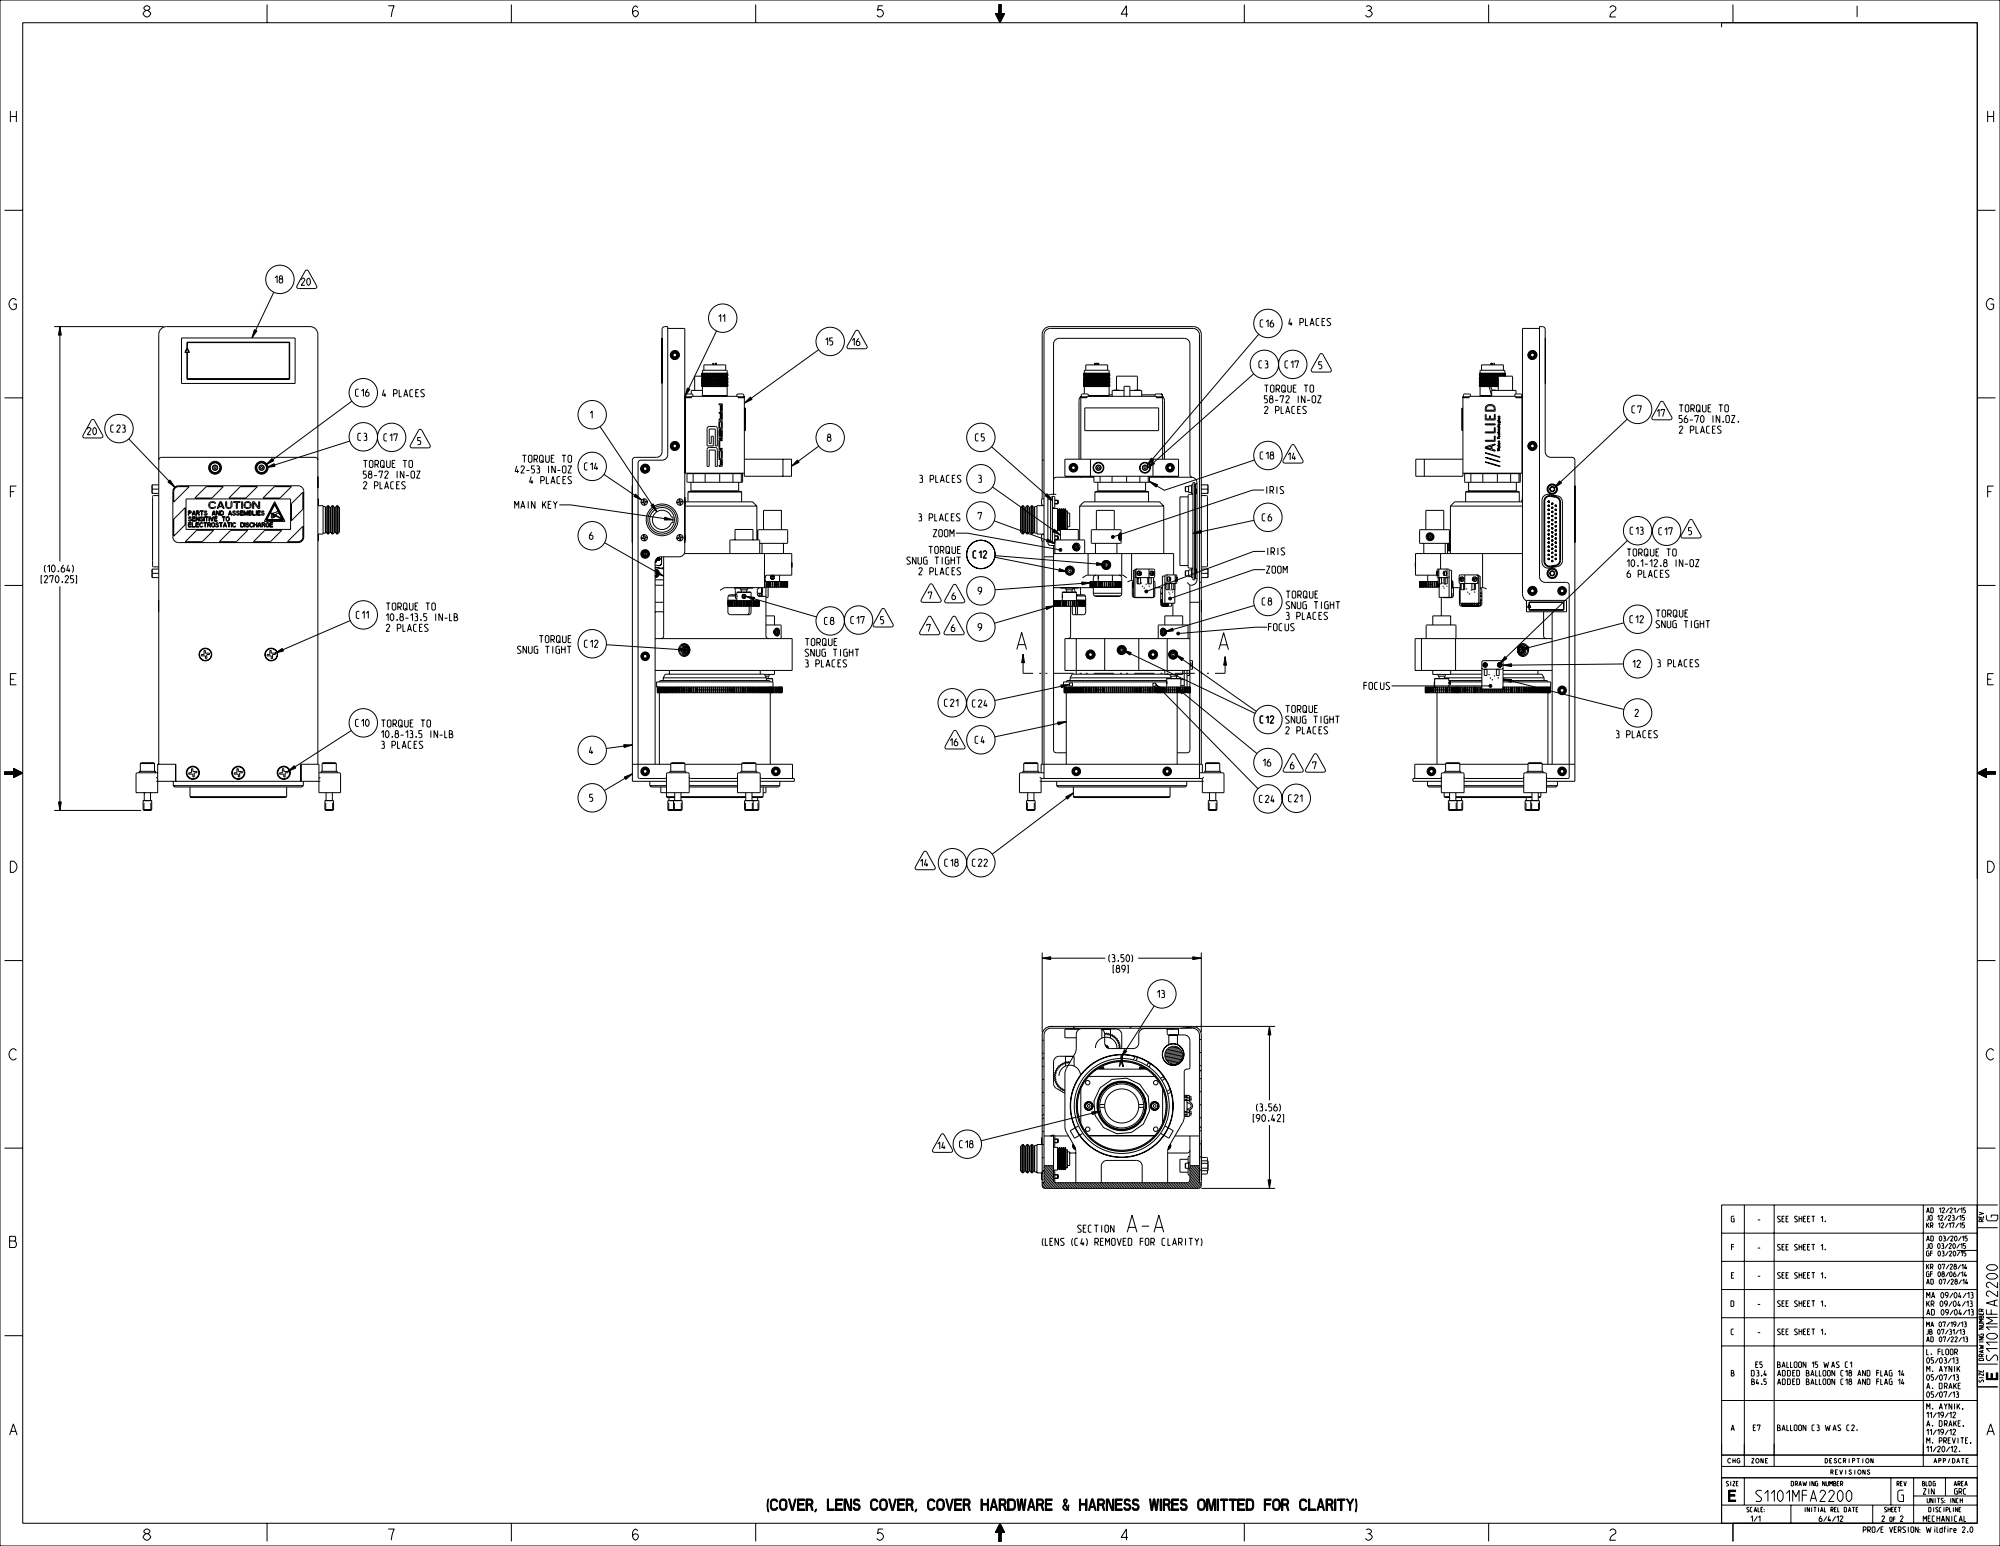
[picture p318: page 2]
