EmersonBJ/nasa-acme-burner-cad-cfd/PSI-Documents/Engineering Documents/Desenhos_Tecnicos_NASA/ACME_drawings_data_camera/ACME_drawings_data_camera/s1101mfa2225_A.pdf

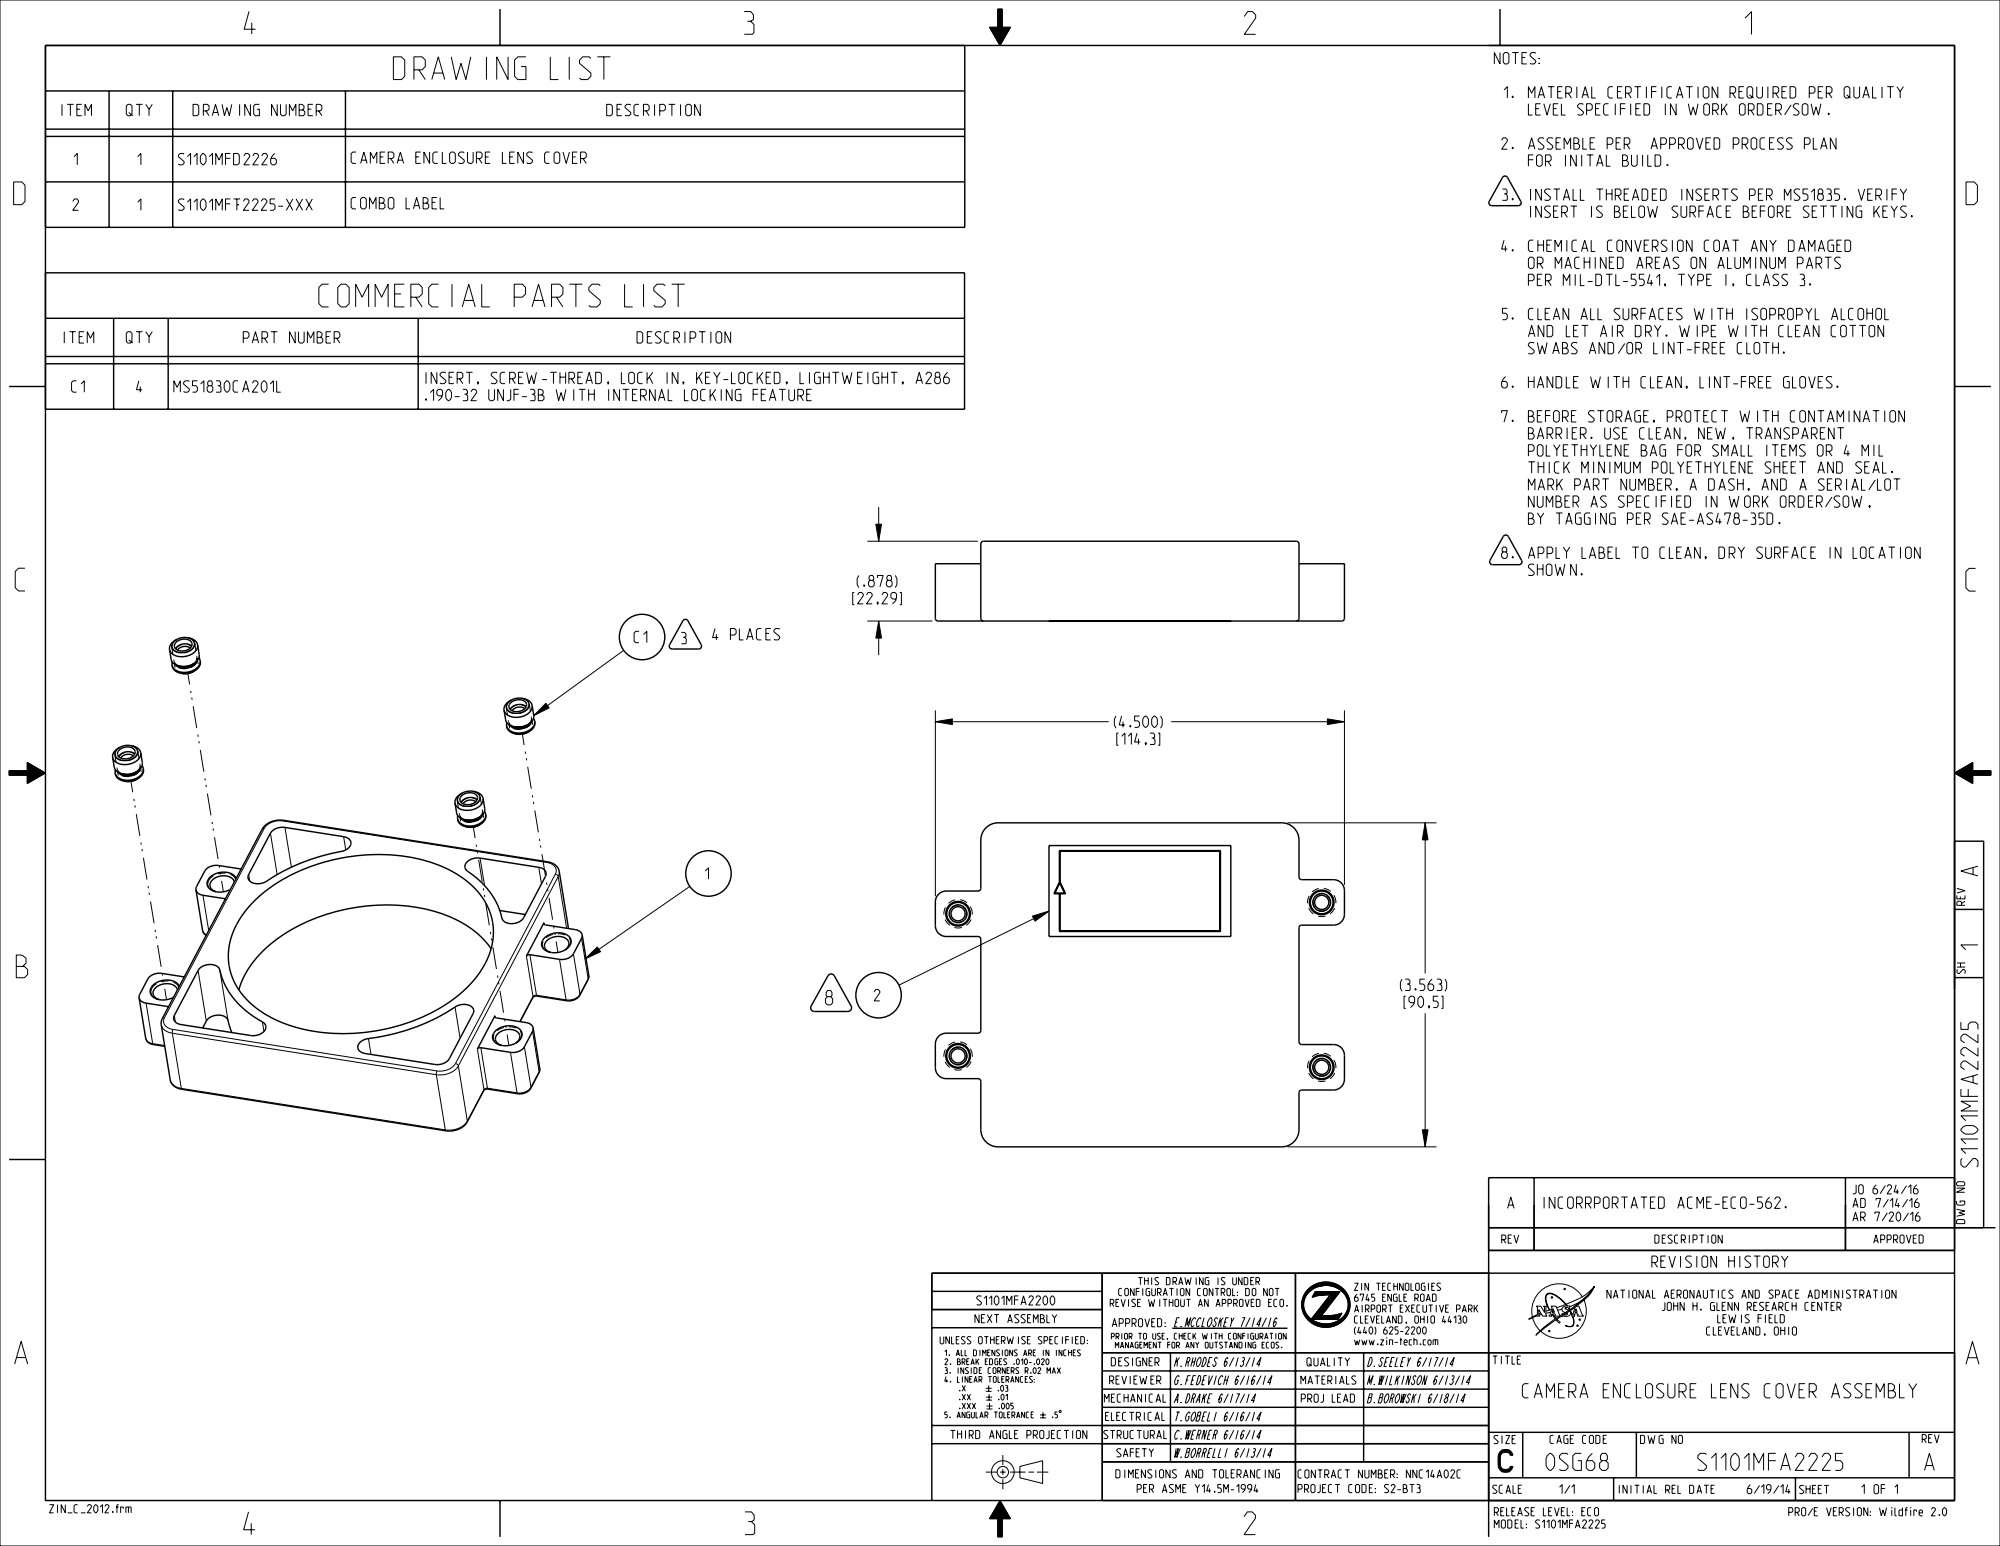
[picture p319: page 1]
