EmersonBJ/nasa-acme-burner-cad-cfd/PSI-Documents/Engineering Documents/Desenhos_Tecnicos_NASA/ACME_drawings_e-field_system/MFD_Pecas_Individuais/s1101mfd1706.pdf

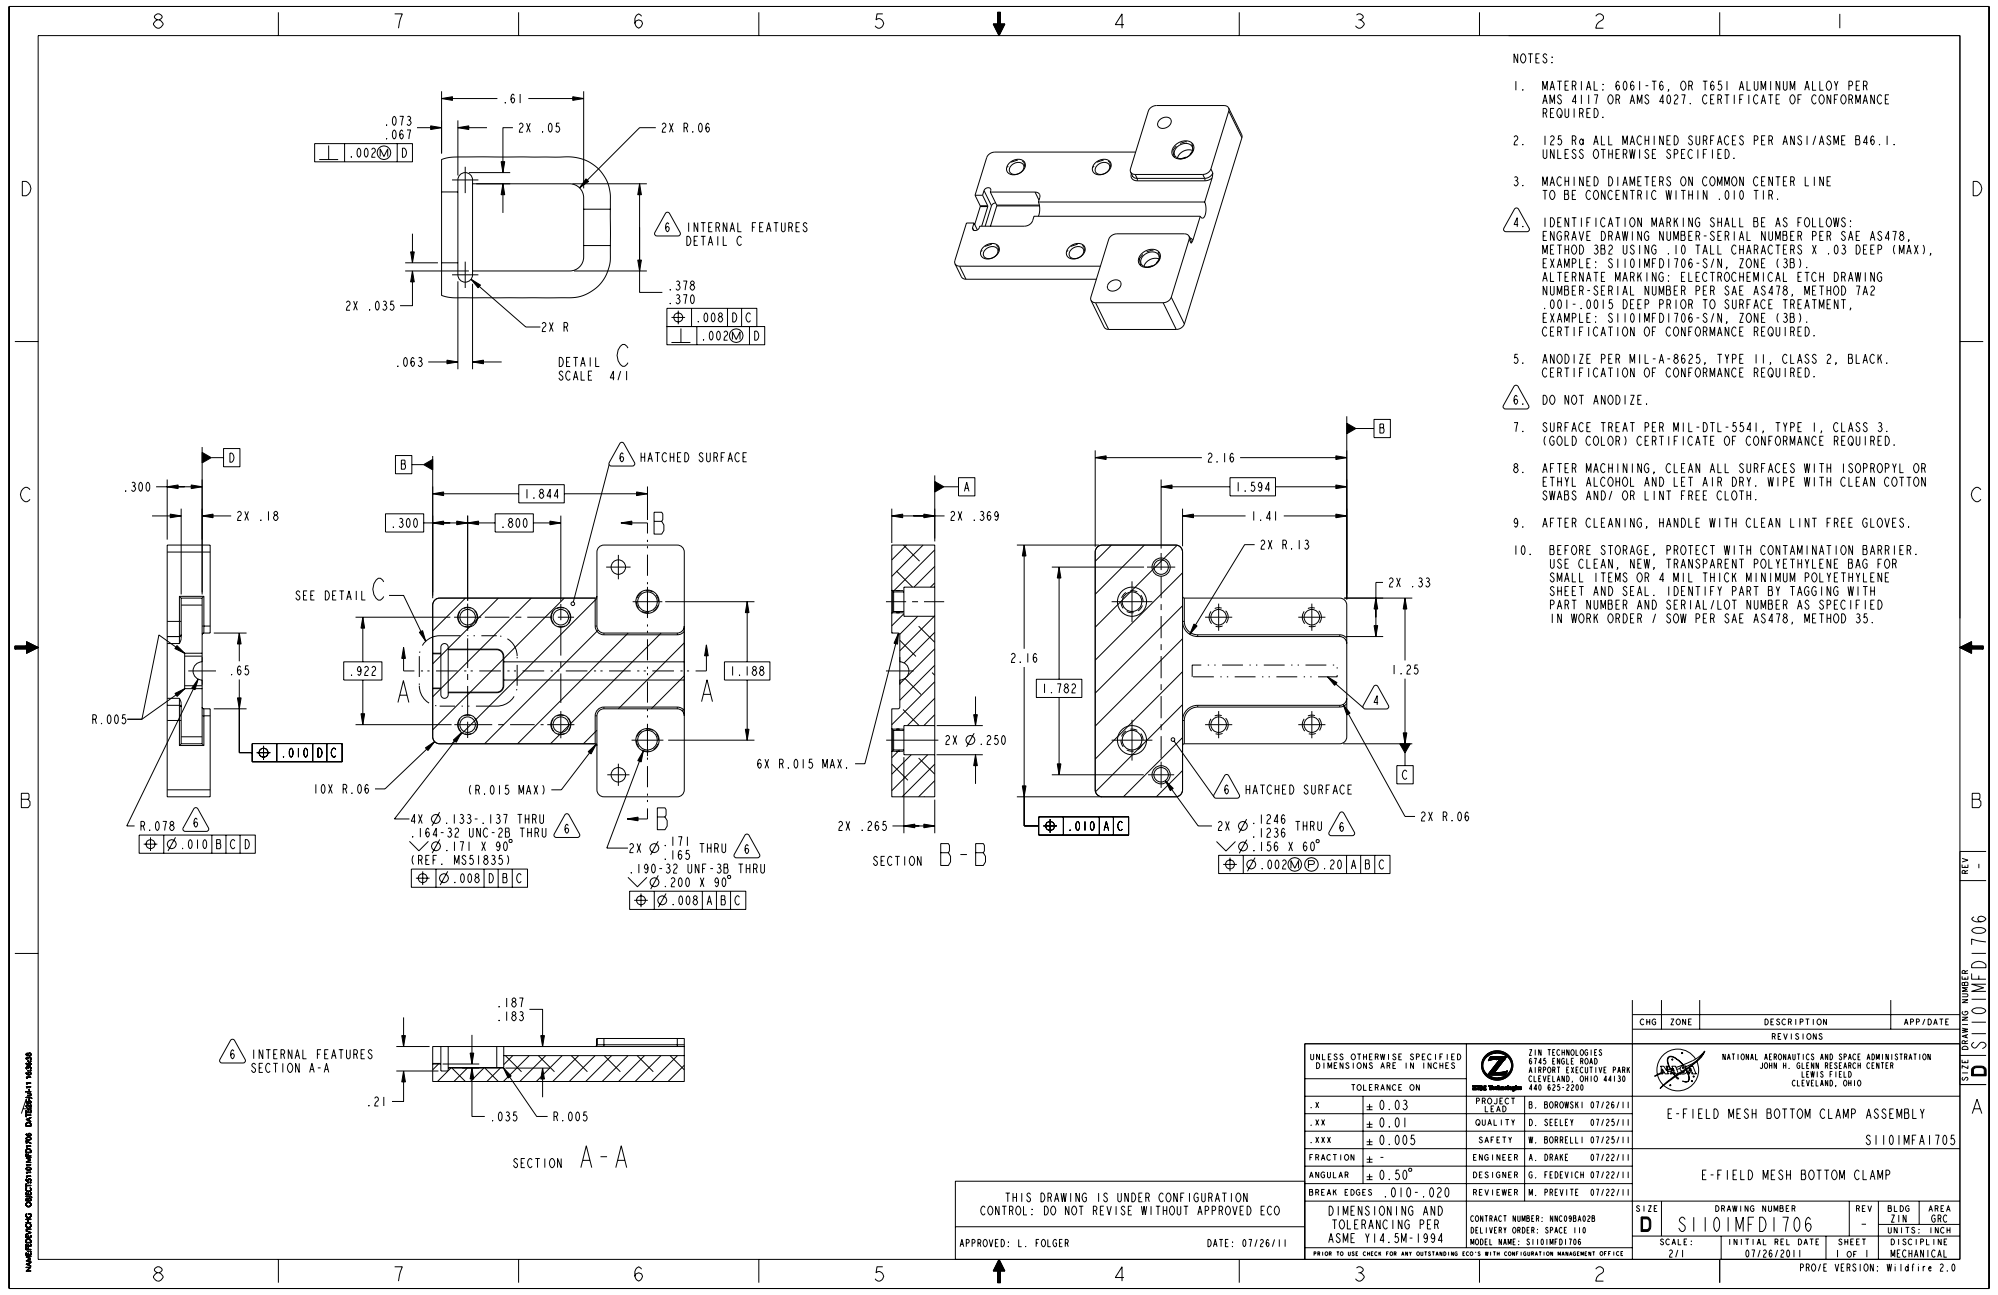
[picture p325: page 1]
