EmersonBJ/nasa-acme-burner-cad-cfd/PSI-Documents/Engineering Documents/Desenhos_Tecnicos_NASA/ACME_drawings_expt_mounting_structure/MFD_Pecas_Individuais/s1101mfd1004_B.pdf

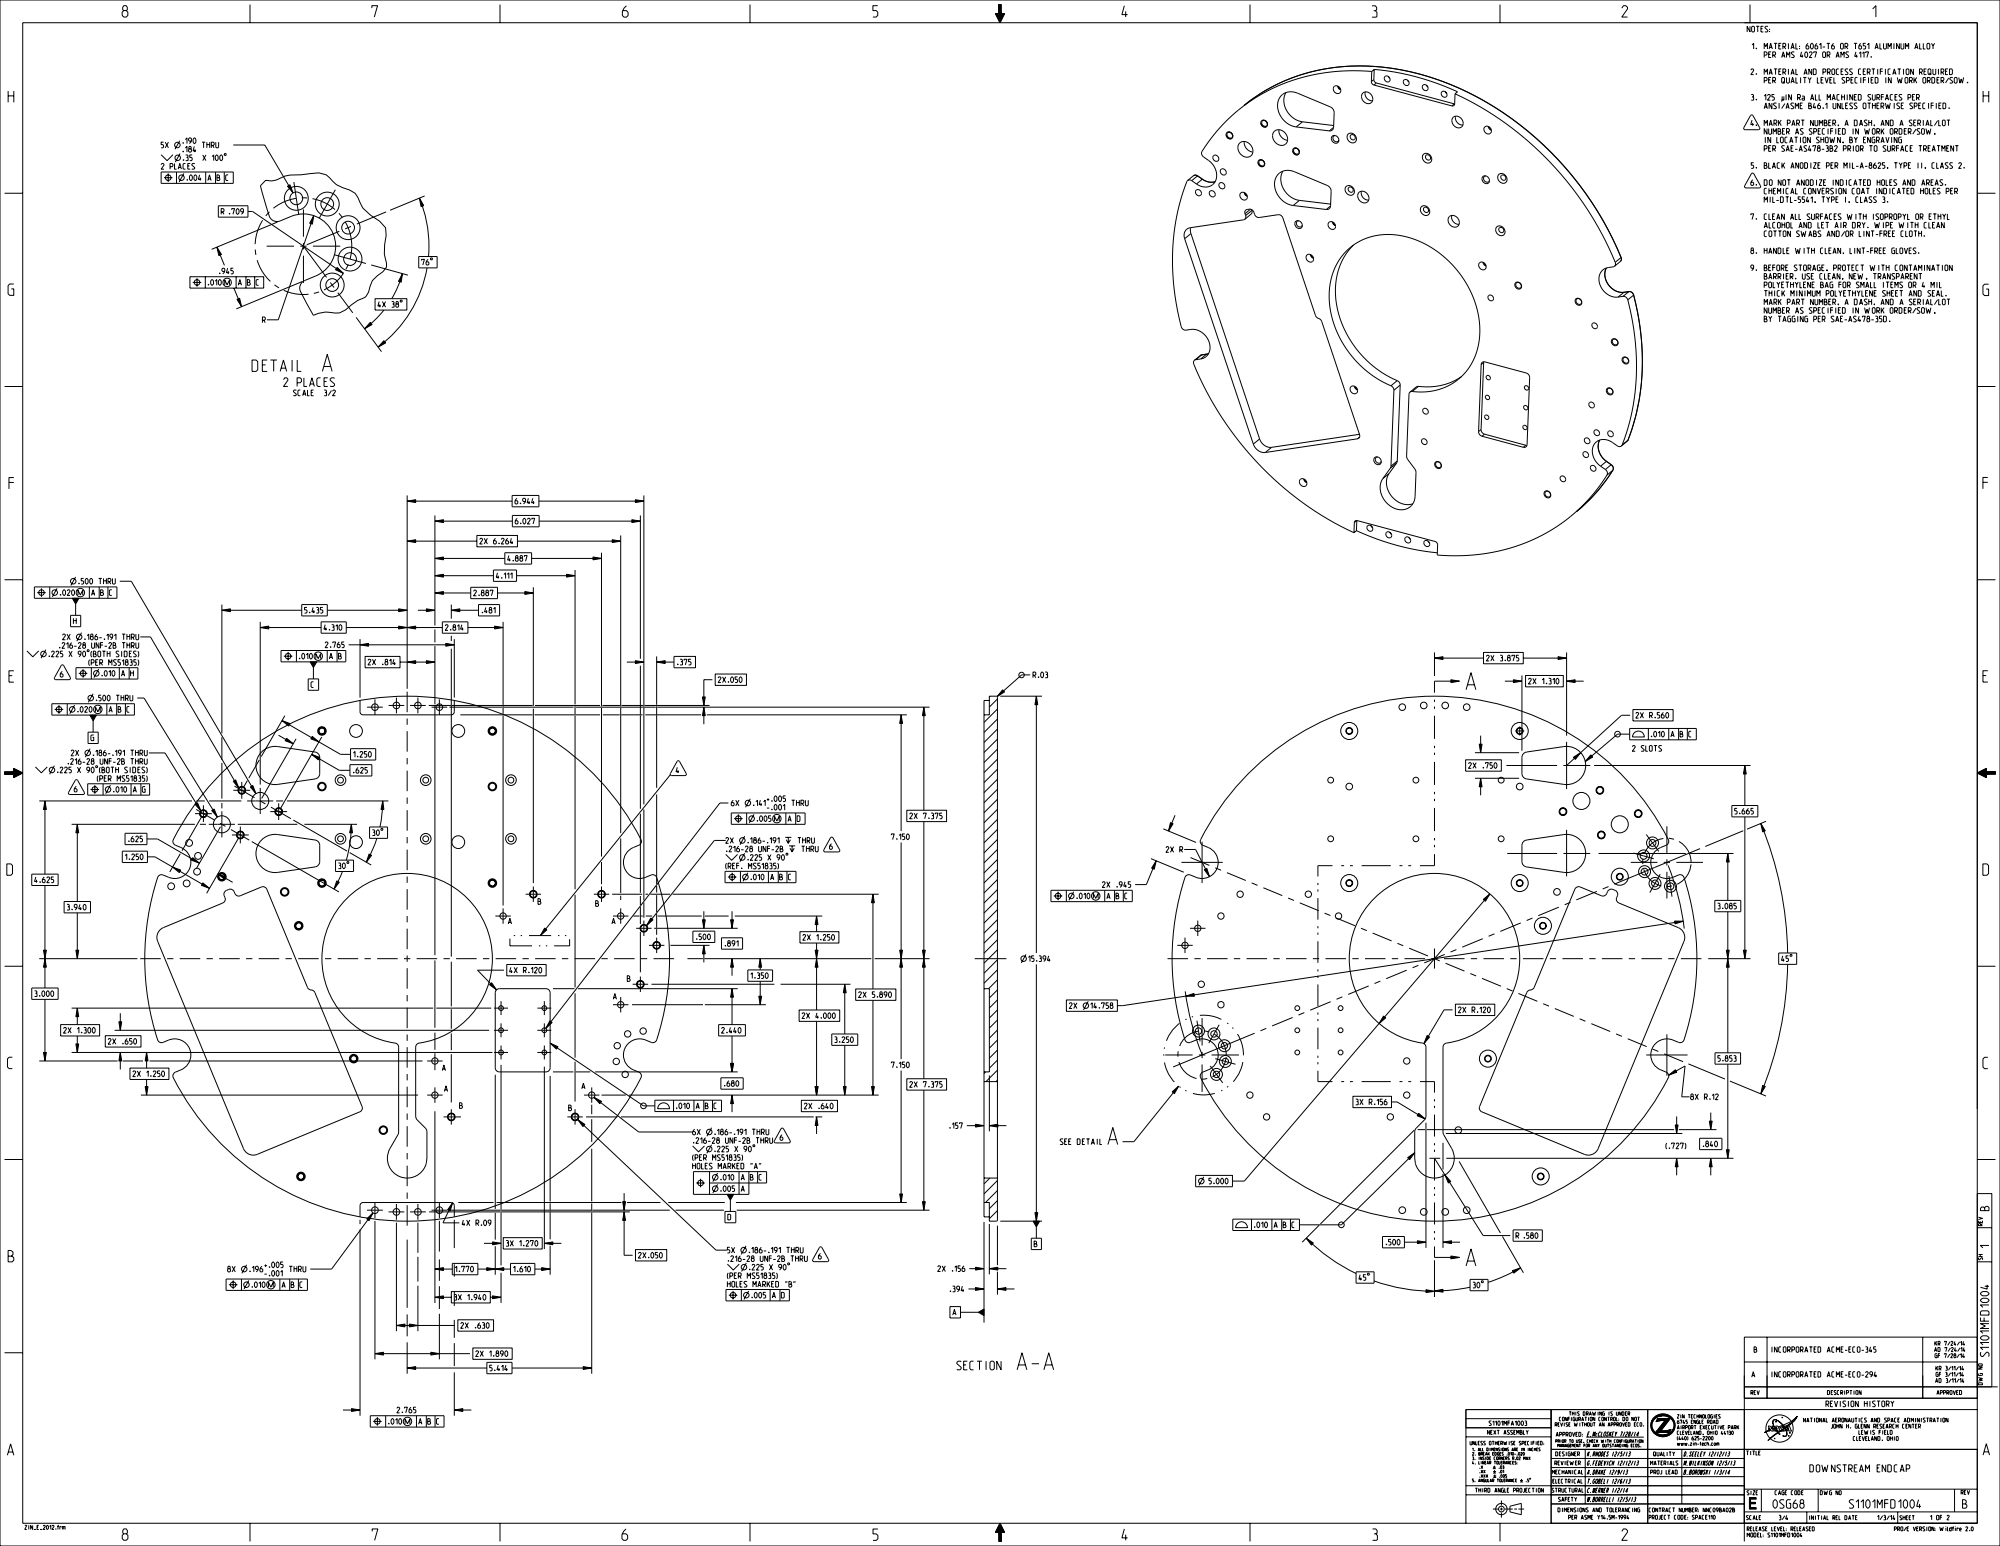
[picture p327: page 1]

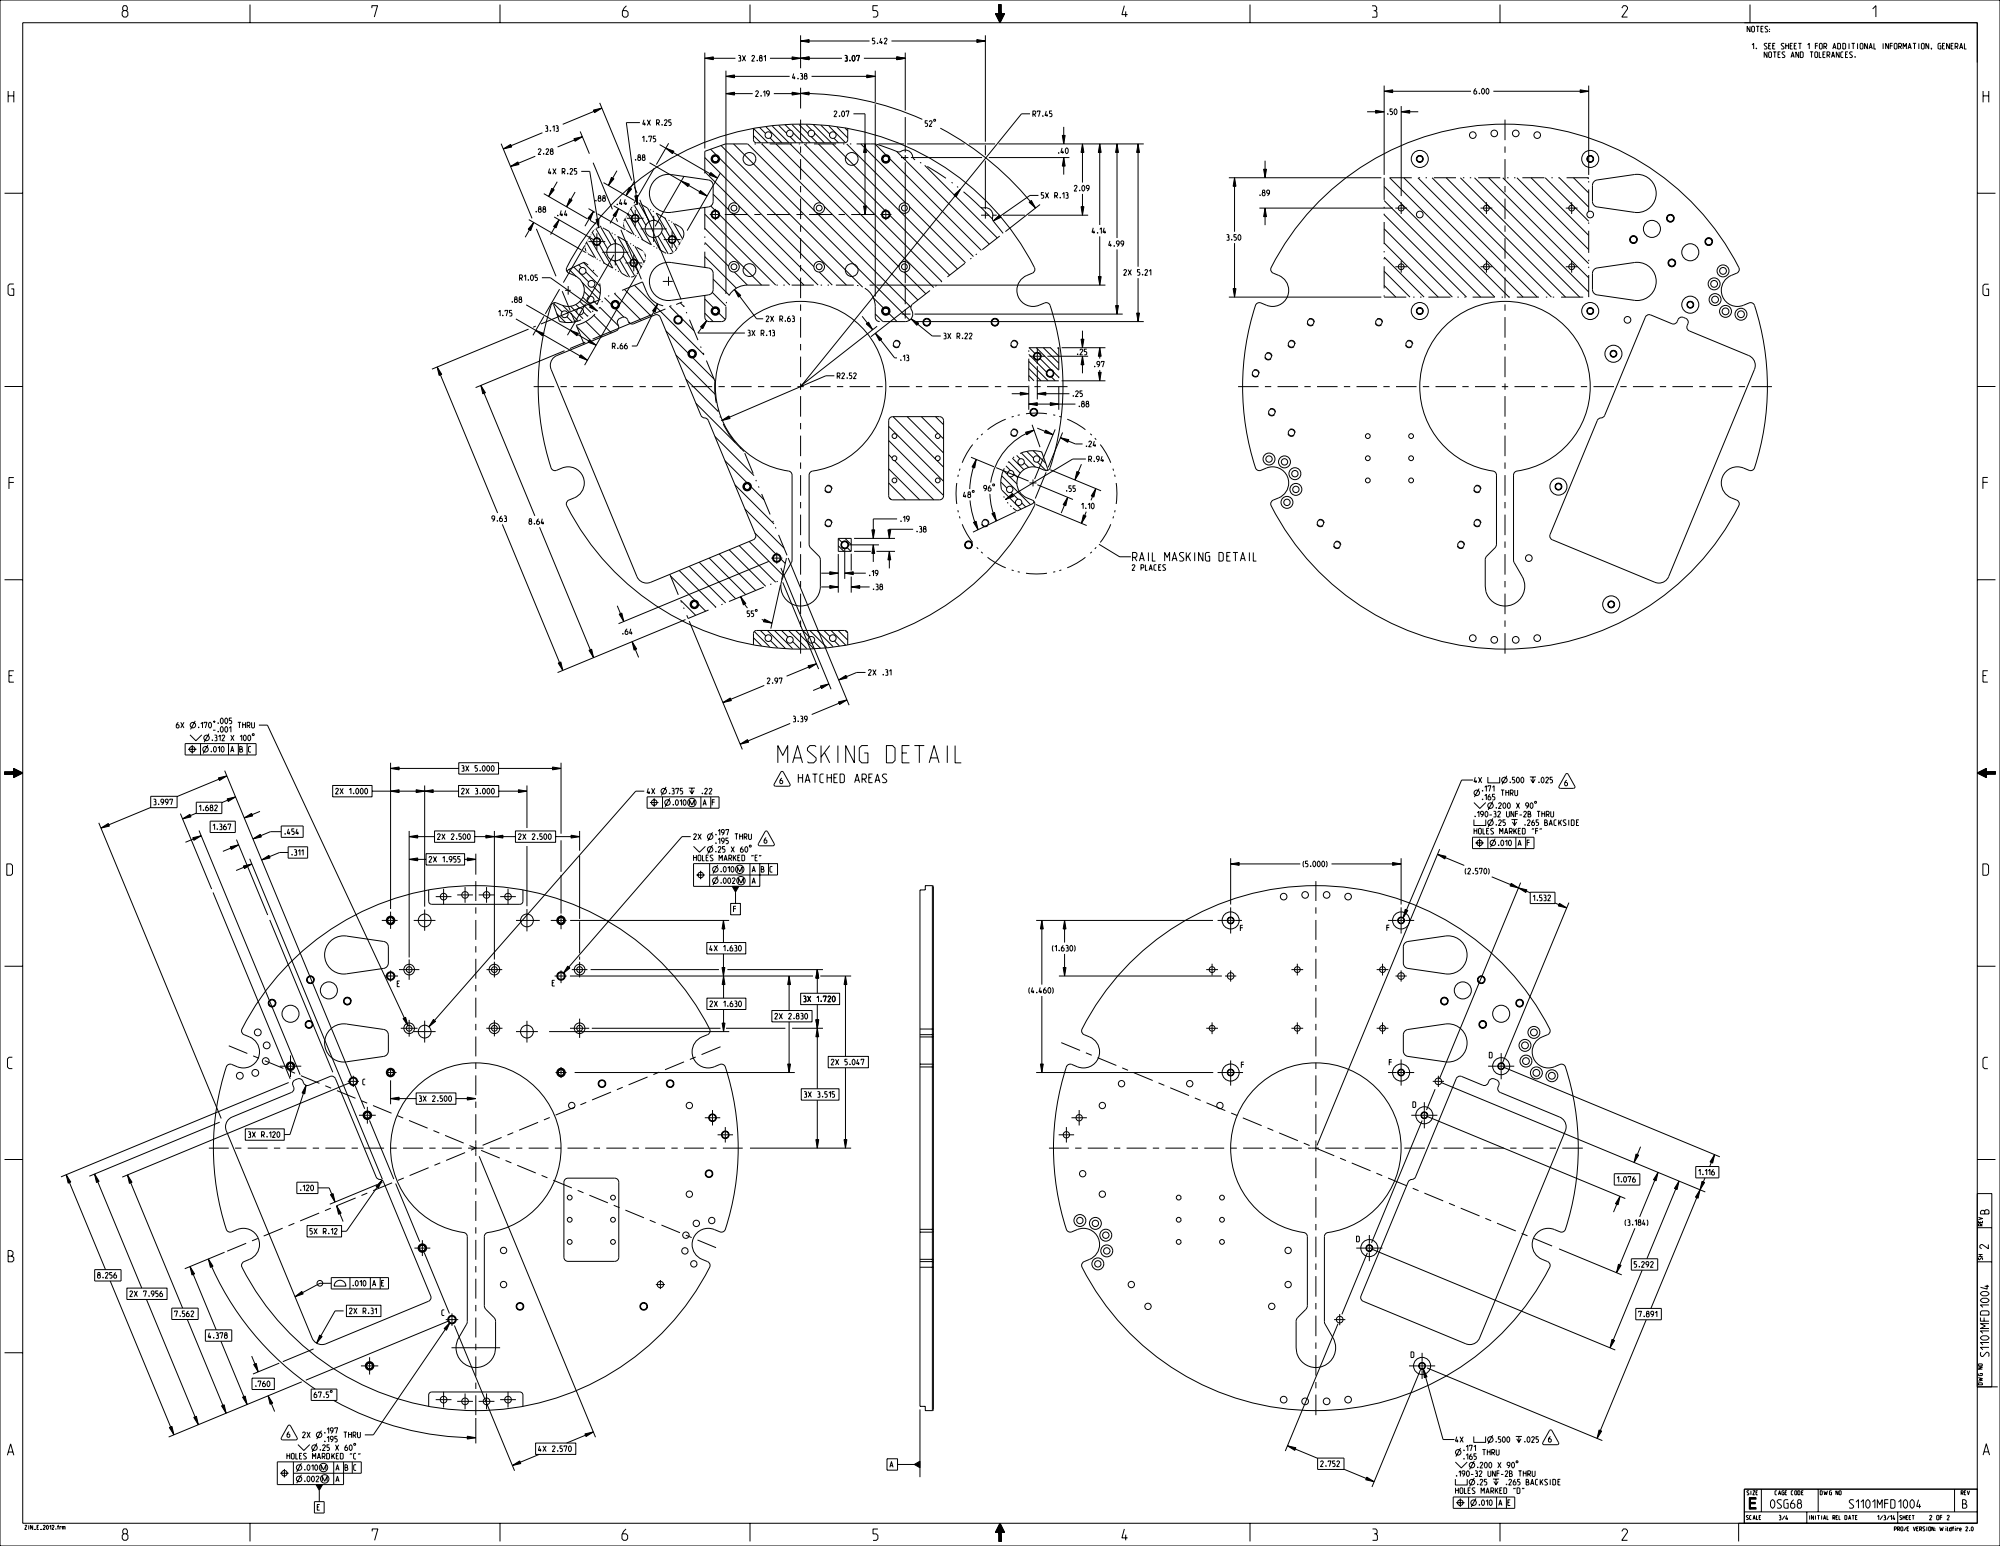
[picture p328: page 2]
