EmersonBJ/nasa-acme-burner-cad-cfd/PSI-Documents/Engineering Documents/Desenhos_Tecnicos_NASA/ACME_drawings_expt_mounting_structure/MFD_Pecas_Individuais/s1101mfd1014_A.pdf

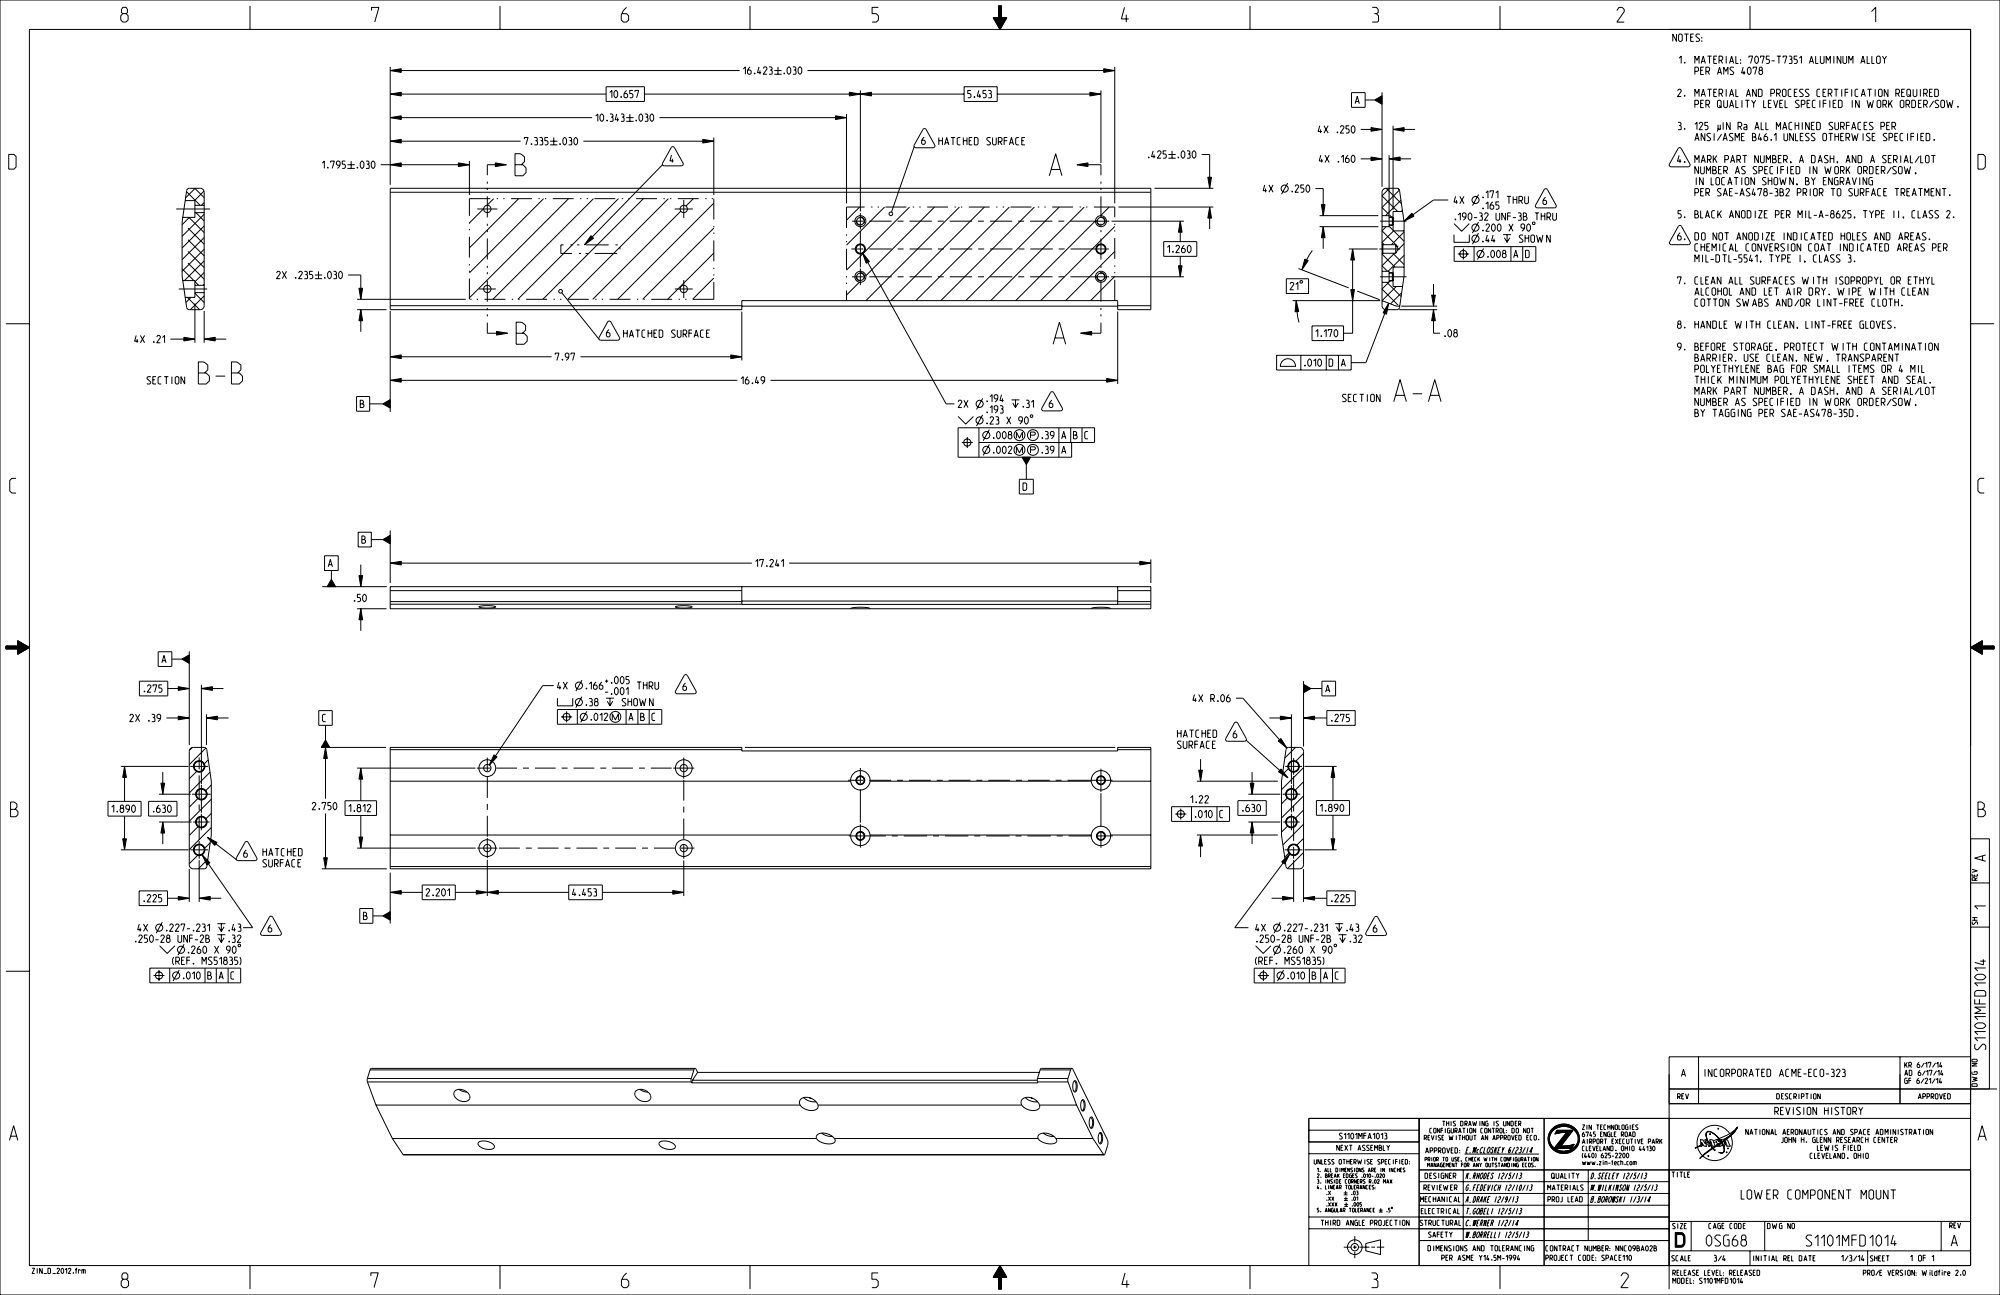
[picture p330: page 1]
