EmersonBJ/nasa-acme-burner-cad-cfd/(commit log)

2026-11-09 feat: NASA ACME flight hardware 3D CAD reverse engineering, parametric automation and flight inventory
2026-11-09 feat: add CAD repository portfolio, aerospace studio 3D renders, and complete flight models
2026-11-09 docs: document virtual probes architectural decision and update CAD parts catalog matrix
2026-11-09 feat(catalog): update all CAD and PDF hyperlinks to direct GitHub 3D WebGL and PDF URLs
2026-11-09 feat(catalog): sync complete CAD matrix and online GitHub hyperlinks in NASA_CAD_Reverse_Engineering
2026-11-10 feat(cad): add validated 1/4 inch burner S1101MFA1216, harness, igniter coil and CIR optical covers
2026-11-10 docs: check off radiometry window covers and 1/4 inch support tube in spreadsheet
2026-11-10 docs: clarify CAD/CFD status - zero remaining PRECISA FAZER items, all 14 rows categorized
